cozycactus/goa-console/docs/clipping/clip_follower.png

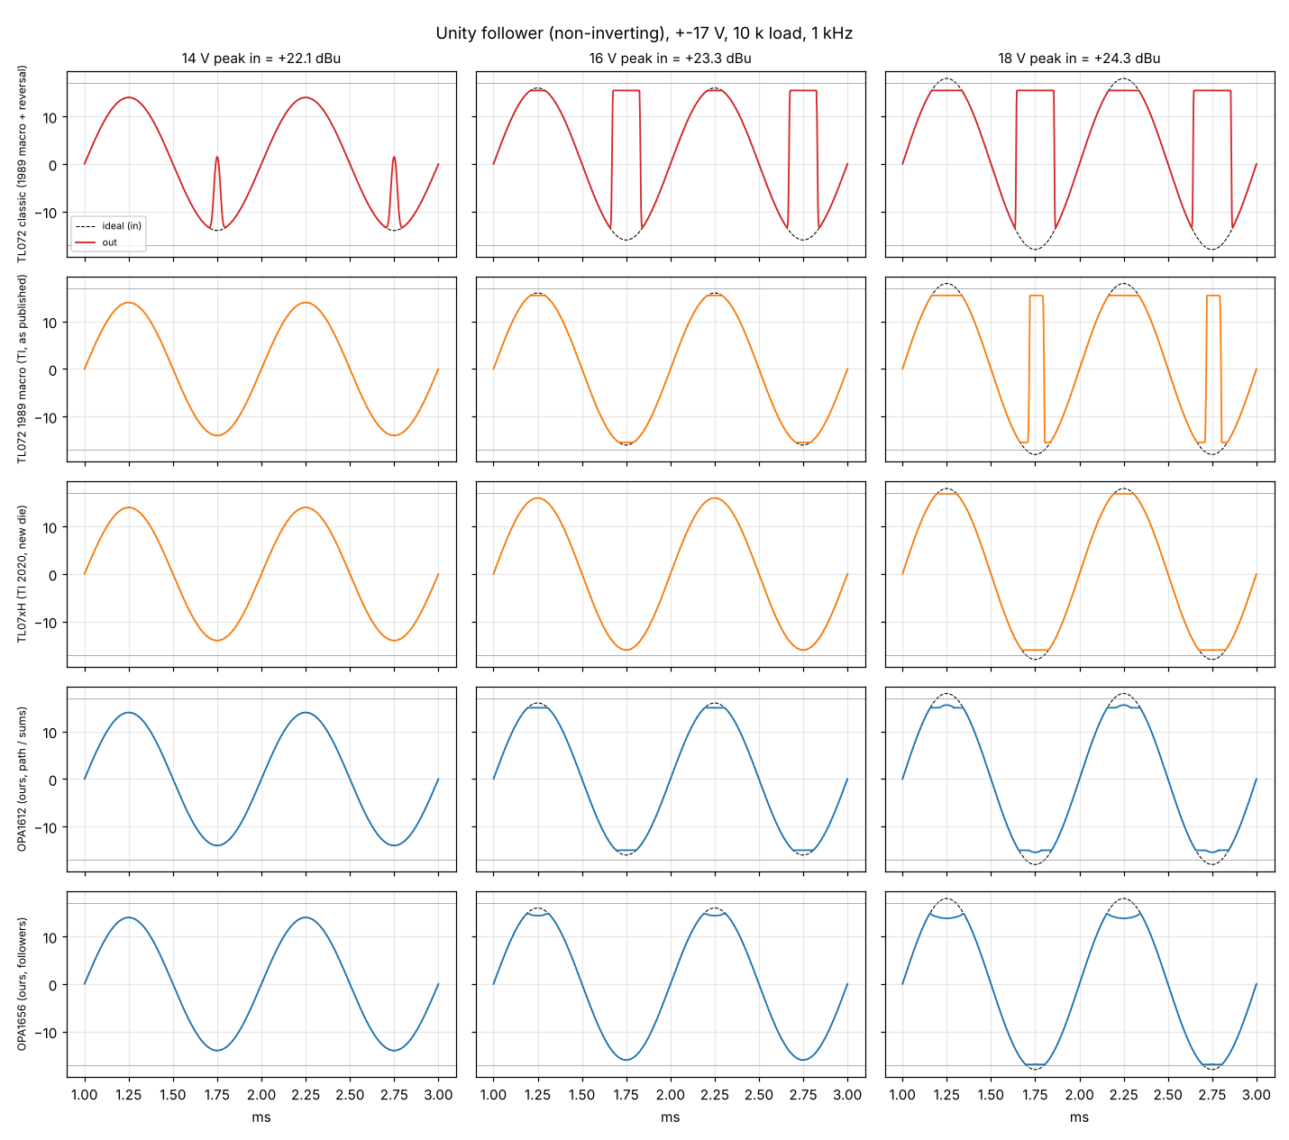
docs/clipping/clip_follower.png
