cozycactus/goa-console/docs/clipping/clip_inverting.png

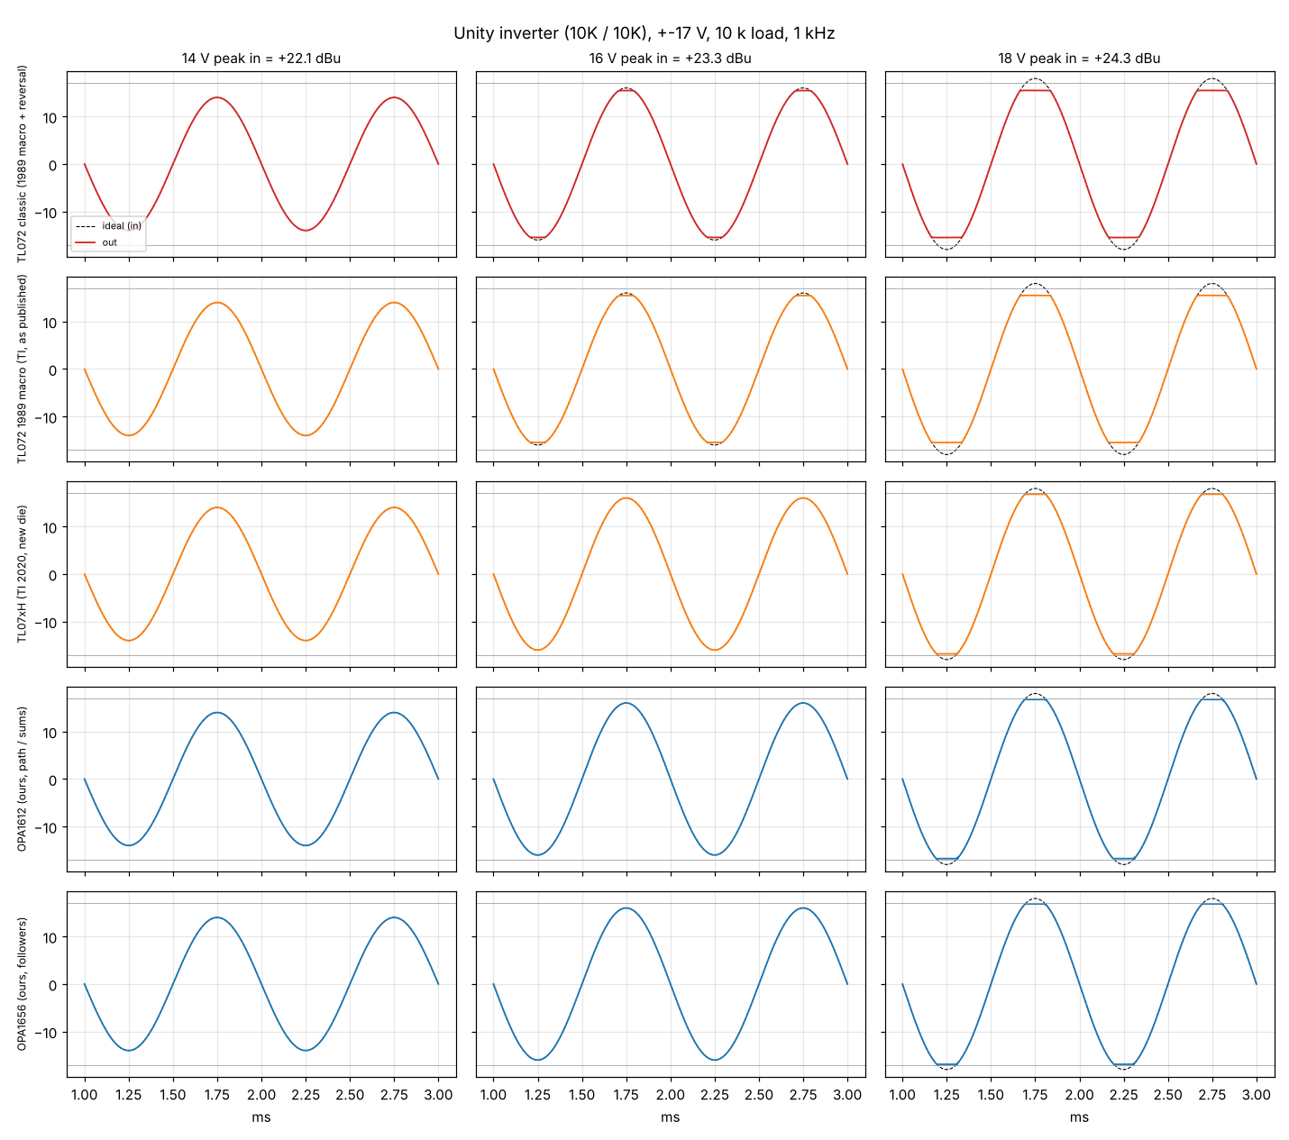
docs/clipping/clip_inverting.png
