cozycactus/goa-console/docs/clipping/clip_zoom.png

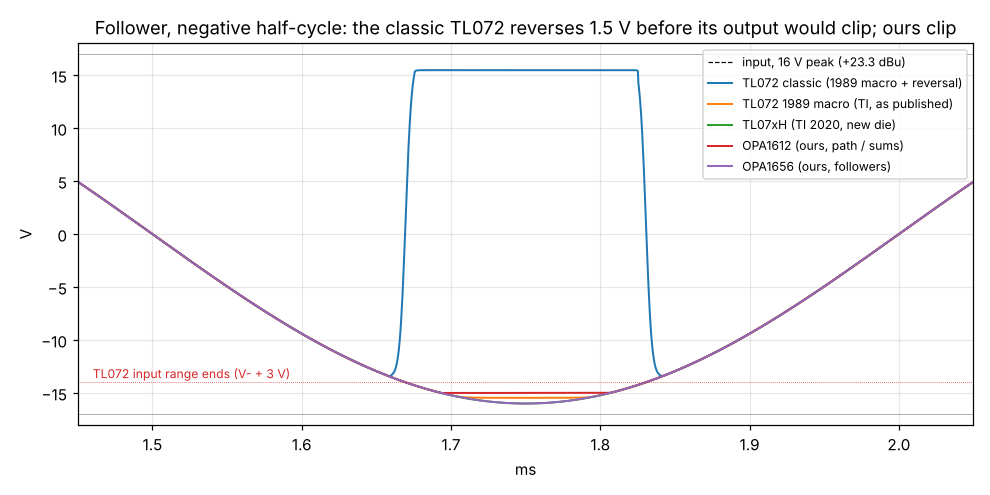
docs/clipping/clip_zoom.png
