cozycactus/goa-console/panels/group.png

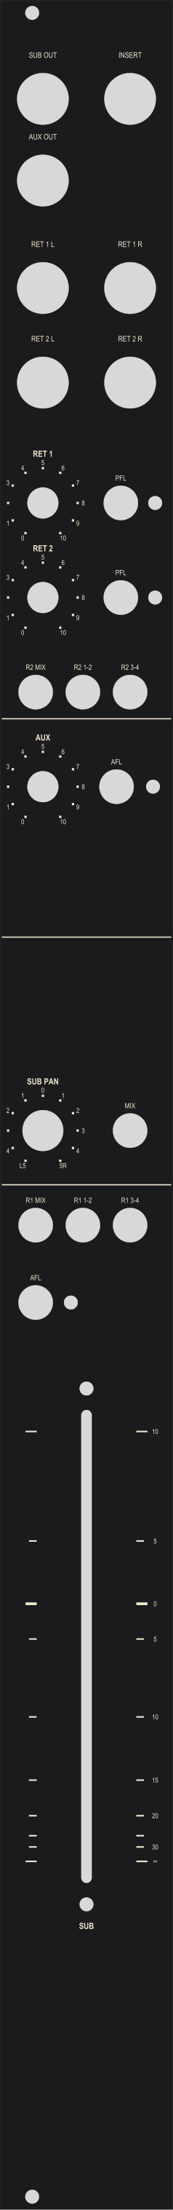
panels/group.png
