cozycactus/goa-console/panels/master.png

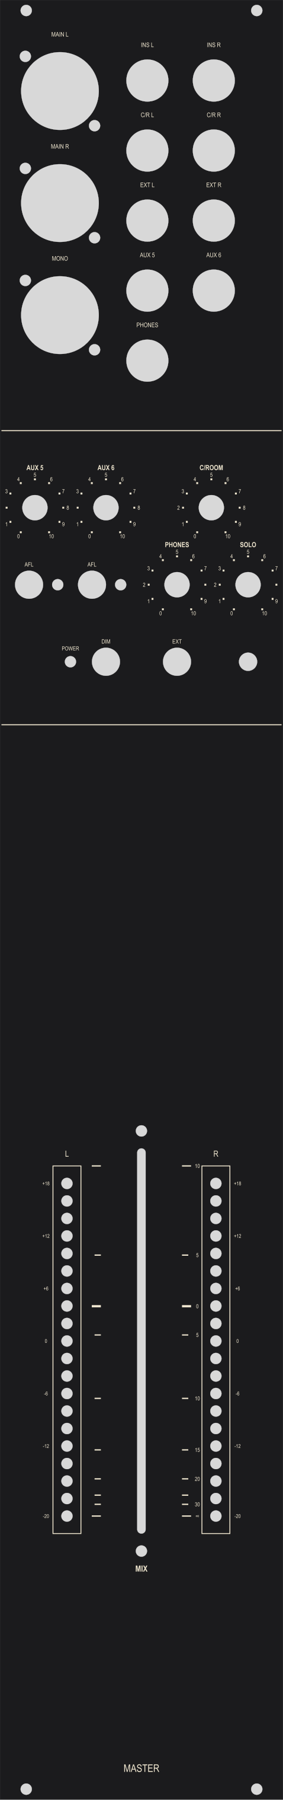
panels/master.png
