cozycactus/goa-console/panels/strip.png

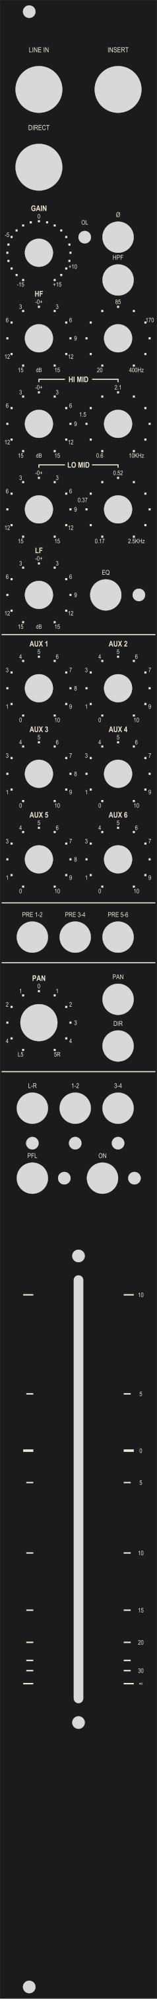
panels/strip.png
