cozycactus/goa-console/docs/build/sourcing.md

# BOM sourcing check (2026-10-25)

I checked every MPN on the nine BOMs: 86 unique part numbers, at console quantities (24 strips, 4 groups, the master,
the PSU and the jig). Each was checked for an exact orderable code, its lifecycle and its stock. One agent searched the
distributors and I re-checked its doubtful claims by hand (Tayda, findchips, RS, Farnell, DigiKey). Stock figures are
snapshots from aggregators; check the live page before ordering.

## Applied (MPN fields only, no netlist or footprint change)

| Part | Was | Now | Why |
|---|---|---|---|
| Wing / jig PTCs | Bourns MF-RX160/72, 185/72, 250/72 | the same with `-0` | `-0` is the straight-lead order code |
| Plain 0805 resistors ≤ 1M (TF1, 2026-10-29) | Yageo RC0805FR-07xxxL thick film | Yageo RT0805FRE07xxxL thin film | voltage coefficient (distortion near full swing), drift, tempco; parity with the Delta's metal film |
| Strip C0G on 0805 pads: C7 / C41 33p, C14 / C94 / C95 100p, C37 22p (2026-10-28) | KEMET C1206C330 / C101 / C220J5GACTU | KEMET C0805C330 / C101 / C220J5GACTU | the strip's value-keyed map gave every C0G the 1206 code; these six are drawn on 0805 footprints (`gen.py` now picks by footprint) |
| 1 µF 0805 X7R (strip) | Murata GRM21BR71H105KA12 | GRM21BR71H105KA12**L** | packaging suffix needed to order |
| BAT54W | Nexperia BAT54W | BAT54W,115 | order code |
| LM1084 (PSU) | TI LM1084IT-ADJ | LM1084IT-ADJ/NOPB | the orderable RoHS code |
| LME49600 (master) | TI LME49600TS | LME49600TS/NOPB | same |
| SS54 clamps | "SS54" / onsemi SS54 | Diodes B540C-13-F | SMC 40 V 5 A from a named maker; value text kept "SS54" |
| S1G (PSU) | "S1G" | Diodes S1G-13-F | named maker |
| Strip C0G caps | KEMET C0805… | KEMET C1206C…J5GACTU | the strip's C0G sit on 1206 footprints, except the six on 0805 pads (above) |
| Strip C0G 2n2 / 4n7 / 10n / 22n / 100n | none | KEMET C1206C222 / 472 / 103 / 223 J5GACTU, Murata GRM31C5C1H104JA01L | were missing |
| Strip C1 / C3 220 µF | Nichicon UPW1V221MPD (10 × 12.5) | Rubycon 35ZLH220MEFC8X11.5 | fits the strip's D8 / P3.5 footprint |
| Strip C5 / C6 47 µF | Nichicon UPW1J470MPD (8 mm) | Panasonic EEU-FR1H470 | fits the strip's D6.3 / P2.5 footprint |
| Group C1 / C2 220 µF | Nichicon UPW1V221MPD (not for new designs, no stock) | Nichicon UHE1V221MPD6 | 10 × 12.5, P5, the group's footprint; Farnell ~1900 |
| Jack board C8 / C9 100p C0G | none | KEMET C0805C101J5GACTU | was missing |
| Strip D1 | none | Vishay 1N4148-TAP | as the master |
| PSU caps | none | Rubycon 35ZLH2200MEFC16X25, 35ZLH220MEFC8X11.5, Panasonic EEU-FR1H470, Samsung CL21B104KBCNNNC, KEMET C0805C222J5GACTU (C0G) | were missing; each in its footprint |
| PSU LEDs | none | Kingbright WP710A10GD | as the strips |
| Phoenix terminals | series names | 1755897 (7-way), 1715721 (2-way), 1715734 (3-way) | order numbers (1755897 confirmed at RS as MKDS 1,5/7-5,08) |
| Master R57 22M | none | Yageo RC0805JR-0722ML | was missing |
| Master CN4 | none | Sullins PRPC005SAAN-RC | was missing |

Left without an MPN, by design: the DNP VCA socket / header on the strip (J3, J4) and the master's M4 star point (CN1,
a hole).

**Resistors.** Plain 0805 values carry no MPN. Rule: buy them as Yageo RC0805FR-07xxxL (1 %, 0.125 W) or any
equivalent 1 % thick-film 0805. Every part that needs more (anti-surge, 0.1 %, 2512) already has its own MPN.

## Resistor film (TF1, signed off by Ruslan 2026-10-29 and applied: `docs/proposals/thin_film_proposal.md`)

The Delta DLX uses "MF 0.25W RES 2%" metal film for every resistor and a 5 % 1/2 W mini metal film for the routing
10Ks (Tech Manual spare parts p.151-162). Ours are Yageo RC0805FR **thick film** 1 % for the general values, Panasonic
ERA-6AEB thin film 0.1 % where matching matters (receiver 10Ks, re-inverter 2K2s), ERJ-P06 anti-surge thick film for the
build-outs and feeds, Vishay M25SI thin-film fusibles. What thick film costs against metal / thin film:
- **Excess (1/f) noise:** thick film's noise index is some 10-20 dB worse than metal film's, but it scales with the DC
  voltage across the part. The audio resistors sit at 0 V DC (every stage is AC-coupled; bias drops are tens of mV),
  so the term is nil in the signal path. It matters only in DC dividers, none of which is audio.
- **Voltage coefficient (distortion):** thick film is measurably non-linear, metal / thin film is not. Published
  measurements (Self, Small Signal Audio Design) put a thick-film 0805 feedback resistor with ~10 Vrms across it at
  roughly −95 to −105 dB THD, scaling with the square of the voltage: at the console's 0 dBu (0.775 Vrms) that is
  some 20 dB lower, far below the op-amps' and the bus's floor; it becomes visible only in the last few dB before
  clipping, in the resistors that carry the full swing (gain stage 2K2 / 10K, EQ 22K and the KHN networks, post-amp
  4K7 / 2K2, pan 2K2 / 10K / 3K3, the 4K7 and 22K summers).
- **Decided (TF1):** every plain 0805 resistor up to 1M is Yageo **RT0805FRE07<value>L** thin film (1 %, 50 ppm,
  0.125 W, 150 V), the rule in `order_bom.py` (62 lines / 4411 parts, ~€80-150 over the console); above 1M (2M2, 4M99,
  10M, 22M: DC positions, no thin-film part) RC0805FR stays, as do the anti-surge ERJ-P06 positions (a surge is what
  thin film survives worst), the 2512 2R2 and the fusibles. Fallback for a value out of stock on the day: the RC0805FR
  code for that value only.

## Checked and kept

- **Alpha pots.** The agent called RD902F-40-15R1-A10K "not stocked anywhere". Wrong: Tayda stocks it (SKU A-6980,
  700). It also stocks RD901F-40-15R1-A10K (A-1856, 1775), -B10K-0CD (A-8401, 741) and -A10K-0CD (A-7815, 220).
- **DG413DY-E3** is the tube code, stocked (Mouser ~4700, RS). It is not a mistake for -T1-E3, the reel. (2026-11-03: the tube is
  out of stock and the order lists buy the -T1-E3, `docs/proposals/second_source_proposal.md` SS1.)

**Follow-up (2026-10-25).**
- **C48 (strip, 150 nF film):** now WIMA MKS2D031501C00KSSD, the 100 V version of the same part. It is
  3.5 × 8.5 × 7.2 mm on a 5 mm pitch, so it fits the W4.5 footprint. No 63 V KSSD stock was found anywhere.
- **OPA1656:** one order code everywhere, OPA1656IDR. The master, group and jig used to say OPA1656ID (tube).

## Order list

`python3 tools/order_bom.py` writes `bom/order_bom.csv`.
- **What it does:** takes each board's BOM times the boards built (24 strips and strip jack boards, 4 groups and group
  jack boards, one each of master, master jack board, PSU, jig stub and jig load board), one line per order code.
- **Additions:** the 16 OPA1656s for the jig's A/B strips. The jig's four strips are four of the 24.
- **Spares:** SMD R / C +10 % (at least 10), semis and LEDs +5 % (at least 2), electrolytics and film +5 % (at least 2),
  panel parts and connectors +3 % (at least 1).
- **Resistors:** plain 0805 values get `Yageo RC0805FR-07<value>L`.
- **Left out:** DNP parts and the M4 star point.
- **Phase 1** (`python3 tools/order_bom.py phase1` → `bom/order_phase1.csv`, 2026-10-28): the staged hardware test of
  `test_jig_spec.md` 1.1, in three columns:
  - **Stage A:** one strip and its jack board. `docs/build/sample_order.md` is merged in: a part on both lists is bought once,
    the larger number, since the samples are the build's parts and get checked before soldering. Also the 8 OPA1656 for
    the N1 swap, the bench-power IDC lead, the jack link, the key caps, a cut-only panel blank and the hardware for it.
  - **Stage B:** the jig stub, the load board, the jig ribbons, the ground bar and the test fixtures (tests 2, 13).
  - **Stage B, 2nd strip (optional).**
  - **Spares:** each stage gets the console rule's spares on its own count, so the second strip's spares may already
    be in stage A's leftovers.
  - **PCBs:** order all four phase-1 designs in stage A, 5 of each (the fab minimum).
  - **Priced 2026-10-28, re-priced 2026-11-04 from the readings in `bom/mouser_readings.csv`** (`python3 tools/order_bom.py stagea`, which writes
    `bom/order_phase1_prices.csv`, `bom/order_stage_a.csv` and `bom/order_stage_a_mouser.csv`, Mouser's BOM upload): stage A $435 in parts (Mouser $306 now, $12
    later; Tayda $22, RS $18, Don-Audio $11, off-board by rule $66) + $70.50 of PCBs, stage B $315, a second strip $294; without shipping, VAT or duty, and
    without the $80 optional matched pair. Thin film (TF1) read at $0.017-0.051 at 10+, not the $0.10 placeholder. Not read (Mouser blocked the browser after
    about 47 lookups): 7 thin-film values, the ceramics, 3 RC0805s; the upload shows those live. Backordered at Mouser then: OPA1612AIDR (AID tube in stock), PVA2 (3/2027), DG413DY-E3,
    BAV199,215 / BZX84-C5V1 / PMEG4010CEH (Nexperia, to 2027), all replaced by SS1-SS3 (below); WIMA MKS2C042201K00KSSD obsolete, replaced by KEMET
    MMK5225K63J06L4BULK in the same box (FE1, 2026-10-29: buy the console's 120 in one order, it is a last-time buy too);
    Alpha pots only at Tayda.
- **Not on any board, so not in the list** (they are in `docs/build/offboard_bom.md`): knobs, fader caps, LED spacers, standoffs, ribbon and IDC sockets, the
  harness, the PSU modules and its case parts. See the specs (§16 of the strip spec, master spec §26, `psu_spec.md`).

## Stock risks: act before ordering

**Re-read 2026-11-03:** Nexperia's BAV99, BAV199,215, BZX84-C5V1 and PMEG4010CEH, the OPA1612AIDR reel, DG413DY-E3, EEU-FR1H470 and
PVA2 EE H1 are out of stock at Mouser. `docs/proposals/second_source_proposal.md` SS1-SS3 (signed off 2026-11-03) replaces them:
- **Same part, other packing (order lists only, `ORDER_AS` in `order_bom.py`; the schematics keep the first code):** OPA1612AID,
  BAV199,235, DG413DY-T1-E3.
- **Other maker, same footprint (in the schematics):** Diodes BZX84C5V1-7-F, Diodes BAV99-7-F, onsemi MBR140SFT1G, Rubycon
  63ZLH47MEFC6.3X11, Panasonic EEU-FR1E221.
- **Keys:** PVA2 EE H3 on phase 1's bench strips (`BENCH_KEY`), H1 on the console and for check 3's samples.

Its §6 lists the codes Mouser's block left unread: re-read those at order time.

| Part | Needed | Situation | Action |
|---|---|---|---|
| Bourns PTB0143-2010BPA103 | 28 (24 strips + 4 groups) | Mouser 612 on 2026-11-04, 12 wk (DigiKey showed exactly 28 before) | no hurry for the samples; buy the console's with its order |
| Neutrik NJ6FD-V | 109 (72 strip, 28 group, 9 master; RET1) | Mouser 380 on 2026-11-04, 2 wk (~14 wk quoted before) | no longer the first thing to order |
| Yageo RT0805FRE071K5L | 26 + spares (strip R64 x24, master 2) | Mouser 0, 9,942 due 2027-01-26 | stage A and a second strip use TF1's fallback RC0805FR-071K5L; the console order waits or takes the fallback |
| Yageo RT0805FRE072K49L | 48 + spares (strip 2 each) | Mouser 51, 35,000 on order | fine for stage A; the console order needs the delivery |
| Kingbright WP710A10GD | 4 for stage A | Mouser 0, 19,878 due 2026-12-07 | on stage A's later list with the H1 samples |
| TI OPA1612AID (tube, SS1; the AIDR reel is 0, 26 wk) | 319 (264 strip, 36 group, 13 master, 6 jig; RET1) | Mouser 516 on 2026-11-03; LCSC the only other volume stock seen | buy for stage A now; before the console order re-check the reel, about $1.70 less each at 10 |
| C&K PVA2 EE H1 1.7N V2 | 360 + spares | Mouser 0, 1,441 due 2027-03-01 | order for the console; stage A and a second strip use H3 (SS3) |
| Vishay DG413DY-T1-E3 (SS1) | 73 | Mouser 57, 5,000 due 2026-12-25 | stage A's 5 are in stock; the console waits for the delivery |
| Nexperia BAT54W,115 | 52 with spares | Mouser 184 | buy early |
| TI LM1084IT-ADJ/NOPB | 2 | little stock | buy with the first order |
| KEMET MMK5225K63J06L4BULK (2.2 µF film; FE1, replaces the obsolete WIMA MKS2C042201K00KSSD) | 114 (72 strip, 28 group, 14 master; RET1, RV7) | obsolete too; Mouser had 1,841 on 2026-10-29, 1,697 on 2026-11-04 with 7,000 on order (31 wk): worth re-checking its status before treating it as a last-time buy | buy the console's 120 in one order; no design change |
| WIMA MKS2D031501C00KSSD (150 nF film, C48) | 24 | the 63 V code (MKS2C031501A00KSSD) has no stock anywhere; RS ~1135 of this 100 V one | swapped (below) |

If the KEMET runs out before the console is built, FE2 in `docs/proposals/film_eol_proposal.md` is the way out: a wider footprint for
the active WIMA M-box (8.5 mm), with a few local moves on each board.

## For sign-off

**S1. The 10 µF NP (Nichicon UES1E100MDM) is discontinued.** DigiKey lists the taped code as obsolete; Audiophonics says
the product line is stopped. It is used in 36 places:
- every DRV135 sense-leg cap: master 14, group 4 per board (16), jig 2;
- the master's four ±VP supply bypasses at the LME49600s.
- **Position:** each sense-leg cap sits inside the DRV135's loop, after the output and before the Sense pin. The
  driver's loop gain corrects its distortion, so an audio-grade part buys nothing there. The bypasses aren't in the
  signal path at all.
- **Proposal:** a general-purpose 25 V 10 µF bipolar in the same 5 mm / P2.0 footprint, Panasonic ECE-A1EN100U (SU).
  No footprint, netlist or placement change. This touches the signed F1–F4 note "bipolars are MUSE ES", so it needs
  your sign-off.
- **Alternative:** stay MUSE ES with UES1H100MPM (50 V). It is 8 mm, so the 36 footprints go to D8 / P3.5 and the
  group and master are re-placed.

Signed off by Ruslan on 2026-10-25.

- [x] **S1** 10 µF NP → Panasonic ECE-A1EN100U, drop-in (DRV135 sense legs and jig).
- **CS11b (2026-10-27):** the console's 30 DRV135 couplers are sorted into pairs within 2 %, so `bom/order_bom.csv` orders
  49 ECE-A1EN100U, 10 of them sorting stock. DigiKey on 2026-10-27: ECE-A1EN100U Active, 5,268 in stock (bulk), and
  the taped ECE-A1EN100UB 1,999. RS's "discontinued" mark (`docs/reviews/master_group_review.md`) is their listing, not the part.

**Applied (2026-10-25).**
- `master_lib.CAP_MPN['10u NP 25V']` = Panasonic ECE-A1EN100U: 5 × 11 mm, 2.0 mm pitch (RS, Future); stocked at RS
  and Master Electronics.
- Changed parts: master 18, group 4, jig stub 2. Netlists unchanged but for the MPN field.
- Checks: 0 mismatches, check_fp 0, ERC 0. Re-placed with 0 parts moved; parity DRC clean on the group, master and
  jig stub.
