cozycactus/goa-console/bom/order_phase1.csv

Stage A | Stage B | Stage B: 2nd strip (optional) | MPN / code | Values / what | Footprint | Where | Notes
6 | 0 | 0 | (rule) 8 x 1.2 mm slot fader cap, white / red / yellow | Fader cap, coloured trial | (sample) | samples (check 2) 6
1 | 0 | 0 | Bourns PTB0144-2010BPA103 | Fader, master | (sample) | samples (check 1) 1
4 | 0 | 0 | C&K PVA2 EE H1 1.7N V2 | Key switch, the console height (due 2027-03-01) | (sample) | samples (check 3) 4
1 | 0 | 0 | Elma 021-3425 | Knob, 6 mm | (sample) | samples (check 7) 1
3 | 0 | 0 | Elma 021-3525 | Knob, 1/4" | (sample) | samples (check 7) 3
1 | 0 | 0 | Elma 040-3015 | Knob cap grey | (sample) | samples (check 7) 1
1 | 0 | 0 | Elma 040-3025 | Knob cap black | (sample) | samples (check 7) 1
1 | 0 | 0 | Elma 040-3035 | Knob cap red | (sample) | samples (check 7) 1
1 | 0 | 0 | Elma 040-3045 | Knob cap blue | (sample) | samples (check 7) 1
1 | 0 | 0 | Elma 040-3055 | Knob cap yellow | (sample) | samples (check 7) 1
1 | 0 | 0 | Elma 040-3065 | Knob cap green | (sample) | samples (check 7) 1
2 | 0 | 0 | Sifam LK110 tang 01 (RS 281-7197) | Fader cap, plain | (sample) | samples (check 2) 2
3 | 0 | 0 | Sifam LK111 01 | Fader cap, black, white line | (sample) | samples (check 2) 3
14 | 0 | 14 | C&K PVA2 EE H3 1.7N V2 | PFL / ON / Assign L-R / Assign 1-2 / Assign 3-4 / PRE 1-2 / PRE 3-4 / PRE 5-6 / HPF / EQ / DIR / PAN / Phase | Button_Switch_THT:SW_Push_2P2T_Toggle_CK_PVA2xxH1xxxxxxV2 | strip 13, strip 2 13 | SS3: bench strips only, the console is H1
0 | 21 | 0 | C&K OS102011MS2QN1 | MIXL +1 ch / MIXL +3 ch / MIXL +4 ch / MIXL +12 ch / MIXR +1 ch / MIXR +3 ch / MIXR +4 ch / MIXR +12 ch / SUB1 +1 ch / SUB1 +3 ch / SUB1 +4 ch / SUB1 +12 ch / AUX1 +1 ch / AUX1 +3 ch / AUX1 +4 ch / AUX1 +12 ch / PFL +1 ch / PFL +3 ch / PFL +4 ch / PFL +12 ch | Button_Switch_THT:SW_Slide_SPDT_Straight_CK_OS102011MS2Q | jig load 20
15 | 16 | 15 | KEMET C0805C101J5GACTU | 100p C0G | Capacitor_SMD:C_0805_2012Metric | strip 3, strip jack 2, jig stub 6, strip 2 3, strip 2 jack 2
0 | 13 | 0 | KEMET C0805C102J5GACTU | 1n C0G | Capacitor_SMD:C_0805_2012Metric | jig load 3
11 | 22 | 11 | KEMET C0805C220J5GACTU | 22p C0G / 22p C0G 5% | Capacitor_SMD:C_0805_2012Metric | strip 1, jig stub 12, strip 2 1
12 | 0 | 12 | KEMET C0805C330J5GACTU | 33p C0G | Capacitor_SMD:C_0805_2012Metric | strip 2, strip 2 2
11 | 0 | 11 | Murata GRM21BR71H105KA12L | 1u | Capacitor_SMD:C_0805_2012Metric | strip 1, strip 2 1 | X7R 50V
12 | 0 | 12 | Samsung CL21B103KBANNNC | 10n | Capacitor_SMD:C_0805_2012Metric | strip 2, strip 2 2 | X7R 50V
52 | 26 | 52 | Samsung CL21B104KBCNNNC | 100n | Capacitor_SMD:C_0805_2012Metric | strip 42, jig stub 16, strip 2 42 | X7R 50V
12 | 0 | 12 | Samsung CL21B224KBFNNNE | 220n | Capacitor_SMD:C_0805_2012Metric | strip 2, strip 2 2 | X7R 50V
21 | 0 | 21 | KEMET C1206C100J5GACTU | 10p C0G | Capacitor_SMD:C_1206_3216Metric | strip 11, strip 2 11
11 | 0 | 11 | KEMET C1206C101J5GACTU | 100p C0G | Capacitor_SMD:C_1206_3216Metric | strip 1, strip 2 1
11 | 0 | 11 | KEMET C1206C103J5GACTU | 10n C0G | Capacitor_SMD:C_1206_3216Metric | strip 1, strip 2 1
17 | 0 | 17 | KEMET C1206C220J5GACTU | 22p C0G | Capacitor_SMD:C_1206_3216Metric | strip 7, strip 2 7
11 | 0 | 11 | KEMET C1206C222J5GACTU | 2n2 C0G | Capacitor_SMD:C_1206_3216Metric | strip 1, strip 2 1
11 | 0 | 11 | KEMET C1206C223J5GACTU | 22n C0G | Capacitor_SMD:C_1206_3216Metric | strip 1, strip 2 1
11 | 0 | 11 | KEMET C1206C330J5GACTU | 33p C0G | Capacitor_SMD:C_1206_3216Metric | strip 1, strip 2 1
13 | 0 | 13 | KEMET C1206C472J5GACTU | 4n7 C0G | Capacitor_SMD:C_1206_3216Metric | strip 3, strip 2 3
13 | 0 | 13 | Murata GRM31C5C1H104JA01L | 100n C0G | Capacitor_SMD:C_1206_3216Metric | strip 3, strip 2 3
0 | 13 | 0 | Samsung CL31B105KBHNNNE | 1u | Capacitor_SMD:C_1206_3216Metric | jig stub 3 | X7R 50V
6 | 0 | 6 | Nichicon UES1E101MPM | 100u NP 25V | Capacitor_THT:CP_Radial_D10.0mm_P5.00mm | strip 4, strip 2 4 | MUSE ES
0 | 4 | 0 | Nichicon UPW1E471MPD | 470u 25V | Capacitor_THT:CP_Radial_D10.0mm_P5.00mm | jig stub 2
0 | 4 | 0 | Panasonic ECE-A1EN100U | 10u NP 25V | Capacitor_THT:CP_Radial_D5.0mm_P2.00mm | jig stub 2
4 | 0 | 4 | Rubycon 63ZLH47MEFC6.3X11 | 47u 25V | Capacitor_THT:CP_Radial_D6.3mm_P2.50mm | strip 2, strip 2 2 | 63V
8 | 0 | 8 | Nichicon UES1E330MPM | 33u NP 25V | Capacitor_THT:CP_Radial_D8.0mm_P3.50mm | strip 6, strip 2 6 | MUSE ES
0 | 4 | 0 | Nichicon UPW1J470MPD | 47u 25V | Capacitor_THT:CP_Radial_D8.0mm_P3.50mm | jig stub 2 | 63V
4 | 0 | 4 | Panasonic EEU-FR1E221 | 220u 25V | Capacitor_THT:CP_Radial_D8.0mm_P3.50mm | strip 2, strip 2 2
3 | 0 | 3 | WIMA MKS2D031501C00KSSD | 150n film | Capacitor_THT:C_Rect_L7.2mm_W4.5mm_P5.00mm_FKS2_FKP2_MKS2_MKP2 | strip 1, strip 2 1 | PET 100V; 3.5 x 8.5 x 7.2, the 63 V KSSD code has no stock
5 | 0 | 5 | KEMET MMK5225K63J06L4BULK | 2.2u film | Capacitor_THT:C_Rect_L7.2mm_W7.2mm_P5.00mm_FKS2_FKP2_MKS2_MKP2 | strip 3, strip 2 3 | PET 63V; replaces the obsolete WIMA MKS2C042201K00KSSD
4 | 0 | 4 | Neutrik NJ6FD-V | Line in TRS / Insert TRS switched / Direct out TRS / Jack | Connector_Audio:Jack_6.35mm_Neutrik_NJ6FD-V_Vertical | strip jack 3, strip 2 jack 3, samples (check 6) 2
0 | 2 | 0 | Neutrik NC3MAH | MIX L balanced out | Connector_Audio:Jack_XLR_Neutrik_NC3MAH_Horizontal | jig stub 1
0 | 7 | 0 | Amphenol B6252HB-NPP3G-50 | MIX L out / MIX R out / SUB 1 out / AUX 1 out / AUX 2 out / PFL MIX out | Connector_Coaxial:BNC_Amphenol_B6252HB-NPP3G-50_Horizontal | jig stub 6
3 | 0 | 3 | Wurth 61201021621 | Jack board link 2x5 / Main board link 2x5 | Connector_IDC:IDC-Header_2x05_P2.54mm_Vertical | strip 1, strip jack 1, strip 2 1, strip 2 jack 1 | 2x5 box header
2 | 3 | 2 | Wurth 61203421621 | Bus 2x17 / Bus 2x17 (ribbon) | Connector_IDC:IDC-Header_2x17_P2.54mm_Vertical | strip 1, jig stub 1, jig load 1, strip 2 1 | 2x17 box header
0 | 5 | 0 | 2.54 mm header + shunt | GC TIE (fit = 22R tie) / MIXL +1 nF / MIXR +1 nF / SUB1 +1 nF | Connector_PinHeader_2.54mm:PinHeader_1x02_P2.54mm_Vertical | jig stub 1, jig load 3
0 | 2 | 0 | 2.54 mm header + shunt | GC REF (1-2 D, 2-3 A) | Connector_PinHeader_2.54mm:PinHeader_1x03_P2.54mm_Vertical | jig stub 1
0 | 4 | 0 | Diodes B540C-13-F | SS54 | Diode_SMD:D_SMC | jig stub 2 | SS54 class, SMC 40 V 5 A
4 | 0 | 4 | onsemi MBR140SFT1G | MBR140SFT1G | Diode_SMD:D_SOD-123F | strip 2, strip 2 2
0 | 4 | 0 | Vishay 1N4148-TAP | 1N4148 | Diode_THT:D_DO-35_SOD27_P7.62mm_Horizontal | jig stub 2
0 | 16 | 0 | Murata BLM21PG221SN1D | Ferrite 220R@100MHz | Inductor_SMD:L_0805_2012Metric | jig stub 6
4 | 0 | 4 | Kingbright WP710A10GD | ON green / EQ green / Panel LED green | LED_THT:LED_D3.0mm | strip 2, strip 2 2, samples (check 8) 3
3 | 3 | 3 | Kingbright WP710A10ID | PFL red / PFL ACTIVE red / Panel LED red | LED_THT:LED_D3.0mm | strip 1, jig stub 1, strip 2 1, samples (check 8) 3
5 | 0 | 5 | Kingbright WP710A10YD | L-R yellow / 1-2 yellow / 3-4 yellow / Panel LED yellow | LED_THT:LED_D3.0mm | strip 3, strip 2 3, samples (check 8) 3
5 | 0 | 5 | Vishay DG413DY-T1-E3 | DG413 | Package_SO:SOIC-16_3.9x9.9mm_P1.27mm | strip 3, strip 2 3
0 | 3 | 0 | TI DRV135UA | DRV135 | Package_SO:SOIC-8_3.9x4.9mm_P1.27mm | jig stub 1
5 | 3 | 5 | TI LM393BIDR | LM393 | Package_SO:SOIC-8_3.9x4.9mm_P1.27mm | strip 3, jig stub 1, strip 2 3
13 | 8 | 13 | TI OPA1612AID | OPA1612 | Package_SO:SOIC-8_3.9x4.9mm_P1.27mm | strip 11, jig stub 6, strip 2 11
11 | 3 | 3 | TI OPA1656IDR | OPA1656 / OPA1656 (N1 swap on strip 1) | Package_SO:SOIC-8_3.9x4.9mm_P1.27mm | strip 1, jig stub 1, strip 2 1, N1 swap 8
7 | 0 | 7 | Diodes BAV99-7-F | BAV99 | Package_TO_SOT_SMD:SOT-23 | strip 5, strip 2 5
3 | 0 | 3 | Diodes BZX84C5V1-7-F | BZX84C5V1 | Package_TO_SOT_SMD:SOT-23 | strip 1, strip 2 1
8 | 0 | 8 | Nexperia BAV199,235 | BAV199 | Package_TO_SOT_SMD:SOT-23 | strip 6, strip 2 6
4 | 0 | 4 | onsemi MMBFJ112 | MMBFJ112 | Package_TO_SOT_SMD:SOT-23 | strip 2, strip 2 2
5 | 0 | 5 | onsemi MMBT3906LT1G | MMBT3906 | Package_TO_SOT_SMD:SOT-23 | strip 3, strip 2 3
4 | 0 | 4 | Nexperia BAT54W,115 | BAT54W | Package_TO_SOT_SMD:SOT-323_SC-70 | strip 2, strip 2 2
7 | 0 | 7 | Alpha RD901F-40-15R1-A10K | Aux1 10K log / Aux2 10K log / Aux3 10K log / Aux4 10K log / Aux5 10K log / Aux6 10K log / Pot, single A10K | Potentiometer_THT:Potentiometer_Alpha_RD901F-40-00D_Single_Vertical | strip 6, strip 2 6, samples (check 4, 7) 2
6 | 0 | 6 | Alpha RD901F-40-15R1-B10K-0CD | Gain 10K lin CD / HF 10K lin CD / HI-MID gain 10K lin CD / LO-MID gain 10K lin CD / LF 10K lin CD / Pot, B10K detent | Potentiometer_THT:Potentiometer_Alpha_RD901F-40-00D_Single_Vertical | strip 5, strip 2 5, samples (check 4, 7) 1 | centre detent
4 | 0 | 4 | Alpha RD902F-40-15R1-A10K | HI-MID freq 10K A dual / LO-MID freq 10K A dual / HPF freq 10K A dual / Pot, dual A10K | Potentiometer_THT:Potentiometer_Alpha_RD902F-40-00D_Dual_Vertical | strip 3, strip 2 3, samples (check 4, 7) 1 | dual, log
2 | 0 | 2 | ALPS RK09L1240015 | Pan 10K lin dual CD / Pan pot | Potentiometer_THT:Potentiometer_Alps_RK09L_Double_Vertical | strip 1, strip 2 1, samples (check 5, 7) 2
14 | 0 | 14 | Panasonic ERA-6AEB103V | 10K 0.1% | Resistor_SMD:R_0805_2012Metric | strip 4, strip 2 4
0 | 34 | 0 | Panasonic ERA-6AEB222V | 2K2 0.1% | Resistor_SMD:R_0805_2012Metric | jig stub 24
0 | 12 | 0 | Panasonic ERJ-P06J1R0V | 1R | Resistor_SMD:R_0805_2012Metric | jig stub 2
0 | 11 | 0 | Panasonic ERJ-P06J332V | 3K3 | Resistor_SMD:R_0805_2012Metric | jig stub 1
13 | 0 | 13 | Panasonic ERJ-P06J750V | 75R | Resistor_SMD:R_0805_2012Metric | strip 3, strip 2 3
11 | 0 | 11 | Yageo RC0805FR-0710ML | 10M 1% | Resistor_SMD:R_0805_2012Metric | strip 1, strip 2 1
11 | 0 | 11 | Yageo RC0805FR-071K5L | 1K5 | Resistor_SMD:R_0805_2012Metric | strip 1, strip 2 1 | TF1 fallback: the thin film is out of stock, due 2027-01-26
11 | 0 | 11 | Yageo RC0805FR-074M99L | 4M99 1% | Resistor_SMD:R_0805_2012Metric | strip 1, strip 2 1
16 | 0 | 16 | Yageo RT0805FRE07100KL | 100K | Resistor_SMD:R_0805_2012Metric | strip 6, strip 2 6
12 | 16 | 12 | Yageo RT0805FRE07100RL | 100R | Resistor_SMD:R_0805_2012Metric | strip 2, jig stub 6, strip 2 2
23 | 12 | 23 | Yageo RT0805FRE0710KL | 10K / 10K 1% | Resistor_SMD:R_0805_2012Metric | strip 13, jig stub 2, strip 2 13
11 | 13 | 11 | Yageo RT0805FRE0710RL | 10R GND cancel / 10R | Resistor_SMD:R_0805_2012Metric | strip 1, jig stub 2, jig load 1, strip 2 1
16 | 0 | 16 | Yageo RT0805FRE0713KL | 13K 1% | Resistor_SMD:R_0805_2012Metric | strip 6, strip 2 6
0 | 13 | 0 | Yageo RT0805FRE071K18L | 1K18 1% | Resistor_SMD:R_0805_2012Metric | jig load 3
0 | 13 | 0 | Yageo RT0805FRE071K58L | 1K58 1% | Resistor_SMD:R_0805_2012Metric | jig load 3
0 | 12 | 0 | Yageo RT0805FRE071K82L | 1K82 1% | Resistor_SMD:R_0805_2012Metric | jig load 2
19 | 0 | 19 | Yageo RT0805FRE071KL | 1K | Resistor_SMD:R_0805_2012Metric | strip 9, strip 2 9
15 | 0 | 15 | Yageo RT0805FRE071ML | 1M | Resistor_SMD:R_0805_2012Metric | strip 5, strip 2 5
11 | 0 | 11 | Yageo RT0805FRE07220KL | 220K | Resistor_SMD:R_0805_2012Metric | strip 1, strip 2 1
12 | 0 | 12 | Yageo RT0805FRE07220RL | 220R | Resistor_SMD:R_0805_2012Metric | strip 2, strip 2 2
23 | 15 | 23 | Yageo RT0805FRE0722KL | 22K / 22K 1% | Resistor_SMD:R_0805_2012Metric | strip 13, jig stub 3, jig load 2, strip 2 13
0 | 11 | 0 | Yageo RT0805FRE0722RL | 22R | Resistor_SMD:R_0805_2012Metric | jig stub 1
17 | 0 | 17 | Yageo RT0805FRE072K2L | 2K2 / 2K2 1% | Resistor_SMD:R_0805_2012Metric | strip 7, strip 2 7
12 | 0 | 12 | Yageo RT0805FRE072K49L | 2K49 1% | Resistor_SMD:R_0805_2012Metric | strip 2, strip 2 2
0 | 11 | 0 | Yageo RT0805FRE07330KL | 330K | Resistor_SMD:R_0805_2012Metric | jig stub 1
12 | 0 | 12 | Yageo RT0805FRE07330RL | 330R 1% | Resistor_SMD:R_0805_2012Metric | strip 2, strip 2 2
12 | 0 | 12 | Yageo RT0805FRE0733KL | 33K | Resistor_SMD:R_0805_2012Metric | strip 2, strip 2 2
12 | 13 | 12 | Yageo RT0805FRE07392RL | 392R 1% | Resistor_SMD:R_0805_2012Metric | strip 2, jig load 3, strip 2 2
14 | 0 | 14 | Yageo RT0805FRE073K3L | 3K3 | Resistor_SMD:R_0805_2012Metric | strip 4, strip 2 4
12 | 0 | 12 | Yageo RT0805FRE07430RL | 430R 1% | Resistor_SMD:R_0805_2012Metric | strip 2, strip 2 2
12 | 0 | 12 | Yageo RT0805FRE07470KL | 470K | Resistor_SMD:R_0805_2012Metric | strip 2, strip 2 2
25 | 0 | 25 | Yageo RT0805FRE0747KL | 47K | Resistor_SMD:R_0805_2012Metric | strip 15, strip 2 15
12 | 0 | 12 | Yageo RT0805FRE074K22L | 4K22 1% | Resistor_SMD:R_0805_2012Metric | strip 2, strip 2 2
28 | 16 | 28 | Yageo RT0805FRE074K7L | 4K7 / 4K7 1% | Resistor_SMD:R_0805_2012Metric | strip 18, jig stub 3, jig load 3, strip 2 18
14 | 0 | 14 | Yageo RT0805FRE074K99L | 4K99 1% | Resistor_SMD:R_0805_2012Metric | strip 4, strip 2 4
11 | 0 | 11 | Yageo RT0805FRE075K1L | 5K1 | Resistor_SMD:R_0805_2012Metric | strip 1, strip 2 1
0 | 12 | 0 | Yageo RT0805FRE075K49L | 5K49 1% | Resistor_SMD:R_0805_2012Metric | jig load 2
13 | 0 | 13 | Yageo RT0805FRE075K6L | 5K6 / 5K6 1% | Resistor_SMD:R_0805_2012Metric | strip 3, strip 2 3
11 | 0 | 11 | Yageo RT0805FRE076K8L | 6K8 | Resistor_SMD:R_0805_2012Metric | strip 1, strip 2 1
11 | 0 | 11 | Yageo RT0805FRE07750KL | 750K | Resistor_SMD:R_0805_2012Metric | strip 1, strip 2 1
0 | 12 | 0 | Yageo RT0805FRE077K32L | 7K32 1% | Resistor_SMD:R_0805_2012Metric | jig load 2
14 | 0 | 14 | Vishay M251206BB1009JP500 | 10R | Resistor_SMD:R_1206_3216Metric | strip 4, strip 2 4
0 | 3 | 0 | Phoenix 1715734 MKDS 1,5/3-5,08 | Bench supply +V / 0 V / -V / Dummy load +V / 0 V / -V | TerminalBlock_Phoenix:TerminalBlock_Phoenix_MKDS-1,5-3-5.08_1x03_P5.08mm_Horizontal | jig stub 1, jig load 1
0 | 21 | 0 | Keystone 5010 | GCANCEL / GCREF_BUF / SUM_ML / MIX_L / SUM_MR / MIX_R / SUM_S1 / SUB_1 / SUM_A1 / AUX_1 / SUM_A2 / AUX_2 / SUM_P / PFL_MIX / +VA / -VA / +VBUS_R / -VBUS_R / GNDA | TestPoint:TestPoint_Keystone_5010-5014_Multipurpose | jig stub 20
0 | 3 | 0 | Bourns MF-RX160/72-0 | MF-RX160/72 | goa-console:Fuse_Bourns_MF-RX160-72_Radial_P5.08mm | jig stub 2
2 | 3 | 2 | Keystone 1287-ST | Ground spade 6.3mm / Ground spade 6.3mm (to the ground bar) | goa-console:Keystone_1287-ST_FastOn_Tab_6.35mm | strip 1, jig stub 1, jig load 1, strip 2 1
5 | 0 | 3 | Kingbright WP3VEGW | OL red / SIG green / Signal / OL LED | goa-console:LED_D3.0mm-3_P2.00mm | strip 1, strip 2 1, samples (check 8) 5
2 | 0 | 2 | Bourns PTB0143-2010BPA103 | Fader 10K log 100mm / Fader, strip / group | goa-console:Potentiometer_Bourns_PTB0143_Slide_100mm | strip 1, strip 2 1, samples (check 1, 9) 2
0 | 1 | 0 | (rule) 0.1R 3 W | Test 2: spade-lead shunt | (off-board) | offboard_bom.md / test_jig_spec.md | test 2
1 | 0 | 0 | (rule) 10-way 1.27 mm flat cable | 10-way flat cable, m | (off-board) | offboard_bom.md / test_jig_spec.md | one strip link is ~136 mm
1 | 0 | 0 | (rule) 100R 0.01 % matched pair | Test 14: CMR source pair | (off-board) | offboard_bom.md / test_jig_spec.md | test_jig_spec.md test 14 (a)
0 | 1 | 0 | (rule) 10K 0.01 % matched pair | Test 13: common-mode sum | (off-board) | offboard_bom.md / test_jig_spec.md | test 13
1 | 2 | 0 | (rule) 14 AWG stranded wire | 14 AWG wire, m | (off-board) | offboard_bom.md / test_jig_spec.md
0 | 1 | 0 | (rule) 1:1 audio isolation transformer | Test 2: ground injection | (off-board) | offboard_bom.md / test_jig_spec.md | test 2 (any 50 Hz-1 kHz 1:1)
0 | 2 | 0 | (rule) 1K 0.1 % | Test 13: leg loads | (off-board) | offboard_bom.md / test_jig_spec.md | test 13
1 | 0 | 0 | (rule) 1K 1 % | Test 14: 1 kohm tip resistor | (off-board) | offboard_bom.md / test_jig_spec.md | test 14 (b)
6 | 0 | 0 | (rule) 3 mm LED spacer 7.6 mm | LED spacer | (off-board) | offboard_bom.md / test_jig_spec.md
3 | 0 | 0 | (rule) 3-lead 3 mm LED spacer 7.2 mm, 2.0 pitch | LED spacer, WP3VEGW | (off-board) | offboard_bom.md / test_jig_spec.md | or a 2-hole one opened up
2 | 0 | 0 | (rule) 3.5 mm M3 spacer | Fader spacer | (off-board) | offboard_bom.md / test_jig_spec.md | plus 2 M3 fader screws
1 | 4 | 0 | (rule) 34-way 1.27 mm flat cable, 28 AWG | 34-way flat cable, m | (off-board) | offboard_bom.md / test_jig_spec.md | B: 0.6 m wing ribbon + 3 m hum-test ribbon (test 4)
2 | 6 | 2 | (rule) 6.3 mm insulated receptacle, blue | Spade receptacle | (off-board) | offboard_bom.md / test_jig_spec.md | ground spades to the bench / the ground bar
6 | 0 | 0 | (rule) M3 F-F standoff 11.5 mm | Main-board standoff | (off-board) | offboard_bom.md / test_jig_spec.md | plus 6 M3 screws
2 | 0 | 0 | (rule) M3 F-F standoff 24.0 mm, metal | Jack-board standoff | (off-board) | offboard_bom.md / test_jig_spec.md | plus 2 M3 screws, 2 M3 star washers
14 | 0 | 0 | (rule) M7 washer 1.5 x ID 7.2 x OD < 11.2 | Pot spacer washer | (off-board) | offboard_bom.md / test_jig_spec.md
2 | 0 | 0 | (rule) M9 washer 9.5 / 11 x 1.5 | Pan pot spacer washer | (off-board) | offboard_bom.md / test_jig_spec.md
0 | 1 | 0 | (rule) copper bar ~15 x 2 mm with 6.3 mm tabs, M4 lug | Ground bar (jig star point) | (off-board) | offboard_bom.md / test_jig_spec.md | test_jig_spec.md 1
1 | 0 | 0 | (rule) strip panel blank, cut only, from panels/strip.dxf | Panel, 1.5 mm aluminium | (off-board) | offboard_bom.md / test_jig_spec.md | mechanical checks on the real board; the printed prototype waits for the fader law (panels/README.md)
2 | 0 | 0 | C&K PVBK | PV key cap black | (off-board) | offboard_bom.md / test_jig_spec.md | ON; one more for check 3
8 | 0 | 0 | C&K PVGY | PV key cap grey | (off-board) | offboard_bom.md / test_jig_spec.md | strip: PRE x3, HPF, EQ, DIR, PAN, Phase (KC1); samples check 3
2 | 0 | 0 | C&K PVRD | PV key cap red | (off-board) | offboard_bom.md / test_jig_spec.md | PFL; one more for check 3
3 | 0 | 0 | C&K PVWH | PV key cap white | (off-board) | offboard_bom.md / test_jig_spec.md | routing L-R / 1-2 / 3-4
2 | 0 | 2 | Wurth 61201023021 | 10-way IDC socket | (off-board) | offboard_bom.md / test_jig_spec.md | jack-board link
1 | 6 | 2 | Wurth 61203423021 | 34-way IDC socket | (off-board) | offboard_bom.md / test_jig_spec.md | A: a bench-power lead on the strip header (pins 30-31 -V, 32-34 +V, even 2-16 GND); B: 0.6 m and 3 m jig ribbons (strip, stub, load board each); B2: the second strip on both
