cozycactus/goa-console/bom/order_phase1_prices.csv

Stage A | Stage B | Stage B: 2nd strip | MPN / code | Values / what | Unit USD | Source / note | A USD | B USD | 2nd strip USD
6 | 0 | 0 | (rule) 8 x 1.2 mm slot fader cap, white / red / yellow | Fader cap, coloured trial | 1.860 | Mouser Eagle 450-SL, slot unverified | 11.16 | 0.00 | 0.00
1 | 0 | 0 | Bourns PTB0144-2010BPA103 | Fader, master | 6.680 | read 2026-11-04 | 6.68 | 0.00 | 0.00
4 | 0 | 0 | C&K PVA2 EE H1 1.7N V2 | Key switch, the console height (due 2027-03-01) | 2.790 | read 2026-11-03 | 11.16 | 0.00 | 0.00
1 | 0 | 0 | Elma 021-3425 | Knob, 6 mm | 7.480 | RS | 7.48 | 0.00 | 0.00
3 | 0 | 0 | Elma 021-3525 | Knob, 1/4" | 3.280 | Don-Audio, EUR 2.93 incl. VAT | 9.84 | 0.00 | 0.00
1 | 0 | 0 | Elma 040-3015 | Knob cap grey | 2.330 | RS | 2.33 | 0.00 | 0.00
1 | 0 | 0 | Elma 040-3025 | Knob cap black | 0.580 | Don-Audio | 0.58 | 0.00 | 0.00
1 | 0 | 0 | Elma 040-3035 | Knob cap red | 2.330 | RS | 2.33 | 0.00 | 0.00
1 | 0 | 0 | Elma 040-3045 | Knob cap blue | 0.580 | Don-Audio | 0.58 | 0.00 | 0.00
1 | 0 | 0 | Elma 040-3055 | Knob cap yellow | 0.580 | matt yellow not found: glossy 040-3050 | 0.58 | 0.00 | 0.00
1 | 0 | 0 | Elma 040-3065 | Knob cap green | 1.860 | RS | 1.86 | 0.00 | 0.00
2 | 0 | 0 | Sifam LK110 tang 01 (RS 281-7197) | Fader cap, plain | 1.900 | RS pack of 5, GBP 2.83, covers LK111 too | 3.80 | 0.00 | 0.00
3 | 0 | 0 | Sifam LK111 01 | Fader cap, black, white line | 0.000 | not found: the RS LK110 pack covers it | 0.00 | 0.00 | 0.00
14 | 0 | 14 | C&K PVA2 EE H3 1.7N V2 | PFL / ON / Assign L-R / Assign 1-2 / Assign 3-4 / PRE 1-2 / PRE 3-4 / PRE 5-6 / HPF / EQ / DIR / PAN / Phase | 2.490 | read 2026-11-03 | 34.86 | 0.00 | 34.86
0 | 21 | 0 | C&K OS102011MS2QN1 | MIXL +1 ch / MIXL +3 ch / MIXL +4 ch / MIXL +12 ch / MIXR +1 ch / MIXR +3 ch / MIXR +4 ch / MIXR +12 ch / SUB1 +1 ch / SUB1 +3 ch / SUB1 +4 ch / SUB1 +12 ch / AUX1 +1 ch / AUX1 +3 ch / AUX1 +4 ch / AUX1 +12 ch / PFL +1 ch / PFL +3 ch / PFL +4 ch / PFL +12 ch | 0.683 | Mouser | 0.00 | 14.34 | 0.00
15 | 16 | 15 | KEMET C0805C101J5GACTU | 100p C0G | 0.106 | Mouser cut tape @10 (category price) | 1.59 | 1.70 | 1.59
0 | 13 | 0 | KEMET C0805C102J5GACTU | 1n C0G | 0.106 | Mouser cut tape @10 (category price) | 0.00 | 1.38 | 0.00
11 | 22 | 11 | KEMET C0805C220J5GACTU | 22p C0G / 22p C0G 5% | 0.106 | Mouser cut tape @10 (category price) | 1.17 | 2.33 | 1.17
12 | 0 | 12 | KEMET C0805C330J5GACTU | 33p C0G | 0.106 | Mouser cut tape @10 (category price) | 1.27 | 0.00 | 1.27
11 | 0 | 11 | Murata GRM21BR71H105KA12L | 1u | 0.045 | Mouser cut tape @10 (category price) | 0.49 | 0.00 | 0.49
12 | 0 | 12 | Samsung CL21B103KBANNNC | 10n | 0.045 | Mouser cut tape @10 (category price) | 0.54 | 0.00 | 0.54
52 | 26 | 52 | Samsung CL21B104KBCNNNC | 100n | 0.045 | Mouser cut tape @10 (category price) | 2.34 | 1.17 | 2.34
12 | 0 | 12 | Samsung CL21B224KBFNNNE | 220n | 0.045 | Mouser cut tape @10 (category price) | 0.54 | 0.00 | 0.54
21 | 0 | 21 | KEMET C1206C100J5GACTU | 10p C0G | 0.138 | Mouser cut tape @10 (category price) | 2.90 | 0.00 | 2.90
11 | 0 | 11 | KEMET C1206C101J5GACTU | 100p C0G | 0.138 | Mouser cut tape @10 (category price) | 1.52 | 0.00 | 1.52
11 | 0 | 11 | KEMET C1206C103J5GACTU | 10n C0G | 0.138 | Mouser cut tape @10 (category price) | 1.52 | 0.00 | 1.52
17 | 0 | 17 | KEMET C1206C220J5GACTU | 22p C0G | 0.138 | Mouser cut tape @10 (category price) | 2.35 | 0.00 | 2.35
11 | 0 | 11 | KEMET C1206C222J5GACTU | 2n2 C0G | 0.138 | Mouser cut tape @10 (category price) | 1.52 | 0.00 | 1.52
11 | 0 | 11 | KEMET C1206C223J5GACTU | 22n C0G | 0.138 | Mouser cut tape @10 (category price) | 1.52 | 0.00 | 1.52
11 | 0 | 11 | KEMET C1206C330J5GACTU | 33p C0G | 0.138 | Mouser cut tape @10 (category price) | 1.52 | 0.00 | 1.52
13 | 0 | 13 | KEMET C1206C472J5GACTU | 4n7 C0G | 0.138 | Mouser cut tape @10 (category price) | 1.79 | 0.00 | 1.79
13 | 0 | 13 | Murata GRM31C5C1H104JA01L | 100n C0G | 0.300 | Mouser cut tape @10 (category price) | 3.90 | 0.00 | 3.90
0 | 13 | 0 | Samsung CL31B105KBHNNNE | 1u | 0.116 | Mouser cut tape @10 (category price) | 0.00 | 1.51 | 0.00
6 | 0 | 6 | Nichicon UES1E101MPM | 100u NP 25V | 0.930 | read 2026-11-04 | 5.58 | 0.00 | 5.58
0 | 4 | 0 | Nichicon UPW1E471MPD | 470u 25V | 0.670 | taped MPD6TA in stock | 0.00 | 2.68 | 0.00
0 | 4 | 0 | Panasonic ECE-A1EN100U | 10u NP 25V | 0.430 | 13 in stock | 0.00 | 1.72 | 0.00
4 | 0 | 4 | Rubycon 63ZLH47MEFC6.3X11 | 47u 25V | 0.430 | read 2026-11-03 | 1.72 | 0.00 | 1.72
8 | 0 | 8 | Nichicon UES1E330MPM | 33u NP 25V | 0.770 | read 2026-11-04 | 6.16 | 0.00 | 6.16
0 | 4 | 0 | Nichicon UPW1J470MPD | 47u 25V | 0.480 | Mouser | 0.00 | 1.92 | 0.00
4 | 0 | 4 | Panasonic EEU-FR1E221 | 220u 25V | 0.730 | read 2026-11-03 | 2.92 | 0.00 | 2.92
3 | 0 | 3 | WIMA MKS2D031501C00KSSD | 150n film | 0.590 | read 2026-11-04 | 1.77 | 0.00 | 1.77
5 | 0 | 5 | KEMET MMK5225K63J06L4BULK | 2.2u film | 1.400 | read 2026-11-04 | 7.00 | 0.00 | 7.00
4 | 0 | 4 | Neutrik NJ6FD-V | Line in TRS / Insert TRS switched / Direct out TRS / Jack | 2.000 | read 2026-11-04 | 8.00 | 0.00 | 8.00
0 | 2 | 0 | Neutrik NC3MAH | MIX L balanced out | 2.370 | Mouser | 0.00 | 4.74 | 0.00
0 | 7 | 0 | Amphenol B6252HB-NPP3G-50 | MIX L out / MIX R out / SUB 1 out / AUX 1 out / AUX 2 out / PFL MIX out | 4.810 | not at Mouser: Newark | 0.00 | 33.67 | 0.00
3 | 0 | 3 | Wurth 61201021621 | Jack board link 2x5 / Main board link 2x5 | 0.470 | read 2026-11-04 | 1.41 | 0.00 | 1.41
2 | 3 | 2 | Wurth 61203421621 | Bus 2x17 / Bus 2x17 (ribbon) | 1.640 | read 2026-11-04 | 3.28 | 4.92 | 3.28
0 | 5 | 0 | 2.54 mm header + shunt | GC TIE (fit = 22R tie) / MIXL +1 nF / MIXR +1 nF / SUB1 +1 nF | 0.440 | Wurth header + shunt | 0.00 | 2.20 | 0.00
0 | 2 | 0 | 2.54 mm header + shunt | GC REF (1-2 D, 2-3 A) | 0.440 | Wurth header + shunt | 0.00 | 0.88 | 0.00
0 | 4 | 0 | Diodes B540C-13-F | SS54 | 0.940 | Mouser | 0.00 | 3.76 | 0.00
4 | 0 | 4 | onsemi MBR140SFT1G | MBR140SFT1G | 0.600 | read 2026-11-03 | 2.40 | 0.00 | 2.40
0 | 4 | 0 | Vishay 1N4148-TAP | 1N4148 | 0.260 | Mouser | 0.00 | 1.04 | 0.00
0 | 16 | 0 | Murata BLM21PG221SN1D | Ferrite 220R@100MHz | 0.116 | Mouser | 0.00 | 1.86 | 0.00
4 | 0 | 4 | Kingbright WP710A10GD | ON green / EQ green / Panel LED green | 0.240 | read 2026-11-04 | 0.96 | 0.00 | 0.96
3 | 3 | 3 | Kingbright WP710A10ID | PFL red / PFL ACTIVE red / Panel LED red | 0.220 | read 2026-11-04 | 0.66 | 0.66 | 0.66
5 | 0 | 5 | Kingbright WP710A10YD | L-R yellow / 1-2 yellow / 3-4 yellow / Panel LED yellow | 0.260 | read 2026-11-04 | 1.30 | 0.00 | 1.30
5 | 0 | 5 | Vishay DG413DY-T1-E3 | DG413 | 1.700 | read 2026-11-03 | 8.50 | 0.00 | 8.50
0 | 3 | 0 | TI DRV135UA | DRV135 | 7.170 | Mouser | 0.00 | 21.51 | 0.00
5 | 3 | 5 | TI LM393BIDR | LM393 | 0.240 | stock read 2026-11-03 | 1.20 | 0.72 | 1.20
13 | 8 | 13 | TI OPA1612AID | OPA1612 | 7.410 | read 2026-11-03 | 96.33 | 59.28 | 96.33
11 | 3 | 3 | TI OPA1656IDR | OPA1656 / OPA1656 (N1 swap on strip 1) | 2.240 | stock read 2026-11-03 | 24.64 | 6.72 | 6.72
7 | 0 | 7 | Diodes BAV99-7-F | BAV99 | 0.180 | read 2026-11-03 | 1.26 | 0.00 | 1.26
3 | 0 | 3 | Diodes BZX84C5V1-7-F | BZX84C5V1 | 0.220 | read 2026-11-03 | 0.66 | 0.00 | 0.66
8 | 0 | 8 | Nexperia BAV199,235 | BAV199 | 0.260 | read 2026-11-03 | 2.08 | 0.00 | 2.08
4 | 0 | 4 | onsemi MMBFJ112 | MMBFJ112 | 0.490 | read 2026-11-04 | 1.96 | 0.00 | 1.96
5 | 0 | 5 | onsemi MMBT3906LT1G | MMBT3906 | 0.150 | read 2026-11-04 | 0.75 | 0.00 | 0.75
4 | 0 | 4 | Nexperia BAT54W,115 | BAT54W | 0.210 | stock read 2026-11-03 | 0.84 | 0.00 | 0.84
7 | 0 | 7 | Alpha RD901F-40-15R1-A10K | Aux1 10K log / Aux2 10K log / Aux3 10K log / Aux4 10K log / Aux5 10K log / Aux6 10K log / Pot, single A10K | 1.290 | not at Mouser: Tayda | 9.03 | 0.00 | 9.03
6 | 0 | 6 | Alpha RD901F-40-15R1-B10K-0CD | Gain 10K lin CD / HF 10K lin CD / HI-MID gain 10K lin CD / LO-MID gain 10K lin CD / LF 10K lin CD / Pot, B10K detent | 1.290 | not at Mouser: Tayda | 7.74 | 0.00 | 7.74
4 | 0 | 4 | Alpha RD902F-40-15R1-A10K | HI-MID freq 10K A dual / LO-MID freq 10K A dual / HPF freq 10K A dual / Pot, dual A10K | 1.290 | not at Mouser: Tayda | 5.16 | 0.00 | 5.16
2 | 0 | 2 | ALPS RK09L1240015 | Pan 10K lin dual CD / Pan pot | 3.740 | read 2026-11-04 | 7.48 | 0.00 | 7.48
14 | 0 | 14 | Panasonic ERA-6AEB103V | 10K 0.1% | 0.169 | read 2026-11-04 | 2.37 | 0.00 | 2.37
0 | 34 | 0 | Panasonic ERA-6AEB222V | 2K2 0.1% | 0.500 | est: 0.1 % thin film | 0.00 | 17.00 | 0.00
0 | 12 | 0 | Panasonic ERJ-P06J1R0V | 1R | 0.042 | Mouser | 0.00 | 0.50 | 0.00
0 | 11 | 0 | Panasonic ERJ-P06J332V | 3K3 | 0.042 | Mouser | 0.00 | 0.46 | 0.00
13 | 0 | 13 | Panasonic ERJ-P06J750V | 75R | 0.042 | read 2026-11-04 | 0.55 | 0.00 | 0.55
11 | 0 | 11 | Yageo RC0805FR-0710ML | 10M 1% | 0.021 | Mouser cut tape @10 (category price) | 0.23 | 0.00 | 0.23
11 | 0 | 11 | Yageo RC0805FR-071K5L | 1K5 | 0.021 | Mouser cut tape @10 (category price) | 0.23 | 0.00 | 0.23
11 | 0 | 11 | Yageo RC0805FR-074M99L | 4M99 1% | 0.021 | Mouser cut tape @10 (category price) | 0.23 | 0.00 | 0.23
16 | 0 | 16 | Yageo RT0805FRE07100KL | 100K | 0.051 | stock read 2026-11-04; $0.051 = the top of the 10+ prices read | 0.82 | 0.00 | 0.82
12 | 16 | 12 | Yageo RT0805FRE07100RL | 100R | 0.051 | stock read 2026-11-04; $0.051 = the top of the 10+ prices read | 0.61 | 0.82 | 0.61
23 | 12 | 23 | Yageo RT0805FRE0710KL | 10K / 10K 1% | 0.018 | read 2026-11-04 | 0.41 | 0.22 | 0.41
11 | 13 | 11 | Yageo RT0805FRE0710RL | 10R GND cancel / 10R | 0.051 | stock read 2026-11-04; $0.051 = the top of the 10+ prices read | 0.56 | 0.66 | 0.56
16 | 0 | 16 | Yageo RT0805FRE0713KL | 13K 1% | 0.018 | read 2026-11-04 | 0.29 | 0.00 | 0.29
0 | 13 | 0 | Yageo RT0805FRE071K18L | 1K18 1% | 0.051 | not read; $0.051 = the top of the 10+ prices read | 0.00 | 0.66 | 0.00
0 | 13 | 0 | Yageo RT0805FRE071K58L | 1K58 1% | 0.051 | not read; $0.051 = the top of the 10+ prices read | 0.00 | 0.66 | 0.00
0 | 12 | 0 | Yageo RT0805FRE071K82L | 1K82 1% | 0.051 | not read; $0.051 = the top of the 10+ prices read | 0.00 | 0.61 | 0.00
19 | 0 | 19 | Yageo RT0805FRE071KL | 1K | 0.051 | read 2026-11-04 | 0.97 | 0.00 | 0.97
15 | 0 | 15 | Yageo RT0805FRE071ML | 1M | 0.019 | read 2026-11-04 | 0.28 | 0.00 | 0.28
11 | 0 | 11 | Yageo RT0805FRE07220KL | 220K | 0.042 | read 2026-11-04 | 0.46 | 0.00 | 0.46
12 | 0 | 12 | Yageo RT0805FRE07220RL | 220R | 0.017 | read 2026-11-04 | 0.20 | 0.00 | 0.20
23 | 15 | 23 | Yageo RT0805FRE0722KL | 22K / 22K 1% | 0.051 | read 2026-11-04 | 1.17 | 0.76 | 1.17
0 | 11 | 0 | Yageo RT0805FRE0722RL | 22R | 0.051 | not read; $0.051 = the top of the 10+ prices read | 0.00 | 0.56 | 0.00
17 | 0 | 17 | Yageo RT0805FRE072K2L | 2K2 / 2K2 1% | 0.051 | stock read 2026-11-04; $0.051 = the top of the 10+ prices read | 0.87 | 0.00 | 0.87
12 | 0 | 12 | Yageo RT0805FRE072K49L | 2K49 1% | 0.017 | read 2026-11-04 | 0.20 | 0.00 | 0.20
0 | 11 | 0 | Yageo RT0805FRE07330KL | 330K | 0.051 | not read; $0.051 = the top of the 10+ prices read | 0.00 | 0.56 | 0.00
12 | 0 | 12 | Yageo RT0805FRE07330RL | 330R 1% | 0.017 | read 2026-11-04 | 0.20 | 0.00 | 0.20
12 | 0 | 12 | Yageo RT0805FRE0733KL | 33K | 0.021 | read 2026-11-04 | 0.25 | 0.00 | 0.25
12 | 13 | 12 | Yageo RT0805FRE07392RL | 392R 1% | 0.018 | read 2026-11-04 | 0.22 | 0.23 | 0.22
14 | 0 | 14 | Yageo RT0805FRE073K3L | 3K3 | 0.019 | read 2026-11-04 | 0.27 | 0.00 | 0.27
12 | 0 | 12 | Yageo RT0805FRE07430RL | 430R 1% | 0.018 | read 2026-11-04 | 0.22 | 0.00 | 0.22
12 | 0 | 12 | Yageo RT0805FRE07470KL | 470K | 0.018 | read 2026-11-04 | 0.22 | 0.00 | 0.22
25 | 0 | 25 | Yageo RT0805FRE0747KL | 47K | 0.018 | read 2026-11-04 | 0.45 | 0.00 | 0.45
12 | 0 | 12 | Yageo RT0805FRE074K22L | 4K22 1% | 0.051 | not read; $0.051 = the top of the 10+ prices read | 0.61 | 0.00 | 0.61
28 | 16 | 28 | Yageo RT0805FRE074K7L | 4K7 / 4K7 1% | 0.051 | not read; $0.051 = the top of the 10+ prices read | 1.43 | 0.82 | 1.43
14 | 0 | 14 | Yageo RT0805FRE074K99L | 4K99 1% | 0.051 | not read; $0.051 = the top of the 10+ prices read | 0.71 | 0.00 | 0.71
11 | 0 | 11 | Yageo RT0805FRE075K1L | 5K1 | 0.051 | not read; $0.051 = the top of the 10+ prices read | 0.56 | 0.00 | 0.56
0 | 12 | 0 | Yageo RT0805FRE075K49L | 5K49 1% | 0.051 | not read; $0.051 = the top of the 10+ prices read | 0.00 | 0.61 | 0.00
13 | 0 | 13 | Yageo RT0805FRE075K6L | 5K6 / 5K6 1% | 0.051 | not read; $0.051 = the top of the 10+ prices read | 0.66 | 0.00 | 0.66
11 | 0 | 11 | Yageo RT0805FRE076K8L | 6K8 | 0.051 | not read; $0.051 = the top of the 10+ prices read | 0.56 | 0.00 | 0.56
11 | 0 | 11 | Yageo RT0805FRE07750KL | 750K | 0.051 | not read; $0.051 = the top of the 10+ prices read | 0.56 | 0.00 | 0.56
0 | 12 | 0 | Yageo RT0805FRE077K32L | 7K32 1% | 0.051 | not read; $0.051 = the top of the 10+ prices read | 0.00 | 0.61 | 0.00
14 | 0 | 14 | Vishay M251206BB1009JP500 | 10R | 0.362 | read 2026-11-04 | 5.07 | 0.00 | 5.07
0 | 3 | 0 | Phoenix 1715734 MKDS 1,5/3-5,08 | Bench supply +V / 0 V / -V / Dummy load +V / 0 V / -V | 1.710 | Mouser | 0.00 | 5.13 | 0.00
0 | 21 | 0 | Keystone 5010 | GCANCEL / GCREF_BUF / SUM_ML / MIX_L / SUM_MR / MIX_R / SUM_S1 / SUB_1 / SUM_A1 / AUX_1 / SUM_A2 / AUX_2 / SUM_P / PFL_MIX / +VA / -VA / +VBUS_R / -VBUS_R / GNDA | 0.250 | Mouser | 0.00 | 5.25 | 0.00
0 | 3 | 0 | Bourns MF-RX160/72-0 | MF-RX160/72 | 0.340 | Mouser | 0.00 | 1.02 | 0.00
2 | 3 | 2 | Keystone 1287-ST | Ground spade 6.3mm / Ground spade 6.3mm (to the ground bar) | 0.190 | read 2026-11-04 | 0.38 | 0.57 | 0.38
5 | 0 | 3 | Kingbright WP3VEGW | OL red / SIG green / Signal / OL LED | 0.500 | read 2026-11-04 | 2.50 | 0.00 | 1.50
2 | 0 | 2 | Bourns PTB0143-2010BPA103 | Fader 10K log 100mm / Fader, strip / group | 5.520 | read 2026-11-04 | 11.04 | 0.00 | 11.04
0 | 1 | 0 | (rule) 0.1R 3 W | Test 2: spade-lead shunt | 4.070 | Ohmite 13FR100E | 0.00 | 4.07 | 0.00
1 | 0 | 0 | (rule) 10-way 1.27 mm flat cable | 10-way flat cable, m | 0.980 | 3M 3365/10 | 0.98 | 0.00 | 0.00
1 | 0 | 0 | (rule) 100R 0.01 % matched pair | Test 14: CMR source pair | 80.000 | OPTIONAL (excluded): VPG Z201 x2 (index price) | 80.00 | 0.00 | 0.00
0 | 1 | 0 | (rule) 10K 0.01 % matched pair | Test 13: common-mode sum | 16.050 | LT5400BCMS8E-1 (0.025 %) | 0.00 | 16.05 | 0.00
1 | 2 | 0 | (rule) 14 AWG stranded wire | 14 AWG wire, m | 1.000 | est: hardware-store wire (Mouser: aerospace $3.81/ft) | 1.00 | 2.00 | 0.00
0 | 1 | 0 | (rule) 1:1 audio isolation transformer | Test 2: ground injection | 50.000 | Edcor PCW600/600 EUR 44.65; Triad HS-56-TH $79.94 | 0.00 | 50.00 | 0.00
0 | 2 | 0 | (rule) 1K 0.1 % | Test 13: leg loads | 0.660 | Yageo MFP-25BRD52-1K | 0.00 | 1.32 | 0.00
1 | 0 | 0 | (rule) 1K 1 % | Test 14: 1 kohm tip resistor | 0.100 | Mouser | 0.10 | 0.00 | 0.00
6 | 0 | 0 | (rule) 3 mm LED spacer 7.6 mm | LED spacer | 0.210 | Keystone 7361 | 1.26 | 0.00 | 0.00
3 | 0 | 0 | (rule) 3-lead 3 mm LED spacer 7.2 mm, 2.0 pitch | LED spacer, WP3VEGW | 0.250 | Keystone 8909, pitch unverified | 0.75 | 0.00 | 0.00
2 | 0 | 0 | (rule) 3.5 mm M3 spacer | Fader spacer | 0.850 | RAF 4 mm stainless | 1.70 | 0.00 | 0.00
1 | 4 | 0 | (rule) 34-way 1.27 mm flat cable, 28 AWG | 34-way flat cable, m | 2.940 | 3M 3365/34 $0.896/ft | 2.94 | 11.76 | 0.00
2 | 6 | 2 | (rule) 6.3 mm insulated receptacle, blue | Spade receptacle | 0.670 | Panduit DNF14-250FIB-M | 1.34 | 4.02 | 1.34
6 | 0 | 0 | (rule) M3 F-F standoff 11.5 mm | Main-board standoff | 0.800 | Wurth 970120321 12 mm $0.44 + screw $0.36 | 4.80 | 0.00 | 0.00
2 | 0 | 0 | (rule) M3 F-F standoff 24.0 mm, metal | Jack-board standoff | 0.960 | Wurth 970240321 $0.60 + screw | 1.92 | 0.00 | 0.00
14 | 0 | 0 | (rule) M7 washer 1.5 x ID 7.2 x OD < 11.2 | Pot spacer washer | 0.140 | Alps 3A930060, thickness unknown | 1.96 | 0.00 | 0.00
2 | 0 | 0 | (rule) M9 washer 9.5 / 11 x 1.5 | Pan pot spacer washer | 0.500 | est: not found | 1.00 | 0.00 | 0.00
0 | 1 | 0 | (rule) copper bar ~15 x 2 mm with 6.3 mm tabs, M4 lug | Ground bar (jig star point) | 10.000 | est: made from copper strip | 0.00 | 10.00 | 0.00
1 | 0 | 0 | (rule) strip panel blank, cut only, from panels/strip.dxf | Panel, 1.5 mm aluminium | 35.000 | est: SendCutSend blank $17 + holes from DXF, $29-39 minimum | 35.00 | 0.00 | 0.00
2 | 0 | 0 | C&K PVBK | PV key cap black | 0.770 | read 2026-11-04 | 1.54 | 0.00 | 0.00
8 | 0 | 0 | C&K PVGY | PV key cap grey | 0.770 | read 2026-11-04 | 6.16 | 0.00 | 0.00
2 | 0 | 0 | C&K PVRD | PV key cap red | 0.650 | read 2026-11-04 | 1.30 | 0.00 | 0.00
3 | 0 | 0 | C&K PVWH | PV key cap white | 0.770 | read 2026-11-04 | 2.31 | 0.00 | 0.00
2 | 0 | 2 | Wurth 61201023021 | 10-way IDC socket | 0.480 | read 2026-11-04 | 0.96 | 0.00 | 0.96
1 | 6 | 2 | Wurth 61203423021 | 34-way IDC socket | 1.290 | read 2026-11-04 | 1.29 | 7.74 | 2.58
