cozycactus/goa-console/bom/group_jack_board_BOM.csv

Qty | Value | Footprint | MPN | DNP | References
1 | Main board link 2x8 | Connector_IDC:IDC-Header_2x08_P2.54mm_Vertical | Wurth 61201621621 (2x8 box header) |  | CN1
1 | Main board link 2 2x5 | Connector_IDC:IDC-Header_2x05_P2.54mm_Vertical | Wurth 61201021621 (2x5 box header) |  | CN2
1 | SUB insert | Connector_Audio:Jack_6.35mm_Neutrik_NJ6FD-V_Vertical | Neutrik NJ6FD-V |  | J1
1 | Sub out TRS | Connector_Audio:Jack_6.35mm_Neutrik_NJ6FD-V_Vertical | Neutrik NJ6FD-V |  | J2
1 | Aux out TRS | Connector_Audio:Jack_6.35mm_Neutrik_NJ6FD-V_Vertical | Neutrik NJ6FD-V |  | J3
1 | Return L in | Connector_Audio:Jack_6.35mm_Neutrik_NJ6FD-V_Vertical | Neutrik NJ6FD-V |  | J4
1 | Return R in | Connector_Audio:Jack_6.35mm_Neutrik_NJ6FD-V_Vertical | Neutrik NJ6FD-V |  | J5
1 | Return 2 L in | Connector_Audio:Jack_6.35mm_Neutrik_NJ6FD-V_Vertical | Neutrik NJ6FD-V |  | J6
1 | Return 2 R in | Connector_Audio:Jack_6.35mm_Neutrik_NJ6FD-V_Vertical | Neutrik NJ6FD-V |  | J7
