cozycactus/goa-console/panels/strip.dxf

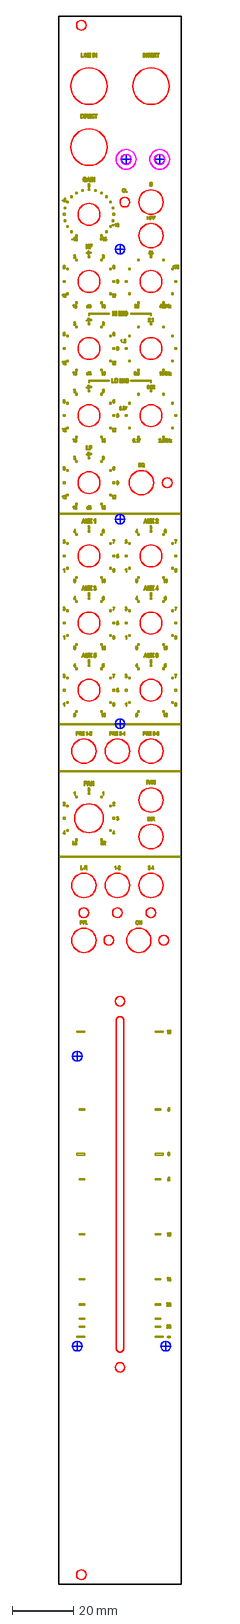
[picture p12: CAD file, 2026-11-11]
panels/strip.dxf
40.3 x 514.0 mm
