cozycactus/goa-console/psu_case/rear.dxf

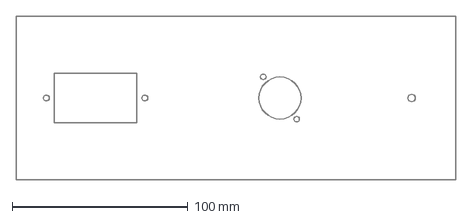
[picture p13: CAD file, 2026-10-25]
psu_case/rear.dxf
249.8 x 93.1 mm
