cozycactus/goa-console/tub/armrest.dxf

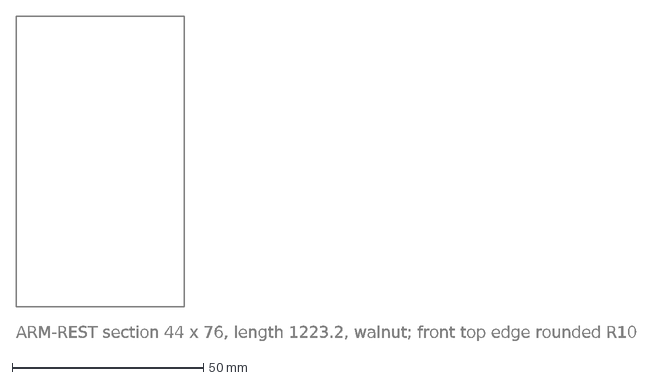
[picture p14: CAD file, 2026-10-25]
tub/armrest.dxf
ARM-REST section 44 x 76, length 1223.2, walnut; front top edge rounded R10
