cozycactus/goa-console/panels/group.dxf

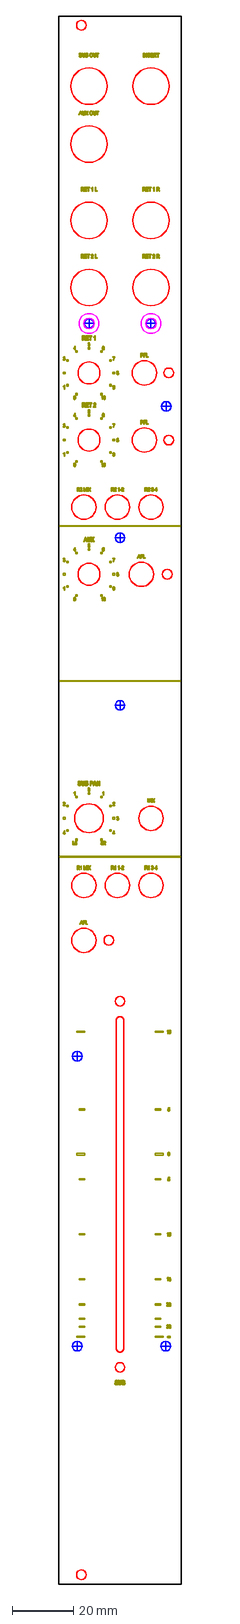
[picture p15: CAD file, 2026-11-11]
panels/group.dxf
40.3 x 514.0 mm
