cozycactus/goa-console/psu_case/base.dxf

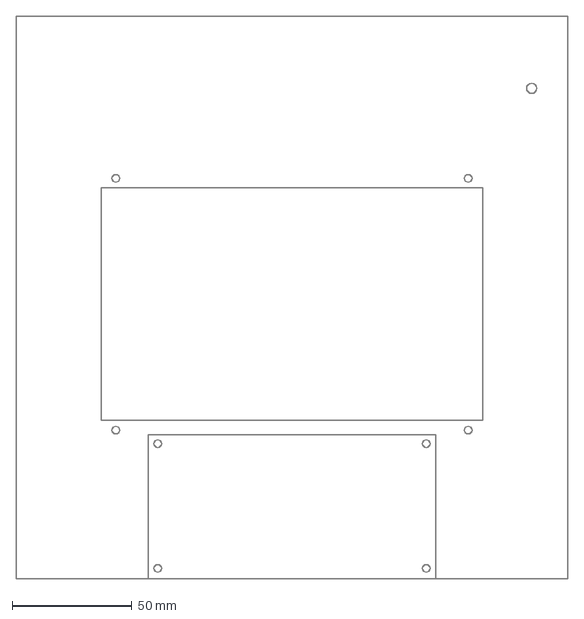
[picture p16: CAD file, 2026-10-25]
psu_case/base.dxf
230.0 x 234.6 mm
