cozycactus/goa-console/panels/master.dxf

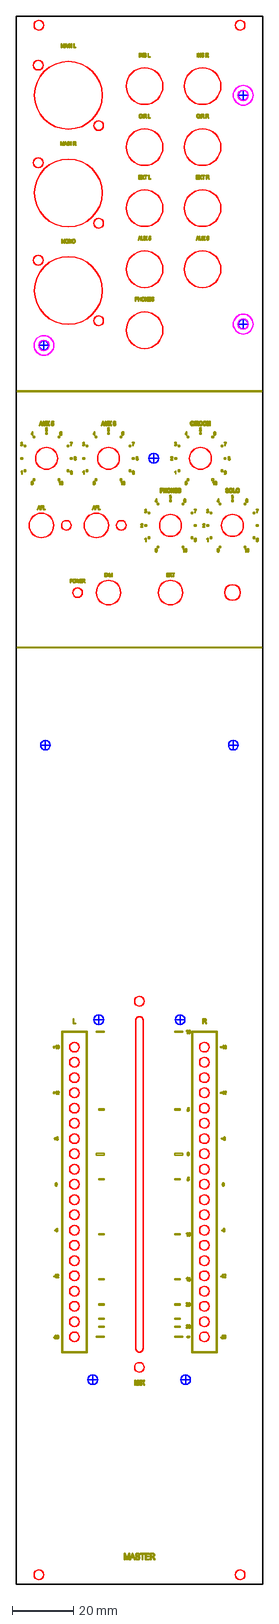
[picture p17: CAD file, 2026-10-27]
panels/master.dxf
80.9 x 514.0 mm
