cozycactus/goa-console/psu_case/front.dxf

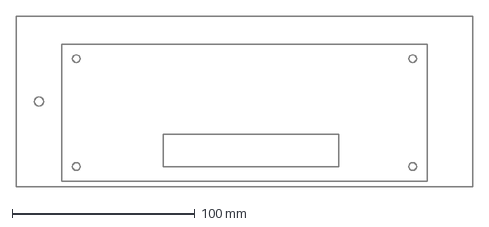
[picture p18: CAD file, 2026-10-25]
psu_case/front.dxf
249.8 x 93.1 mm
