cozycactus/goa-console/psu_case/heatsink.dxf

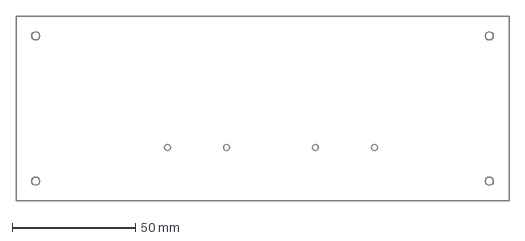
[picture p19: CAD file, 2026-10-25]
psu_case/heatsink.dxf
200.0 x 75.0 mm
