cozycactus/goa-console/tub/cheek.dxf

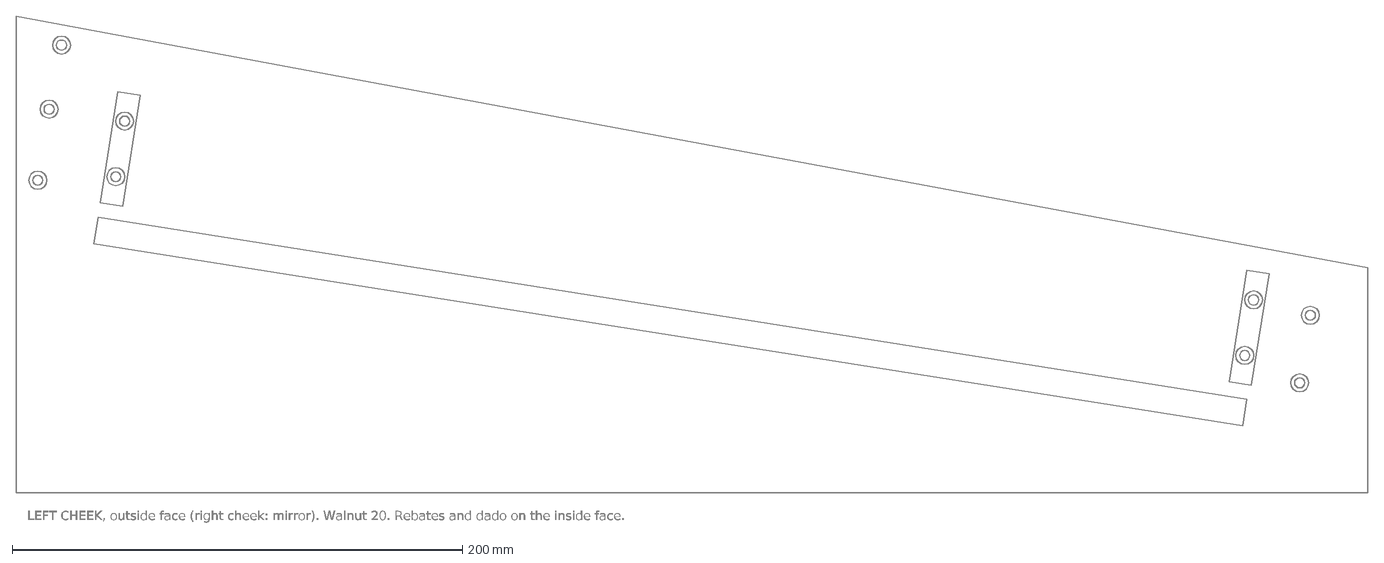
[picture p20: CAD file, 2026-10-25]
tub/cheek.dxf
LEFT CHEEK, outside face (right cheek: mirror). Walnut 20. Rebates and dado on the inside face.
