cozycactus/goa-console/(list of files, cad)

Other CAD files:
frame/rail.dxf
tub/cap.dxf
tub/rear_wall.dxf
tub/floor.dxf
