cozycactus/goa-console/test_jig_spec.md

# Test Jig — Specification, v0.11 (draft)
## Bus and grounding tests before ordering 24 strips

Implements `console_architecture.md` section 9 with the designs as they now stand
(strip spec v5.5 with its jack board, master spec v0.12; v0.11, 2026-11-11: the stub's and the load board's bus headers turned so that
pin 1 is at the front end as on the strips, the load board's header moved to its right edge (one flat ribbon, no twist; section 7);
v0.10, 2026-10-28: `docs/reviews/project_review.md` RV2 (tests 2-4 at N = K: the
load board's one ground-cancel tap), RV10 (the wing-current test's supply and PTC), the 4.1 mid-band targets at the EQM1
ranges; v0.9, 2026-10-27: tests 13-17 from `docs/studies/console_survey.md` CS11;
v0.8, 2026-10-27: the five-point, two-polarity overload LED (CS1) in 4.1; v0.6, 2026-10-25: the N1 A/B brought to strip v4.4, 4.2;
v0.7, 2026-10-26: the strip's signal / overload LED (MET1) in 4.1 and the strip current at v4.7).
The strips' bus header carries +V on pin 34 too (docs/proposals/wing_power_proposal.md W1), as the stub's and load board's do. Goal: confirm the Delta-style unbalanced bus with ground
cancel (config **D**) against the same bus without it (config **A**), and measure noise, hum,
crosstalk, PSRR, distortion and switching clicks on real hardware.

---

## 1. What gets built

| Item | Qty | What it is |
|---|-----|---|
| Channel strip | 4 | Real strip main boards (`channel_strip.kicad_sch`) with their jack boards (`jack_board.kicad_sch`) on the 10-way link, fully populated. The jig tests the boards that will be built, not stand-ins. Panels optional: the controls work without them. The OPA1656 A/B (4.2) is a swap on one strip (U1, U5, U6, U7, U12, U13, U14, U15 = TI OPA1656IDR, 8 parts, §1.1 stage A; U16 is OPA1656 on every strip); a second strip may be built as the B variant for a side-by-side in stage B. |
| Master stub | 1 | Bus side of the master only (section 2). |
| Load board | 1 | Dummy channels that raise the bus noise gain to the full 24-channel value (section 3). |
| Ribbon | 2 | 34-way, 28 AWG flat cable with 6 crimped IDC sockets (4 strips, master stub, load board): one 0.6 m (a 12-strip wing, ~0.5 m, plus slack), one 3 m (worst case and the hum-pickup tests). Order along it: load board, strips, master stub (the two jig boards end it; v0.11). |
| Ground bar | 1 | M4 copper bar with a lug per board, as the console's star point. |
| Supply | 1 | ±17 V bench or the console PSU, ≥ 1 A per rail (4 strips draw about 0.42 A from +V, 0.35 A from −V; master stub and load board about 0.15 A); ≥ 2 A per rail for the ribbon-current test (the load board's 17 Ω dummy load adds ~1 A per rail, RV10 below). |

The four strips also settle the strip-level open items (strip spec 16.1, 17): PVA2 orientation
(moulded "2" in the pad 1/4 column, by continuity), fader pad pattern, panel stack height,
NJ6FD-V body height (sets the jack-board standoffs), knob fit, and the function checks in 4.1.

### 1.1 Staged build (2026-10-28, to keep the first spend small)

Everything above is the full jig. It is bought and built in stages; `python3 tools/order_bom.py phase1` writes the parts
list per stage (`bom/order_phase1.csv`). Its strips carry PVA2 EE H3 keys (H1 is due 2027-03-01; same pads and latching, the cap 3 mm
higher; `docs/proposals/second_source_proposal.md` SS3), so the key cap clearance and panel stack checks wait for the H1 samples.

| Stage | Built | Tests |
|---|---|---|
| **A** | One strip and its jack board, on a ±17 V bench supply through an IDC lead on its bus header (about 0.1 A per rail; ±15 V will do). All four PCB designs ordered at once, 5 of each. | 4.1 (function), 9 (soft mute), 14 (CMR), 15 (fader breakthrough, pan isolation: decides CS9), every op-amp output on the scope, the sample checks on the real board with a cut-only panel blank. **N1 (4.2)**: measure, hot-air swap the 8 SOICs to OPA1656, measure again: one board, so the parts' spread stays out of the A/B. |
| **B** | Master stub and load board on the 0.6 m ribbon, the ground bar; optionally a second strip. | 1-8, 10-13, 16, 17. The load board stands in for strips 3-24 (N up to 21 with one strip, 22 with two). Tests 2 and 17 are clearer with two strips' spades. |
| **C** | Strips 3 and 4, only if stage B leaves a question. | The rest of section 4 as written. |

Tests 1 and 16 (−100 to −107 dBu) need an analyser whose own floor sits well below them; the others work with a good
audio interface and REW.

## 2. Master stub

A cut-down master built from the same circuits (master spec sections 2, 3, 12, 13, 18):

- One 34-pin header, like every board on the jig: a single ribbon with crimped sockets for
  the four strips, the master stub and the load board.
- MIX L and MIX R: summing amp (OPA1612, 4K7 ∥ 100 pF, ferrite) + re-inverter (2K2 0.1 %, 22 pF on both legs),
  each summer and its re-inverter in one dual (on the master, MIX R, aux 5/6 and PFL are built this way).
- SUB 1: same as MIX (for routing and SUB-to-MIX crosstalk).
- AUX 1: OPA1612 summing amp (22K ∥ 100 pF) + re-inverter (for the 22K bus and its crosstalk). OPA1612, as the
  master and groups since the parts review (2026-10-23): an aux bus always carries every strip's 22K.
- PFL: OPA1656 summing amp + re-inverter, PFL-detect comparator and LED. The detect line is the master's:
  10K plus two 1N4148 to ground, 1 µF, threshold 0.50 V (330K / 10K); one press reads about 0.92 V.
- GCANCEL buffer (OPA1612 follower) for the re-inverters.
- **Config jumper JP_GC (3-pole, one per bus amp group):**
  - D (ground cancel): summing-amp + inputs on GCANCEL, re-inverter + legs on GCANCEL_BUF.
  - A (plain): both on the master's AGND.
  - Third position for the 22 Ω master-end tie test (GCANCEL to AGND through 22 Ω), the case
    the simulation says to avoid; measuring it confirms or refutes the simulation.
- Outputs: each re-inverter output to a BNC through 100 Ω, plus one DRV134 on MIX L for the
  balanced-output checks. No faders, inserts or monitoring.
- Power entry as the master (bench terminal or the console PSU's lead), PTC per rail (MF-RX160/72, hold 1.6 A at 23 °C, about 1.3 A at 40 °C), reverse Schottkys.
- Test points: GCANCEL, GCANCEL_BUF, each SUM and re-inverter output, ±V.

As generated: one config jumper (GC REF: 1-2 = D, 2-3 = A) sets every summing amp's + input and
the re-inverters' buffered reference together, and a separate 22 Ω tie jumper covers test 3. AUX 2
gets its own summing amp as well, for the crosstalk test. Unused buses (SUB 2–4, AUX 3–6) are tied
to AGND at the stub, standing in for their summing amps' virtual earths. Power comes from a bench
supply on a screw terminal, with MF-RX160/72 PTCs (the master moved to MF-RX250/185, the stub keeps the 160 for four
strips) and SS54 reverse diodes. The PFL
detect is one LM393 and an LED. The BNC outputs and the test points are as listed above.

## 3. Load board

Brings the bus noise gain up to what 24 routed channels give (1 + N), without 24 strips:

- On the ribbon like a strip, with its own spade to the ground bar and a 10 Ω ground-cancel
  resistor to pin 26, so its resistors return to a strip-like ground.
  **One tap for n channels (RV2, `docs/reviews/project_review.md`):** GCANCEL is the mean of the K boards that carry a 10 Ω tap
  (the strips plus the load board), while the bus weights each board's ground by its channel count, N = routed strips
  + n load-board channels. A ground offset δ in one strip therefore reaches the stub's re-inverter output as
  δ · (1 − N/K): exactly cancelled only when N = K (the load board switched to ONE channel), at n = 0 under-cancelled
  (−14 dB with four strips), at n = 20 D reads 11.6 dB *worse* than A (stage B, one strip: +19.6 dB). The load
  board's own ground is cancelled by only 2.4 dB at n = 20. So tests 2, 3 and 4 run at N = K (every strip routed, the
  load board at n = 1; N = 0 and other n only to see the 1 − N/K law), and the noise tests (1, 7, 16), which need the
  full N, don't read ground rejection. A load board whose tap follows its switches (10R / 3R3 / 2R5 / 0R82 per group on
  a second pole) would lift the restriction; not built.
- Per MIX / SUB 1 bus: 20 × 4K7 1 % from the bus pin to local ground, in switchable groups of
  1, 3, 4, 12 (DIP switch or jumpers): any N from 0 to 20 extra channels.
- Per AUX 1 / PFL: 20 × 22K 1 % in the same groups.
- Switch at the bus end of each group, off grounds the group (as the routing switches do).
- As generated, each group is one equivalent resistor: 4K7 / 1K58 / 1K18 / 392R, and 22K / 7K32 /
  5K49 / 1K82. That gives the same thermal noise and noise gain as 1 / 3 / 4 / 12 separate
  channels. Each group has a C&K OS102011 slide switch, and there are five buses: MIX L, MIX R,
  SUB 1, AUX 1, PFL.
- Bus capacitance: the strips' DG413 routing switches put about 44 pF each on MIX / SUB buses
  (35 pF on, 9 pF off), about 1.1 nF with 24 strips and the ribbon. Per MIX / SUB 1 bus, a jumper
  adds 1 nF C0G to AGND, so tests 1, 8 and 10 can run with the full-console bus capacitance.

With the four strips routed, N runs from 4 to 24, so the measured noise can be compared
directly with the table in architecture section 2.4 (−100.4 dBu expected at N = 24, OPA1612,
4K7).

## 4. Measurements

Test gear: an audio analyser (QuantAsylum QA403 or similar, or a good interface with REW),
a scope, a 1:1 isolation transformer for ground injection, a 0.1 Ω 3 W resistor.
Levels in dBu, 20 Hz–20 kHz unweighted unless stated. Record every result in config A and D.

| # | Test | Method | Target |
|---|---|---|---|
| 1 | Noise floor vs N | Strip inputs shorted, faders at the "0" mark, routed to MIX; load board N = 0, 8, 20. RMS and FFT at MIX L. | Within 2 dB of architecture 2.4 (−100.4 dBu at N = 24) plus strip noise. No discrete hum lines above −110 dBu. |
| 2 | Ground-difference rejection | Put 0.1 Ω in one strip's spade lead; drive 50 Hz through it from the isolation transformer. **Every strip routed, load board at n = 1 (N = K, section 3).** Read the offset δ = that strip's GNDA minus the stub's AGND during the injection (the ribbon's eight ground conductors shunt the 0.1 Ω: 1 A gives a few mV, not 100 mV) and quote every result against δ. Measure at MIX L. Repeat at 1 kHz. | D at least 40 dB better than A at 50 Hz (A reads δ at unity; D reads δ (1 − N/K) + the re-inverter floor). Expect D at about −54 to −65 dB at 50 Hz, set by each re-inverter's 0.1 % match (the old −71 dB figure was the model's 1 nF bus capacitance); the spread between the BNC outputs shows the match. Also read TP GCREF_BUF minus TP GCANCEL during the injection: expect < −90 dB (the buffer is not the limit). If the worst output is above about −55 dB, fit 0.05 % / 0.01 % ratio-matched quads. |
| 3 | 22 Ω master-end tie | As test 2 (N = K) with JP_GC in the tie position. | Confirms the simulated loss (simulation, 1 V difference at 10 Hz: −7 dB with the tie; without it, the re-inverter match floor of test 2). The master's 100K keeper costs −79 dB, below that floor; if the tie result differs, revisit master spec section 3. |
| 4 | Hum pickup | 3 m ribbon laid along a loaded mains cable; then a deliberate ground loop through a synth connected to two strips. Load board at n = 1 (N = K). | No 50/100/150 Hz lines above −100 dBu at MIX L in D. |
| 5 | Crosstalk | One strip, 0 dBu, routed only to AUX 1 (pin 24); measure on MIX L, MIX R, SUB 1, AUX 2 (the ungrounded neighbours 17–25). 1 kHz, 10 kHz, 20 kHz. | ≤ −80 dB at 10 kHz between adjacent buses. |
| 6 | PSRR, power on the ribbon | 100 mV ripple at 100 Hz, 1 kHz, 10 kHz injected on +V, then −V (series transformer or a modulated supply). Measure at MIX L. | Ripple at output ≤ −100 dBu at 100 Hz. If not, try separate 18–20 AWG power wiring (architecture 3.2). |
| 7 | THD+N, all channels | All four strips driven at 0 dBu, routed L-R, faders at "0", N = 20 on the load board. | ≤ 0.005 % at 1 kHz at MIX L; no rise with N. |
| 8 | Switching clicks | 1 kHz at 0 dBu and silence: toggle every routing (DG413), ON and PFL switch; record MIX L and PFL, raw and through a 20 kHz low-pass. Also DC at each DG413's bus pin. | No audible click. DG413 charge injection: sim −55 dBu peak in the 20 kHz band (`sim/routing_switch.cir`), target ≤ −50 dBu; DC < 1 mV. |
| 9 | Soft mute | ON switch off with 1 kHz at +10 dBu. | Depth ≥ 70 dB (netlist sim 76 dB at POST), no click. |
| 10 | Stability | Square wave 1 kHz and 10 kHz at MIX L with the 3 m ribbon, N = 20. Then, with a 100 MHz scope and a short ground spring, every re-inverter output (MIX L/R, SUB 1, AUX 1/2, PFL), idle and with a 10 kHz square through a strip, and with a 10 kHz square coupled onto GCANCEL through the test-2 transformer; scope GCANCEL_BUF too. | No ringing or oscillation; overshoot < 10 % (GCANCEL_BUF ≤ 20 %). The re-inverters carry 22 pF on both legs (master spec section 3); without them TI's model rings at about 15 MHz. |
| 11 | Balanced output | DRV134 on MIX L: level, both legs, then one leg grounded. | +6 dB differential and single-ended; no change in THD. |
| 12 | Group bus select | When group boards join the ribbon: power up with the groups fitted, then measure DC at each group's summer output (S_SUM, A_SUM) and at its insert send tip. Repeat after any jumper change. | Each < 50 mV. Two groups jumpered to one SUB or AUX bus drive both summers to opposite rails (±16.5 V, ~16 V DC on the send): each board closes one SUB and one AUX jumper, unique across the four, with its group number in the silk's GRP box (master spec §12, `docs/reviews/master_group_review.md` MG19). |
| 13 | Output balance (CS11) | DRV134 on MIX L at +4 dBu differential, 100 Hz, 1 kHz, 20 kHz; each leg into 1 kΩ 0.1 % to the stub's AGND. Read the common-mode part (V+ + V−) / 2 against V+ − V− (both legs to the analyser's two inputs, or a 10 kΩ 0.01 % pair to a test point for the sum). First measure the two 10 µF NP couplers' capacitance. | From TI's model (`sim/review/cs11/jig_targets.py`): −90 dB below 1 kHz with the two 10 µF equal; with them 20 % apart (their ±20 % tolerance) −25 dB at 100 Hz, −35 dB at 1 kHz; −62 dB at 20 kHz either way. The DRV's cross-coupled loop floats the output, so a coupler mismatch shows up as common mode; a balanced receiver rejects it. Pass: within 3 dB of the value the measured capacitances predict. |
| 14 | Line-input CMR (CS11), each strip | 0 dBu common mode at J1 (tip and ring together against the sleeve), read at PRE (gain at the detent, EQ out): (a) through a matched 100 Ω pair (0.01 %); (b) through 1 kΩ on the tip and the ring direct (a synth's output on a pseudo-balanced cable). 50 Hz, 1 kHz, 10 kHz, 20 kHz. | (a) ≥ 58.7 dB at 50 Hz and 1 kHz: the 0.1 % bridge R6-R9, worst 5 % (median 68; `docs/studies/ground_study.md` §5.2). (b) ≥ 54 dB at 50 Hz, about 56 / 38 / 32 dB at 1 / 10 / 20 kHz (C8 / C9 at the jack and C94 / C95 at the followers against the 1 kΩ; netlist sim). Less at 50 Hz: suspect the bridge resistors. |
| 15 | Fader breakthrough and pan isolation (CS11), each strip | 0 dBu in, routed L-R. Fader at the bottom stop: MIX L against the fader at its "0" mark, 1 kHz and 10 kHz. Pan hard left, then hard right: the far side against the near one. Then, unpowered, each pot's end resistance r (wiper to its end terminal at the stop). | Fader ≤ −80 dB below "0" at 1 kHz, which takes r ≤ 0.3 Ω (1 Ω gives −70 dB): worse means CS9 (fader shut-off compensation, `docs/build/sample_order.md` check 9). Pan ≥ 60 dB (r ≤ 10 Ω; an ideal pot gives −116 dB in `sim_console.py`). Both within 3 dB of 20 log(r / 3.1 kΩ) and 20 log(r / 10 kΩ) from the measured r; a bigger gap is another path (layout, ground). |
| 16 | MIX noise, faders down (CS11) | Strip inputs terminated in 50 Ω, every fader at the bottom, all four strips routed L-R; load board N = 0, 4, 8, 12, 16, 20 (N = 4…24). MIX L at its BNC, 20 Hz–20 kHz unweighted; record the analyser's own floor first. | Within 2 dB of the summer plus the stub's re-inverter: N 4 −106.7, 8 −104.7, 12 −103.2, 16 −102.0, 20 −101.0, 24 −100.1 dBu. The published figures (`docs/studies/console_survey.md` §2: Delta −80 dBu at 16, Sapphyre −90, PM-5000 −92) include their master stages; this is the bus alone. |
| 17 | GCANCEL current (CS11) | The voltage across each strip's R5 (10 Ω, AGND to pin 26): idle (DC and 50 Hz), then during test 2. | A record, not a pass / fail: the line's current is harmless, since the summers' + inputs draw none. Idle about 0.1 mV or less; tens of mV idle means a ground fault. During test 2 the injected strip's R5 carries δ (1 − 1/K) and each of the other K − 1 taps δ / K (K = 5 with four strips and the load board: 0.8 δ and 0.2 δ; the "80 mV / 20 mV" of v0.9 assumed δ = 100 mV, see test 2). Mackie's 510 Ω per channel would pass about 50 times less. |

### 4.1 Strip function checks (each of the four strips)

Targets from `tools/sim_netlist.py` (the exported netlists, 45 checks), `sim/review/eqmid/measure.py` (the mid ranges since
EQM1) and `sim/review/gaps/ol.py`.
1 kHz, 0 dBu at the line input unless stated.

| Check | Target |
|---|---|
| PRE level, gain at the detent; POST with the fader at the top | 0 dBu ± 0.3; +9.9 dBu |
| Gain pot CCW / CW | −14.9 / +14.8 dB |
| Ø: phase at PRE | 180° |
| HPF in: −3 dB | 86 Hz |
| HF at 12 kHz, CW / CCW | +11.4 / −11.7 dB |
| HI-MID boost at 600 Hz (freq CCW), 2.1 kHz (mid), 9.9 kHz (CW) | ≈ +14.5 dB each; peak frequency within ±15 % of 598 / 2086 / 9930 Hz (strip v5.5, EQM1) |
| LO-MID boost at 165 Hz, 520 Hz, 2.54 kHz | ≈ +14.5 dB each; peak within ±15 % of 165 / 521 / 2537 Hz |
| LF at 54 Hz, CW / CCW | +14.3 / −14.4 dB |
| EQ IN off, all bands at full boost | flat within 0.5 dB |
| Insert: nothing plugged (normal), send/return through a cable | 0 dB change |
| Direct out (DIR + PRE 5-6, aux 6 at the top) | 0 dBu at J5 tip; aux 6 bus silent |
| Routing: L-R, 1-2, 3-4 on and off (DG413) | +7.1 dBu on the bus with pan at centre, +11.5 dBu hard over, the far side below −80 dB (v5.4 pan law, CS2); PAN off +9.9 dBu; off: below −80 dB; LED follows the switch |
| PFL: bus level, PFL DET, LED | 0 dBu; master PFL logic switches |
| Signal LED (D2 green), 1 kHz sine at PRE | lights from about −20 dBu (sim −19.5); stays lit about 170 ms after the signal stops; dark with the input terminated |
| Overload LED (D2 red), 1 kHz sine at PRE | red alone (green off) from about +18 dBu (sim +18.4; +18.1 at 50 Hz); a 2-cycle burst at +19 dBu lights it for about 150 ms |
| Overload LED, negative peaks (v5.0, CS1) | a 1 kHz, 10 % pulse wave at the input, gain at the detent: red from about 9.0 V on the narrow peak whichever its polarity (sim +9.01 / −9.30 V); invert the pulse and it lights at the same level |
| Overload LED, post-amp (v5.0) | +14 dBu at PRE (red off), then the fader to the top: red lights (FPOST clips at about +23 dBu) |
| Overload LED, gain stage (v5.0) | 1 kHz at +15 dBu in, gain +9 dB (GOUT clips), LO-MID fully cut with its frequency at 1 kHz: red lights though PRE stays near +8 dBu |
| Overload LED at power-off | no red flash as the rails fall (the v5.0 negative side depends on +VL only); the ~150 ms red at power-up is the hold cap charging |
| D2 brightness behind the panel | both colours readable at about 3.2 mA (R15 / R124 4K7); change those two resistors if not |
| Supply current per strip (typical) | about 100 mA +V (104 with the green lit), 87 mA −V; more than 125 / 105 mA means a fault |

### 4.2 OPA1656 A/B (`docs/proposals/strip_noise_proposal.md`, N1)

One strip measured as built (**A**, OPA1612 but for the U16 input followers), then with TI OPA1656IDR hot-air swapped
into U1, U5, U6, U7, U12, U13, U14 and U15 (**B**; U2, U3 and U8 stay OPA1612; U16 is OPA1656 in both), measured again:
one board, so the parts' spread stays out of the A/B (§1.1, 2026-10-28; the earlier plan built two strips of each, and
`order_bom.py` still carried 16 extra OPA1656 for it: now 8). A second strip built as B in stage B is optional.
- **Why:** the simulation (strip v4.4, `docs/proposals/strip_noise_proposal.md`) gives B 3.3 dB less PRE noise with EQ in
  (−92.8 → −96.1 dBu) and 2.7 dB less at main L with 24 strips. That comes from removing the OPA1612's current noise
  in the EQ networks.
- **Stability in simulation:** datasheet-fitted macros, which read low against TI's models, give every B unit at least
  50° over 21 states. The integrators lose about 10° against A.
- **Distortion:** CMOS input capacitance can't be simulated at these levels. This A/B decides N1 (Ruslan,
  2026-10-25).
- **Setup:** measure every strip at the direct out (J5 tip, 10 kΩ load). Set DIR on, PRE 5-6 latched, aux 6 at the
  top, so J5 carries PRE through U8.
- **Common settings:** gain at the detent, EQ in with every band at its centre detent, HPF in (SW11), fader at "0",
  ON, the strip alone on the bus.
- **Analyser floor:** record its loopback residual first. A result within 3 dB of it means "at the floor", not a
  difference.

| # | Test | Method | Target |
|---|---|---|---|
| A1 | Noise | Input terminated in 50 Ω; 20 Hz–20 kHz unweighted and A-weighted, EQ in and EQ out (SW12), gain at the detent and at +15 dB. Same strips, same jack, back to back. | B quieter than A by about 3 dB with EQ in and about 2 dB with EQ out (sim at PRE, strip v4.4: A −92.8 / −102.5 dBu, B −96.1 / −104.5 dBu; HPF in: A −92.7, B −95.7; the direct-out buffer adds a little to both). |
| A2 | THD+N | 1 kHz, and a 20 Hz–20 kHz sweep, at +4 dBu and +20 dBu in (22 kHz bandwidth; 80 kHz as well if the analyser has it). Repeat at +20 dBu with every band at full boost and full cut. | B within 3 dB of A at each level and frequency, or both at the analyser floor. B rising with level or towards 20 kHz where A doesn't is the CMOS input-capacitance signature: reject B, or keep OPA1612 in the exposed units (U1A, U5A, U6A/B, U7A, U12A, U13B; that means splitting packages). |
| A3 | IMD | SMPTE (60 Hz + 7 kHz, 4:1) and CCIF (19 + 20 kHz, 1:1) at +4 dBu and +20 dBu peak-equivalent, HPF in. | B within 3 dB of A, or both at the floor. |
| A4 | Stability | 100 MHz scope, short ground spring, at every op-amp output: U1A/B, U2A/B, U3A/B, U5A/B, U6A/B, U7A/B, U8A/B, U12A/B, U13A/B, U14A/B, U15A/B, U16A/B; on B look hardest at the KHN / HPF integrators (U12B, U13A, U14A/B, U15A/B) and U7B, the lowest in simulation. Idle; with a 10 kHz square at +10 dBu; with 470 pF on the insert send and the direct out; with EQ bands, pan and fader at both ends. | No oscillation or ringing at any output, in A or B; step overshoot < 10 %. A strip-review stability cap missing its job on B shows up here: the caps were chosen with TI's OPA1612 model. |

Result: N1 is adopted as a strip revision if B passes A1–A4. If B is quieter but fails A2/A3, the exposed units stay
OPA1612 and only the inverting and integrator stages move, which takes a package split.

## 5. Decisions the jig settles

- **Ground cancel (D) vs plain (A).** If D passes tests 2 and 4, it stays as decided and the
  balanced-bus options B/C (architecture section 9) are dropped for good. If D fails, B/C need
  different strips and come back as a separate design study.
- **Master-end tie.** Test 3 confirms the "no tie" decision against hardware.
- **Power on the ribbon.** Test 6 decides between ribbon power and separate wiring.
- **PVA2 orientation, fader footprint, panel height, jack-board depth** — from the strips themselves.
- **OPA1656 in the strip's EQ, KHN and receiver (N1).** Section 4.2: adopt if B is quieter and holds THD+N, IMD and
  stability.
- **Ribbon power at the v4.7 strip current** (about 104 mA per strip on +V): test 6 at N = 20, plus the
  measured drop along the 0.6 m ribbon with the load board drawing a 12-strip wing's current. **RV10:** that dummy
  load (~1 A per rail) plus four strips (0.42 A) is 1.42 A through the stub's MF-RX160/72 (hold 1.6 A at 23 °C, ~1.3 A
  warm), and a real v5.x wing is ~1.25 A (1.67 A with the strips): run it with the strips unplugged, or fit
  MF-RX250/72 (+V) / MF-RX185/72 (−V) on the stub as the master has, and use a supply of ≥ 2 A per rail.

## 6. Not in the jig

- Faders, inserts, monitoring, meters and the power-on mute: tested on the real master later.
- Configs B and C (balanced bus): only if D fails.

## 7. Still to do

- ~~Schematics for the master stub and the load board~~ done 2026-10-22: `tools/gen_jig.py` writes
  `jig_master_stub.kicad_sch` (144 parts since v0.3) and `jig_load_board.kicad_sch` (50 parts) from the master's
  own circuit functions, now in `tools/master_lib.py`. Both: netlist 0 mismatches, every pin on a
  pad, ERC 0.
- The stub's XLR shell pad G is on CHASSIS (2026-10-28, with the master jack board's; symbol `XLR3_Shell`).
- ~~PCB placement~~ done 2026-10-22: `tools/place_jig.py` → `jig_master_stub.kicad_pcb` (160 × 125 mm:
  six BNCs and the balanced XLR on the front edge, ribbon header on the left, bench terminal top right,
  labelled jumpers) and `jig_load_board.kicad_pcb` (120 × 85 mm: a labelled 5 × 4 grid of slide switches,
  each with its group resistor). Both: 0 schematic-parity issues, 0 DRC violations; placement only, no
  copper. Routing is Ruslan's.
- **Bus headers turned (v0.11, 2026-11-11, Ruslan):** as first placed, both jig boards had pin 1 at the header's far
  end, while every console module has it at the fader end (the strips' header is on the bottom side, the jig boards'
  on top). On one flat ribbon a jig board then had to lie turned by 180° or the ribbon had to take a half twist. Now:
  the stub's CN2 turned by 180° on its pads (still on the left edge), the load board's CN1 on the right edge with pin 1
  at the front, and beside it the ground spade CN2, the 10 Ω tap R1 and the dummy-load terminal J1 (GCANCEL 26 mm,
  ±VBUS 42-47 mm on the load board; the 1 nF jumpers went to the left edge). The ribbon runs straight: load board,
  strips, stub, every board the same way up. `tools/jig_3d.py` draws the bench (`render/jig*.png`).
- The strips need routed boards: placement is done (`channel_strip.kicad_pcb`,
  `jack_board.kicad_pcb`); copper routing is Ruslan's.
- For the ribbon-current test, the load board could also carry a switchable dummy load
  (about 1 A per rail) to emulate a 12-strip wing.

*Document version 0.11 — 11 November 2026 (the jig boards' bus headers turned for a straight ribbon; 0.10 of 28 October 2026: RV2 / RV10 from `docs/reviews/project_review.md`, EQM1 targets; 0.9 of 27 October 2026 added
tests 13-17; 0.3 of 23 October 2026: master parts review: OPA1612 on AUX, re-inverter 22 pF, PFLDET clamp; test 2,
3 and 10 targets)*
