cozycactus/goa-console/pdf/group_jack_board.pdf

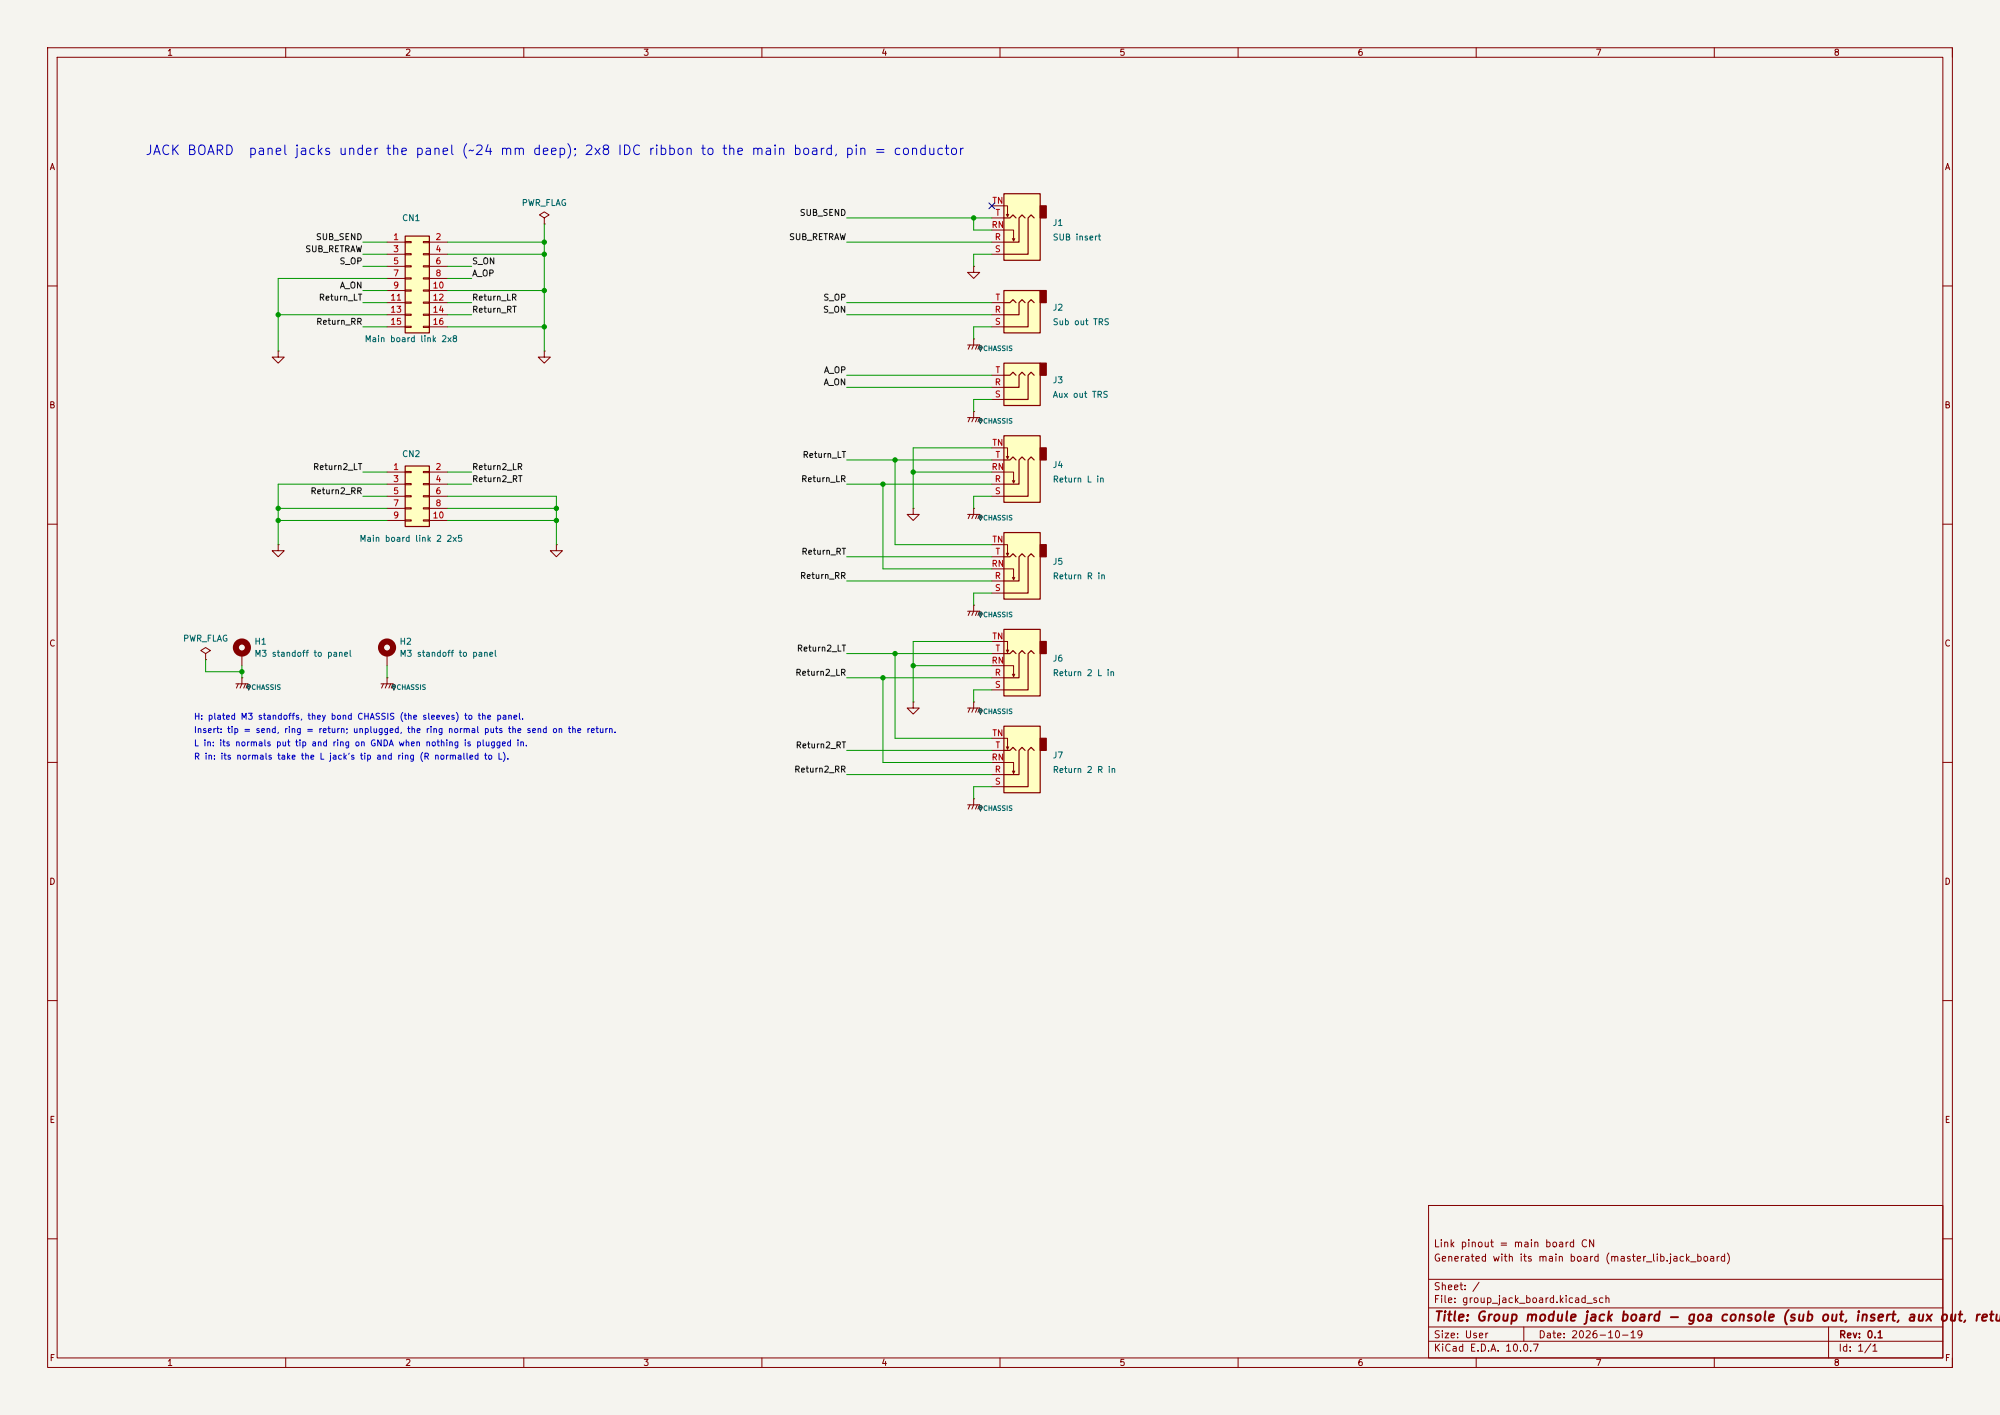
[picture p21: page 1]

JACK BOARD panel jacks under the panel (~24 mm deep); 2x8 IDC ribbon to the main board, pin = conductor

Insert: tip = send, ring = return; unplugged, the ring normal puts the send on the return. H: plated M3 standoffs, they bond CHASSIS (the sleeves) to the panel.

R in: its normals take the L jack's tip and ring (R normalled to L). L in: its normals put tip and ring on GNDA when nothing is plugged in.

Link pinout = main board CN
Generated with its main board (master_lib.jack_board)

Sheet: /
File: group_jack_board.kicad_sch
Title: Group module jack board - goa console (sub out, insert, aux out, return 1 and 2 L/R)

Size: User | Rev: 0.1 | F Date: 2026-10-19
KiCad E.D.A. 10.0.7 | Id: 1/1
