cozycactus/goa-console/pdf/jack_board.pdf

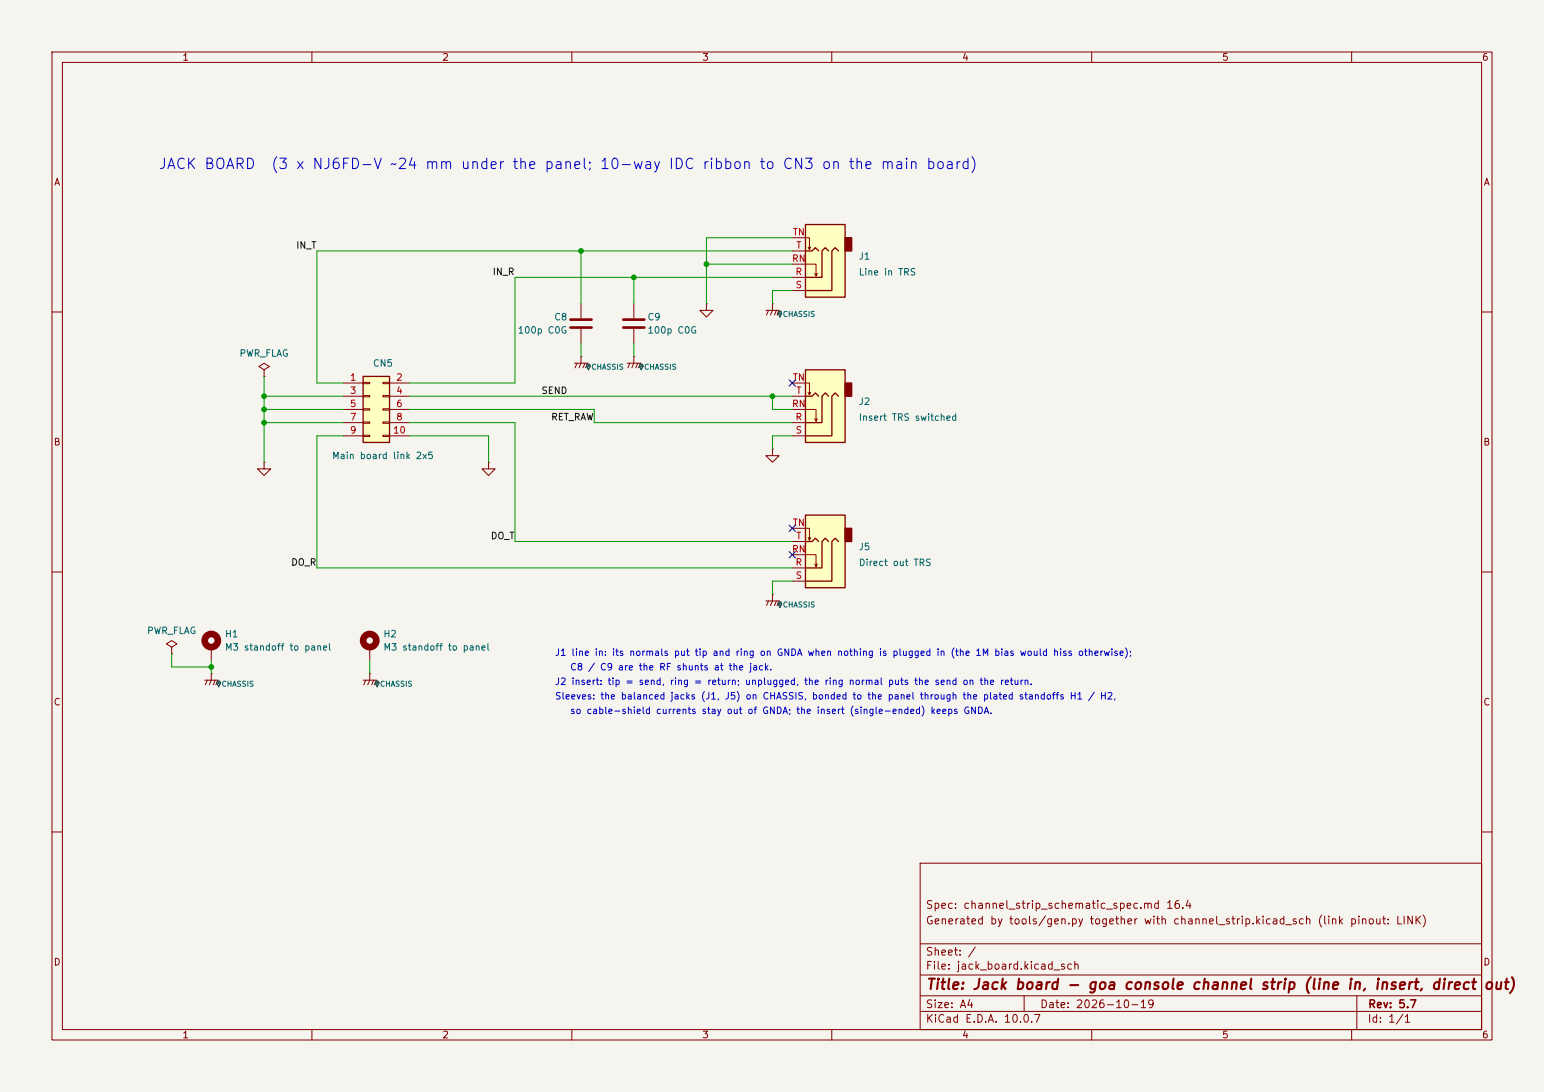
[picture p22: page 1]

JACK BOARD (3 x NJ6FD-V ~24 mm under the panel; 10-way IDC ribbon to CN3 on the main board)

5 | 6 | RN

Spec: channel_strip_schematic_spec.md 16.4
Generated by tools/gen.py together with channel_strip.kicad_sch (link pinout: LINK)

Sheet: /
File: jack_board.kicad_sch
Title: Jack board - goa console channel strip (line in, insert, direct out)

Size: A4 | Rev: 5.7
KiCad E.D.A. 10.0.7 | Id: 1/1
