cozycactus/goa-console/pdf/jig_load_board.pdf

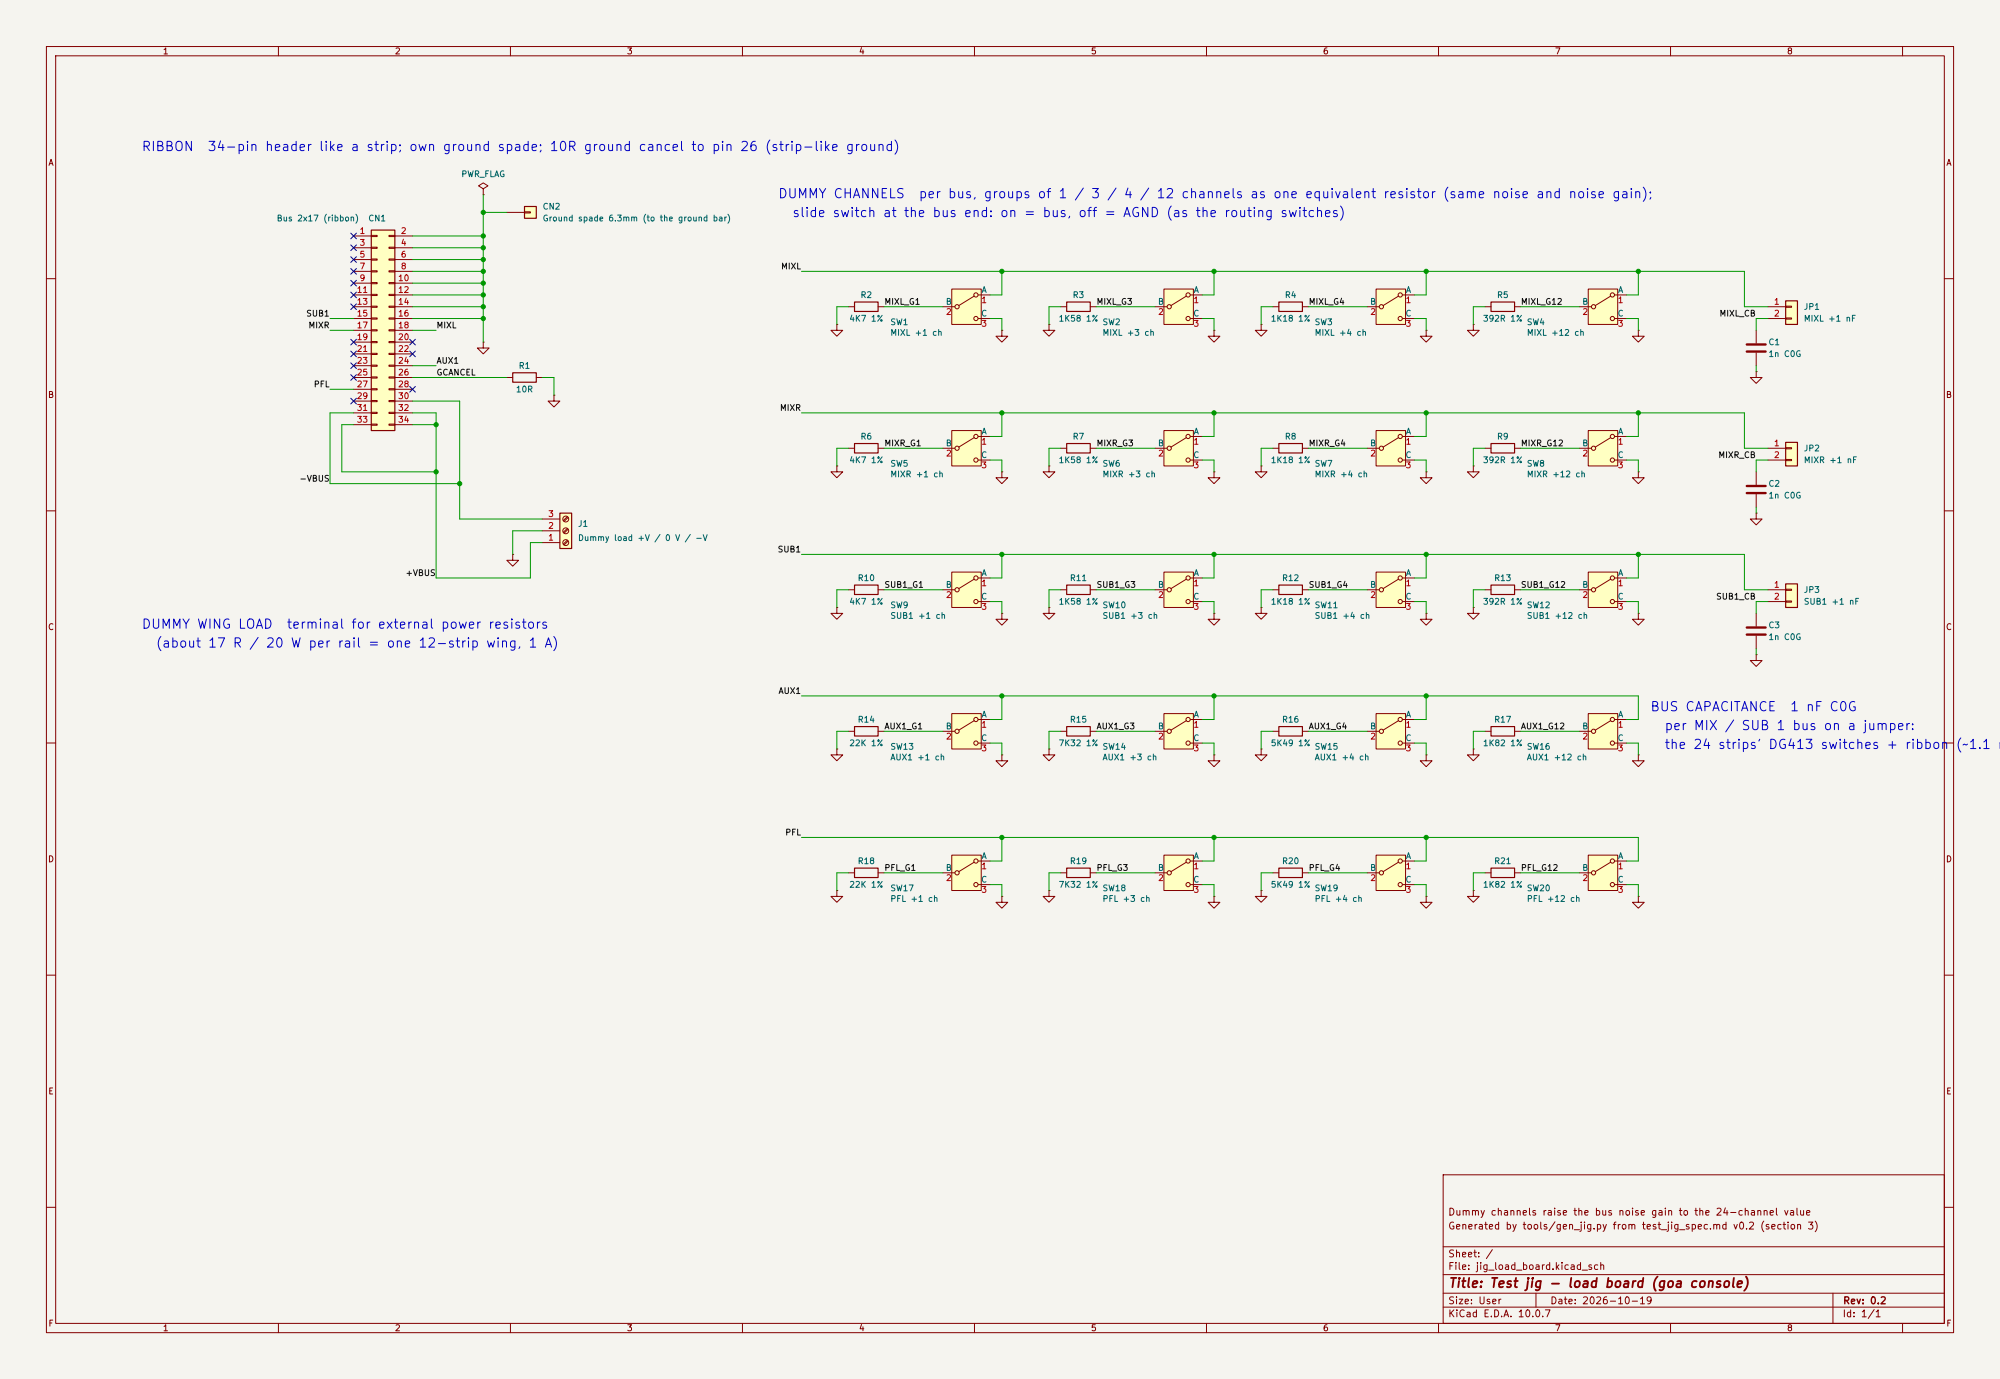
[picture p23: page 1]

RIBBON 34-pin header like a strip; own ground spade; 10R ground cancel to pin 26 (strip-like ground)

CN2 Ground spade 6.3mm (to the ground bar) PWR_FLAG

DUMMY CHANNELS per bus, groups of 1 / 3 / 4 / 12 channels as one equivalent resistor (same noise and noise gain);
AUX1slide switch at the bus end: on = bus, off = AGND (as the routing switches)

DUMMY WING LOAD terminal for external power resistors
(about 17 R / 20 W per rail = one 12-strip wing, 1 A)

BUS CAPACITANCE 1 nF C0G
per MIX / SUB 1 bus on a jumper:
the 24 strips' DG413 switches + ribbon (~1.1 nF)

Dummy channels raise the bus noise gain to the 24-channel value
Generated by tools/gen_jig.py from test_jig_spec.md v0.2 (section 3)

Sheet: /
File: jig_load_board.kicad_sch
Title: Test jig - load board (goa console)

Size: User | Rev: 0.2 | F Date: 2026-10-19
KiCad E.D.A. 10.0.7 | Id: 1/1
