cozycactus/goa-console/pdf/master_jack_board.pdf

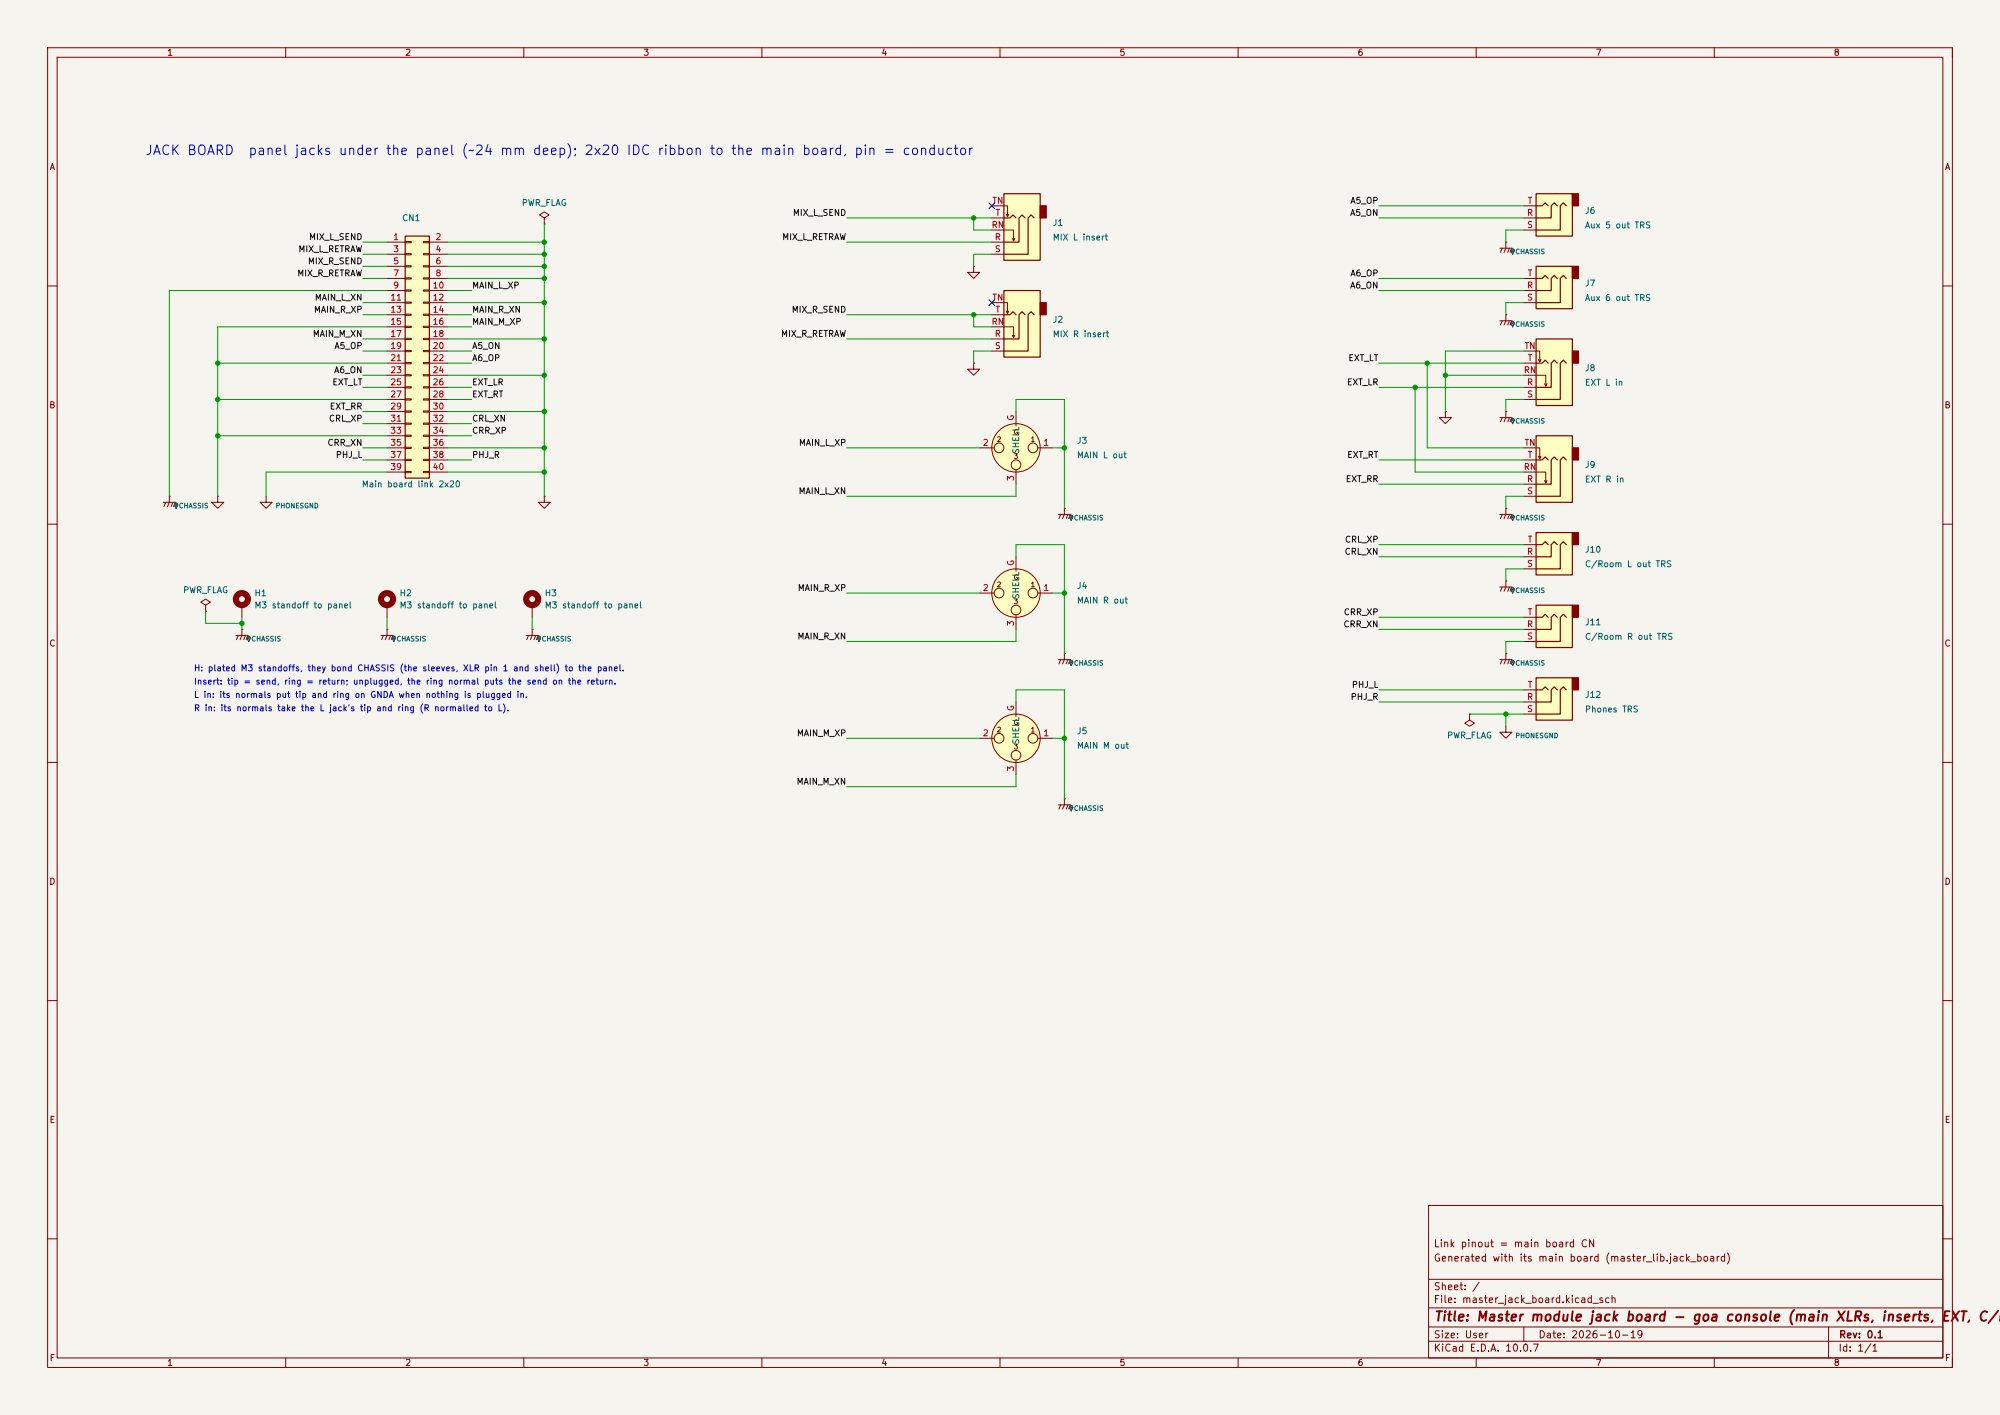
[picture p24: page 1]

EXT_LT EXT_LR MAIN_R_XN MAIN_L_XN JACK BOARD panel jacks under the panel (~24 mm deep); 2x20 IDC ribbon to the main board, pin = conductor H: plated M3 standoffs, they bond CHASSIS (the sleeves, XLR pin 1 and shell) to the panel.

Insert: tip = send, ring = return; unplugged, the ring normal puts the send on the return. L in: its normals put tip and ring on GNDA when nothing is plugged in. R in: its normals take the L jack's tip and ring (R normalled to L).

Link pinout = main board CN
Generated with its main board (master_lib.jack_board)

Sheet: /
File: master_jack_board.kicad_sch
Title: Master module jack board - goa console (main XLRs, inserts, EXT, C/Room, phones, aux 5-6)

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
