cozycactus/goa-console/pdf/psu.pdf

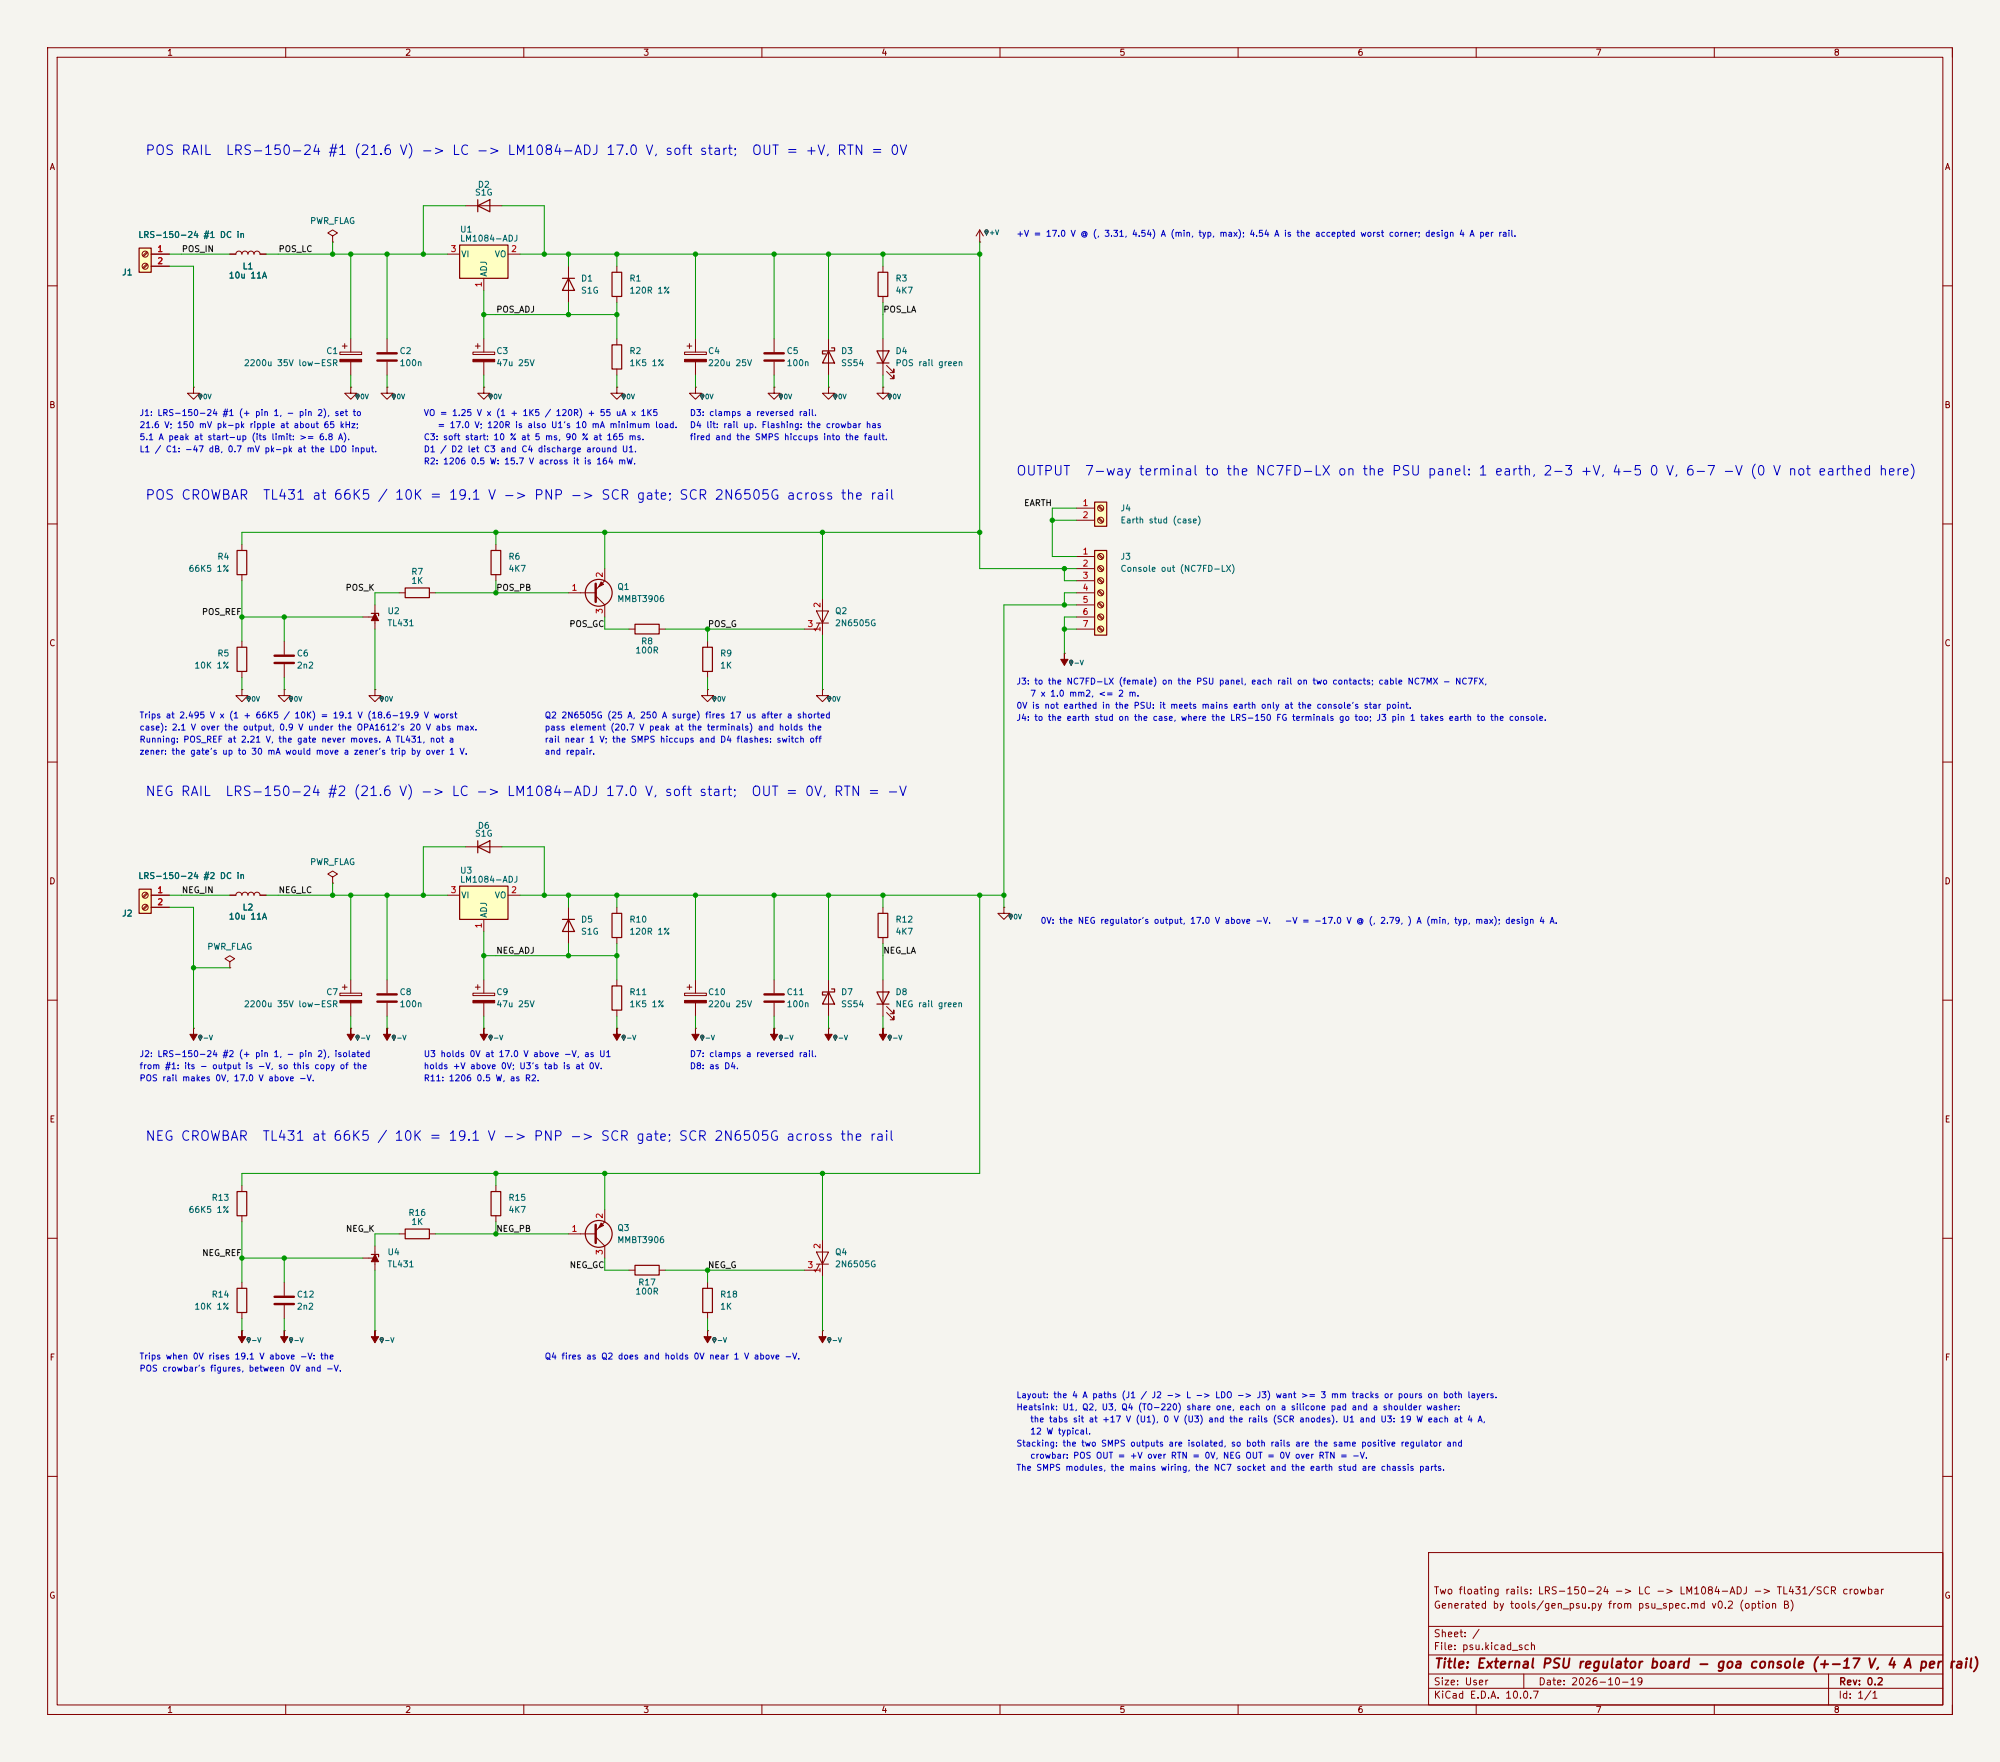
[picture p25: page 1]

POS RAIL LRS-150-24 #1 (21.6 V) -> LC -> LM1084-ADJ 17.0 V, soft start; OUT = +V, RTN = 0V

R2: 1206 0.5 W: 15.7 V across it is 164 mW. D1 / D2 let C3 and C4 discharge around U1. C3: soft start: 10 % at 5 ms, 90 % at 165 ms. VO = 1.25 V x (1 + 1K5 / 120R) + 55 uA x 1K5
fired and the SMPS hiccups into the fault. D4 lit: rail up. Flashing: the crowbar has D3: clamps a reversed rail. = 17.0 V; 120R is also U1's 10 mA minimum load. Q2 2N6505G (25 A, 250 A surge) fires 17 us after a shorted

POS CROWBAR TL431 at 66K5 / 10K = 19.1 V -> PNP -> SCR gate; SCR 2N6505G across the rail

J3: to the NC7FD-LX (female) on the PSU panel, each rail on two contacts; cable NC7MX - NC7FX, 7 x 1.0 mm2, <= 2 m. zener: the gate's up to 30 mA would move a zener's trip by over 1 V. Running: POS_REF at 2.21 V, the gate never moves. A TL431, not a

pass element (20.7 V peak at the terminals) and holds the
rail near 1 V; the SMPS hiccups and D4 flashes: switch off and repair.

NEG RAIL LRS-150-24 #2 (21.6 V) -> LC -> LM1084-ADJ 17.0 V, soft start; OUT = 0V, RTN = -V

J2: LRS-150-24 #2 (+ pin 1, - pin 2), isolated

Q4 fires as Q2 does and holds 0V near 1 V above -V. NEG CROWBAR TL431 at 66K5 / 10K = 19.1 V -> PNP -> SCR gate; SCR 2N6505G across the rail

Layout: the 4 A paths (J1 / J2 -> L -> LDO -> J3) want >= 3 mm tracks or pours on both layers.

Stacking: the two SMPS outputs are isolated, so both rails are the same positive regulator and
crowbar: POS OUT = +V over RTN = 0V, NEG OUT = 0V over RTN = -V. The SMPS modules, the mains wiring, the NC7 socket and the earth stud are chassis parts.

Two floating rails: LRS-150-24 -> LC -> LM1084-ADJ -> TL431/SCR crowbar
Generated by tools/gen_psu.py from psu_spec.md v0.2 (option B)

Sheet: /
File: psu.kicad_sch
Title: External PSU regulator board - goa console (+-17 V, 4 A per rail)

Size: User | Rev: 0.2
KiCad E.D.A. 10.0.7 | Id: 1/1
