cozycactus/goa-console/pdf/jig_master_stub.pdf

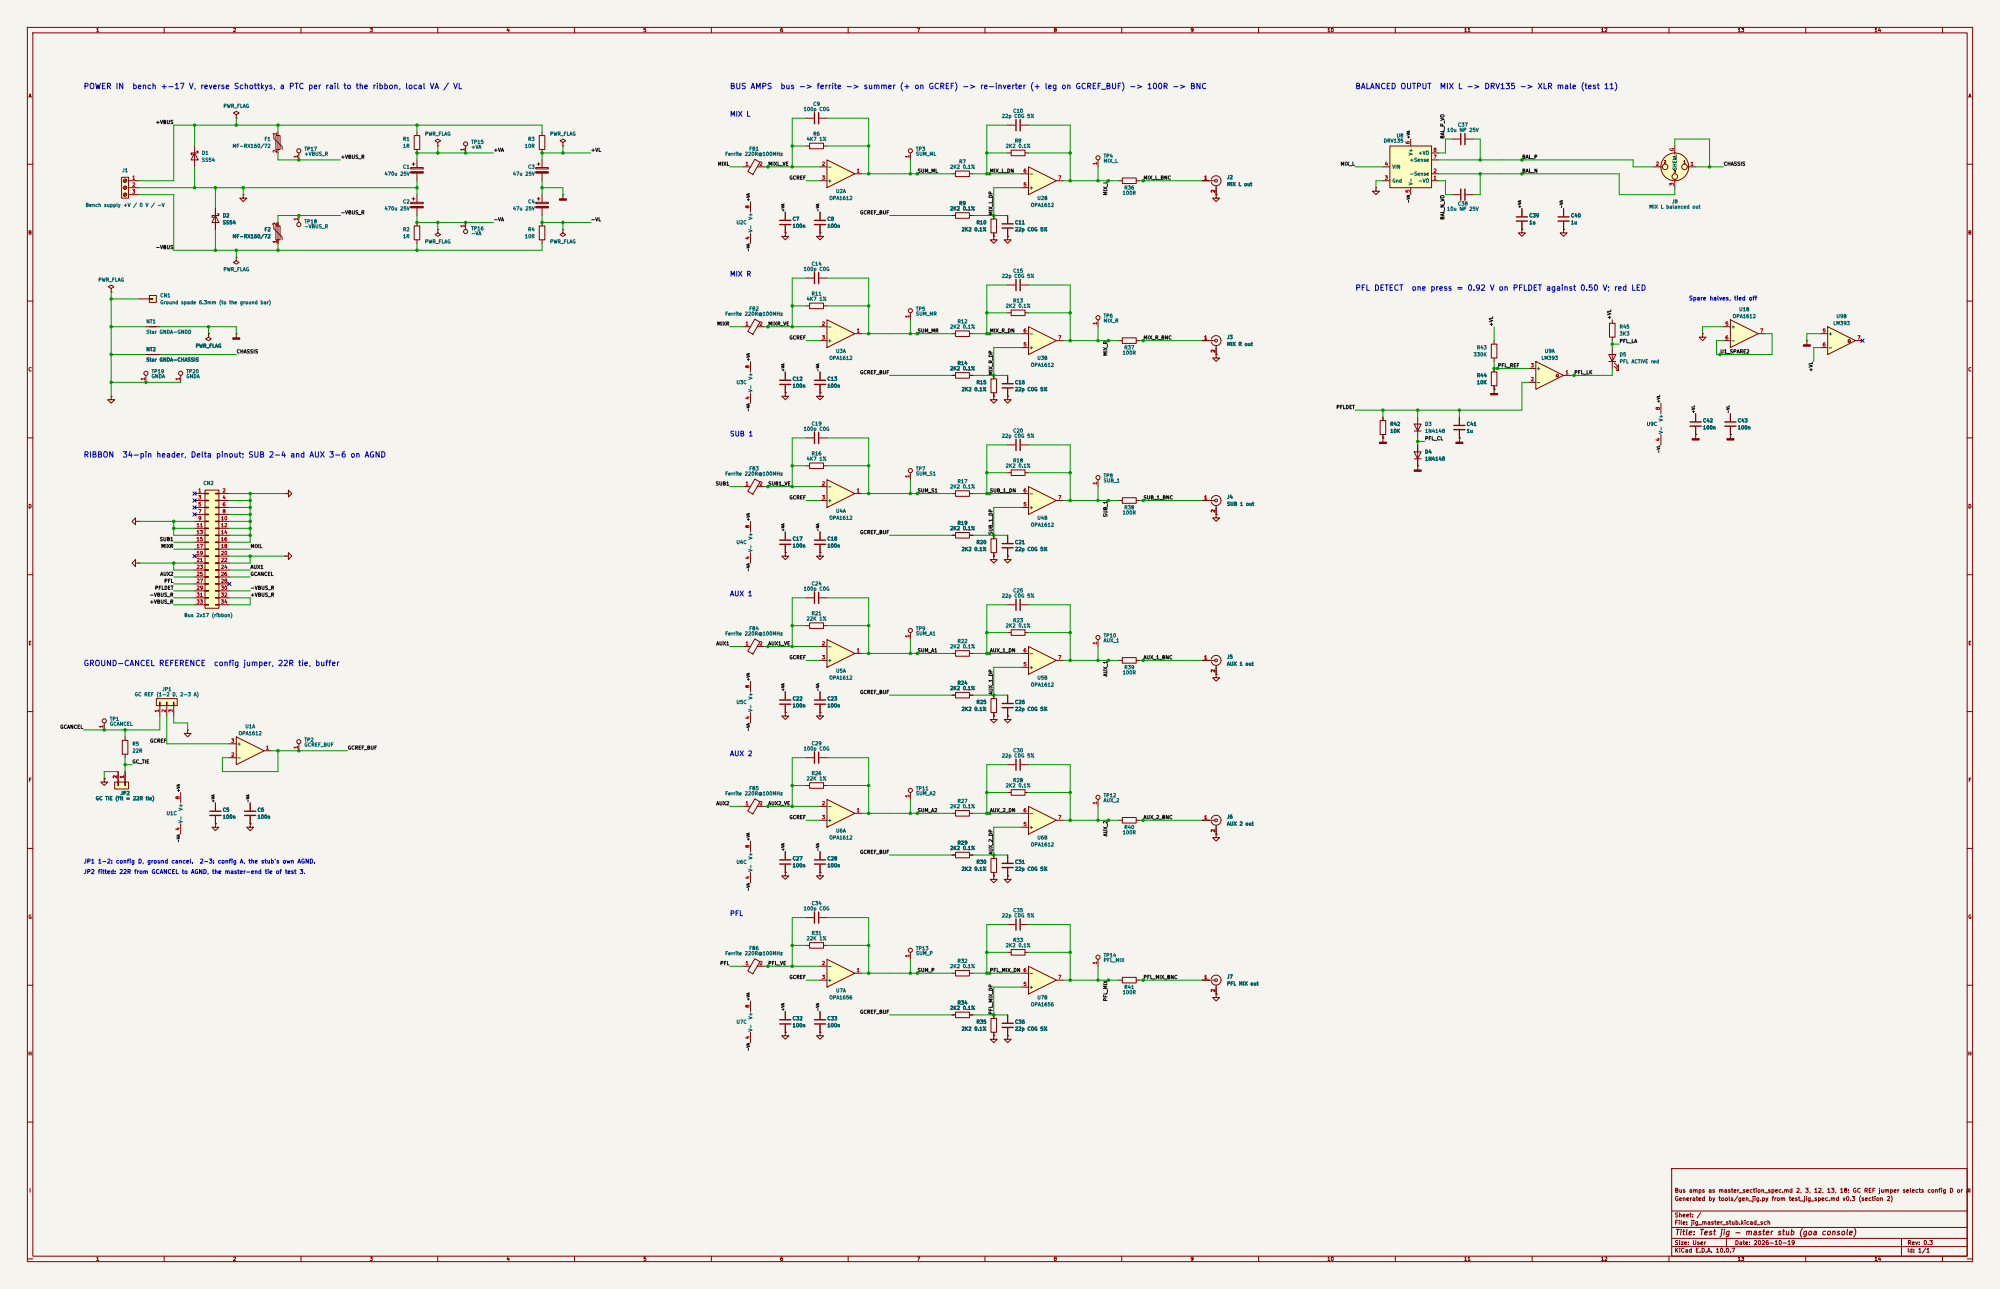
[picture p26: page 1]

POWER IN bench +-17 V, reverse Schottkys, a PTC per rail to the ribbon, local VA / VL

BUS AMPS bus -> ferrite -> summer (+ on GCREF) -> re-inverter (+ leg on GCREF_BUF) -> 100R -> BNC

BALANCED OUTPUT MIX L -> DRV135 -> XLR male (test 11)

100n CN1 Ground spade 6.3mm (to the ground bar) PWR_FLAG

PFL DETECT one press = 0.92 V on PFLDET against 0.50 V; red LED

Spare halves, tied off

RIBBON 34-pin header, Delta pinout; SUB 2-4 and AUX 3-6 on AGND

GROUND-CANCEL REFERENCE config jumper, 22R tie, buffer

JP2 GC TIE (fit = 22R tie) 2

JP2 GC TIE (fit = 22R tie)

JP1 1-2: config D, ground cancel. 2-3: config A, the stub's own AGND.

Bus amps as master_section_spec.md 2, 3, 12, 13, 18; GC REF jumper selects config D or A
Generated by tools/gen_jig.py from test_jig_spec.md v0.3 (section 2)

Sheet: /
File: jig_master_stub.kicad_sch
Title: Test jig - master stub (goa console)

Size: User | Rev: 0.3
KiCad E.D.A. 10.0.7 | Id: 1/1
