cozycactus/goa-console/pdf/channel_strip.pdf

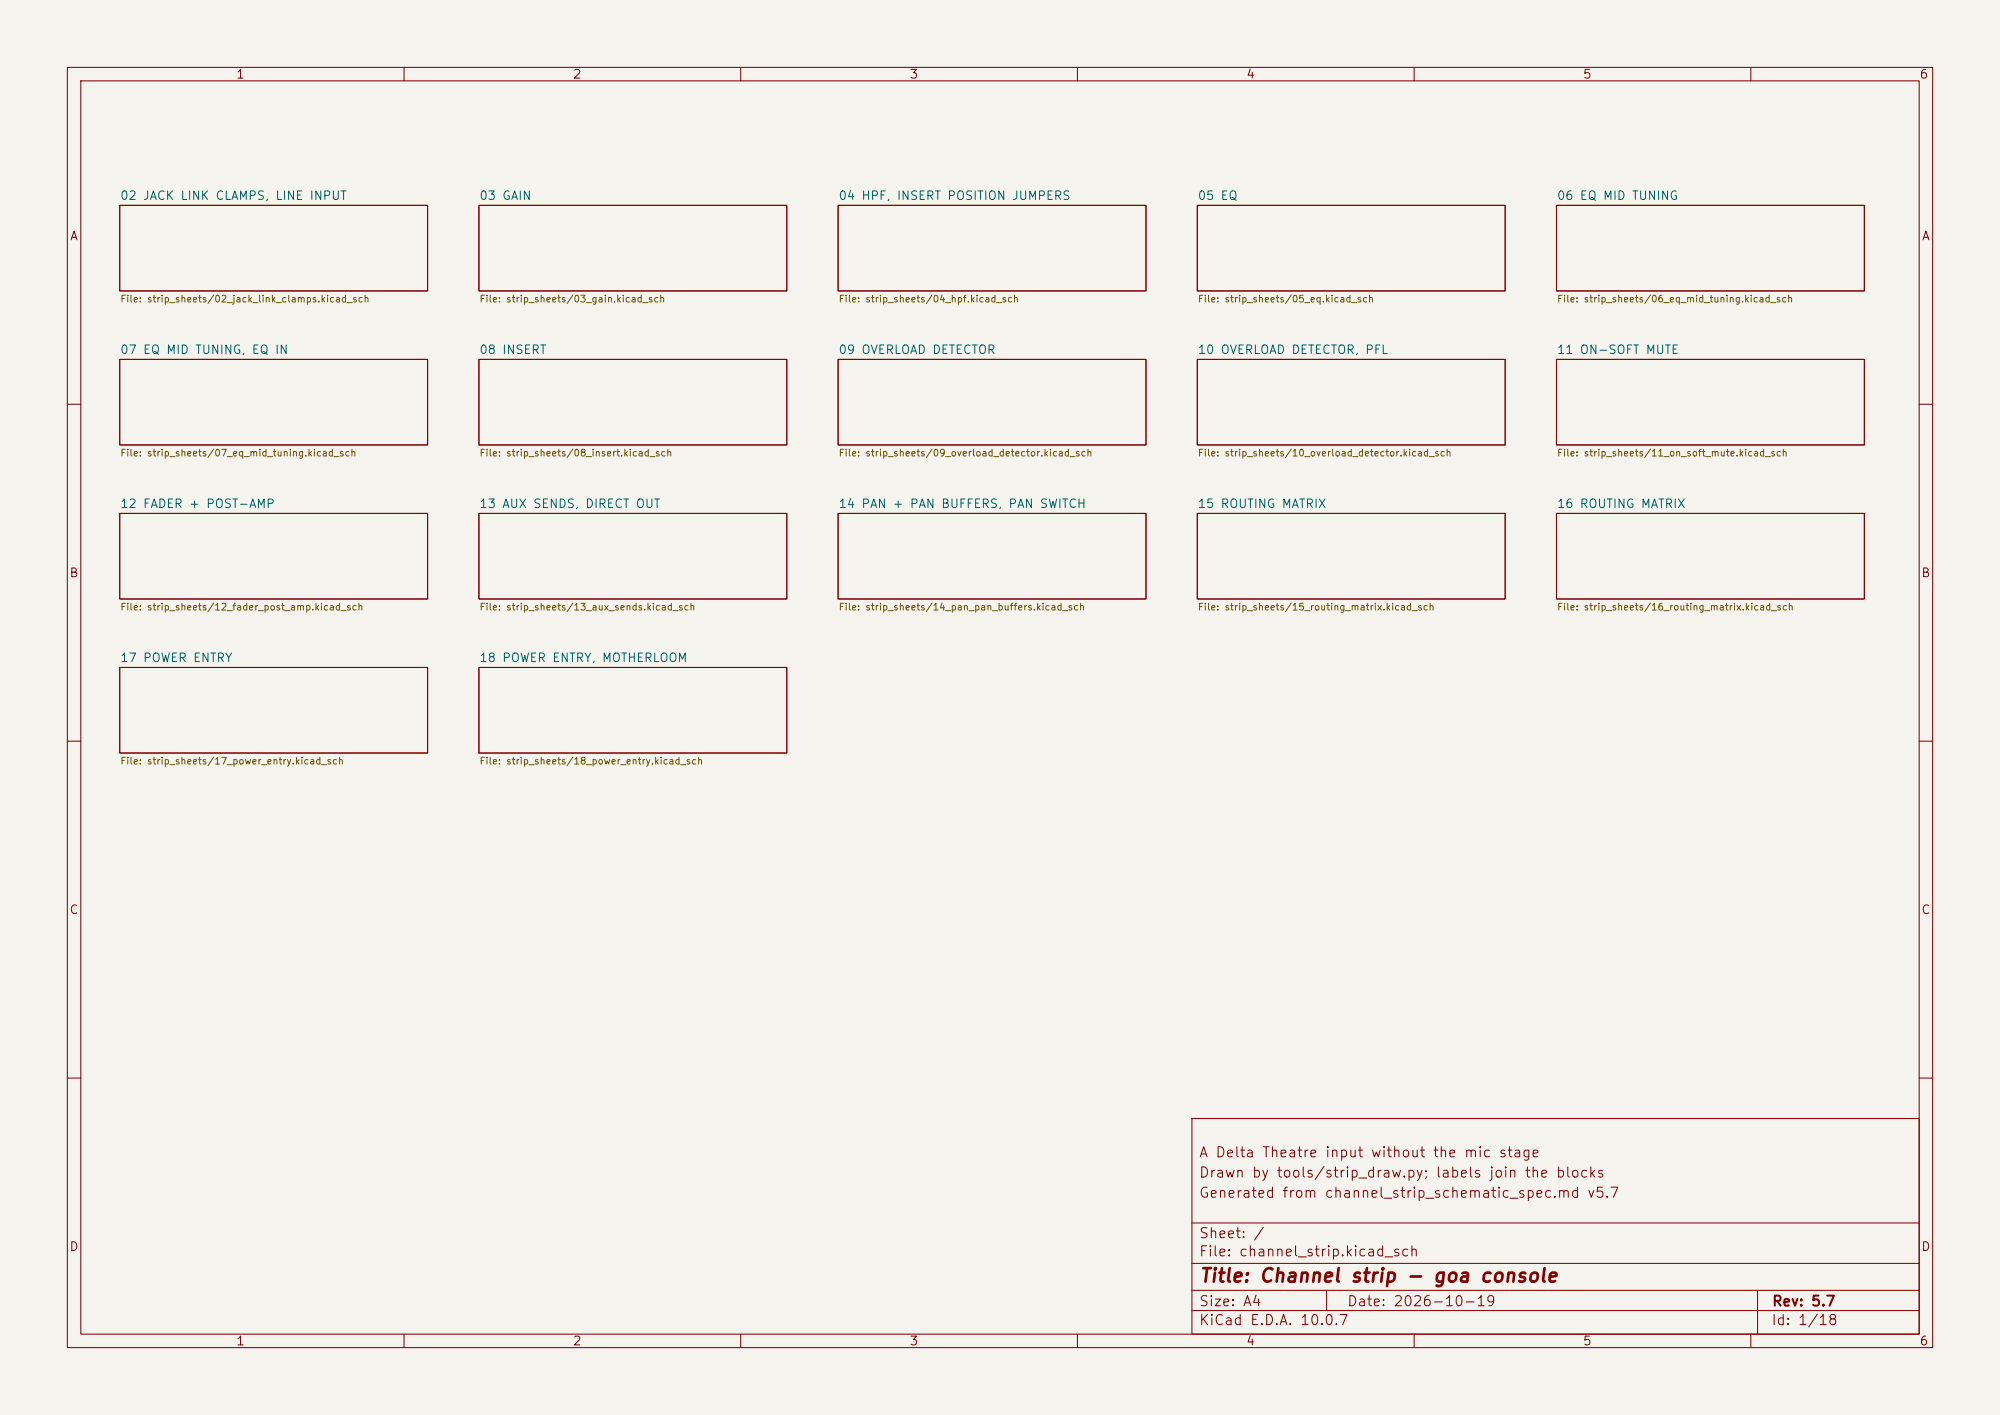
[picture p27: page 1]

File: strip_sheets/16_routing_matrix.kicad_sch 02 JACK LINK CLAMPS, LINE INPUT

File: strip_sheets/03_gain.kicad_sch 07 EQ MID TUNING, EQ IN

File: strip_sheets/06_eq_mid_tuning.kicad_sch 10 OVERLOAD DETECTOR, PFL

File: strip_sheets/08_insert.kicad_sch 12 FADER + POST-AMP

File: strip_sheets/09_overload_detector.kicad_sch 14 PAN + PAN BUFFERS, PAN SWITCH

A Delta Theatre input without the mic stage
Drawn by tools/strip_draw.py; labels join the blocks
Generated from channel_strip_schematic_spec.md v5.7

Sheet: /
File: channel_strip.kicad_sch
Title: Channel strip - goa console

Size: A4 | Rev: 5.7
KiCad E.D.A. 10.0.7 | Id: 1/18

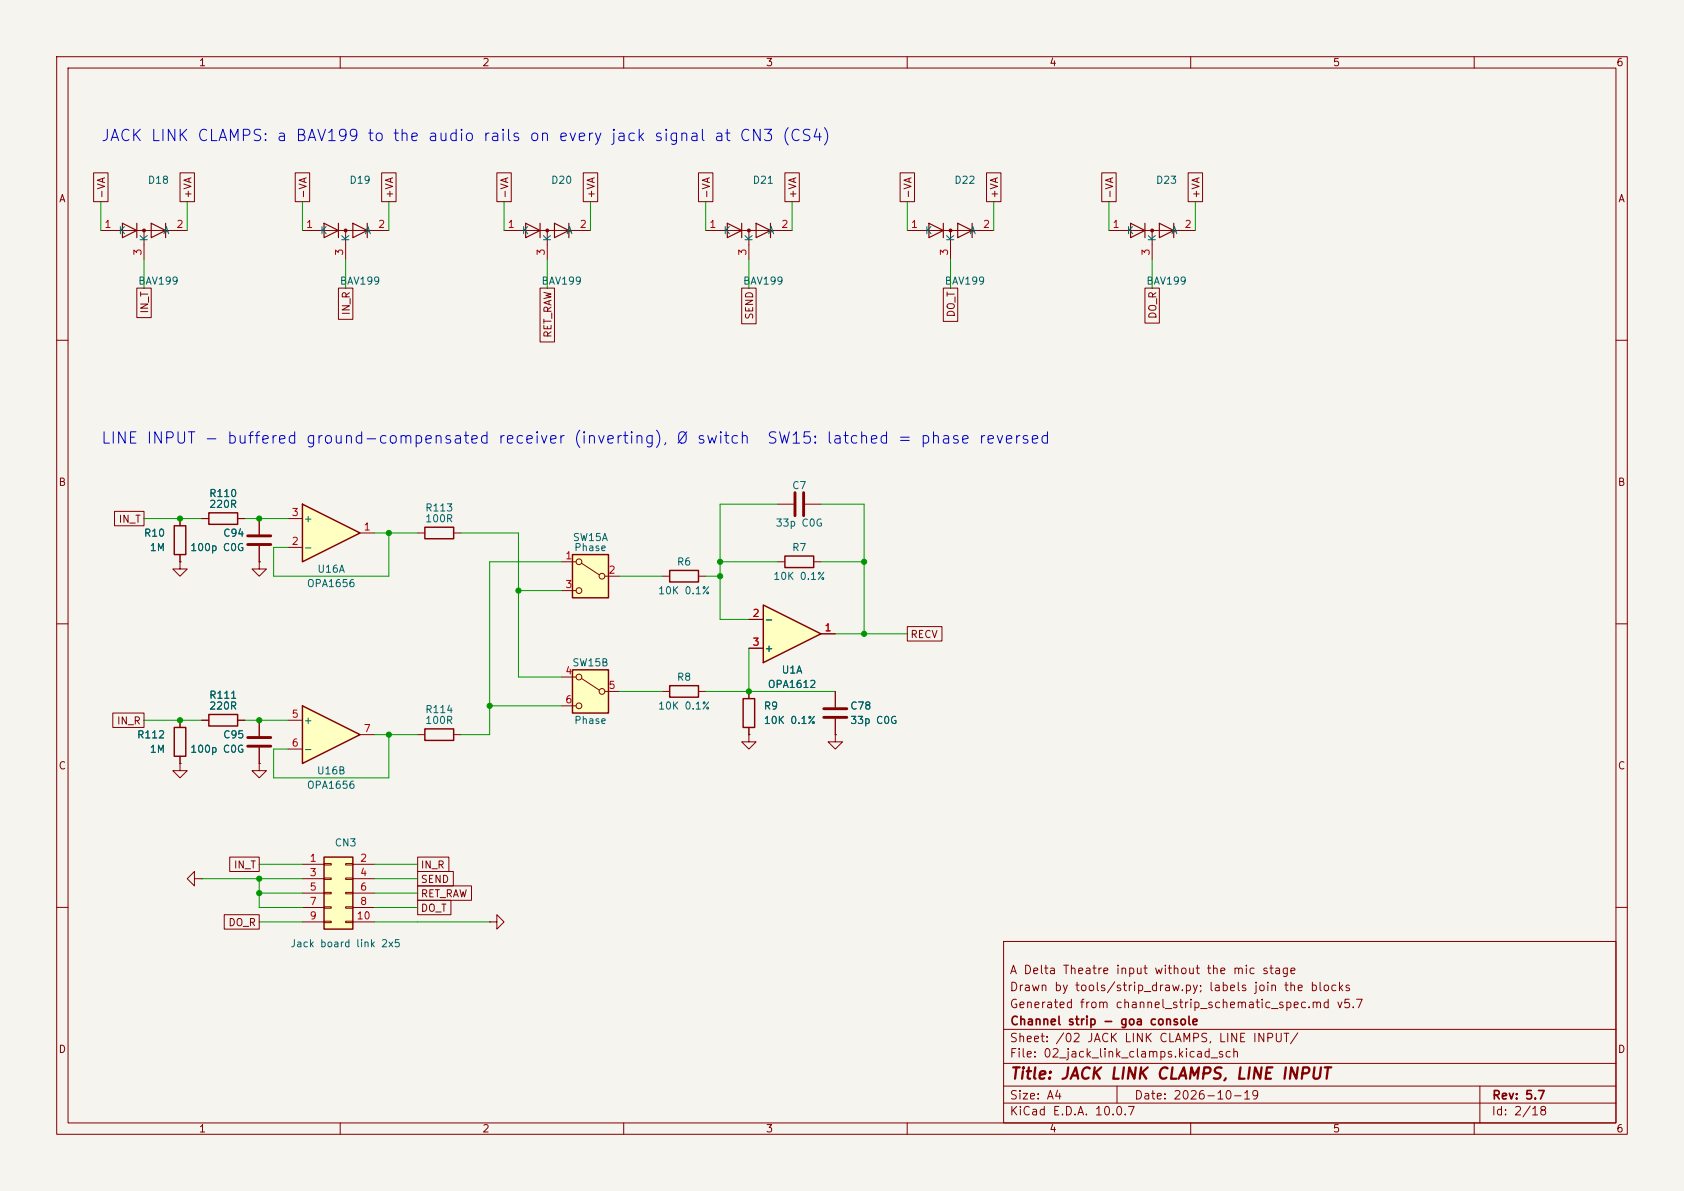
[picture p28: page 2]

IN_T JACK LINK CLAMPS: a BAV199 to the audio rails on every jack signal at CN3 (CS4)

LINE INPUT - buffered ground-compensated receiver (inverting), Ø switch SW15: latched = phase reversed

A Delta Theatre input without the mic stage
Drawn by tools/strip_draw.py; labels join the blocks
Generated from channel_strip_schematic_spec.md v5.7
Channel strip - goa console
Sheet: /02 JACK LINK CLAMPS, LINE INPUT/
File: 02_jack_link_clamps.kicad_sch
Title: JACK LINK CLAMPS, LINE INPUT

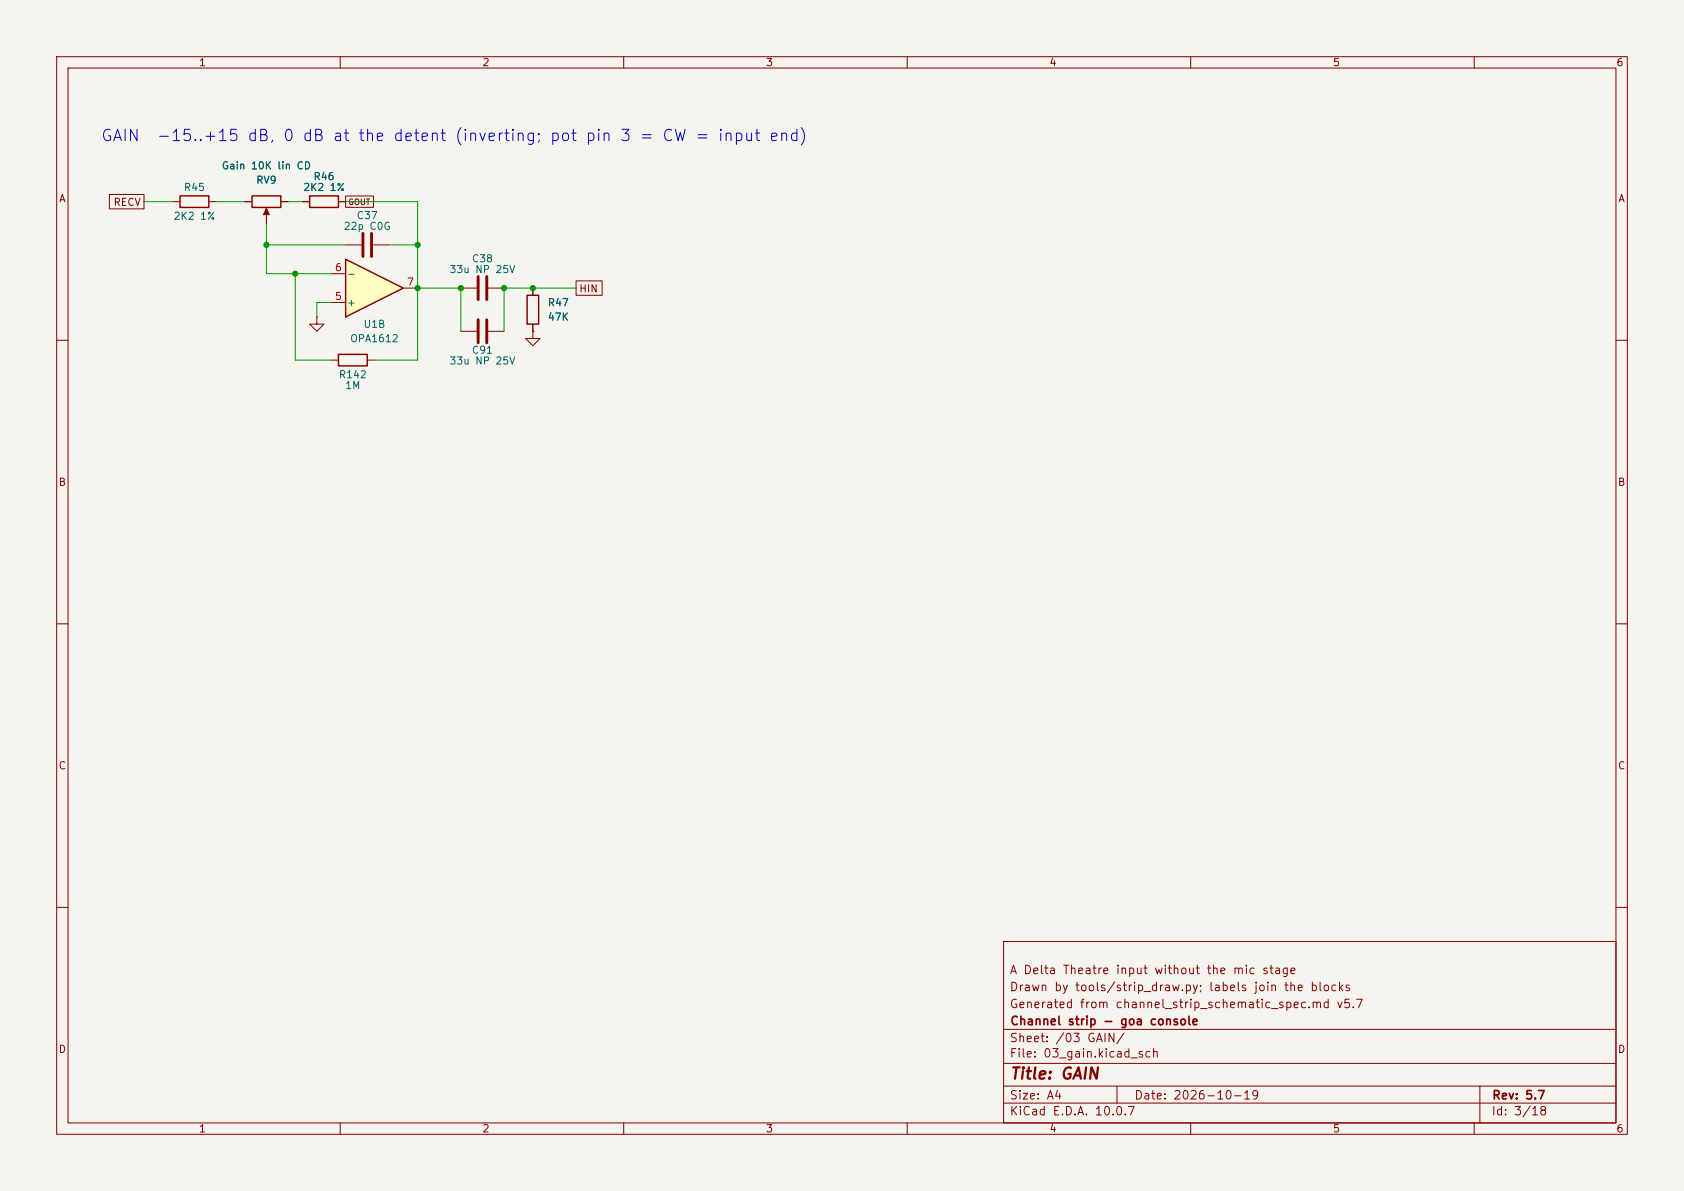
[picture p29: page 3]

33u NP 25V RV9 Gain 10K lin CD

A Delta Theatre input without the mic stage
Drawn by tools/strip_draw.py; labels join the blocks
Generated from channel_strip_schematic_spec.md v5.7
Channel strip - goa console
Sheet: /03 GAIN/
File: 03_gain.kicad_sch
Title: GAIN

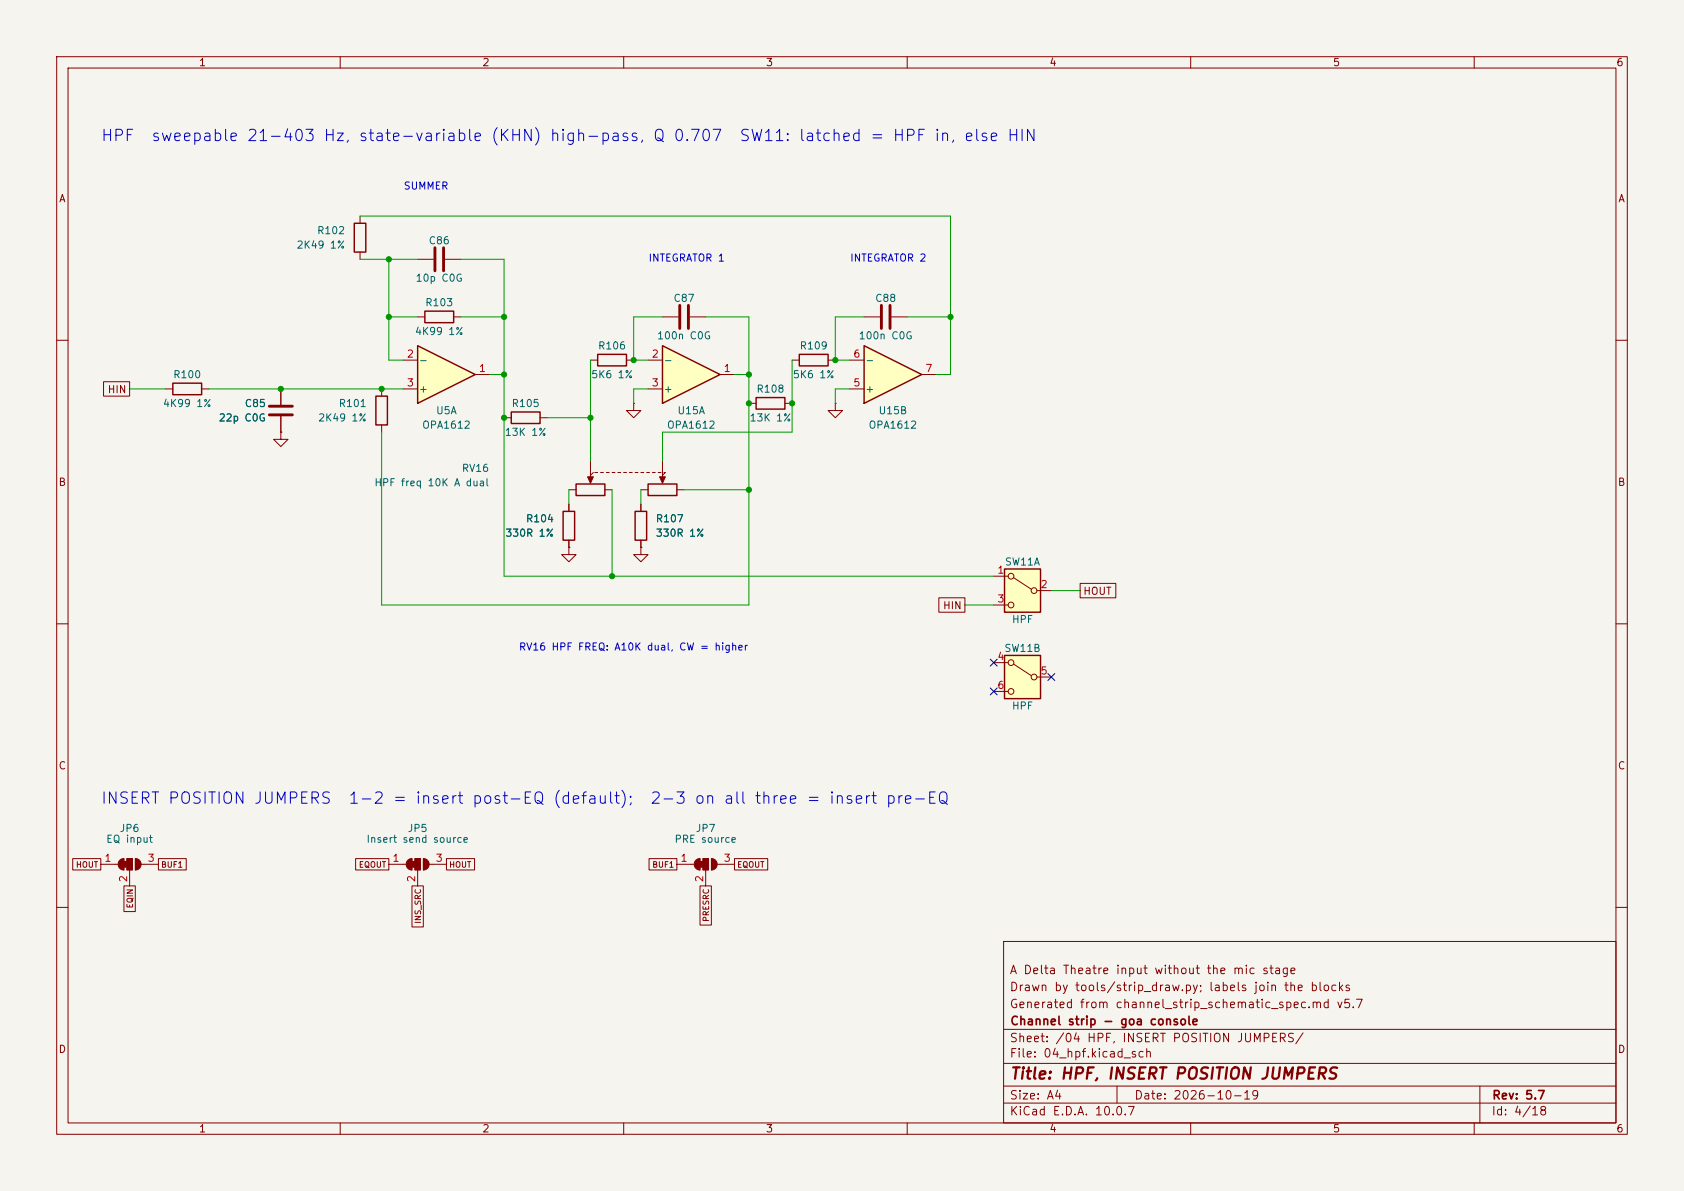
[picture p30: page 4]

RV16 HPF FREQ: A10K dual, CW = higher

INSERT POSITION JUMPERS 1-2 = insert post-EQ (default); 2-3 on all three = insert pre-EQ

A Delta Theatre input without the mic stage
Drawn by tools/strip_draw.py; labels join the blocks
Generated from channel_strip_schematic_spec.md v5.7
Channel strip - goa console
Sheet: /04 HPF, INSERT POSITION JUMPERS/
File: 04_hpf.kicad_sch
Title: HPF, INSERT POSITION JUMPERS

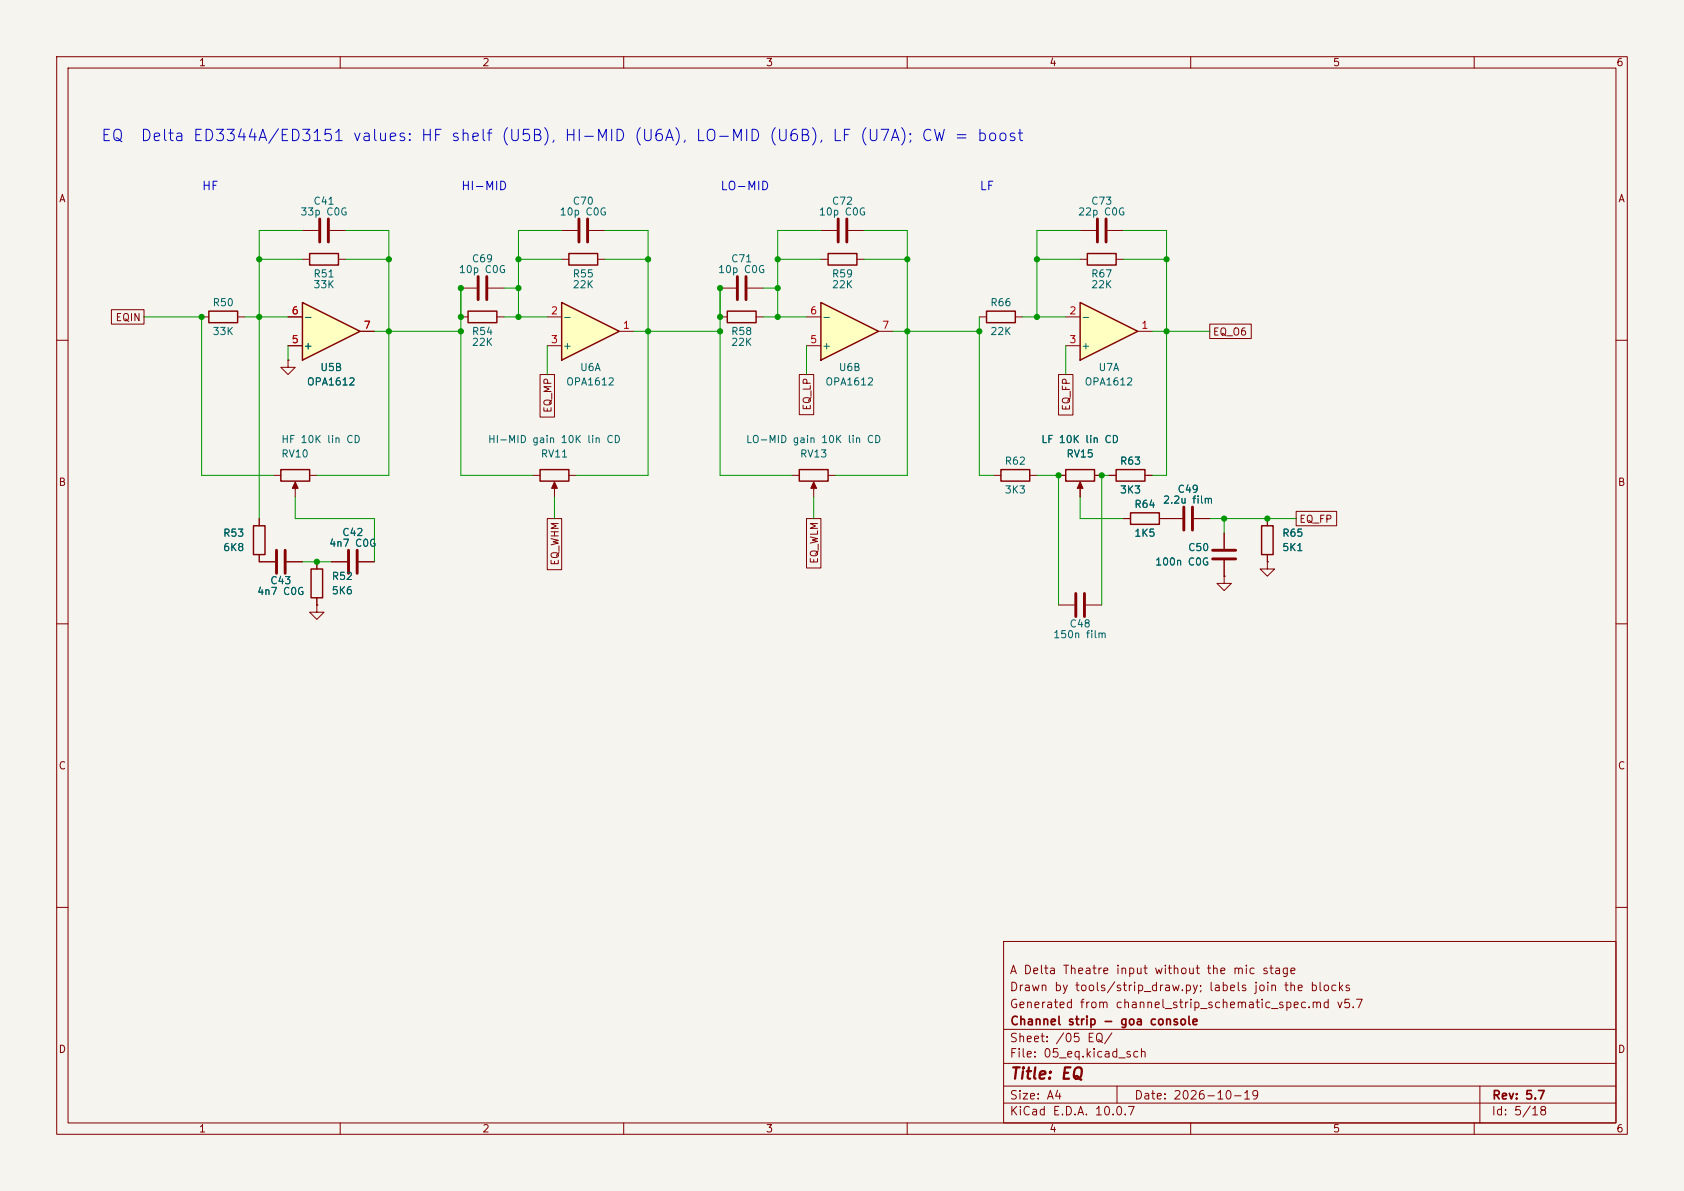
[picture p31: page 5]

EQ Delta ED3344A/ED3151 values: HF shelf (U5B), HI-MID (U6A), LO-MID (U6B), LF (U7A); CW = boost

RV11 HI-MID gain 10K lin CD

LO-MID gain 10K lin CD

A Delta Theatre input without the mic stage
Drawn by tools/strip_draw.py; labels join the blocks
Generated from channel_strip_schematic_spec.md v5.7
Channel strip - goa console
Sheet: /05 EQ/
File: 05_eq.kicad_sch
Title: EQ

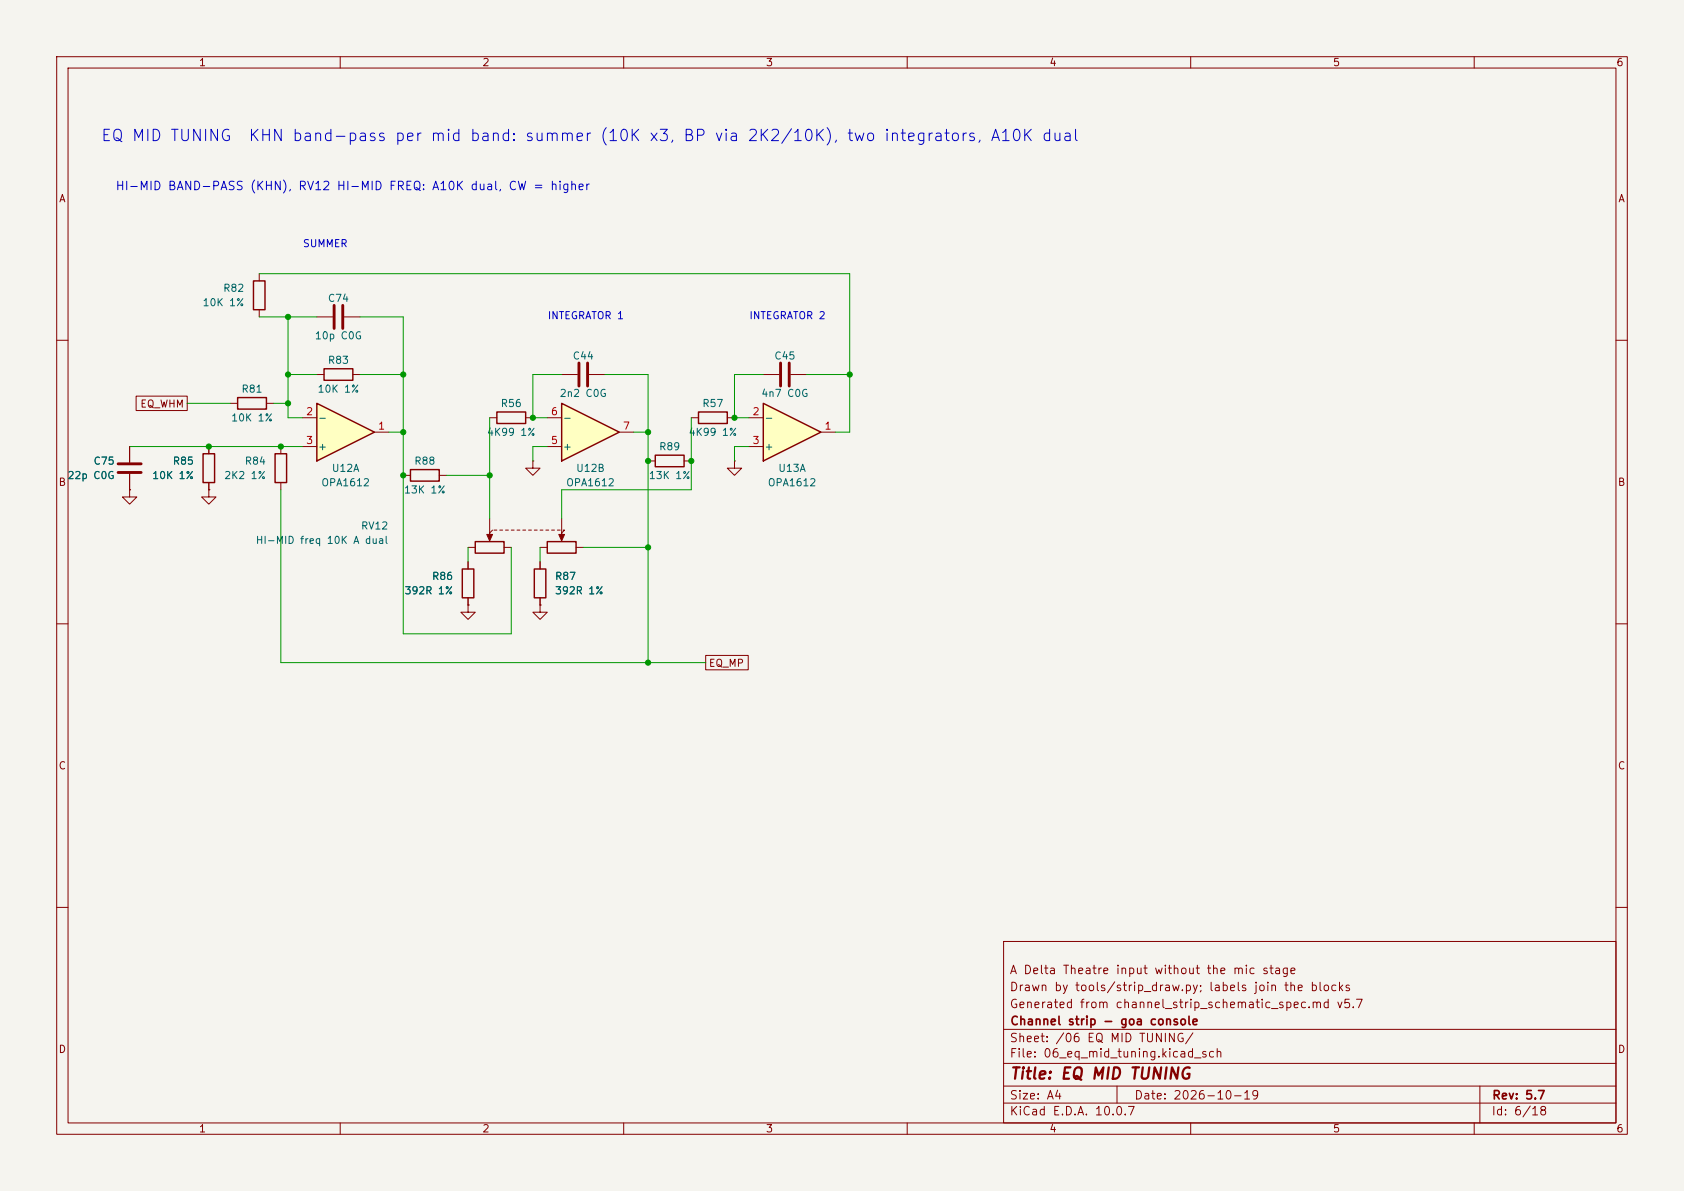
[picture p32: page 6]

SUMMER EQ MID TUNING KHN band-pass per mid band: summer (10K x3, BP via 2K2/10K), two integrators, A10K dual R86

EQ_WHM HI-MID BAND-PASS (KHN), RV12 HI-MID FREQ: A10K dual, CW = higher

A Delta Theatre input without the mic stage
Drawn by tools/strip_draw.py; labels join the blocks
Generated from channel_strip_schematic_spec.md v5.7
Channel strip - goa console
Sheet: /06 EQ MID TUNING/
File: 06_eq_mid_tuning.kicad_sch
Title: EQ MID TUNING

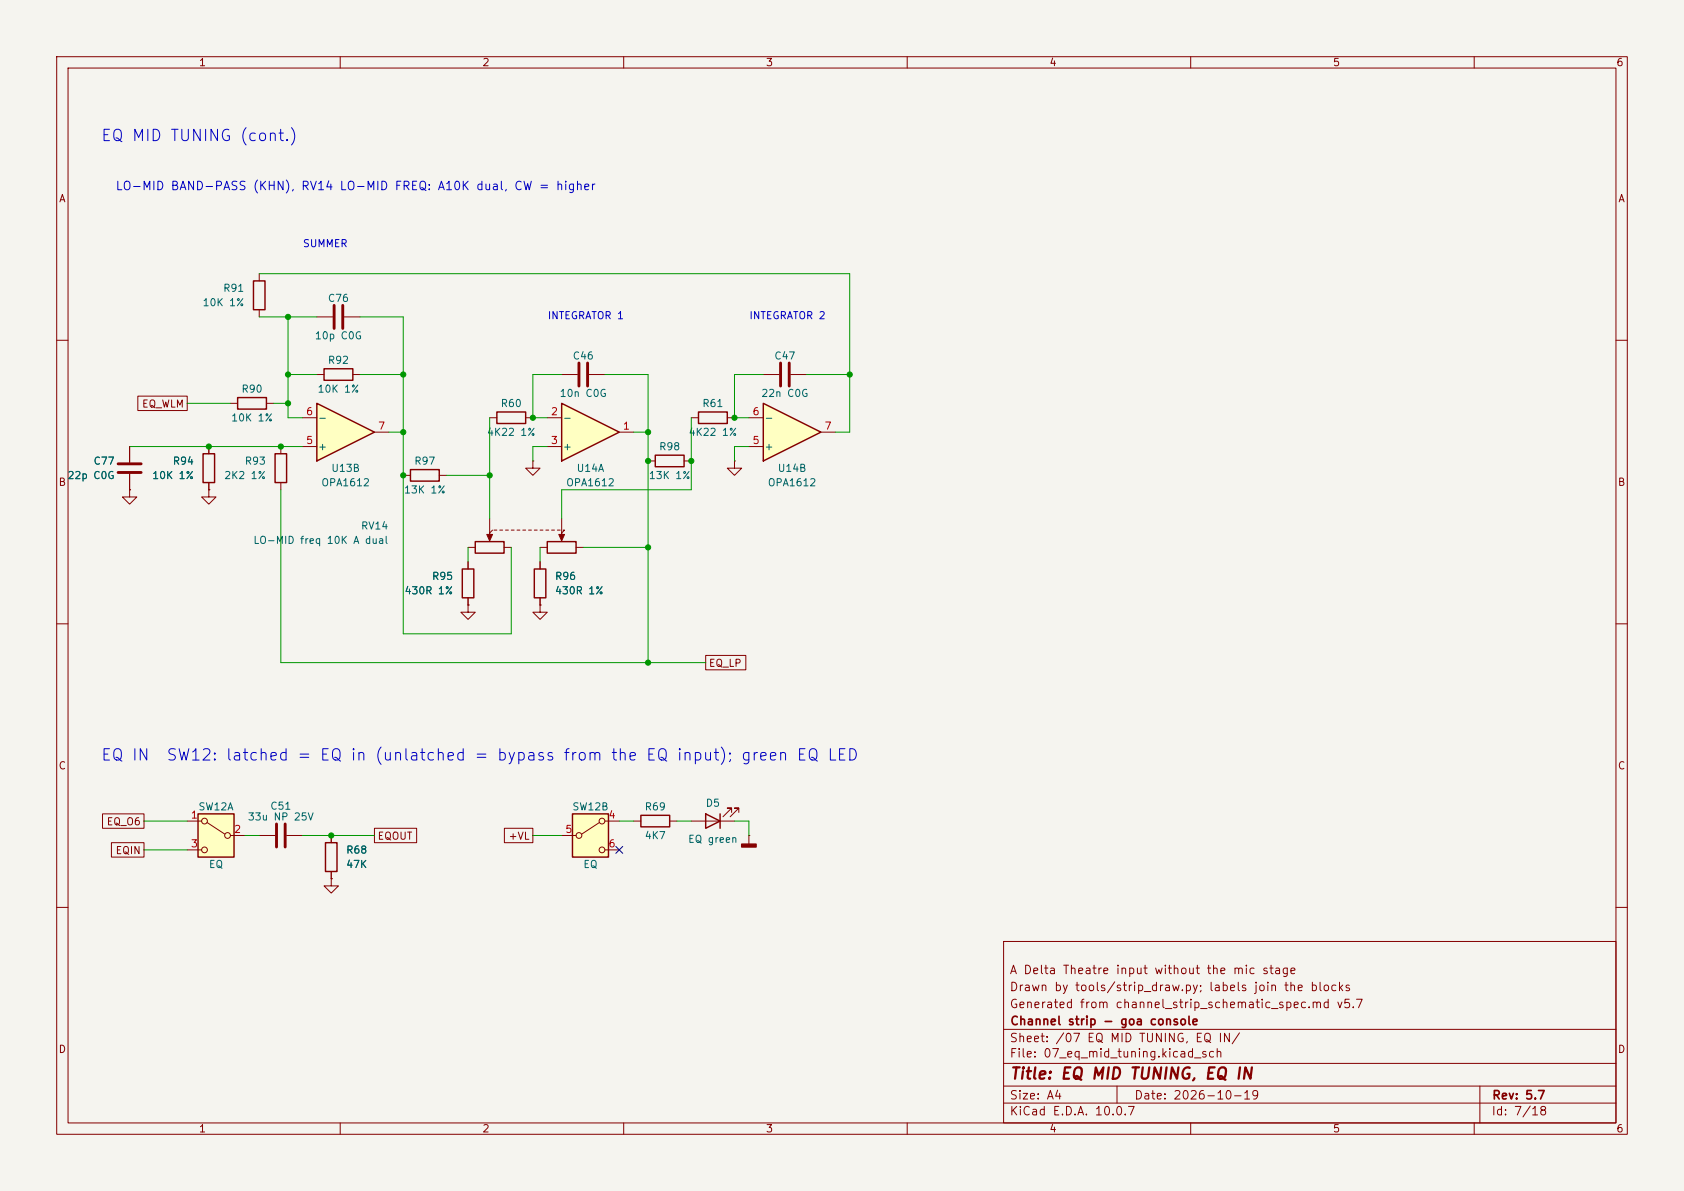
[picture p33: page 7]

INTEGRATOR 1 EQ MID TUNING (cont.)

LO-MID BAND-PASS (KHN), RV14 LO-MID FREQ: A10K dual, CW = higher

LO-MID freq 10K A dual C77

EQ_LP EQ IN SW12: latched = EQ in (unlatched = bypass from the EQ input); green EQ LED

A Delta Theatre input without the mic stage
Drawn by tools/strip_draw.py; labels join the blocks
Generated from channel_strip_schematic_spec.md v5.7
Channel strip - goa console
Sheet: /07 EQ MID TUNING, EQ IN/
File: 07_eq_mid_tuning.kicad_sch
Title: EQ MID TUNING, EQ IN

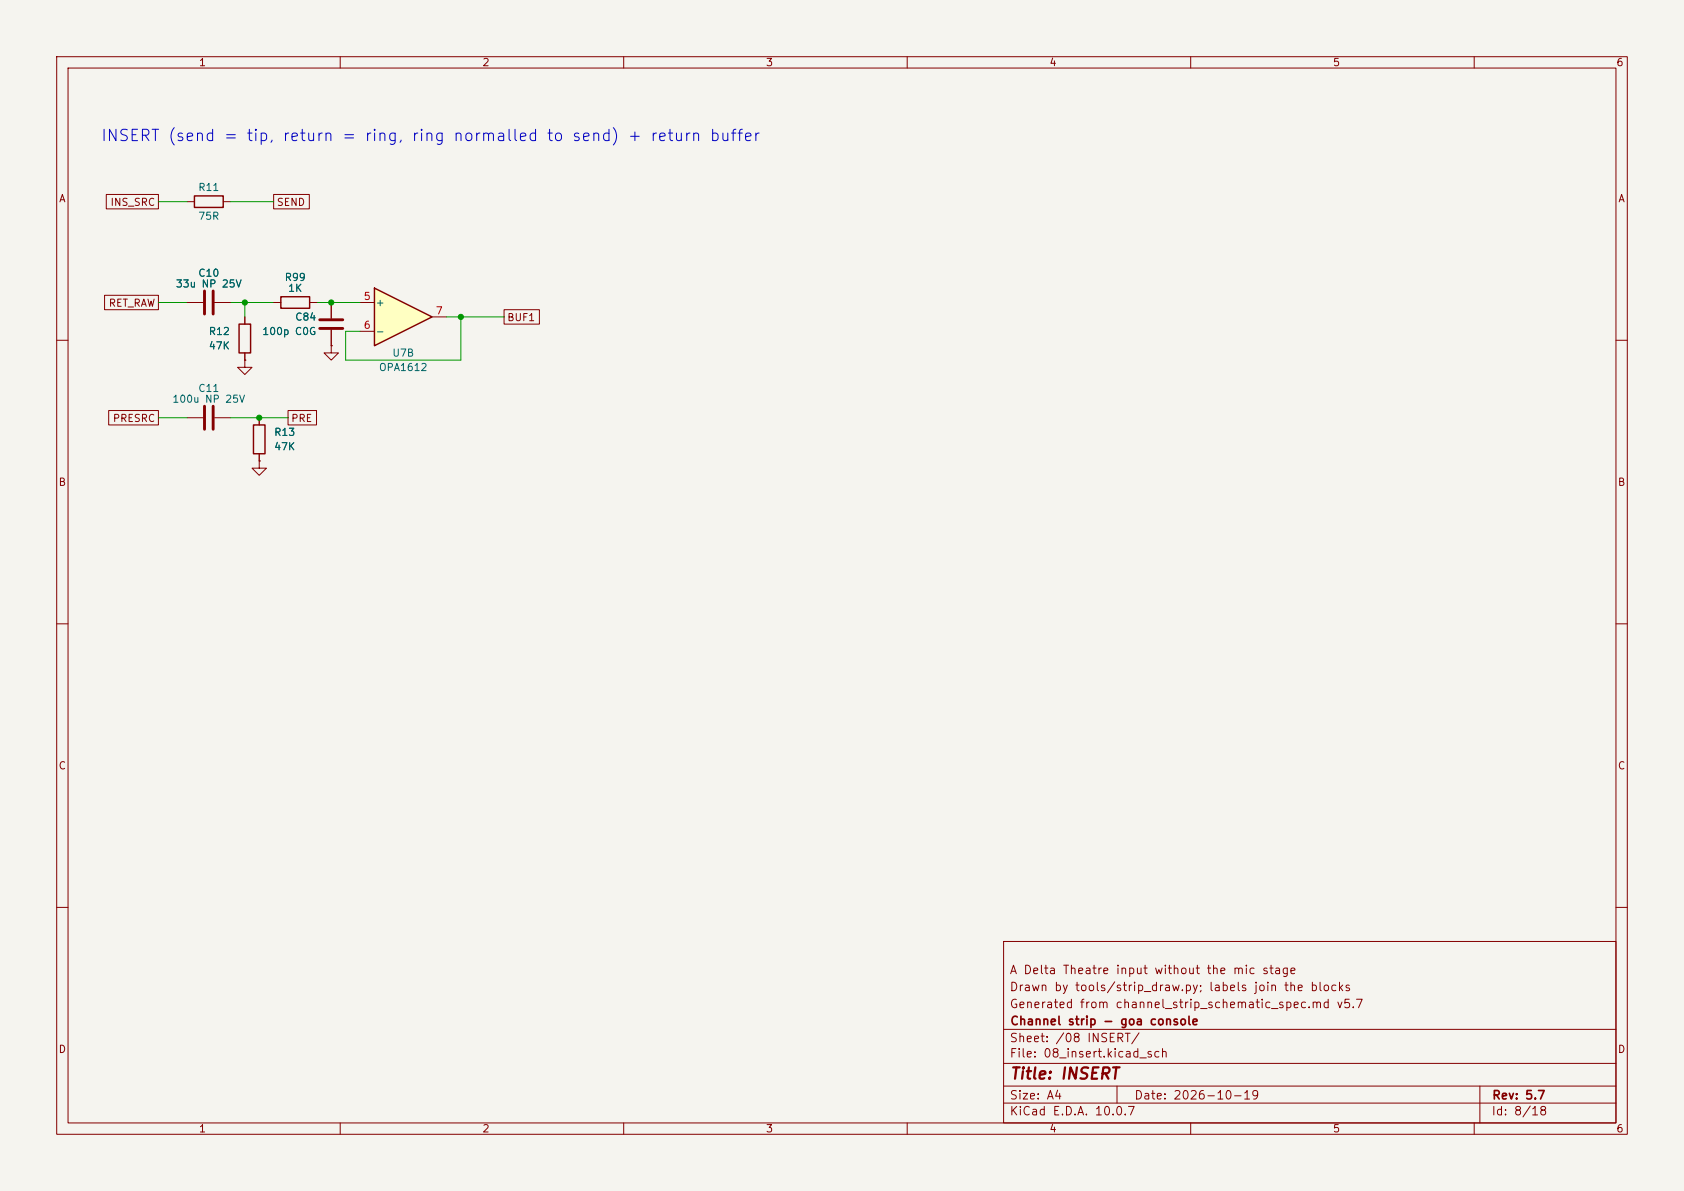
[picture p34: page 8]

INSERT (send = tip, return = ring, ring normalled to send) + return buffer R99

A Delta Theatre input without the mic stage
Drawn by tools/strip_draw.py; labels join the blocks
Generated from channel_strip_schematic_spec.md v5.7
Channel strip - goa console
Sheet: /08 INSERT/
File: 08_insert.kicad_sch
Title: INSERT

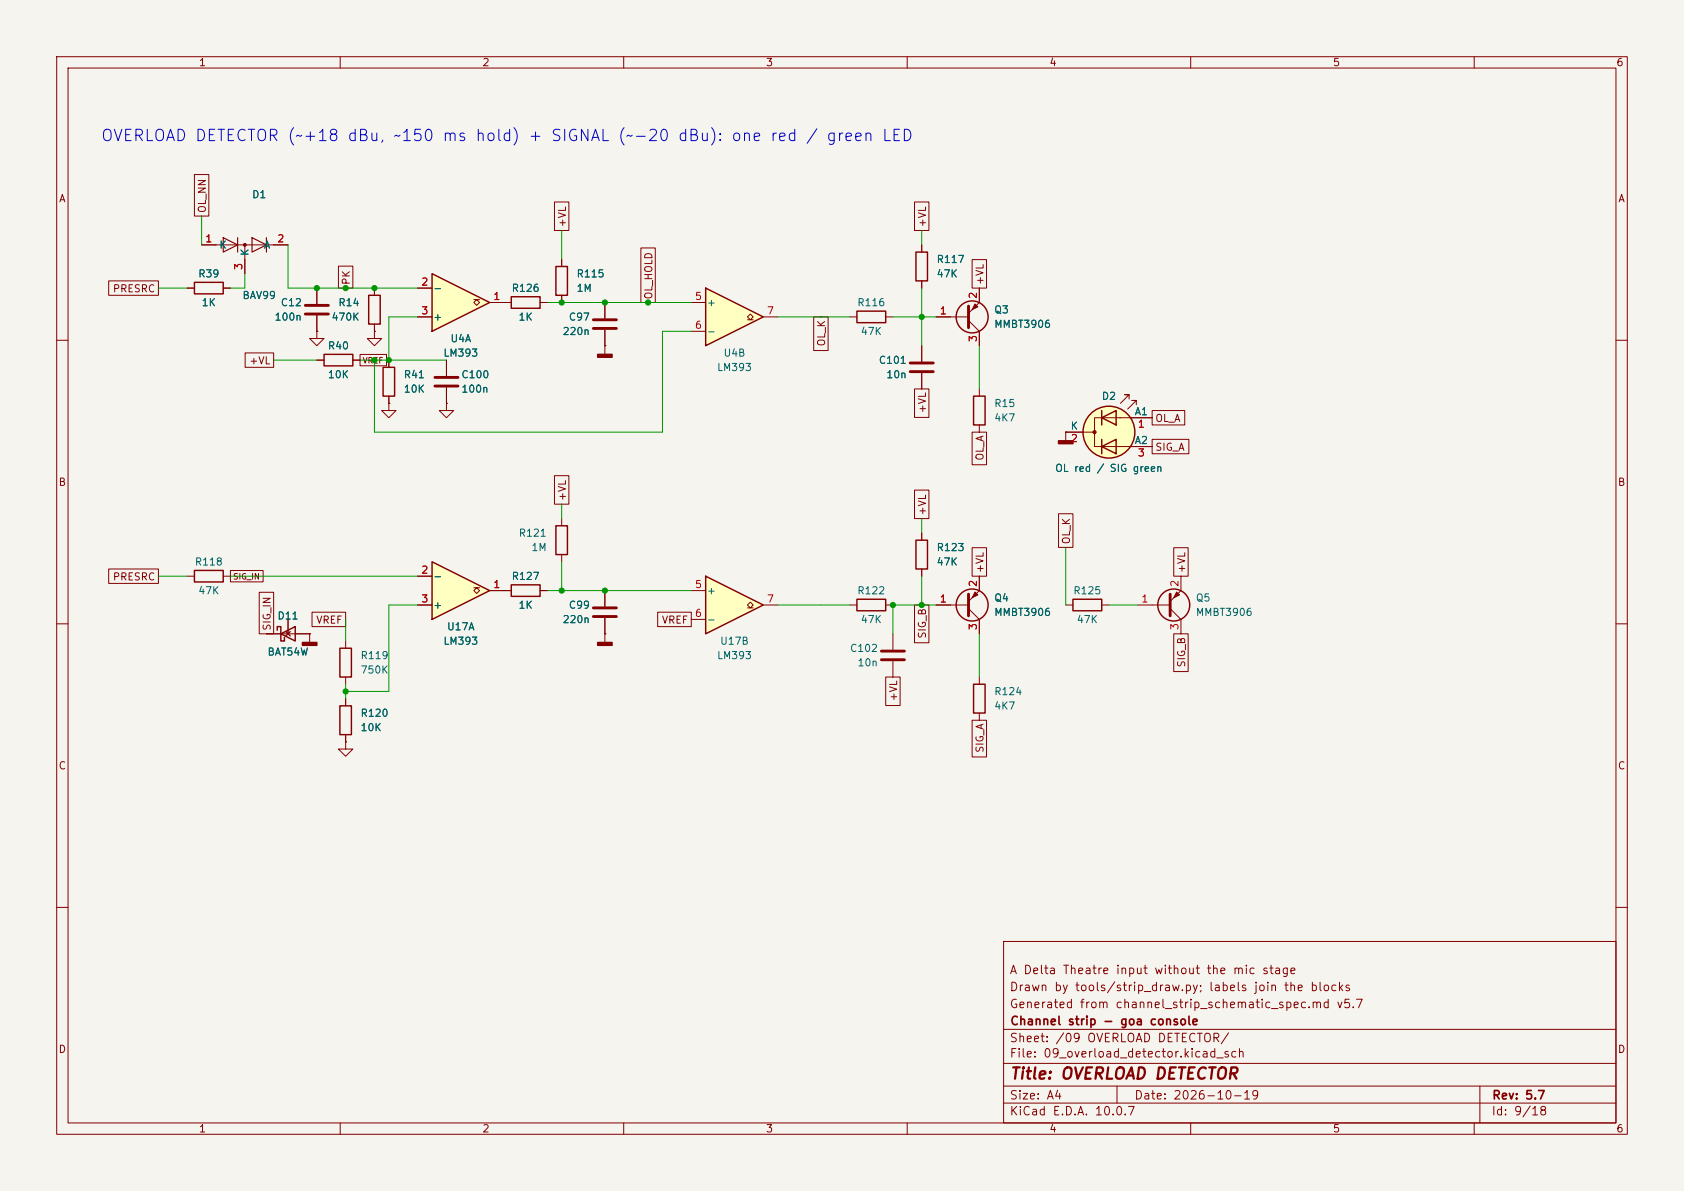
[picture p35: page 9]

OVERLOAD DETECTOR (~+18 dBu, ~150 ms hold) + SIGNAL (~-20 dBu): one red / green LED

3 D2 OL red / SIG green 1 -

2 3 D2 OL red / SIG green

A Delta Theatre input without the mic stage
Drawn by tools/strip_draw.py; labels join the blocks
Generated from channel_strip_schematic_spec.md v5.7
Channel strip - goa console
Sheet: /09 OVERLOAD DETECTOR/
File: 09_overload_detector.kicad_sch
Title: OVERLOAD DETECTOR

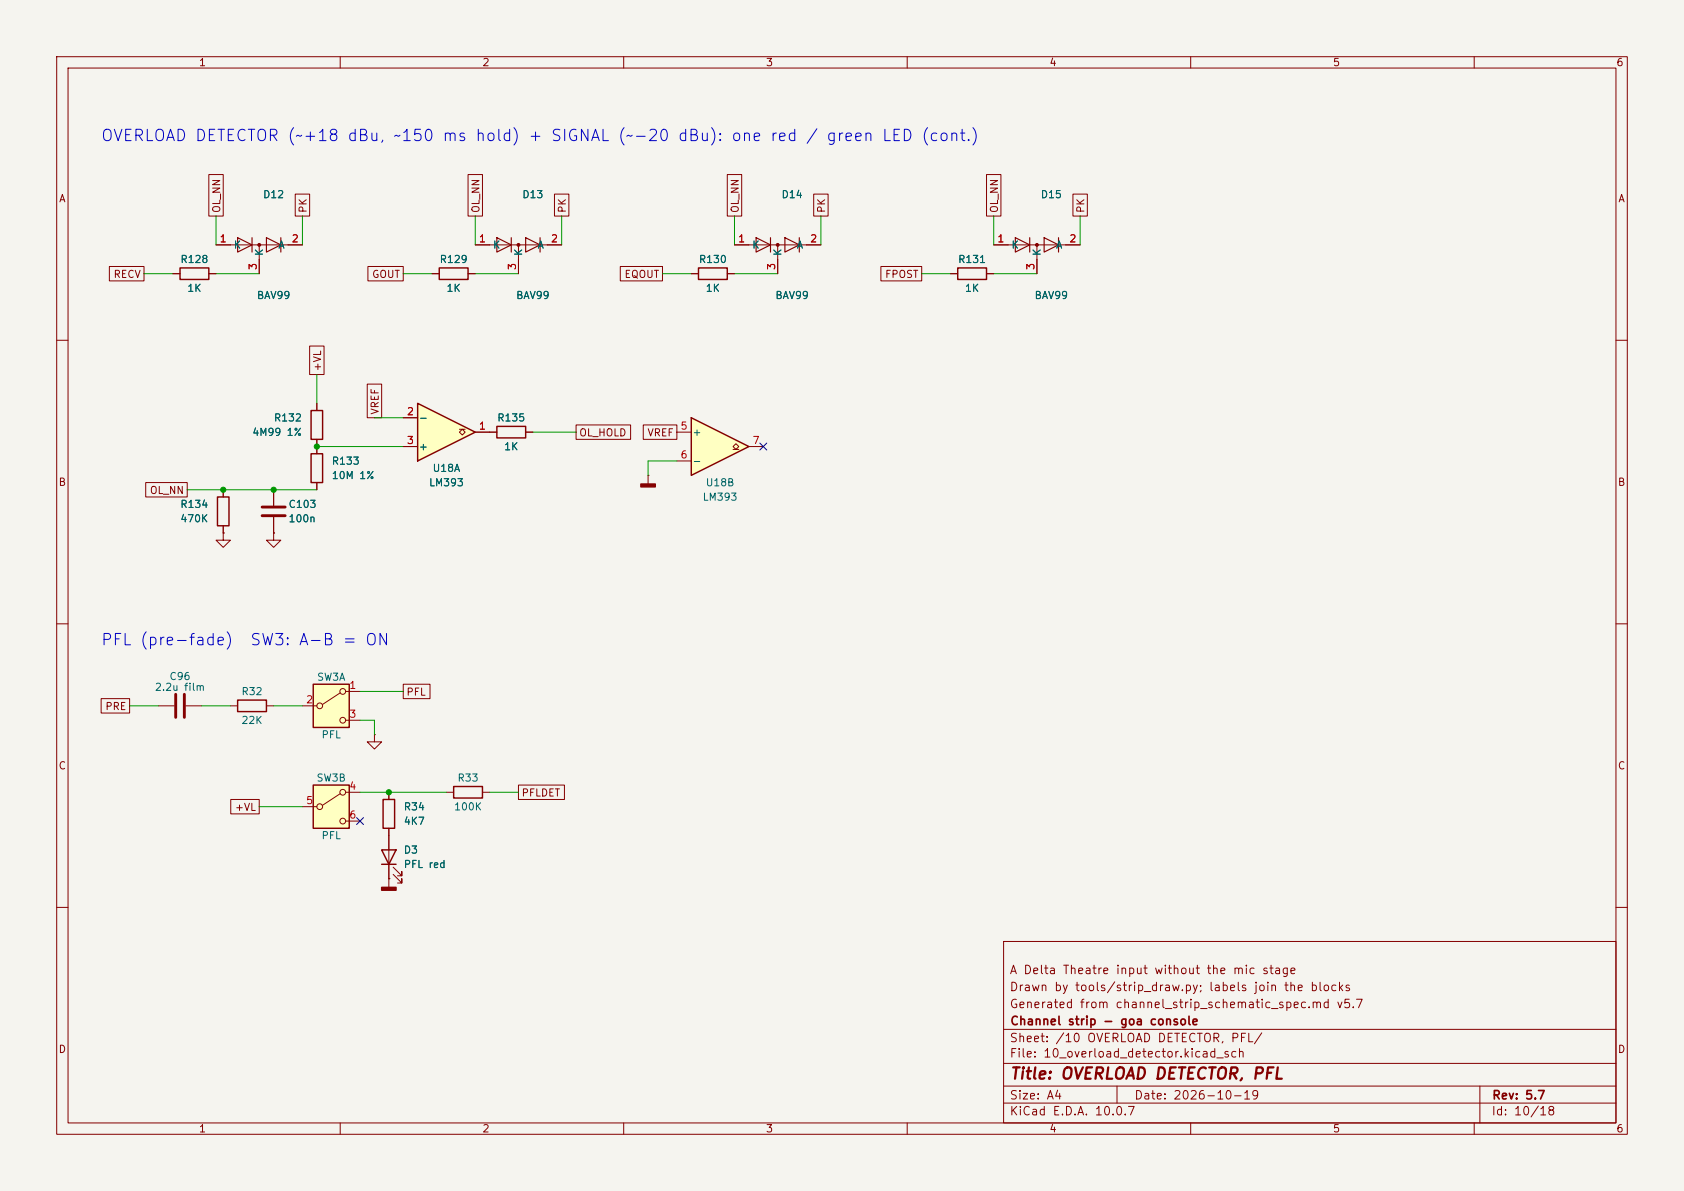
[picture p36: page 10]

OVERLOAD DETECTOR (~+18 dBu, ~150 ms hold) + SIGNAL (~-20 dBu): one red / green LED (cont.)

PFL (pre-fade) SW3: A-B = ON

A Delta Theatre input without the mic stage
Drawn by tools/strip_draw.py; labels join the blocks
Generated from channel_strip_schematic_spec.md v5.7
Channel strip - goa console
Sheet: /10 OVERLOAD DETECTOR, PFL/
File: 10_overload_detector.kicad_sch
Title: OVERLOAD DETECTOR, PFL

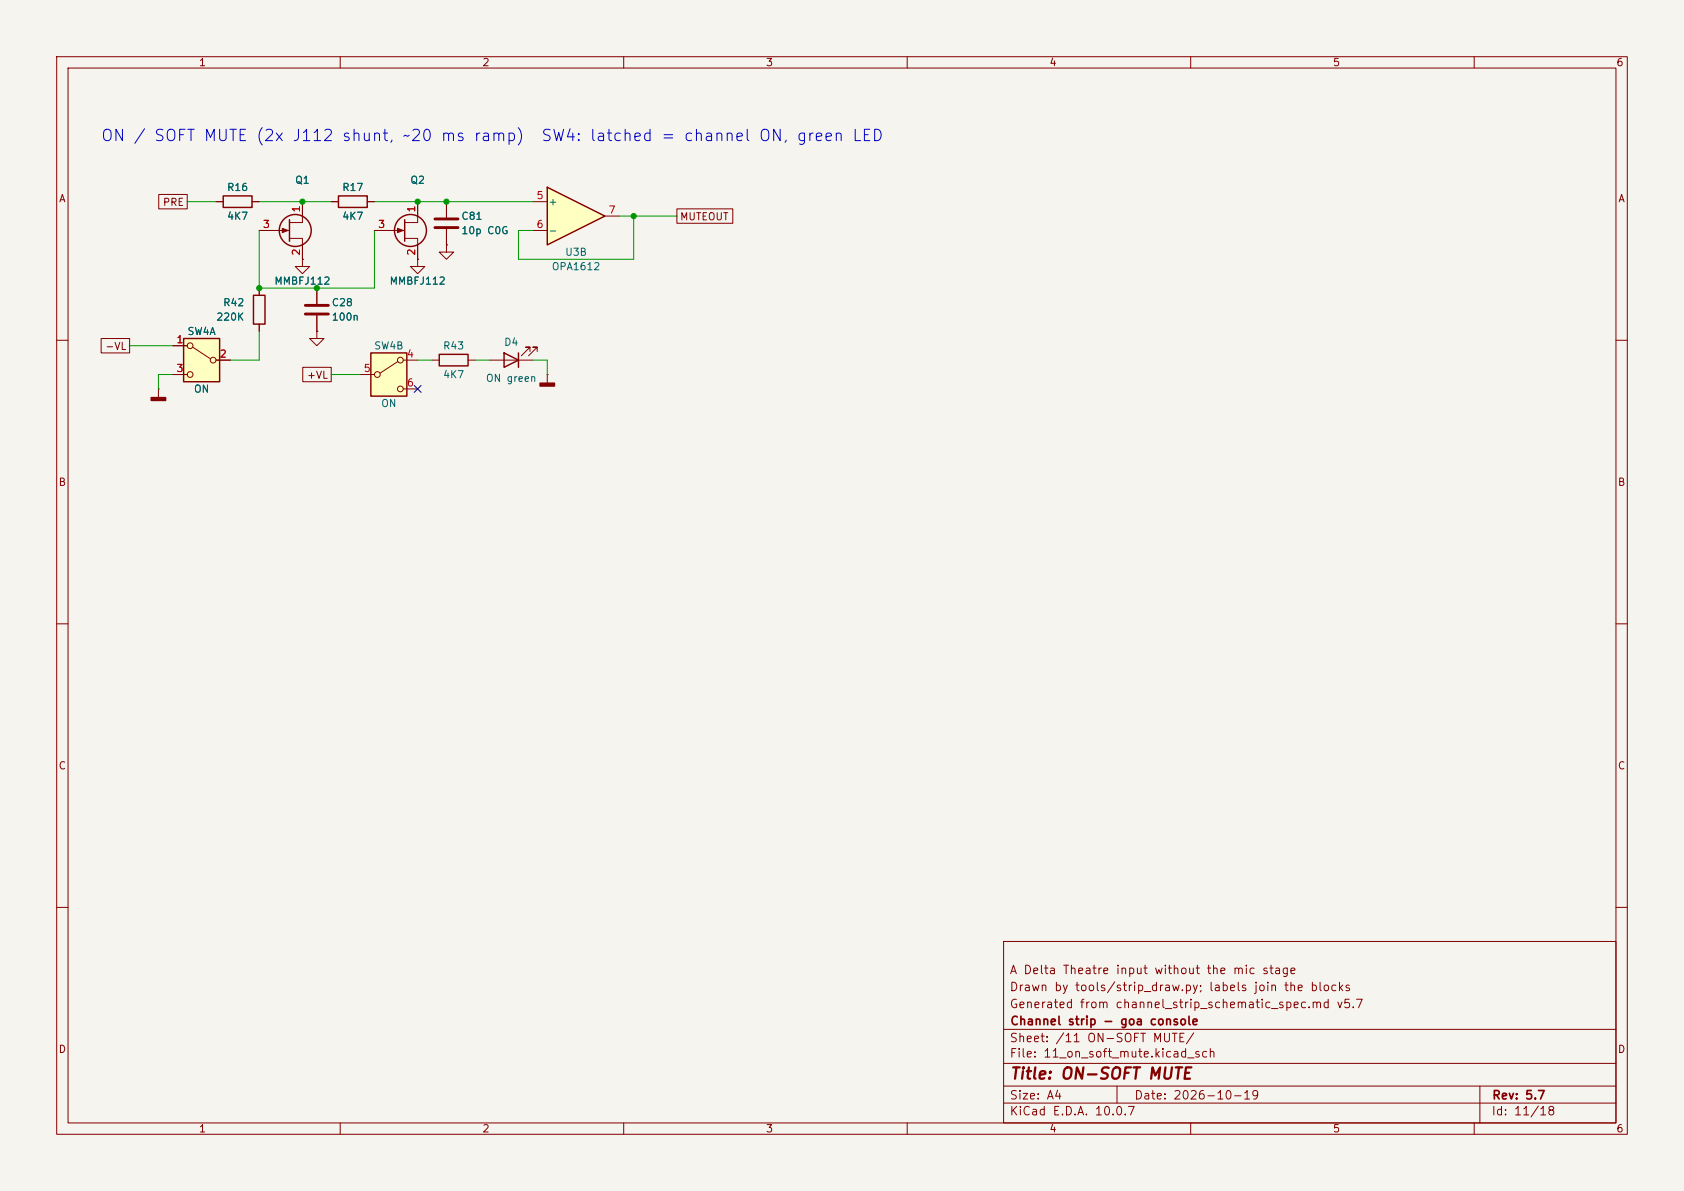
[picture p37: page 11]

A Delta Theatre input without the mic stage
Drawn by tools/strip_draw.py; labels join the blocks
Generated from channel_strip_schematic_spec.md v5.7
Channel strip - goa console
Sheet: /11 ON-SOFT MUTE/
File: 11_on_soft_mute.kicad_sch
Title: ON-SOFT MUTE

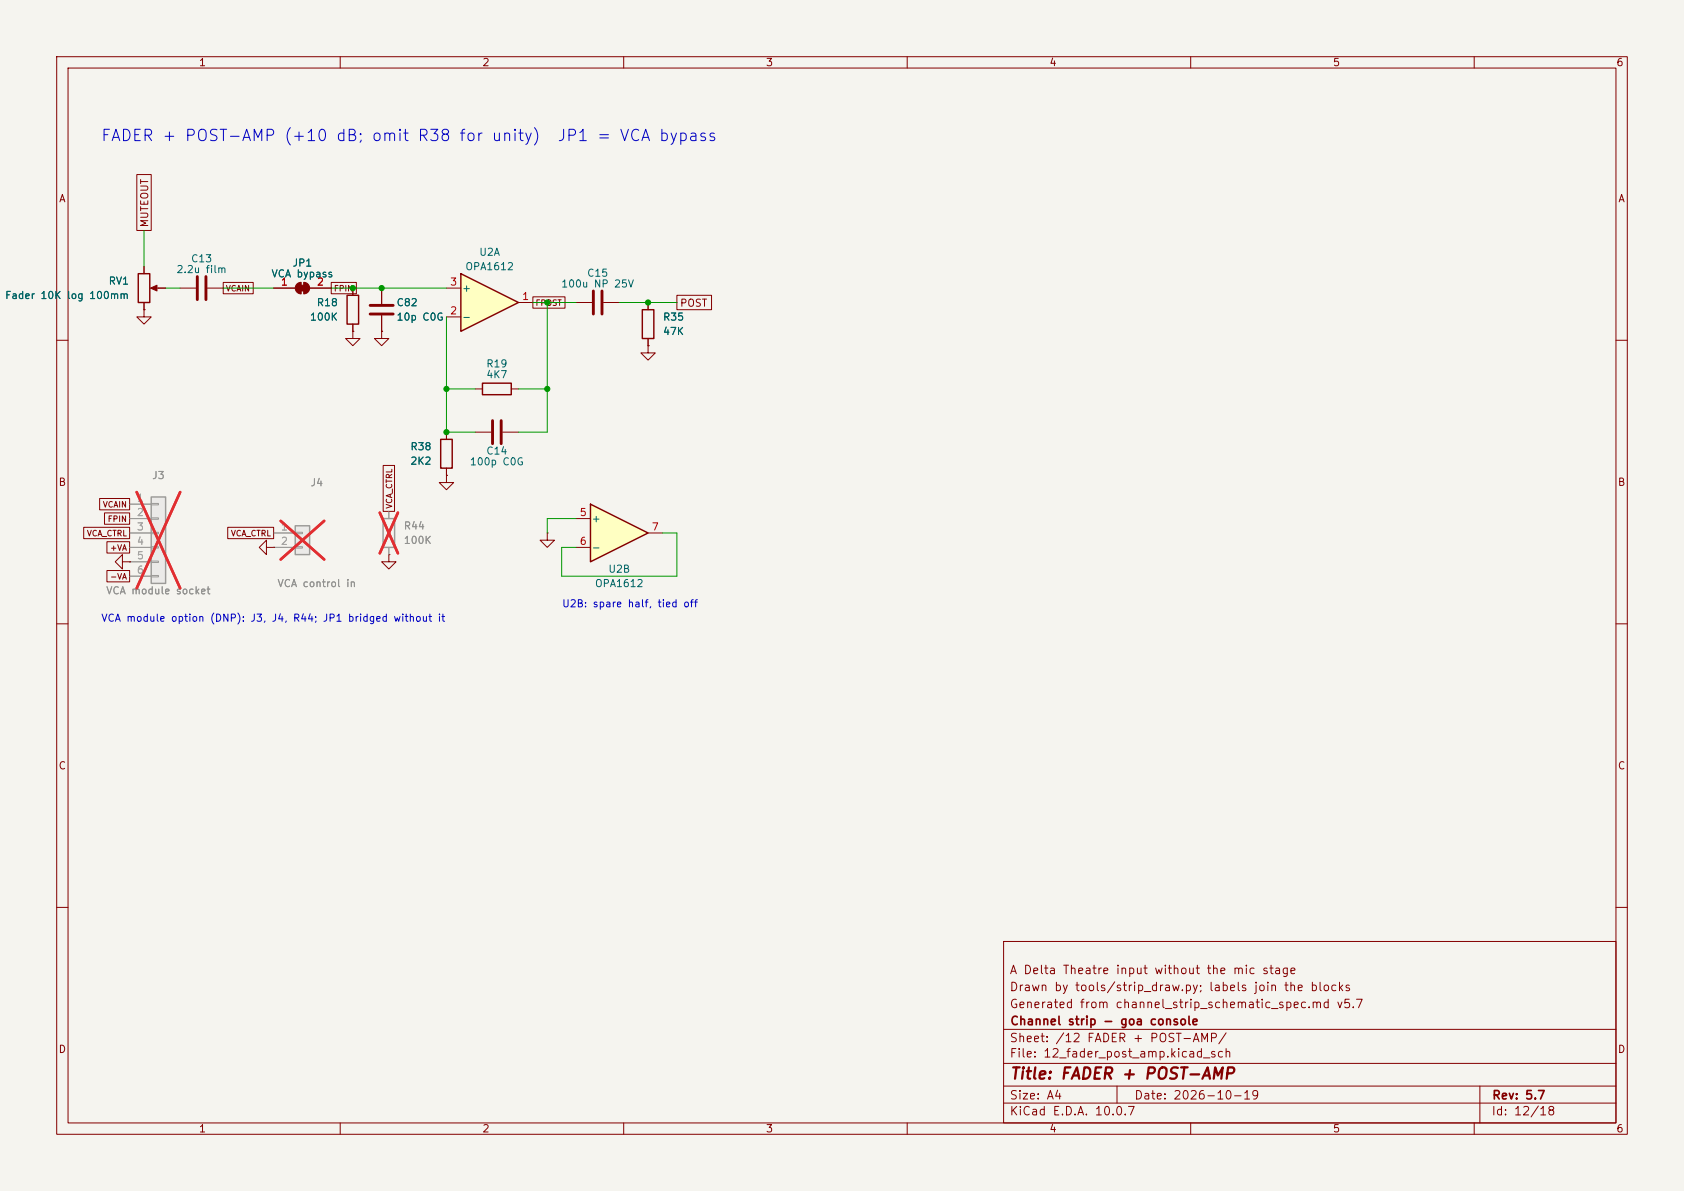
[picture p38: page 12]

A Delta Theatre input without the mic stage
Drawn by tools/strip_draw.py; labels join the blocks
Generated from channel_strip_schematic_spec.md v5.7
Channel strip - goa console
Sheet: /12 FADER + POST-AMP/
File: 12_fader_post_amp.kicad_sch
Title: FADER + POST-AMP

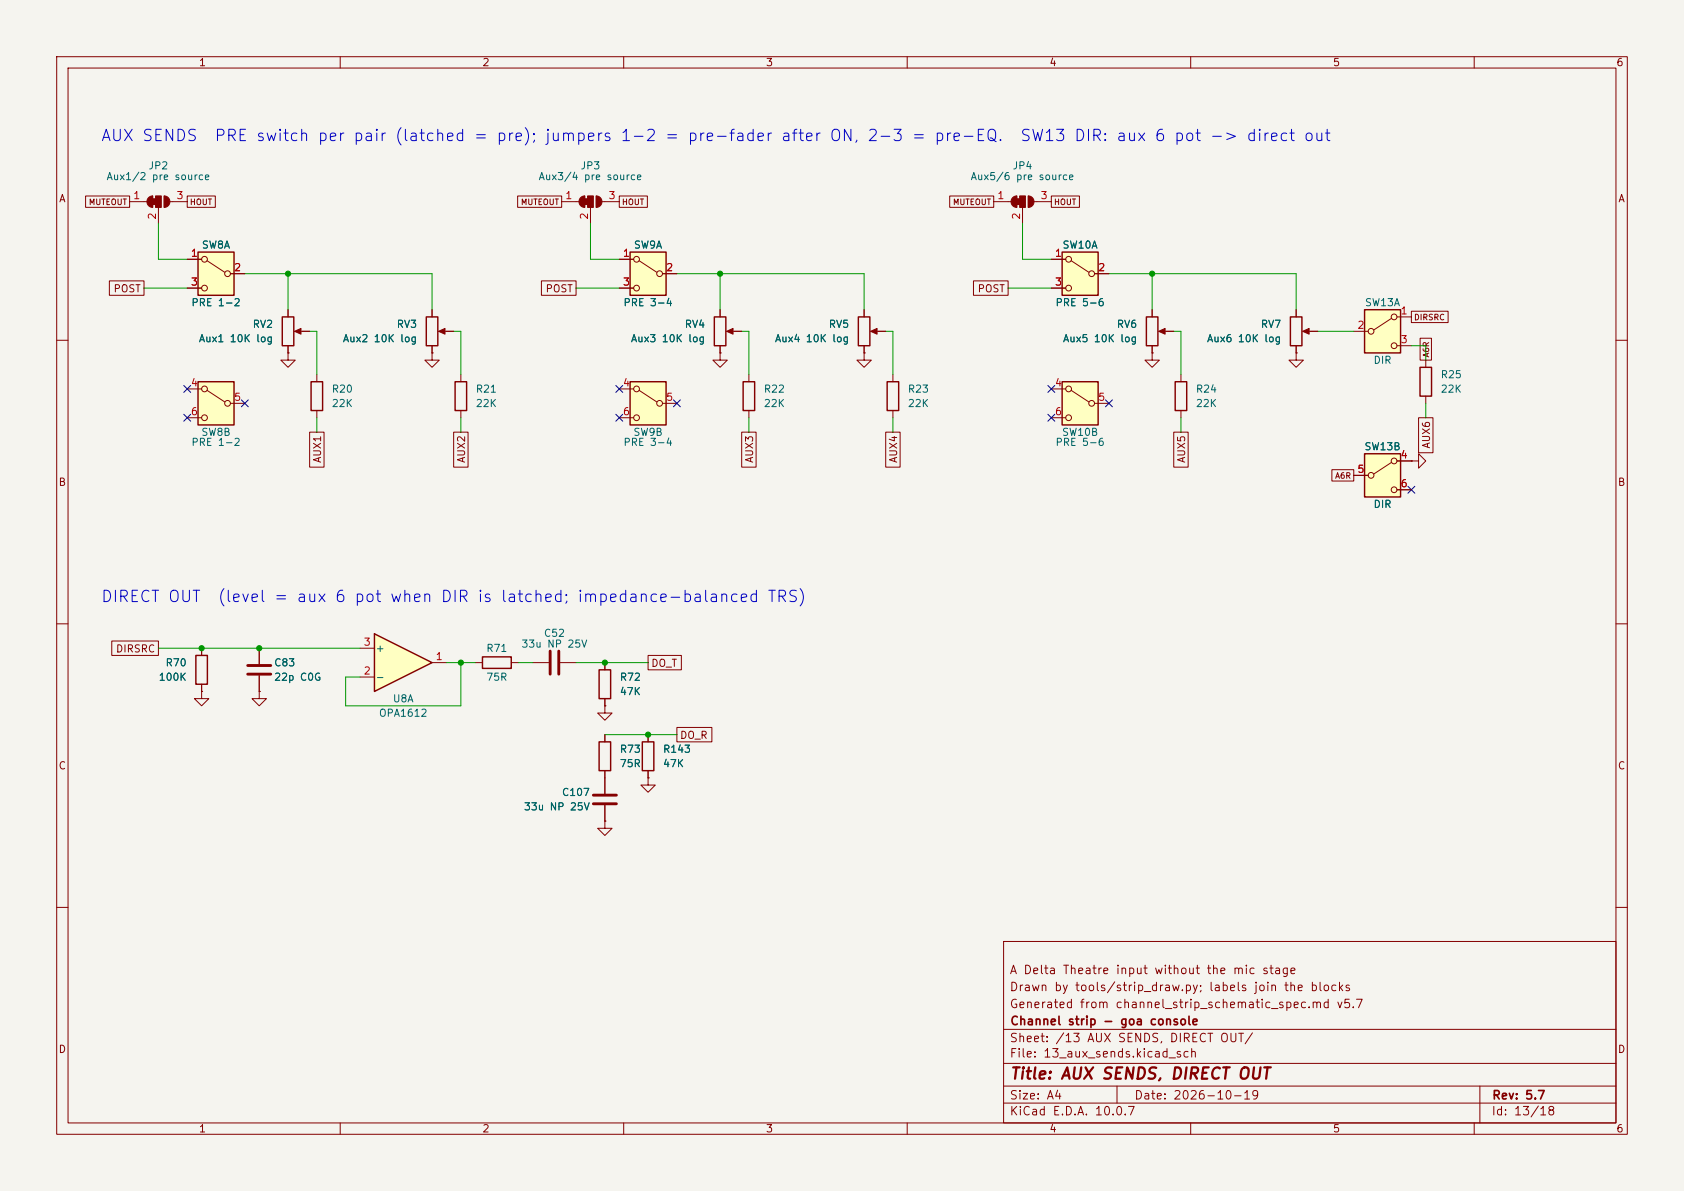
[picture p39: page 13]

AUX SENDS PRE switch per pair (latched = pre); jumpers 1-2 = pre-fader after ON, 2-3 = pre-EQ. SW13 DIR: aux 6 pot -> direct out SW10A PRE 5-6

A Delta Theatre input without the mic stage
Drawn by tools/strip_draw.py; labels join the blocks
Generated from channel_strip_schematic_spec.md v5.7
Channel strip - goa console
Sheet: /13 AUX SENDS, DIRECT OUT/
File: 13_aux_sends.kicad_sch
Title: AUX SENDS, DIRECT OUT

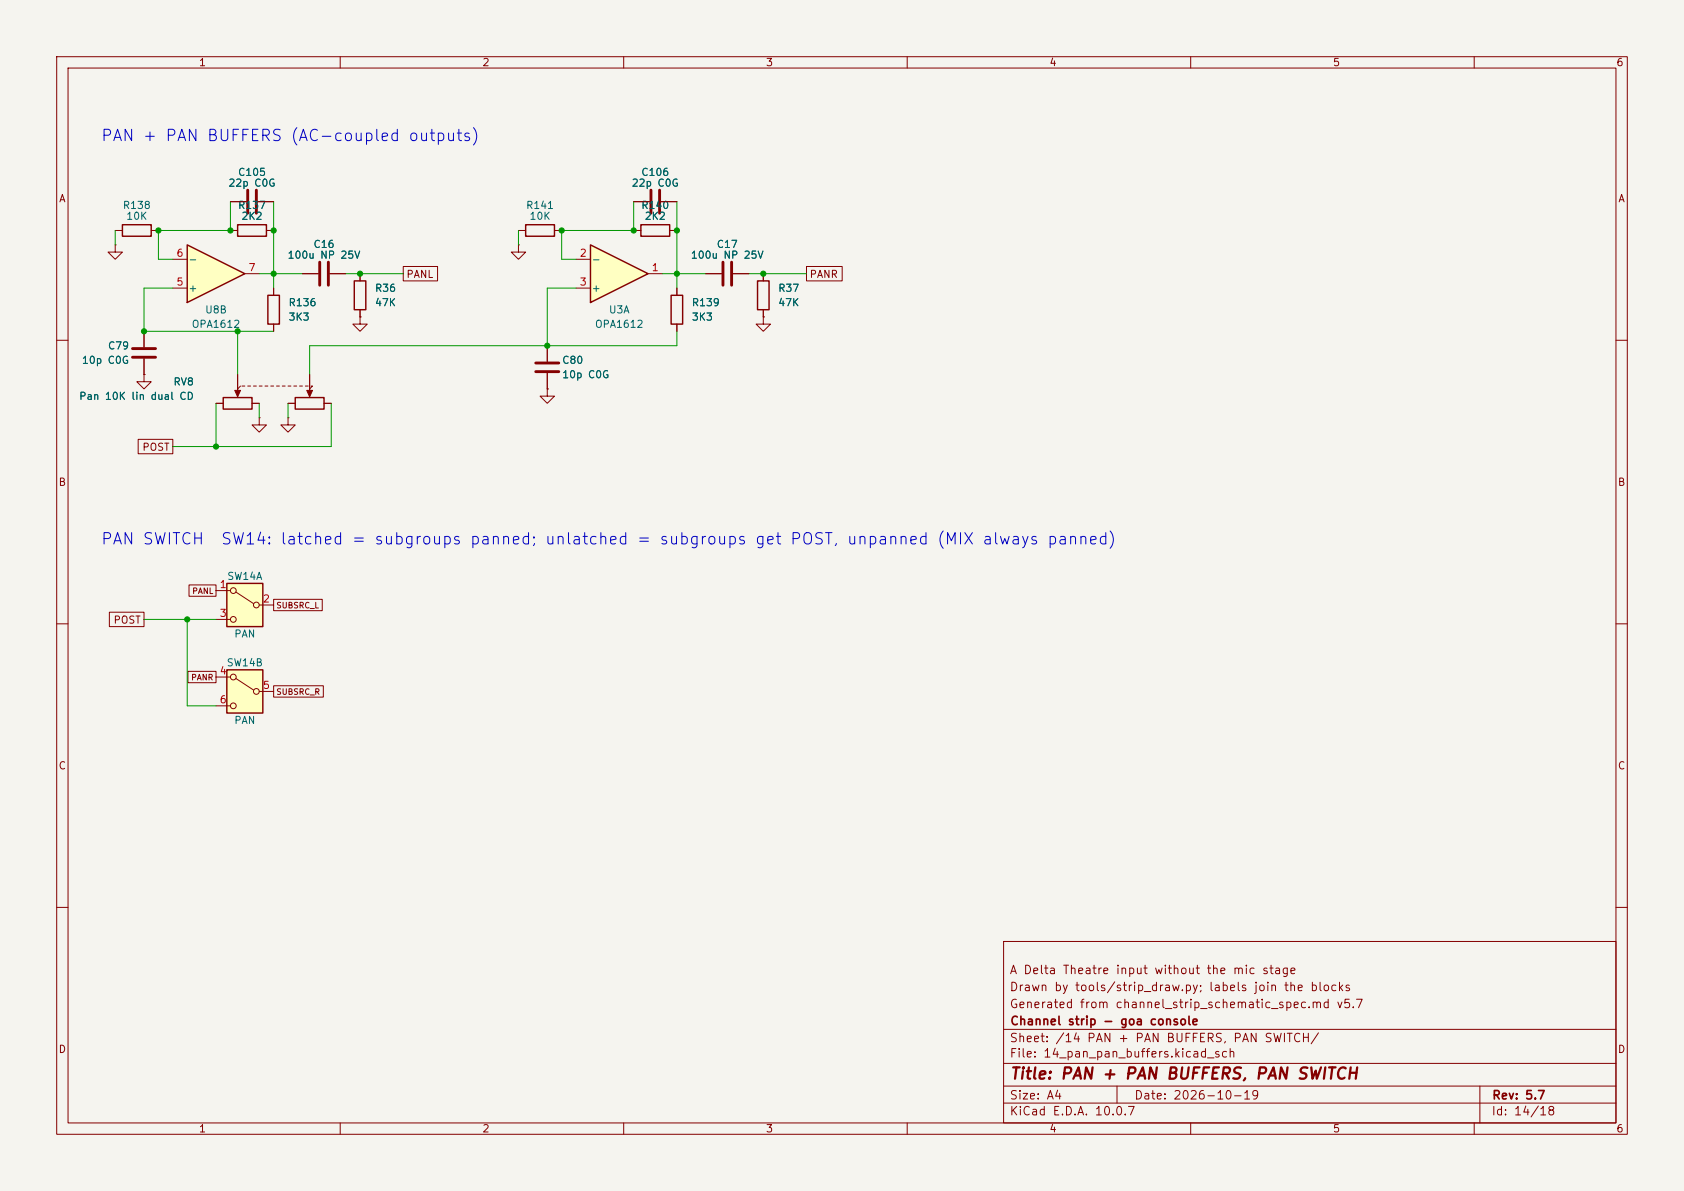
[picture p40: page 14]

SUBSRC_L PAN + PAN BUFFERS (AC-coupled outputs)

RV8 Pan 10K lin dual CD

PAN SWITCH SW14: latched = subgroups panned; unlatched = subgroups get POST, unpanned (MIX always panned)

A Delta Theatre input without the mic stage
Drawn by tools/strip_draw.py; labels join the blocks
Generated from channel_strip_schematic_spec.md v5.7
Channel strip - goa console
Sheet: /14 PAN + PAN BUFFERS, PAN SWITCH/
File: 14_pan_pan_buffers.kicad_sch
Title: PAN + PAN BUFFERS, PAN SWITCH

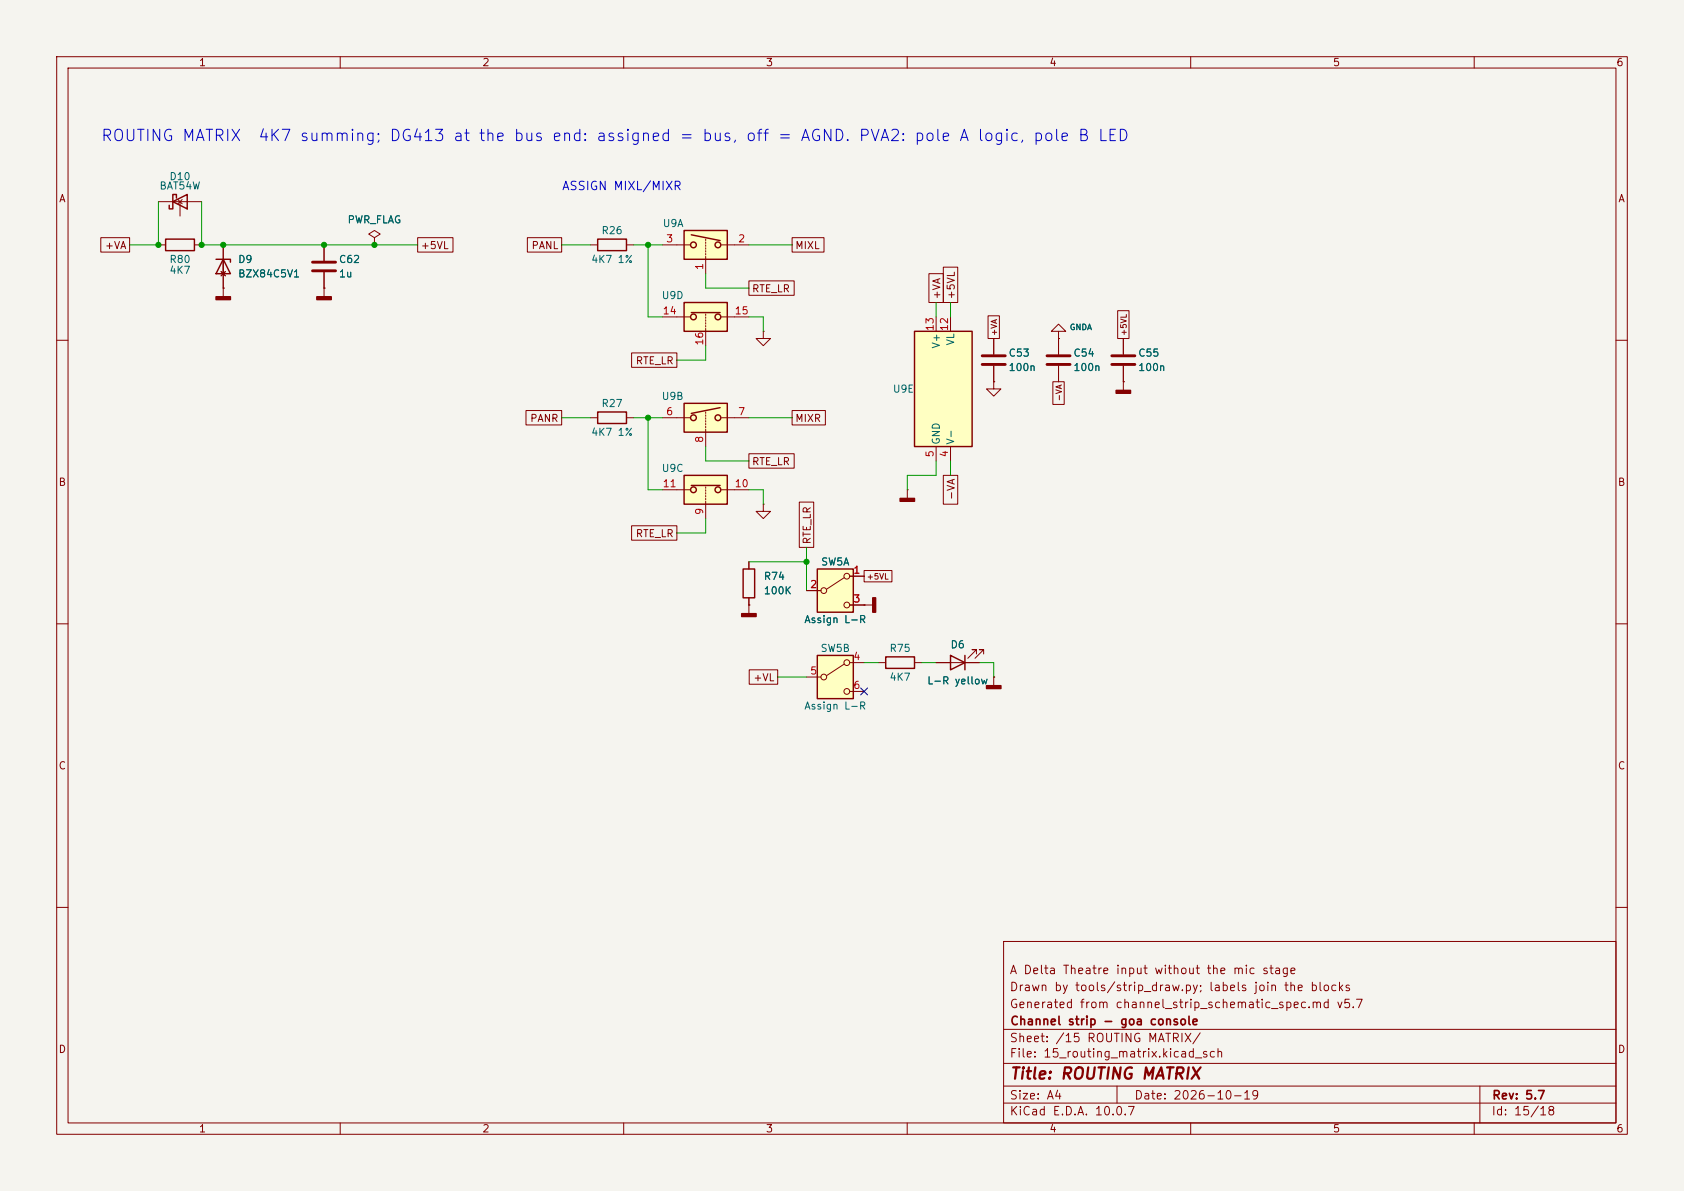
[picture p41: page 15]

ROUTING MATRIX 4K7 summing; DG413 at the bus end: assigned = bus, off = AGND. PVA2: pole A logic, pole B LED

A Delta Theatre input without the mic stage
Drawn by tools/strip_draw.py; labels join the blocks
Generated from channel_strip_schematic_spec.md v5.7
Channel strip - goa console
Sheet: /15 ROUTING MATRIX/
File: 15_routing_matrix.kicad_sch
Title: ROUTING MATRIX

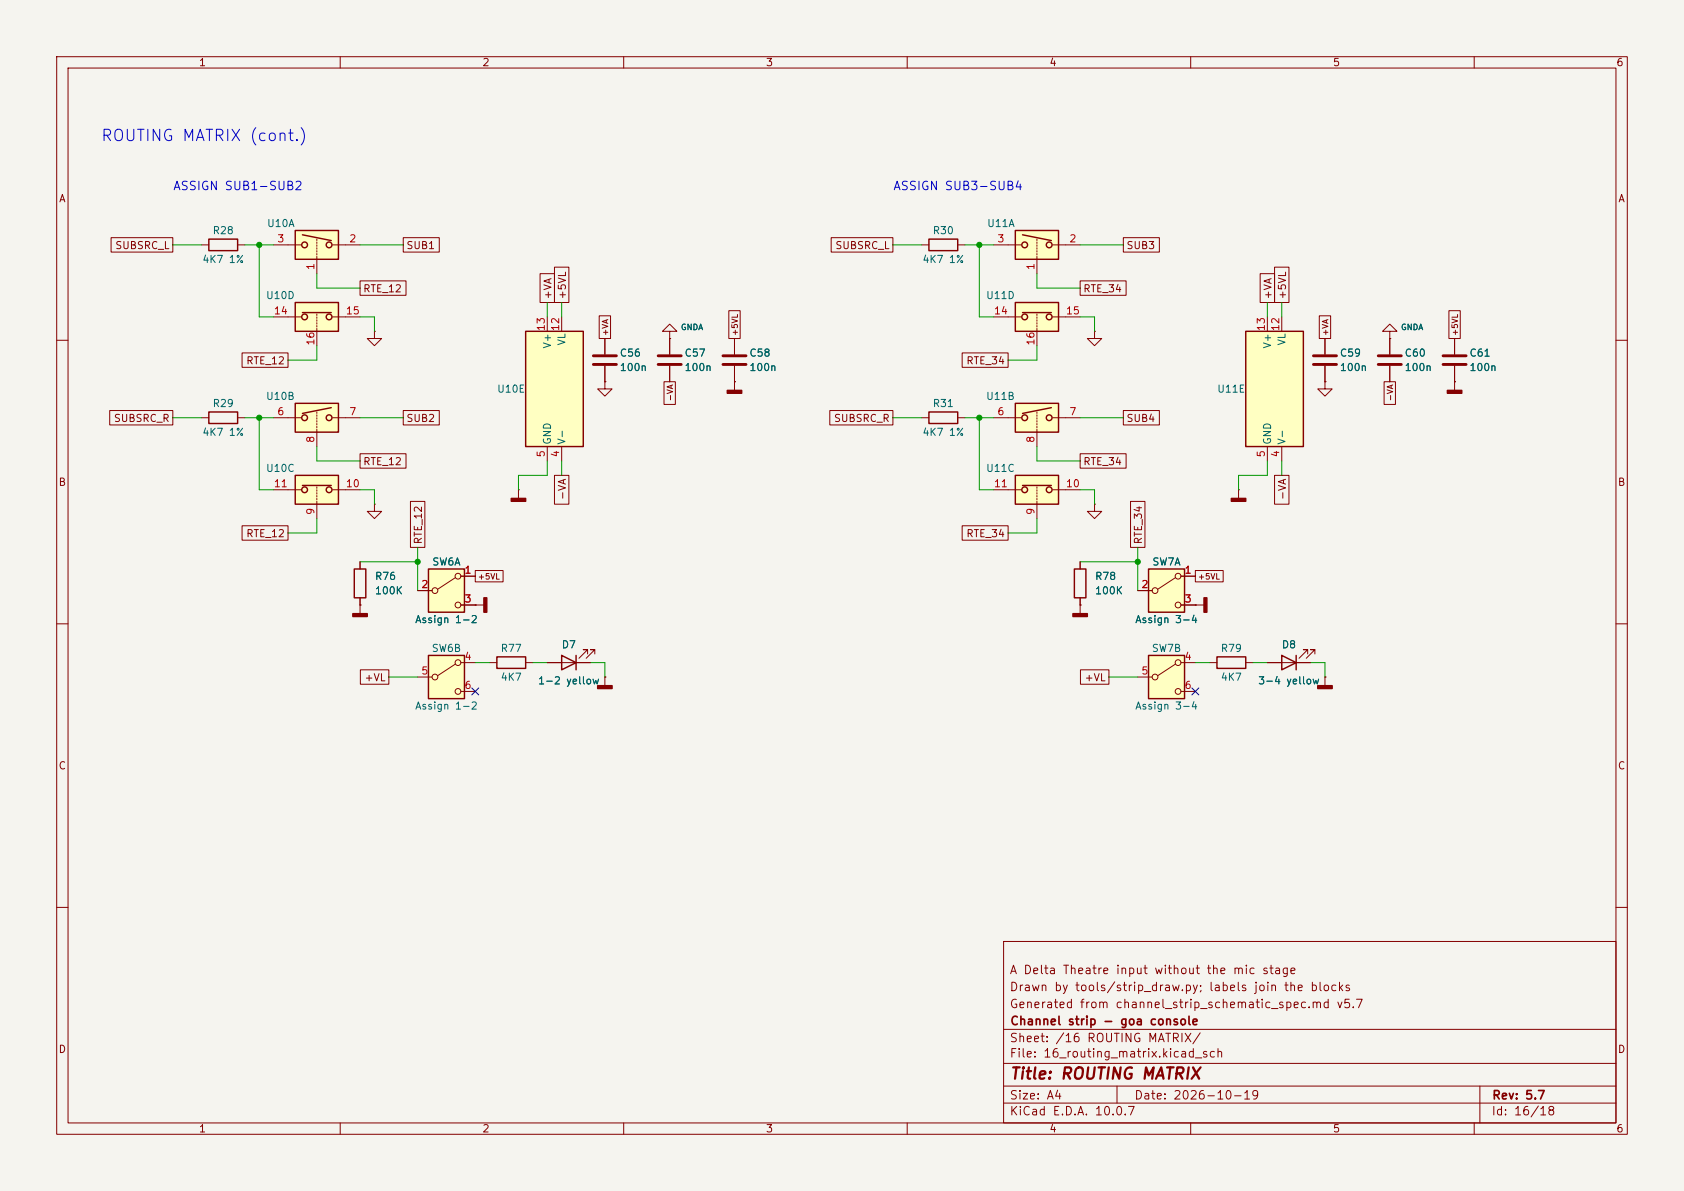
[picture p42: page 16]

A Delta Theatre input without the mic stage
Drawn by tools/strip_draw.py; labels join the blocks
Generated from channel_strip_schematic_spec.md v5.7
Channel strip - goa console
Sheet: /16 ROUTING MATRIX/
File: 16_routing_matrix.kicad_sch
Title: ROUTING MATRIX

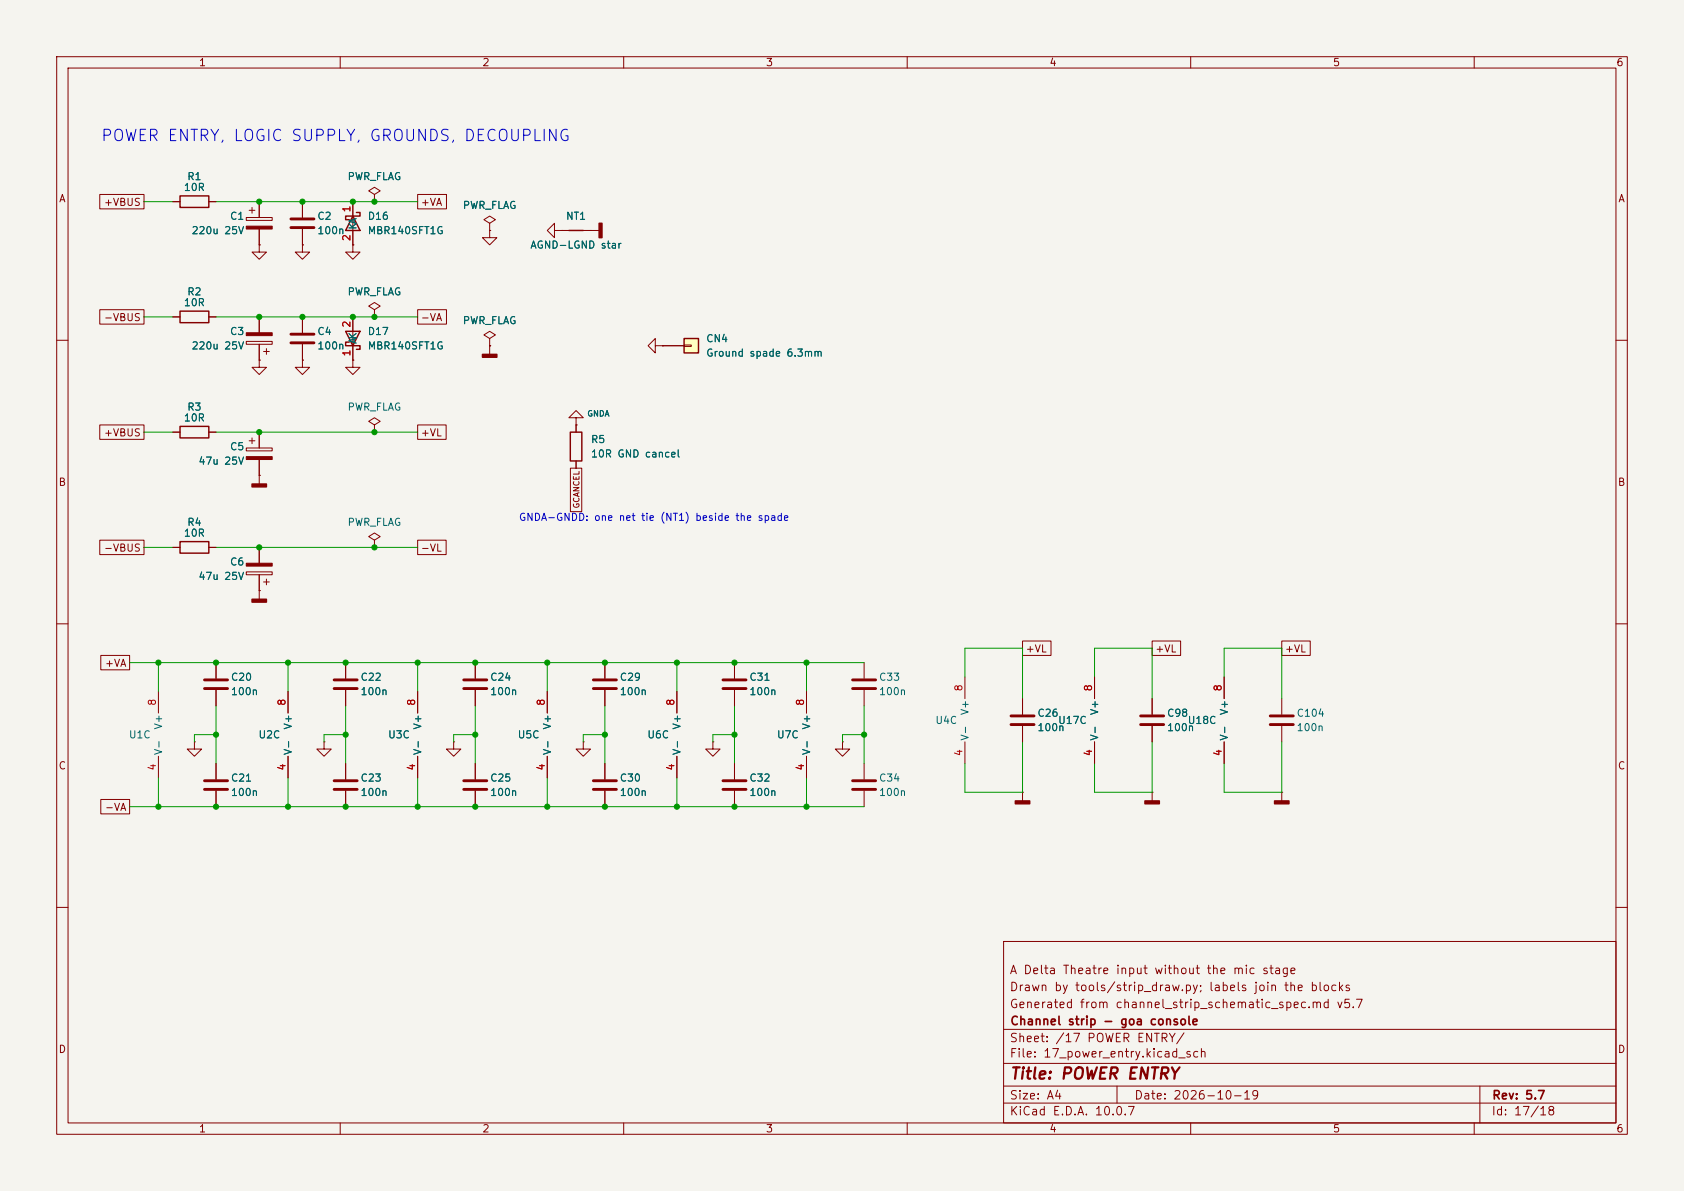
[picture p43: page 17]

POWER ENTRY, LOGIC SUPPLY, GROUNDS, DECOUPLING
100n PWR_FLAG

A Delta Theatre input without the mic stage
Drawn by tools/strip_draw.py; labels join the blocks
Generated from channel_strip_schematic_spec.md v5.7
Channel strip - goa console
Sheet: /17 POWER ENTRY/
File: 17_power_entry.kicad_sch
Title: POWER ENTRY

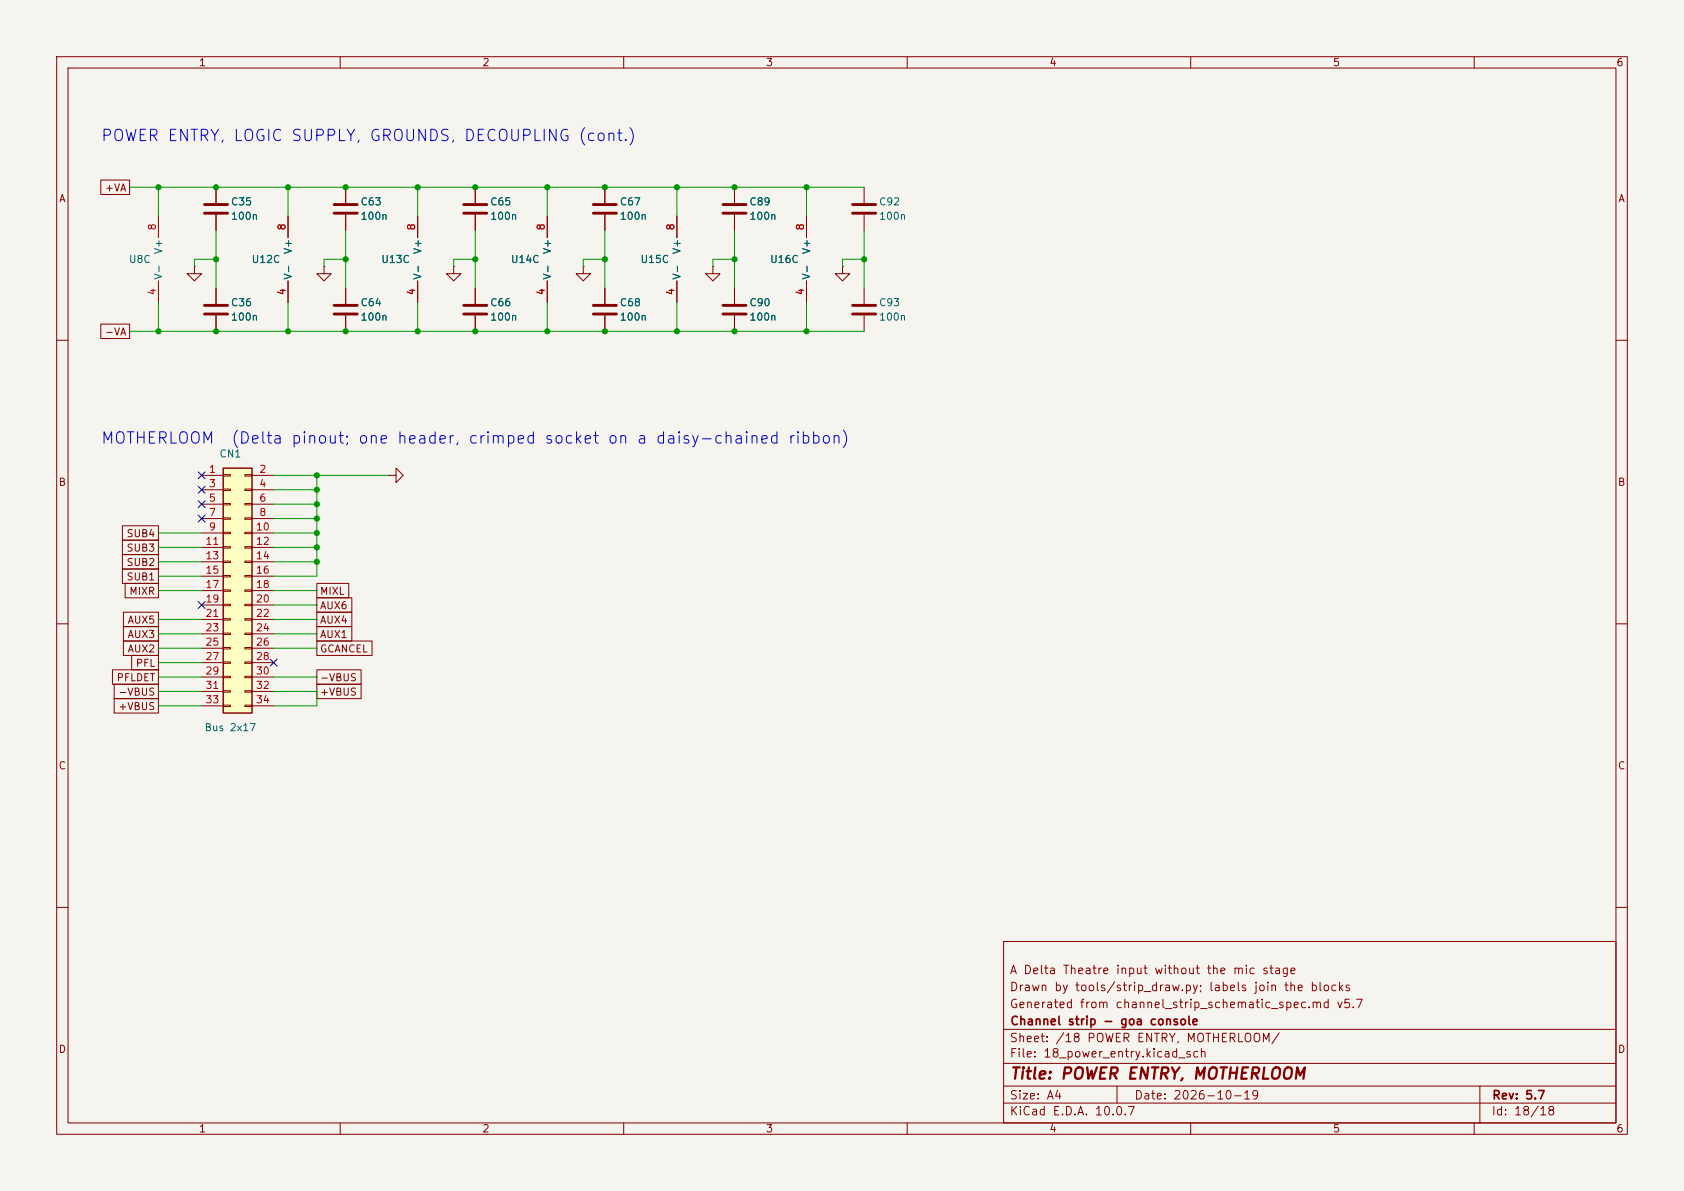
[picture p44: page 18]

POWER ENTRY, LOGIC SUPPLY, GROUNDS, DECOUPLING (cont.)

100n +VBUS -VBUS GCANCEL +VA

SUB4 -VA MOTHERLOOM (Delta pinout; one header, crimped socket on a daisy-chained ribbon)

A Delta Theatre input without the mic stage
Drawn by tools/strip_draw.py; labels join the blocks
Generated from channel_strip_schematic_spec.md v5.7
Channel strip - goa console
Sheet: /18 POWER ENTRY, MOTHERLOOM/
File: 18_power_entry.kicad_sch
Title: POWER ENTRY, MOTHERLOOM
