cozycactus/goa-console/pdf/master.pdf

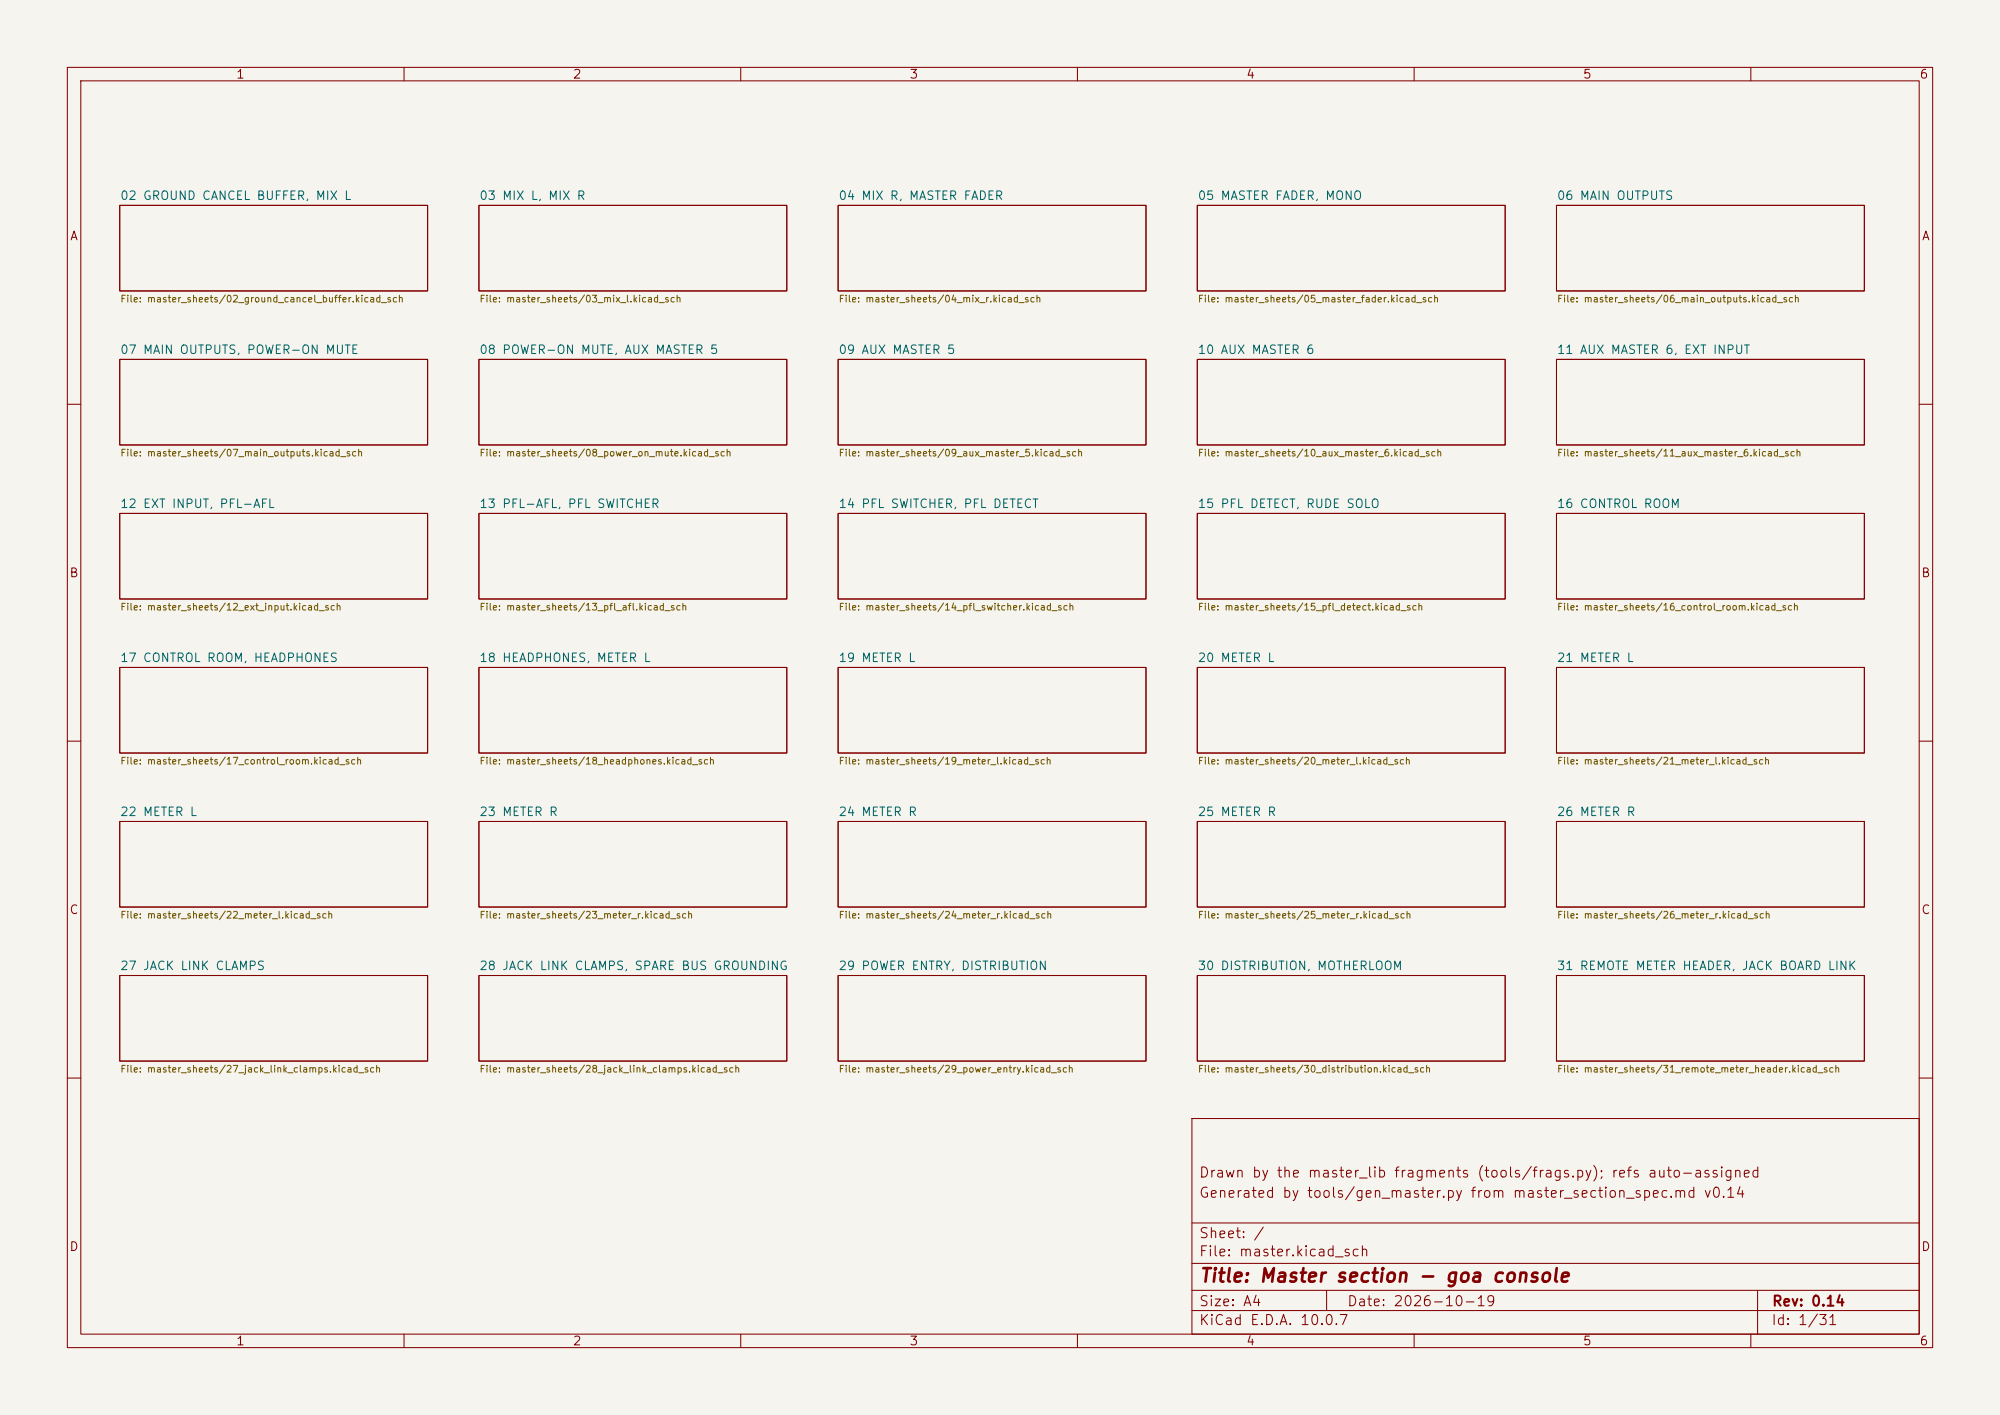
[picture p58: page 1]

02 GROUND CANCEL BUFFER, MIX L

File: master_sheets/02_ground_cancel_buffer.kicad_sch 07 MAIN OUTPUTS, POWER-ON MUTE

File: master_sheets/03_mix_l.kicad_sch 08 POWER-ON MUTE, AUX MASTER 5

File: master_sheets/07_main_outputs.kicad_sch 12 EXT INPUT, PFL-AFL

File: master_sheets/08_power_on_mute.kicad_sch 13 PFL-AFL, PFL SWITCHER

File: master_sheets/09_aux_master_5.kicad_sch 14 PFL SWITCHER, PFL DETECT

File: master_sheets/12_ext_input.kicad_sch 17 CONTROL ROOM, HEADPHONES

File: master_sheets/22_meter_l.kicad_sch 27 JACK LINK CLAMPS

File: master_sheets/23_meter_r.kicad_sch 28 JACK LINK CLAMPS, SPARE BUS GROUNDING

File: master_sheets/25_meter_r.kicad_sch 29 POWER ENTRY, DISTRIBUTION

File: master_sheets/26_meter_r.kicad_sch 31 REMOTE METER HEADER, JACK BOARD LINK

Drawn by the master_lib fragments (tools/frags.py); refs auto-assigned
Generated by tools/gen_master.py from master_section_spec.md v0.14

Sheet: /
File: master.kicad_sch
Title: Master section - goa console

Size: A4 | Rev: 0.14
KiCad E.D.A. 10.0.7 | Id: 1/31

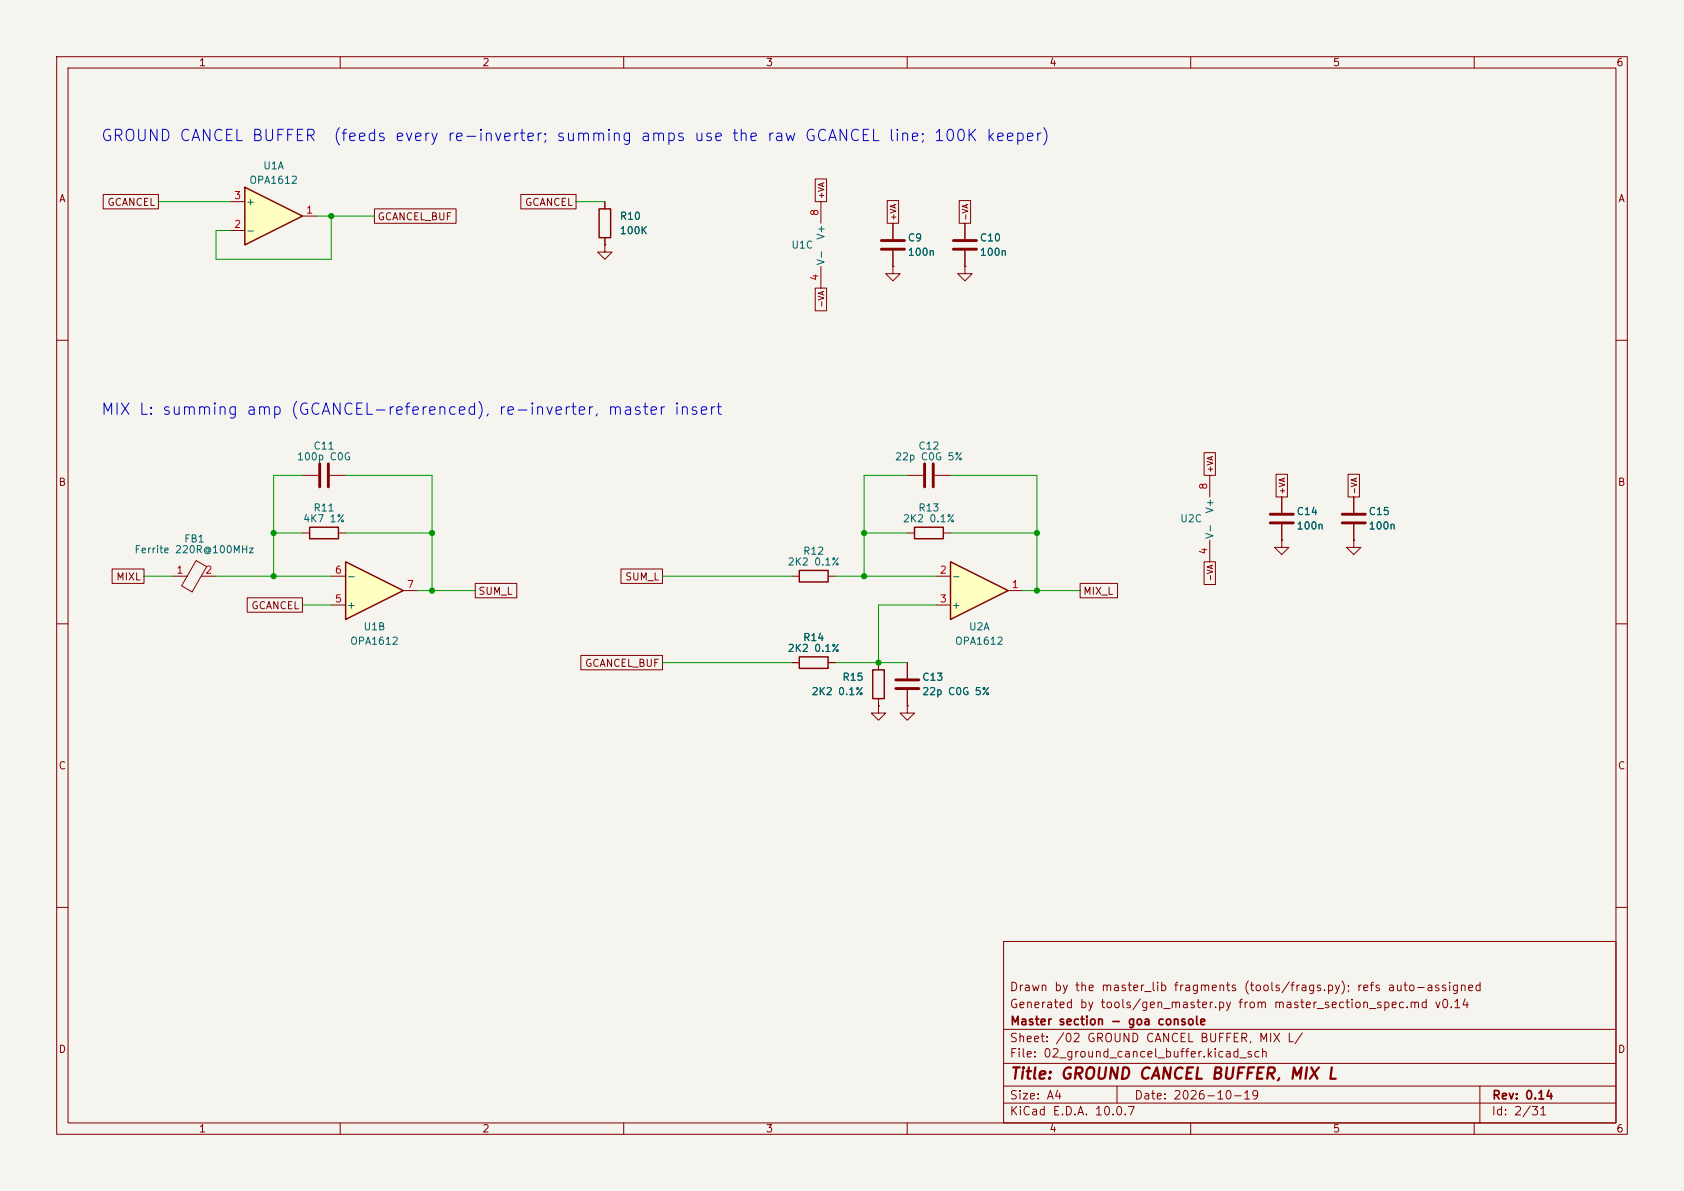
[picture p59: page 2]

GROUND CANCEL BUFFER (feeds every re-inverter; summing amps use the raw GCANCEL line; 100K keeper)

MIX L: summing amp (GCANCEL-referenced), re-inverter, master insert

Drawn by the master_lib fragments (tools/frags.py); refs auto-assigned
Generated by tools/gen_master.py from master_section_spec.md v0.14
Master section - goa console
Sheet: /02 GROUND CANCEL BUFFER, MIX L/
File: 02_ground_cancel_buffer.kicad_sch
Title: GROUND CANCEL BUFFER, MIX L

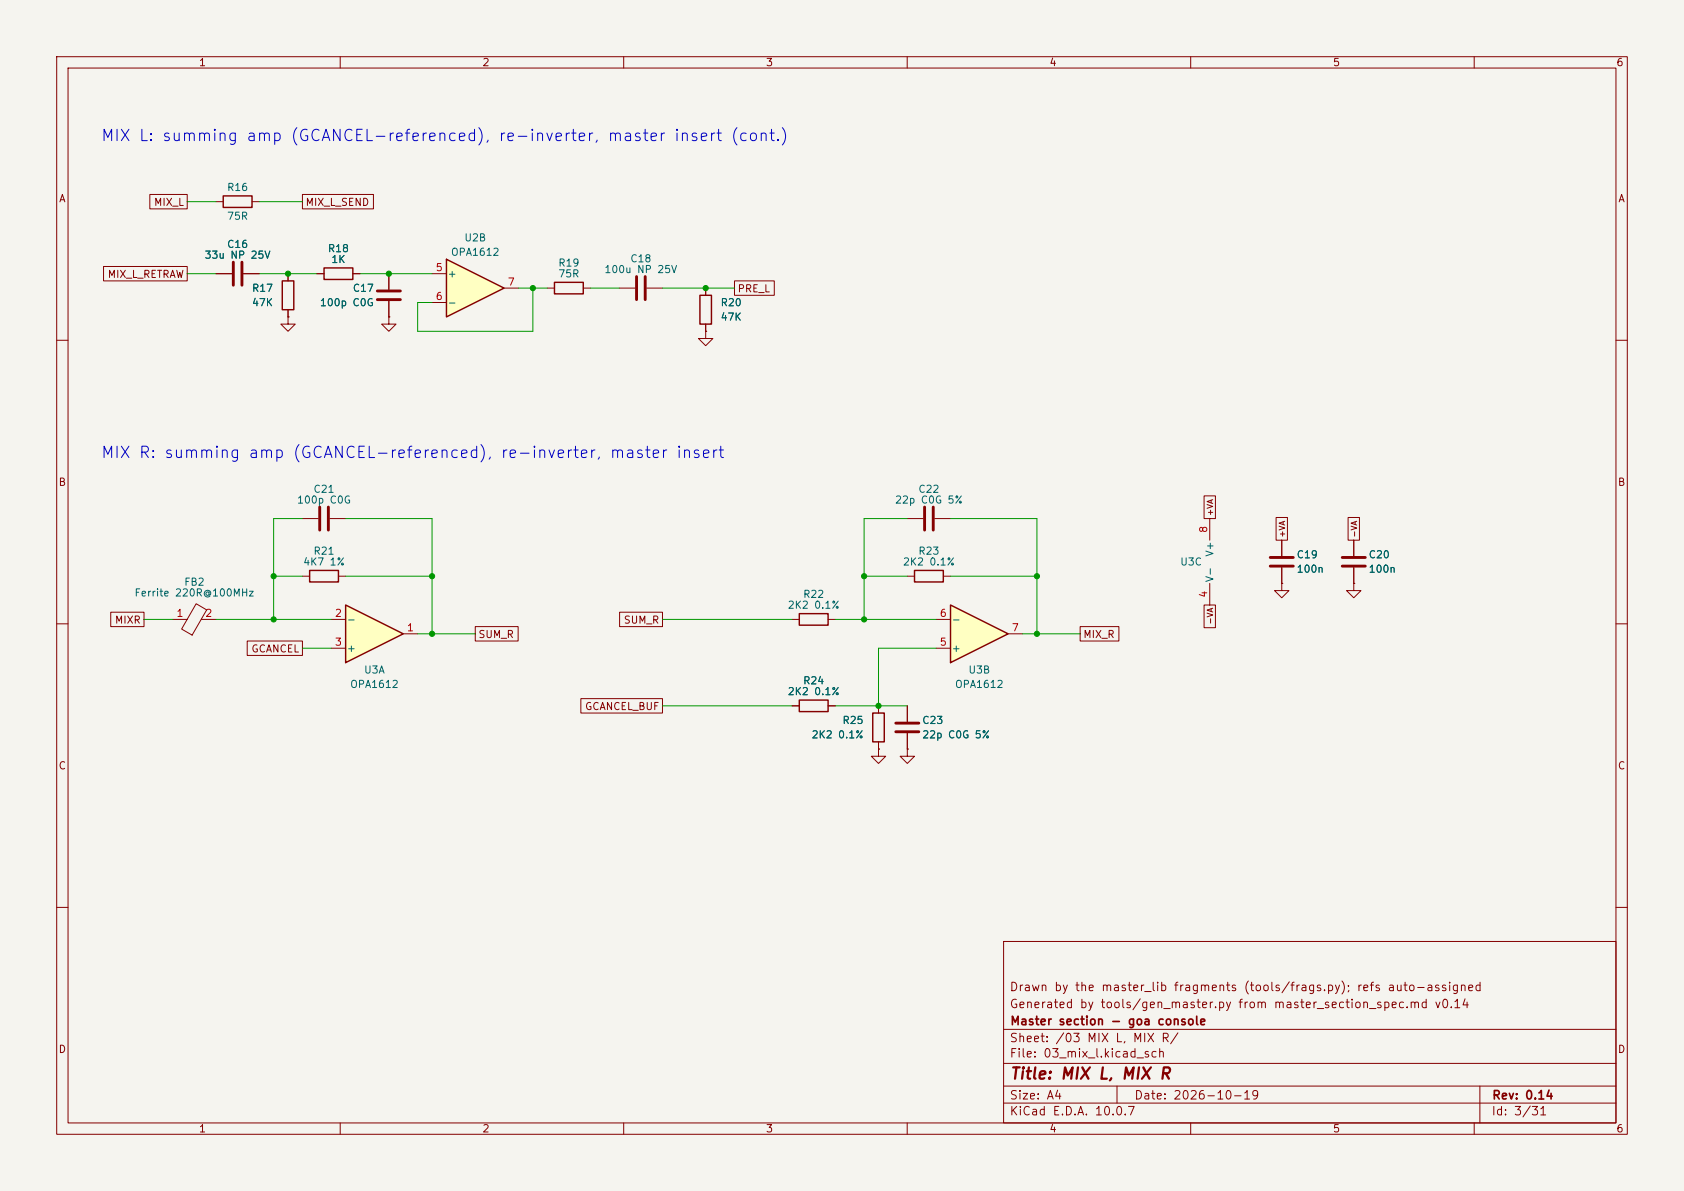
[picture p60: page 3]

GCANCEL_BUF MIX_L_RETRAW MIX L: summing amp (GCANCEL-referenced), re-inverter, master insert (cont.)
GCANCEL MIX_L_SEND

MIX R: summing amp (GCANCEL-referenced), re-inverter, master insertR20

Drawn by the master_lib fragments (tools/frags.py); refs auto-assigned
Generated by tools/gen_master.py from master_section_spec.md v0.14
Master section - goa console
Sheet: /03 MIX L, MIX R/
File: 03_mix_l.kicad_sch
Title: MIX L, MIX R

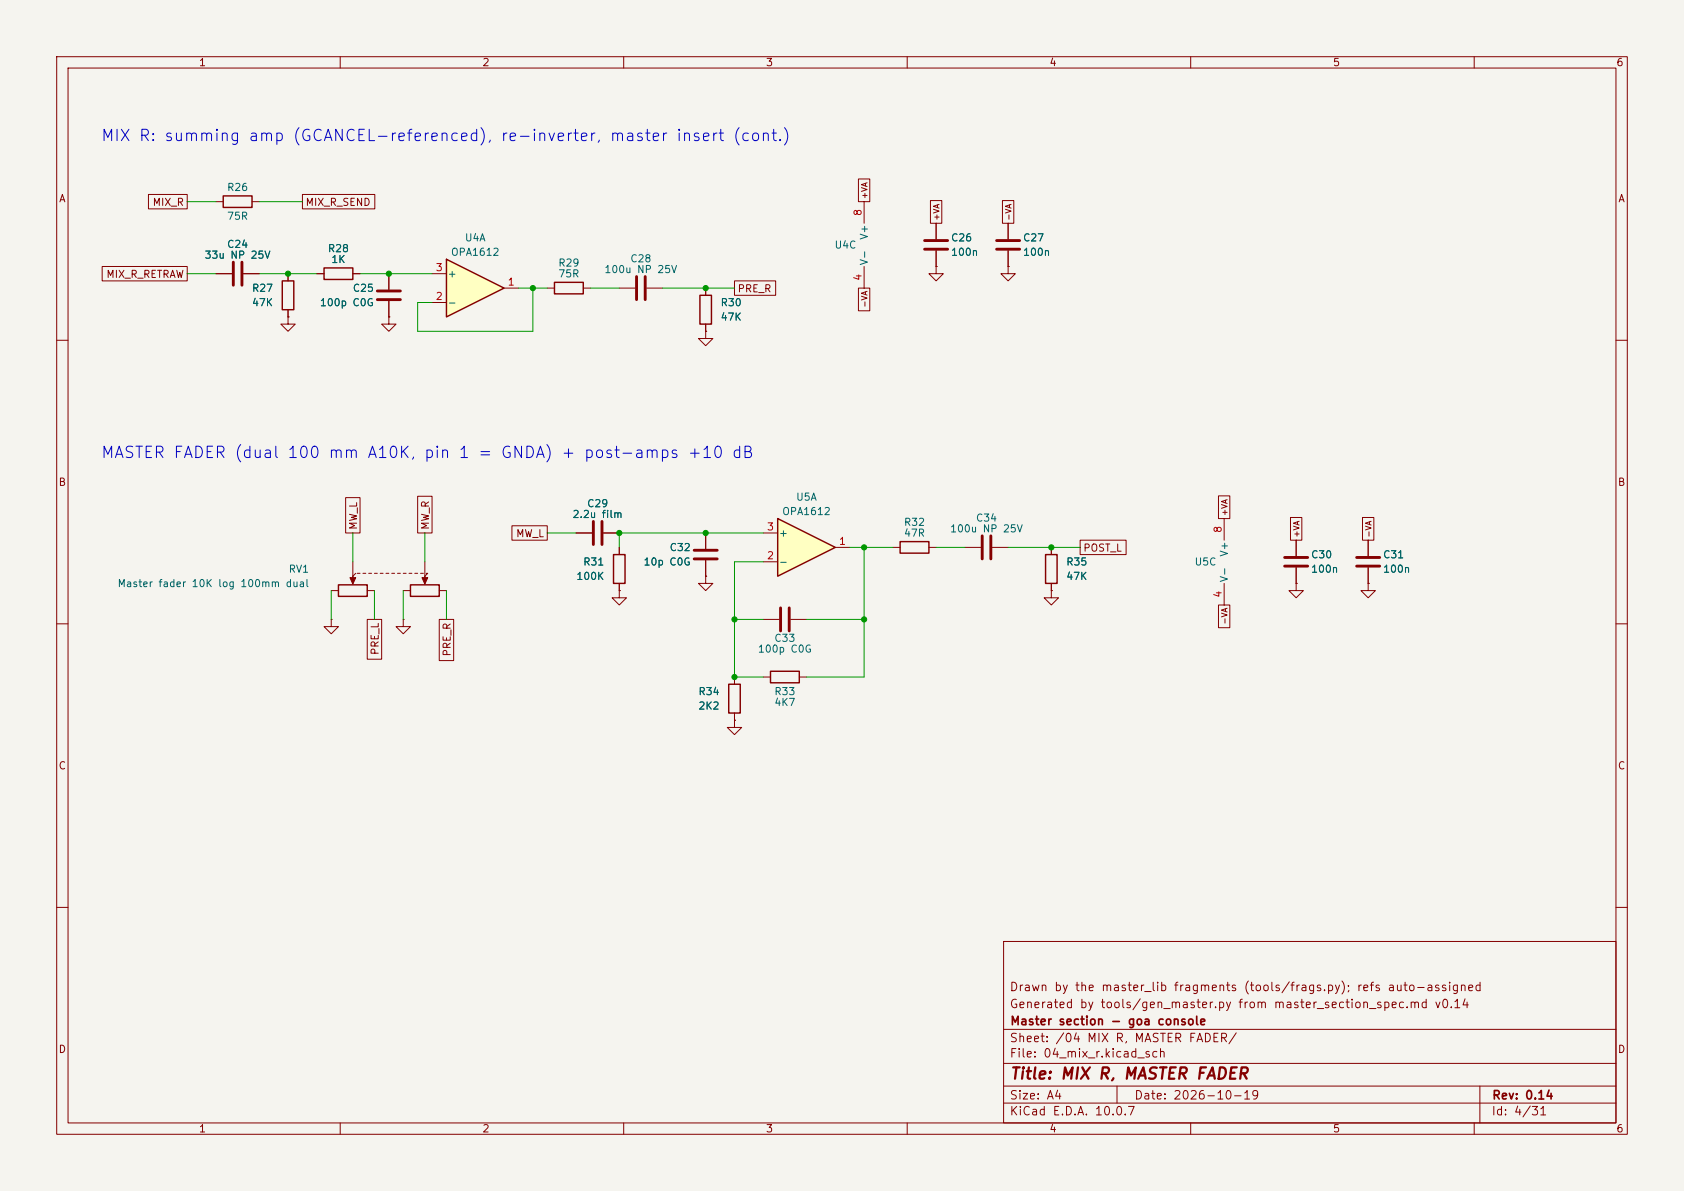
[picture p61: page 4]

MIX R: summing amp (GCANCEL-referenced), re-inverter, master insert (cont.)

Drawn by the master_lib fragments (tools/frags.py); refs auto-assigned
Generated by tools/gen_master.py from master_section_spec.md v0.14
Master section - goa console
Sheet: /04 MIX R, MASTER FADER/
File: 04_mix_r.kicad_sch
Title: MIX R, MASTER FADER

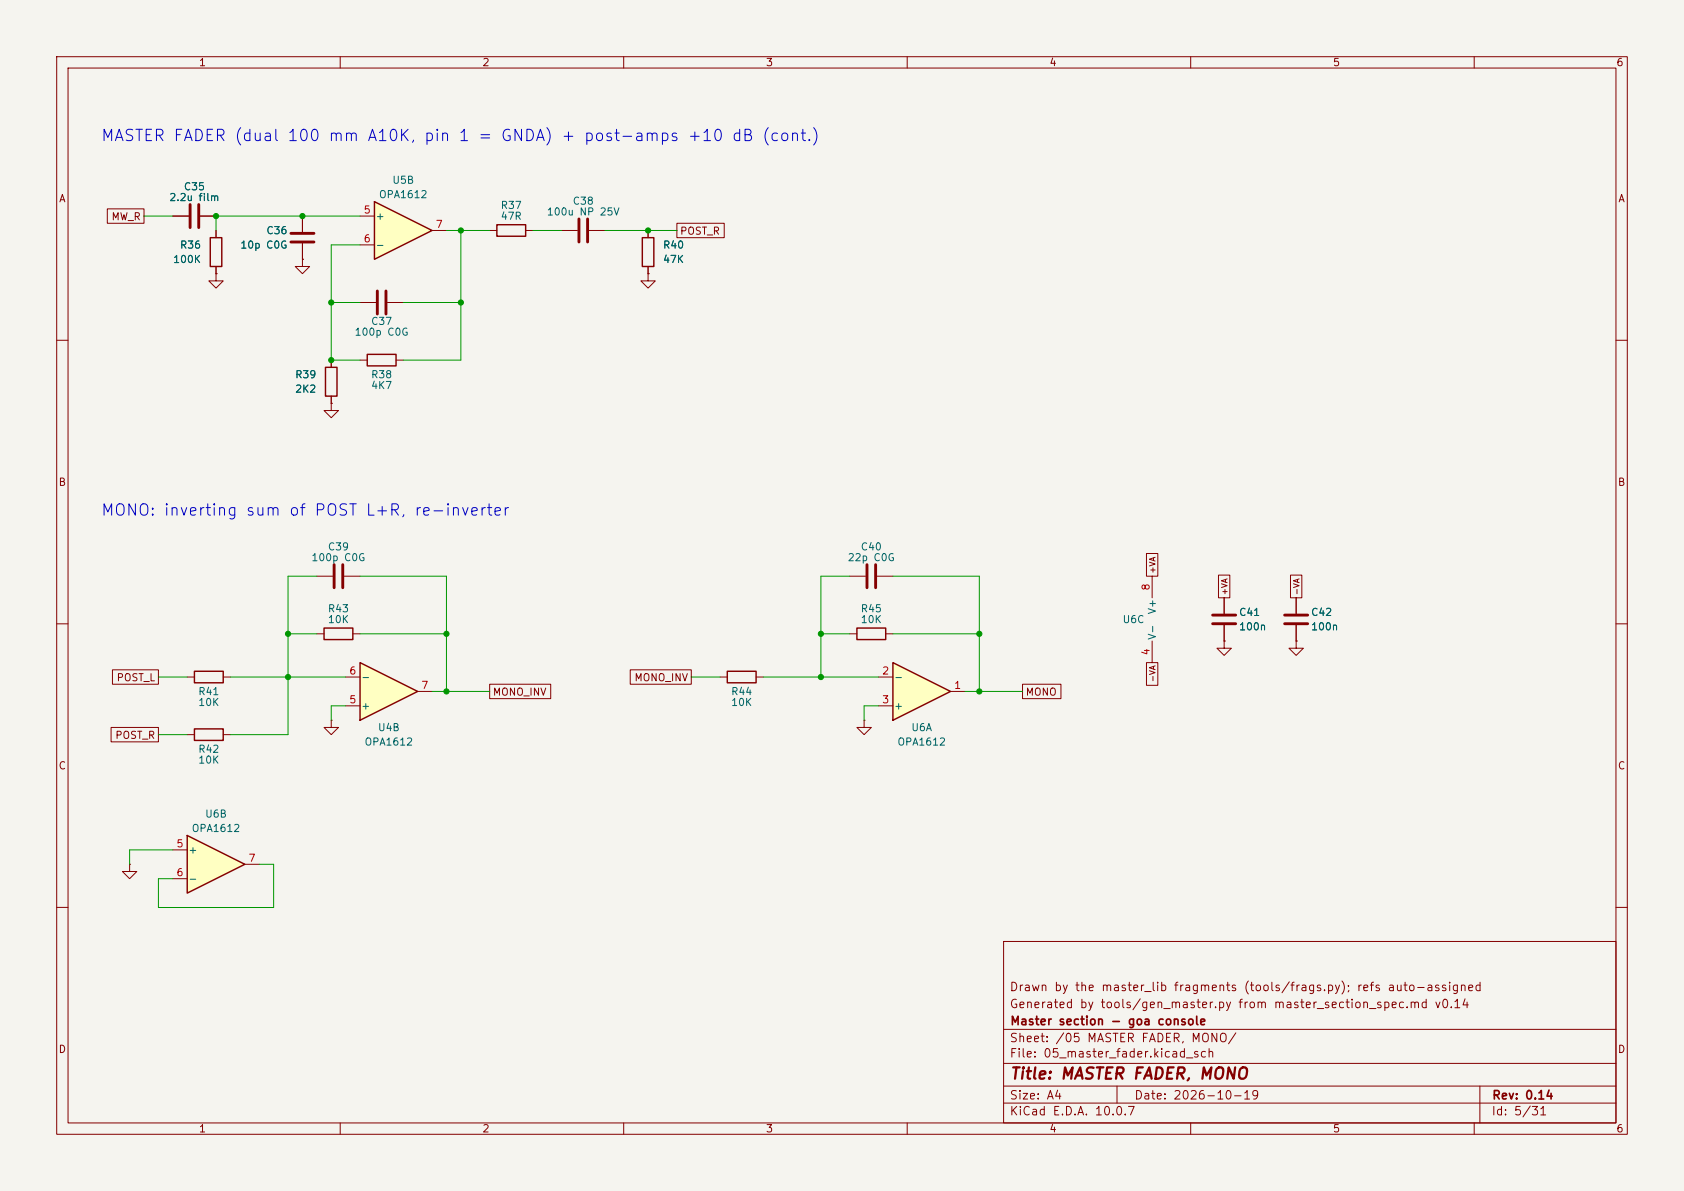
[picture p62: page 5]

Drawn by the master_lib fragments (tools/frags.py); refs auto-assigned
Generated by tools/gen_master.py from master_section_spec.md v0.14
Master section - goa console
Sheet: /05 MASTER FADER, MONO/
File: 05_master_fader.kicad_sch
Title: MASTER FADER, MONO

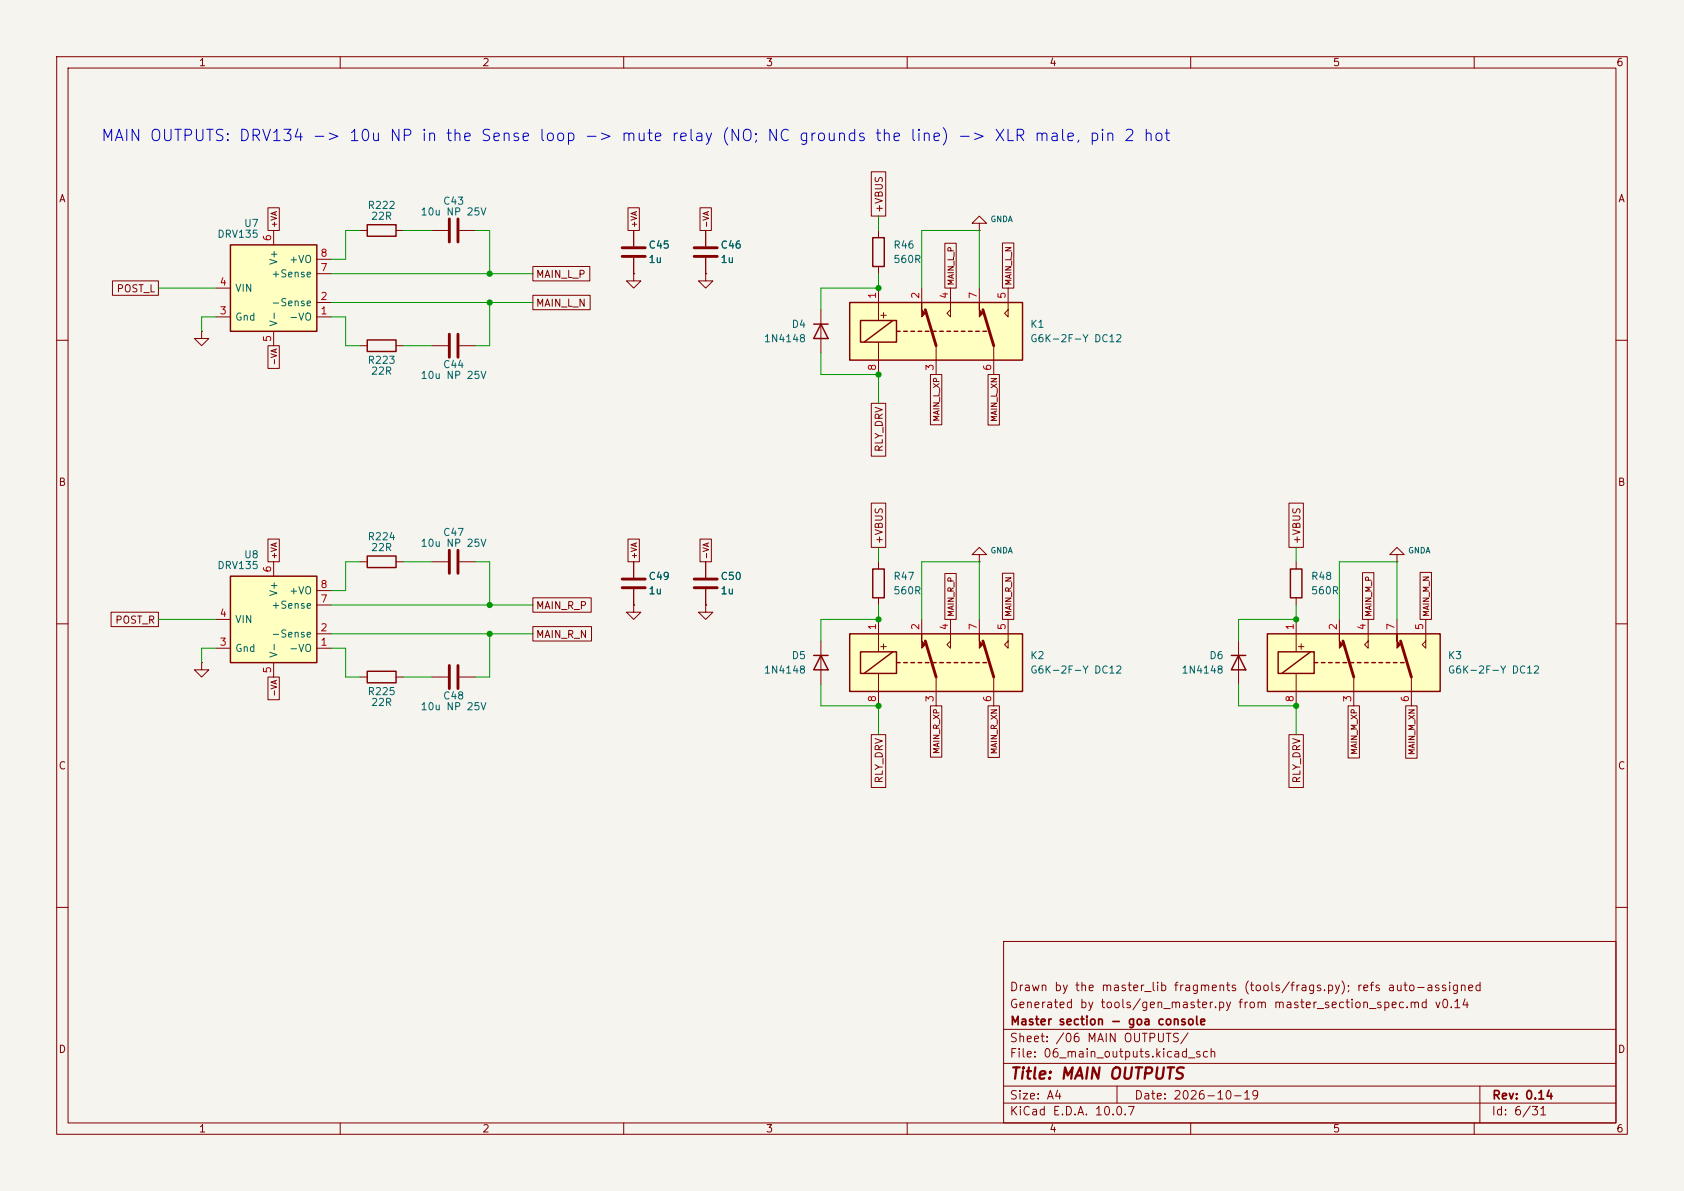
[picture p63: page 6]

MAIN OUTPUTS: DRV134 -> 10u NP in the Sense loop -> mute relay (NO; NC grounds the line) -> XLR male, pin 2 hot C49

Drawn by the master_lib fragments (tools/frags.py); refs auto-assigned
Generated by tools/gen_master.py from master_section_spec.md v0.14
Master section - goa console
Sheet: /06 MAIN OUTPUTS/
File: 06_main_outputs.kicad_sch
Title: MAIN OUTPUTS

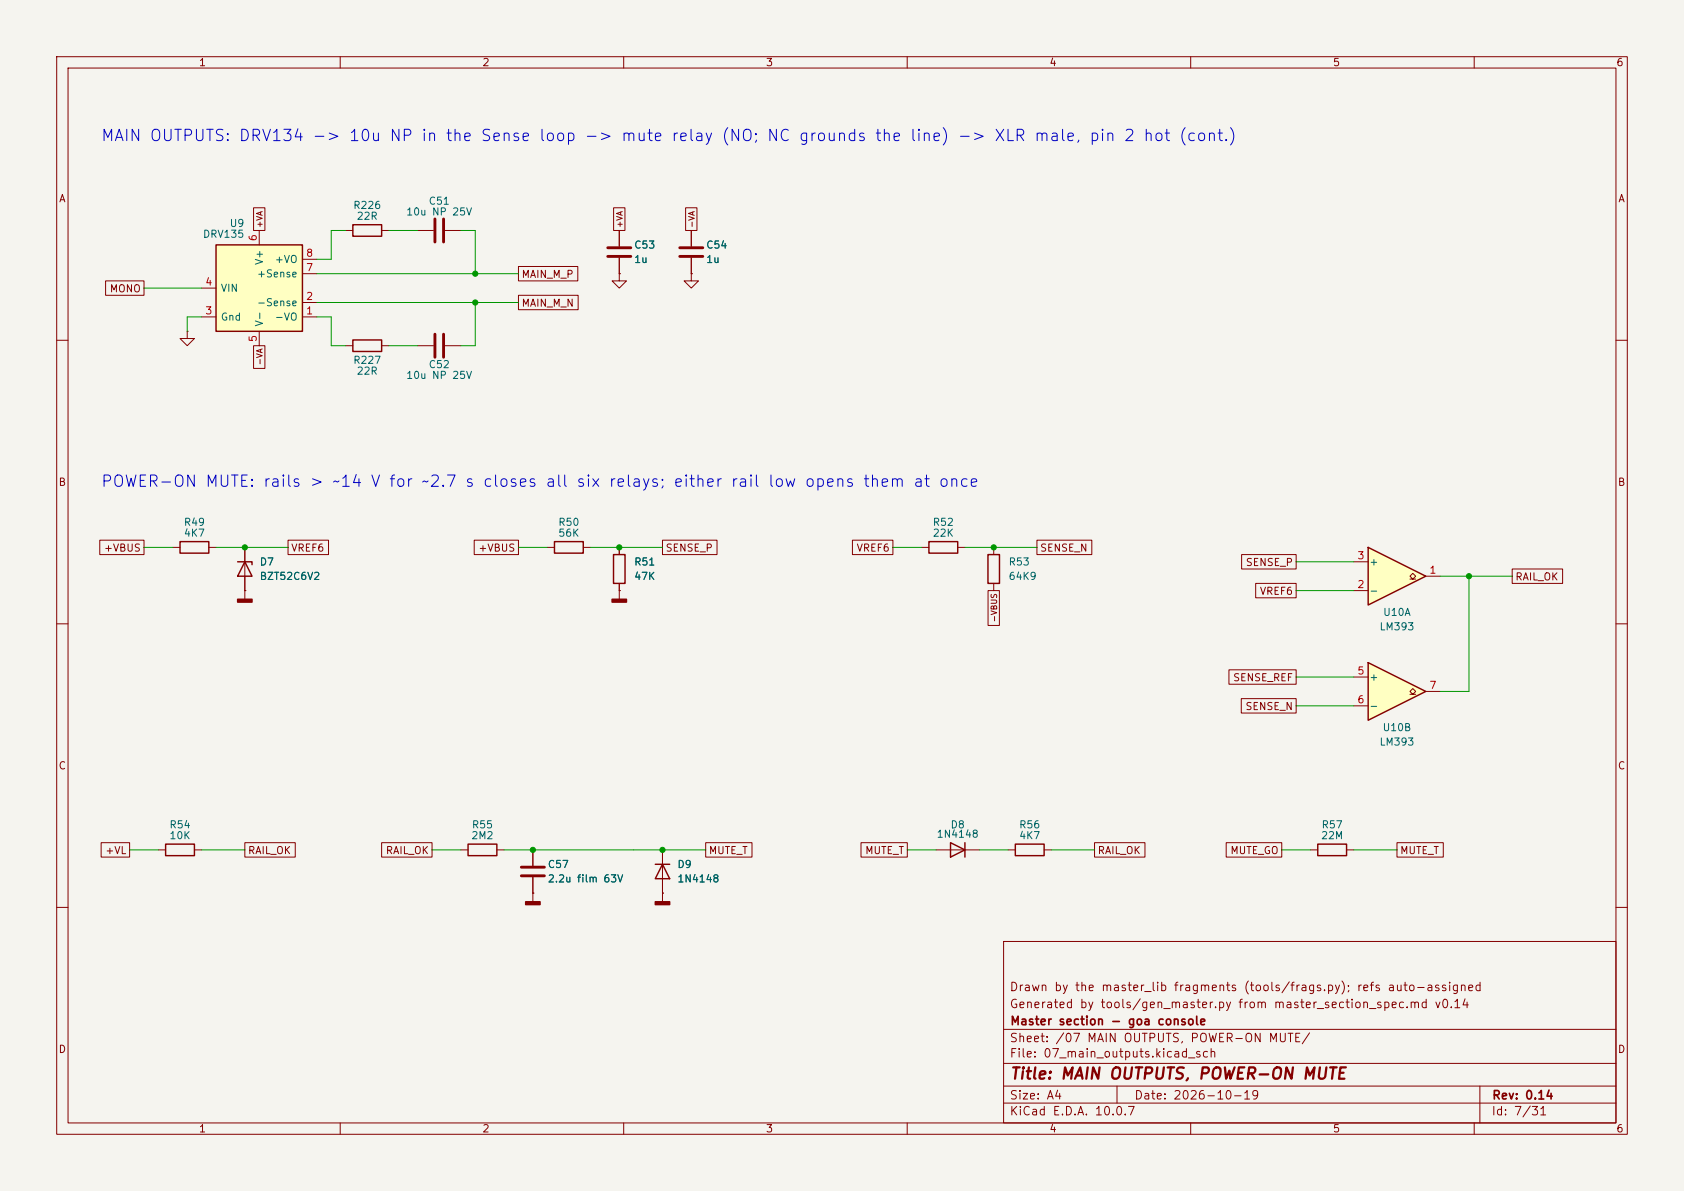
[picture p64: page 7]

POWER-ON MUTE: rails > ~14 V for ~2.7 s closes all six relays; either rail low opens them at once

Drawn by the master_lib fragments (tools/frags.py); refs auto-assigned
Generated by tools/gen_master.py from master_section_spec.md v0.14
Master section - goa console
Sheet: /07 MAIN OUTPUTS, POWER-ON MUTE/
File: 07_main_outputs.kicad_sch
Title: MAIN OUTPUTS, POWER-ON MUTE

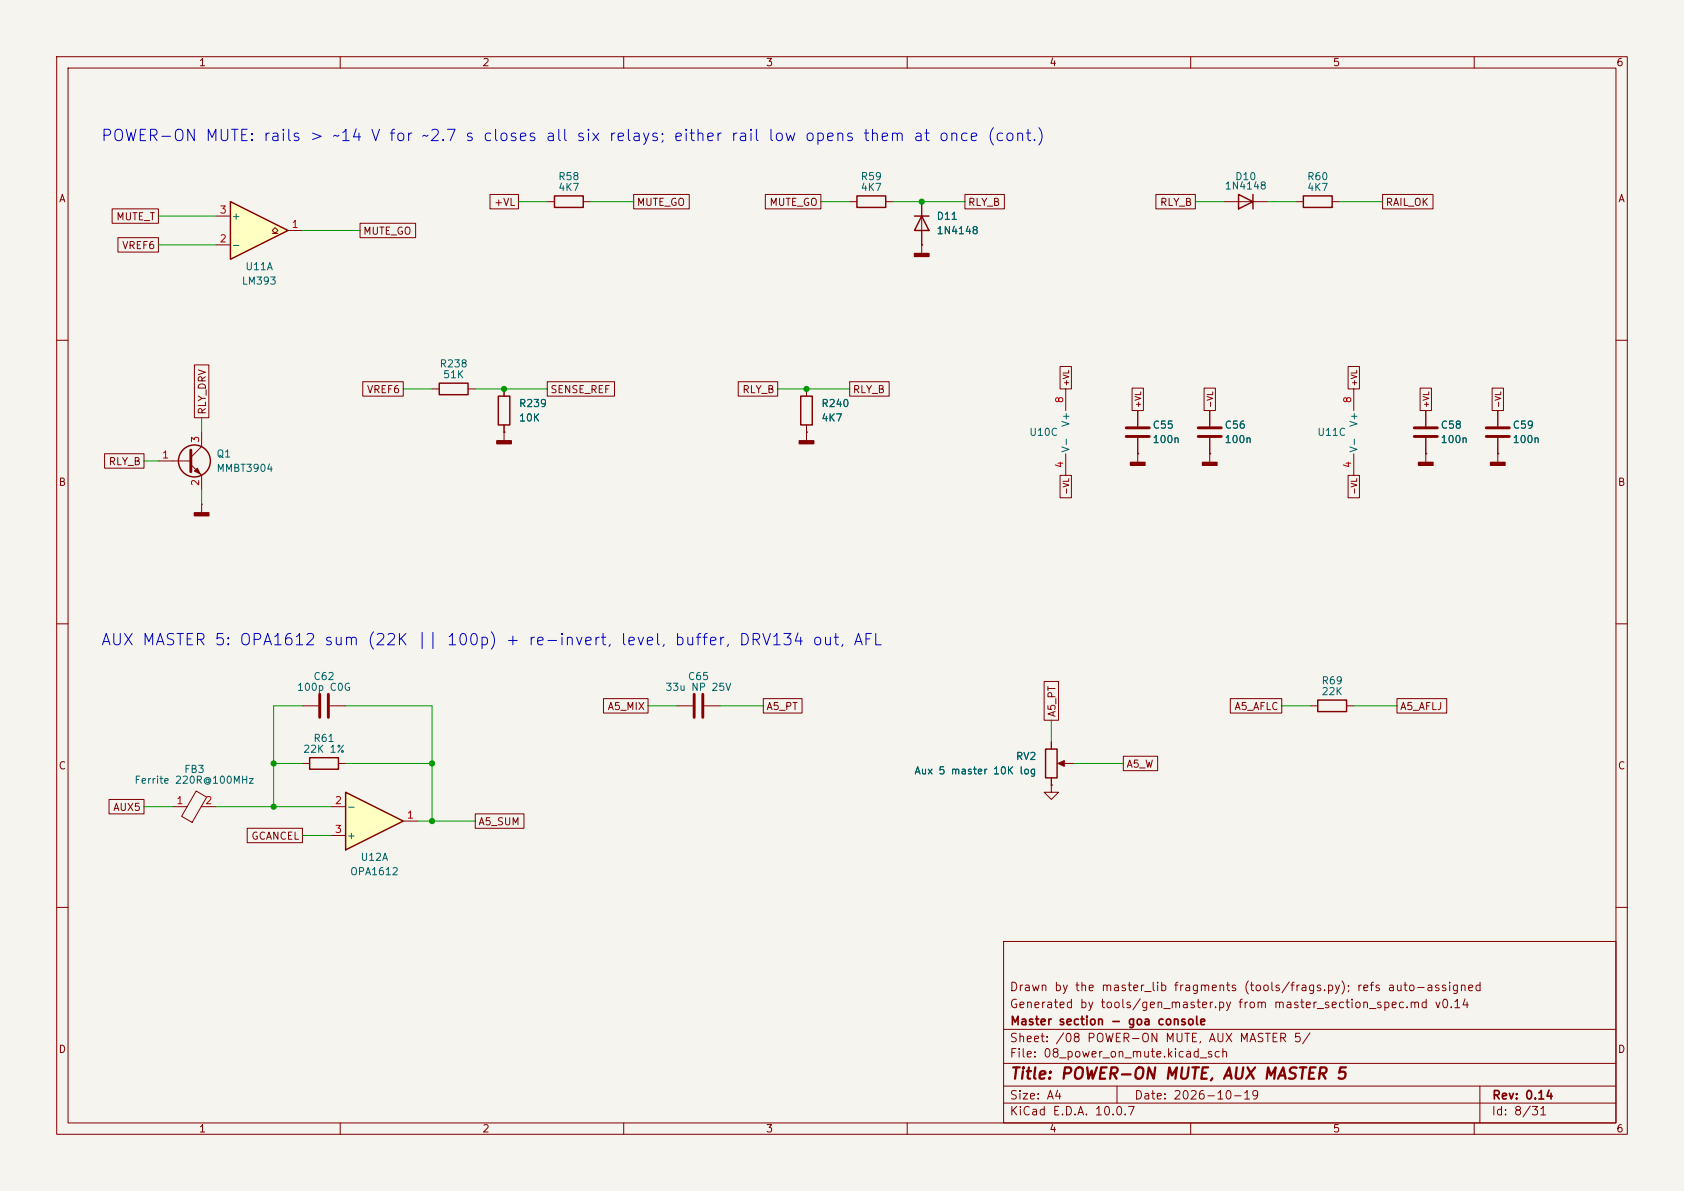
[picture p65: page 8]

POWER-ON MUTE: rails > ~14 V for ~2.7 s closes all six relays; either rail low opens them at once (cont.)

Drawn by the master_lib fragments (tools/frags.py); refs auto-assigned V-

AUX MASTER 5: OPA1612 sum (22K || 100p) + re-invert, level, buffer, DRV134 out, AFL

Generated by tools/gen_master.py from master_section_spec.md v0.14
Master section - goa console
Sheet: /08 POWER-ON MUTE, AUX MASTER 5/
File: 08_power_on_mute.kicad_sch
Title: POWER-ON MUTE, AUX MASTER 5

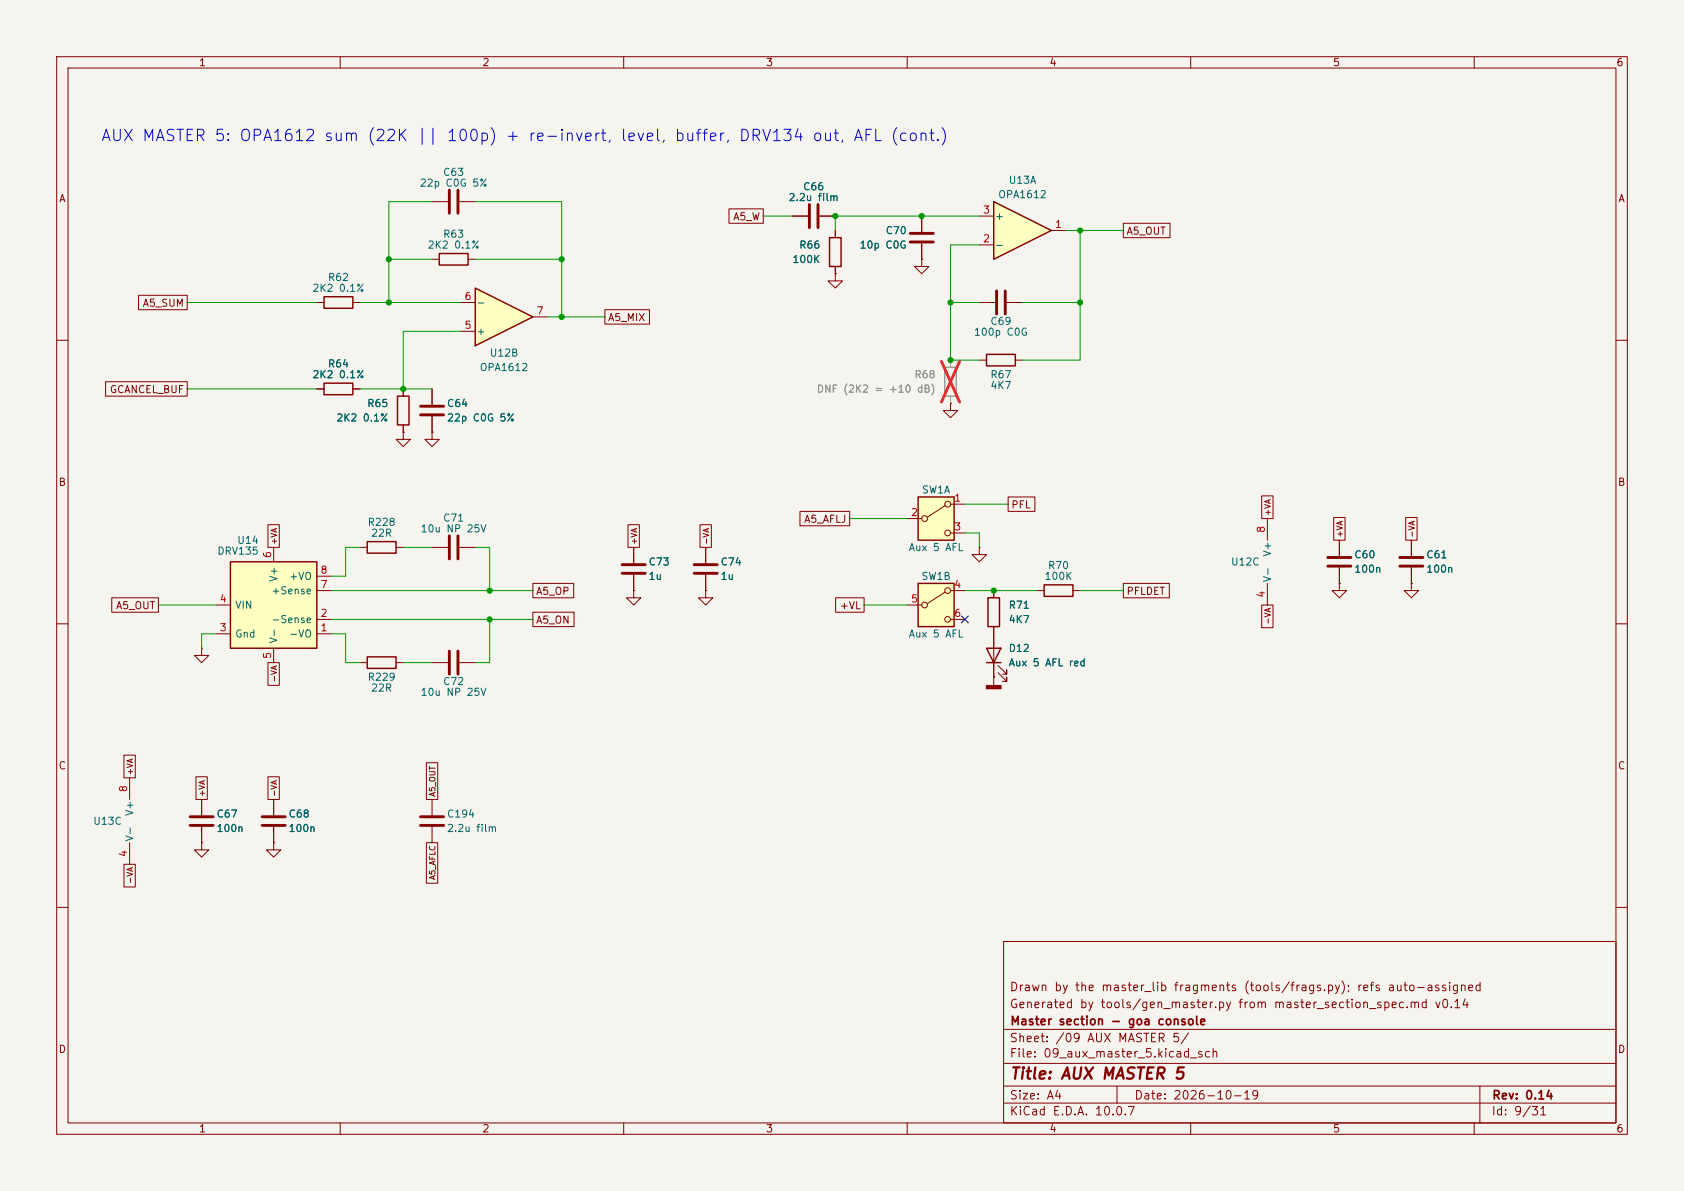
[picture p66: page 9]

AUX MASTER 5: OPA1612 sum (22K || 100p) + re-invert, level, buffer, DRV134 out, AFL (cont.)

Drawn by the master_lib fragments (tools/frags.py); refs auto-assigned
Generated by tools/gen_master.py from master_section_spec.md v0.14
Master section - goa console
Sheet: /09 AUX MASTER 5/
File: 09_aux_master_5.kicad_sch
Title: AUX MASTER 5

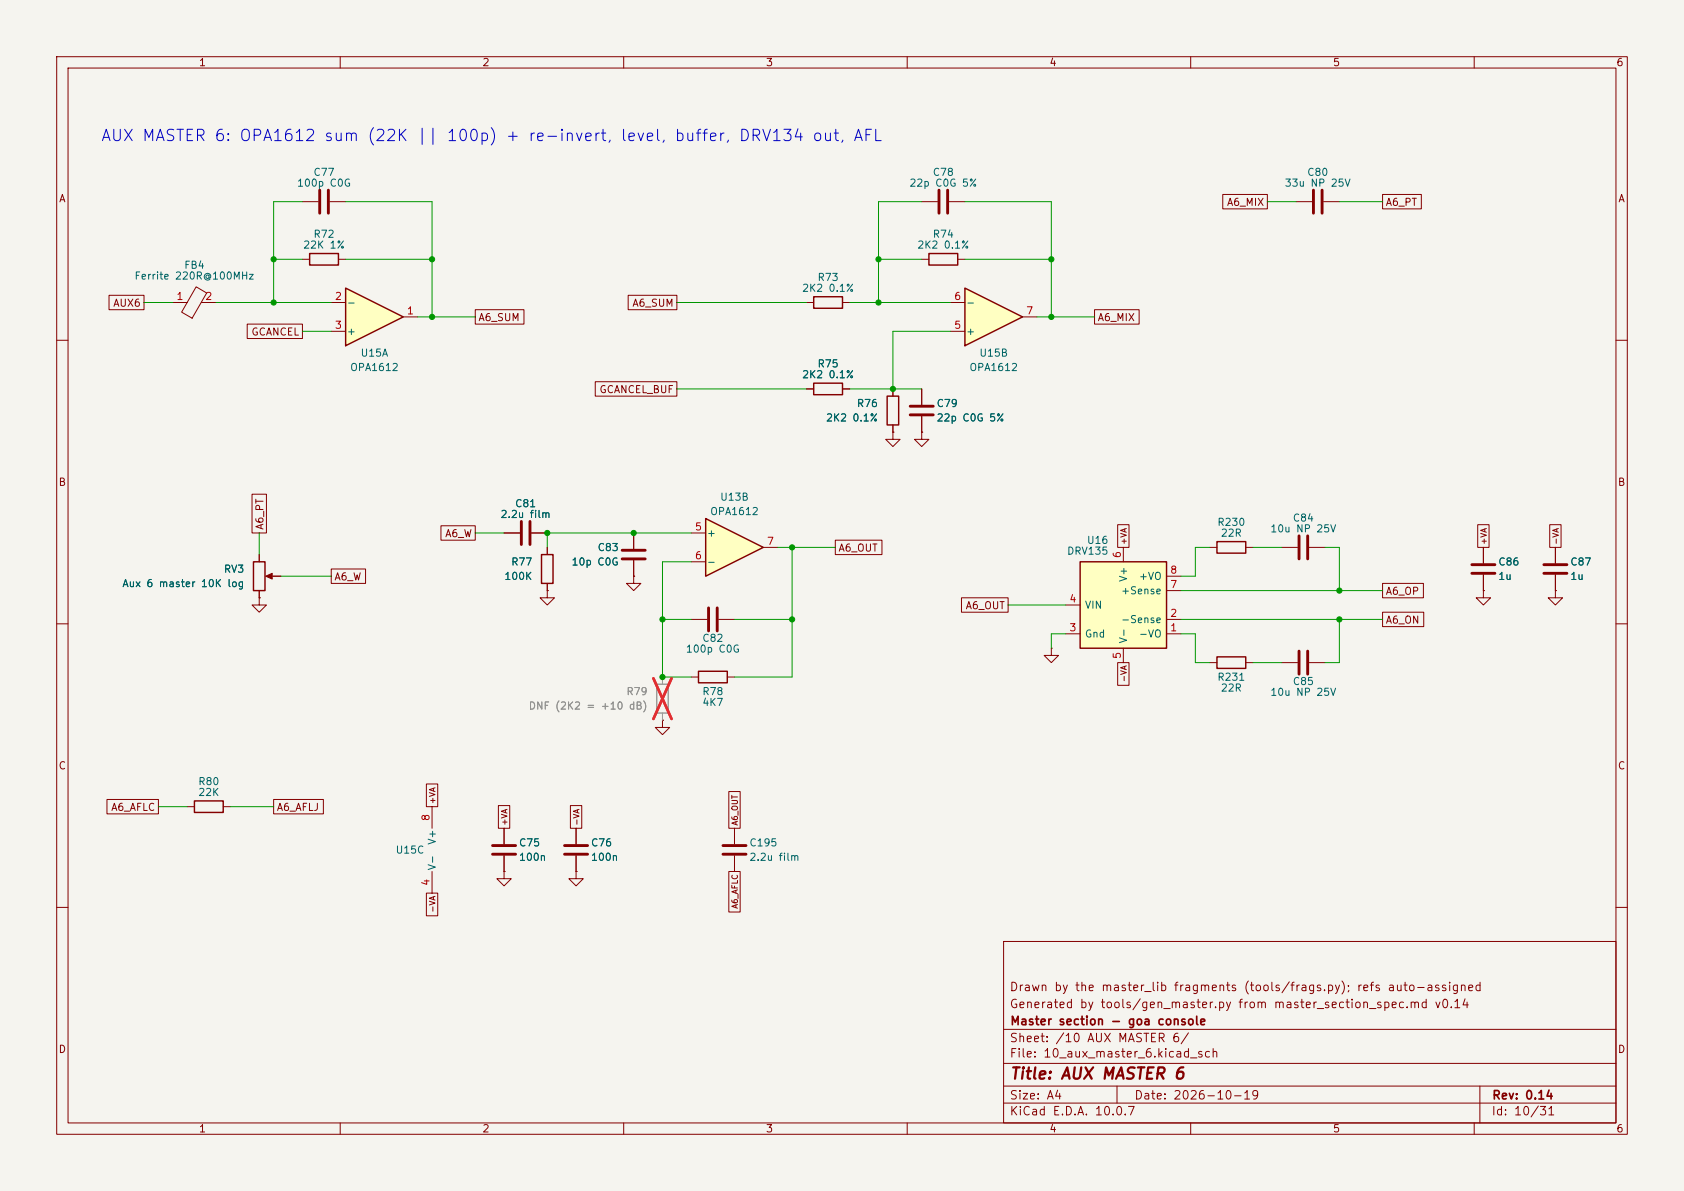
[picture p67: page 10]

A6_OUT AUX MASTER 6: OPA1612 sum (22K || 100p) + re-invert, level, buffer, DRV134 out, AFL
A6_W A6_PT AUX6

Drawn by the master_lib fragments (tools/frags.py); refs auto-assigned
Generated by tools/gen_master.py from master_section_spec.md v0.14
Master section - goa console
Sheet: /10 AUX MASTER 6/
File: 10_aux_master_6.kicad_sch
Title: AUX MASTER 6

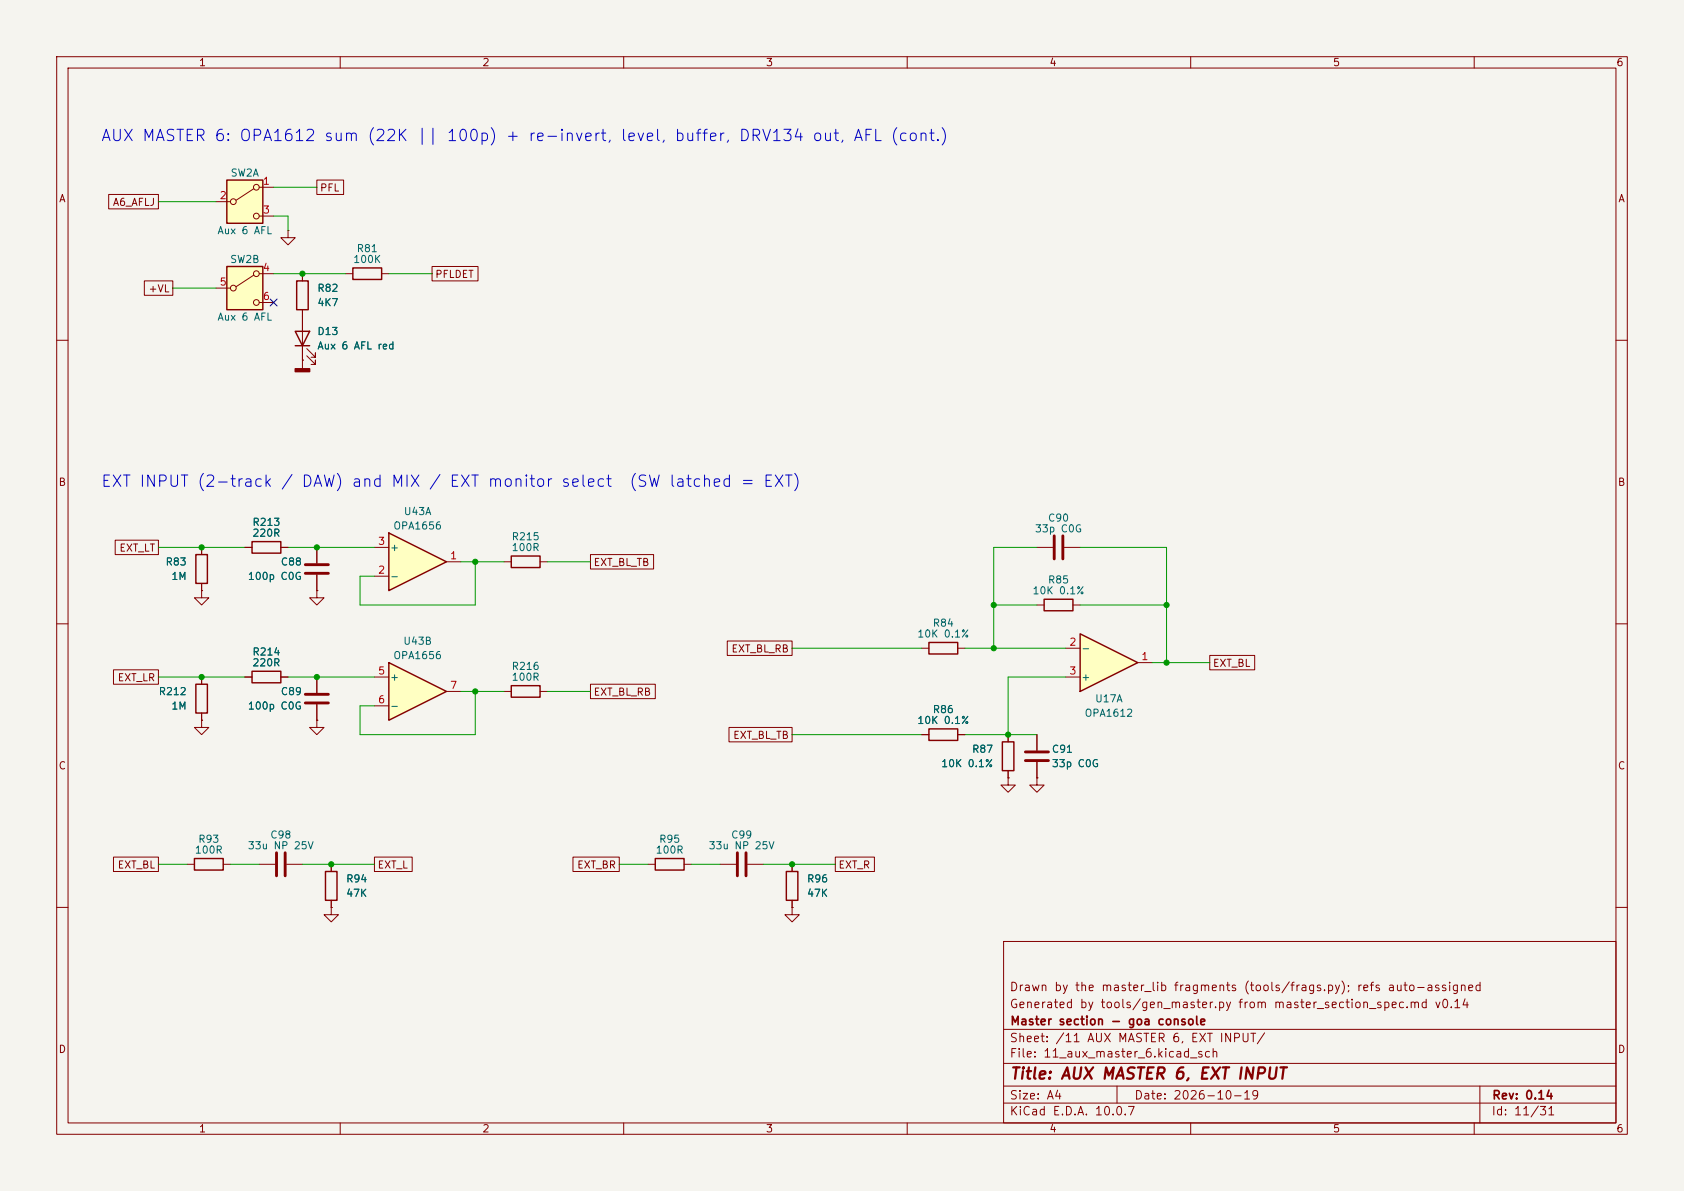
[picture p68: page 11]

AUX MASTER 6: OPA1612 sum (22K || 100p) + re-invert, level, buffer, DRV134 out, AFL (cont.)

EXT_BL_TB EXT INPUT (2-track / DAW) and MIX / EXT monitor select (SW latched = EXT)

Drawn by the master_lib fragments (tools/frags.py); refs auto-assigned
Generated by tools/gen_master.py from master_section_spec.md v0.14
Master section - goa console
Sheet: /11 AUX MASTER 6, EXT INPUT/
File: 11_aux_master_6.kicad_sch
Title: AUX MASTER 6, EXT INPUT

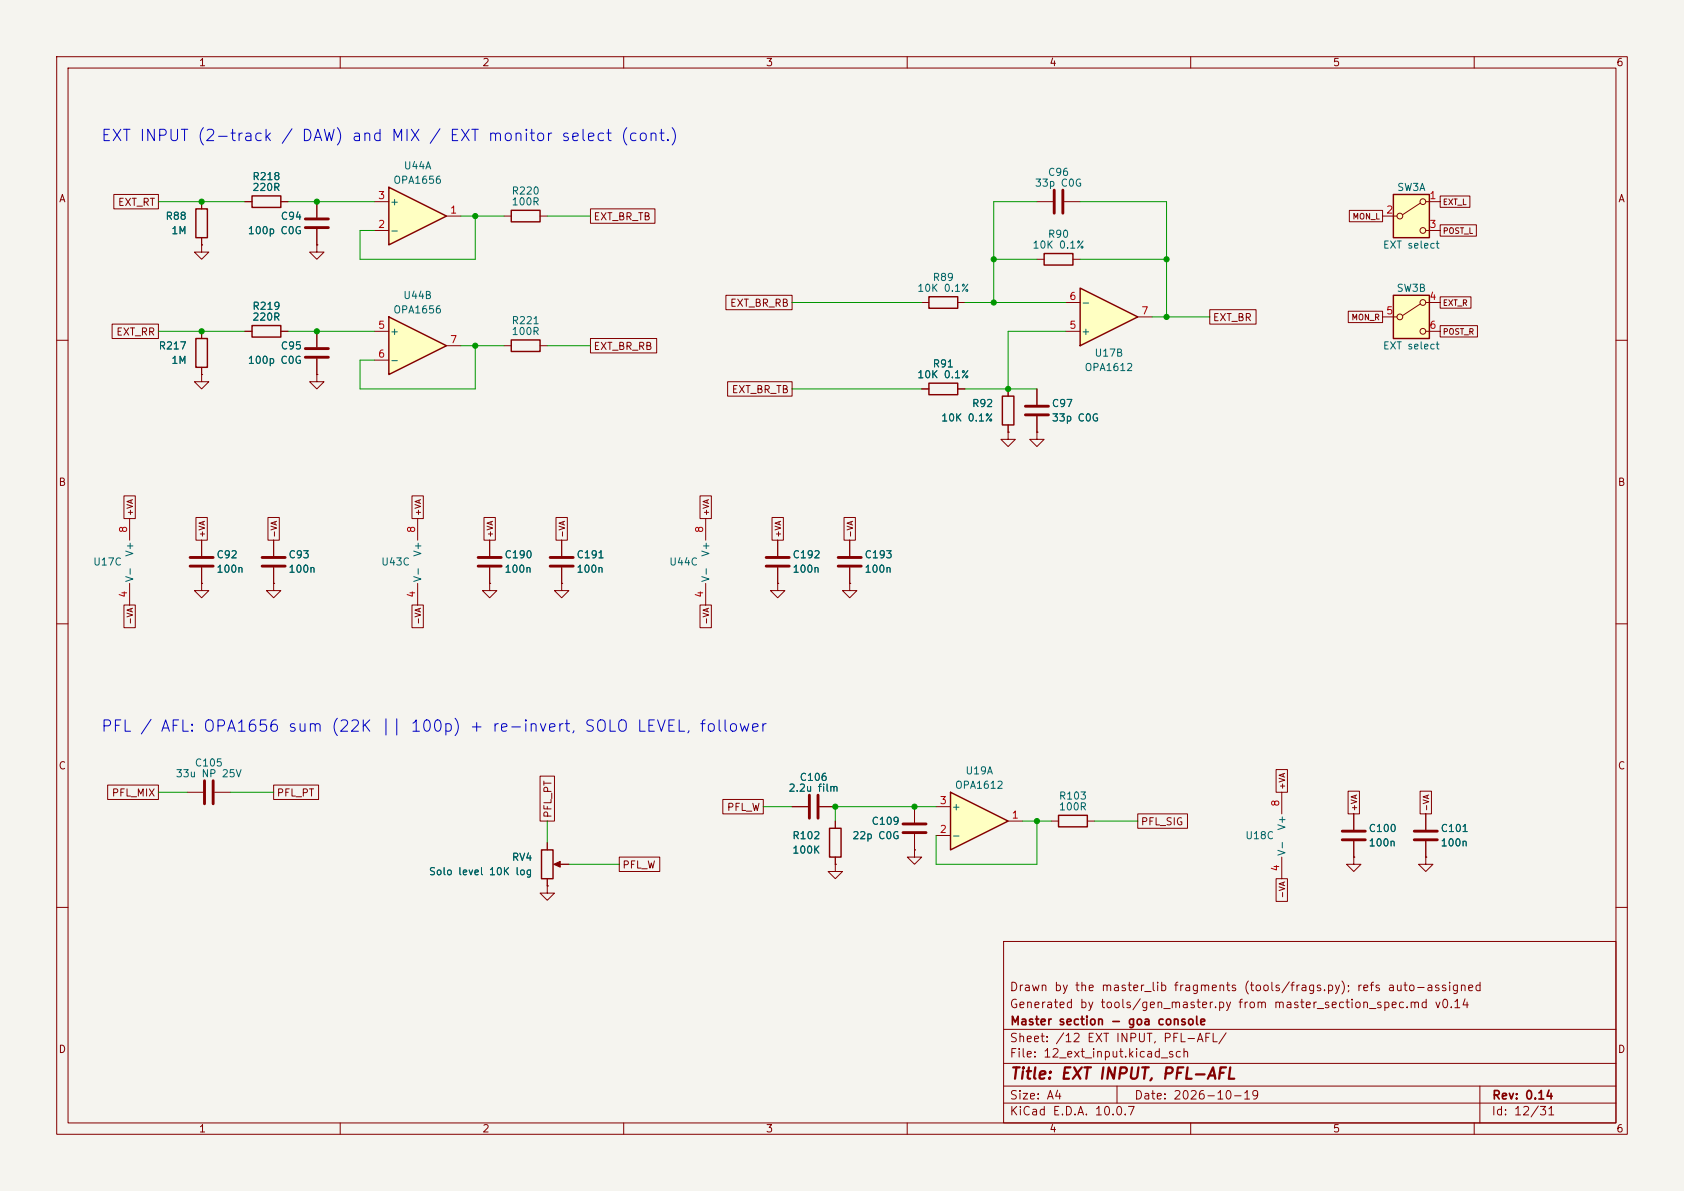
[picture p69: page 12]

EXT INPUT (2-track / DAW) and MIX / EXT monitor select (cont.)

PFL / AFL: OPA1656 sum (22K || 100p) + re-invert, SOLO LEVEL, follower

Drawn by the master_lib fragments (tools/frags.py); refs auto-assigned
Generated by tools/gen_master.py from master_section_spec.md v0.14
Master section - goa console
Sheet: /12 EXT INPUT, PFL-AFL/
File: 12_ext_input.kicad_sch
Title: EXT INPUT, PFL-AFL

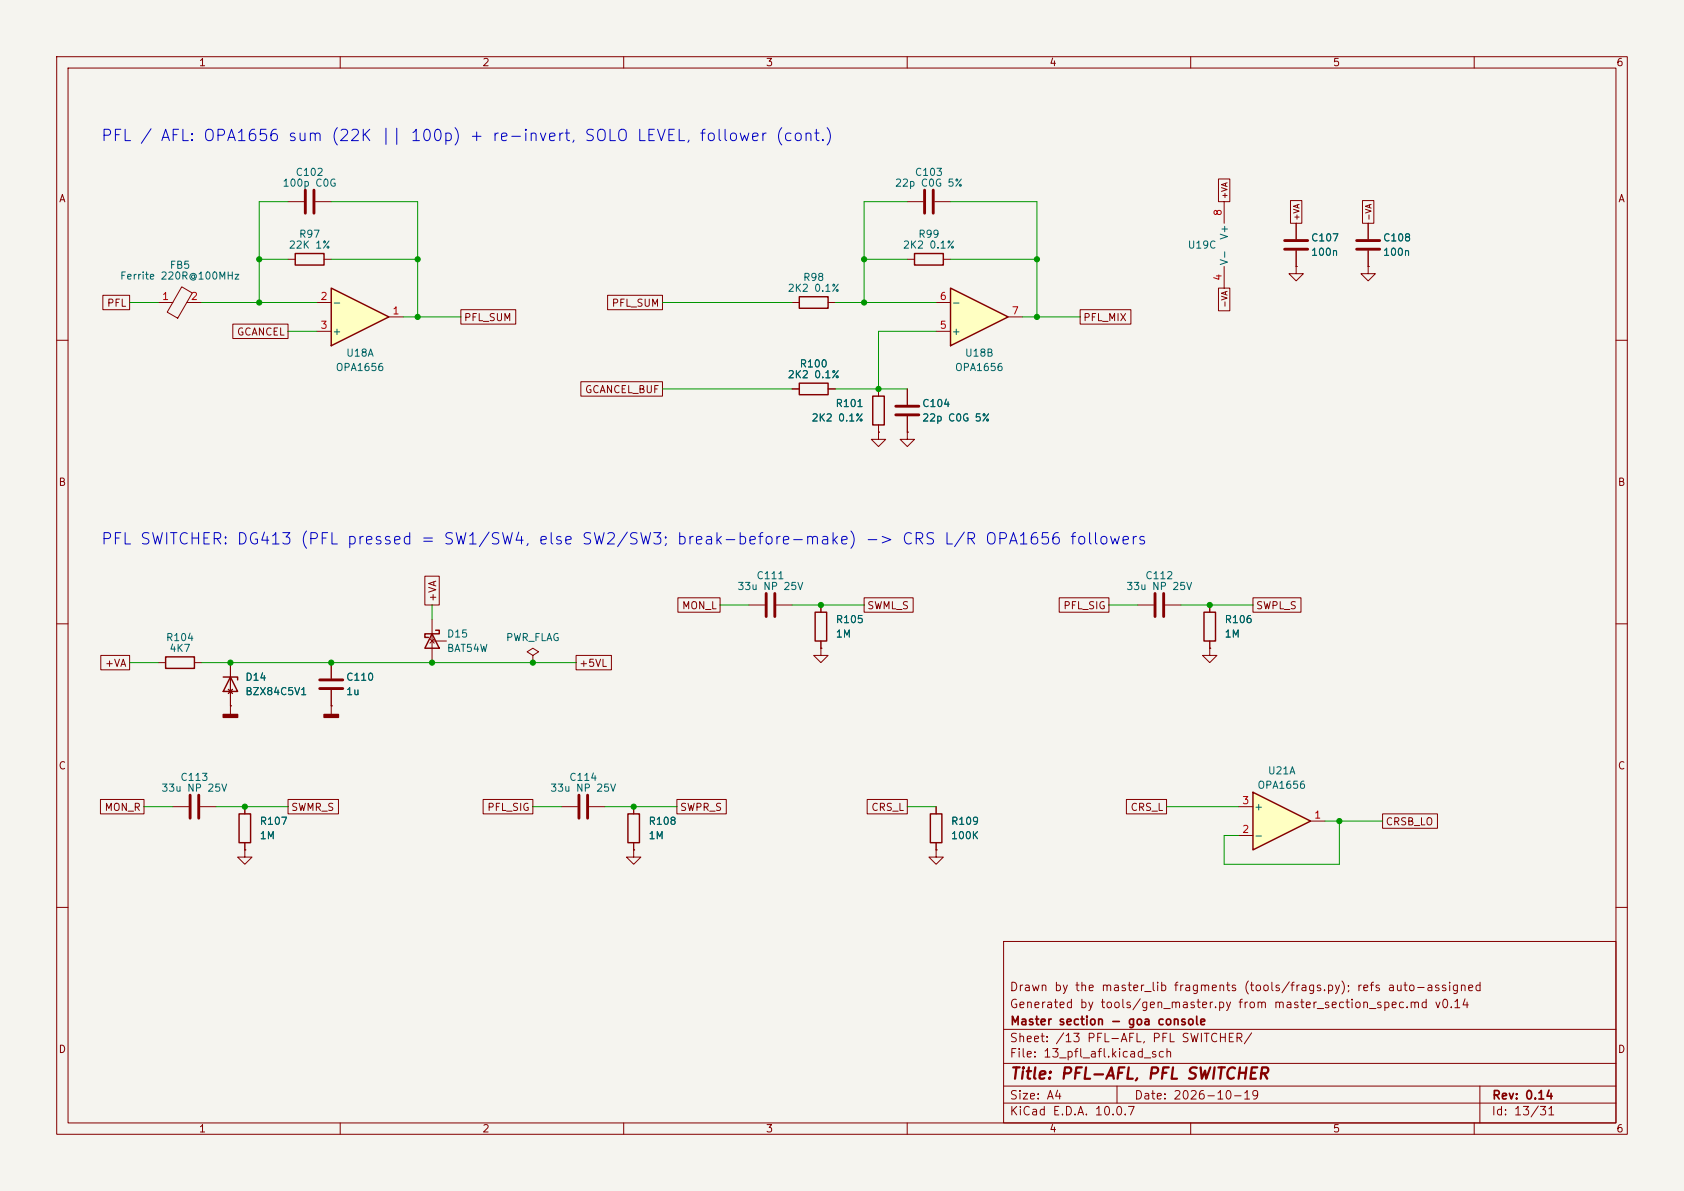
[picture p70: page 13]

PFL / AFL: OPA1656 sum (22K || 100p) + re-invert, SOLO LEVEL, follower (cont.)

Drawn by the master_lib fragments (tools/frags.py); refs auto-assigned
Generated by tools/gen_master.py from master_section_spec.md v0.14
Master section - goa console
Sheet: /13 PFL-AFL, PFL SWITCHER/
File: 13_pfl_afl.kicad_sch
Title: PFL-AFL, PFL SWITCHER

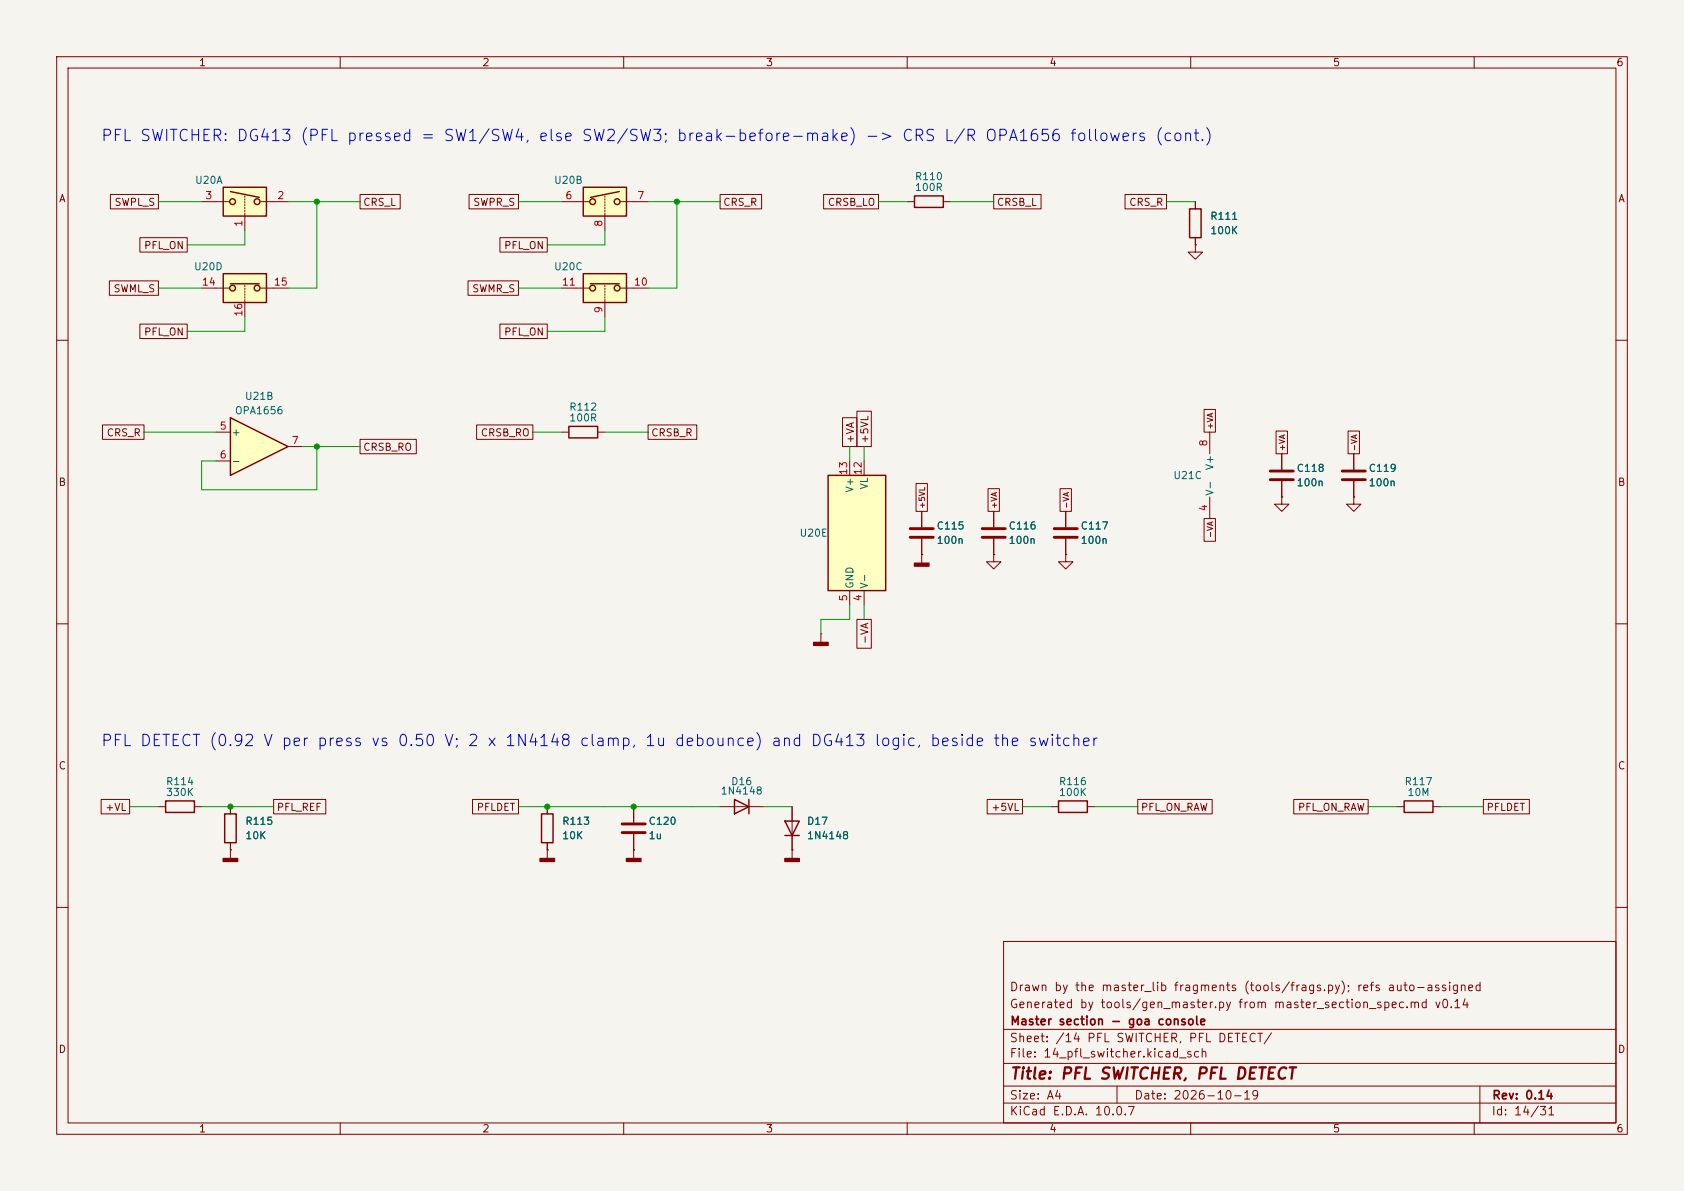
[picture p71: page 14]

CRSB_R PFL SWITCHER: DG413 (PFL pressed = SW1/SW4, else SW2/SW3; break-before-make) -> CRS L/R OPA1656 followers (cont.)

PFL DETECT (0.92 V per press vs 0.50 V; 2 x 1N4148 clamp, 1u debounce) and DG413 logic, beside the switcher D17

Drawn by the master_lib fragments (tools/frags.py); refs auto-assigned
Generated by tools/gen_master.py from master_section_spec.md v0.14
Master section - goa console
Sheet: /14 PFL SWITCHER, PFL DETECT/
File: 14_pfl_switcher.kicad_sch
Title: PFL SWITCHER, PFL DETECT

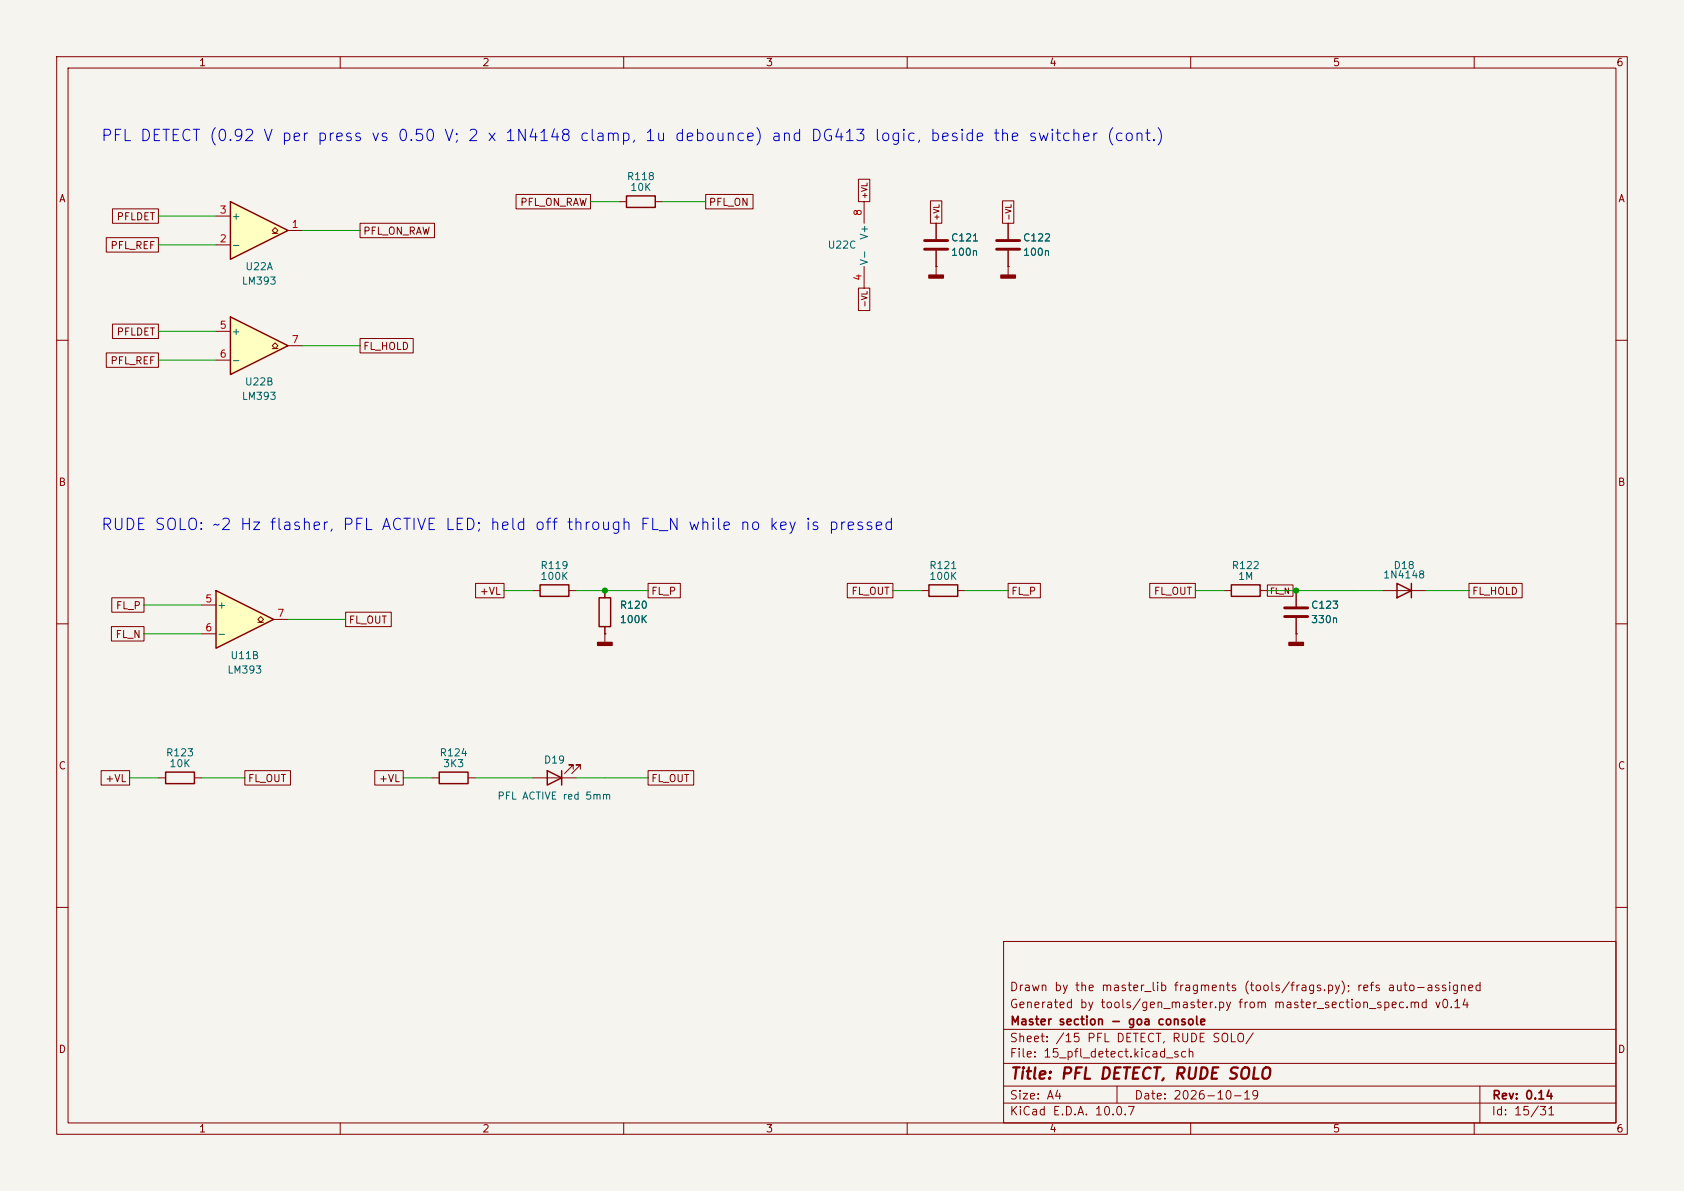
[picture p72: page 15]

PFL DETECT (0.92 V per press vs 0.50 V; 2 x 1N4148 clamp, 1u debounce) and DG413 logic, beside the switcher (cont.)

Drawn by the master_lib fragments (tools/frags.py); refs auto-assigned
Generated by tools/gen_master.py from master_section_spec.md v0.14
Master section - goa console
Sheet: /15 PFL DETECT, RUDE SOLO/
File: 15_pfl_detect.kicad_sch
Title: PFL DETECT, RUDE SOLO

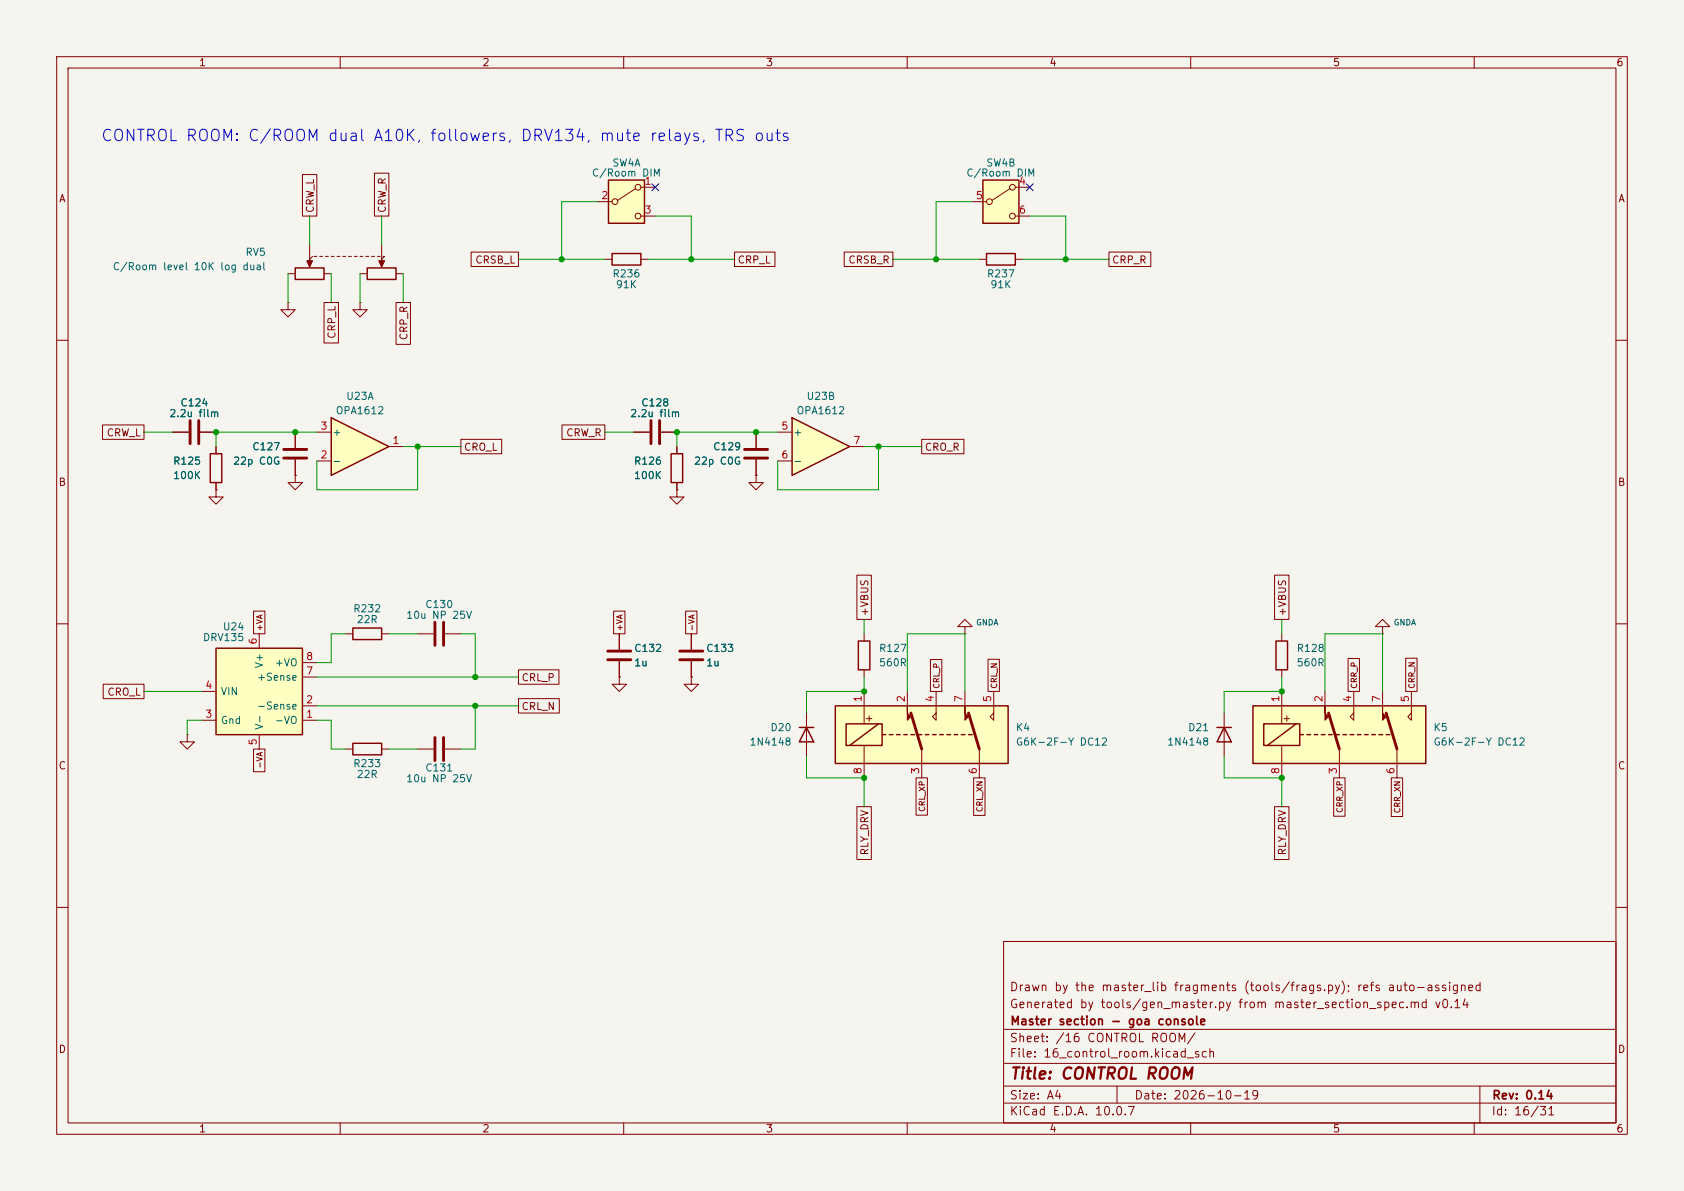
[picture p73: page 16]

CONTROL ROOM: C/ROOM dual A10K, followers, DRV134, mute relays, TRS outs

Drawn by the master_lib fragments (tools/frags.py); refs auto-assigned
Generated by tools/gen_master.py from master_section_spec.md v0.14
Master section - goa console
Sheet: /16 CONTROL ROOM/
File: 16_control_room.kicad_sch
Title: CONTROL ROOM

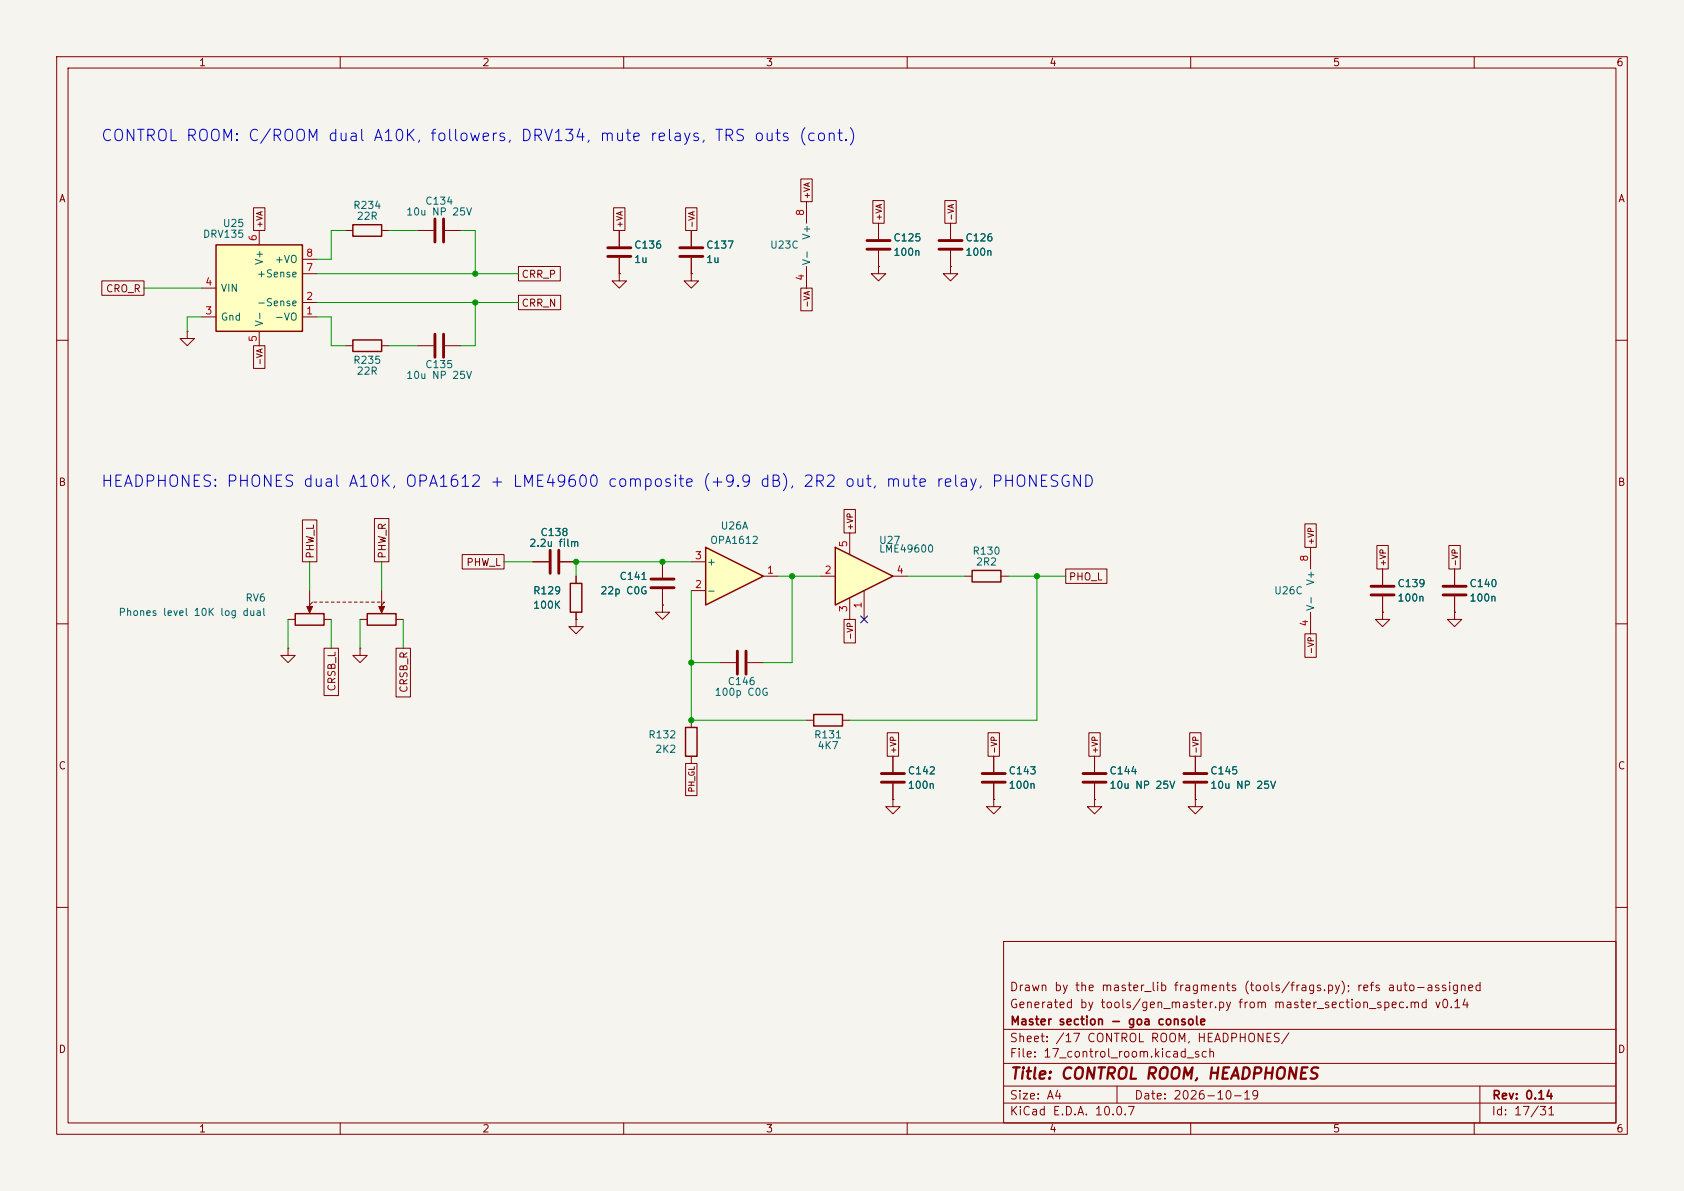
[picture p74: page 17]

CONTROL ROOM: C/ROOM dual A10K, followers, DRV134, mute relays, TRS outs (cont.)

HEADPHONES: PHONES dual A10K, OPA1612 + LME49600 composite (+9.9 dB), 2R2 out, mute relay, PHONESGND

Drawn by the master_lib fragments (tools/frags.py); refs auto-assigned
Generated by tools/gen_master.py from master_section_spec.md v0.14
Master section - goa console
Sheet: /17 CONTROL ROOM, HEADPHONES/
File: 17_control_room.kicad_sch
Title: CONTROL ROOM, HEADPHONES

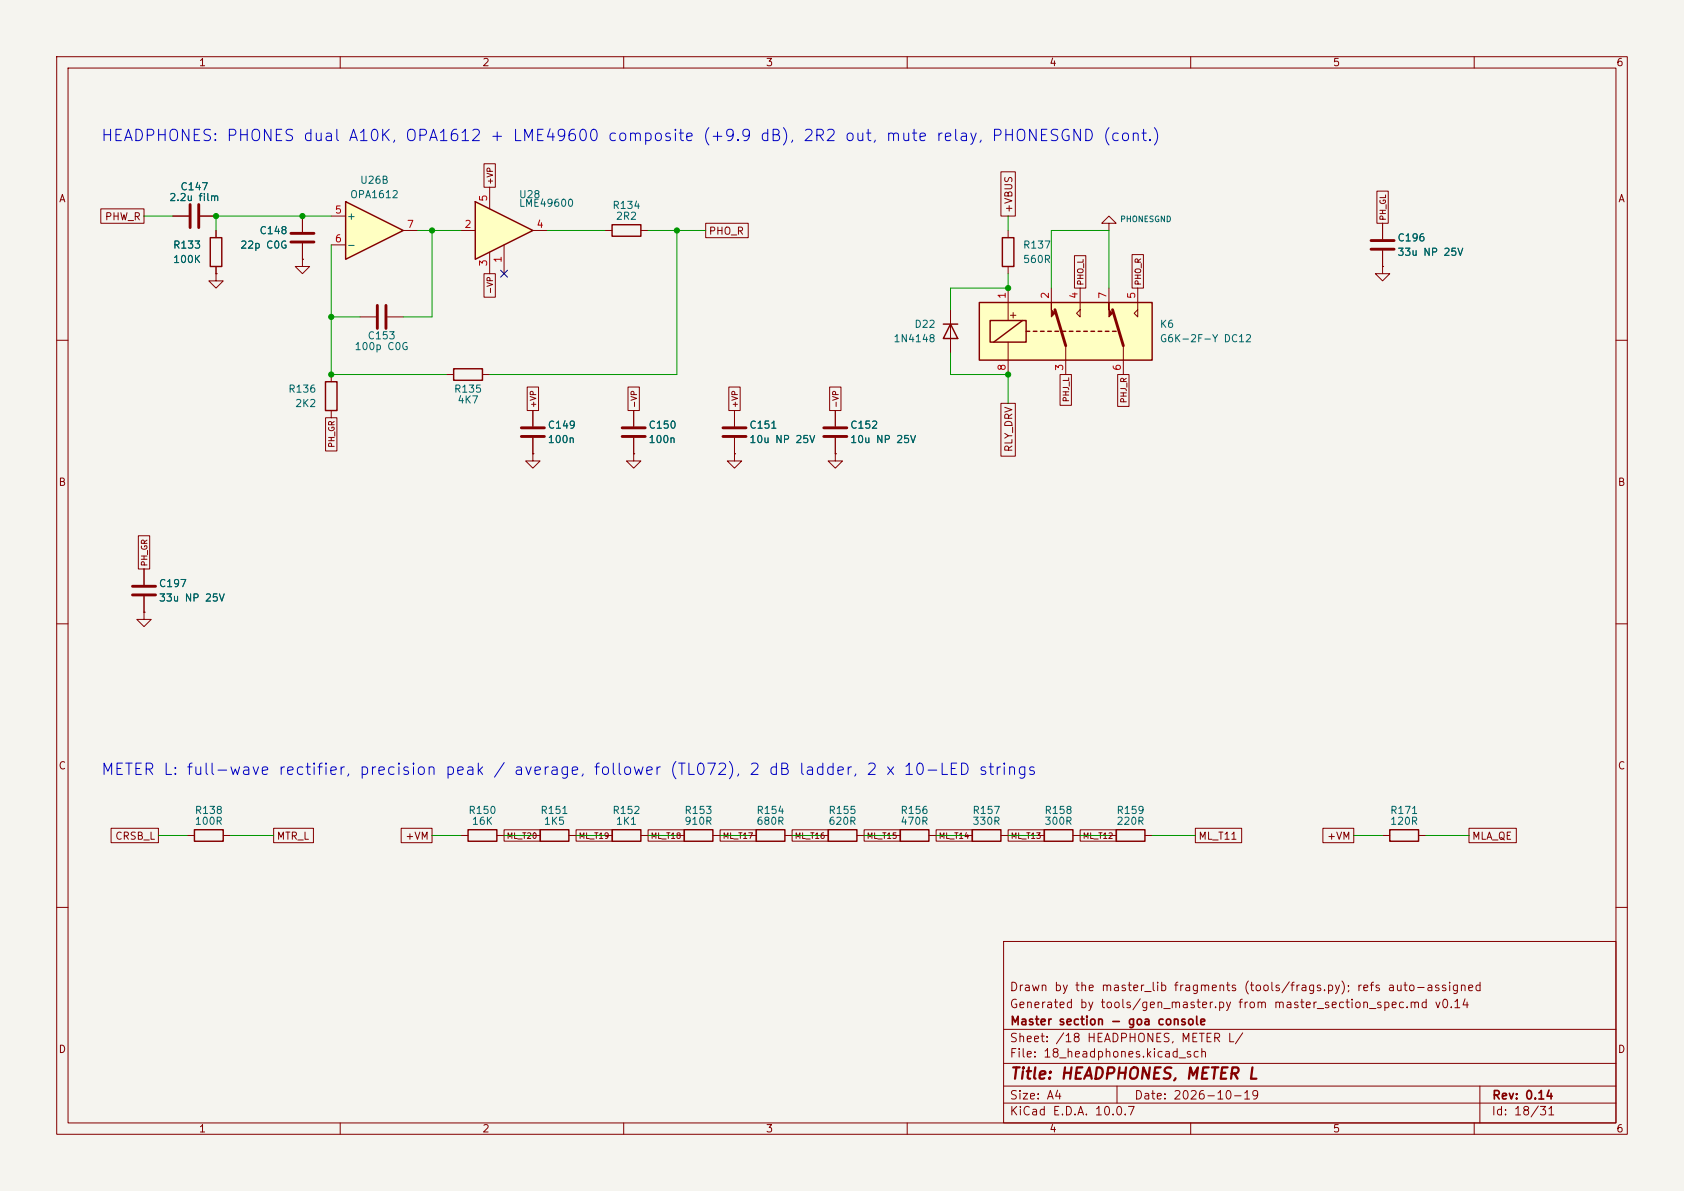
[picture p75: page 18]

HEADPHONES: PHONES dual A10K, OPA1612 + LME49600 composite (+9.9 dB), 2R2 out, mute relay, PHONESGND (cont.)
2.2u film

METER L: full-wave rectifier, precision peak / average, follower (TL072), 2 dB ladder, 2 x 10-LED strings

Drawn by the master_lib fragments (tools/frags.py); refs auto-assigned
Generated by tools/gen_master.py from master_section_spec.md v0.14
Master section - goa console
Sheet: /18 HEADPHONES, METER L/
File: 18_headphones.kicad_sch
Title: HEADPHONES, METER L

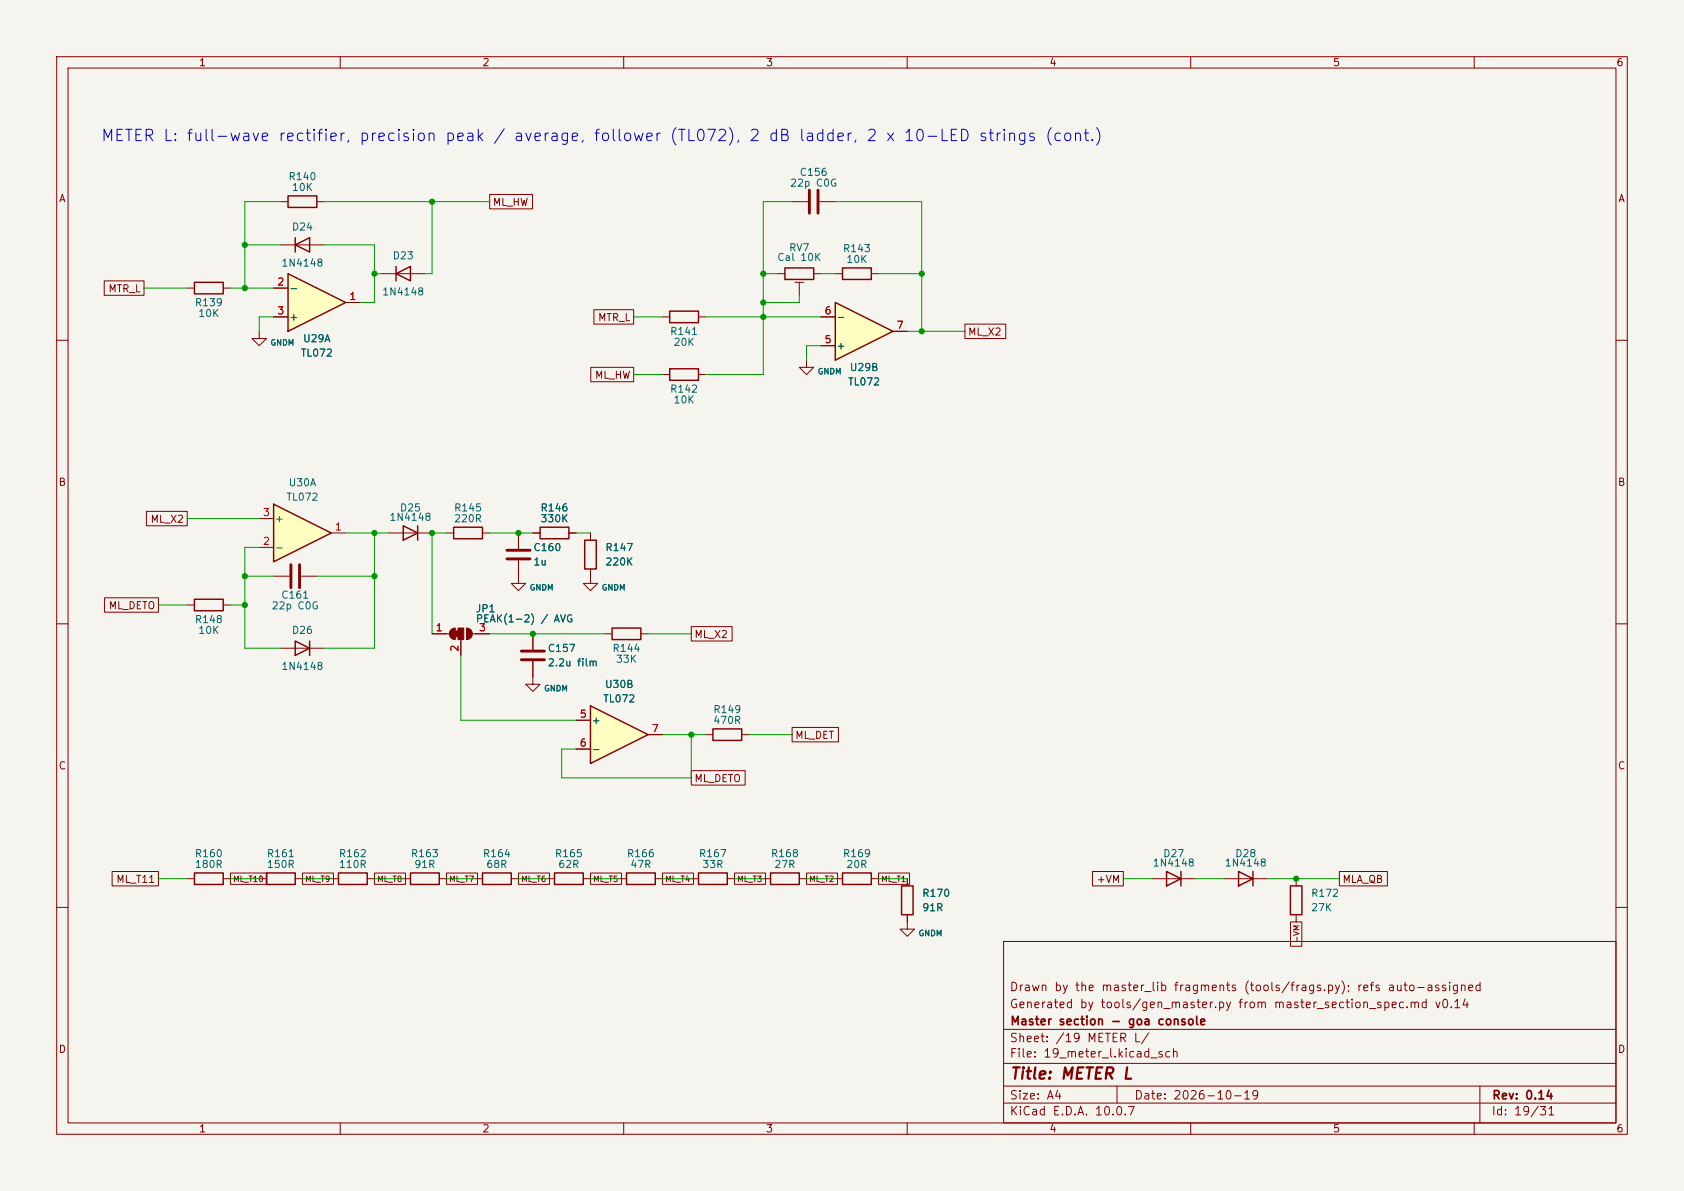
[picture p76: page 19]

MTR_L METER L: full-wave rectifier, precision peak / average, follower (TL072), 2 dB ladder, 2 x 10-LED strings (cont.)

Drawn by the master_lib fragments (tools/frags.py); refs auto-assigned
Generated by tools/gen_master.py from master_section_spec.md v0.14
Master section - goa console
Sheet: /19 METER L/
File: 19_meter_l.kicad_sch
Title: METER L

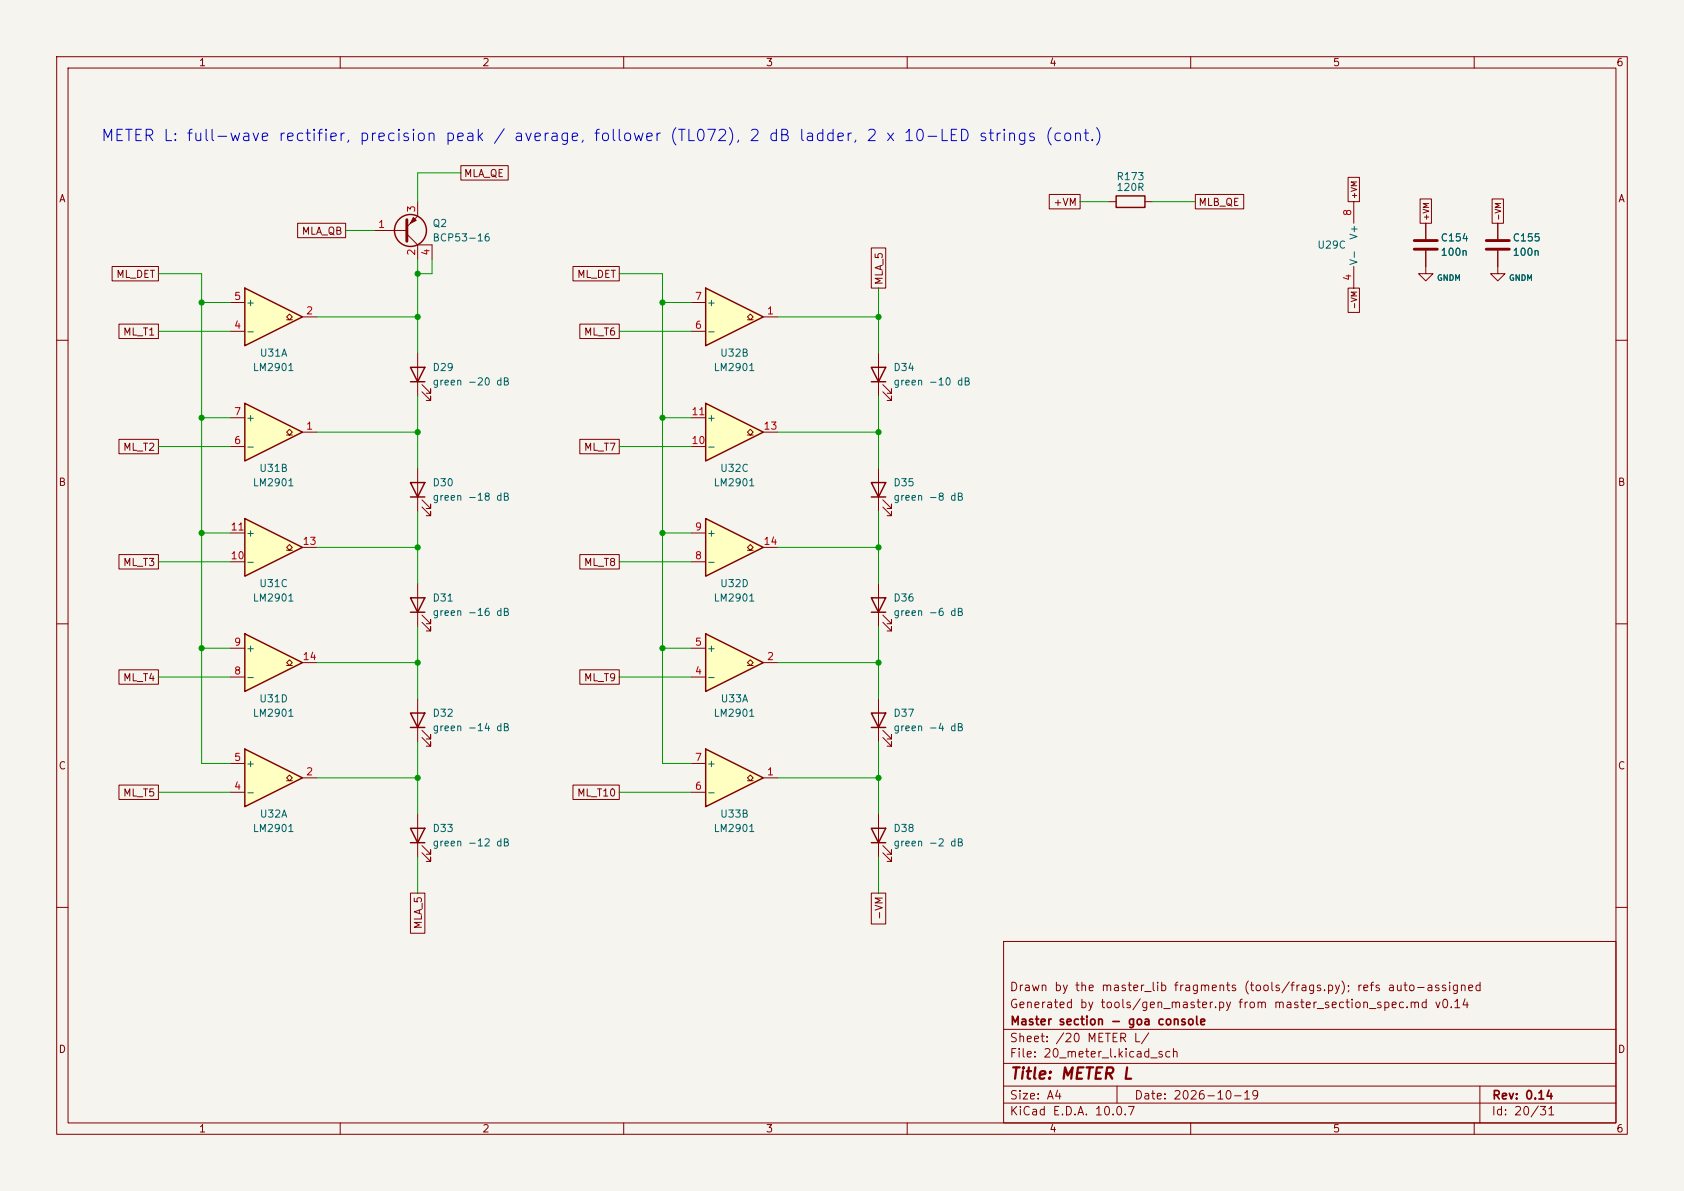
[picture p77: page 20]

Drawn by the master_lib fragments (tools/frags.py); refs auto-assigned
Generated by tools/gen_master.py from master_section_spec.md v0.14
Master section - goa console
Sheet: /20 METER L/
File: 20_meter_l.kicad_sch
Title: METER L

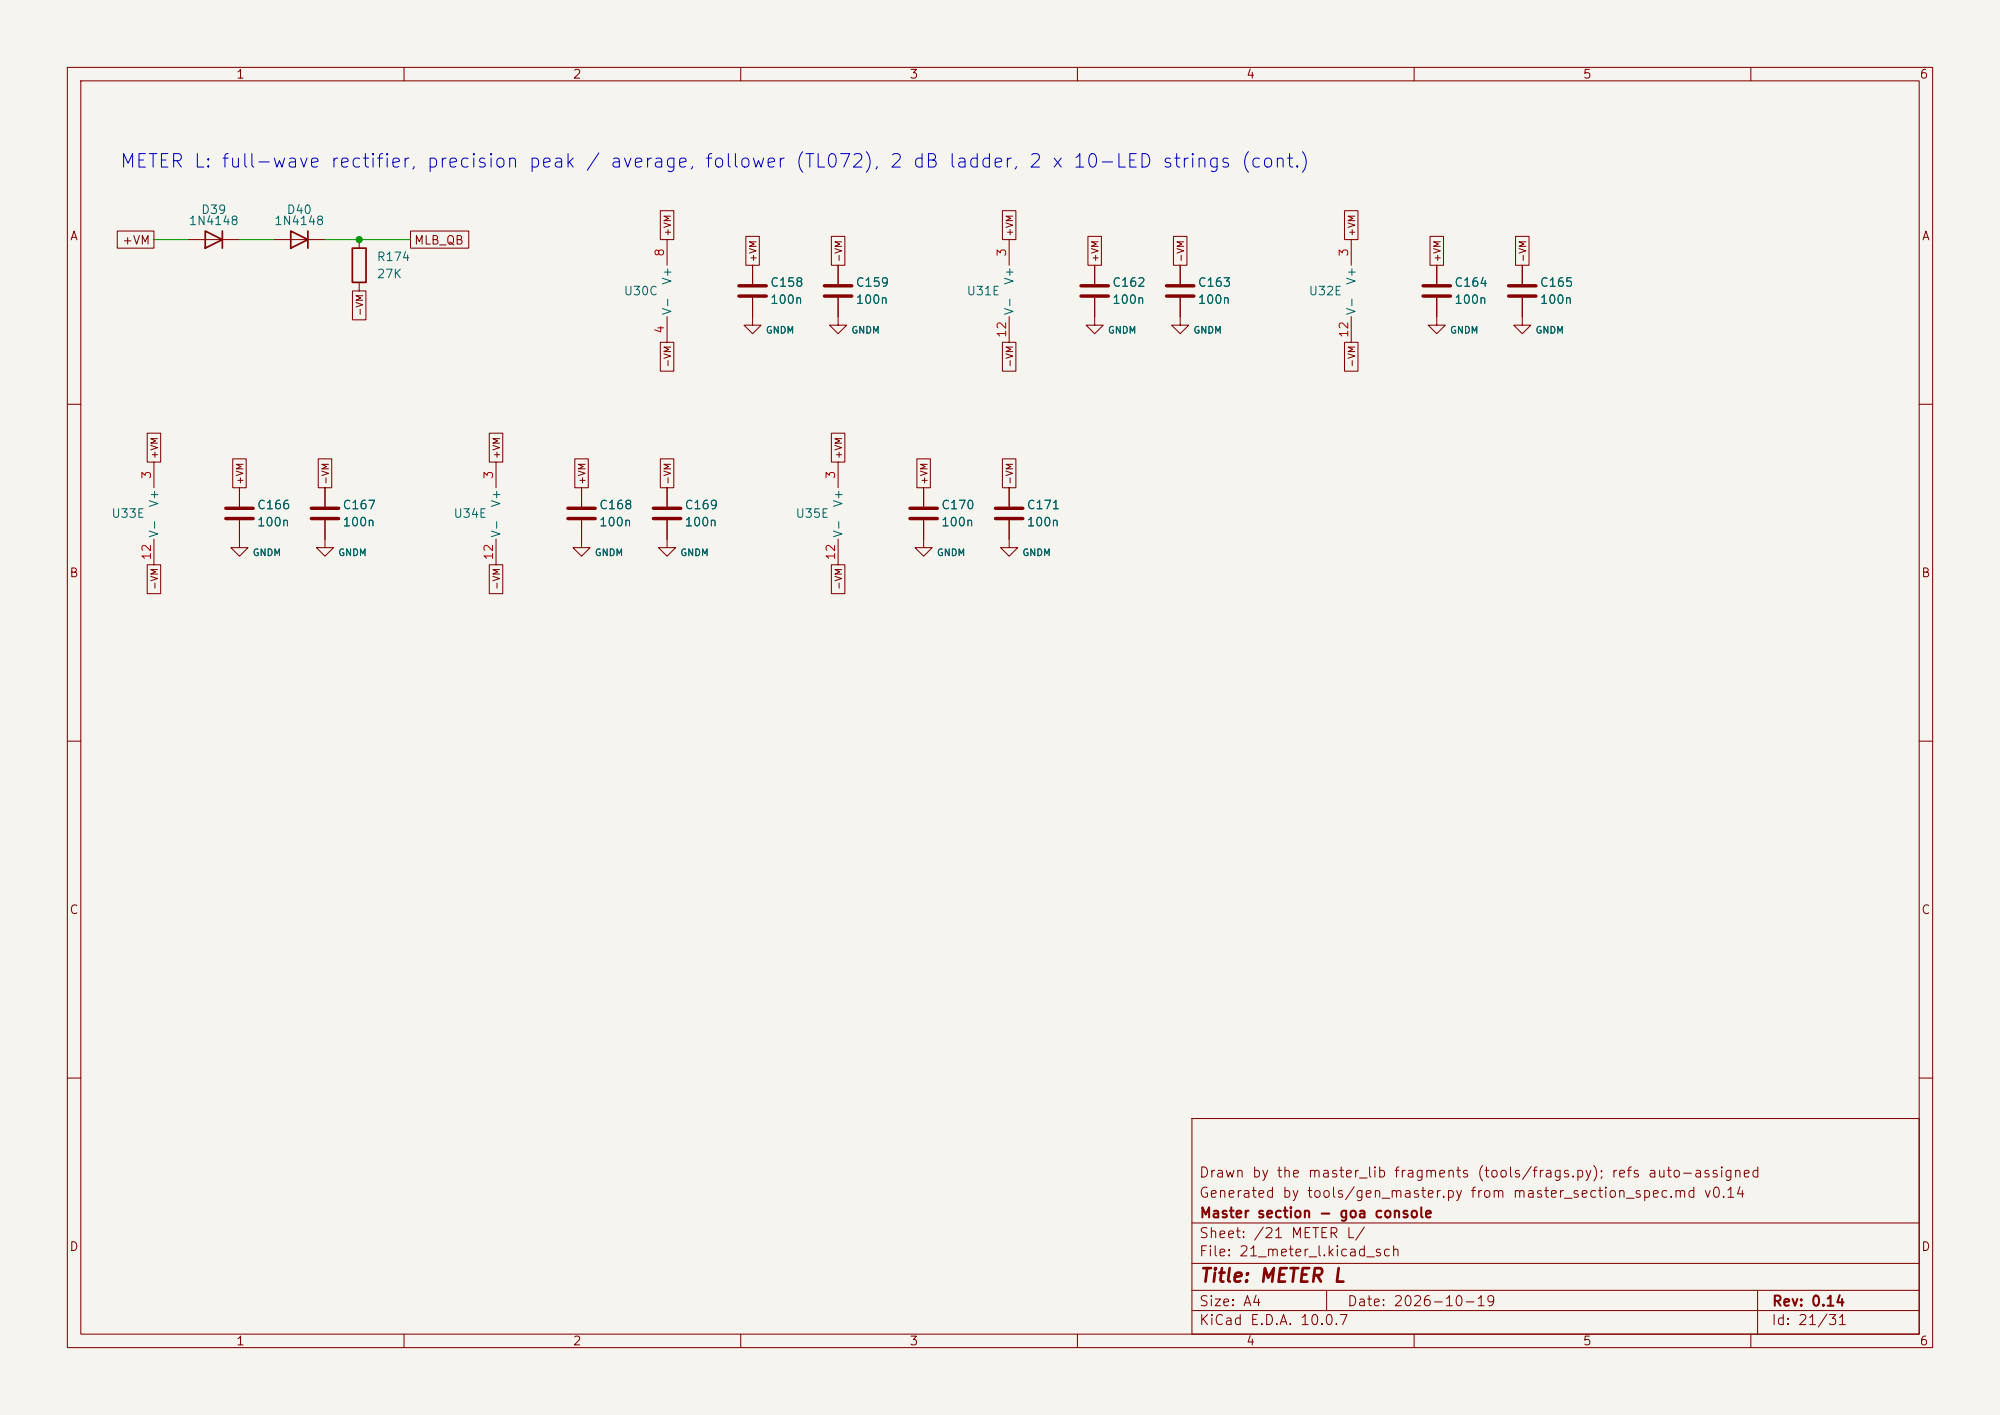
[picture p78: page 21]
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

3 V- 12 U34E -VM +VM -VM -VM +VM -VM +VM+VM -VM +VM +VM +VM -VM -VM -VM -VM +VM -VM -VM +VM -VM +VM MLB_QB +VM -VM +VM +VM

Drawn by the master_lib fragments (tools/frags.py); refs auto-assigned
Generated by tools/gen_master.py from master_section_spec.md v0.14
Master section - goa console
Sheet: /21 METER L/
File: 21_meter_l.kicad_sch
Title: METER L

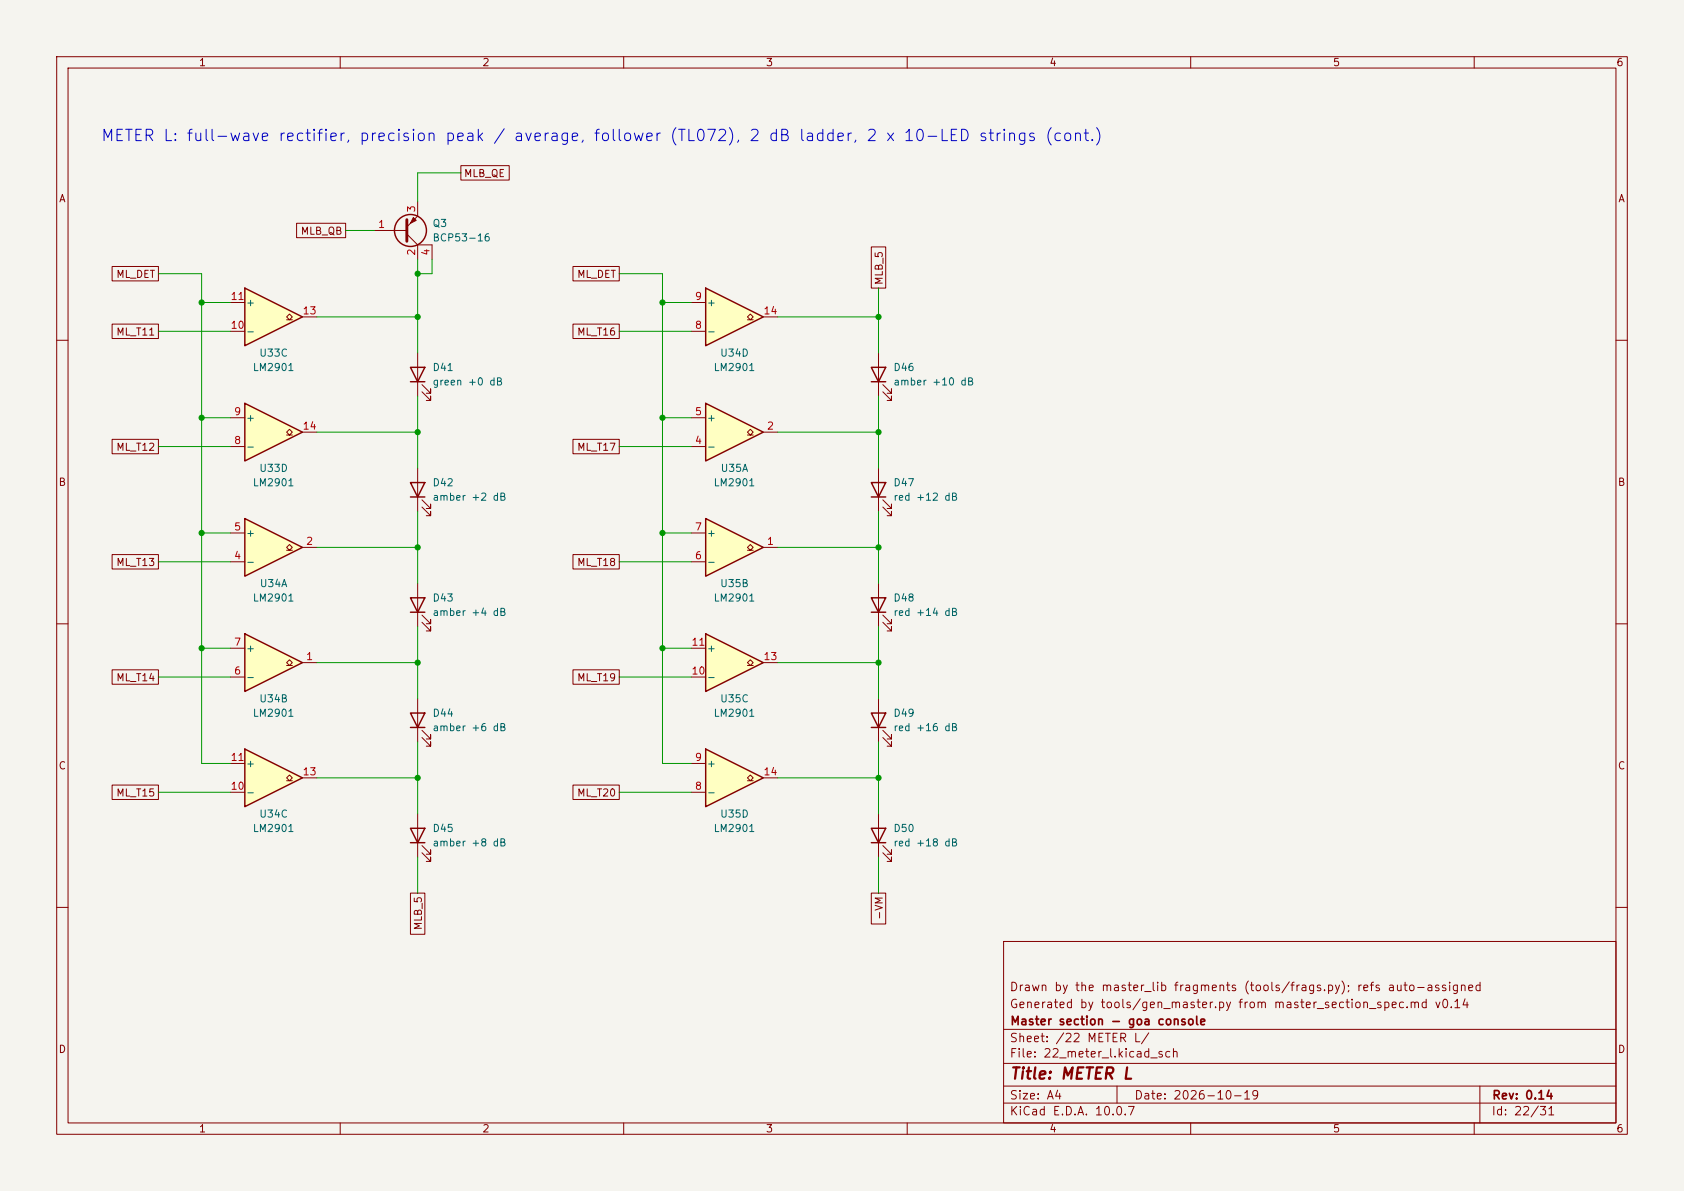
[picture p79: page 22]

Drawn by the master_lib fragments (tools/frags.py); refs auto-assigned
Generated by tools/gen_master.py from master_section_spec.md v0.14
Master section - goa console
Sheet: /22 METER L/
File: 22_meter_l.kicad_sch
Title: METER L

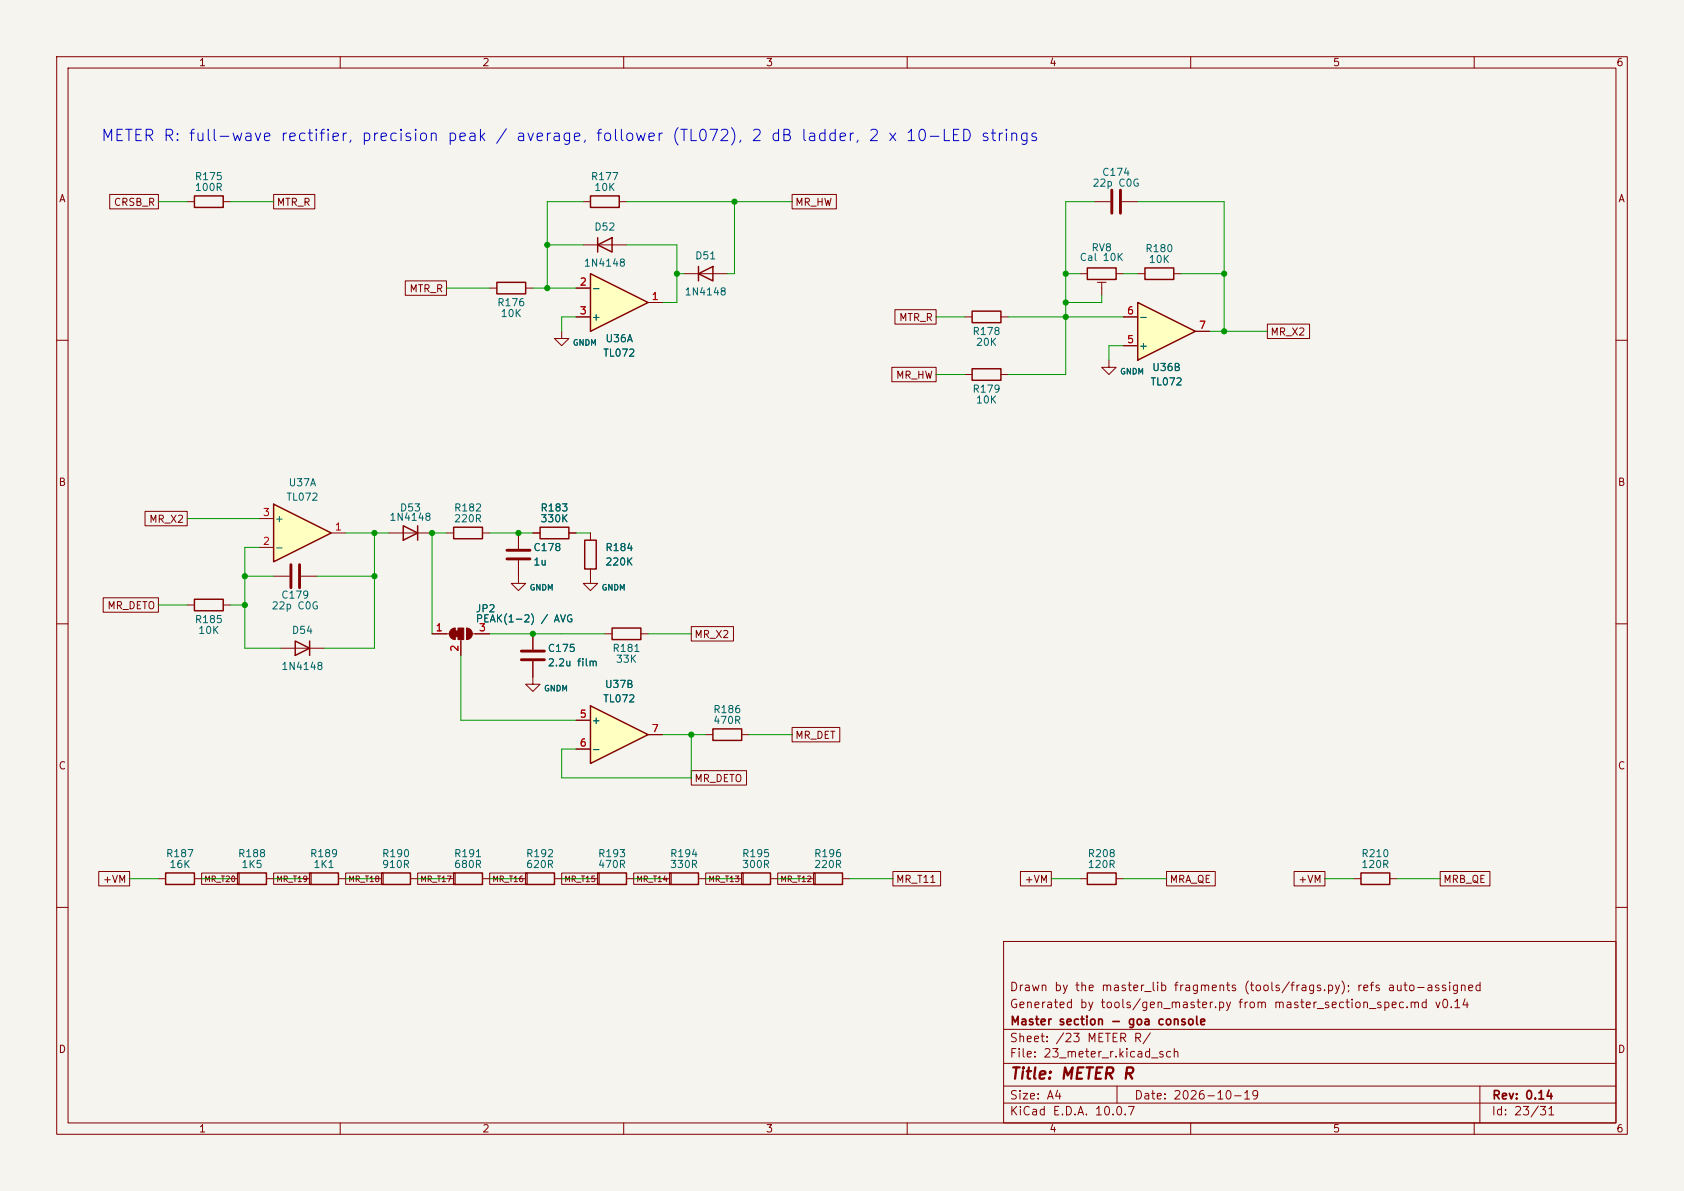
[picture p80: page 23]

Drawn by the master_lib fragments (tools/frags.py); refs auto-assigned
Generated by tools/gen_master.py from master_section_spec.md v0.14
Master section - goa console
Sheet: /23 METER R/
File: 23_meter_r.kicad_sch
Title: METER R

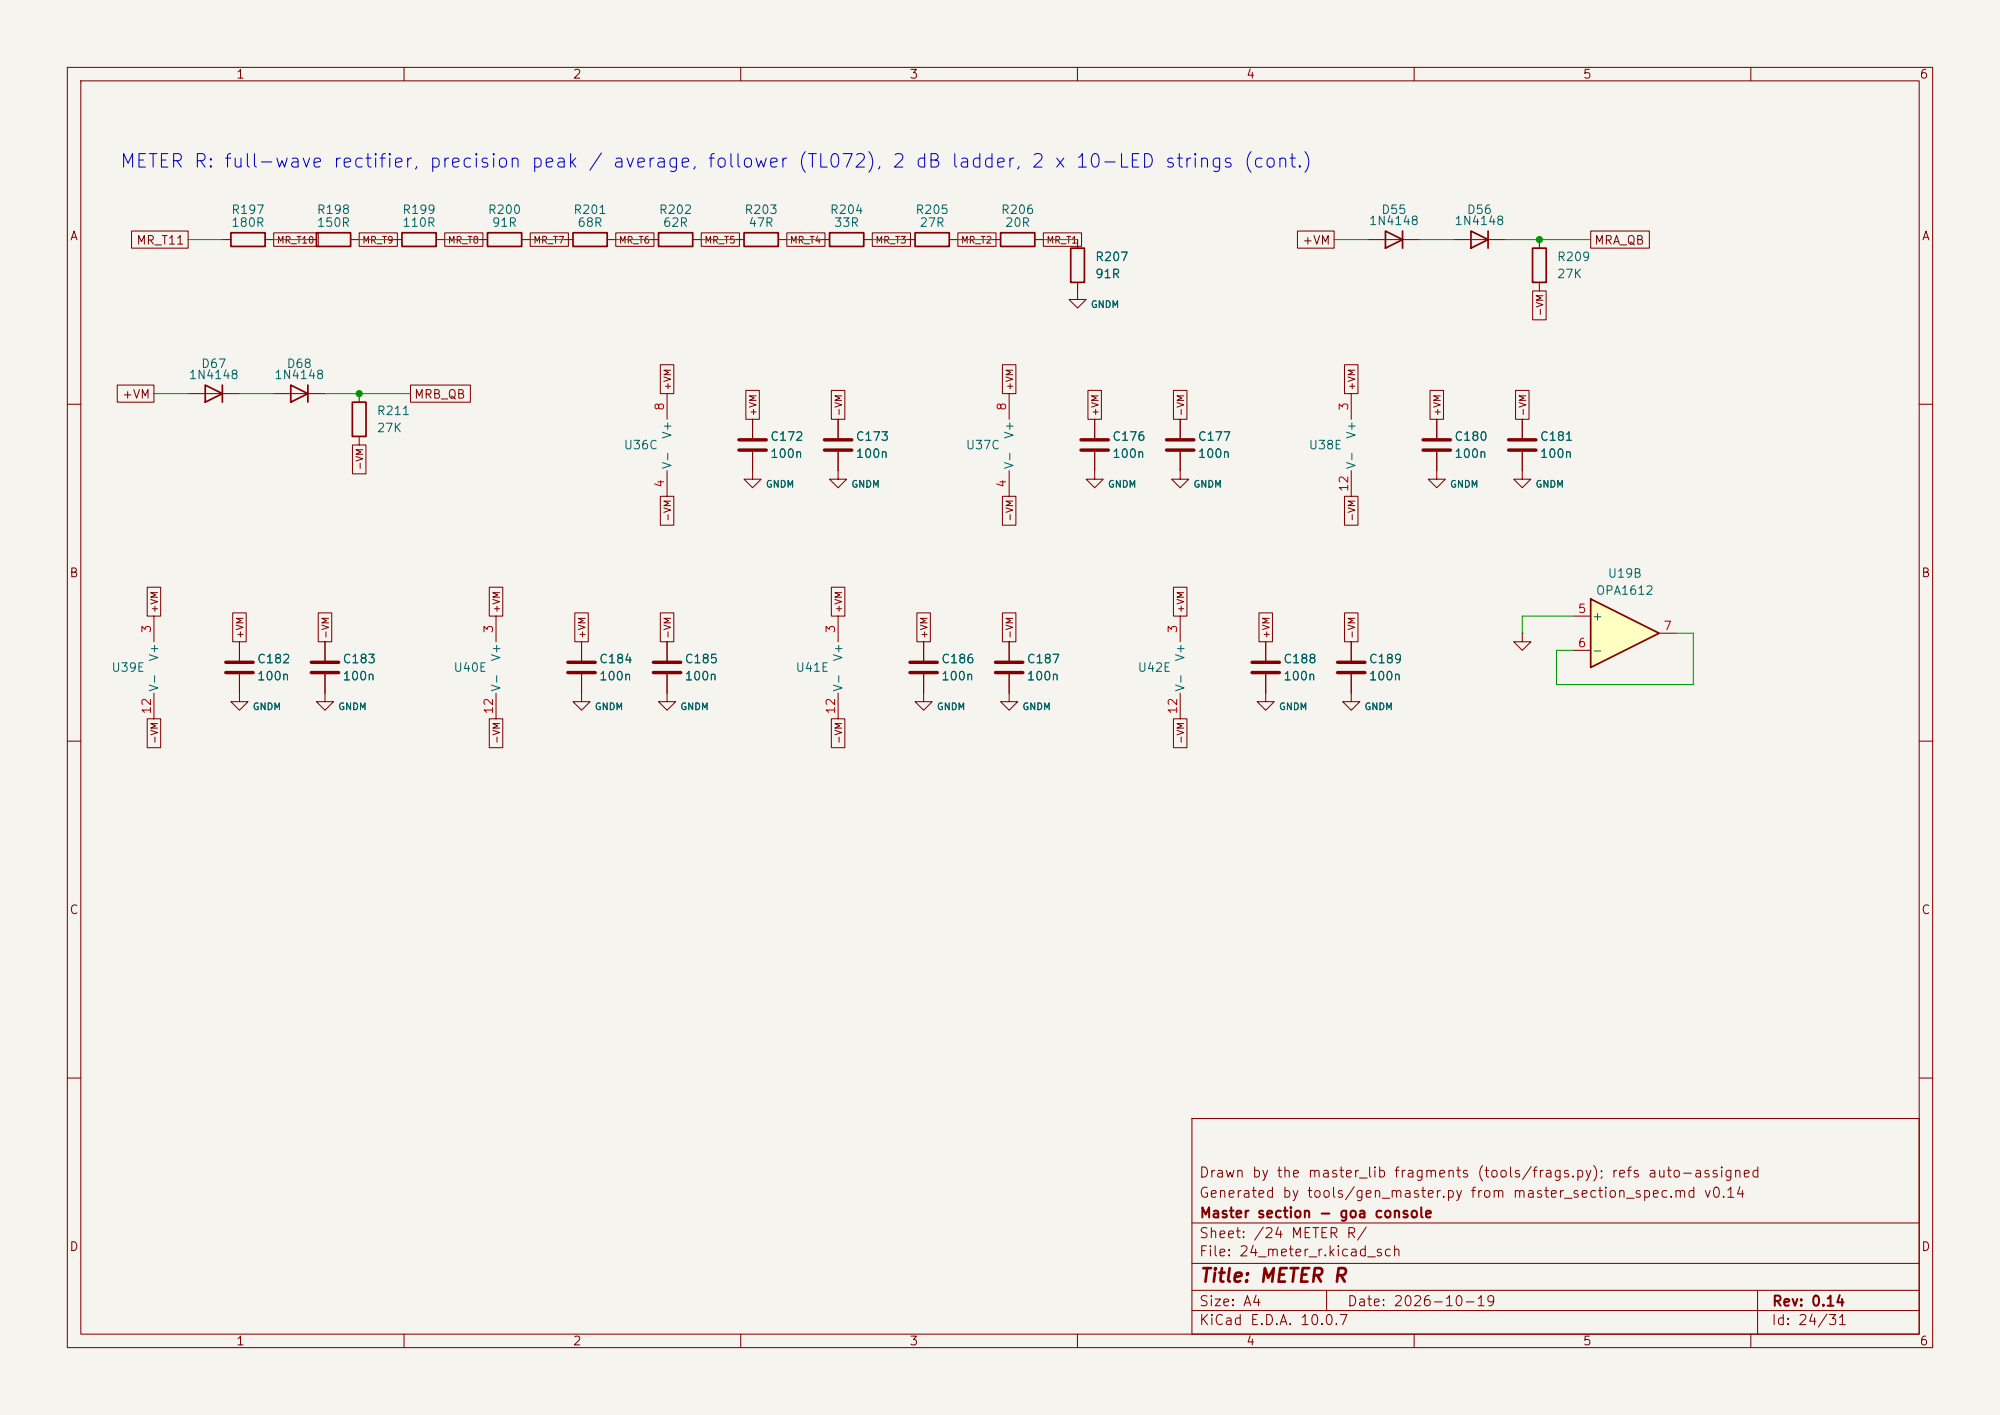
[picture p81: page 24]

METER R: full-wave rectifier, precision peak / average, follower (TL072), 2 dB ladder, 2 x 10-LED strings (cont.)

Drawn by the master_lib fragments (tools/frags.py); refs auto-assigned
Generated by tools/gen_master.py from master_section_spec.md v0.14
Master section - goa console
Sheet: /24 METER R/
File: 24_meter_r.kicad_sch
Title: METER R

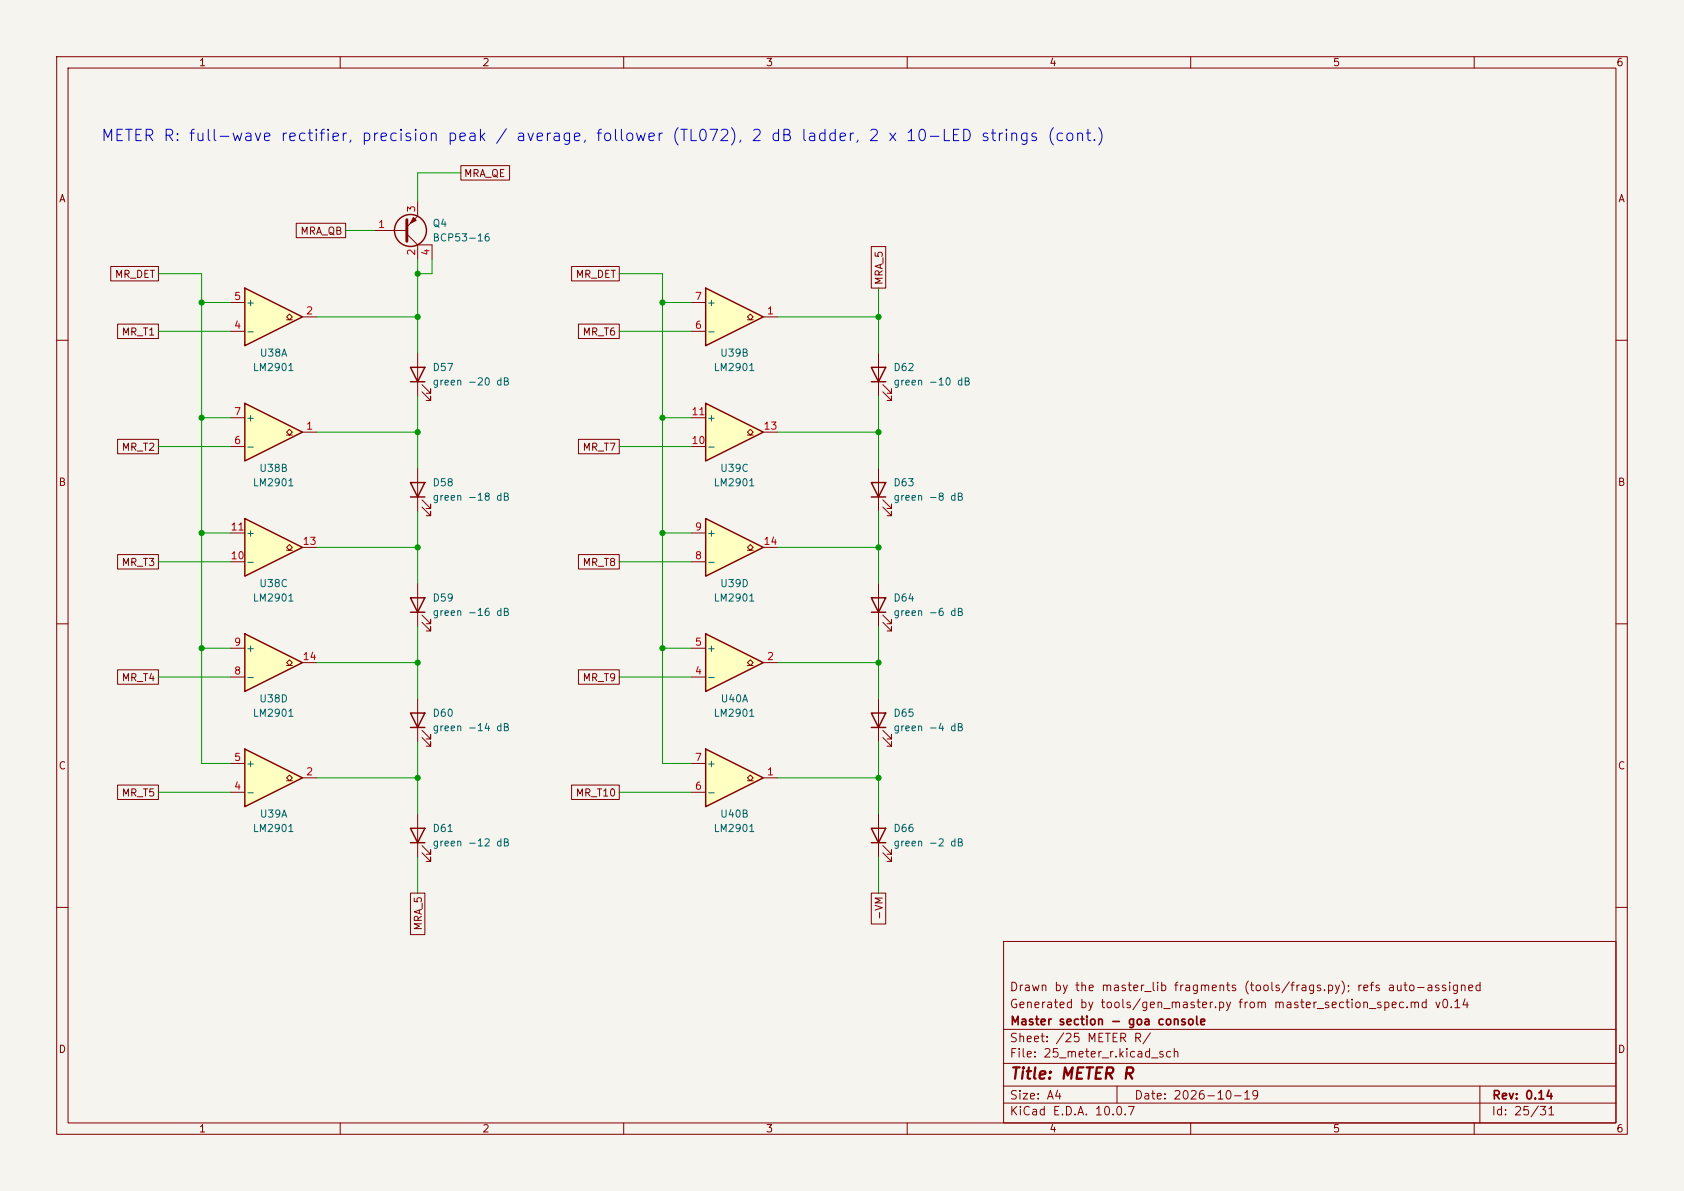
[picture p82: page 25]

Drawn by the master_lib fragments (tools/frags.py); refs auto-assigned
Generated by tools/gen_master.py from master_section_spec.md v0.14
Master section - goa console
Sheet: /25 METER R/
File: 25_meter_r.kicad_sch
Title: METER R

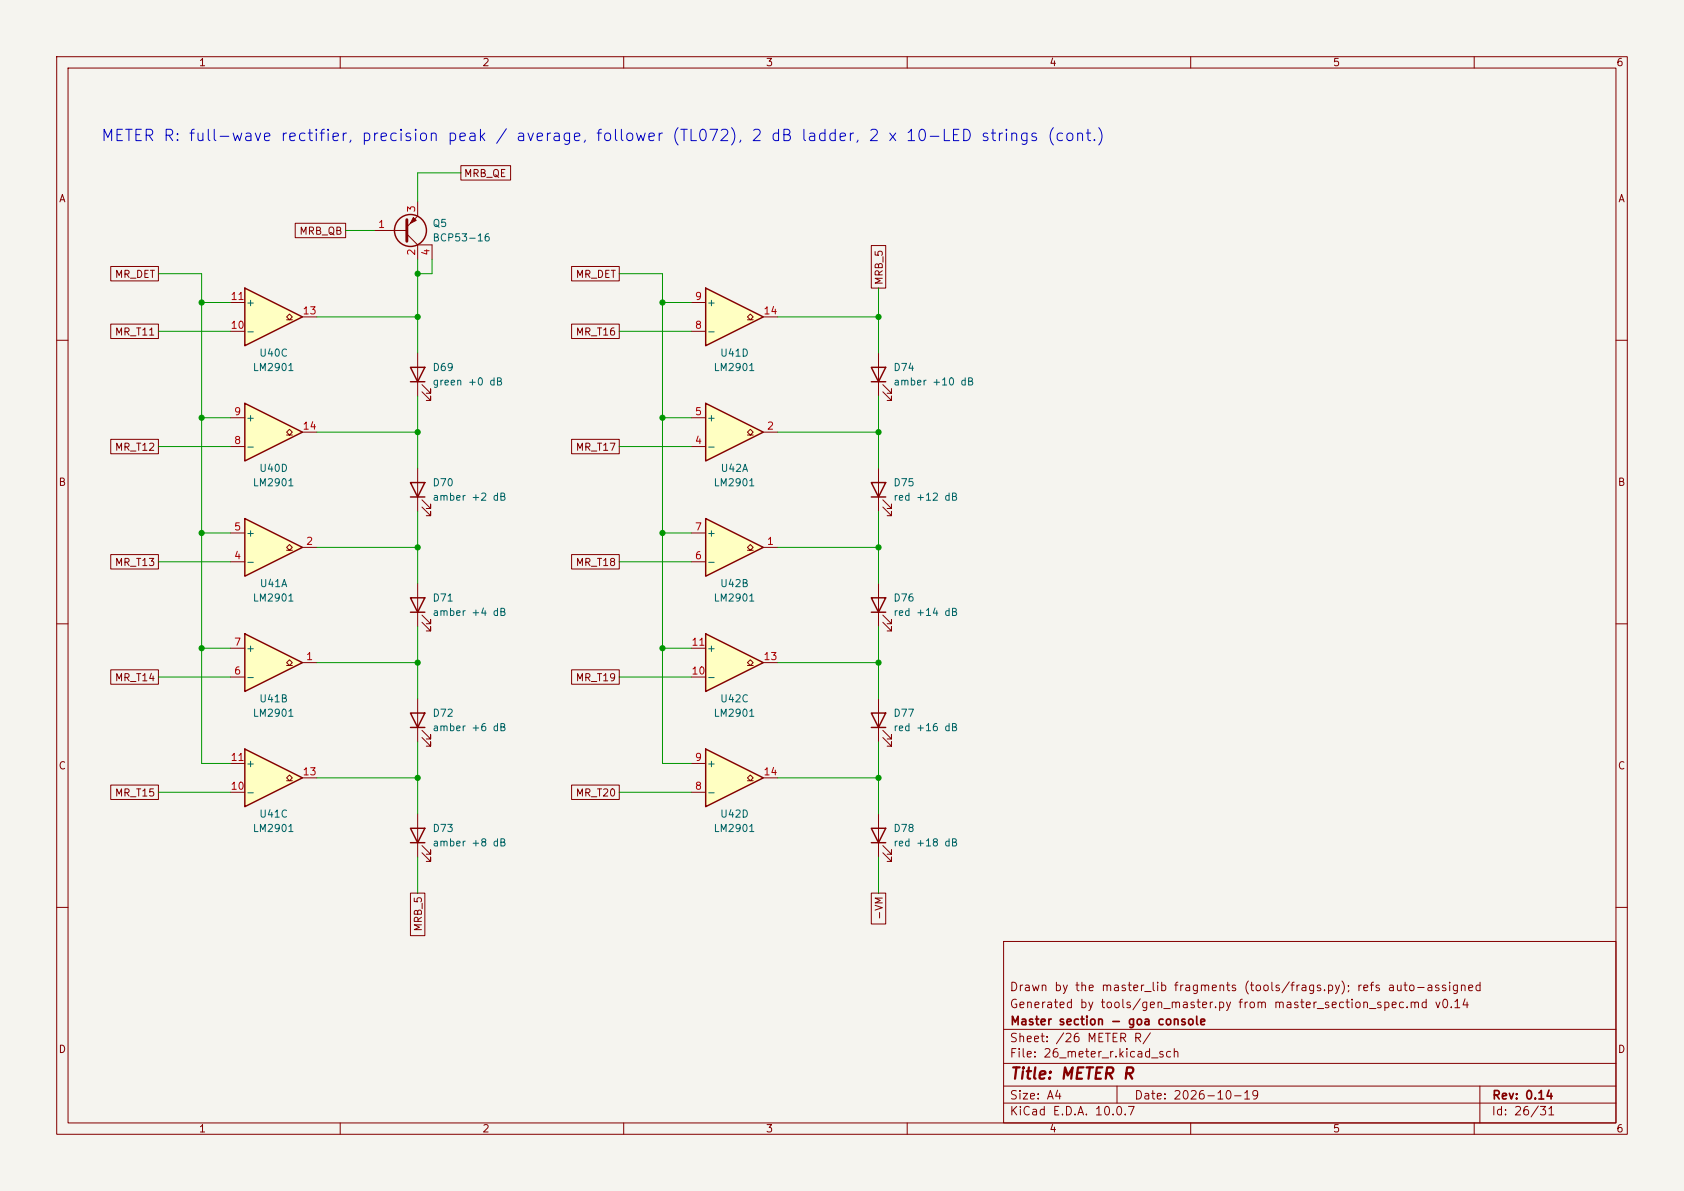
[picture p83: page 26]

Drawn by the master_lib fragments (tools/frags.py); refs auto-assigned
Generated by tools/gen_master.py from master_section_spec.md v0.14
Master section - goa console
Sheet: /26 METER R/
File: 26_meter_r.kicad_sch
Title: METER R

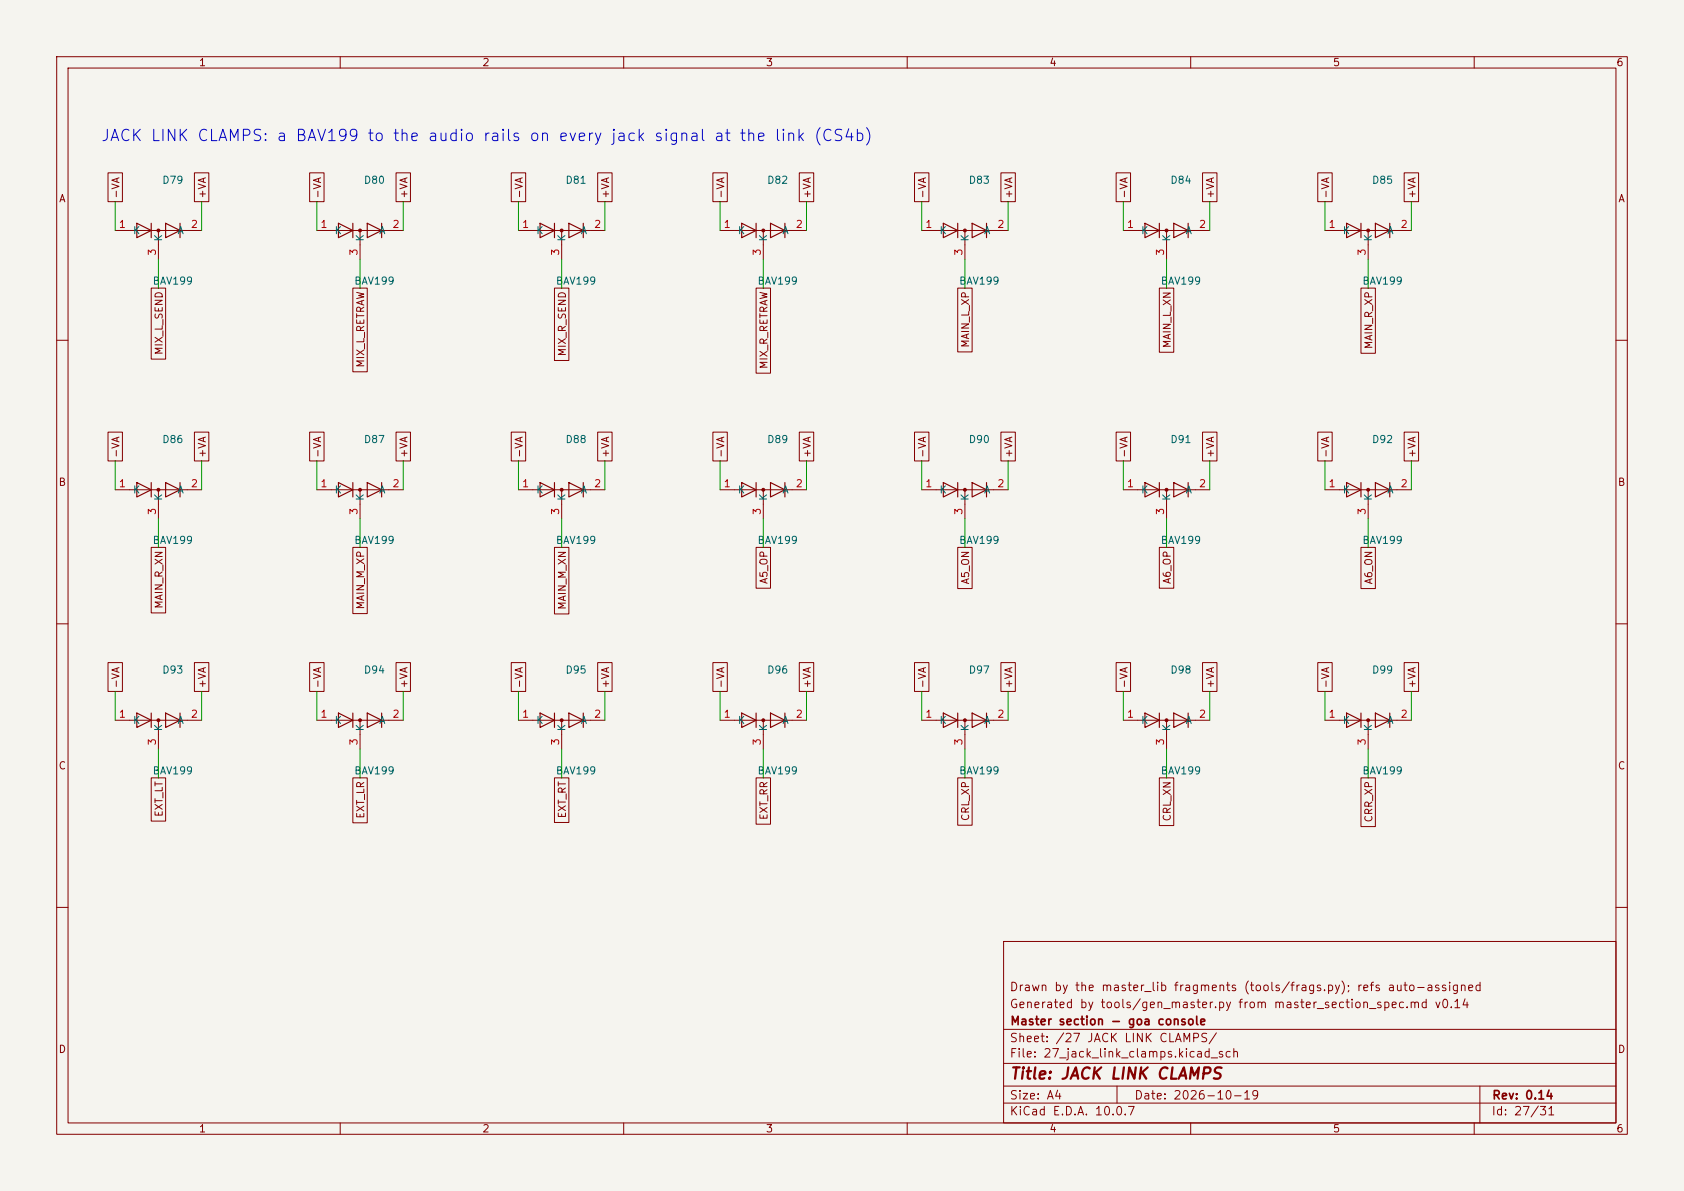
[picture p84: page 27]

JACK LINK CLAMPS: a BAV199 to the audio rails on every jack signal at the link (CS4b)

3 D93 BAV199 +VA MIX_R_SEND +VA CRL_XN +VA -VA +VA -VA A5_ON A6_OP -VA +VA CRL_XP -VA MAIN_R_XP MIX_R_RETRAW +VA MIX_L_RETRAW +VA -VA +VA -VA +VA MAIN_R_XN -VA +VA -VA MAIN_M_XN +VA -VA EXT_RT CRR_XP -VA +VA -VA A5_OP +VA -VA EXT_RR +VA +VA -VA -VA MAIN_M_XP -VA +VA -VA EXT_LR MIX_L_SEND EXT_LT MAIN_L_XN -VA +VA MAIN_L_XP -VA +VA -VA A6_ON -VA +VA -VA +VA +VA

Drawn by the master_lib fragments (tools/frags.py); refs auto-assigned
Generated by tools/gen_master.py from master_section_spec.md v0.14
Master section - goa console
Sheet: /27 JACK LINK CLAMPS/
File: 27_jack_link_clamps.kicad_sch
Title: JACK LINK CLAMPS

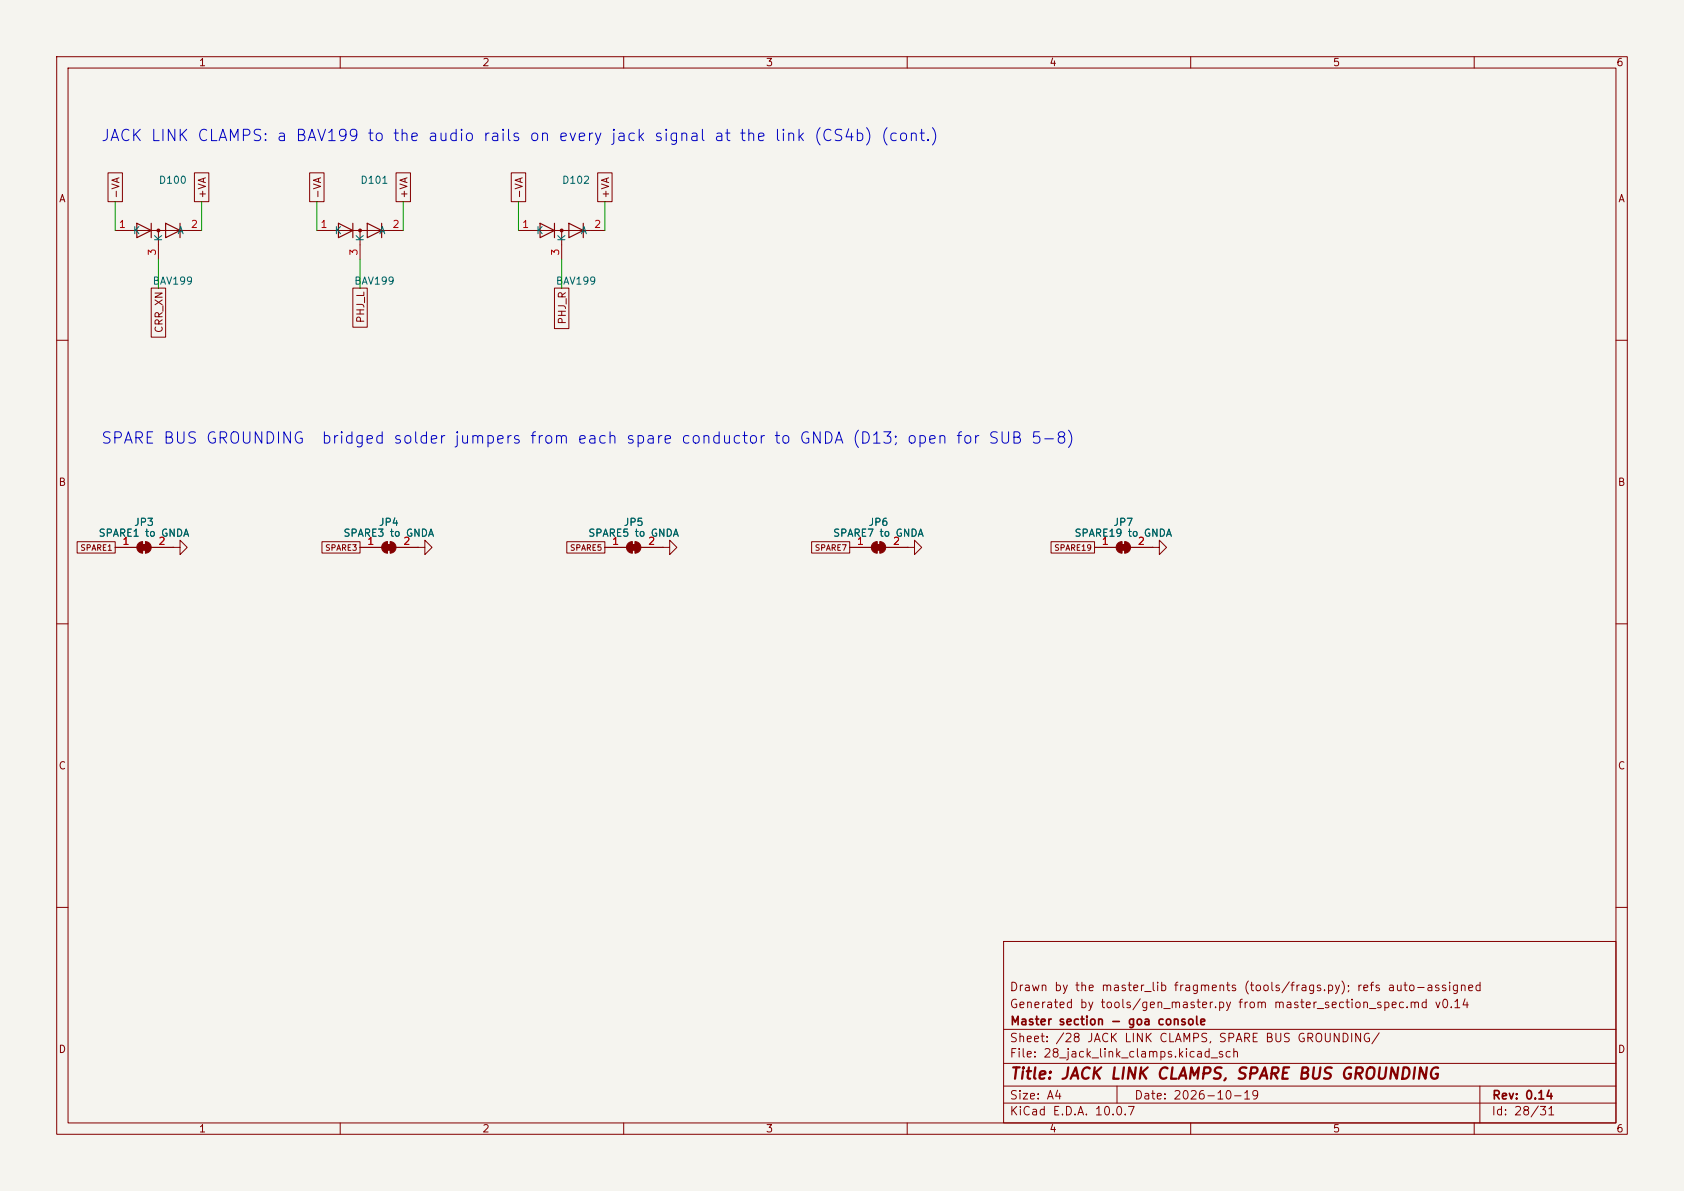
[picture p85: page 28]

SPARE1 JACK LINK CLAMPS: a BAV199 to the audio rails on every jack signal at the link (CS4b) (cont.)

SPARE BUS GROUNDING bridged solder jumpers from each spare conductor to GNDA (D13; open for SUB 5-8)

Drawn by the master_lib fragments (tools/frags.py); refs auto-assigned
Generated by tools/gen_master.py from master_section_spec.md v0.14
Master section - goa console
Sheet: /28 JACK LINK CLAMPS, SPARE BUS GROUNDING/
File: 28_jack_link_clamps.kicad_sch
Title: JACK LINK CLAMPS, SPARE BUS GROUNDING

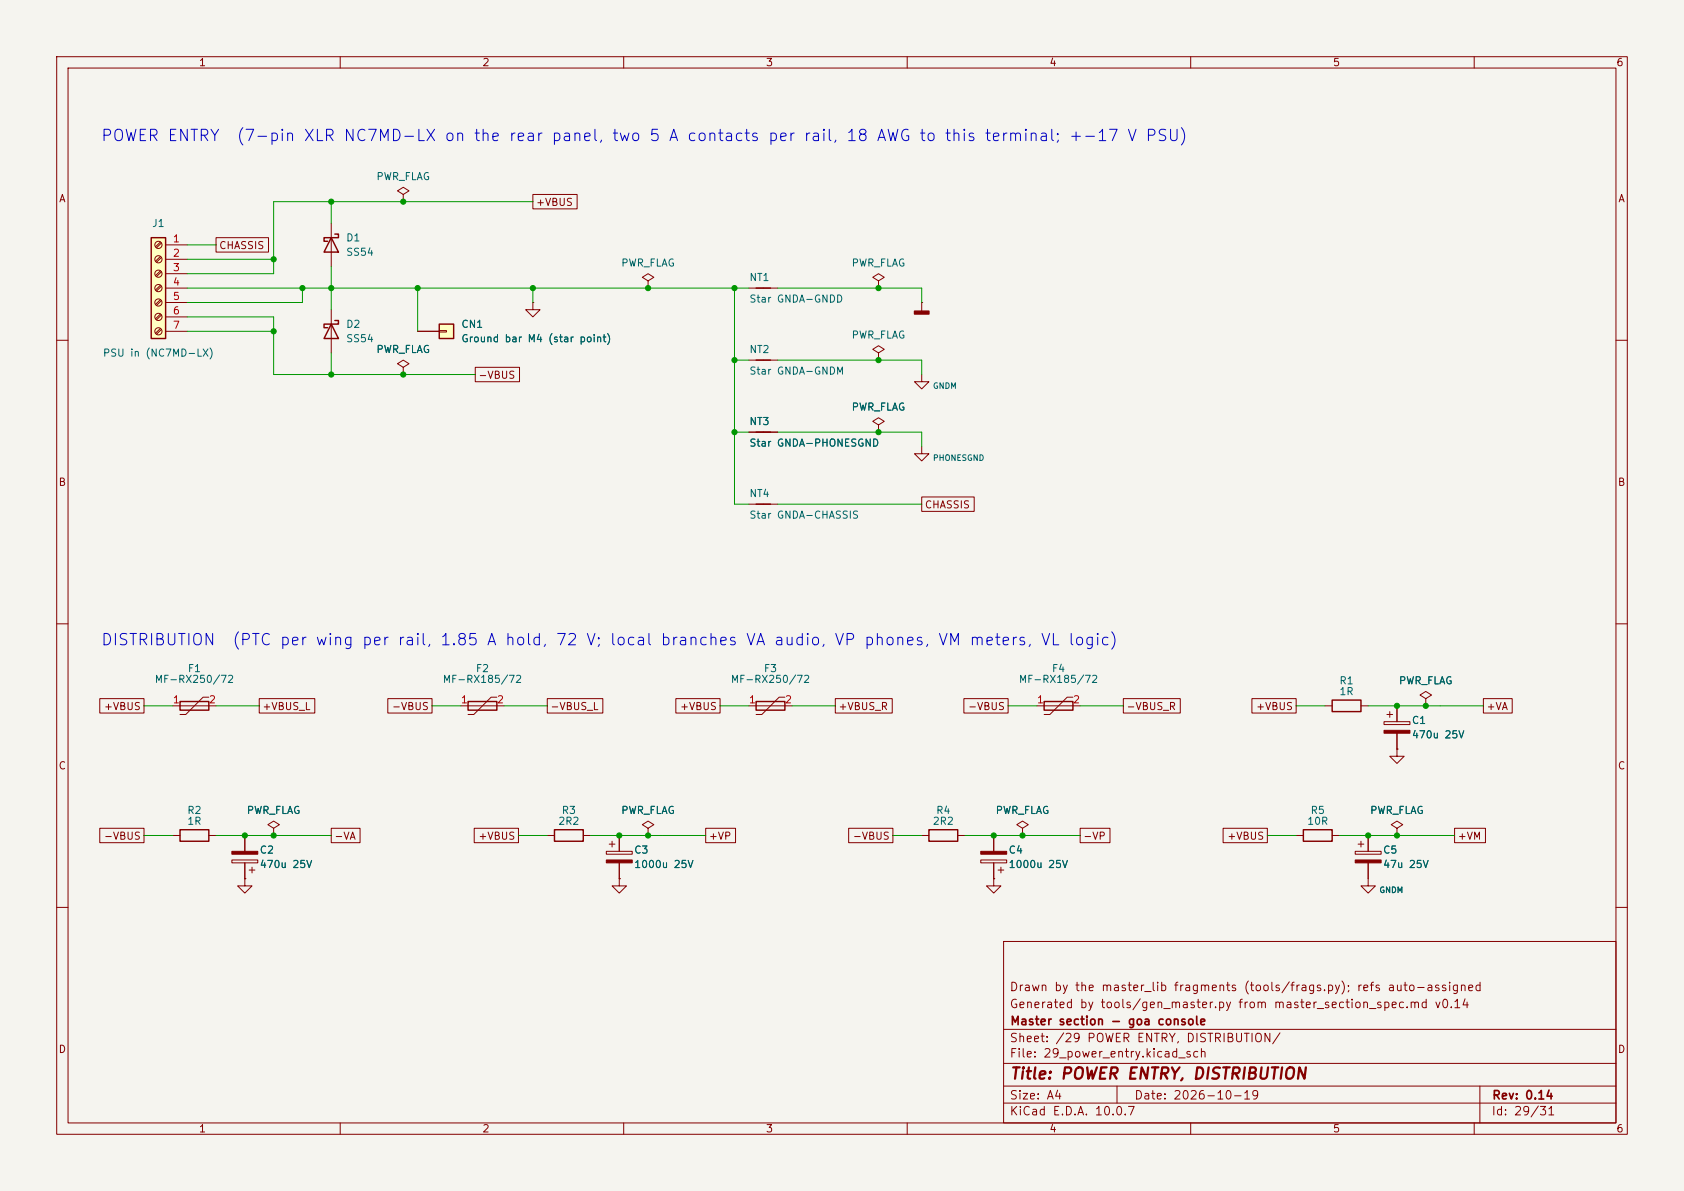
[picture p86: page 29]

POWER ENTRY (7-pin XLR NC7MD-LX on the rear panel, two 5 A contacts per rail, 18 AWG to this terminal; +-17 V PSU)

CN1 Ground bar M4 (star point) PWR_FLAG
PWR_FLAG

Drawn by the master_lib fragments (tools/frags.py); refs auto-assigned
Generated by tools/gen_master.py from master_section_spec.md v0.14
Master section - goa console
Sheet: /29 POWER ENTRY, DISTRIBUTION/
File: 29_power_entry.kicad_sch
Title: POWER ENTRY, DISTRIBUTION

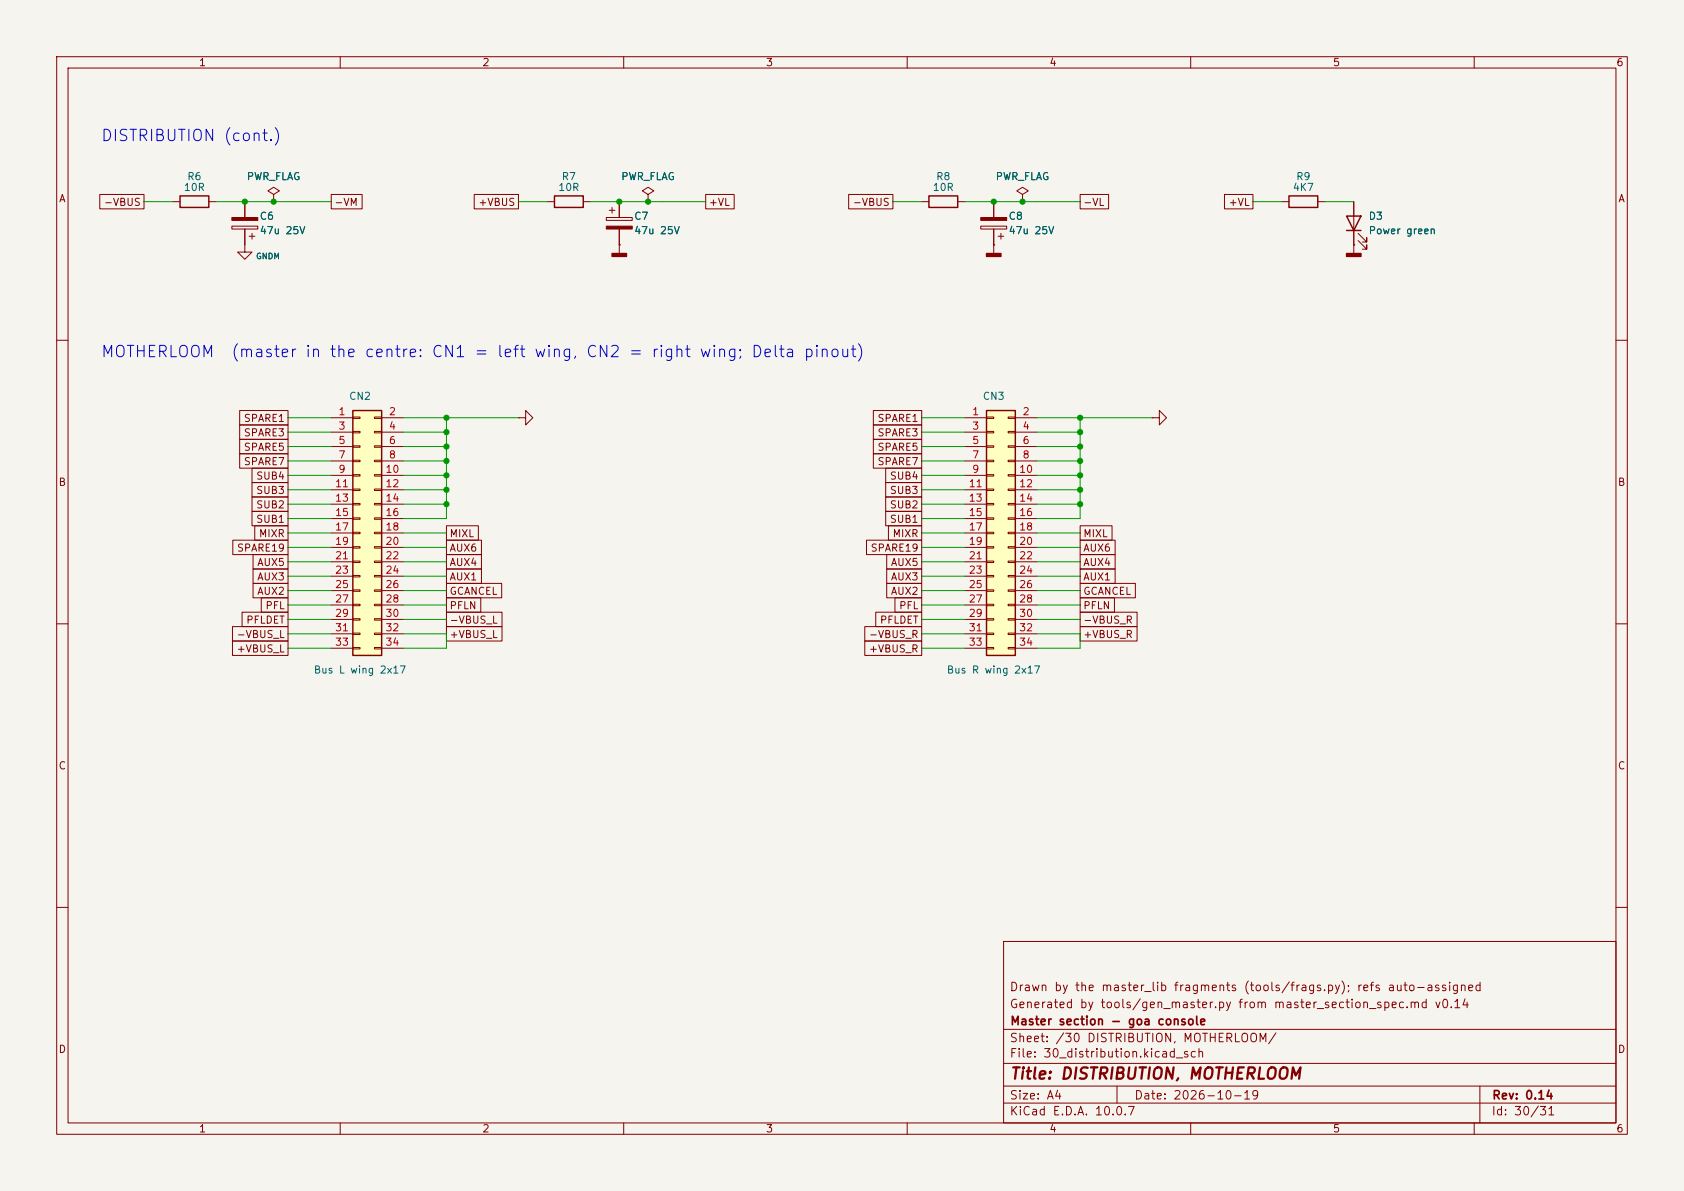
[picture p87: page 30]

AUX3 MOTHERLOOM (master in the centre: CN1 = left wing, CN2 = right wing; Delta pinout)

Drawn by the master_lib fragments (tools/frags.py); refs auto-assigned
Generated by tools/gen_master.py from master_section_spec.md v0.14
Master section - goa console
Sheet: /30 DISTRIBUTION, MOTHERLOOM/
File: 30_distribution.kicad_sch
Title: DISTRIBUTION, MOTHERLOOM

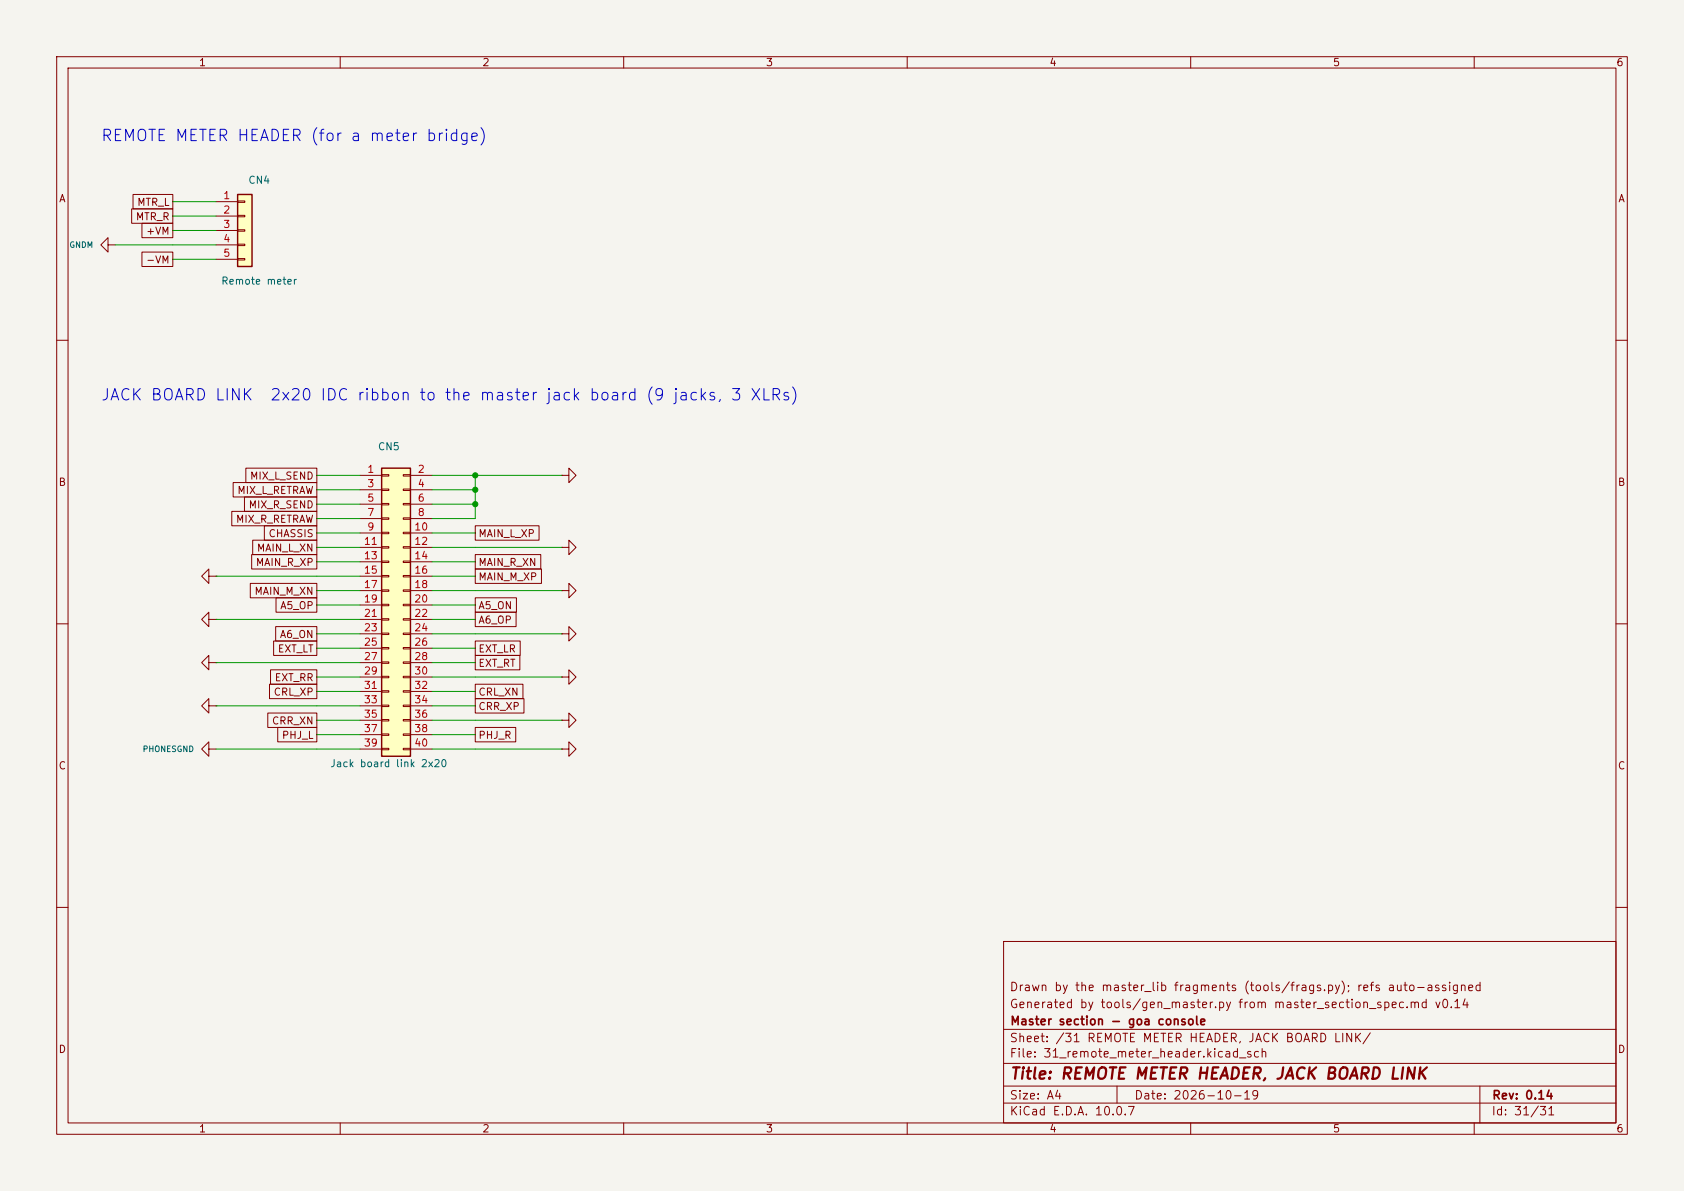
[picture p88: page 31]

REMOTE METER HEADER (for a meter bridge)
CHASSIS MAIN_L_XN MAIN_R_XP +VM -VM

A5_ON JACK BOARD LINK 2x20 IDC ribbon to the master jack board (9 jacks, 3 XLRs)
CRL_XP MIX_R_SEND MIX_R_RETRAW

Drawn by the master_lib fragments (tools/frags.py); refs auto-assigned
Generated by tools/gen_master.py from master_section_spec.md v0.14
Master section - goa console
Sheet: /31 REMOTE METER HEADER, JACK BOARD LINK/
File: 31_remote_meter_header.kicad_sch
Title: REMOTE METER HEADER, JACK BOARD LINK
