cozycactus/goa-console/panels/master.pdf

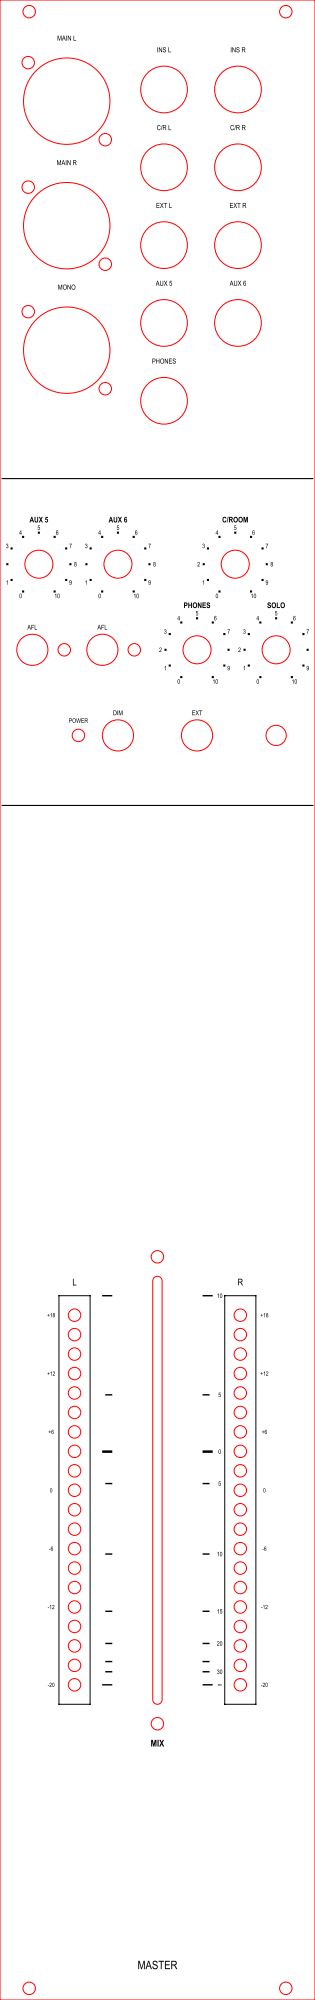
[picture p89: page 1]
