cozycactus/goa-console/boards/jig_master_stub/jig_master_stub.kicad_pcb

## KiCad design boards/jig_master_stub/jig_master_stub.kicad_pcb (2026-11-11)

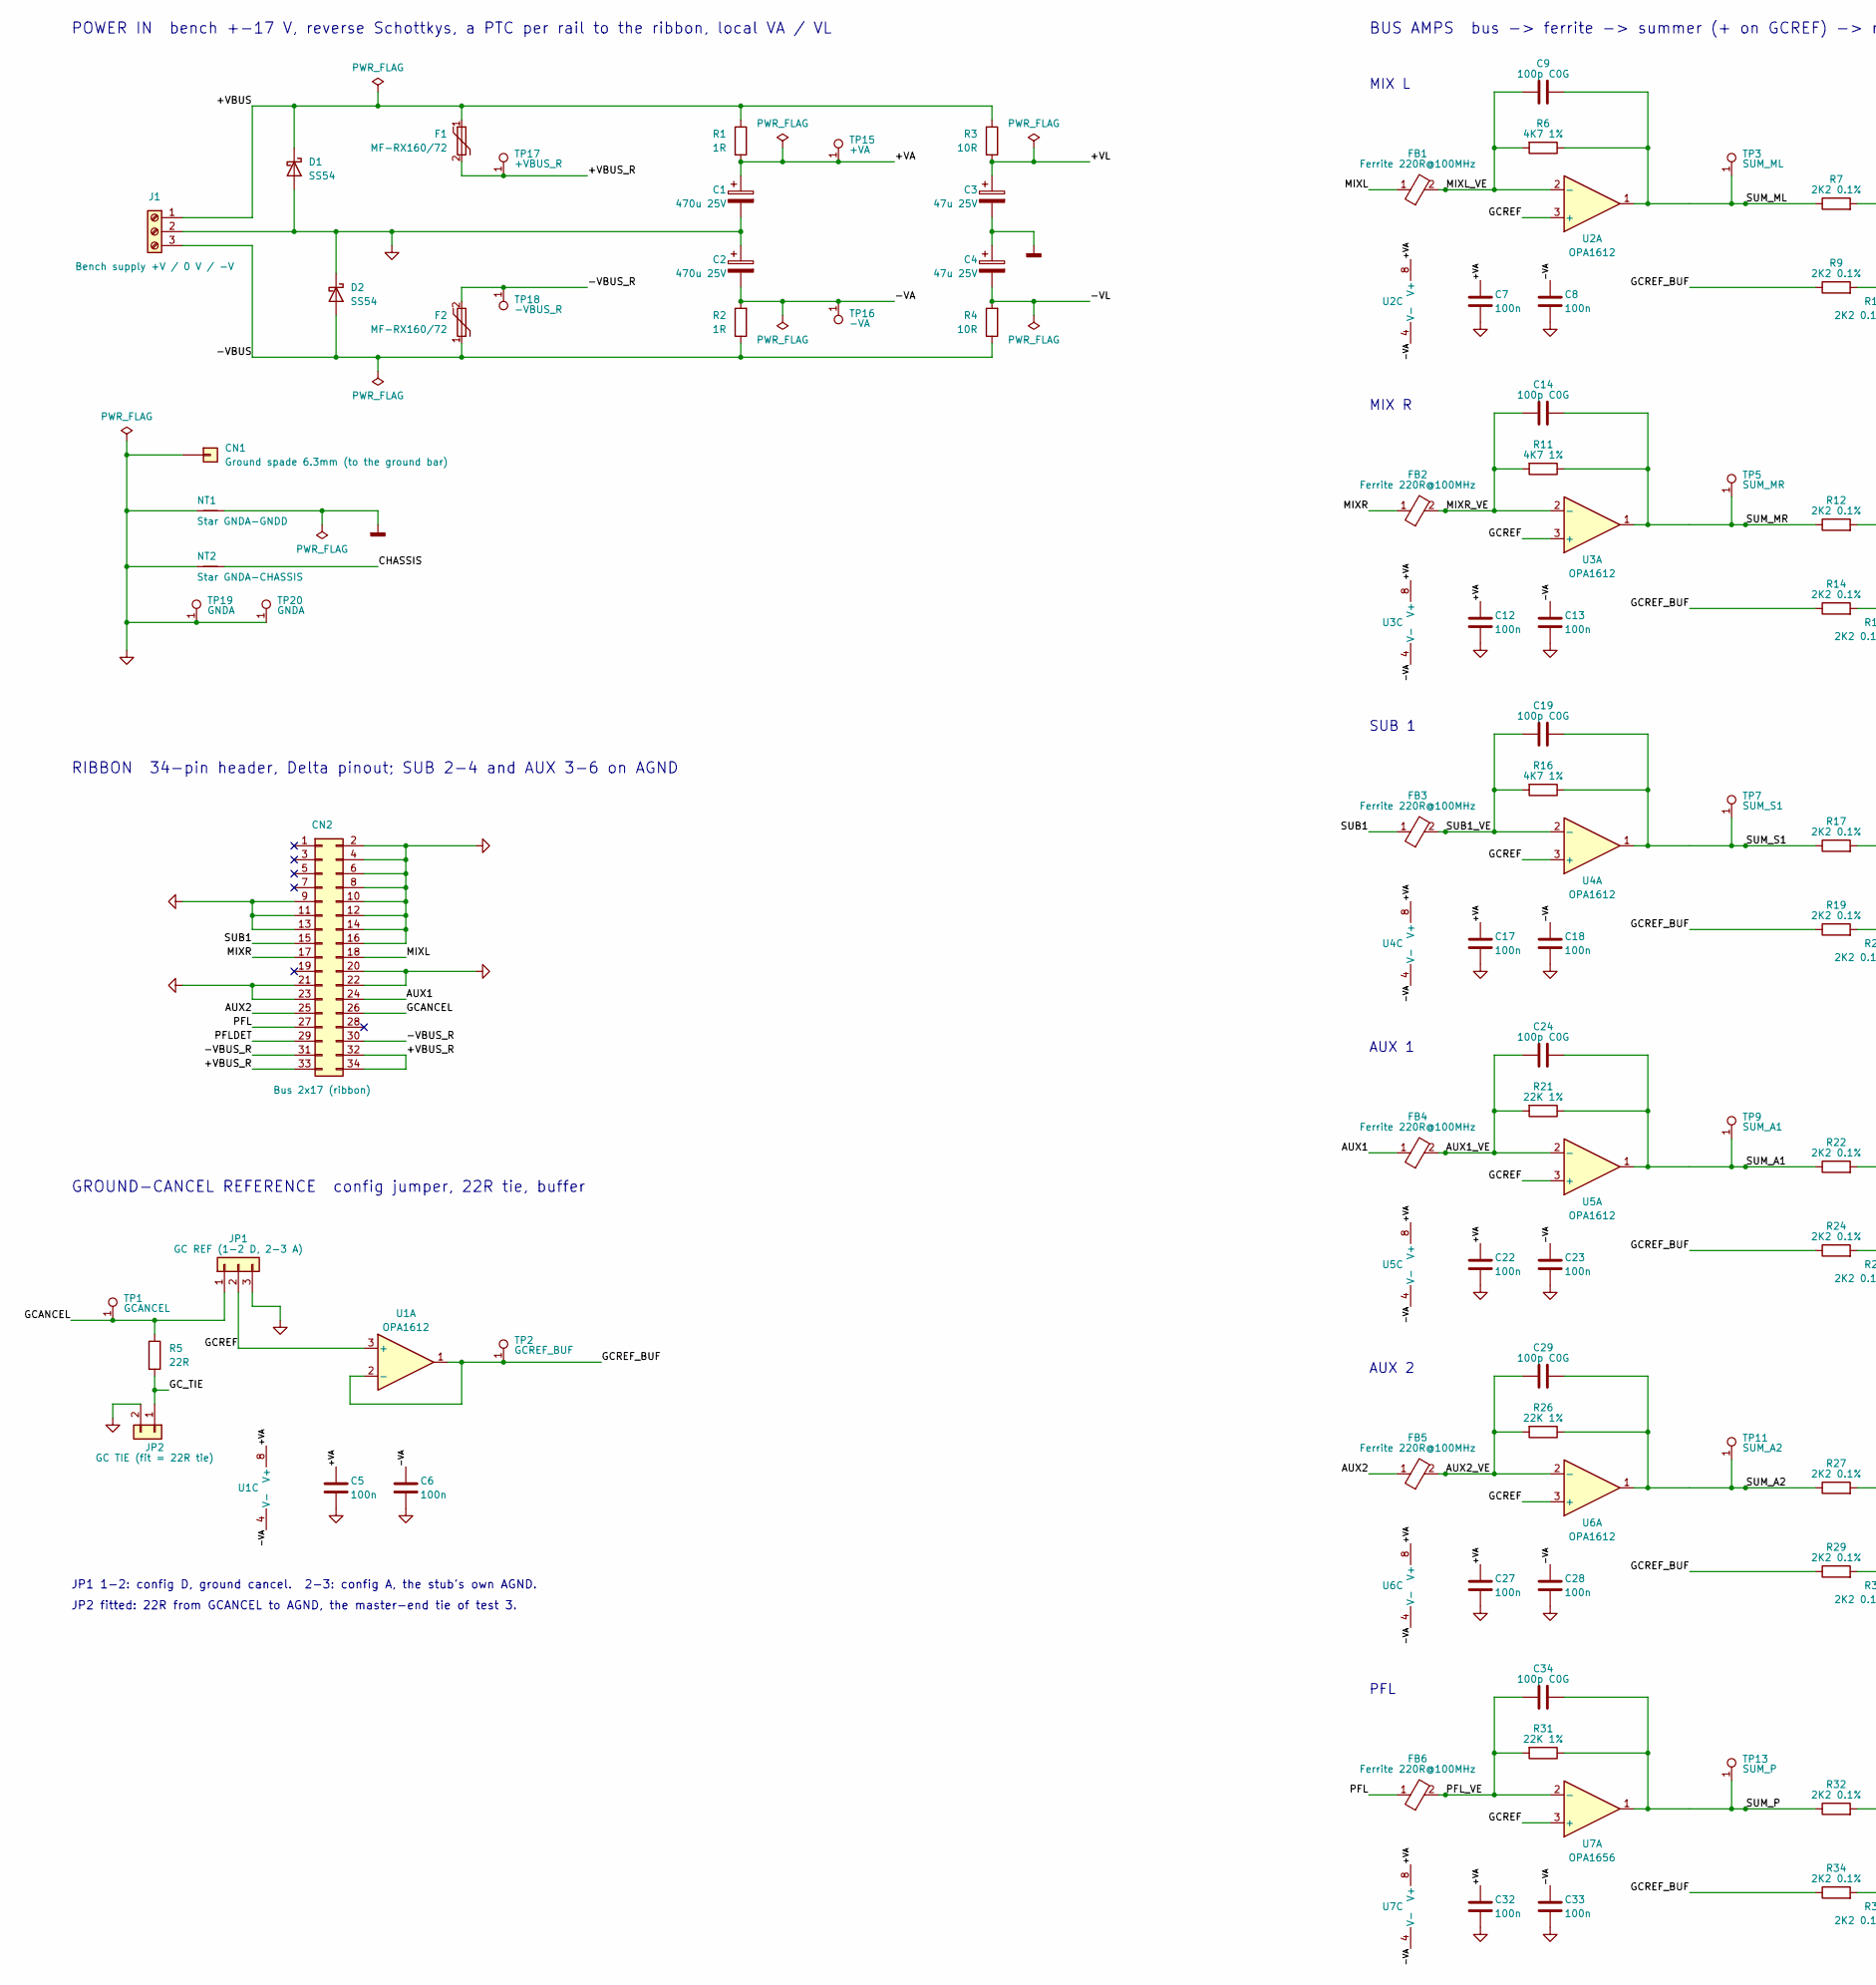
[picture p90: schematic jig_master_stub.kicad_sch, Test jig - master stub (goa console), part in row 1, column 1]

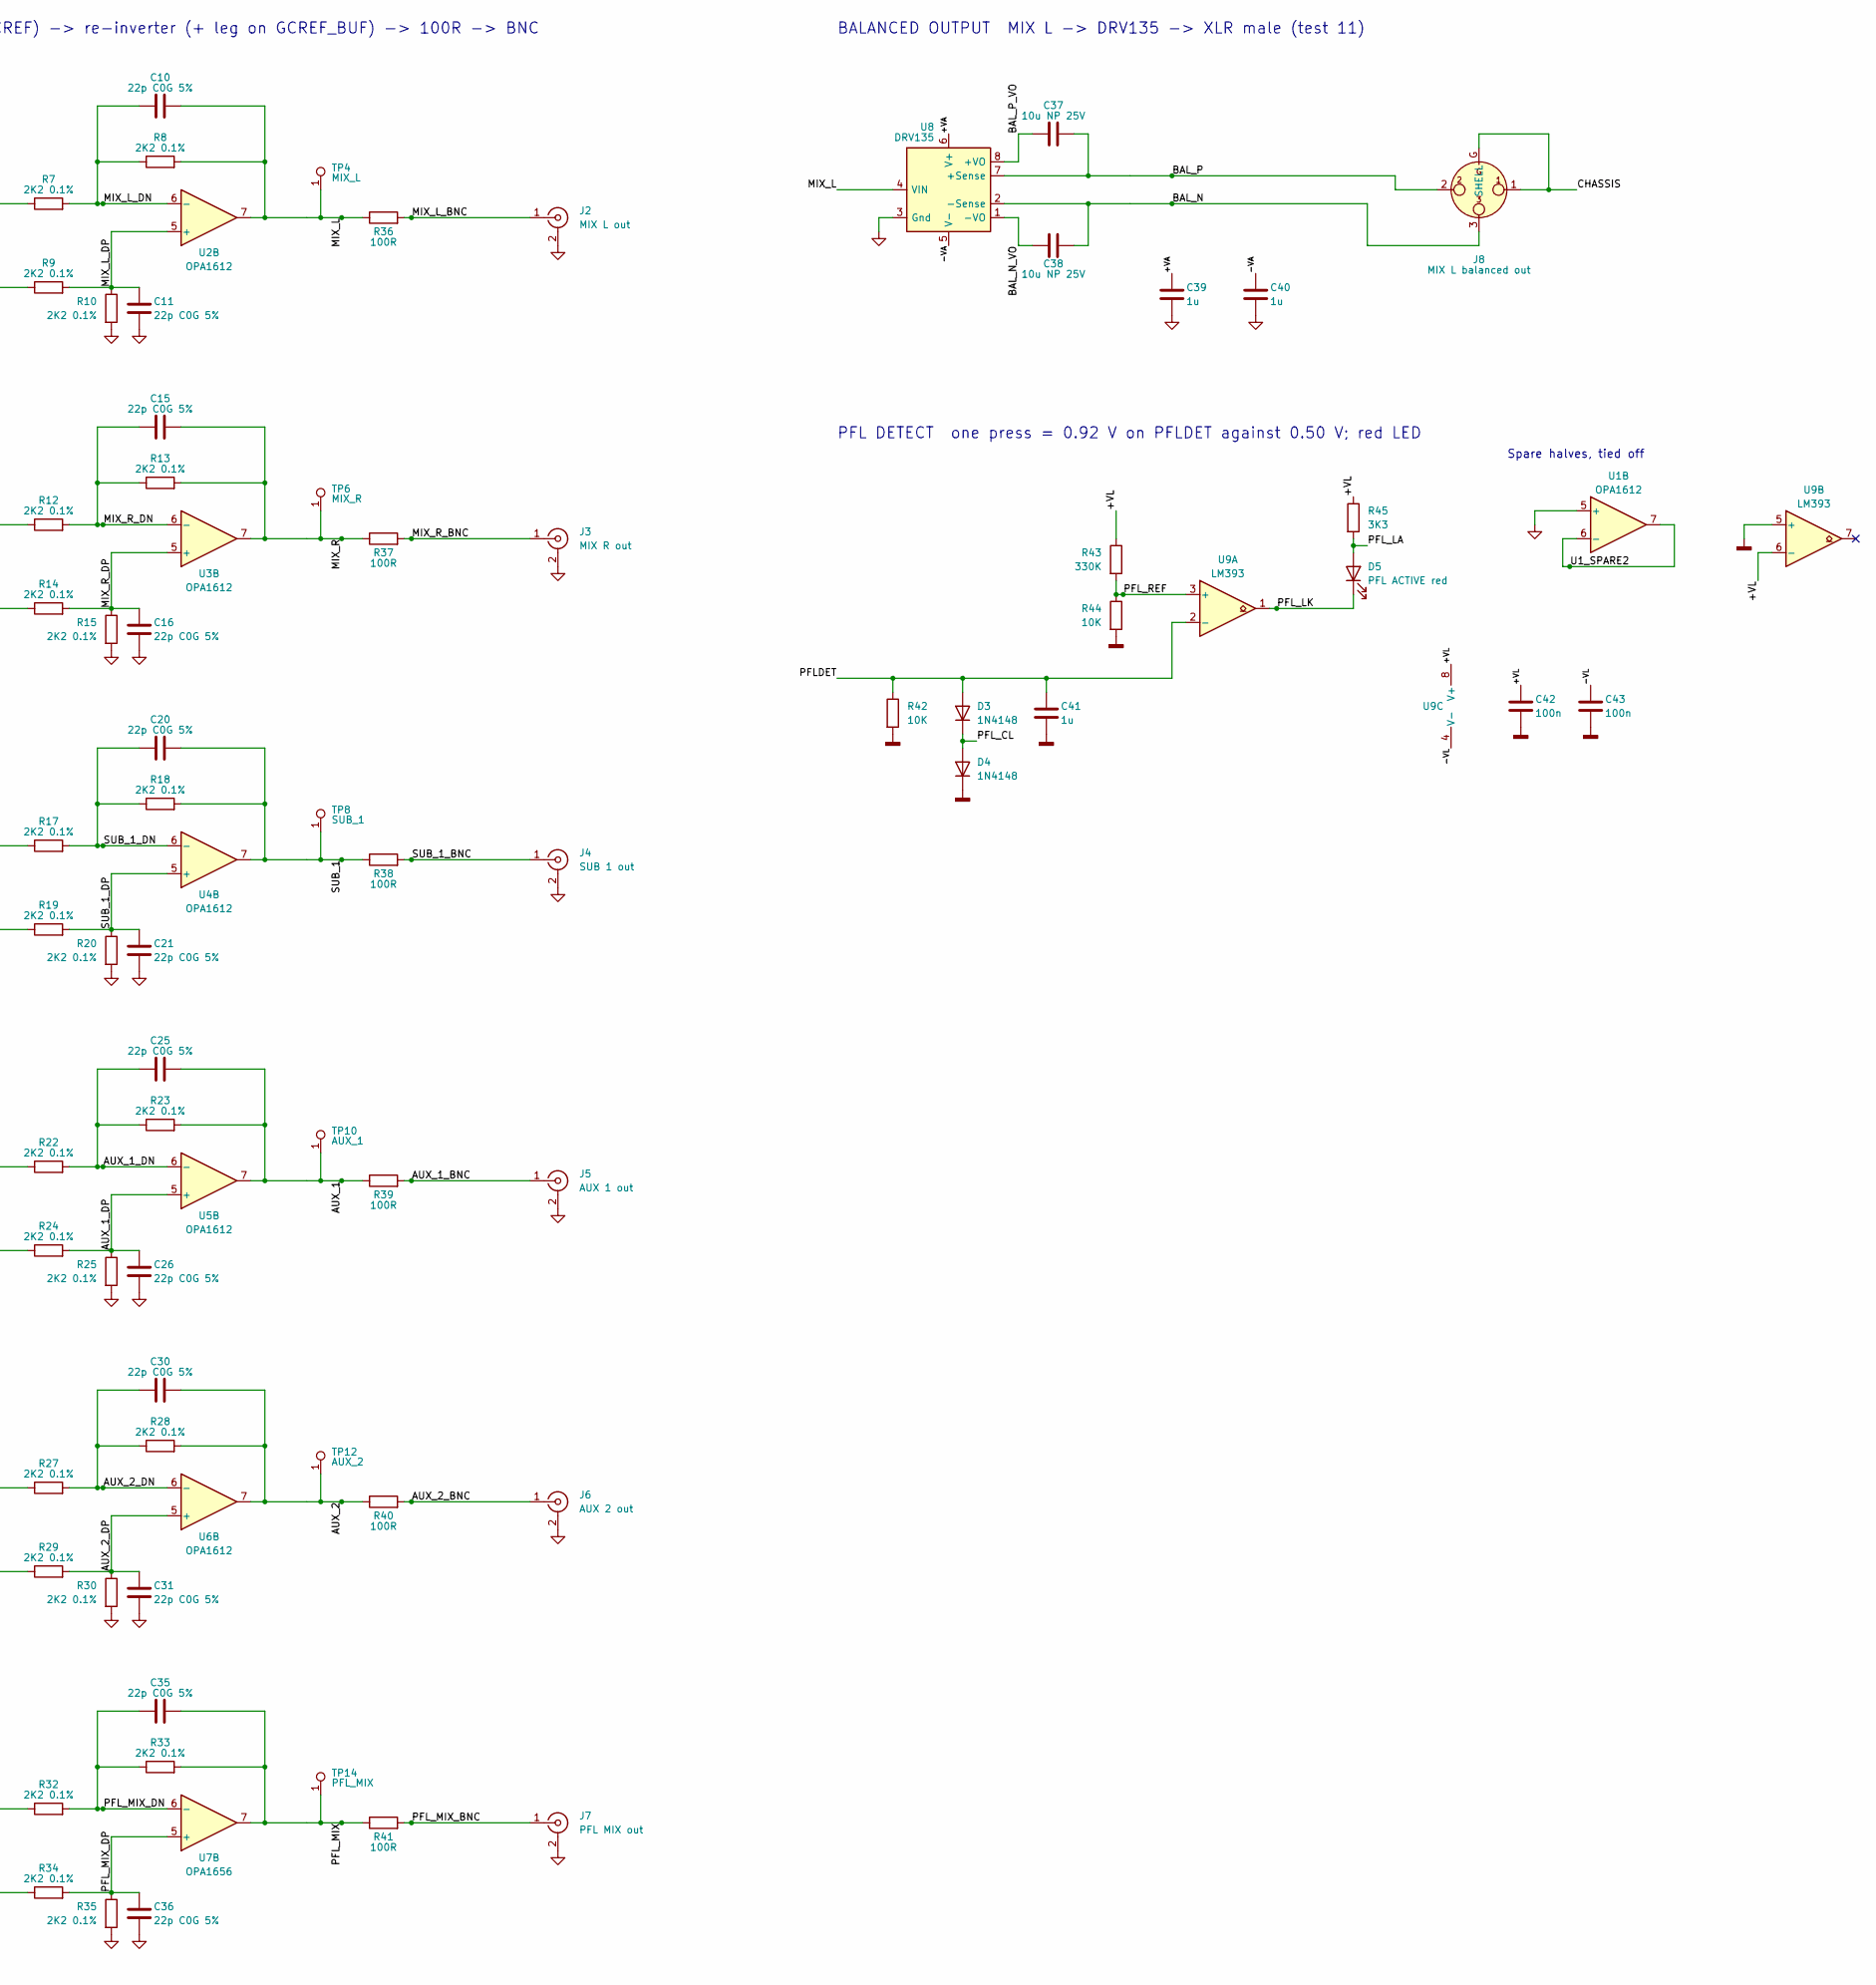
[picture p91: schematic jig_master_stub.kicad_sch, Test jig - master stub (goa console), part in row 1, column 2]

Parts:
C1, C2: 470u 25V; CP_Radial_D10.0mm_P5.00mm; MPN Nichicon UPW1E471MPD
C3, C4: 47u 25V; CP_Radial_D8.0mm_P3.50mm; MPN Nichicon UPW1J470MPD (63V)
C5, C6, C7, C8, C12, C13, C17, C18, C22, C23, C27, C28, C32, C33, C42, C43: 100n; C_0805_2012Metric; MPN Samsung CL21B104KBCNNNC (X7R 50V)
C9, C14, C19, C24, C29, C34: 100p C0G; C_0805_2012Metric; MPN KEMET C0805C101J5GACTU
C10, C11, C15, C16, C20, C21, C25, C26, C30, C31, C35, C36: 22p C0G 5%; C_0805_2012Metric; MPN KEMET C0805C220J5GACTU
C37, C38: 10u NP 25V; CP_Radial_D5.0mm_P2.00mm; MPN Panasonic ECE-A1EN100U
C39, C40, C41: 1u; C_1206_3216Metric; MPN Samsung CL31B105KBHNNNE (X7R 50V)
CN1: Ground spade 6.3mm (to the ground bar); Keystone_1287-ST_FastOn_Tab_6.35mm; MPN Keystone 1287-ST
CN2: Bus 2x17 (ribbon); IDC-Header_2x17_P2.54mm_Vertical; MPN Wurth 61203421621 (2x17 box header)
D1, D2: SS54; D_SMC; MPN Diodes B540C-13-F (SS54 class, SMC 40 V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
D3, D4: 1N4148; D_DO-35_SOD27_P7.62mm_Horizontal; MPN Vishay 1N4148-TAP
D5: PFL ACTIVE red; LED_D3.0mm; MPN Kingbright WP710A10ID
F1, F2: MF-RX160/72; Fuse_Bourns_MF-RX160-72_Radial_P5.08mm; MPN Bourns MF-RX160/72-0
FB1, FB2, FB3, FB4, FB5, FB6: Ferrite 220R@100MHz; L_0805_2012Metric; MPN Murata BLM21PG221SN1D
J1: Bench supply +V / 0 V / -V; TerminalBlock_Phoenix_MKDS-1,5-3-5.08_1x03_P5.08mm_Horizont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; MPN Phoenix 1715734 MKDS 1,5/3-5,08
J2: MIX L out; BNC_Amphenol_B6252HB-NPP3G-50_Horizontal; MPN Amphenol B6252HB-NPP3G-50
J3: MIX R out; BNC_Amphenol_B6252HB-NPP3G-50_Horizontal; MPN Amphenol B6252HB-NPP3G-50
J4: SUB 1 out; BNC_Amphenol_B6252HB-NPP3G-50_Horizontal; MPN Amphenol B6252HB-NPP3G-50
J5: AUX 1 out; BNC_Amphenol_B6252HB-NPP3G-50_Horizontal; MPN Amphenol B6252HB-NPP3G-50
J6: AUX 2 out; BNC_Amphenol_B6252HB-NPP3G-50_Horizontal; MPN Amphenol B6252HB-NPP3G-50
J7: PFL MIX out; BNC_Amphenol_B6252HB-NPP3G-50_Horizontal; MPN Amphenol B6252HB-NPP3G-50
J8: MIX L balanced out; Jack_XLR_Neutrik_NC3MAH_Horizontal; MPN Neutrik NC3MAH
JP1: GC REF (1-2 D, 2-3 A); PinHeader_1x03_P2.54mm_Vertical; MPN 2.54 mm header + shunt
JP2: GC TIE (fit = 22R tie); PinHeader_1x02_P2.54mm_Vertical; MPN 2.54 mm header + shunt
NT1: Star GNDA-GNDD; NetTie-2_SMD_Pad0.5mm
NT2: Star GNDA-CHASSIS; NetTie-2_SMD_Pad0.5mm
R1, R2: 1R; R_0805_2012Metric; MPN Panasonic ERJ-P06J1R0V
R3, R4: 10R; R_0805_2012Metric
R5: 22R; R_0805_2012Metric
R6, R11, R16: 4K7 1%; R_0805_2012Metric
R7, R8, R9, R10, R12, R13, R14, R15, R17, R18, R19, R20, R22, R23, R24, R25, R27, R28, R29, R30, R32, R33, R34, R35: 2K2 0.1%; R_0805_2012Metric; MPN Panasonic ERA-6AEB222V
R21, R26, R31: 22K 1%; R_0805_2012Metric
R36, R37, R38, R39, R40, R41: 100R; R_0805_2012Metric
R42, R44: 10K; R_0805_2012Metric
R43: 330K; R_0805_2012Metric
R45: 3K3; R_0805_2012Metric; MPN Panasonic ERJ-P06J332V
TP1: GCANCEL; TestPoint_Keystone_5010-5014_Multipurpose; MPN Keystone 5010
TP2: GCREF_BUF; TestPoint_Keystone_5010-5014_Multipurpose; MPN Keystone 5010
TP3: SUM_ML; TestPoint_Keystone_5010-5014_Multipurpose; MPN Keystone 5010
TP4: MIX_L; TestPoint_Keystone_5010-5014_Multipurpose; MPN Keystone 5010
TP5: SUM_MR; TestPoint_Keystone_5010-5014_Multipurpose; MPN Keystone 5010
TP6: MIX_R; TestPoint_Keystone_5010-5014_Multipurpose; MPN Keystone 5010
TP7: SUM_S1; TestPoint_Keystone_5010-5014_Multipurpose; MPN Keystone 5010
TP8: SUB_1; TestPoint_Keystone_5010-5014_Multipurpose; MPN Keystone 5010
TP9: SUM_A1; TestPoint_Keystone_5010-5014_Multipurpose; MPN Keystone 5010
TP10: AUX_1; TestPoint_Keystone_5010-5014_Multipurpose; MPN Keystone 5010
TP11: SUM_A2; TestPoint_Keystone_5010-5014_Multipurpose; MPN Keystone 5010
TP12: AUX_2; TestPoint_Keystone_5010-5014_Multipurpose; MPN Keystone 5010
TP13: SUM_P; TestPoint_Keystone_5010-5014_Multipurpose; MPN Keystone 5010
TP14: PFL_MIX; TestPoint_Keystone_5010-5014_Multipurpose; MPN Keystone 5010
TP15: +VA; TestPoint_Keystone_5010-5014_Multipurpose; MPN Keystone 5010
TP16: -VA; TestPoint_Keystone_5010-5014_Multipurpose; MPN Keystone 5010
TP17: +VBUS_R; TestPoint_Keystone_5010-5014_Multipurpose; MPN Keystone 5010
TP18: -VBUS_R; TestPoint_Keystone_5010-5014_Multipurpose; MPN Keystone 5010
TP19, TP20: GNDA; TestPoint_Keystone_5010-5014_Multipurpose; MPN Keystone 5010
U1, U2, U3, U4, U5, U6: OPA1612; SOIC-8_3.9x4.9mm_P1.27mm; MPN TI OPA1612AIDR
U7: OPA1656; SOIC-8_3.9x4.9mm_P1.27mm; MPN TI OPA1656IDR
U8: DRV135; SOIC-8_3.9x4.9mm_P1.27mm; MPN TI DRV135UA
U9: LM393; SOIC-8_3.9x4.9mm_P1.27mm; MPN TI LM393BIDR

Connections:
/+VA: C1.1, C5.1, C7.1, C12.1, C17.1, C22.1, C27.1, C32.1, C39.1, R1.2, TP15.1, U1.8 (V+), U2.8 (V+), U3.8 (V+), U4.8 (V+), U5.8 (V+), U6.8 (V+), U7.8 (V+), U8.6 (V+)
/+VBUS: D1.1 (K), F1.1, J1.1, R1.1, R3.1
/+VBUS_R: CN2.32, CN2.33, CN2.34, F1.2, TP17.1
/+VL: C3.1, C42.1, R3.2, R43.1, R45.1, U9.6 (-), U9.8 (V+)
/-VA: C2.2, C6.2, C8.2, C13.2, C18.2, C23.2, C28.2, C33.2, C40.2, R2.2, TP16.1, U1.4 (V-), U2.4 (V-), U3.4 (V-), U4.4 (V-), U5.4 (V-), U6.4 (V-), U7.4 (V-), U8.5 (V-)
/-VBUS: D2.2 (A), F2.1, J1.3, R2.1, R4.1
/-VBUS_R: CN2.30, CN2.31, F2.2, TP18.1
/-VL: C4.2, C43.2, R4.2, U9.4 (V-)
/AUX1: CN2.24, FB4.1
/AUX1_VE: C24.2, FB4.2, R21.2, U5.2 (-)
/AUX2: CN2.25, FB5.1
/AUX2_VE: C29.2, FB5.2, R26.2, U6.2 (-)
/AUX_1: C25.1, R23.2, R39.1, TP10.1, U5.7
/AUX_1_BNC: J5.1 (In), R39.2
/AUX_1_DN: C25.2, R22.2, R23.1, U5.6 (-)
/AUX_1_DP: C26.1, R24.2, R25.1, U5.5 (+)
/AUX_2: C30.1, R28.2, R40.1, TP12.1, U6.7
/AUX_2_BNC: J6.1 (In), R40.2
/AUX_2_DN: C30.2, R27.2, R28.1, U6.6 (-)
/AUX_2_DP: C31.1, R29.2, R30.1, U6.5 (+)
/BAL_N: C38.2, J8.3, U8.2 (-Sense)
/BAL_N_VO: C38.1, U8.1 (-VO)
/BAL_P: C37.2, J8.2, U8.7 (+Sense)
/BAL_P_VO: C37.1, U8.8 (+VO)
/CHASSIS: J8.1, J8.G (SHELL), NT2.2
/GCANCEL: CN2.26, JP1.1, R5.1, TP1.1
/GCREF: JP1.2, U1.3 (+), U2.3 (+), U3.3 (+), U4.3 (+), U5.3 (+), U6.3 (+), U7.3 (+)
/GCREF_BUF: R9.1, R14.1, R19.1, R24.1, R29.1, R34.1, TP2.1, U1.1, U1.2 (-)
/GC_TIE: JP2.1, R5.2
/MIXL: CN2.18, FB1.1
/MIXL_VE: C9.2, FB1.2, R6.2, U2.2 (-)
/MIXR: CN2.17, FB2.1
/MIXR_VE: C14.2, FB2.2, R11.2, U3.2 (-)
/MIX_L: C10.1, R8.2, R36.1, TP4.1, U2.7, U8.4 (VIN)
/MIX_L_BNC: J2.1 (In), R36.2
/MIX_L_DN: C10.2, R7.2, R8.1, U2.6 (-)
/MIX_L_DP: C11.1, R9.2, R10.1, U2.5 (+)
/MIX_R: C15.1, R13.2, R37.1, TP6.1, U3.7
/MIX_R_BNC: J3.1 (In), R37.2
/MIX_R_DN: C15.2, R12.2, R13.1, U3.6 (-)
/MIX_R_DP: C16.1, R14.2, R15.1, U3.5 (+)
/PFL: CN2.27, FB6.1
/PFLDET: C41.1, CN2.29, D3.2 (A), R42.1, U9.2 (-)
/PFL_CL: D3.1 (K), D4.2 (A)
/PFL_LA: D5.2 (A), R45.2
/PFL_LK: D5.1 (K), U9.1
/PFL_MIX: C35.1, R33.2, R41.1, TP14.1, U7.7
/PFL_MIX_BNC: J7.1 (In), R41.2
/PFL_MIX_DN: C35.2, R32.2, R33.1, U7.6 (-)
/PFL_MIX_DP: C36.1, R34.2, R35.1, U7.5 (+)
/PFL_REF: R43.2, R44.1, U9.3 (+)
/PFL_VE: C34.2, FB6.2, R31.2, U7.2 (-)
/SUB1: CN2.15, FB3.1
/SUB1_VE: C19.2, FB3.2, R16.2, U4.2 (-)
/SUB_1: C20.1, R18.2, R38.1, TP8.1, U4.7
/SUB_1_BNC: J4.1 (In), R38.2
/SUB_1_DN: C20.2, R17.2, R18.1, U4.6 (-)
/SUB_1_DP: C21.1, R19.2, R20.1, U4.5 (+)
/SUM_A1: C24.1, R21.1, R22.1, TP9.1, U5.1
/SUM_A2: C29.1, R26.1, R27.1, TP11.1, U6.1
/SUM_ML: C9.1, R6.1, R7.1, TP3.1, U2.1
/SUM_MR: C14.1, R11.1, R12.1, TP5.1, U3.1
/SUM_P: C34.1, R31.1, R32.1, TP13.1, U7.1
/SUM_S1: C19.1, R16.1, R17.1, TP7.1, U4.1
/U1_SPARE2: U1.6 (-), U1.7
GNDA: C1.2, C2.1, C5.2, C6.1, C7.2, C8.1, C11.2, C12.2, C13.1, C16.2, C17.2, C18.1, C21.2, C22.2, C23.1, C26.2, C27.2, C28.1, C31.2, C32.2, C33.1, C36.2, C39.2, C40.1, CN1.1, CN2.2, CN2.4, CN2.6, CN2.8, CN2.9, CN2.10, CN2.11, CN2.12, CN2.13, CN2.14, CN2.16, CN2.20, CN2.21, CN2.22, CN2.23, D1.2 (A), D2.1 (K), J1.2, J2.2 (Ext), J3.2 (Ext), J4.2 (Ext), J5.2 (Ext), J6.2 (Ext), J7.2 (Ext), JP1.3, JP2.2, NT1.1, NT2.1, R10.2, R15.2, R20.2, R25.2, R30.2, R35.2, TP19.1, TP20.1, U1.5 (+), U8.3 (Gnd)
GNDD: C3.2, C4.1, C41.2, C42.2, C43.1, D4.1 (K), NT1.2, R42.2, R44.2, U9.5 (+)

Notes on the sheet:
POWER IN bench +-17 V, reverse Schottkys, a PTC per rail to the ribbon, local VA / VL
RIBBON 34-pin header, Delta pinout; SUB 2-4 and AUX 3-6 on AGND
GROUND-CANCEL REFERENCE config jumper, 22R tie, buffer
JP1 1-2: config D, ground cancel. 2-3: config A, the stub's own AGND.
JP2 fitted: 22R from GCANCEL to AGND, the master-end tie of test 3.
BUS AMPS bus -> ferrite -> summer (+ on GCREF) -> re-inverter (+ leg on GCREF_BUF) -> 100R -> BNC
MIX L
MIX R
SUB 1
AUX 1
AUX 2
PFL
BALANCED OUTPUT MIX L -> DRV135 -> XLR male (test 11)
PFL DETECT one press = 0.92 V on PFLDET against 0.50 V; red LED
Spare halves, tied off

Board: 2 copper layers, 148 parts (0 on the bottom side), 67 nets, no tracks yet.

Other parts of the board:
H1, H2, H3, H4: M3 standoff; MountingHole_3.2mm_M3
