cozycactus/goa-console/boards/group/group.kicad_pcb

## KiCad design boards/group/group.kicad_pcb (2026-11-11)

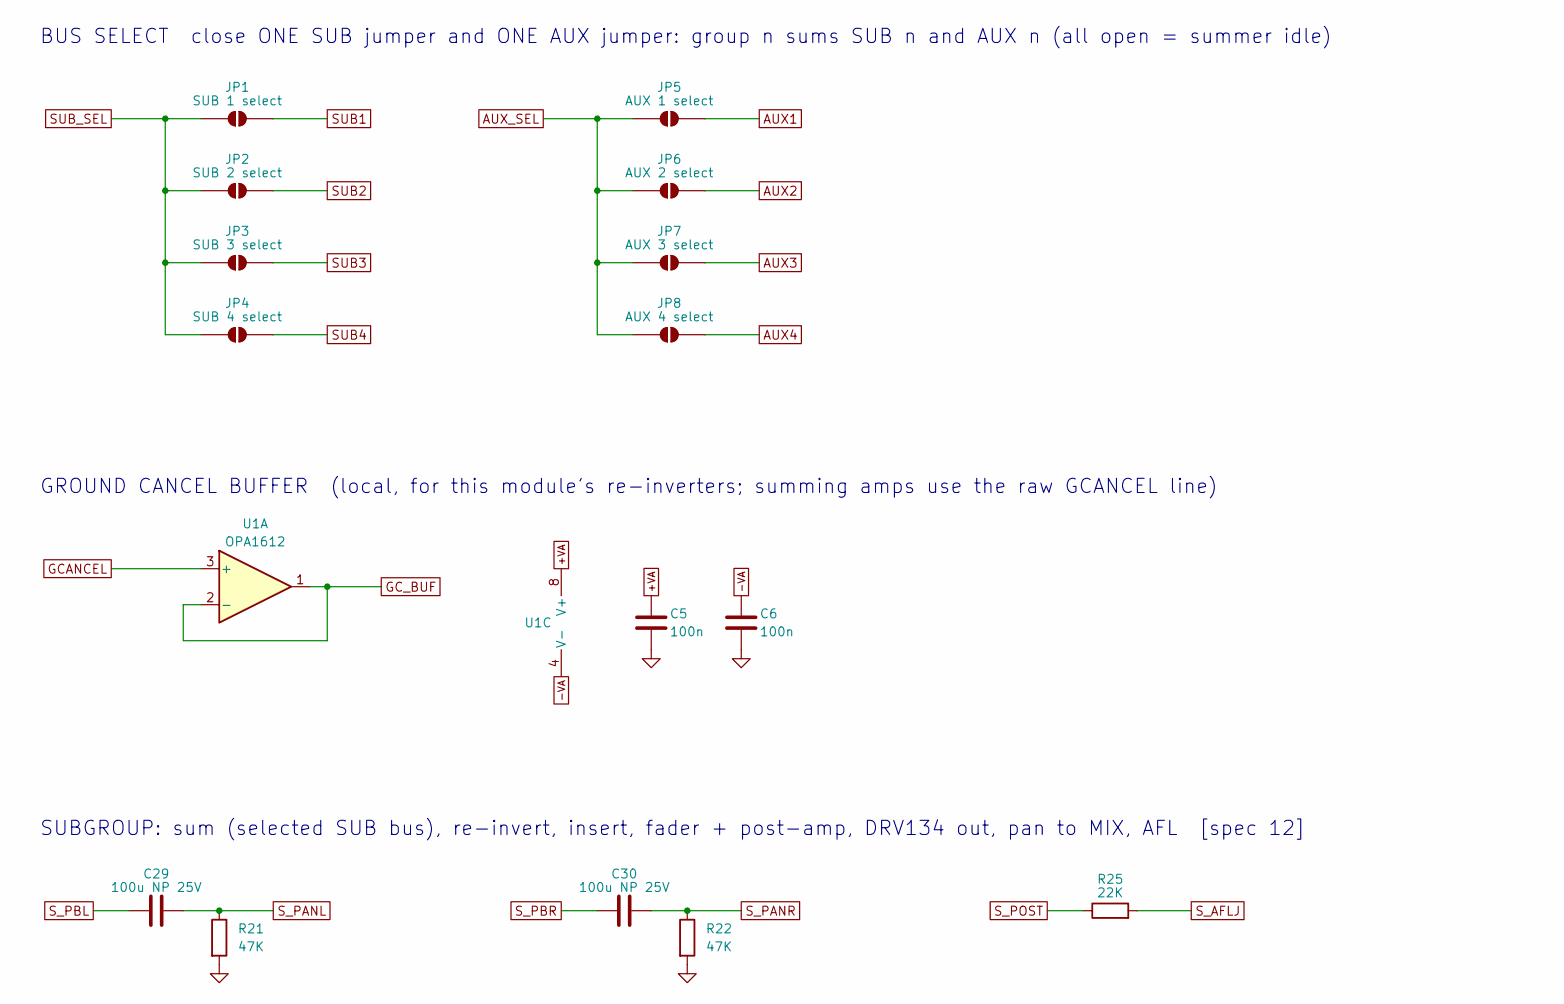
[picture p92: schematic 02_bus_select.kicad_sch, BUS SELECT, GROUND CANCEL BUFFER, SUBGROUP]

Parts:
C5, C6: 100n; C_0805_2012Metric; MPN Samsung CL21B104KBCNNNC (X7R 50V)
C29, C30: 100u NP 25V; CP_Radial_D10.0mm_P5.00mm; MPN Nichicon UES1E101MPM (MUSE ES)
JP1: SUB 1 select; SolderJumper-2_P1.3mm_Open_RoundedPad1.0x1.5mm
JP2: SUB 2 select; SolderJumper-2_P1.3mm_Open_RoundedPad1.0x1.5mm
JP3: SUB 3 select; SolderJumper-2_P1.3mm_Open_RoundedPad1.0x1.5mm
JP4: SUB 4 select; SolderJumper-2_P1.3mm_Open_RoundedPad1.0x1.5mm
JP5: AUX 1 select; SolderJumper-2_P1.3mm_Open_RoundedPad1.0x1.5mm
JP6: AUX 2 select; SolderJumper-2_P1.3mm_Open_RoundedPad1.0x1.5mm
JP7: AUX 3 select; SolderJumper-2_P1.3mm_Open_RoundedPad1.0x1.5mm
JP8: AUX 4 select; SolderJumper-2_P1.3mm_Open_RoundedPad1.0x1.5mm
R21, R22: 47K; R_0805_2012Metric
R25: 22K; R_0805_2012Metric
U1: OPA1612; SOIC-8_3.9x4.9mm_P1.27mm; MPN TI OPA1612AIDR

Connections:
+VA: C5.1, U1.8 (V+); also elsewhere on the board
-VA: C6.2, U1.4 (V-); also elsewhere on the board
AUX1: JP5.2 (B); also elsewhere on the board
AUX2: JP6.2 (B); also elsewhere on the board
AUX3: JP7.2 (B); also elsewhere on the board
AUX4: JP8.2 (B); also elsewhere on the board
AUX_SEL: JP5.1 (A), JP6.1 (A), JP7.1 (A), JP8.1 (A); also elsewhere on the board
GCANCEL: U1.3 (+); also elsewhere on the board
GC_BUF: U1.1, U1.2 (-); also elsewhere on the board
GNDA: C5.2, C6.1, R21.2, R22.2; also elsewhere on the board
SUB1: JP1.2 (B); also elsewhere on the board
SUB2: JP2.2 (B); also elsewhere on the board
SUB3: JP3.2 (B); also elsewhere on the board
SUB4: JP4.2 (B); also elsewhere on the board
SUB_SEL: JP1.1 (A), JP2.1 (A), JP3.1 (A), JP4.1 (A); also elsewhere on the board
S_AFLJ: R25.2; also elsewhere on the board
S_PANL: C29.2, R21.1; also elsewhere on the board
S_PANR: C30.2, R22.1; also elsewhere on the board
S_PBL: C29.1; also elsewhere on the board
S_PBR: C30.1; also elsewhere on the board
S_POST: R25.1; also elsewhere on the board

Notes on the sheet:
BUS SELECT close ONE SUB jumper and ONE AUX jumper: group n sums SUB n and AUX n (all open = summer idle)
GROUND CANCEL BUFFER (local, for this module's re-inverters; summing amps use the raw GCANCEL line)
SUBGROUP: sum (selected SUB bus), re-invert, insert, fader + post-amp, DRV134 out, pan to MIX, AFL [spec 12]

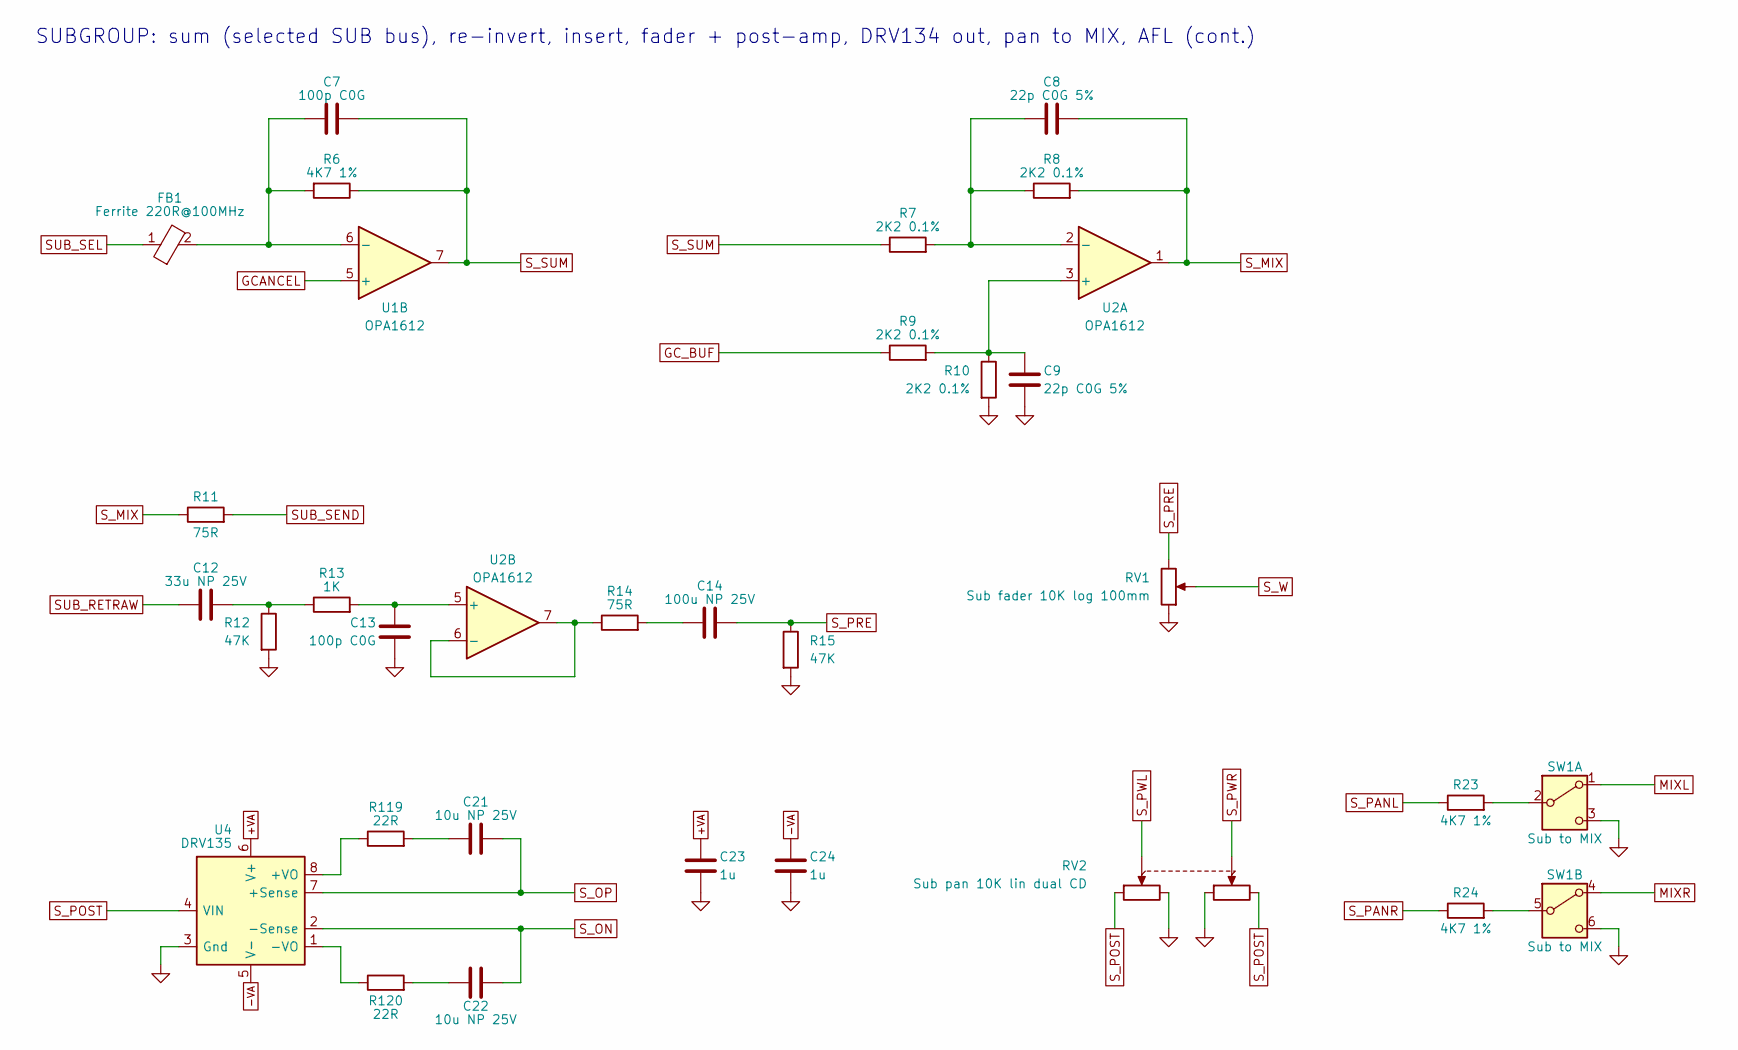
[picture p93: schematic 03_subgroup.kicad_sch, SUBGROUP]

Parts:
C7, C13: 100p C0G; C_0805_2012Metric; MPN KEMET C0805C101J5GACTU
C8, C9: 22p C0G 5%; C_0805_2012Metric; MPN KEMET C0805C220J5GACTU
C12: 33u NP 25V; CP_Radial_D8.0mm_P3.50mm; MPN Nichicon UES1E330MPM (MUSE ES)
C14: 100u NP 25V; CP_Radial_D10.0mm_P5.00mm; MPN Nichicon UES1E101MPM (MUSE ES)
C21, C22: 10u NP 25V; CP_Radial_D5.0mm_P2.00mm; MPN Panasonic ECE-A1EN100U (matched pair: t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
C23, C24: 1u; C_1206_3216Metric; MPN Samsung CL31B105KBHNNNE (X7R 50V)
FB1: Ferrite 220R@100MHz; L_0805_2012Metric; MPN Murata BLM21PG221SN1D
R6, R23, R24: 4K7 1%; R_0805_2012Metric
R7, R8, R9, R10: 2K2 0.1%; R_0805_2012Metric; MPN Panasonic ERA-6AEB222V
R11: 75R; R_0805_2012Metric; MPN Panasonic ERJ-P06J750V
R12, R15: 47K; R_0805_2012Metric
R13: 1K; R_0805_2012Metric
R14: 75R; R_0805_2012Metric
R119, R120: 22R; R_0805_2012Metric; MPN Panasonic ERJ-P06J220V
RV1: Sub fader 10K log 100mm; Potentiometer_Bourns_PTB0143_Slide_100mm; MPN Bourns PTB0143-2010BPA103
RV2: Sub pan 10K lin dual CD; Potentiometer_Alps_RK09L_Double_Vertical; MPN ALPS RK09L1240015
SW1: Sub to MIX; SW_Push_2P2T_Toggle_CK_PVA2xxH1xxxxxxV2; MPN C&K PVA2 EE H1 1.7N V2
U1, U2: OPA1612; SOIC-8_3.9x4.9mm_P1.27mm; MPN TI OPA1612AIDR
U4: DRV135; SOIC-8_3.9x4.9mm_P1.27mm; MPN TI DRV135UA

Connections:
+VA: C23.1, U4.6 (V+); also elsewhere on the board
-VA: C24.2, U4.5 (V-); also elsewhere on the board
GCANCEL: U1.5 (+); also elsewhere on the board
GC_BUF: R9.1; also elsewhere on the board
GNDA: C9.2, C13.2, C23.2, C24.1, R10.2, R12.2, R15.2, RV1.1, RV2.3, RV2.4, SW1.3 (C), SW1.6 (C), U4.3 (Gnd); also elsewhere on the board
MIXL: SW1.1 (A); also elsewhere on the board
MIXR: SW1.4 (A); also elsewhere on the board
unnamed: C12.2, R12.1, R13.1
unnamed: C14.1, R14.2
unnamed: C21.1, R119.2
unnamed: C22.1, R120.2
unnamed: R23.2, SW1.2 (B)
unnamed: R24.2, SW1.5 (B)
unnamed: C7.2, FB1.2, R6.2, U1.6 (-)
unnamed: C9.1, R9.2, R10.1, U2.3 (+)
unnamed: C8.2, R7.2, R8.1, U2.2 (-)
unnamed: C13.1, R13.2, U2.5 (+)
unnamed: R14.1, U2.6 (-), U2.7
unnamed: R119.1, U4.8 (+VO)
unnamed: R120.1, U4.1 (-VO)
SUB_RETRAW: C12.1; also elsewhere on the board
SUB_SEL: FB1.1; also elsewhere on the board
SUB_SEND: R11.2; also elsewhere on the board
S_MIX: C8.1, R8.2, R11.1, U2.1
S_ON: C22.2, U4.2 (-Sense); also elsewhere on the board
S_OP: C21.2, U4.7 (+Sense); also elsewhere on the board
S_PANL: R23.1; also elsewhere on the board
S_PANR: R24.1; also elsewhere on the board
S_POST: RV2.1, RV2.6, U4.4 (VIN); also elsewhere on the board
S_PRE: C14.2, R15.1, RV1.3
S_PWL: RV2.2; also elsewhere on the board
S_PWR: RV2.5; also elsewhere on the board
S_SUM: C7.1, R6.1, R7.1, U1.7
S_W: RV1.2; also elsewhere on the board

Notes on the sheet:
SUBGROUP: sum (selected SUB bus), re-invert, insert, fader + post-amp, DRV134 out, pan to MIX, AFL (cont.)

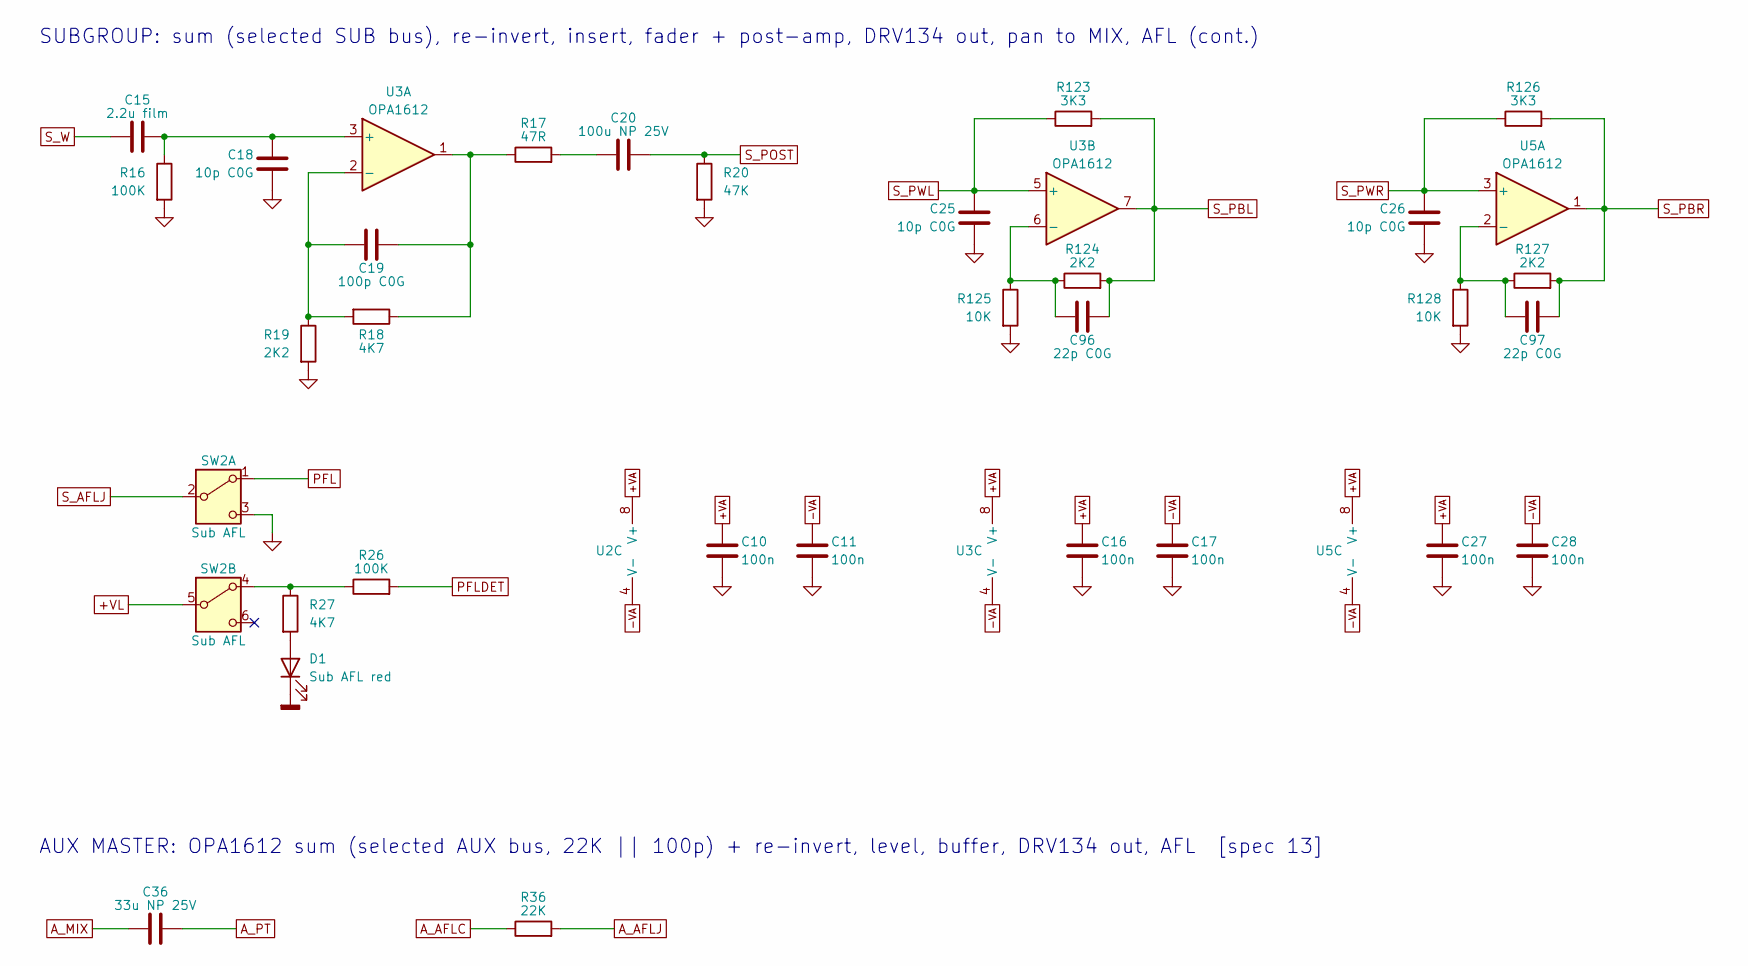
[picture p94: schematic 04_subgroup.kicad_sch, SUBGROUP, AUX MASTER]

Parts:
C10, C11, C16, C17, C27, C28: 100n; C_0805_2012Metric; MPN Samsung CL21B104KBCNNNC (X7R 50V)
C15: 2.2u film; C_Rect_L7.2mm_W7.2mm_P5.00mm_FKS2_FKP2_MKS2_MKP2; MPN KEMET MMK5225K63J06L4BULK (PET 63V; rep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
C18, C25, C26: 10p C0G; C_0805_2012Metric; MPN KEMET C0805C100J5GACTU
C19: 100p C0G; C_0805_2012Metric; MPN KEMET C0805C101J5GACTU
C20: 100u NP 25V; CP_Radial_D10.0mm_P5.00mm; MPN Nichicon UES1E101MPM (MUSE ES)
C36: 33u NP 25V; CP_Radial_D8.0mm_P3.50mm; MPN Nichicon UES1E330MPM (MUSE ES)
C96, C97: 22p C0G; C_0805_2012Metric; MPN KEMET C0805C220J5GACTU
D1: Sub AFL red; LED_D3.0mm; MPN Kingbright WP710A10ID
R16, R26: 100K; R_0805_2012Metric
R17: 47R; R_0805_2012Metric
R18, R27: 4K7; R_0805_2012Metric
R19, R124, R127: 2K2; R_0805_2012Metric
R20: 47K; R_0805_2012Metric
R36: 22K; R_0805_2012Metric
R123, R126: 3K3; R_0805_2012Metric
R125, R128: 10K; R_0805_2012Metric
SW2: Sub AFL; SW_Push_2P2T_Toggle_CK_PVA2xxH1xxxxxxV2; MPN C&K PVA2 EE H1 1.7N V2
U2, U3, U5: OPA1612; SOIC-8_3.9x4.9mm_P1.27mm; MPN TI OPA1612AIDR

Connections:
+VA: C10.1, C16.1, C27.1, U2.8 (V+), U3.8 (V+), U5.8 (V+); also elsewhere on the board
+VL: SW2.5 (B); also elsewhere on the board
-VA: C11.2, C17.2, C28.2, U2.4 (V-), U3.4 (V-), U5.4 (V-); also elsewhere on the board
A_AFLC: R36.1; also elsewhere on the board
A_AFLJ: R36.2; also elsewhere on the board
A_MIX: C36.1; also elsewhere on the board
A_PT: C36.2; also elsewhere on the board
GNDA: C10.2, C11.1, C16.2, C17.1, C18.2, C25.2, C26.2, C27.2, C28.1, R16.2, R19.2, R20.2, R125.2, R128.2, SW2.3 (C); also elsewhere on the board
GNDD: D1.1 (K); also elsewhere on the board
unnamed: C19.1, R17.1, R18.1, U3.1
unnamed: C20.1, R17.2
unnamed: D1.2 (A), R27.2
unnamed: R26.1, R27.1, SW2.4 (A)
unnamed: C15.2, C18.1, R16.1, U3.3 (+)
unnamed: C19.2, R18.2, R19.1, U3.2 (-)
unnamed: C96.1, R124.1, R125.1, U3.6 (-)
unnamed: C97.1, R127.1, R128.1, U5.2 (-)
PFL: SW2.1 (A); also elsewhere on the board
PFLDET: R26.2; also elsewhere on the board
S_AFLJ: SW2.2 (B); also elsewhere on the board
S_PBL: C96.2, R123.2, R124.2, U3.7; also elsewhere on the board
S_PBR: C97.2, R126.2, R127.2, U5.1; also elsewhere on the board
S_POST: C20.2, R20.1; also elsewhere on the board
S_PWL: C25.1, R123.1, U3.5 (+); also elsewhere on the board
S_PWR: C26.1, R126.1, U5.3 (+); also elsewhere on the board
S_W: C15.1; also elsewhere on the board

Notes on the sheet:
SUBGROUP: sum (selected SUB bus), re-invert, insert, fader + post-amp, DRV134 out, pan to MIX, AFL (cont.)
AUX MASTER: OPA1612 sum (selected AUX bus, 22K || 100p) + re-invert, level, buffer, DRV134 out, AFL [spec 13]
