cozycactus/goa-console/boards/group/group.kicad_pcb

## KiCad design boards/group/group.kicad_pcb (continued)

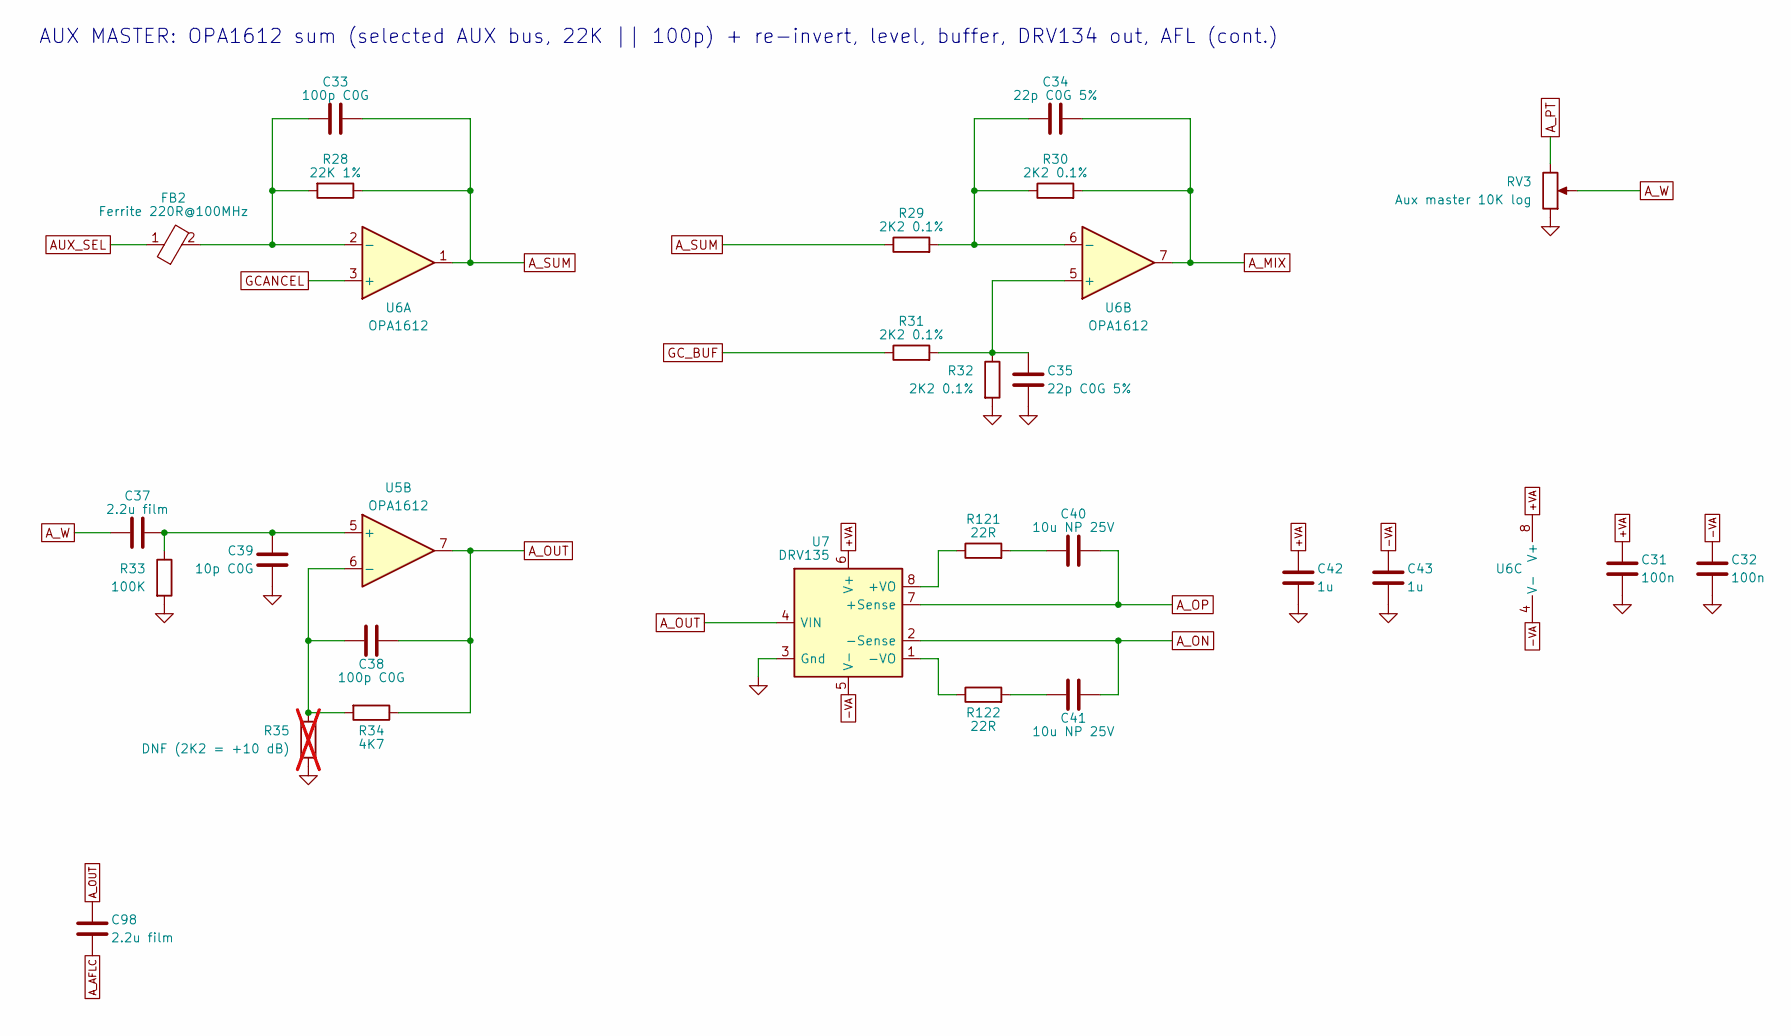
[picture p95: schematic 05_aux_master.kicad_sch, AUX MASTER]

Parts:
C31, C32: 100n; C_0805_2012Metric; MPN Samsung CL21B104KBCNNNC (X7R 50V)
C33, C38: 100p C0G; C_0805_2012Metric; MPN KEMET C0805C101J5GACTU
C34, C35: 22p C0G 5%; C_0805_2012Metric; MPN KEMET C0805C220J5GACTU
C37, C98: 2.2u film; C_Rect_L7.2mm_W7.2mm_P5.00mm_FKS2_FKP2_MKS2_MKP2; MPN KEMET MMK5225K63J06L4BULK (PET 63V; rep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
C39: 10p C0G; C_0805_2012Metric; MPN KEMET C0805C100J5GACTU
C40, C41: 10u NP 25V; CP_Radial_D5.0mm_P2.00mm; MPN Panasonic ECE-A1EN100U (matched pair: t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
C42, C43: 1u; C_1206_3216Metric; MPN Samsung CL31B105KBHNNNE (X7R 50V)
FB2: Ferrite 220R@100MHz; L_0805_2012Metric; MPN Murata BLM21PG221SN1D
R28: 22K 1%; R_0805_2012Metric
R29, R30, R31, R32: 2K2 0.1%; R_0805_2012Metric; MPN Panasonic ERA-6AEB222V
R33: 100K; R_0805_2012Metric
R34: 4K7; R_0805_2012Metric
R35: DNF (2K2 = +10 dB); R_0805_2012Metric; not fitted
R121, R122: 22R; R_0805_2012Metric; MPN Panasonic ERJ-P06J220V
RV3: Aux master 10K log; Potentiometer_Alpha_RD901F-40-00D_Single_Vertical; MPN Alpha RD901F-40-15R1-A10K
U5, U6: OPA1612; SOIC-8_3.9x4.9mm_P1.27mm; MPN TI OPA1612AIDR
U7: DRV135; SOIC-8_3.9x4.9mm_P1.27mm; MPN TI DRV135UA

Connections:
+VA: C31.1, C42.1, U6.8 (V+), U7.6 (V+); also elsewhere on the board
-VA: C32.2, C43.2, U6.4 (V-), U7.5 (V-); also elsewhere on the board
AUX_SEL: FB2.1; also elsewhere on the board
A_AFLC: C98.2; also elsewhere on the board
A_MIX: C34.1, R30.2, U6.7; also elsewhere on the board
A_ON: C41.2, U7.2 (-Sense); also elsewhere on the board
A_OP: C40.2, U7.7 (+Sense); also elsewhere on the board
A_OUT: C38.1, C98.1, R34.1, U5.7, U7.4 (VIN)
A_PT: RV3.3; also elsewhere on the board
A_SUM: C33.1, R28.1, R29.1, U6.1
A_W: C37.1, RV3.2
GCANCEL: U6.3 (+); also elsewhere on the board
GC_BUF: R31.1; also elsewhere on the board
GNDA: C31.2, C32.1, C35.2, C39.2, C42.2, C43.1, R32.2, R33.2, R35.2, RV3.1, U7.3 (Gnd); also elsewhere on the board
unnamed: C40.1, R121.2
unnamed: C41.1, R122.2
unnamed: C37.2, C39.1, R33.1, U5.5 (+)
unnamed: C38.2, R34.2, R35.1, U5.6 (-)
unnamed: C33.2, FB2.2, R28.2, U6.2 (-)
unnamed: C35.1, R31.2, R32.1, U6.5 (+)
unnamed: C34.2, R29.2, R30.1, U6.6 (-)
unnamed: R121.1, U7.8 (+VO)
unnamed: R122.1, U7.1 (-VO)

Notes on the sheet:
AUX MASTER: OPA1612 sum (selected AUX bus, 22K || 100p) + re-invert, level, buffer, DRV134 out, AFL (cont.)

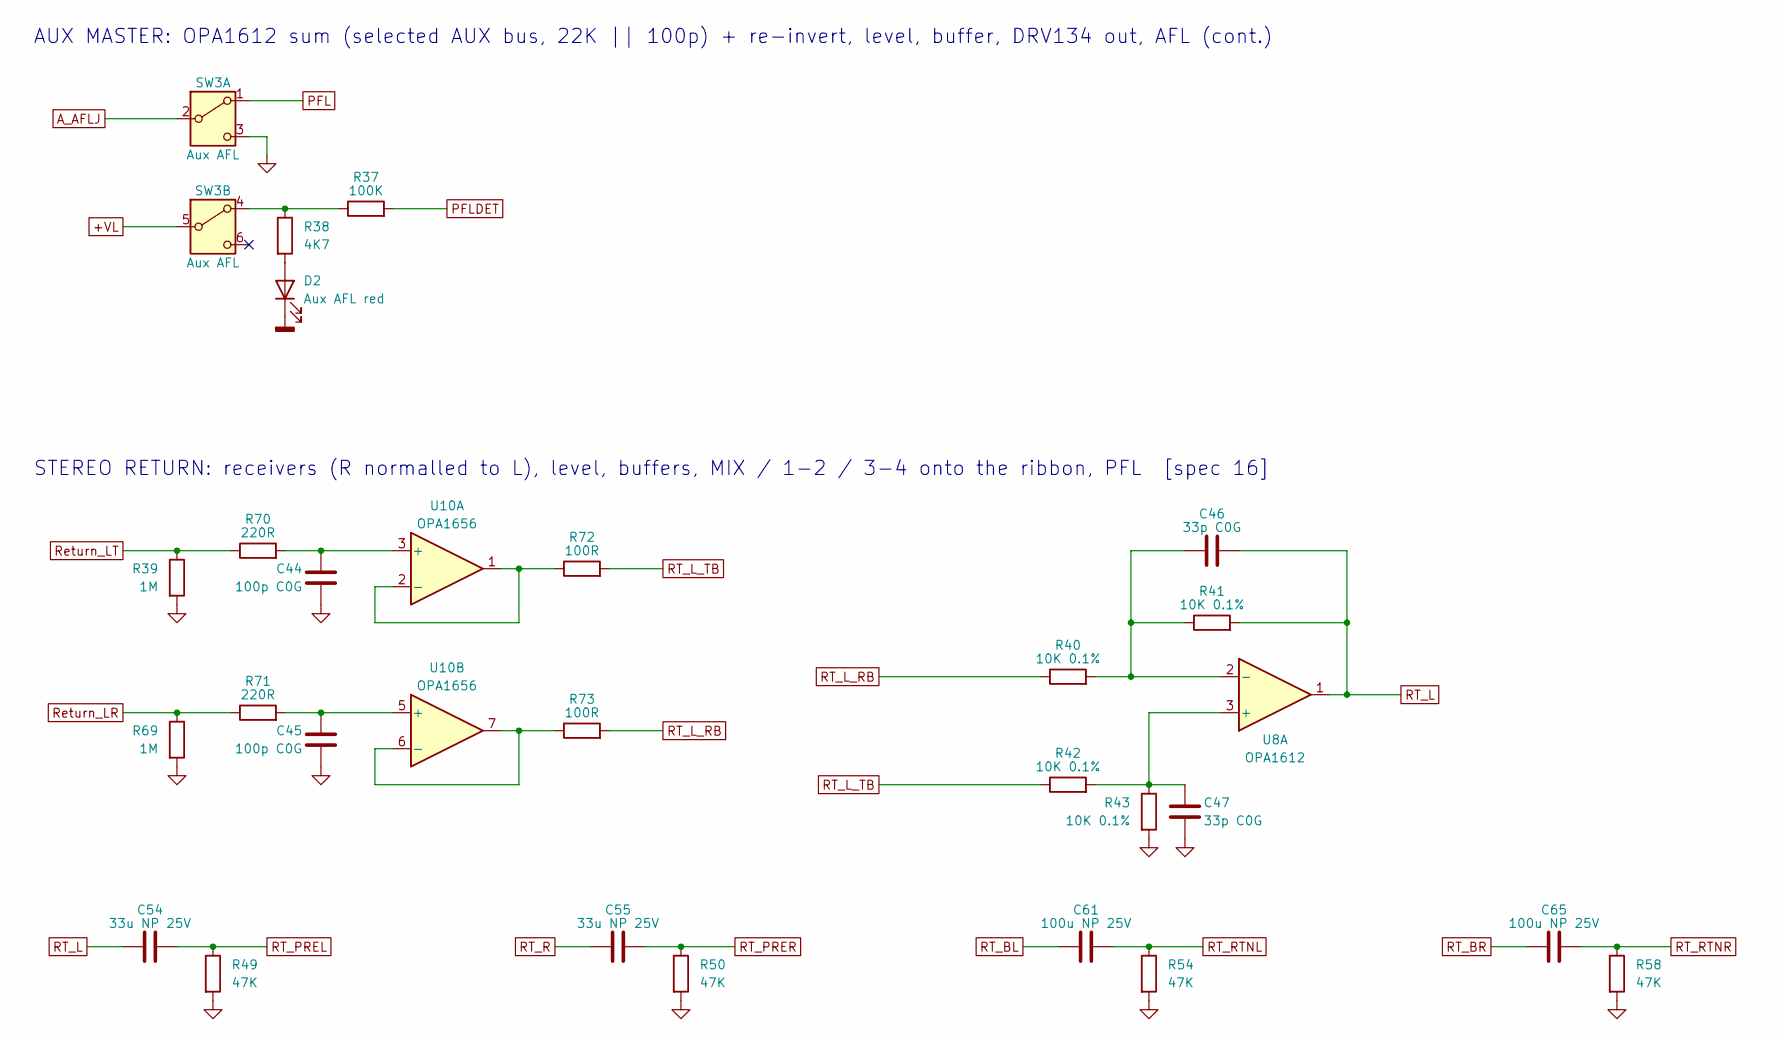
[picture p96: schematic 06_aux_master.kicad_sch, AUX MASTER, STEREO RETURN]

Parts:
C44, C45: 100p C0G; C_0805_2012Metric; MPN KEMET C0805C101J5GACTU
C46, C47: 33p C0G; C_0805_2012Metric; MPN KEMET C0805C330J5GACTU
C54, C55: 33u NP 25V; CP_Radial_D8.0mm_P3.50mm; MPN Nichicon UES1E330MPM (MUSE ES)
C61, C65: 100u NP 25V; CP_Radial_D10.0mm_P5.00mm; MPN Nichicon UES1E101MPM (MUSE ES)
D2: Aux AFL red; LED_D3.0mm; MPN Kingbright WP710A10ID
R37: 100K; R_0805_2012Metric
R38: 4K7; R_0805_2012Metric
R39, R69: 1M; R_0805_2012Metric
R40, R41, R42, R43: 10K 0.1%; R_0805_2012Metric; MPN Panasonic ERA-6AEB103V
R49, R50, R54, R58: 47K; R_0805_2012Metric
R70, R71: 220R; R_0805_2012Metric
R72, R73: 100R; R_0805_2012Metric
SW3: Aux AFL; SW_Push_2P2T_Toggle_CK_PVA2xxH1xxxxxxV2; MPN C&K PVA2 EE H1 1.7N V2
U8: OPA1612; SOIC-8_3.9x4.9mm_P1.27mm; MPN TI OPA1612AIDR
U10: OPA1656; SOIC-8_3.9x4.9mm_P1.27mm; MPN TI OPA1656IDR

Connections:
+VL: SW3.5 (B); also elsewhere on the board
A_AFLJ: SW3.2 (B); also elsewhere on the board
GNDA: C44.2, C45.2, C47.2, R39.2, R43.2, R49.2, R50.2, R54.2, R58.2, R69.2, SW3.3 (C); also elsewhere on the board
GNDD: D2.1 (K); also elsewhere on the board
unnamed: D2.2 (A), R38.2
unnamed: R37.1, R38.1, SW3.4 (A)
unnamed: C47.1, R42.2, R43.1, U8.3 (+)
unnamed: C46.1, R40.2, R41.1, U8.2 (-)
unnamed: C44.1, R70.2, U10.3 (+)
unnamed: R72.1, U10.1, U10.2 (-)
unnamed: C45.1, R71.2, U10.5 (+)
unnamed: R73.1, U10.6 (-), U10.7
PFL: SW3.1 (A); also elsewhere on the board
PFLDET: R37.2; also elsewhere on the board
RT_BL: C61.1; also elsewhere on the board
RT_BR: C65.1; also elsewhere on the board
RT_L: C46.2, C54.1, R41.2, U8.1
RT_L_RB: R40.1, R73.2
RT_L_TB: R42.1, R72.2
RT_PREL: C54.2, R49.1; also elsewhere on the board
RT_PRER: C55.2, R50.1; also elsewhere on the board
RT_R: C55.1; also elsewhere on the board
RT_RTNL: C61.2, R54.1; also elsewhere on the board
RT_RTNR: C65.2, R58.1; also elsewhere on the board
Return_LR: R69.1, R71.1; also elsewhere on the board
Return_LT: R39.1, R70.1; also elsewhere on the board

Notes on the sheet:
AUX MASTER: OPA1612 sum (selected AUX bus, 22K || 100p) + re-invert, level, buffer, DRV134 out, AFL (cont.)
STEREO RETURN: receivers (R normalled to L), level, buffers, MIX / 1-2 / 3-4 onto the ribbon, PFL [spec 16]

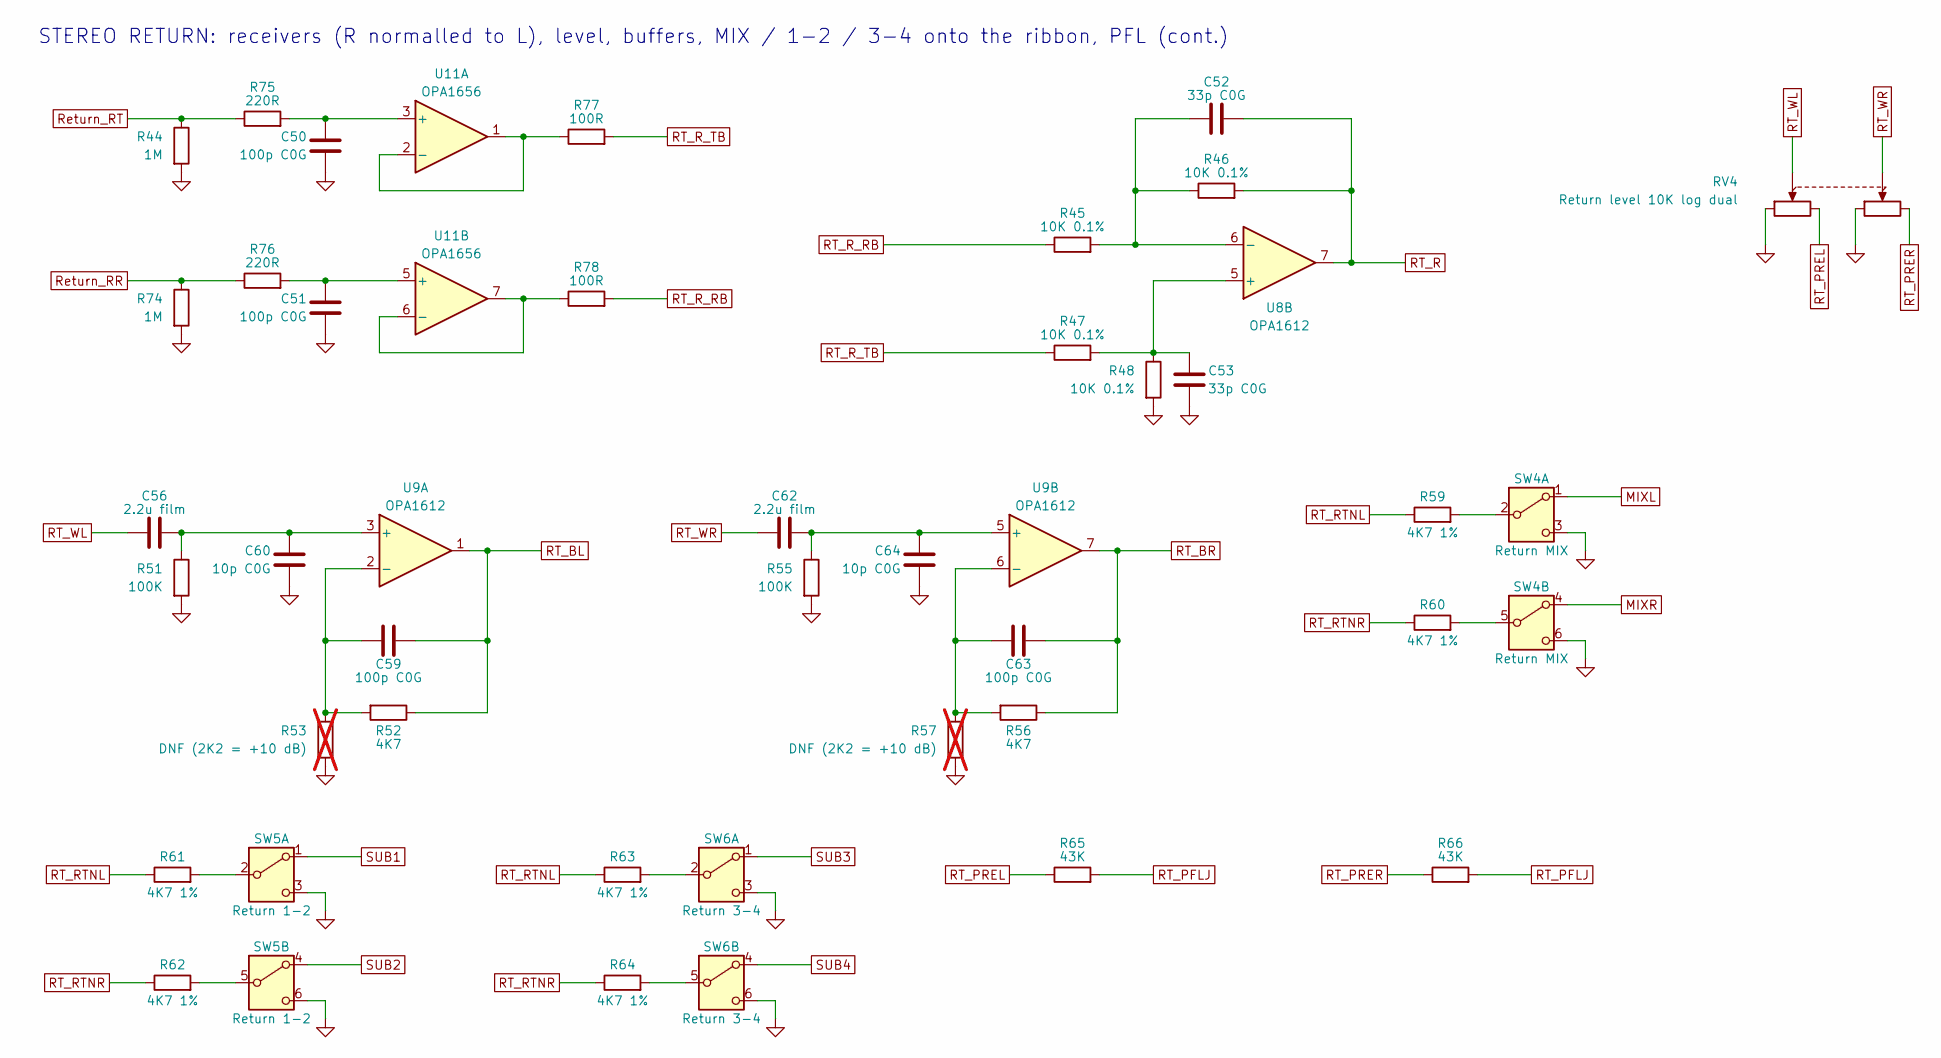
[picture p97: schematic 07_stereo_return.kicad_sch, STEREO RETURN]

Parts:
C50, C51, C59, C63: 100p C0G; C_0805_2012Metric; MPN KEMET C0805C101J5GACTU
C52, C53: 33p C0G; C_0805_2012Metric; MPN KEMET C0805C330J5GACTU
C56, C62: 2.2u film; C_Rect_L7.2mm_W7.2mm_P5.00mm_FKS2_FKP2_MKS2_MKP2; MPN KEMET MMK5225K63J06L4BULK (PET 63V; rep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
C60, C64: 10p C0G; C_0805_2012Metric; MPN KEMET C0805C100J5GACTU
R44, R74: 1M; R_0805_2012Metric
R45, R46, R47, R48: 10K 0.1%; R_0805_2012Metric; MPN Panasonic ERA-6AEB103V
R51, R55: 100K; R_0805_2012Metric
R52, R56: 4K7; R_0805_2012Metric
R53, R57: DNF (2K2 = +10 dB); R_0805_2012Metric; not fitted
R59, R60, R61, R62, R63, R64: 4K7 1%; R_0805_2012Metric
R65, R66: 43K; R_0805_2012Metric
R75, R76: 220R; R_0805_2012Metric
R77, R78: 100R; R_0805_2012Metric
RV4: Return level 10K log dual; Potentiometer_Alpha_RD902F-40-00D_Dual_Vertical; MPN Alpha RD902F-40-15R1-A10K (dual, log)
SW4: Return MIX; SW_Push_2P2T_Toggle_CK_PVA2xxH1xxxxxxV2; MPN C&K PVA2 EE H1 1.7N V2
SW5: Return 1-2; SW_Push_2P2T_Toggle_CK_PVA2xxH1xxxxxxV2; MPN C&K PVA2 EE H1 1.7N V2
SW6: Return 3-4; SW_Push_2P2T_Toggle_CK_PVA2xxH1xxxxxxV2; MPN C&K PVA2 EE H1 1.7N V2
U8, U9: OPA1612; SOIC-8_3.9x4.9mm_P1.27mm; MPN TI OPA1612AIDR
U11: OPA1656; SOIC-8_3.9x4.9mm_P1.27mm; MPN TI OPA1656IDR

Connections:
GNDA: C50.2, C51.2, C53.2, C60.2, C64.2, R44.2, R48.2, R51.2, R53.2, R55.2, R57.2, R74.2, RV4.1, RV4.4, SW4.3 (C), SW4.6 (C), SW5.3 (C), SW5.6 (C), SW6.3 (C), SW6.6 (C); also elsewhere on the board
MIXL: SW4.1 (A); also elsewhere on the board
MIXR: SW4.4 (A); also elsewhere on the board
unnamed: R59.2, SW4.2 (B)
unnamed: R60.2, SW4.5 (B)
unnamed: R61.2, SW5.2 (B)
unnamed: R62.2, SW5.5 (B)
unnamed: R63.2, SW6.2 (B)
unnamed: R64.2, SW6.5 (B)
unnamed: C53.1, R47.2, R48.1, U8.5 (+)
unnamed: C52.1, R45.2, R46.1, U8.6 (-)
unnamed: C56.2, C60.1, R51.1, U9.3 (+)
unnamed: C59.2, R52.2, R53.1, U9.2 (-)
unnamed: C62.2, C64.1, R55.1, U9.5 (+)
unnamed: C63.2, R56.2, R57.1, U9.6 (-)
unnamed: C50.1, R75.2, U11.3 (+)
unnamed: R77.1, U11.1, U11.2 (-)
unnamed: C51.1, R76.2, U11.5 (+)
unnamed: R78.1, U11.6 (-), U11.7
RT_BL: C59.1, R52.1, U9.1; also elsewhere on the board
RT_BR: C63.1, R56.1, U9.7; also elsewhere on the board
RT_PFLJ: R65.2, R66.2; also elsewhere on the board
RT_PREL: R65.1, RV4.3; also elsewhere on the board
RT_PRER: R66.1, RV4.6; also elsewhere on the board
RT_R: C52.2, R46.2, U8.7; also elsewhere on the board
RT_RTNL: R59.1, R61.1, R63.1; also elsewhere on the board
RT_RTNR: R60.1, R62.1, R64.1; also elsewhere on the board
RT_R_RB: R45.1, R78.2
RT_R_TB: R47.1, R77.2
RT_WL: C56.1, RV4.2
RT_WR: C62.1, RV4.5
Return_RR: R74.1, R76.1; also elsewhere on the board
Return_RT: R44.1, R75.1; also elsewhere on the board
SUB1: SW5.1 (A); also elsewhere on the board
SUB2: SW5.4 (A); also elsewhere on the board
SUB3: SW6.1 (A); also elsewhere on the board
SUB4: SW6.4 (A); also elsewhere on the board

Notes on the sheet:
STEREO RETURN: receivers (R normalled to L), level, buffers, MIX / 1-2 / 3-4 onto the ribbon, PFL (cont.)

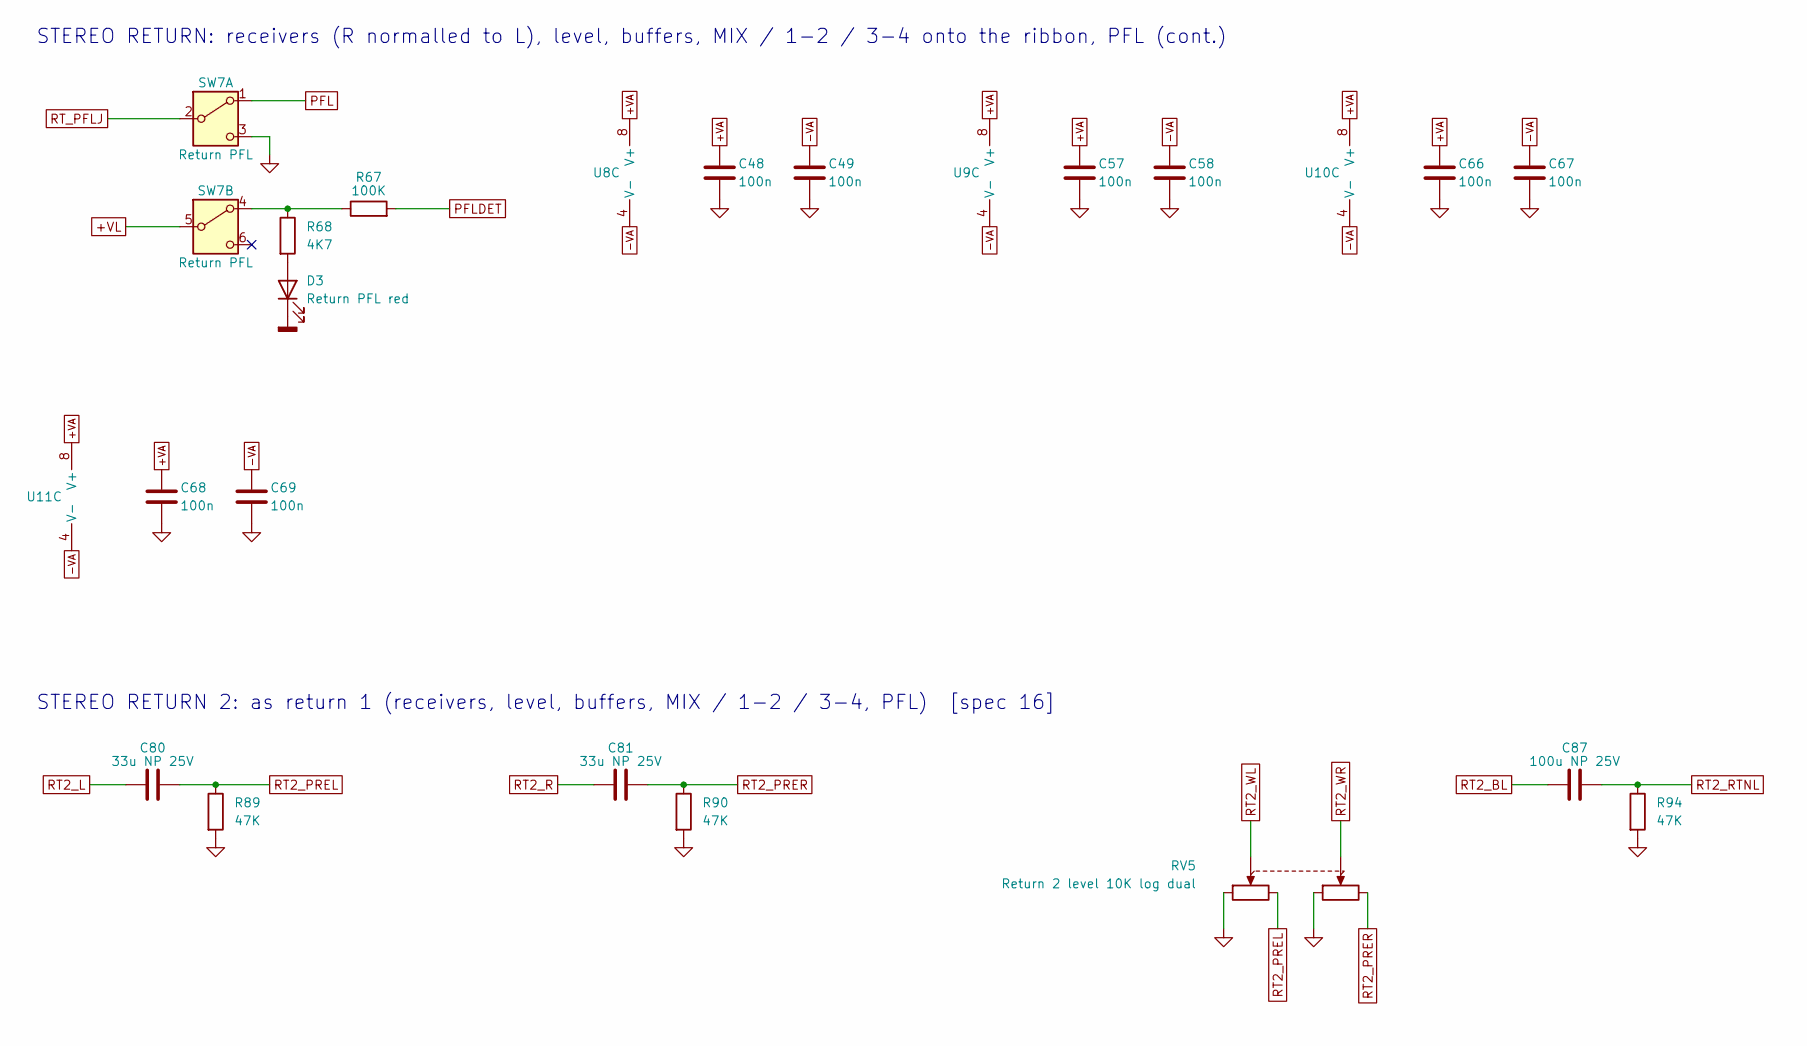
[picture p98: schematic 08_stereo_return.kicad_sch, STEREO RETURN, STEREO RETURN 2]

Parts:
C48, C49, C57, C58, C66, C67, C68, C69: 100n; C_0805_2012Metric; MPN Samsung CL21B104KBCNNNC (X7R 50V)
C80, C81: 33u NP 25V; CP_Radial_D8.0mm_P3.50mm; MPN Nichicon UES1E330MPM (MUSE ES)
C87: 100u NP 25V; CP_Radial_D10.0mm_P5.00mm; MPN Nichicon UES1E101MPM (MUSE ES)
D3: Return PFL red; LED_D3.0mm; MPN Kingbright WP710A10ID
R67: 100K; R_0805_2012Metric
R68: 4K7; R_0805_2012Metric
R89, R90, R94: 47K; R_0805_2012Metric
RV5: Return 2 level 10K log dual; Potentiometer_Alpha_RD902F-40-00D_Dual_Vertical; MPN Alpha RD902F-40-15R1-A10K (dual, log)
SW7: Return PFL; SW_Push_2P2T_Toggle_CK_PVA2xxH1xxxxxxV2; MPN C&K PVA2 EE H1 1.7N V2
U8, U9: OPA1612; SOIC-8_3.9x4.9mm_P1.27mm; MPN TI OPA1612AIDR
U10, U11: OPA1656; SOIC-8_3.9x4.9mm_P1.27mm; MPN TI OPA1656IDR

Connections:
+VA: C48.1, C57.1, C66.1, C68.1, U8.8 (V+), U9.8 (V+), U10.8 (V+), U11.8 (V+); also elsewhere on the board
+VL: SW7.5 (B); also elsewhere on the board
-VA: C49.2, C58.2, C67.2, C69.2, U8.4 (V-), U9.4 (V-), U10.4 (V-), U11.4 (V-); also elsewhere on the board
GNDA: C48.2, C49.1, C57.2, C58.1, C66.2, C67.1, C68.2, C69.1, R89.2, R90.2, R94.2, RV5.1, RV5.4, SW7.3 (C); also elsewhere on the board
GNDD: D3.1 (K); also elsewhere on the board
unnamed: D3.2 (A), R68.2
unnamed: R67.1, R68.1, SW7.4 (A)
PFL: SW7.1 (A); also elsewhere on the board
PFLDET: R67.2; also elsewhere on the board
RT2_BL: C87.1; also elsewhere on the board
RT2_L: C80.1; also elsewhere on the board
RT2_PREL: C80.2, R89.1, RV5.3; also elsewhere on the board
RT2_PRER: C81.2, R90.1, RV5.6; also elsewhere on the board
RT2_R: C81.1; also elsewhere on the board
RT2_RTNL: C87.2, R94.1; also elsewhere on the board
RT2_WL: RV5.2; also elsewhere on the board
RT2_WR: RV5.5; also elsewhere on the board
RT_PFLJ: SW7.2 (B); also elsewhere on the board

Notes on the sheet:
STEREO RETURN: receivers (R normalled to L), level, buffers, MIX / 1-2 / 3-4 onto the ribbon, PFL (cont.)
STEREO RETURN 2: as return 1 (receivers, level, buffers, MIX / 1-2 / 3-4, PFL) [spec 16]

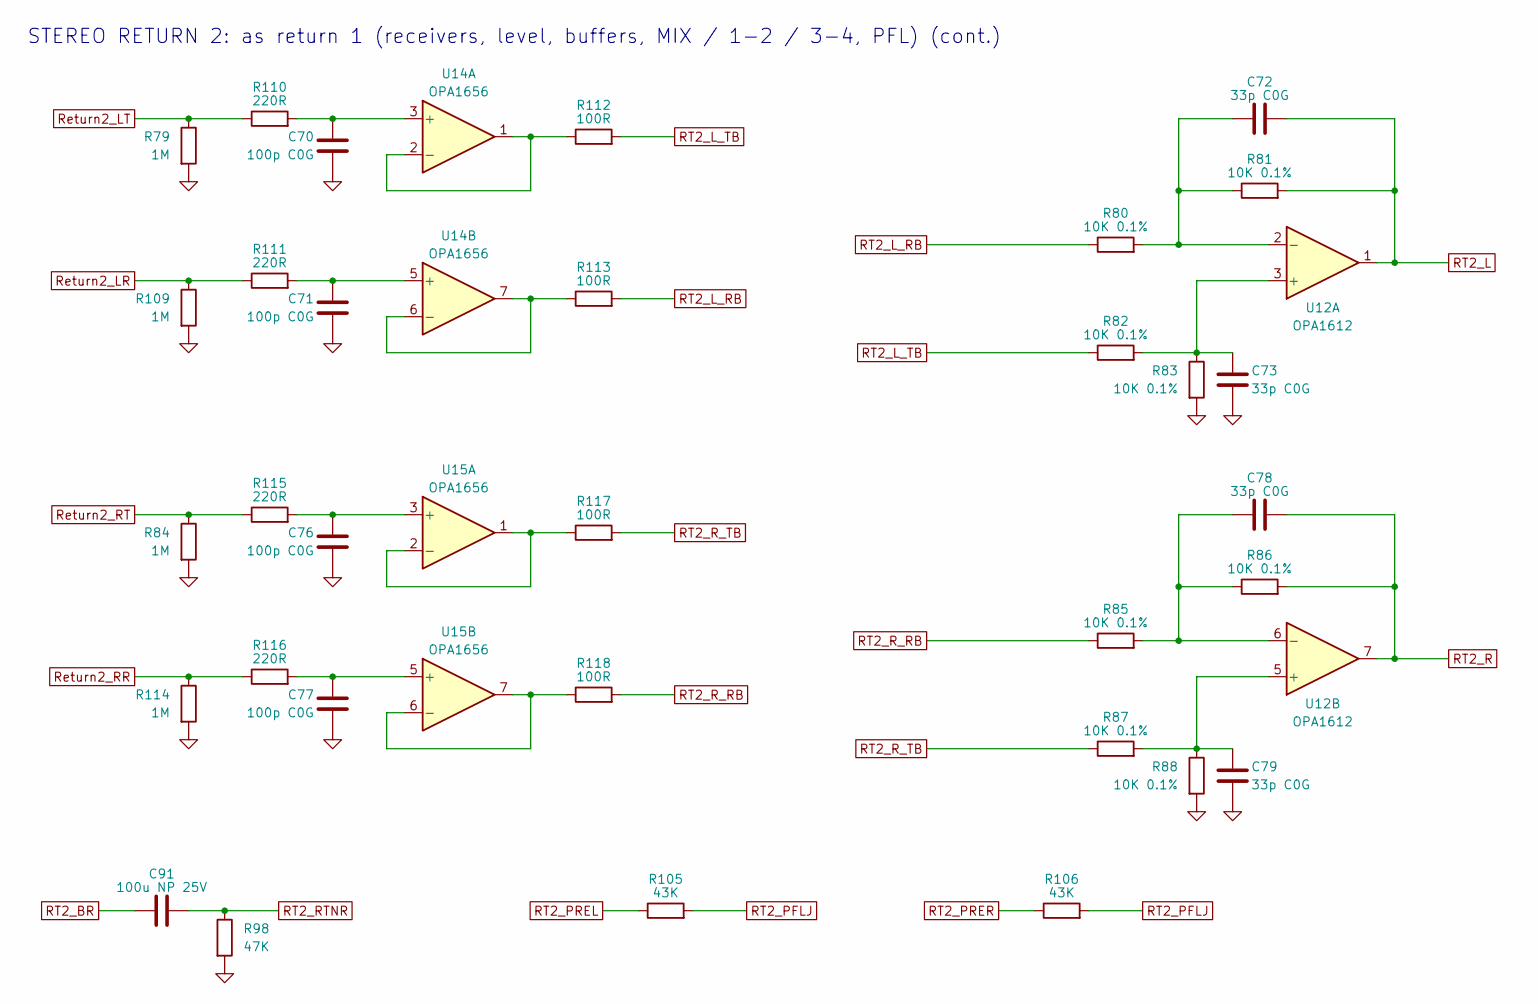
[picture p99: schematic 09_stereo_return_2.kicad_sch, STEREO RETURN 2]

Parts:
C70, C71, C76, C77: 100p C0G; C_0805_2012Metric; MPN KEMET C0805C101J5GACTU
C72, C73, C78, C79: 33p C0G; C_0805_2012Metric; MPN KEMET C0805C330J5GACTU
C91: 100u NP 25V; CP_Radial_D10.0mm_P5.00mm; MPN Nichicon UES1E101MPM (MUSE ES)
R79, R84, R109, R114: 1M; R_0805_2012Metric
R80, R81, R82, R83, R85, R86, R87, R88: 10K 0.1%; R_0805_2012Metric; MPN Panasonic ERA-6AEB103V
R98: 47K; R_0805_2012Metric
R105, R106: 43K; R_0805_2012Metric
R110, R111, R115, R116: 220R; R_0805_2012Metric
R112, R113, R117, R118: 100R; R_0805_2012Metric
U12: OPA1612; SOIC-8_3.9x4.9mm_P1.27mm; MPN TI OPA1612AIDR
U14, U15: OPA1656; SOIC-8_3.9x4.9mm_P1.27mm; MPN TI OPA1656IDR

Connections:
GNDA: C70.2, C71.2, C73.2, C76.2, C77.2, C79.2, R79.2, R83.2, R84.2, R88.2, R98.2, R109.2, R114.2; also elsewhere on the board
unnamed: C73.1, R82.2, R83.1, U12.3 (+)
unnamed: C72.1, R80.2, R81.1, U12.2 (-)
unnamed: C79.1, R87.2, R88.1, U12.5 (+)
unnamed: C78.1, R85.2, R86.1, U12.6 (-)
unnamed: C70.1, R110.2, U14.3 (+)
unnamed: R112.1, U14.1, U14.2 (-)
unnamed: C71.1, R111.2, U14.5 (+)
unnamed: R113.1, U14.6 (-), U14.7
unnamed: C76.1, R115.2, U15.3 (+)
unnamed: R117.1, U15.1, U15.2 (-)
unnamed: C77.1, R116.2, U15.5 (+)
unnamed: R118.1, U15.6 (-), U15.7
RT2_BR: C91.1; also elsewhere on the board
RT2_L: C72.2, R81.2, U12.1; also elsewhere on the board
RT2_L_RB: R80.1, R113.2
RT2_L_TB: R82.1, R112.2
RT2_PFLJ: R105.2, R106.2; also elsewhere on the board
RT2_PREL: R105.1; also elsewhere on the board
RT2_PRER: R106.1; also elsewhere on the board
RT2_R: C78.2, R86.2, U12.7; also elsewhere on the board
RT2_RTNR: C91.2, R98.1; also elsewhere on the board
RT2_R_RB: R85.1, R118.2
RT2_R_TB: R87.1, R117.2
Return2_LR: R109.1, R111.1; also elsewhere on the board
Return2_LT: R79.1, R110.1; also elsewhere on the board
Return2_RR: R114.1, R116.1; also elsewhere on the board
Return2_RT: R84.1, R115.1; also elsewhere on the board

Notes on the sheet:
STEREO RETURN 2: as return 1 (receivers, level, buffers, MIX / 1-2 / 3-4, PFL) (cont.)

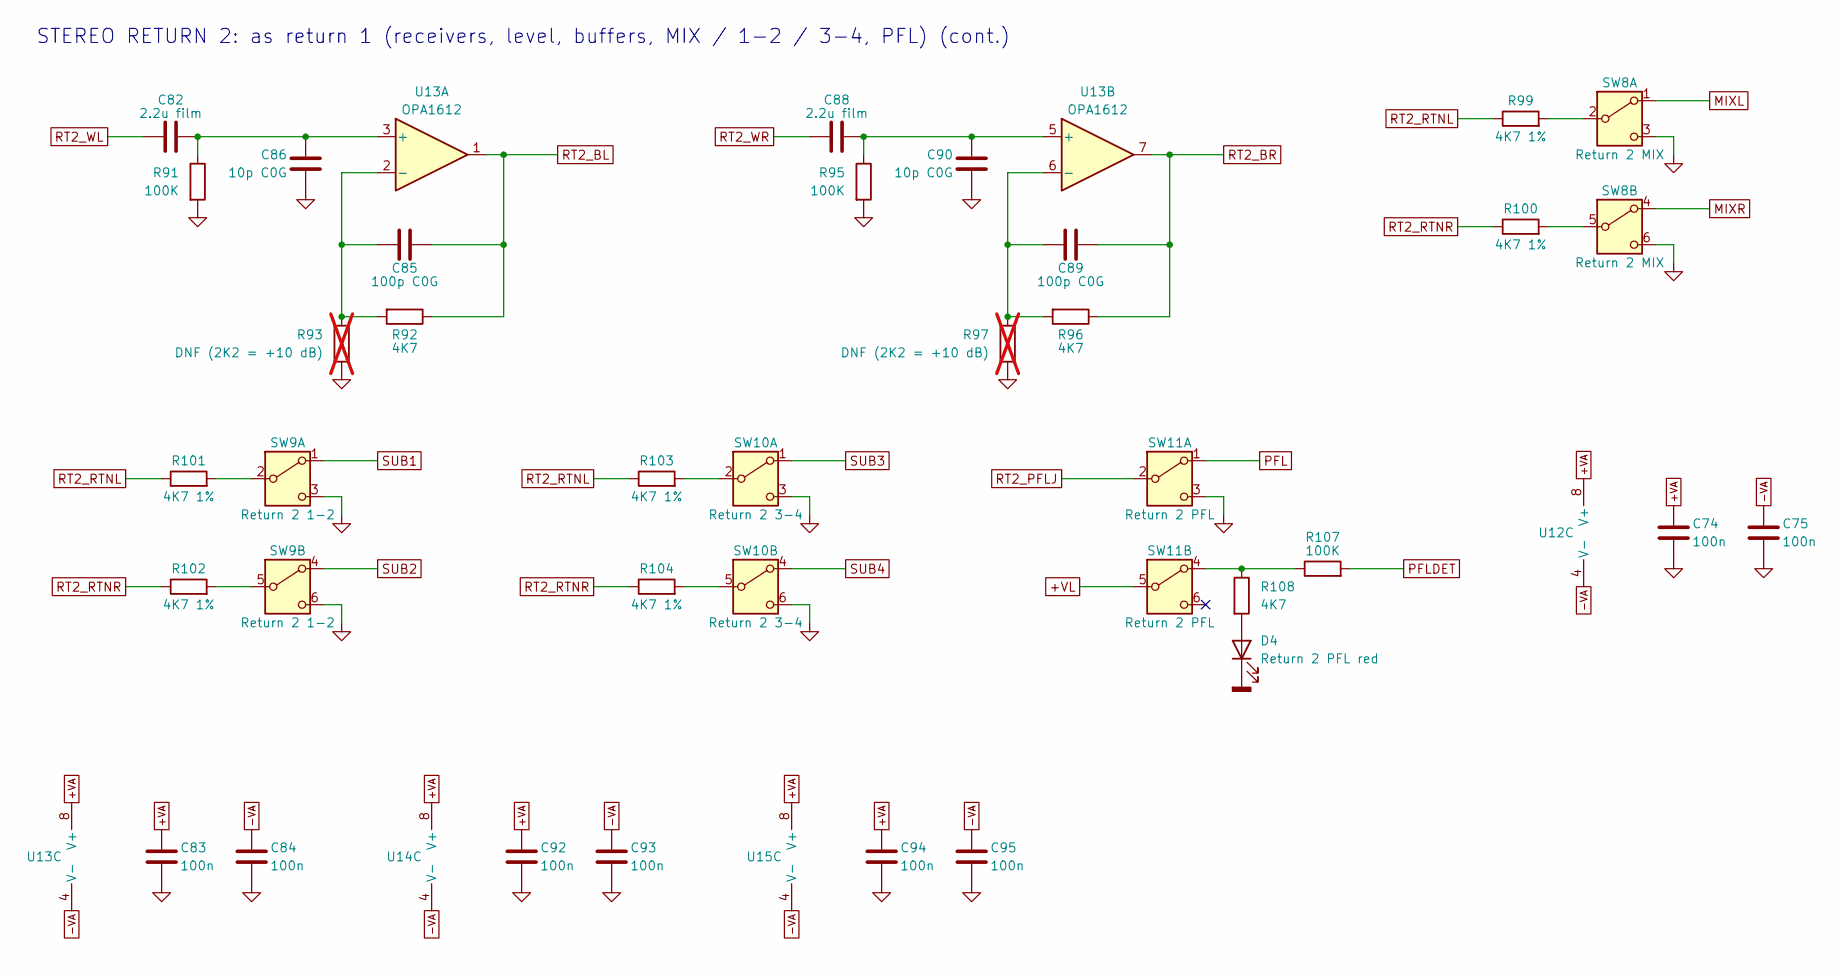
[picture p100: schematic 10_stereo_return_2.kicad_sch, STEREO RETURN 2]

Parts:
C74, C75, C83, C84, C92, C93, C94, C95: 100n; C_0805_2012Metric; MPN Samsung CL21B104KBCNNNC (X7R 50V)
C82, C88: 2.2u film; C_Rect_L7.2mm_W7.2mm_P5.00mm_FKS2_FKP2_MKS2_MKP2; MPN KEMET MMK5225K63J06L4BULK (PET 63V; rep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
C85, C89: 100p C0G; C_0805_2012Metric; MPN KEMET C0805C101J5GACTU
C86, C90: 10p C0G; C_0805_2012Metric; MPN KEMET C0805C100J5GACTU
D4: Return 2 PFL red; LED_D3.0mm; MPN Kingbright WP710A10ID
R91, R95, R107: 100K; R_0805_2012Metric
R92, R96, R108: 4K7; R_0805_2012Metric
R93, R97: DNF (2K2 = +10 dB); R_0805_2012Metric; not fitted
R99, R100, R101, R102, R103, R104: 4K7 1%; R_0805_2012Metric
SW8: Return 2 MIX; SW_Push_2P2T_Toggle_CK_PVA2xxH1xxxxxxV2; MPN C&K PVA2 EE H1 1.7N V2
SW9: Return 2 1-2; SW_Push_2P2T_Toggle_CK_PVA2xxH1xxxxxxV2; MPN C&K PVA2 EE H1 1.7N V2
SW10: Return 2 3-4; SW_Push_2P2T_Toggle_CK_PVA2xxH1xxxxxxV2; MPN C&K PVA2 EE H1 1.7N V2
SW11: Return 2 PFL; SW_Push_2P2T_Toggle_CK_PVA2xxH1xxxxxxV2; MPN C&K PVA2 EE H1 1.7N V2
U12, U13: OPA1612; SOIC-8_3.9x4.9mm_P1.27mm; MPN TI OPA1612AIDR
U14, U15: OPA1656; SOIC-8_3.9x4.9mm_P1.27mm; MPN TI OPA1656IDR

Connections:
+VA: C74.1, C83.1, C92.1, C94.1, U12.8 (V+), U13.8 (V+), U14.8 (V+), U15.8 (V+); also elsewhere on the board
+VL: SW11.5 (B); also elsewhere on the board
-VA: C75.2, C84.2, C93.2, C95.2, U12.4 (V-), U13.4 (V-), U14.4 (V-), U15.4 (V-); also elsewhere on the board
GNDA: C74.2, C75.1, C83.2, C84.1, C86.2, C90.2, C92.2, C93.1, C94.2, C95.1, R91.2, R93.2, R95.2, R97.2, SW8.3 (C), SW8.6 (C), SW9.3 (C), SW9.6 (C), SW10.3 (C), SW10.6 (C), SW11.3 (C); also elsewhere on the board
GNDD: D4.1 (K); also elsewhere on the board
MIXL: SW8.1 (A); also elsewhere on the board
MIXR: SW8.4 (A); also elsewhere on the board
unnamed: D4.2 (A), R108.2
unnamed: R99.2, SW8.2 (B)
unnamed: R100.2, SW8.5 (B)
unnamed: R101.2, SW9.2 (B)
unnamed: R102.2, SW9.5 (B)
unnamed: R103.2, SW10.2 (B)
unnamed: R104.2, SW10.5 (B)
unnamed: R107.1, R108.1, SW11.4 (A)
unnamed: C82.2, C86.1, R91.1, U13.3 (+)
unnamed: C85.2, R92.2, R93.1, U13.2 (-)
unnamed: C88.2, C90.1, R95.1, U13.5 (+)
unnamed: C89.2, R96.2, R97.1, U13.6 (-)
PFL: SW11.1 (A); also elsewhere on the board
PFLDET: R107.2; also elsewhere on the board
RT2_BL: C85.1, R92.1, U13.1; also elsewhere on the board
RT2_BR: C89.1, R96.1, U13.7; also elsewhere on the board
RT2_PFLJ: SW11.2 (B); also elsewhere on the board
RT2_RTNL: R99.1, R101.1, R103.1; also elsewhere on the board
RT2_RTNR: R100.1, R102.1, R104.1; also elsewhere on the board
RT2_WL: C82.1; also elsewhere on the board
RT2_WR: C88.1; also elsewhere on the board
SUB1: SW9.1 (A); also elsewhere on the board
SUB2: SW9.4 (A); also elsewhere on the board
SUB3: SW10.1 (A); also elsewhere on the board
SUB4: SW10.4 (A); also elsewhere on the board

Notes on the sheet:
STEREO RETURN 2: as return 1 (receivers, level, buffers, MIX / 1-2 / 3-4, PFL) (cont.)

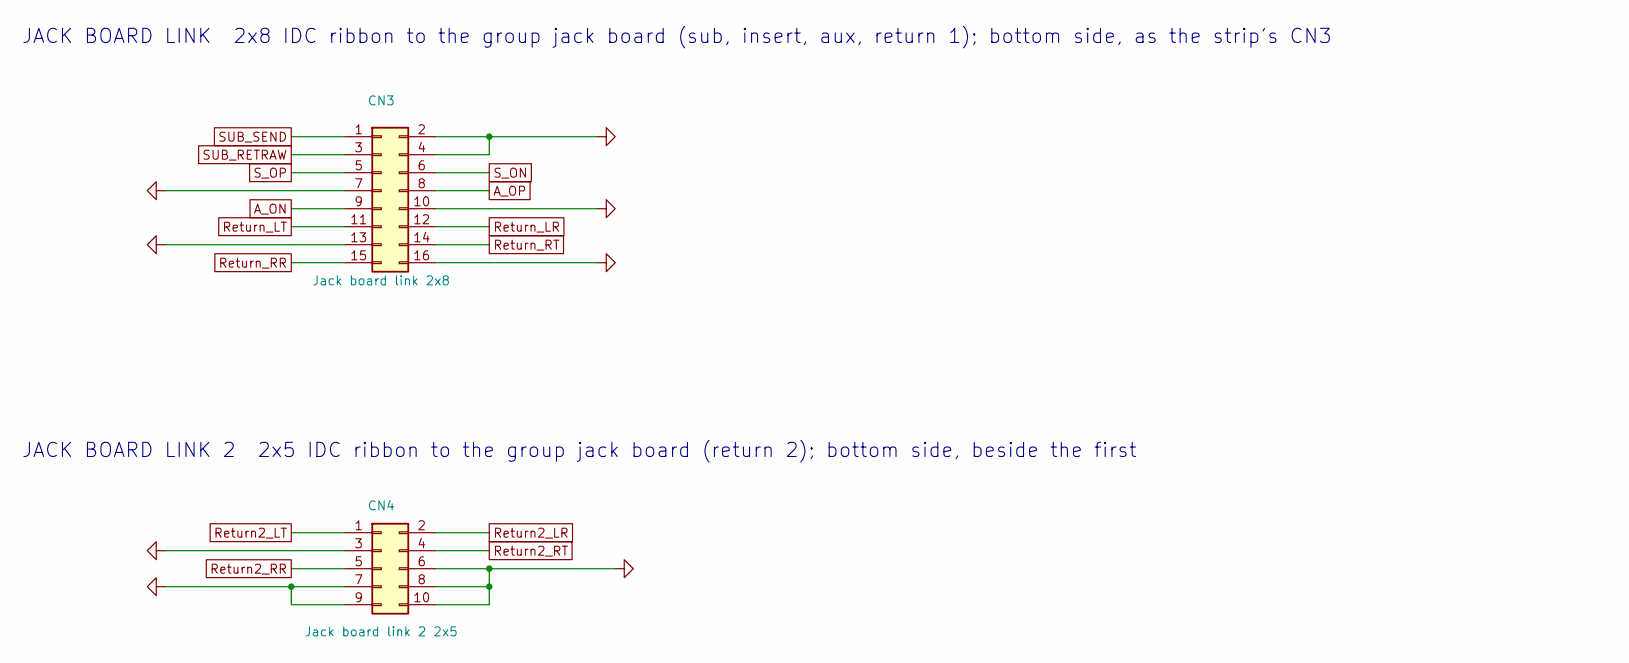
[picture p101: schematic 11_jack_board_link.kicad_sch, JACK BOARD LINK, JACK BOARD LINK 2]

Parts:
CN3: Jack board link 2x8; IDC-Header_2x08_P2.54mm_Vertical; MPN Wurth 61201621621 (2x8 box header)
CN4: Jack board link 2 2x5; IDC-Header_2x05_P2.54mm_Vertical; MPN Wurth 61201021621 (2x5 box header)

Connections:
A_ON: CN3.9; also elsewhere on the board
A_OP: CN3.8; also elsewhere on the board
GNDA: CN3.2, CN3.4, CN3.7, CN3.10, CN3.13, CN3.16, CN4.3, CN4.6, CN4.7, CN4.8, CN4.9, CN4.10; also elsewhere on the board
Return2_LR: CN4.2; also elsewhere on the board
Return2_LT: CN4.1; also elsewhere on the board
Return2_RR: CN4.5; also elsewhere on the board
Return2_RT: CN4.4; also elsewhere on the board
Return_LR: CN3.12; also elsewhere on the board
Return_LT: CN3.11; also elsewhere on the board
Return_RR: CN3.15; also elsewhere on the board
Return_RT: CN3.14; also elsewhere on the board
SUB_RETRAW: CN3.3; also elsewhere on the board
SUB_SEND: CN3.1; also elsewhere on the board
S_ON: CN3.6; also elsewhere on the board
S_OP: CN3.5; also elsewhere on the board

Notes on the sheet:
JACK BOARD LINK 2x8 IDC ribbon to the group jack board (sub, insert, aux, return 1); bottom side, as the strip's CN3
JACK BOARD LINK 2 2x5 IDC ribbon to the group jack board (return 2); bottom side, beside the first
