cozycactus/goa-console/boards/group/group.kicad_pcb

## KiCad design boards/group/group.kicad_pcb (continued)

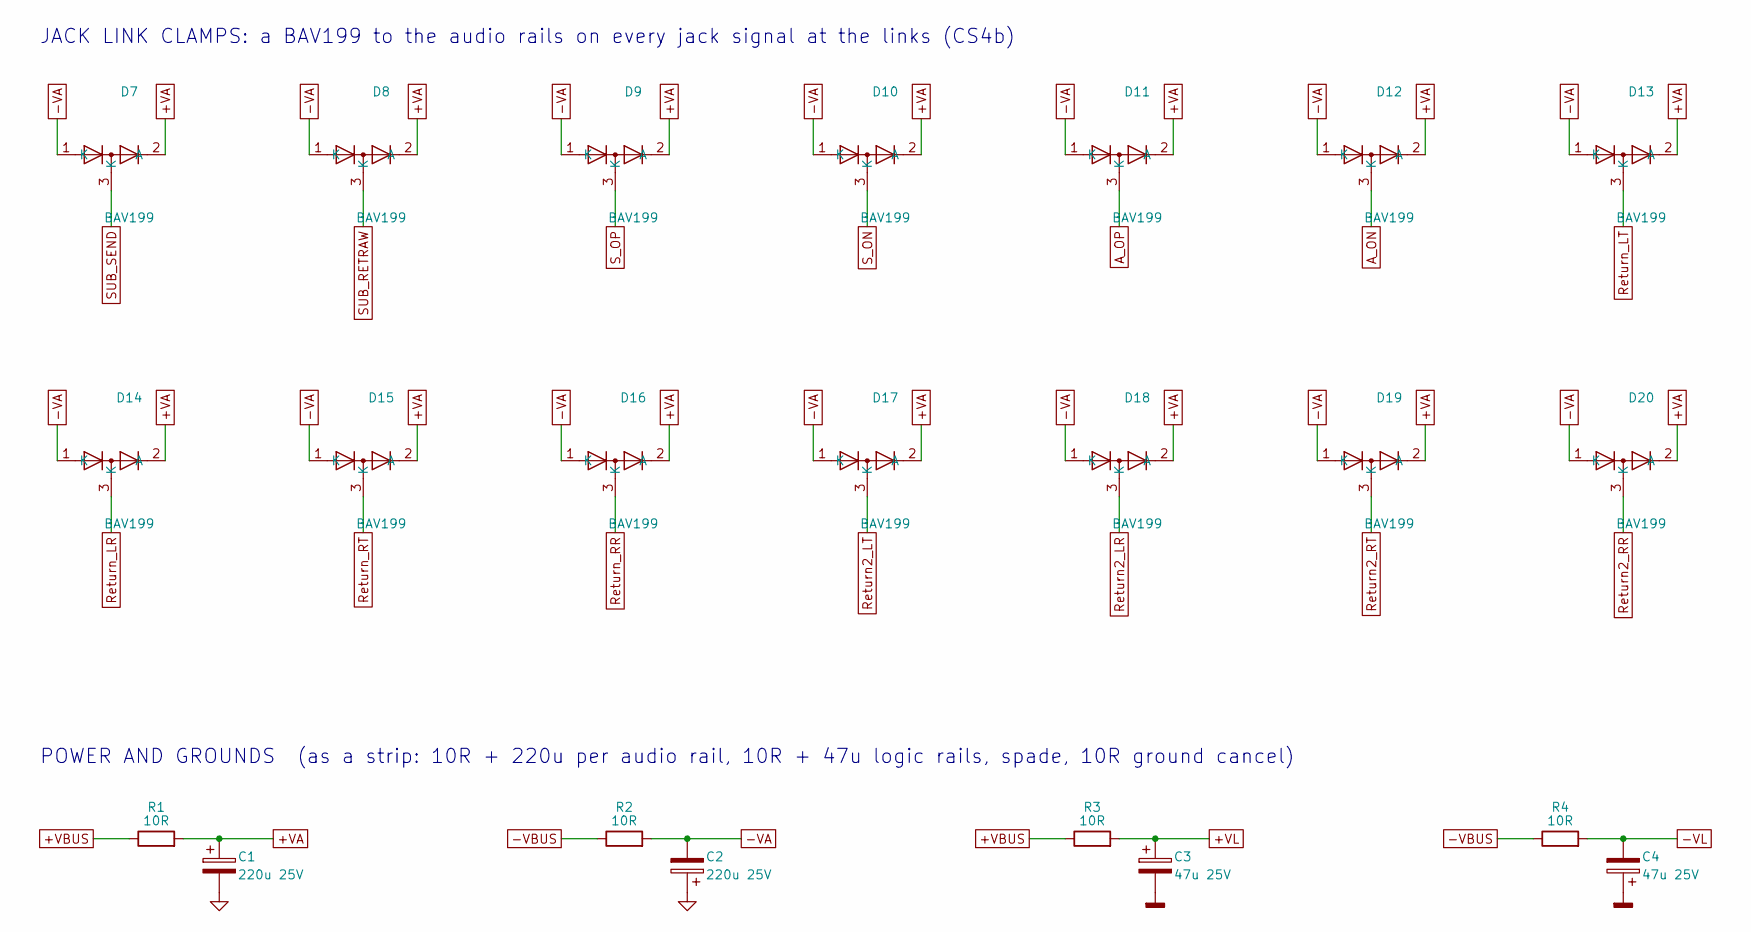
[picture p102: schematic 12_jack_link_clamps.kicad_sch, JACK LINK CLAMPS, POWER AND GROUNDS]

Parts:
C1, C2: 220u 25V; CP_Radial_D10.0mm_P5.00mm; MPN Nichicon UHE1V221MPD6 (35V)
C3, C4: 47u 25V; CP_Radial_D8.0mm_P3.50mm; MPN Nichicon UPW1J470MPD (63V)
D7, D8, D9, D10, D11, D12, D13, D14, D15, D16, D17, D18, D19, D20: BAV199; SOT-23; MPN Nexperia BAV199,215
R1, R2, R3, R4: 10R; R_1206_3216Metric; MPN Vishay M251206BB1009JP500

Connections:
+VA: C1.1, D7.2 (A), D8.2 (A), D9.2 (A), D10.2 (A), D11.2 (A), D12.2 (A), D13.2 (A), D14.2 (A), D15.2 (A), D16.2 (A), D17.2 (A), D18.2 (A), D19.2 (A), D20.2 (A), R1.2; also elsewhere on the board
+VBUS: R1.1, R3.1; also elsewhere on the board
+VL: C3.1, R3.2; also elsewhere on the board
-VA: C2.2, D7.1 (K), D8.1 (K), D9.1 (K), D10.1 (K), D11.1 (K), D12.1 (K), D13.1 (K), D14.1 (K), D15.1 (K), D16.1 (K), D17.1 (K), D18.1 (K), D19.1 (K), D20.1 (K), R2.2; also elsewhere on the board
-VBUS: R2.1, R4.1; also elsewhere on the board
-VL: C4.2, R4.2
A_ON: D12.3 (K); also elsewhere on the board
A_OP: D11.3 (K); also elsewhere on the board
GNDA: C1.2, C2.1; also elsewhere on the board
GNDD: C3.2, C4.1; also elsewhere on the board
Return2_LR: D18.3 (K); also elsewhere on the board
Return2_LT: D17.3 (K); also elsewhere on the board
Return2_RR: D20.3 (K); also elsewhere on the board
Return2_RT: D19.3 (K); also elsewhere on the board
Return_LR: D14.3 (K); also elsewhere on the board
Return_LT: D13.3 (K); also elsewhere on the board
Return_RR: D16.3 (K); also elsewhere on the board
Return_RT: D15.3 (K); also elsewhere on the board
SUB_RETRAW: D8.3 (K); also elsewhere on the board
SUB_SEND: D7.3 (K); also elsewhere on the board
S_ON: D10.3 (K); also elsewhere on the board
S_OP: D9.3 (K); also elsewhere on the board

Notes on the sheet:
JACK LINK CLAMPS: a BAV199 to the audio rails on every jack signal at the links (CS4b)
POWER AND GROUNDS (as a strip: 10R + 220u per audio rail, 10R + 47u logic rails, spade, 10R ground cancel)

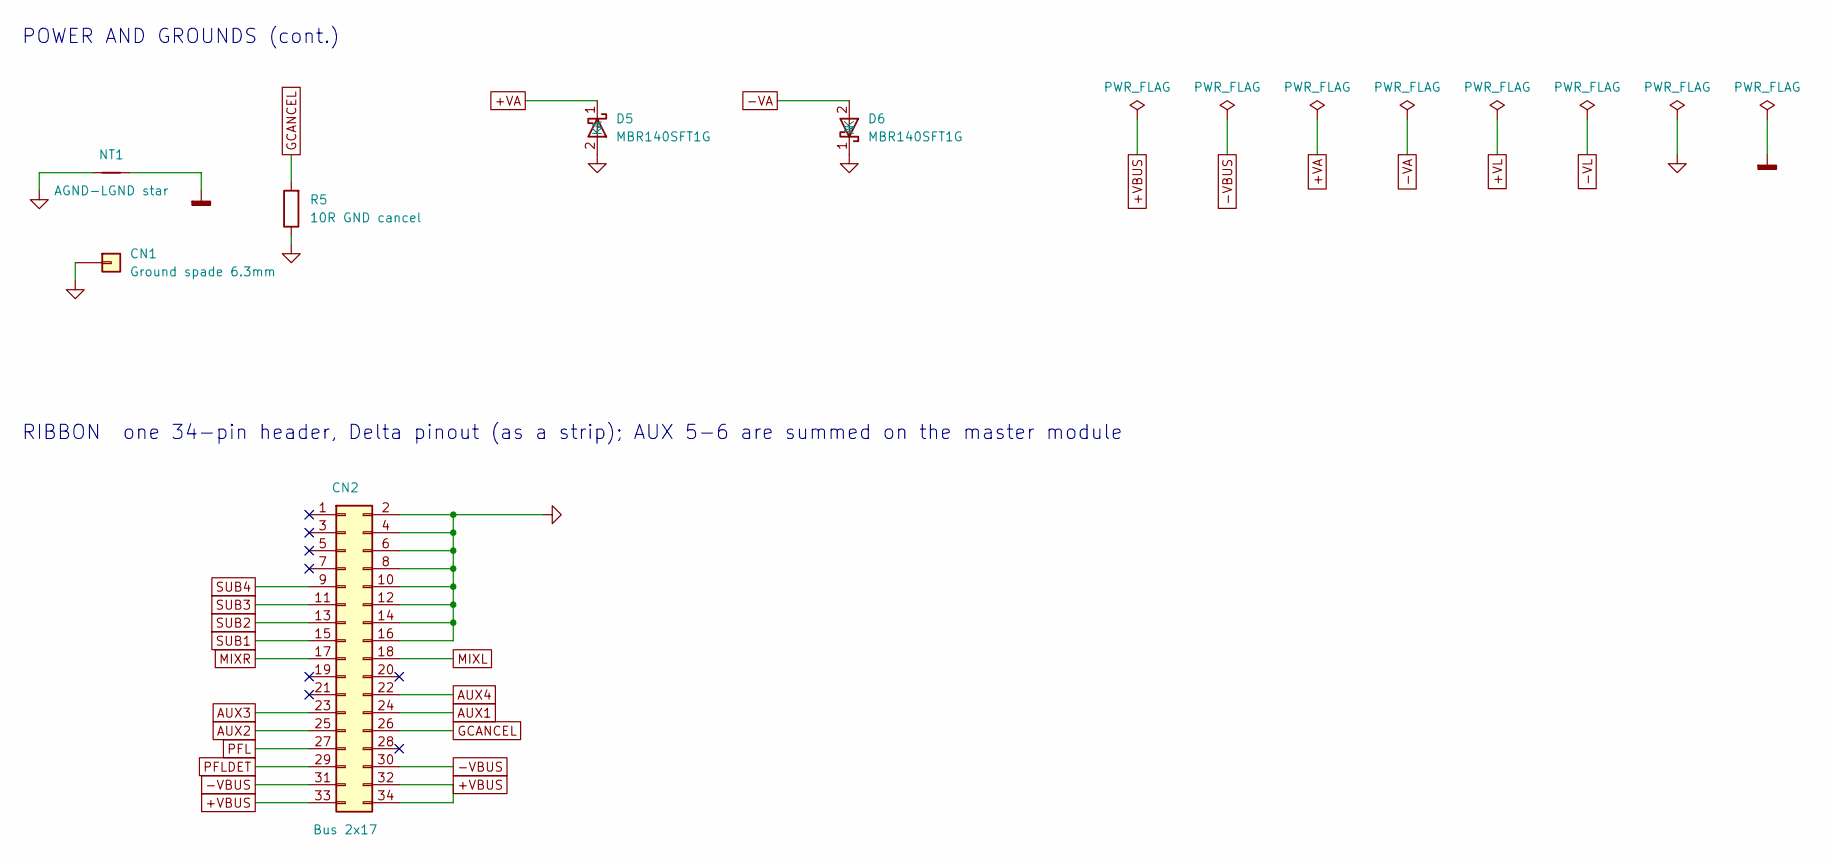
[picture p103: schematic 13_power_and_grounds.kicad_sch, POWER AND GROUNDS, RIBBON]

Parts:
CN1: Ground spade 6.3mm; Keystone_1287-ST_FastOn_Tab_6.35mm; MPN Keystone 1287-ST
CN2: Bus 2x17; IDC-Header_2x17_P2.54mm_Vertical; MPN Wurth 61203421621 (2x17 box header)
D5, D6: MBR140SFT1G; D_SOD-123F; MPN onsemi MBR140SFT1G
NT1: AGND-LGND star; NetTie-2_SMD_Pad0.5mm
R5: 10R GND cancel; R_0805_2012Metric

Connections:
+VA: D5.1 (K); also elsewhere on the board
+VBUS: CN2.32, CN2.33, CN2.34; also elsewhere on the board
-VA: D6.2 (A); also elsewhere on the board
-VBUS: CN2.30, CN2.31; also elsewhere on the board
AUX1: CN2.24; also elsewhere on the board
AUX2: CN2.25; also elsewhere on the board
AUX3: CN2.23; also elsewhere on the board
AUX4: CN2.22; also elsewhere on the board
GCANCEL: CN2.26, R5.2; also elsewhere on the board
GNDA: CN1.1, CN2.2, CN2.4, CN2.6, CN2.8, CN2.10, CN2.12, CN2.14, CN2.16, D5.2 (A), D6.1 (K), NT1.1, R5.1; also elsewhere on the board
GNDD: NT1.2; also elsewhere on the board
MIXL: CN2.18; also elsewhere on the board
MIXR: CN2.17; also elsewhere on the board
PFL: CN2.27; also elsewhere on the board
PFLDET: CN2.29; also elsewhere on the board
SUB1: CN2.15; also elsewhere on the board
SUB2: CN2.13; also elsewhere on the board
SUB3: CN2.11; also elsewhere on the board
SUB4: CN2.9; also elsewhere on the board

Notes on the sheet:
POWER AND GROUNDS (cont.)
RIBBON one 34-pin header, Delta pinout (as a strip); AUX 5-6 are summed on the master module

Board: 4 copper layers, 298 parts (76 on the bottom side), 167 nets, no tracks yet.

Other parts of the board:
H1, H2, H3, H4, H5, H6: M3 standoff 11.5 mm; MountingHole_3.2mm_M3
