cozycactus/goa-console/boards/jack_board/jack_board.kicad_pcb

## KiCad design boards/jack_board/jack_board.kicad_pcb (2026-11-11)

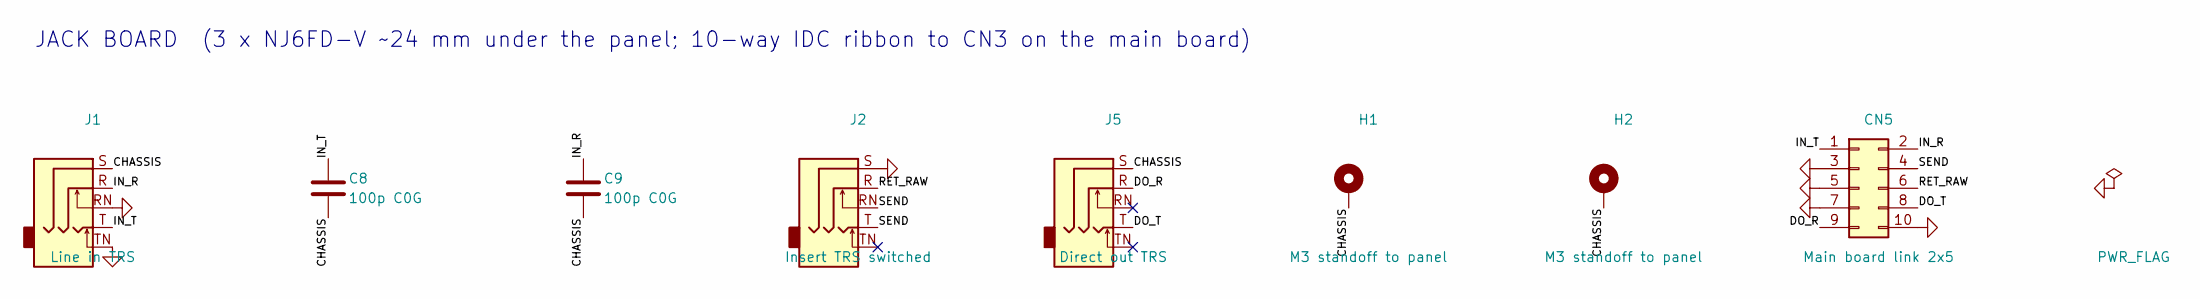
[picture p104: schematic jack_board.kicad_sch, Jack board - goa console channel strip (line in, insert, di…]

Parts:
C8, C9: 100p C0G; C_0805_2012Metric; MPN KEMET C0805C101J5GACTU
CN5: Main board link 2x5; IDC-Header_2x05_P2.54mm_Vertical; MPN Wurth 61201021621 (2x5 box header)
H1, H2: M3 standoff to panel; MountingHole_3.2mm_M3_Pad
J1: Line in TRS; Jack_6.35mm_Neutrik_NJ6FD-V_Vertical; MPN Neutrik NJ6FD-V
J2: Insert TRS switched; Jack_6.35mm_Neutrik_NJ6FD-V_Vertical; MPN Neutrik NJ6FD-V
J5: Direct out TRS; Jack_6.35mm_Neutrik_NJ6FD-V_Vertical; MPN Neutrik NJ6FD-V

Connections:
/CHASSIS: C8.2, C9.2, H1.1, H2.1, J1.S, J5.S
/DO_R: CN5.9, J5.R
/DO_T: CN5.8, J5.T
/IN_R: C9.1, CN5.2, J1.R
/IN_T: C8.1, CN5.1, J1.T
/RET_RAW: CN5.6, J2.R
/SEND: CN5.4, J2.RN, J2.T
GNDA: CN5.3, CN5.5, CN5.7, CN5.10, J1.RN, J1.TN, J2.S

Notes on the sheet:
JACK BOARD (3 x NJ6FD-V ~24 mm under the panel; 10-way IDC ribbon to CN3 on the main board)

Board: 2 copper layers, 8 parts (3 on the bottom side), 8 nets, no tracks yet.
