cozycactus/goa-console/boards/jig_load_board/jig_load_board.kicad_pcb

## KiCad design boards/jig_load_board/jig_load_board.kicad_pcb (2026-11-11)

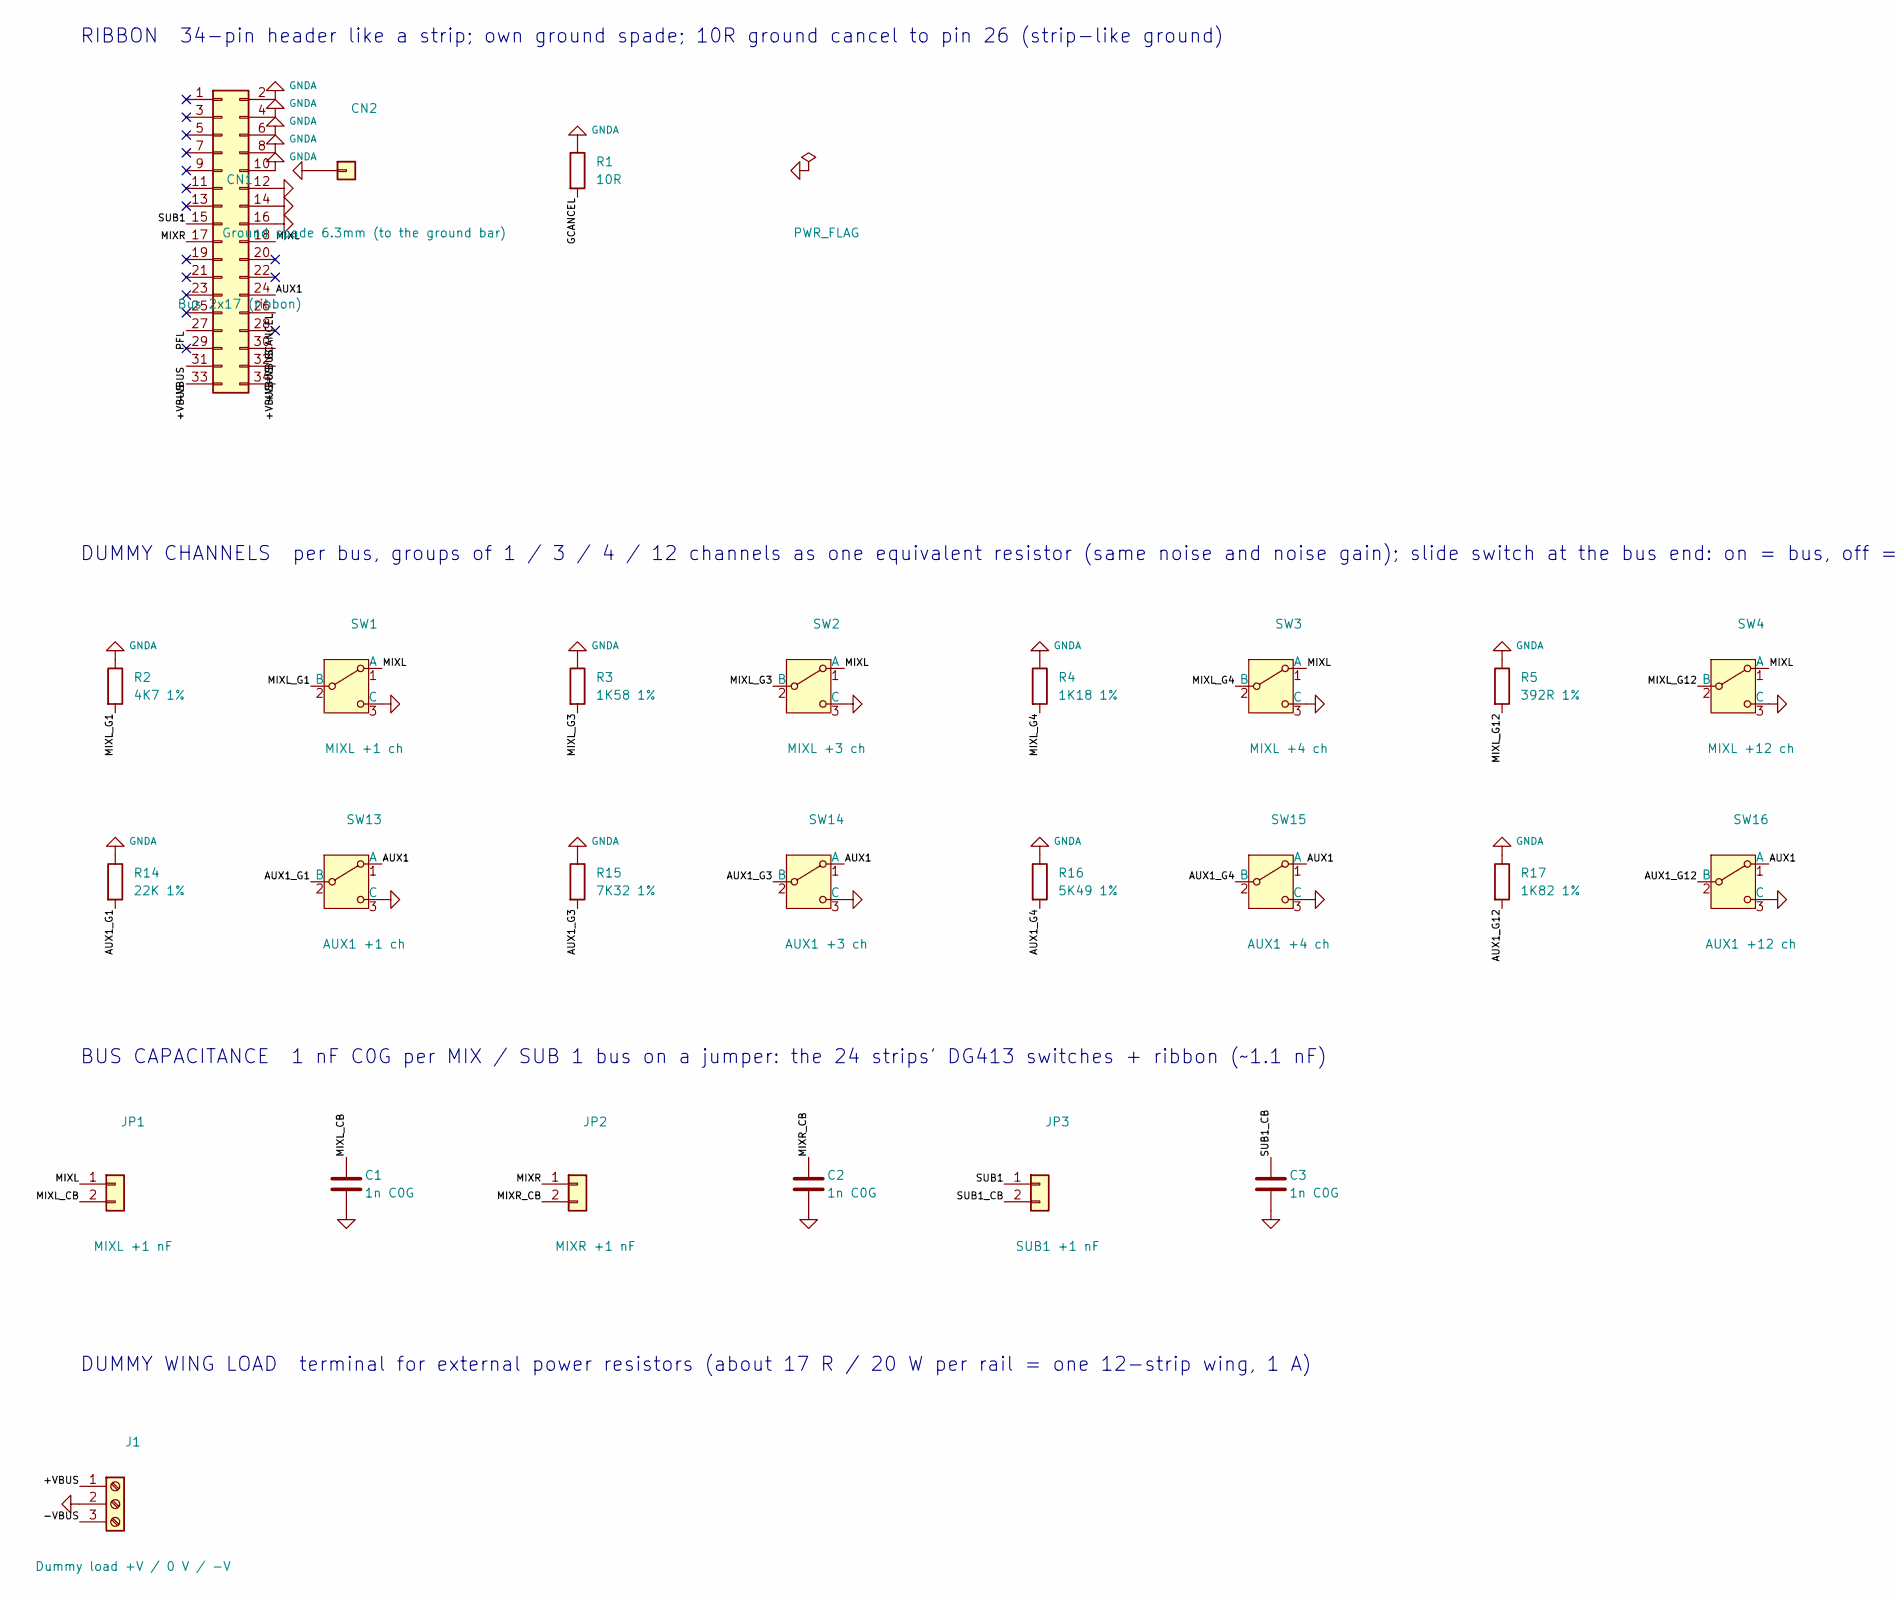
[picture p105: schematic jig_load_board.kicad_sch, Test jig - load board (goa console), part in row 1, column 1]

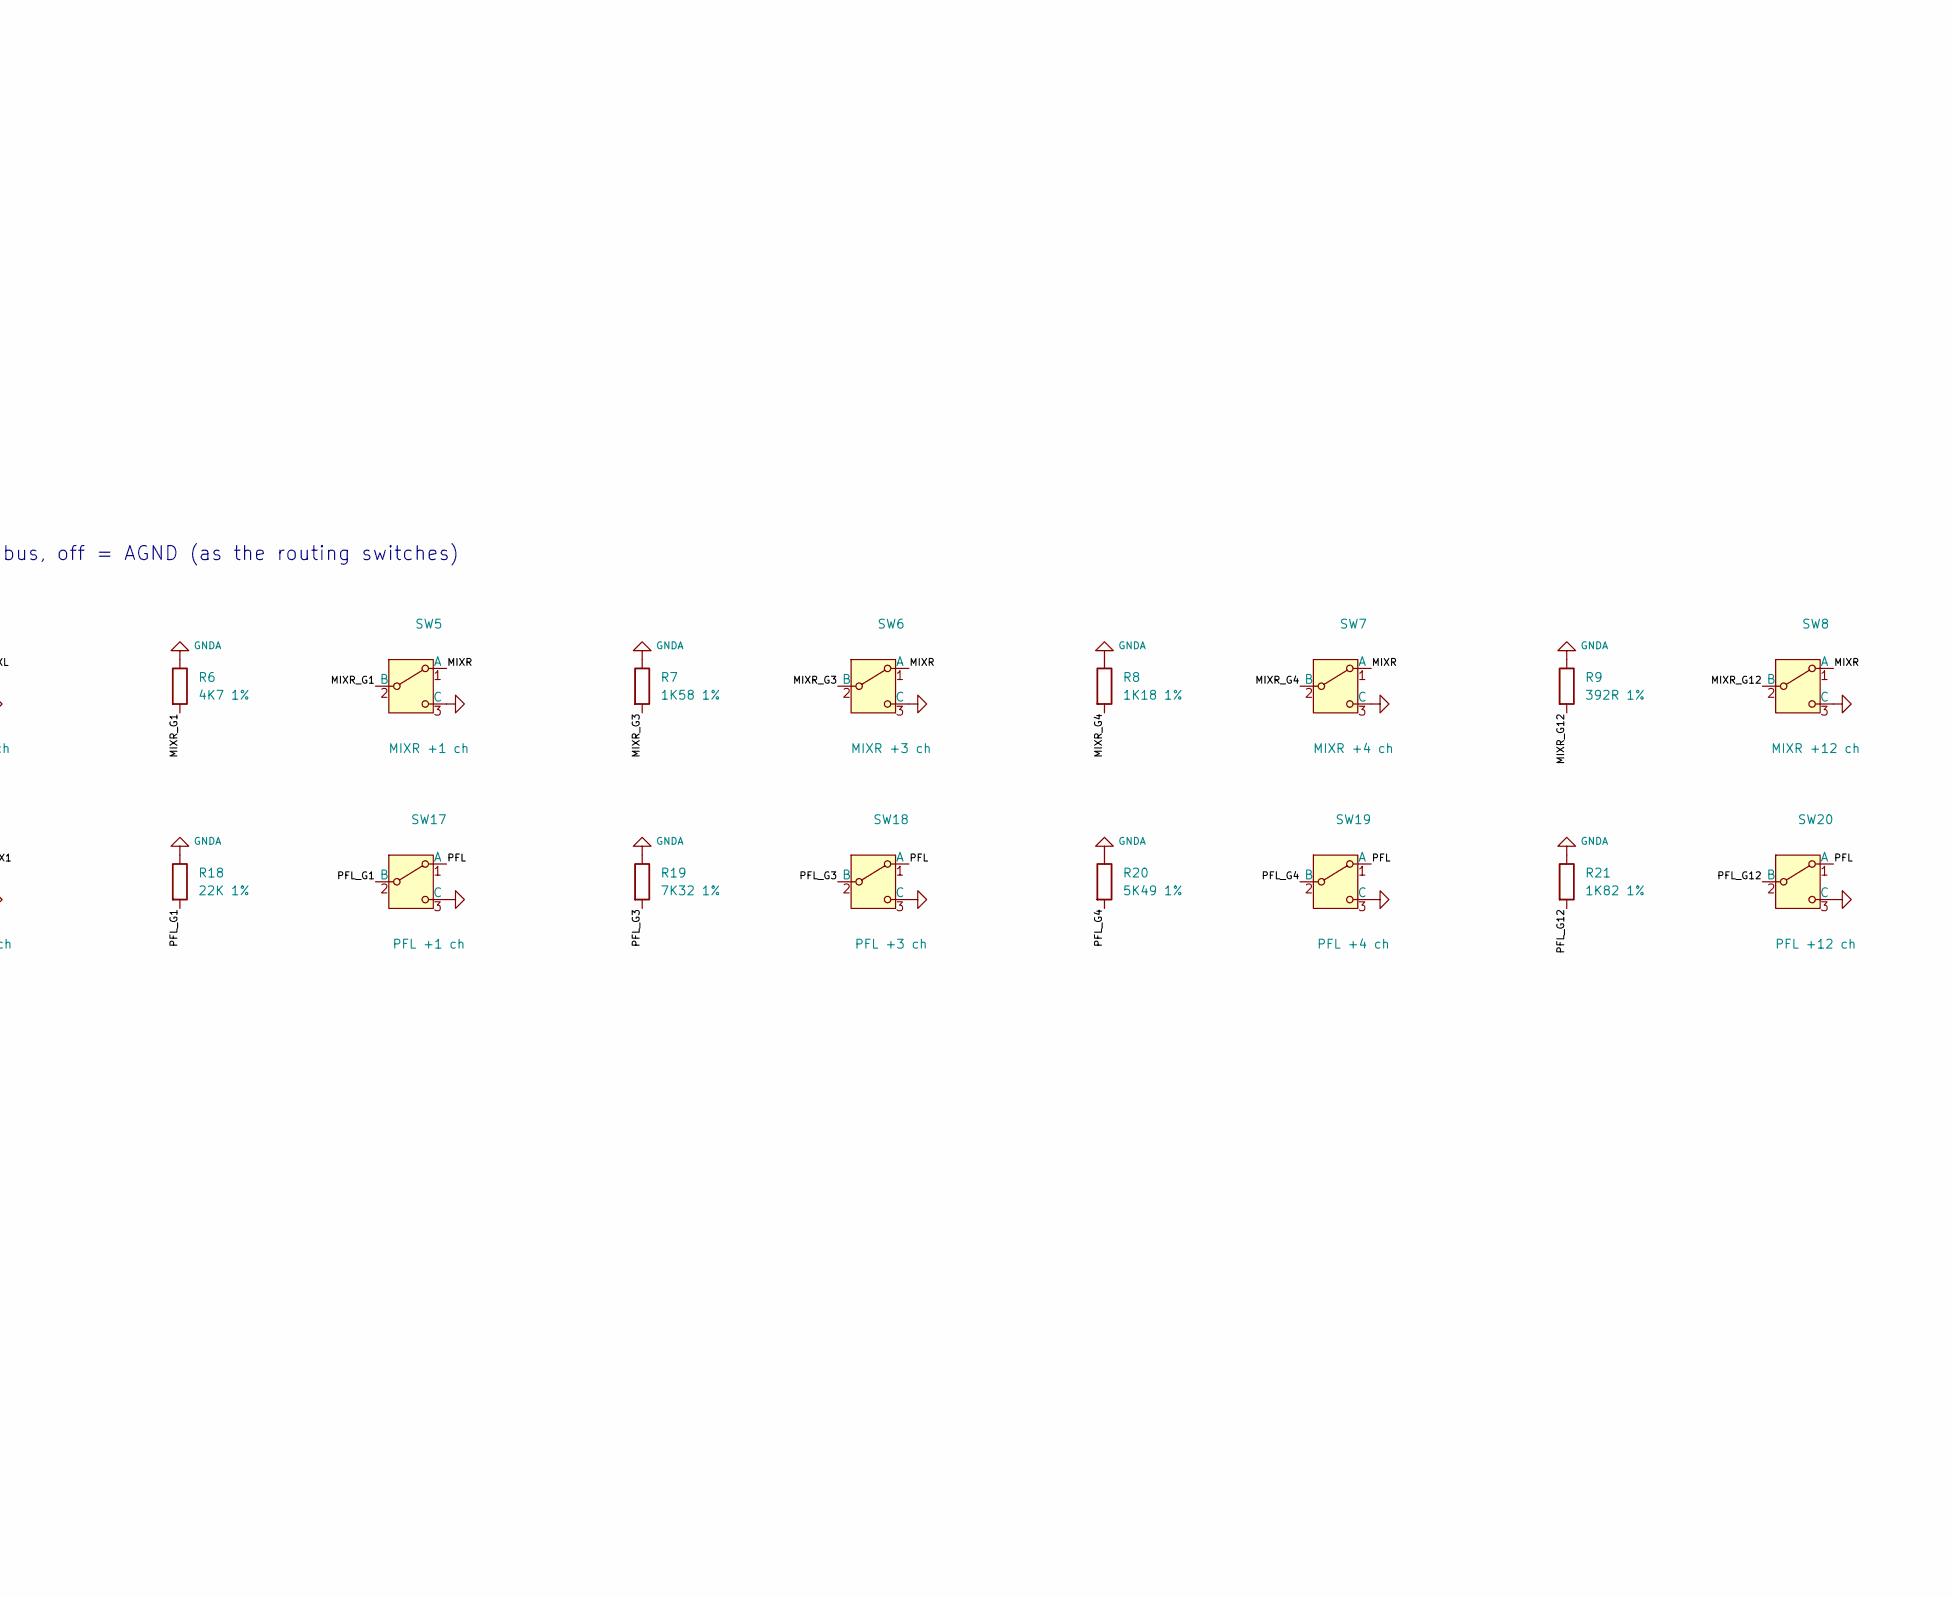
[picture p106: schematic jig_load_board.kicad_sch, Test jig - load board (goa console), part in row 1, column 2]

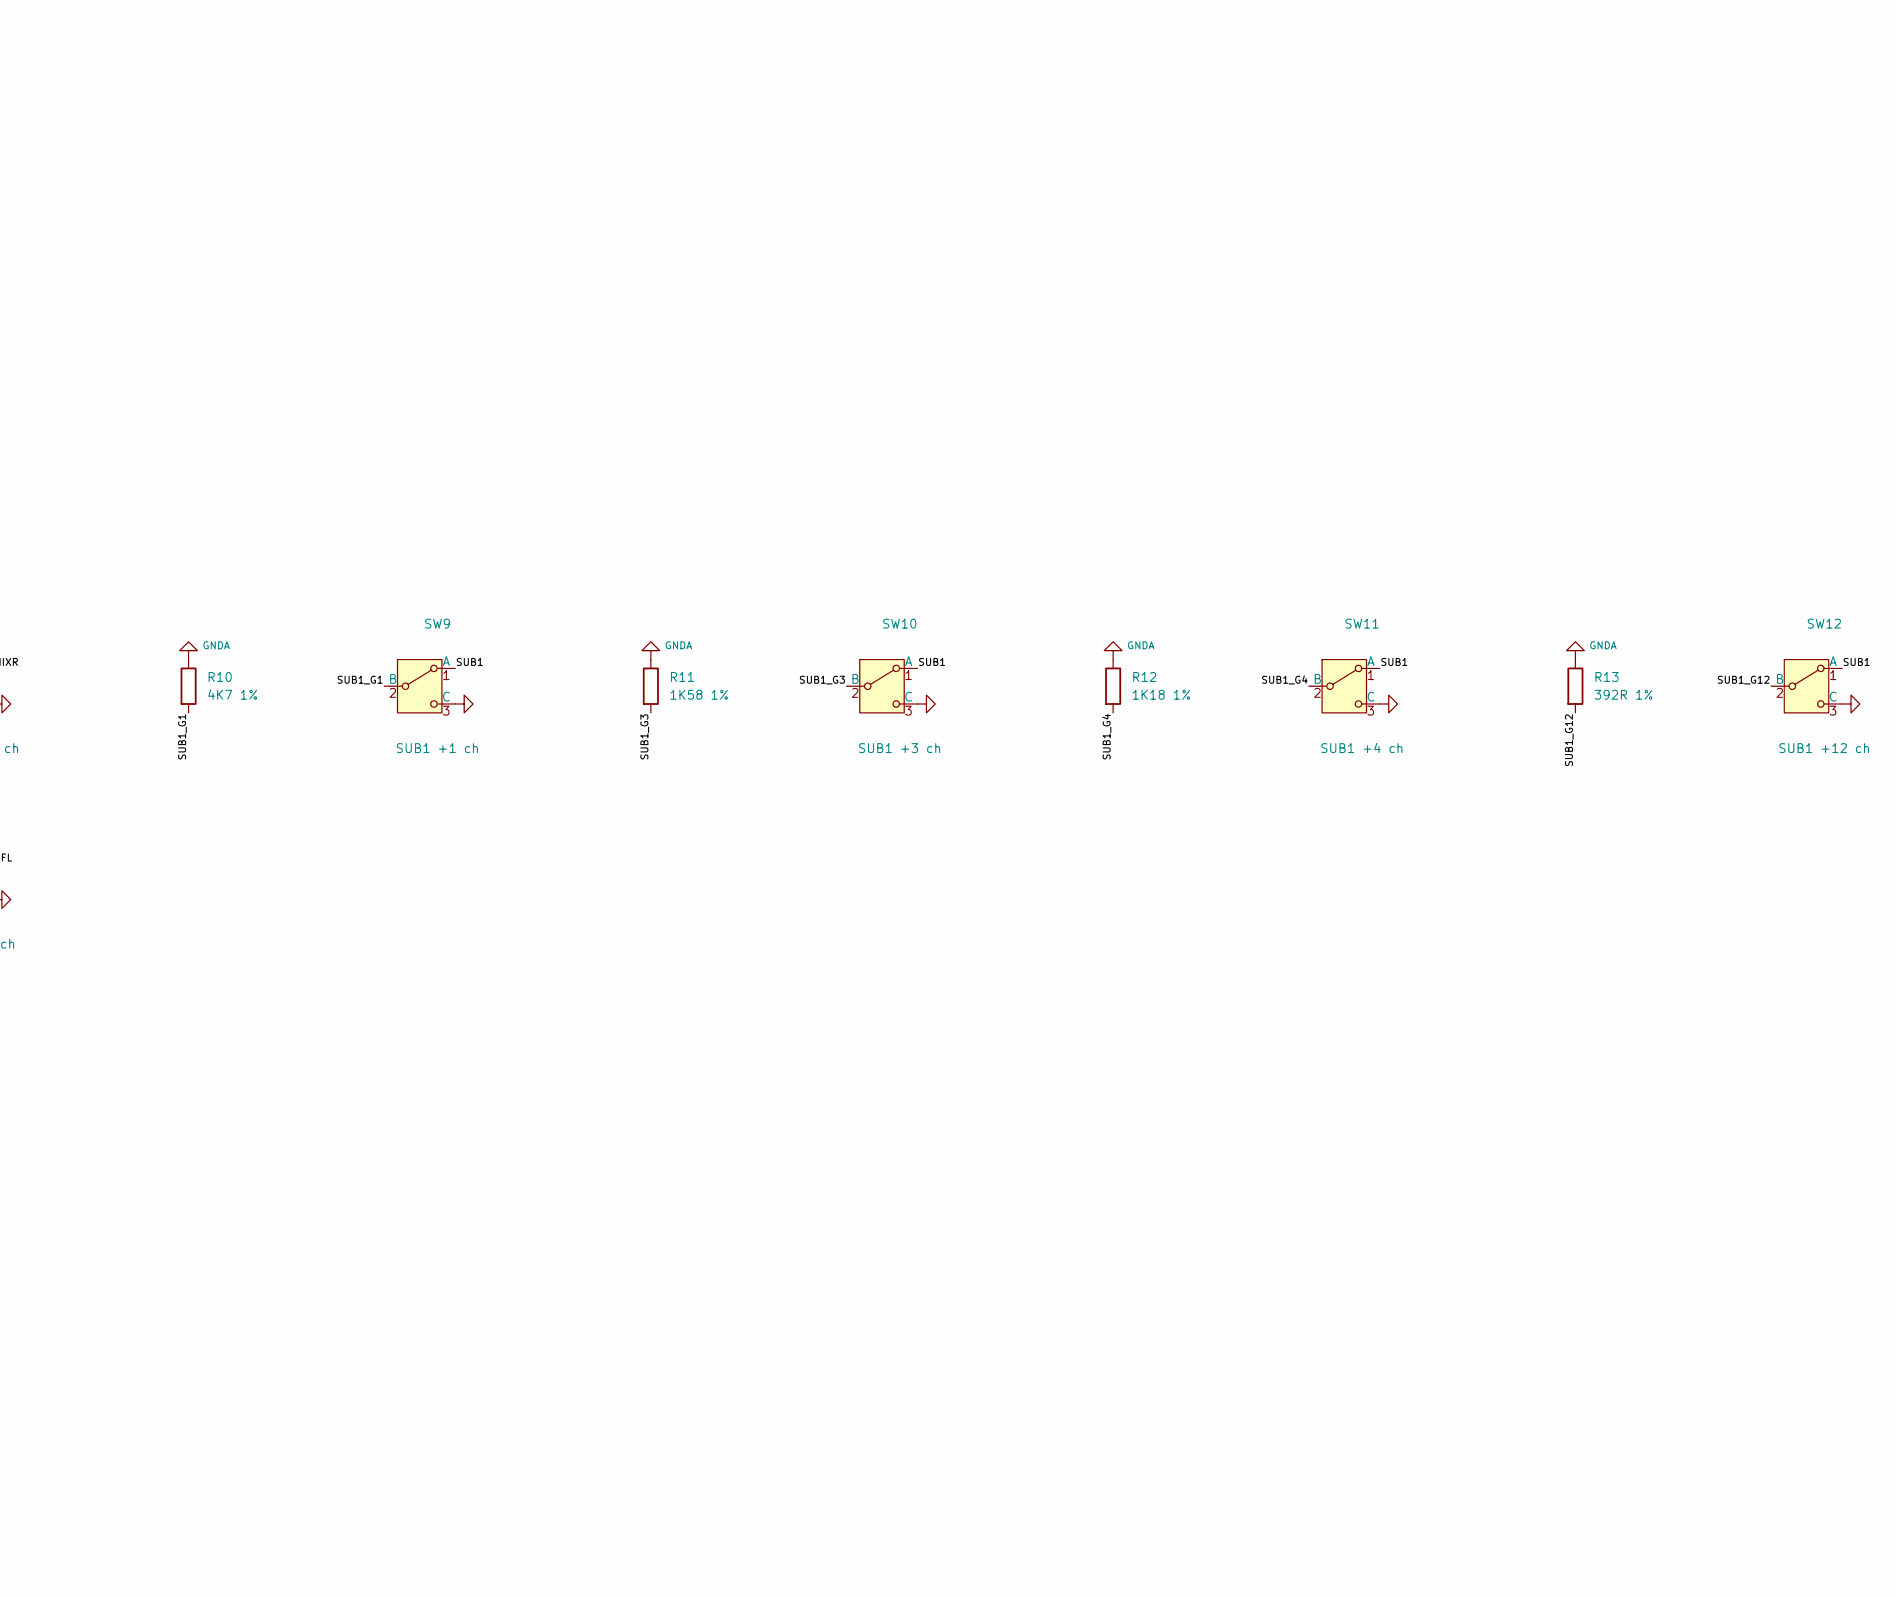
[picture p107: schematic jig_load_board.kicad_sch, Test jig - load board (goa console), part in row 1, column 3]

Parts:
C1, C2, C3: 1n C0G; C_0805_2012Metric; MPN KEMET C0805C102J5GACTU
CN1: Bus 2x17 (ribbon); IDC-Header_2x17_P2.54mm_Vertical; MPN Wurth 61203421621 (2x17 box header)
CN2: Ground spade 6.3mm (to the ground bar); Keystone_1287-ST_FastOn_Tab_6.35mm; MPN Keystone 1287-ST
J1: Dummy load +V / 0 V / -V; TerminalBlock_Phoenix_MKDS-1,5-3-5.08_1x03_P5.08mm_Horizont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; MPN Phoenix 1715734 MKDS 1,5/3-5,08
JP1: MIXL +1 nF; PinHeader_1x02_P2.54mm_Vertical; MPN 2.54 mm header + shunt
JP2: MIXR +1 nF; PinHeader_1x02_P2.54mm_Vertical; MPN 2.54 mm header + shunt
JP3: SUB1 +1 nF; PinHeader_1x02_P2.54mm_Vertical; MPN 2.54 mm header + shunt
R1: 10R; R_0805_2012Metric
R2, R6, R10: 4K7 1%; R_0805_2012Metric
R3, R7, R11: 1K58 1%; R_0805_2012Metric
R4, R8, R12: 1K18 1%; R_0805_2012Metric
R5, R9, R13: 392R 1%; R_0805_2012Metric
R14, R18: 22K 1%; R_0805_2012Metric
R15, R19: 7K32 1%; R_0805_2012Metric
R16, R20: 5K49 1%; R_0805_2012Metric
R17, R21: 1K82 1%; R_0805_2012Metric
SW1: MIXL +1 ch; SW_Slide_SPDT_Straight_CK_OS102011MS2Q; MPN C&K OS102011MS2QN1
SW2: MIXL +3 ch; SW_Slide_SPDT_Straight_CK_OS102011MS2Q; MPN C&K OS102011MS2QN1
SW3: MIXL +4 ch; SW_Slide_SPDT_Straight_CK_OS102011MS2Q; MPN C&K OS102011MS2QN1
SW4: MIXL +12 ch; SW_Slide_SPDT_Straight_CK_OS102011MS2Q; MPN C&K OS102011MS2QN1
SW5: MIXR +1 ch; SW_Slide_SPDT_Straight_CK_OS102011MS2Q; MPN C&K OS102011MS2QN1
SW6: MIXR +3 ch; SW_Slide_SPDT_Straight_CK_OS102011MS2Q; MPN C&K OS102011MS2QN1
SW7: MIXR +4 ch; SW_Slide_SPDT_Straight_CK_OS102011MS2Q; MPN C&K OS102011MS2QN1
SW8: MIXR +12 ch; SW_Slide_SPDT_Straight_CK_OS102011MS2Q; MPN C&K OS102011MS2QN1
SW9: SUB1 +1 ch; SW_Slide_SPDT_Straight_CK_OS102011MS2Q; MPN C&K OS102011MS2QN1
SW10: SUB1 +3 ch; SW_Slide_SPDT_Straight_CK_OS102011MS2Q; MPN C&K OS102011MS2QN1
SW11: SUB1 +4 ch; SW_Slide_SPDT_Straight_CK_OS102011MS2Q; MPN C&K OS102011MS2QN1
SW12: SUB1 +12 ch; SW_Slide_SPDT_Straight_CK_OS102011MS2Q; MPN C&K OS102011MS2QN1
SW13: AUX1 +1 ch; SW_Slide_SPDT_Straight_CK_OS102011MS2Q; MPN C&K OS102011MS2QN1
SW14: AUX1 +3 ch; SW_Slide_SPDT_Straight_CK_OS102011MS2Q; MPN C&K OS102011MS2QN1
SW15: AUX1 +4 ch; SW_Slide_SPDT_Straight_CK_OS102011MS2Q; MPN C&K OS102011MS2QN1
SW16: AUX1 +12 ch; SW_Slide_SPDT_Straight_CK_OS102011MS2Q; MPN C&K OS102011MS2QN1
SW17: PFL +1 ch; SW_Slide_SPDT_Straight_CK_OS102011MS2Q; MPN C&K OS102011MS2QN1
SW18: PFL +3 ch; SW_Slide_SPDT_Straight_CK_OS102011MS2Q; MPN C&K OS102011MS2QN1
SW19: PFL +4 ch; SW_Slide_SPDT_Straight_CK_OS102011MS2Q; MPN C&K OS102011MS2QN1
SW20: PFL +12 ch; SW_Slide_SPDT_Straight_CK_OS102011MS2Q; MPN C&K OS102011MS2QN1

Connections:
/+VBUS: CN1.32, CN1.33, CN1.34, J1.1
/-VBUS: CN1.30, CN1.31, J1.3
/AUX1: CN1.24, SW13.1 (A), SW14.1 (A), SW15.1 (A), SW16.1 (A)
/AUX1_G1: R14.2, SW13.2 (B)
/AUX1_G3: R15.2, SW14.2 (B)
/AUX1_G4: R16.2, SW15.2 (B)
/AUX1_G12: R17.2, SW16.2 (B)
/GCANCEL: CN1.26, R1.2
/MIXL: CN1.18, JP1.1, SW1.1 (A), SW2.1 (A), SW3.1 (A), SW4.1 (A)
/MIXL_CB: C1.1, JP1.2
/MIXL_G1: R2.2, SW1.2 (B)
/MIXL_G3: R3.2, SW2.2 (B)
/MIXL_G4: R4.2, SW3.2 (B)
/MIXL_G12: R5.2, SW4.2 (B)
/MIXR: CN1.17, JP2.1, SW5.1 (A), SW6.1 (A), SW7.1 (A), SW8.1 (A)
/MIXR_CB: C2.1, JP2.2
/MIXR_G1: R6.2, SW5.2 (B)
/MIXR_G3: R7.2, SW6.2 (B)
/MIXR_G4: R8.2, SW7.2 (B)
/MIXR_G12: R9.2, SW8.2 (B)
/PFL: CN1.27, SW17.1 (A), SW18.1 (A), SW19.1 (A), SW20.1 (A)
/PFL_G1: R18.2, SW17.2 (B)
/PFL_G3: R19.2, SW18.2 (B)
/PFL_G4: R20.2, SW19.2 (B)
/PFL_G12: R21.2, SW20.2 (B)
/SUB1: CN1.15, JP3.1, SW9.1 (A), SW10.1 (A), SW11.1 (A), SW12.1 (A)
/SUB1_CB: C3.1, JP3.2
/SUB1_G1: R10.2, SW9.2 (B)
/SUB1_G3: R11.2, SW10.2 (B)
/SUB1_G4: R12.2, SW11.2 (B)
/SUB1_G12: R13.2, SW12.2 (B)
GNDA: C1.2, C2.2, C3.2, CN1.2, CN1.4, CN1.6, CN1.8, CN1.10, CN1.12, CN1.14, CN1.16, CN2.1, J1.2, R1.1, R2.1, R3.1, R4.1, R5.1, R6.1, R7.1, R8.1, R9.1, R10.1, R11.1, R12.1, R13.1, R14.1, R15.1, R16.1, R17.1, R18.1, R19.1, R20.1, R21.1, SW1.3 (C), SW2.3 (C), SW3.3 (C), SW4.3 (C), SW5.3 (C), SW6.3 (C), SW7.3 (C), SW8.3 (C), SW9.3 (C), SW10.3 (C), SW11.3 (C), SW12.3 (C), SW13.3 (C), SW14.3 (C), SW15.3 (C), SW16.3 (C), SW17.3 (C), SW18.3 (C), SW19.3 (C), SW20.3 (C)

Notes on the sheet:
RIBBON 34-pin header like a strip; own ground spade; 10R ground cancel to pin 26 (strip-like ground)
DUMMY CHANNELS per bus, groups of 1 / 3 / 4 / 12 channels as one equivalent resistor (same noise and noise gain); slide switch at the bus end: on = bus, off = AGND (as the routing switches)
BUS CAPACITANCE 1 nF C0G per MIX / SUB 1 bus on a jumper: the 24 strips' DG413 switches + ribbon (~1.1 nF)
DUMMY WING LOAD terminal for external power resistors (about 17 R / 20 W per rail = one 12-strip wing, 1 A)

Board: 2 copper layers, 54 parts (0 on the bottom side), 32 nets, no tracks yet.

Other parts of the board:
H1, H2, H3, H4: M3 standoff; MountingHole_3.2mm_M3
