cozycactus/goa-console/boards/group_jack_board/group_jack_board.kicad_pcb

## KiCad design boards/group_jack_board/group_jack_board.kicad_pcb (2026-11-11)

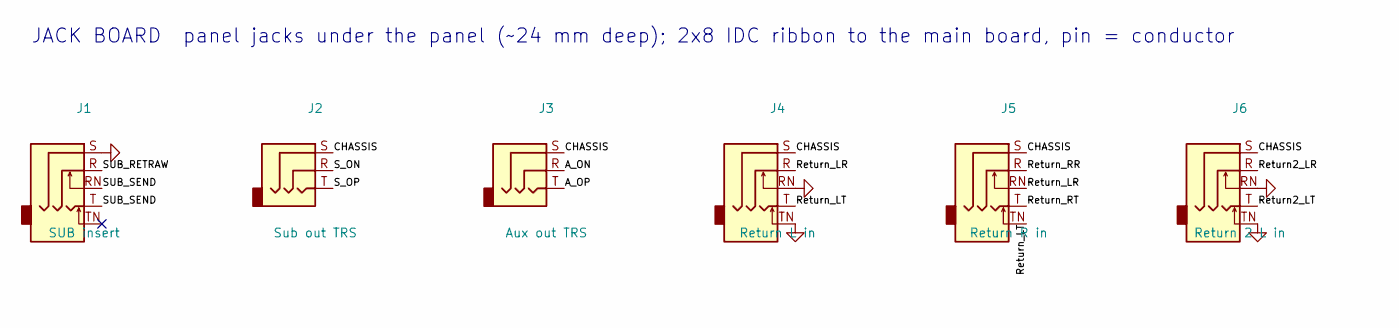
[picture p108: schematic group_jack_board.kicad_sch, Group module jack board - goa console (sub out, insert, aux…, part in row 1, column 1]

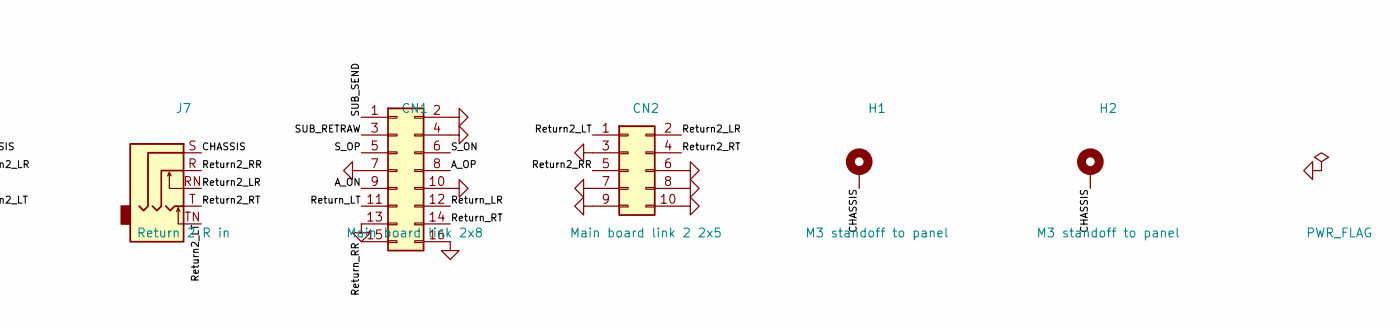
[picture p109: schematic group_jack_board.kicad_sch, Group module jack board - goa console (sub out, insert, aux…, part in row 1, column 2]

Parts:
CN1: Main board link 2x8; IDC-Header_2x08_P2.54mm_Vertical; MPN Wurth 61201621621 (2x8 box header)
CN2: Main board link 2 2x5; IDC-Header_2x05_P2.54mm_Vertical; MPN Wurth 61201021621 (2x5 box header)
H1, H2: M3 standoff to panel; MountingHole_3.2mm_M3_Pad
J1: SUB insert; Jack_6.35mm_Neutrik_NJ6FD-V_Vertical; MPN Neutrik NJ6FD-V
J2: Sub out TRS; Jack_6.35mm_Neutrik_NJ6FD-V_Vertical; MPN Neutrik NJ6FD-V
J3: Aux out TRS; Jack_6.35mm_Neutrik_NJ6FD-V_Vertical; MPN Neutrik NJ6FD-V
J4: Return L in; Jack_6.35mm_Neutrik_NJ6FD-V_Vertical; MPN Neutrik NJ6FD-V
J5: Return R in; Jack_6.35mm_Neutrik_NJ6FD-V_Vertical; MPN Neutrik NJ6FD-V
J6: Return 2 L in; Jack_6.35mm_Neutrik_NJ6FD-V_Vertical; MPN Neutrik NJ6FD-V
J7: Return 2 R in; Jack_6.35mm_Neutrik_NJ6FD-V_Vertical; MPN Neutrik NJ6FD-V

Connections:
/A_ON: CN1.9, J3.R
/A_OP: CN1.8, J3.T
/CHASSIS: H1.1, H2.1, J2.S, J3.S, J4.S, J5.S, J6.S, J7.S
/Return2_LR: CN2.2, J6.R, J7.RN
/Return2_LT: CN2.1, J6.T, J7.TN
/Return2_RR: CN2.5, J7.R
/Return2_RT: CN2.4, J7.T
/Return_LR: CN1.12, J4.R, J5.RN
/Return_LT: CN1.11, J4.T, J5.TN
/Return_RR: CN1.15, J5.R
/Return_RT: CN1.14, J5.T
/SUB_RETRAW: CN1.3, J1.R
/SUB_SEND: CN1.1, J1.RN, J1.T
/S_ON: CN1.6, J2.R
/S_OP: CN1.5, J2.T
GNDA: CN1.2, CN1.4, CN1.7, CN1.10, CN1.13, CN1.16, CN2.3, CN2.6, CN2.7, CN2.8, CN2.9, CN2.10, J1.S, J4.RN, J4.TN, J6.RN, J6.TN

Notes on the sheet:
JACK BOARD panel jacks under the panel (~24 mm deep); 2x8 IDC ribbon to the main board, pin = conductor

Board: 2 copper layers, 11 parts (2 on the bottom side), 16 nets, no tracks yet.
