cozycactus/goa-console/boards/master/master.kicad_pcb

## KiCad design boards/master/master.kicad_pcb (2026-11-09)

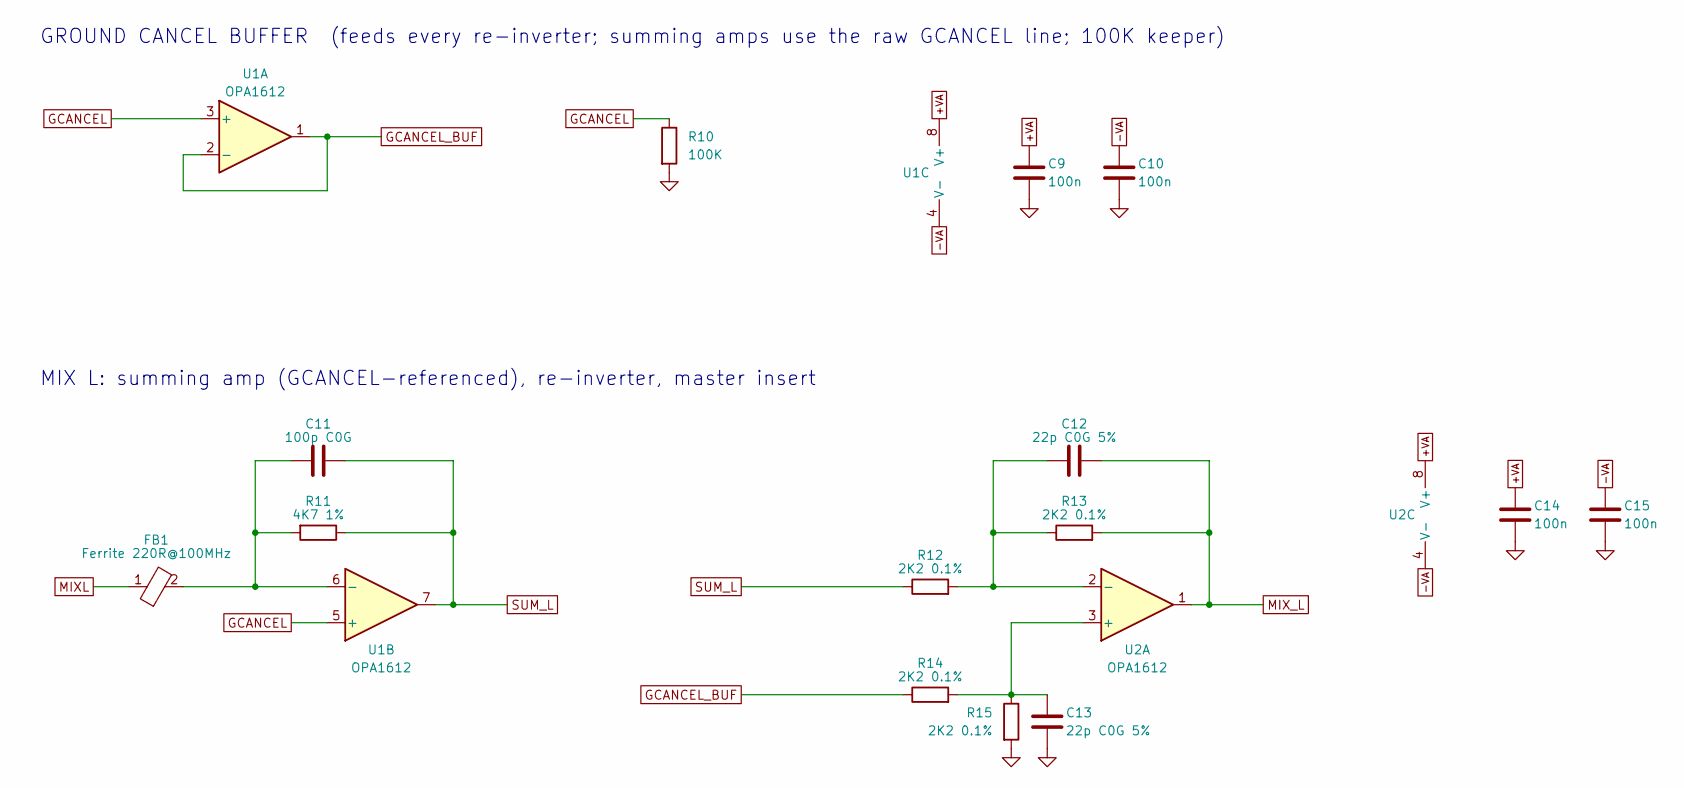
[picture p110: schematic 02_ground_cancel_buffer.kicad_sch, GROUND CANCEL BUFFER, MIX L]

Parts:
C9, C10, C14, C15: 100n; C_0805_2012Metric; MPN Samsung CL21B104KBCNNNC (X7R 50V)
C11: 100p C0G; C_0805_2012Metric; MPN KEMET C0805C101J5GACTU
C12, C13: 22p C0G 5%; C_0805_2012Metric; MPN KEMET C0805C220J5GACTU
FB1: Ferrite 220R@100MHz; L_0805_2012Metric; MPN Murata BLM21PG221SN1D
R10: 100K; R_0805_2012Metric
R11: 4K7 1%; R_0805_2012Metric
R12, R13, R14, R15: 2K2 0.1%; R_0805_2012Metric; MPN Panasonic ERA-6AEB222V
U1, U2: OPA1612; SOIC-8_3.9x4.9mm_P1.27mm; MPN TI OPA1612AIDR

Connections:
+VA: C9.1, C14.1, U1.8 (V+), U2.8 (V+); also elsewhere on the board
-VA: C10.2, C15.2, U1.4 (V-), U2.4 (V-); also elsewhere on the board
GCANCEL: R10.1, U1.3 (+), U1.5 (+); also elsewhere on the board
GCANCEL_BUF: R14.1, U1.1, U1.2 (-); also elsewhere on the board
GNDA: C9.2, C10.1, C13.2, C14.2, C15.1, R10.2, R15.2; also elsewhere on the board
MIXL: FB1.1; also elsewhere on the board
MIX_L: C12.1, R13.2, U2.1; also elsewhere on the board
unnamed: C11.2, FB1.2, R11.2, U1.6 (-)
unnamed: C13.1, R14.2, R15.1, U2.3 (+)
unnamed: C12.2, R12.2, R13.1, U2.2 (-)
SUM_L: C11.1, R11.1, R12.1, U1.7

Notes on the sheet:
GROUND CANCEL BUFFER (feeds every re-inverter; summing amps use the raw GCANCEL line; 100K keeper)
MIX L: summing amp (GCANCEL-referenced), re-inverter, master insert
