cozycactus/goa-console/boards/master/master.kicad_pcb

## KiCad design boards/master/master.kicad_pcb (continued)

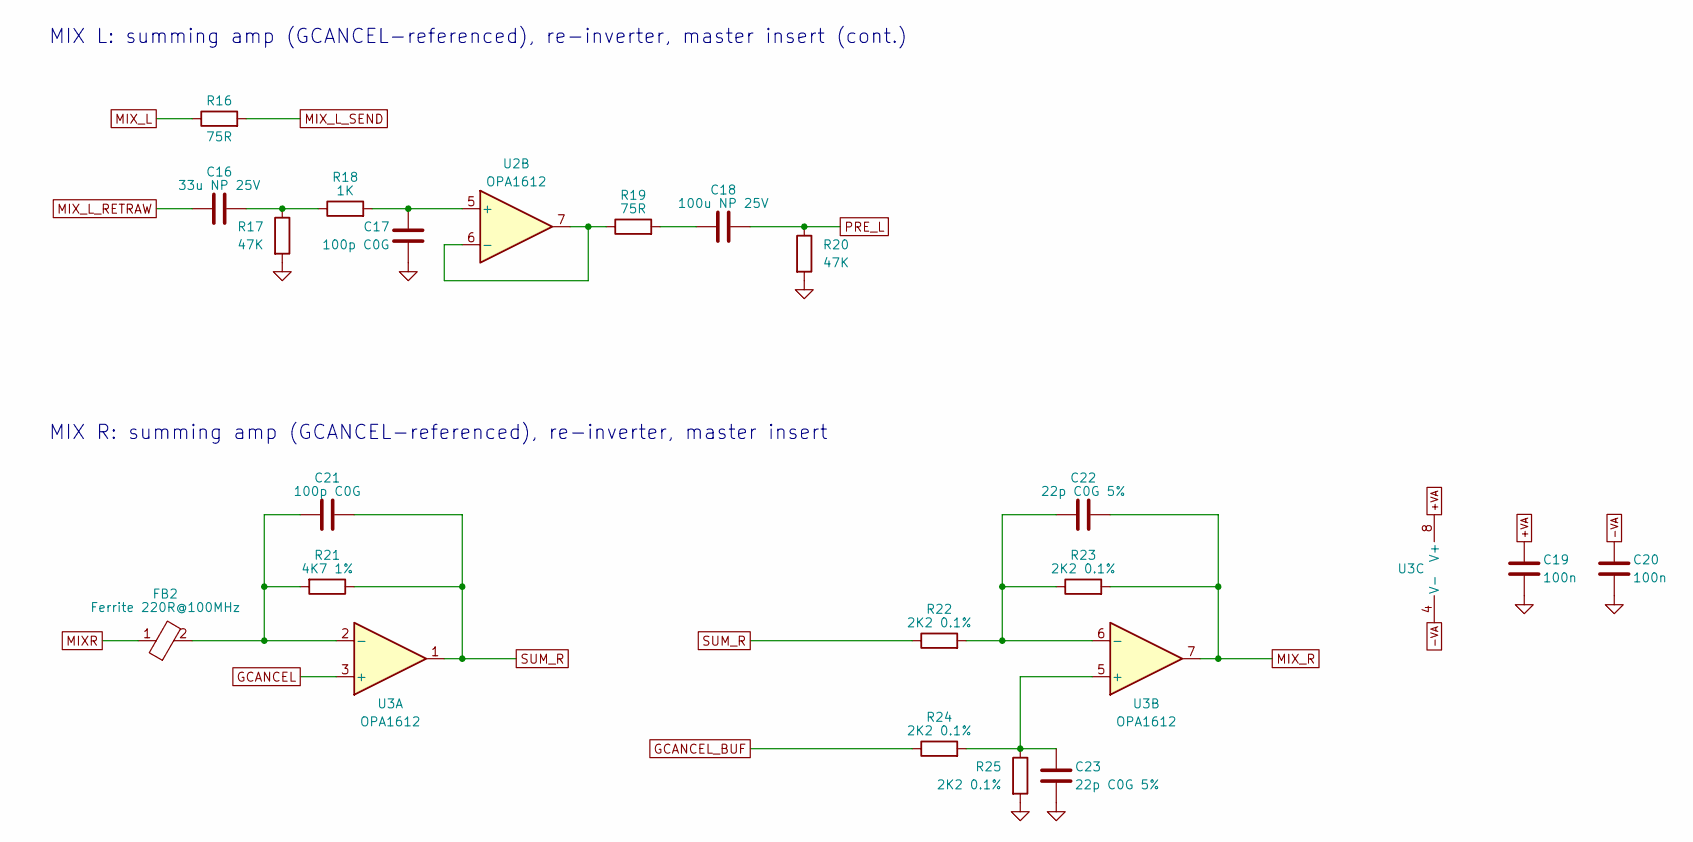
[picture p111: schematic 03_mix_l.kicad_sch, MIX L, MIX R]

Parts:
C16: 33u NP 25V; CP_Radial_D8.0mm_P3.50mm; MPN Nichicon UES1E330MPM (MUSE ES)
C17, C21: 100p C0G; C_0805_2012Metric; MPN KEMET C0805C101J5GACTU
C18: 100u NP 25V; CP_Radial_D10.0mm_P5.00mm; MPN Nichicon UES1E101MPM (MUSE ES)
C19, C20: 100n; C_0805_2012Metric; MPN Samsung CL21B104KBCNNNC (X7R 50V)
C22, C23: 22p C0G 5%; C_0805_2012Metric; MPN KEMET C0805C220J5GACTU
FB2: Ferrite 220R@100MHz; L_0805_2012Metric; MPN Murata BLM21PG221SN1D
R16: 75R; R_0805_2012Metric; MPN Panasonic ERJ-P06J750V
R17, R20: 47K; R_0805_2012Metric
R18: 1K; R_0805_2012Metric
R19: 75R; R_0805_2012Metric
R21: 4K7 1%; R_0805_2012Metric
R22, R23, R24, R25: 2K2 0.1%; R_0805_2012Metric; MPN Panasonic ERA-6AEB222V
U2, U3: OPA1612; SOIC-8_3.9x4.9mm_P1.27mm; MPN TI OPA1612AIDR

Connections:
+VA: C19.1, U3.8 (V+); also elsewhere on the board
-VA: C20.2, U3.4 (V-); also elsewhere on the board
GCANCEL: U3.3 (+); also elsewhere on the board
GCANCEL_BUF: R24.1; also elsewhere on the board
GNDA: C17.2, C19.2, C20.1, C23.2, R17.2, R20.2, R25.2; also elsewhere on the board
MIXR: FB2.1; also elsewhere on the board
MIX_L: R16.1; also elsewhere on the board
MIX_L_RETRAW: C16.1; also elsewhere on the board
MIX_L_SEND: R16.2; also elsewhere on the board
MIX_R: C22.1, R23.2, U3.7; also elsewhere on the board
unnamed: C16.2, R17.1, R18.1
unnamed: C18.1, R19.2
unnamed: C17.1, R18.2, U2.5 (+)
unnamed: R19.1, U2.6 (-), U2.7
unnamed: C21.2, FB2.2, R21.2, U3.2 (-)
unnamed: C23.1, R24.2, R25.1, U3.5 (+)
unnamed: C22.2, R22.2, R23.1, U3.6 (-)
PRE_L: C18.2, R20.1; also elsewhere on the board
SUM_R: C21.1, R21.1, R22.1, U3.1

Notes on the sheet:
MIX L: summing amp (GCANCEL-referenced), re-inverter, master insert (cont.)
MIX R: summing amp (GCANCEL-referenced), re-inverter, master insert

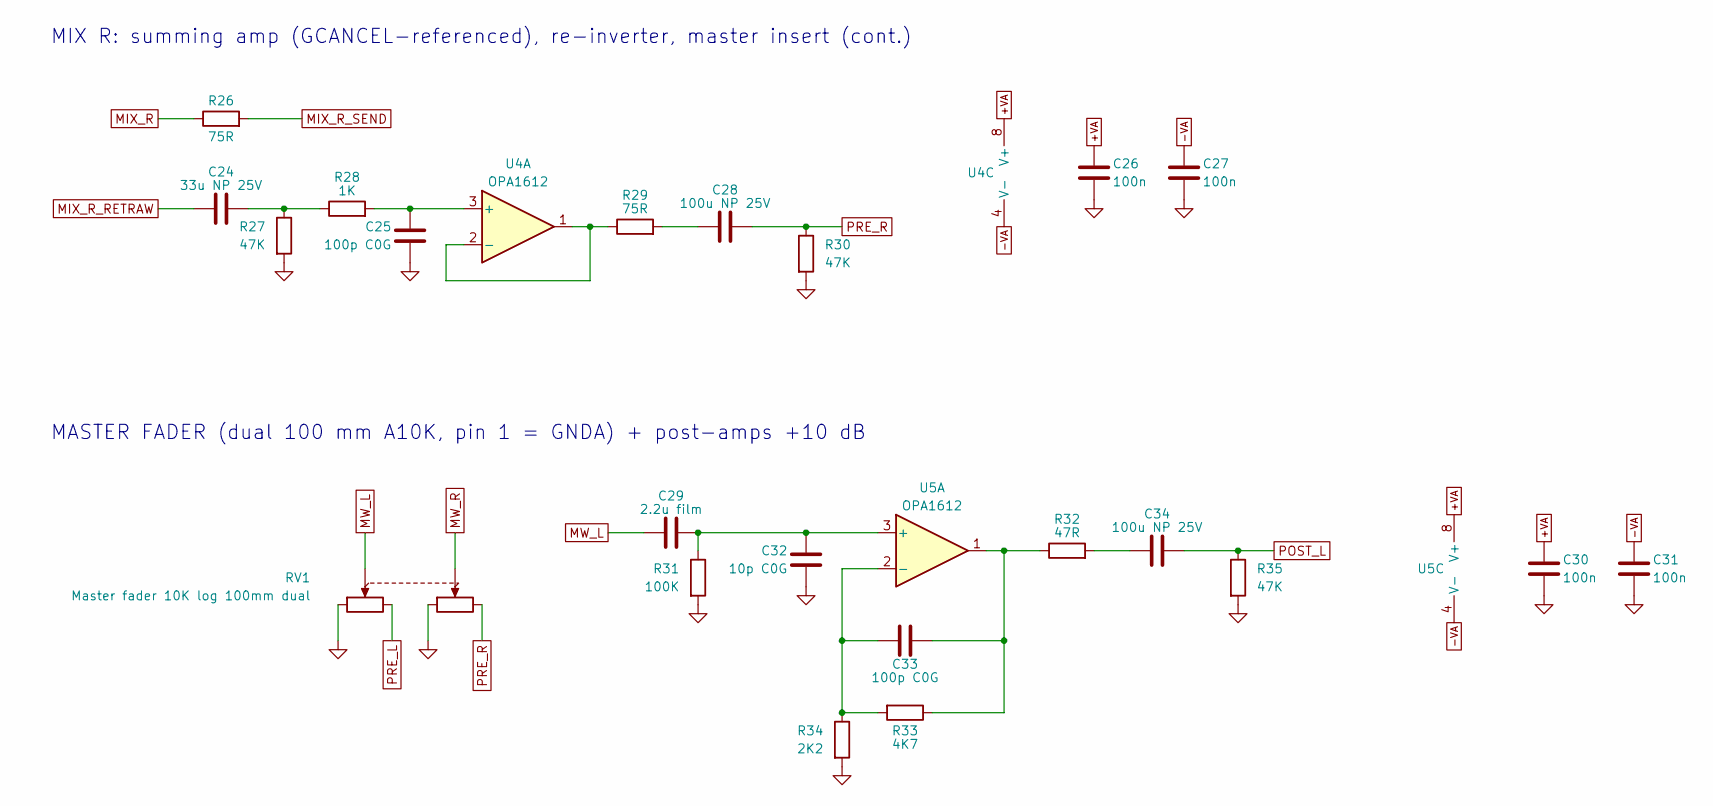
[picture p112: schematic 04_mix_r.kicad_sch, MIX R, MASTER FADER]

Parts:
C24: 33u NP 25V; CP_Radial_D8.0mm_P3.50mm; MPN Nichicon UES1E330MPM (MUSE ES)
C25, C33: 100p C0G; C_0805_2012Metric; MPN KEMET C0805C101J5GACTU
C26, C27, C30, C31: 100n; C_0805_2012Metric; MPN Samsung CL21B104KBCNNNC (X7R 50V)
C28, C34: 100u NP 25V; CP_Radial_D10.0mm_P5.00mm; MPN Nichicon UES1E101MPM (MUSE ES)
C29: 2.2u film; C_Rect_L7.2mm_W7.2mm_P5.00mm_FKS2_FKP2_MKS2_MKP2; MPN KEMET MMK5225K63J06L4BULK (PET 63V; rep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
C32: 10p C0G; C_0805_2012Metric; MPN KEMET C0805C100J5GACTU
R26: 75R; R_0805_2012Metric; MPN Panasonic ERJ-P06J750V
R27, R30, R35: 47K; R_0805_2012Metric
R28: 1K; R_0805_2012Metric
R29: 75R; R_0805_2012Metric
R31: 100K; R_0805_2012Metric
R32: 47R; R_0805_2012Metric
R33: 4K7; R_0805_2012Metric
R34: 2K2; R_0805_2012Metric
RV1: Master fader 10K log 100mm dual; Potentiometer_Bourns_PTB0144_Slide_100mm_Dual; MPN Bourns PTB0144-2010BPA103
U4, U5: OPA1612; SOIC-8_3.9x4.9mm_P1.27mm; MPN TI OPA1612AIDR

Connections:
+VA: C26.1, C30.1, U4.8 (V+), U5.8 (V+); also elsewhere on the board
-VA: C27.2, C31.2, U4.4 (V-), U5.4 (V-); also elsewhere on the board
GNDA: C25.2, C26.2, C27.1, C30.2, C31.1, C32.2, R27.2, R30.2, R31.2, R34.2, R35.2, RV1.1, RV1.4; also elsewhere on the board
MIX_R: R26.1; also elsewhere on the board
MIX_R_RETRAW: C24.1; also elsewhere on the board
MIX_R_SEND: R26.2; also elsewhere on the board
MW_L: C29.1, RV1.2
MW_R: RV1.5; also elsewhere on the board
unnamed: C24.2, R27.1, R28.1
unnamed: C28.1, R29.2
unnamed: C33.1, R32.1, R33.1, U5.1
unnamed: C34.1, R32.2
unnamed: C25.1, R28.2, U4.3 (+)
unnamed: R29.1, U4.1, U4.2 (-)
unnamed: C29.2, C32.1, R31.1, U5.3 (+)
unnamed: C33.2, R33.2, R34.1, U5.2 (-)
POST_L: C34.2, R35.1; also elsewhere on the board
PRE_L: RV1.3; also elsewhere on the board
PRE_R: C28.2, R30.1, RV1.6

Notes on the sheet:
MIX R: summing amp (GCANCEL-referenced), re-inverter, master insert (cont.)
MASTER FADER (dual 100 mm A10K, pin 1 = GNDA) + post-amps +10 dB

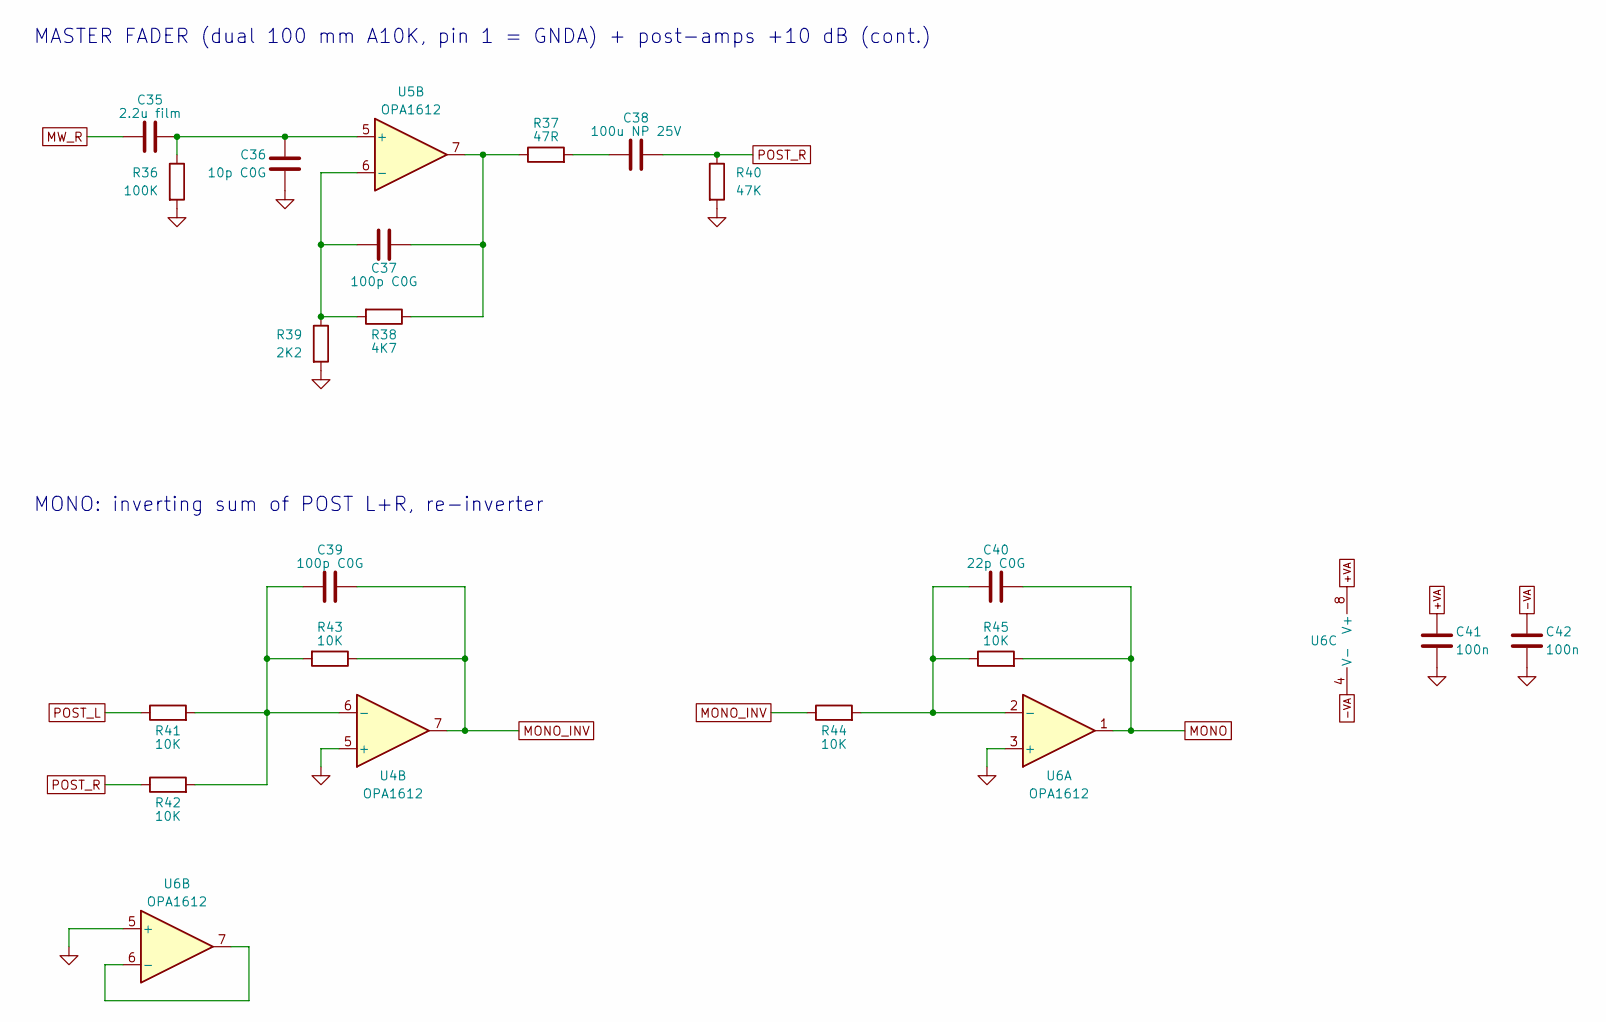
[picture p113: schematic 05_master_fader.kicad_sch, MASTER FADER, MONO]

Parts:
C35: 2.2u film; C_Rect_L7.2mm_W7.2mm_P5.00mm_FKS2_FKP2_MKS2_MKP2; MPN KEMET MMK5225K63J06L4BULK (PET 63V; rep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
C36: 10p C0G; C_0805_2012Metric; MPN KEMET C0805C100J5GACTU
C37, C39: 100p C0G; C_0805_2012Metric; MPN KEMET C0805C101J5GACTU
C38: 100u NP 25V; CP_Radial_D10.0mm_P5.00mm; MPN Nichicon UES1E101MPM (MUSE ES)
C40: 22p C0G; C_0805_2012Metric; MPN KEMET C0805C220J5GACTU
C41, C42: 100n; C_0805_2012Metric; MPN Samsung CL21B104KBCNNNC (X7R 50V)
R36: 100K; R_0805_2012Metric
R37: 47R; R_0805_2012Metric
R38: 4K7; R_0805_2012Metric
R39: 2K2; R_0805_2012Metric
R40: 47K; R_0805_2012Metric
R41, R42, R43, R44, R45: 10K; R_0805_2012Metric
U4, U5, U6: OPA1612; SOIC-8_3.9x4.9mm_P1.27mm; MPN TI OPA1612AIDR

Connections:
+VA: C41.1, U6.8 (V+); also elsewhere on the board
-VA: C42.2, U6.4 (V-); also elsewhere on the board
GNDA: C36.2, C41.2, C42.1, R36.2, R39.2, R40.2, U4.5 (+), U6.3 (+), U6.5 (+); also elsewhere on the board
MONO: C40.1, R45.2, U6.1; also elsewhere on the board
MONO_INV: C39.1, R43.1, R44.1, U4.7
MW_R: C35.1; also elsewhere on the board
unnamed: C37.1, R37.1, R38.1, U5.7
unnamed: C38.1, R37.2
unnamed: C39.2, R41.2, R42.2, R43.2, U4.6 (-)
unnamed: C35.2, C36.1, R36.1, U5.5 (+)
unnamed: C37.2, R38.2, R39.1, U5.6 (-)
unnamed: C40.2, R44.2, R45.1, U6.2 (-)
unnamed: U6.6 (-), U6.7
POST_L: R41.1; also elsewhere on the board
POST_R: C38.2, R40.1, R42.1; also elsewhere on the board

Notes on the sheet:
MASTER FADER (dual 100 mm A10K, pin 1 = GNDA) + post-amps +10 dB (cont.)
MONO: inverting sum of POST L+R, re-inverter

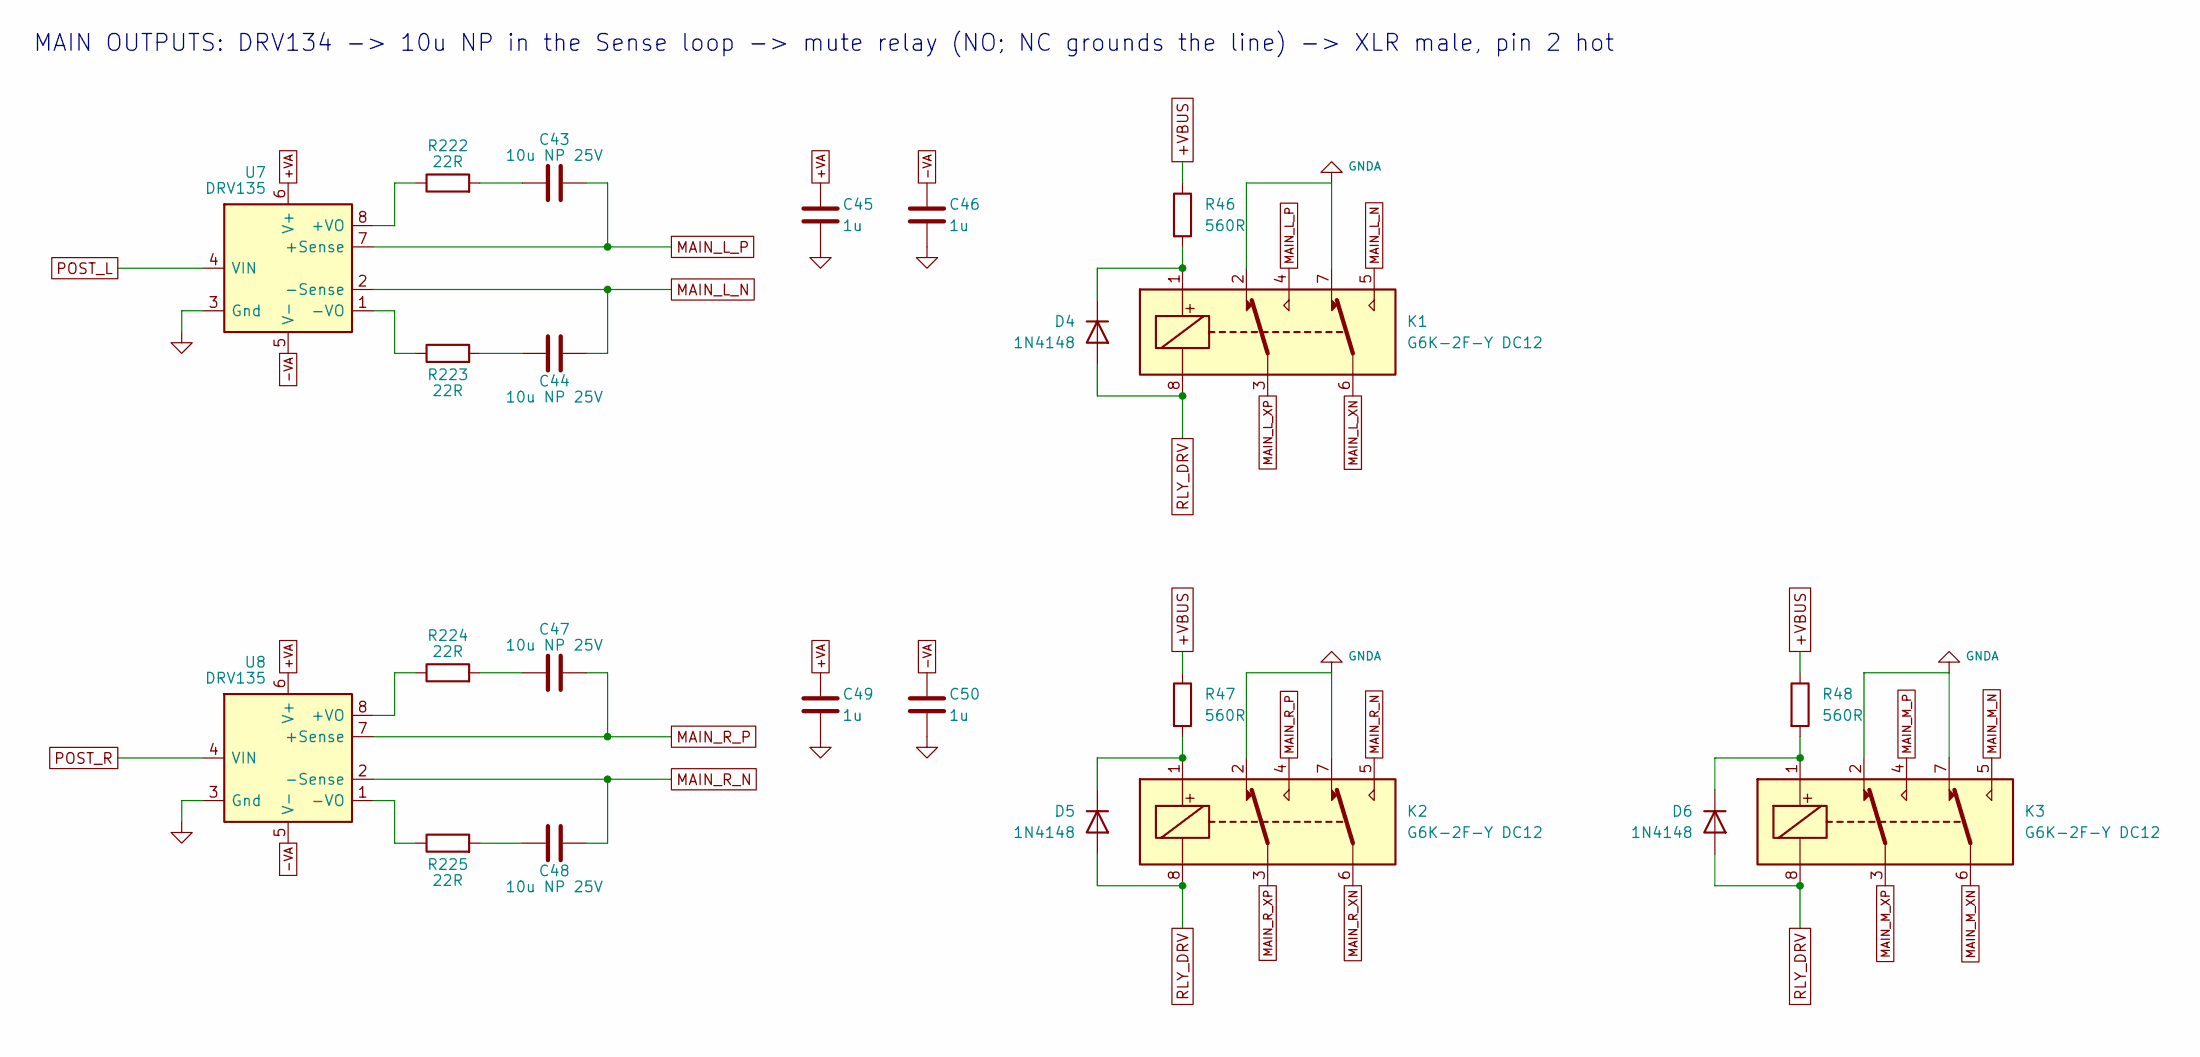
[picture p114: schematic 06_main_outputs.kicad_sch, MAIN OUTPUTS]

Parts:
C43, C44, C47, C48: 10u NP 25V; CP_Radial_D5.0mm_P2.00mm; MPN Panasonic ECE-A1EN100U (matched pair: t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
C45, C46, C49, C50: 1u; C_1206_3216Metric; MPN Samsung CL31B105KBHNNNE (X7R 50V)
D4, D5, D6: 1N4148; D_DO-35_SOD27_P7.62mm_Horizontal; MPN Vishay 1N4148-TAP
K1, K2, K3: G6K-2F-Y DC12; Relay_DPDT_Omron_G6K-2F-Y; MPN Omron G6K-2F-Y DC12
R46, R47, R48: 560R; R_0805_2012Metric
R222, R223, R224, R225: 22R; R_0805_2012Metric; MPN Panasonic ERJ-P06J220V
U7, U8: DRV135; SOIC-8_3.9x4.9mm_P1.27mm; MPN TI DRV135UA

Connections:
+VA: C45.1, C49.1, U7.6 (V+), U8.6 (V+); also elsewhere on the board
+VBUS: R46.1, R47.1, R48.1; also elsewhere on the board
-VA: C46.2, C50.2, U7.5 (V-), U8.5 (V-); also elsewhere on the board
GNDA: C45.2, C46.1, C49.2, C50.1, K1.2, K1.7, K2.2, K2.7, K3.2, K3.7, U7.3 (Gnd), U8.3 (Gnd); also elsewhere on the board
MAIN_L_N: C44.2, K1.5, U7.2 (-Sense)
MAIN_L_P: C43.2, K1.4, U7.7 (+Sense)
MAIN_L_XN: K1.6; also elsewhere on the board
MAIN_L_XP: K1.3; also elsewhere on the board
MAIN_M_N: K3.5; also elsewhere on the board
MAIN_M_P: K3.4; also elsewhere on the board
MAIN_M_XN: K3.6; also elsewhere on the board
MAIN_M_XP: K3.3; also elsewhere on the board
MAIN_R_N: C48.2, K2.5, U8.2 (-Sense)
MAIN_R_P: C47.2, K2.4, U8.7 (+Sense)
MAIN_R_XN: K2.6; also elsewhere on the board
MAIN_R_XP: K2.3; also elsewhere on the board
unnamed: C43.1, R222.2
unnamed: C44.1, R223.2
unnamed: C47.1, R224.2
unnamed: C48.1, R225.2
unnamed: D4.1 (K), K1.1, R46.2
unnamed: D5.1 (K), K2.1, R47.2
unnamed: D6.1 (K), K3.1, R48.2
unnamed: R222.1, U7.8 (+VO)
unnamed: R223.1, U7.1 (-VO)
unnamed: R224.1, U8.8 (+VO)
unnamed: R225.1, U8.1 (-VO)
POST_L: U7.4 (VIN); also elsewhere on the board
POST_R: U8.4 (VIN); also elsewhere on the board
RLY_DRV: D4.2 (A), D5.2 (A), D6.2 (A), K1.8, K2.8, K3.8; also elsewhere on the board

Notes on the sheet:
MAIN OUTPUTS: DRV134 -> 10u NP in the Sense loop -> mute relay (NO; NC grounds the line) -> XLR male, pin 2 hot

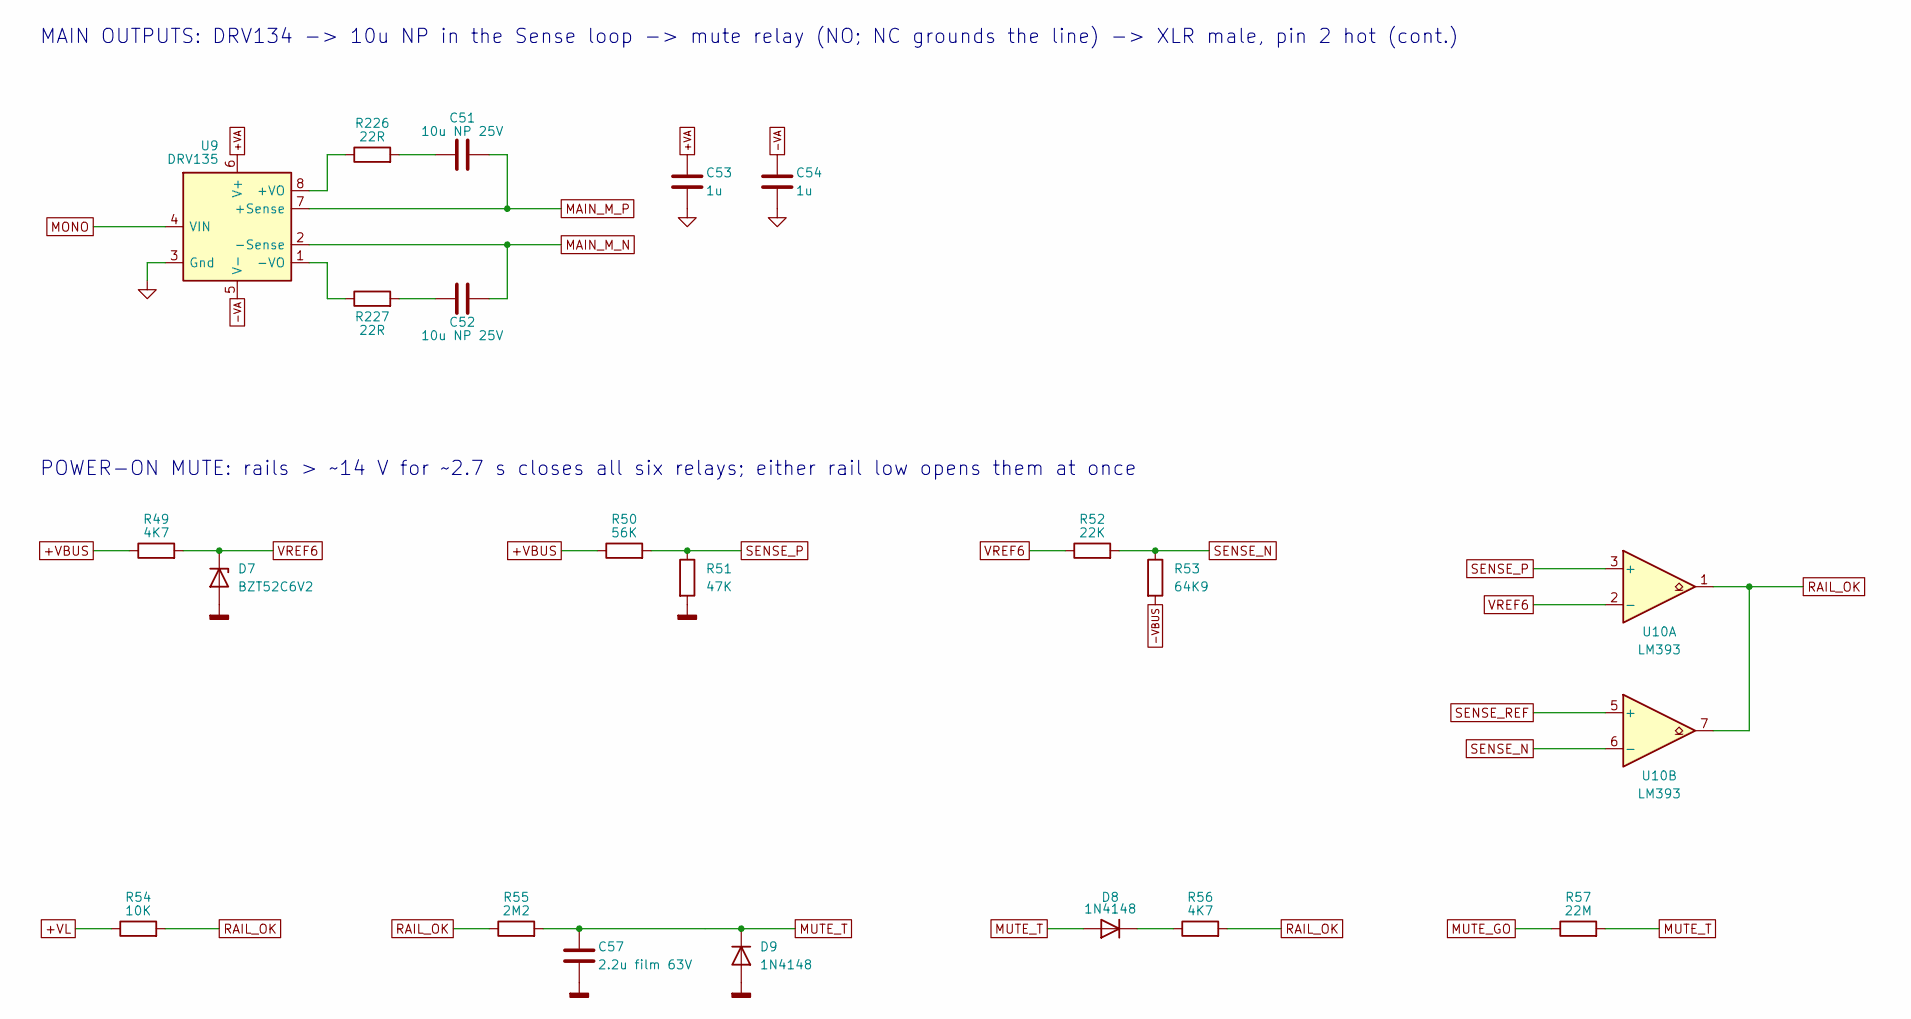
[picture p115: schematic 07_main_outputs.kicad_sch, MAIN OUTPUTS, POWER-ON MUTE]

Parts:
C51, C52: 10u NP 25V; CP_Radial_D5.0mm_P2.00mm; MPN Panasonic ECE-A1EN100U (matched pair: t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
C53, C54: 1u; C_1206_3216Metric; MPN Samsung CL31B105KBHNNNE (X7R 50V)
C57: 2.2u film 63V; C_Rect_L7.2mm_W7.2mm_P5.00mm_FKS2_FKP2_MKS2_MKP2; MPN KEMET MMK5225K63J06L4BULK (PET 63V; rep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
D7: BZT52C6V2; D_SOD-123; MPN Diodes BZT52C6V2-7-F
D8, D9: 1N4148; D_DO-35_SOD27_P7.62mm_Horizontal; MPN Vishay 1N4148-TAP
R49, R56: 4K7; R_0805_2012Metric
R50: 56K; R_0805_2012Metric
R51: 47K; R_0805_2012Metric
R52: 22K; R_0805_2012Metric
R53: 64K9; R_0805_2012Metric
R54: 10K; R_0805_2012Metric; MPN Panasonic ERJ-P06J103V
R55: 2M2; R_0805_2012Metric
R57: 22M; R_0805_2012Metric; MPN Yageo RC0805JR-0722ML
R226, R227: 22R; R_0805_2012Metric; MPN Panasonic ERJ-P06J220V
U9: DRV135; SOIC-8_3.9x4.9mm_P1.27mm; MPN TI DRV135UA
U10: LM393; SOIC-8_3.9x4.9mm_P1.27mm; MPN TI LM393BIDR

Connections:
+VA: C53.1, U9.6 (V+); also elsewhere on the board
+VBUS: R49.1, R50.1; also elsewhere on the board
+VL: R54.1; also elsewhere on the board
-VA: C54.2, U9.5 (V-); also elsewhere on the board
-VBUS: R53.2; also elsewhere on the board
GNDA: C53.2, C54.1, U9.3 (Gnd); also elsewhere on the board
GNDD: C57.2, D7.2 (A), D9.2 (A), R51.2; also elsewhere on the board
MAIN_M_N: C52.2, U9.2 (-Sense); also elsewhere on the board
MAIN_M_P: C51.2, U9.7 (+Sense); also elsewhere on the board
MONO: U9.4 (VIN); also elsewhere on the board
MUTE_GO: R57.1; also elsewhere on the board
MUTE_T: C57.1, D8.2 (A), D9.1 (K), R55.2, R57.2; also elsewhere on the board
unnamed: C51.1, R226.2
unnamed: C52.1, R227.2
unnamed: D8.1 (K), R56.1
unnamed: R226.1, U9.8 (+VO)
unnamed: R227.1, U9.1 (-VO)
RAIL_OK: R54.2, R55.1, R56.2, U10.1, U10.7; also elsewhere on the board
SENSE_N: R52.2, R53.1, U10.6 (-)
SENSE_P: R50.2, R51.1, U10.3 (+)
SENSE_REF: U10.5 (+); also elsewhere on the board
VREF6: D7.1 (K), R49.2, R52.1, U10.2 (-); also elsewhere on the board

Notes on the sheet:
MAIN OUTPUTS: DRV134 -> 10u NP in the Sense loop -> mute relay (NO; NC grounds the line) -> XLR male, pin 2 hot (cont.)
POWER-ON MUTE: rails > ~14 V for ~2.7 s closes all six relays; either rail low opens them at once

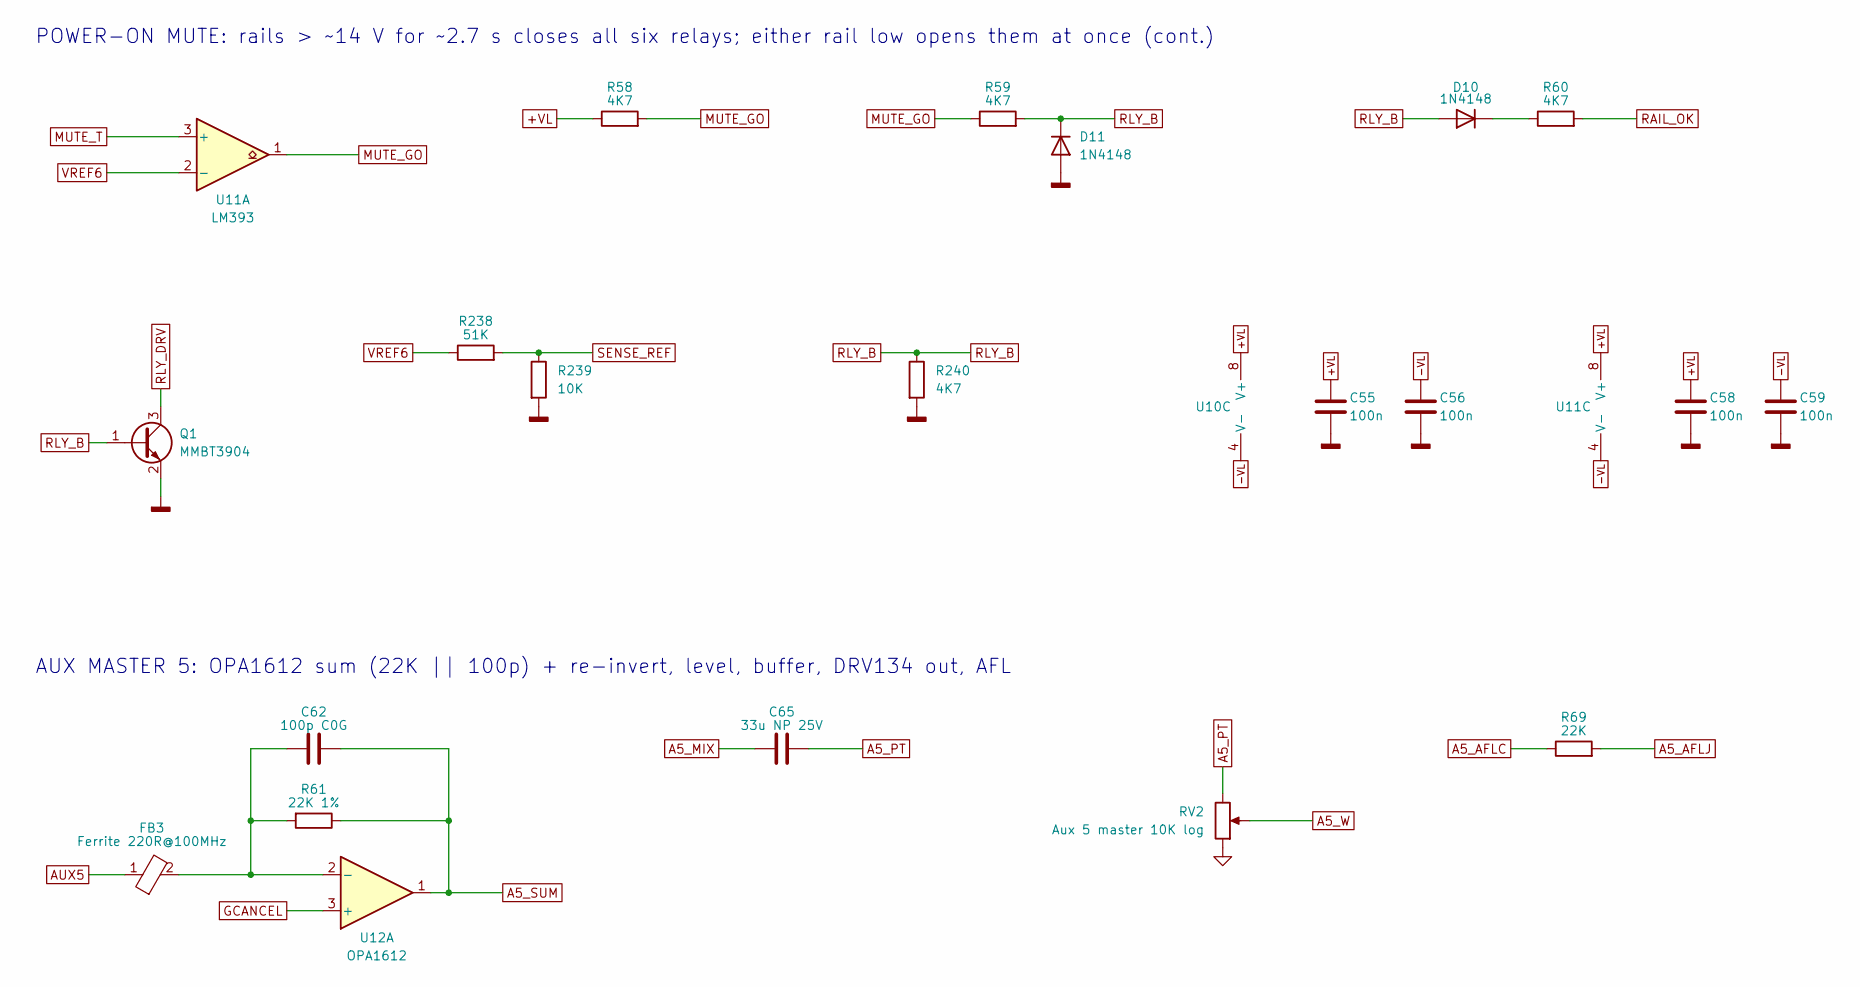
[picture p116: schematic 08_power_on_mute.kicad_sch, POWER-ON MUTE, AUX MASTER 5]

Parts:
C55, C56, C58, C59: 100n; C_0805_2012Metric; MPN Samsung CL21B104KBCNNNC (X7R 50V)
C62: 100p C0G; C_0805_2012Metric; MPN KEMET C0805C101J5GACTU
C65: 33u NP 25V; CP_Radial_D8.0mm_P3.50mm; MPN Nichicon UES1E330MPM (MUSE ES)
D10, D11: 1N4148; D_DO-35_SOD27_P7.62mm_Horizontal; MPN Vishay 1N4148-TAP
FB3: Ferrite 220R@100MHz; L_0805_2012Metric; MPN Murata BLM21PG221SN1D
Q1: MMBT3904; SOT-23; MPN onsemi MMBT3904LT1G
R58: 4K7; R_0805_2012Metric; MPN Panasonic ERJ-P06J472V
R59, R60, R240: 4K7; R_0805_2012Metric
R61: 22K 1%; R_0805_2012Metric
R69: 22K; R_0805_2012Metric
R238: 51K; R_0805_2012Metric
R239: 10K; R_0805_2012Metric
RV2: Aux 5 master 10K log; Potentiometer_Alpha_RD901F-40-00D_Single_Vertical; MPN Alpha RD901F-40-15R1-A10K
U10, U11: LM393; SOIC-8_3.9x4.9mm_P1.27mm; MPN TI LM393BIDR
U12: OPA1612; SOIC-8_3.9x4.9mm_P1.27mm; MPN TI OPA1612AIDR

Connections:
+VL: C55.1, C58.1, R58.1, U10.8 (V+), U11.8 (V+); also elsewhere on the board
-VL: C56.2, C59.2, U10.4 (V-), U11.4 (V-); also elsewhere on the board
A5_AFLC: R69.1; also elsewhere on the board
A5_AFLJ: R69.2; also elsewhere on the board
A5_MIX: C65.1; also elsewhere on the board
A5_PT: C65.2, RV2.3
A5_SUM: C62.1, R61.1, U12.1; also elsewhere on the board
A5_W: RV2.2; also elsewhere on the board
AUX5: FB3.1; also elsewhere on the board
GCANCEL: U12.3 (+); also elsewhere on the board
GNDA: RV2.1; also elsewhere on the board
GNDD: C55.2, C56.1, C58.2, C59.1, D11.2 (A), Q1.2 (E), R239.2, R240.2; also elsewhere on the board
MUTE_GO: R58.2, R59.1, U11.1; also elsewhere on the board
MUTE_T: U11.3 (+); also elsewhere on the board
unnamed: D10.1 (K), R60.1
unnamed: C62.2, FB3.2, R61.2, U12.2 (-)
RAIL_OK: R60.2; also elsewhere on the board
RLY_B: D10.2 (A), D11.1 (K), Q1.1 (B), R59.2, R240.1
RLY_DRV: Q1.3 (C); also elsewhere on the board
SENSE_REF: R238.2, R239.1; also elsewhere on the board
VREF6: R238.1, U11.2 (-); also elsewhere on the board

Notes on the sheet:
POWER-ON MUTE: rails > ~14 V for ~2.7 s closes all six relays; either rail low opens them at once (cont.)
AUX MASTER 5: OPA1612 sum (22K || 100p) + re-invert, level, buffer, DRV134 out, AFL

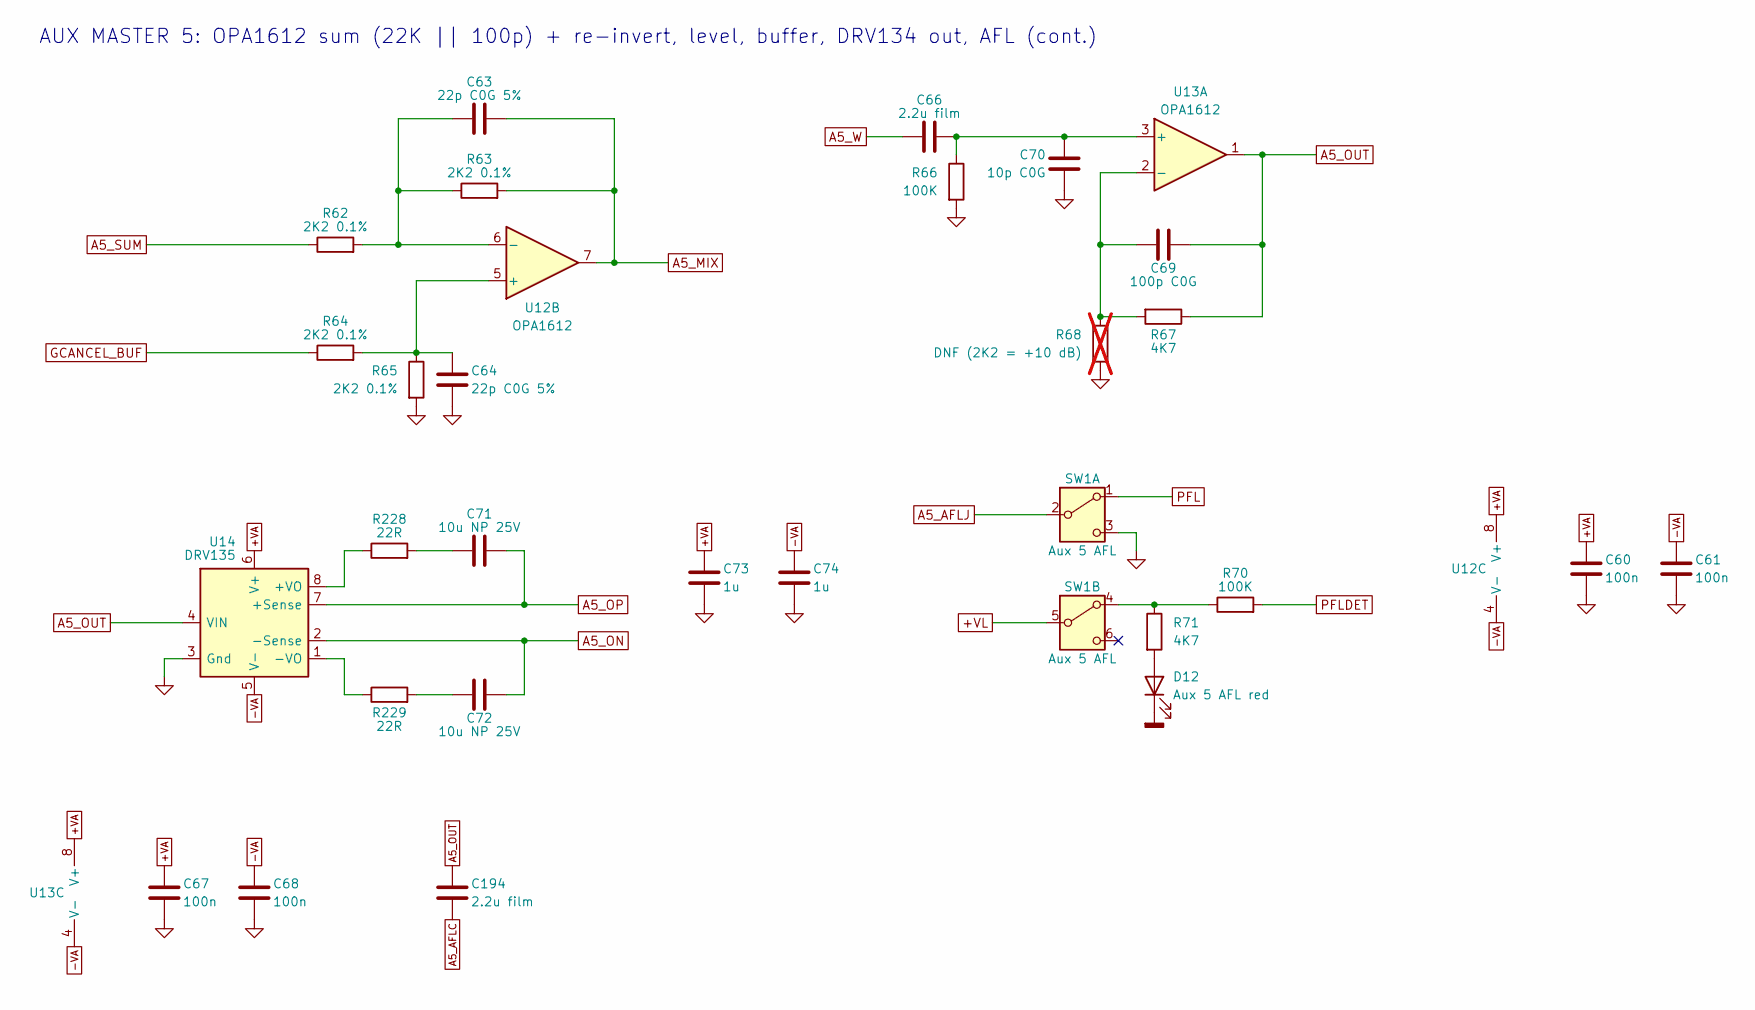
[picture p117: schematic 09_aux_master_5.kicad_sch, AUX MASTER 5]

Parts:
C60, C61, C67, C68: 100n; C_0805_2012Metric; MPN Samsung CL21B104KBCNNNC (X7R 50V)
C63, C64: 22p C0G 5%; C_0805_2012Metric; MPN KEMET C0805C220J5GACTU
C66, C194: 2.2u film; C_Rect_L7.2mm_W7.2mm_P5.00mm_FKS2_FKP2_MKS2_MKP2; MPN KEMET MMK5225K63J06L4BULK (PET 63V; rep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
C69: 100p C0G; C_0805_2012Metric; MPN KEMET C0805C101J5GACTU
C70: 10p C0G; C_0805_2012Metric; MPN KEMET C0805C100J5GACTU
C71, C72: 10u NP 25V; CP_Radial_D5.0mm_P2.00mm; MPN Panasonic ECE-A1EN100U (matched pair: t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
C73, C74: 1u; C_1206_3216Metric; MPN Samsung CL31B105KBHNNNE (X7R 50V)
D12: Aux 5 AFL red; LED_D3.0mm; MPN Kingbright WP710A10ID
R62, R63, R64, R65: 2K2 0.1%; R_0805_2012Metric; MPN Panasonic ERA-6AEB222V
R66, R70: 100K; R_0805_2012Metric
R67, R71: 4K7; R_0805_2012Metric
R68: DNF (2K2 = +10 dB); R_0805_2012Metric; not fitted
R228, R229: 22R; R_0805_2012Metric; MPN Panasonic ERJ-P06J220V
SW1: Aux 5 AFL; SW_Push_2P2T_Toggle_CK_PVA2xxH1xxxxxxV2; MPN C&K PVA2 EE H1 1.7N V2
U12, U13: OPA1612; SOIC-8_3.9x4.9mm_P1.27mm; MPN TI OPA1612AIDR
U14: DRV135; SOIC-8_3.9x4.9mm_P1.27mm; MPN TI DRV135UA

Connections:
+VA: C60.1, C67.1, C73.1, U12.8 (V+), U13.8 (V+), U14.6 (V+); also elsewhere on the board
+VL: SW1.5 (B); also elsewhere on the board
-VA: C61.2, C68.2, C74.2, U12.4 (V-), U13.4 (V-), U14.5 (V-); also elsewhere on the board
A5_AFLC: C194.2; also elsewhere on the board
A5_AFLJ: SW1.2 (B); also elsewhere on the board
A5_MIX: C63.1, R63.2, U12.7; also elsewhere on the board
A5_ON: C72.2, U14.2 (-Sense); also elsewhere on the board
A5_OP: C71.2, U14.7 (+Sense); also elsewhere on the board
A5_OUT: C69.1, C194.1, R67.1, U13.1, U14.4 (VIN)
A5_SUM: R62.1; also elsewhere on the board
A5_W: C66.1; also elsewhere on the board
GCANCEL_BUF: R64.1; also elsewhere on the board
GNDA: C60.2, C61.1, C64.2, C67.2, C68.1, C70.2, C73.2, C74.1, R65.2, R66.2, R68.2, SW1.3 (C), U14.3 (Gnd); also elsewhere on the board
GNDD: D12.1 (K); also elsewhere on the board
unnamed: C71.1, R228.2
unnamed: C72.1, R229.2
unnamed: D12.2 (A), R71.2
unnamed: R70.1, R71.1, SW1.4 (A)
unnamed: C64.1, R64.2, R65.1, U12.5 (+)
unnamed: C63.2, R62.2, R63.1, U12.6 (-)
unnamed: C66.2, C70.1, R66.1, U13.3 (+)
unnamed: C69.2, R67.2, R68.1, U13.2 (-)
unnamed: R228.1, U14.8 (+VO)
unnamed: R229.1, U14.1 (-VO)
PFL: SW1.1 (A); also elsewhere on the board
PFLDET: R70.2; also elsewhere on the board

Notes on the sheet:
AUX MASTER 5: OPA1612 sum (22K || 100p) + re-invert, level, buffer, DRV134 out, AFL (cont.)
