cozycactus/goa-console/boards/master/master.kicad_pcb

## KiCad design boards/master/master.kicad_pcb (continued)

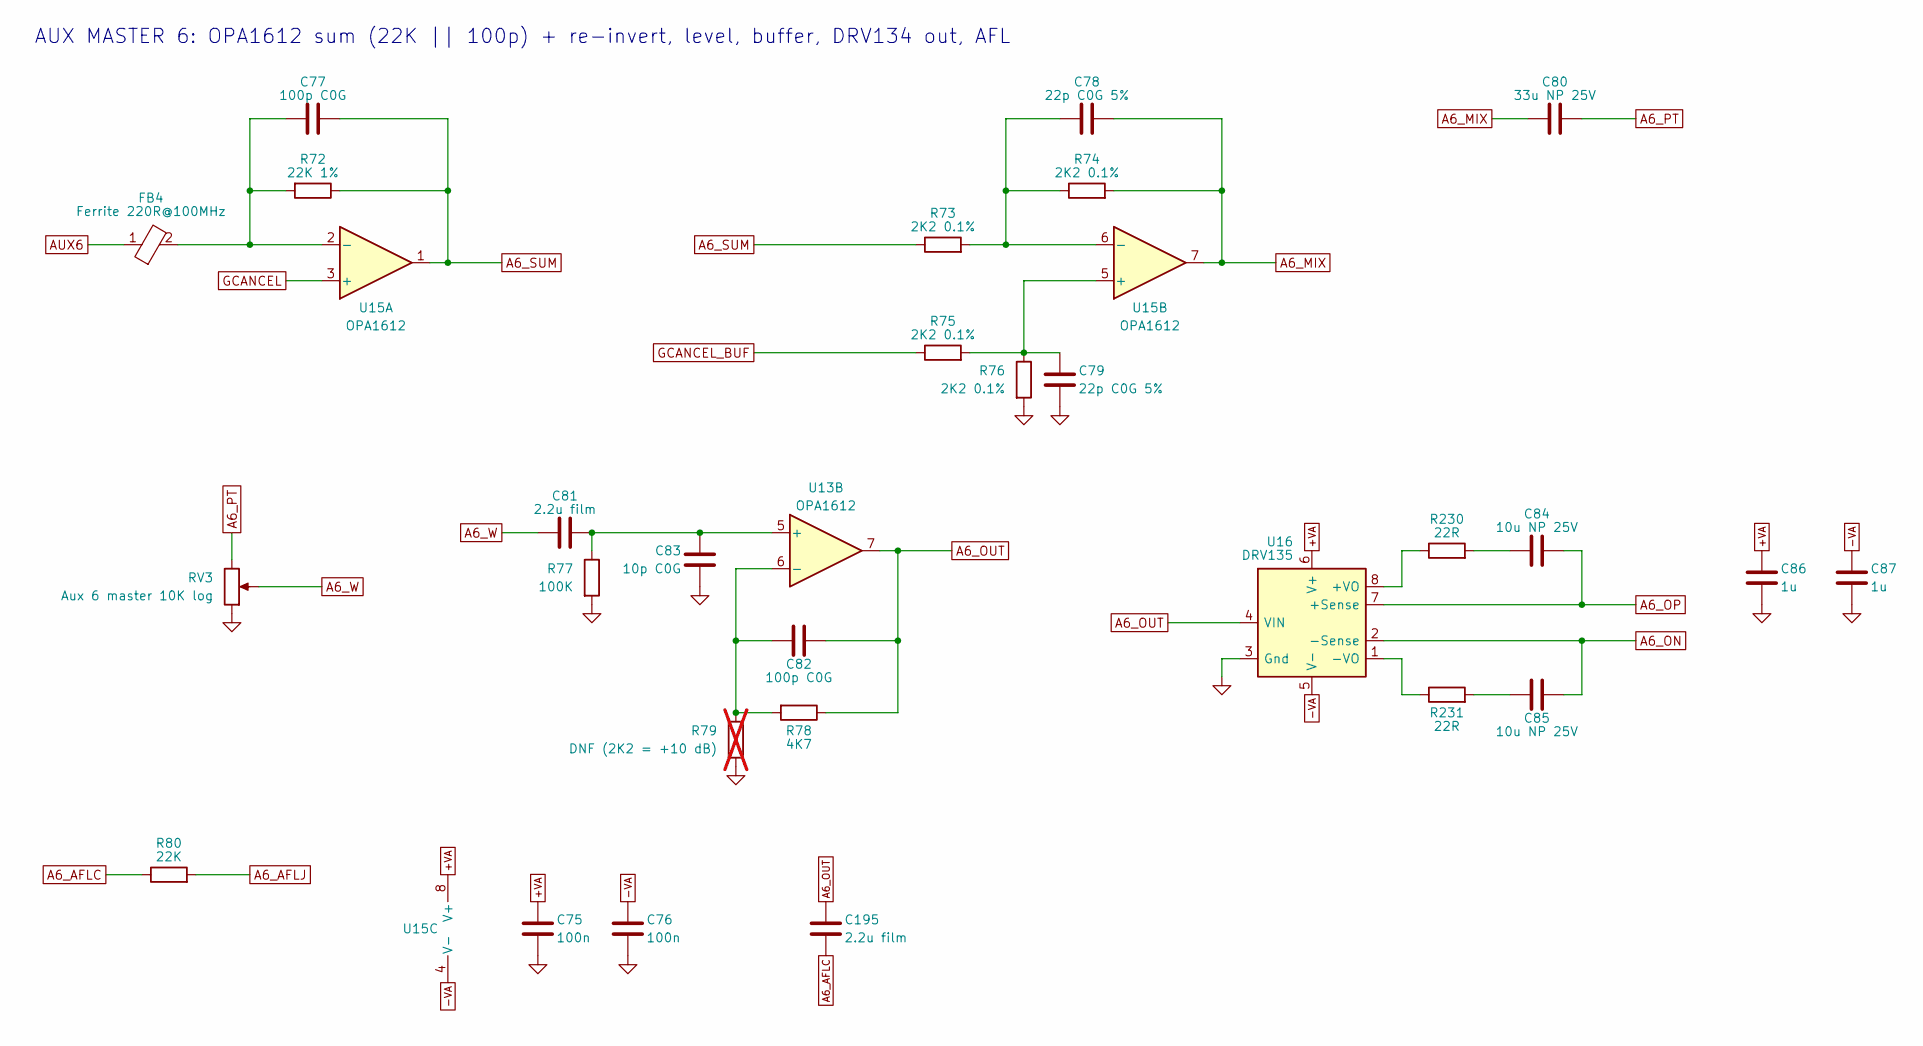
[picture p118: schematic 10_aux_master_6.kicad_sch, AUX MASTER 6]

Parts:
C75, C76: 100n; C_0805_2012Metric; MPN Samsung CL21B104KBCNNNC (X7R 50V)
C77, C82: 100p C0G; C_0805_2012Metric; MPN KEMET C0805C101J5GACTU
C78, C79: 22p C0G 5%; C_0805_2012Metric; MPN KEMET C0805C220J5GACTU
C80: 33u NP 25V; CP_Radial_D8.0mm_P3.50mm; MPN Nichicon UES1E330MPM (MUSE ES)
C81, C195: 2.2u film; C_Rect_L7.2mm_W7.2mm_P5.00mm_FKS2_FKP2_MKS2_MKP2; MPN KEMET MMK5225K63J06L4BULK (PET 63V; rep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
C83: 10p C0G; C_0805_2012Metric; MPN KEMET C0805C100J5GACTU
C84, C85: 10u NP 25V; CP_Radial_D5.0mm_P2.00mm; MPN Panasonic ECE-A1EN100U (matched pair: t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
C86, C87: 1u; C_1206_3216Metric; MPN Samsung CL31B105KBHNNNE (X7R 50V)
FB4: Ferrite 220R@100MHz; L_0805_2012Metric; MPN Murata BLM21PG221SN1D
R72: 22K 1%; R_0805_2012Metric
R73, R74, R75, R76: 2K2 0.1%; R_0805_2012Metric; MPN Panasonic ERA-6AEB222V
R77: 100K; R_0805_2012Metric
R78: 4K7; R_0805_2012Metric
R79: DNF (2K2 = +10 dB); R_0805_2012Metric; not fitted
R80: 22K; R_0805_2012Metric
R230, R231: 22R; R_0805_2012Metric; MPN Panasonic ERJ-P06J220V
RV3: Aux 6 master 10K log; Potentiometer_Alpha_RD901F-40-00D_Single_Vertical; MPN Alpha RD901F-40-15R1-A10K
U13, U15: OPA1612; SOIC-8_3.9x4.9mm_P1.27mm; MPN TI OPA1612AIDR
U16: DRV135; SOIC-8_3.9x4.9mm_P1.27mm; MPN TI DRV135UA

Connections:
+VA: C75.1, C86.1, U15.8 (V+), U16.6 (V+); also elsewhere on the board
-VA: C76.2, C87.2, U15.4 (V-), U16.5 (V-); also elsewhere on the board
A6_AFLC: C195.2, R80.1
A6_AFLJ: R80.2; also elsewhere on the board
A6_MIX: C78.1, C80.1, R74.2, U15.7
A6_ON: C85.2, U16.2 (-Sense); also elsewhere on the board
A6_OP: C84.2, U16.7 (+Sense); also elsewhere on the board
A6_OUT: C82.1, C195.1, R78.1, U13.7, U16.4 (VIN)
A6_PT: C80.2, RV3.3
A6_SUM: C77.1, R72.1, R73.1, U15.1
A6_W: C81.1, RV3.2
AUX6: FB4.1; also elsewhere on the board
GCANCEL: U15.3 (+); also elsewhere on the board
GCANCEL_BUF: R75.1; also elsewhere on the board
GNDA: C75.2, C76.1, C79.2, C83.2, C86.2, C87.1, R76.2, R77.2, R79.2, RV3.1, U16.3 (Gnd); also elsewhere on the board
unnamed: C84.1, R230.2
unnamed: C85.1, R231.2
unnamed: C81.2, C83.1, R77.1, U13.5 (+)
unnamed: C82.2, R78.2, R79.1, U13.6 (-)
unnamed: C77.2, FB4.2, R72.2, U15.2 (-)
unnamed: C79.1, R75.2, R76.1, U15.5 (+)
unnamed: C78.2, R73.2, R74.1, U15.6 (-)
unnamed: R230.1, U16.8 (+VO)
unnamed: R231.1, U16.1 (-VO)

Notes on the sheet:
AUX MASTER 6: OPA1612 sum (22K || 100p) + re-invert, level, buffer, DRV134 out, AFL

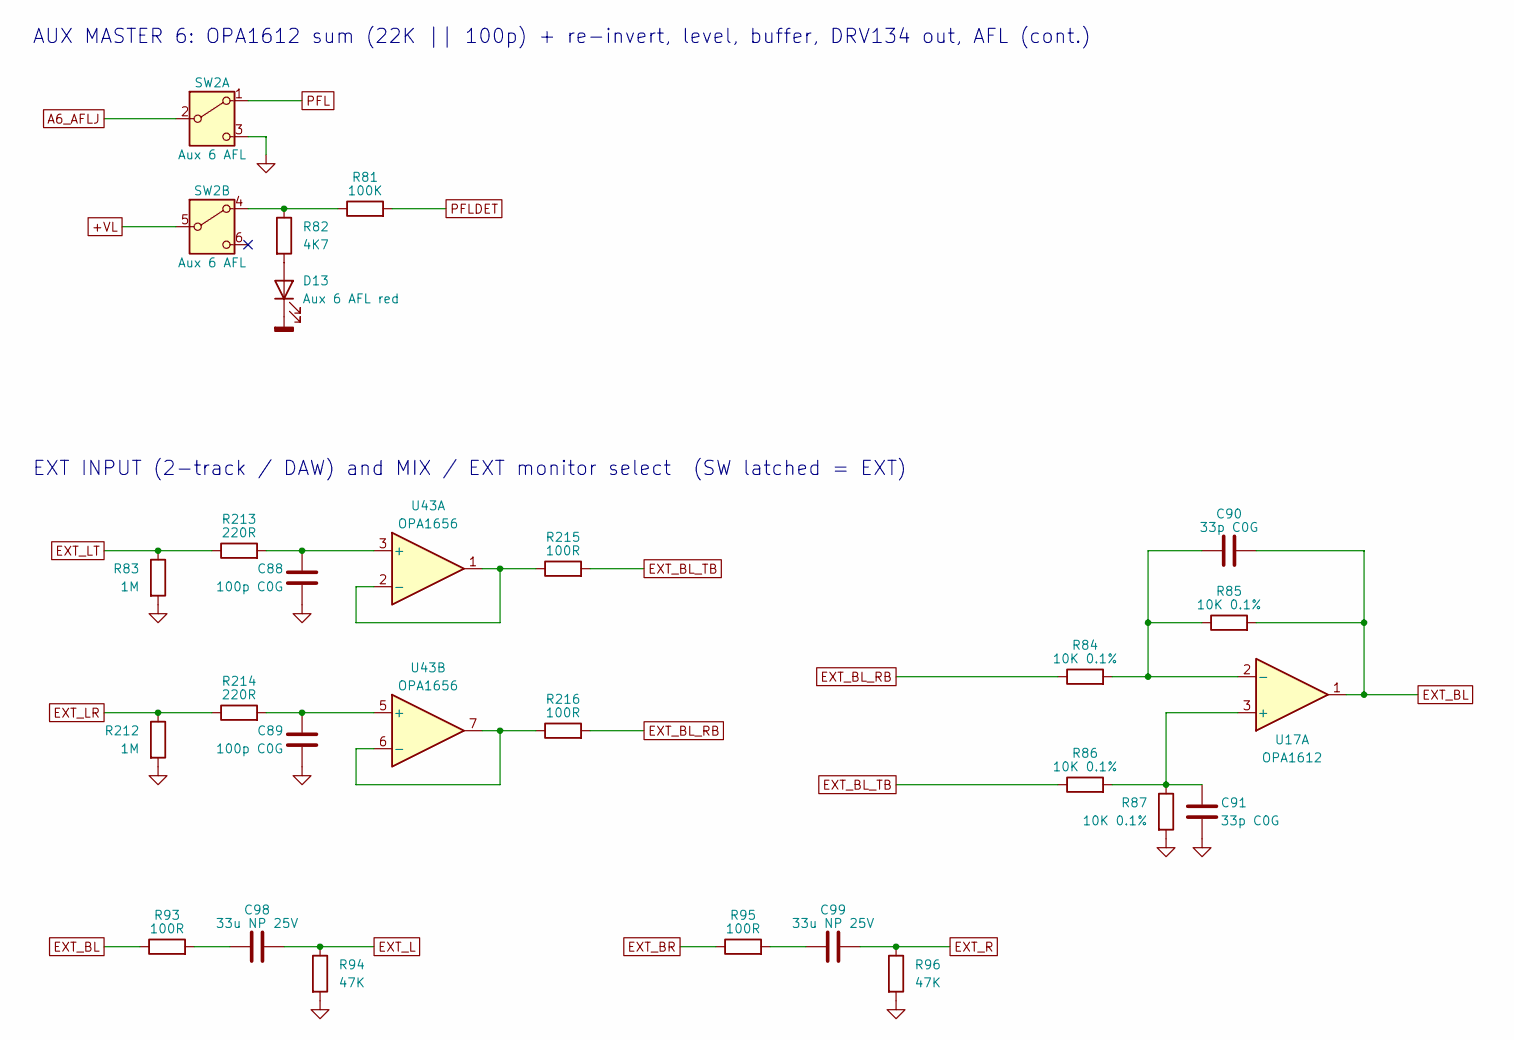
[picture p119: schematic 11_aux_master_6.kicad_sch, AUX MASTER 6, EXT INPUT]

Parts:
C88, C89: 100p C0G; C_0805_2012Metric; MPN KEMET C0805C101J5GACTU
C90, C91: 33p C0G; C_0805_2012Metric; MPN KEMET C0805C330J5GACTU
C98, C99: 33u NP 25V; CP_Radial_D8.0mm_P3.50mm; MPN Nichicon UES1E330MPM (MUSE ES)
D13: Aux 6 AFL red; LED_D3.0mm; MPN Kingbright WP710A10ID
R81: 100K; R_0805_2012Metric
R82: 4K7; R_0805_2012Metric
R83, R212: 1M; R_0805_2012Metric
R84, R85, R86, R87: 10K 0.1%; R_0805_2012Metric; MPN Panasonic ERA-6AEB103V
R93, R95, R215, R216: 100R; R_0805_2012Metric
R94, R96: 47K; R_0805_2012Metric
R213, R214: 220R; R_0805_2012Metric
SW2: Aux 6 AFL; SW_Push_2P2T_Toggle_CK_PVA2xxH1xxxxxxV2; MPN C&K PVA2 EE H1 1.7N V2
U17: OPA1612; SOIC-8_3.9x4.9mm_P1.27mm; MPN TI OPA1612AIDR
U43: OPA1656; SOIC-8_3.9x4.9mm_P1.27mm; MPN TI OPA1656IDR

Connections:
+VL: SW2.5 (B); also elsewhere on the board
A6_AFLJ: SW2.2 (B); also elsewhere on the board
EXT_BL: C90.2, R85.2, R93.1, U17.1
EXT_BL_RB: R84.1, R216.2
EXT_BL_TB: R86.1, R215.2
EXT_BR: R95.1; also elsewhere on the board
EXT_L: C98.2, R94.1; also elsewhere on the board
EXT_LR: R212.1, R214.1; also elsewhere on the board
EXT_LT: R83.1, R213.1; also elsewhere on the board
EXT_R: C99.2, R96.1; also elsewhere on the board
GNDA: C88.2, C89.2, C91.2, R83.2, R87.2, R94.2, R96.2, R212.2, SW2.3 (C); also elsewhere on the board
GNDD: D13.1 (K); also elsewhere on the board
unnamed: C98.1, R93.2
unnamed: C99.1, R95.2
unnamed: D13.2 (A), R82.2
unnamed: R81.1, R82.1, SW2.4 (A)
unnamed: C91.1, R86.2, R87.1, U17.3 (+)
unnamed: C90.1, R84.2, R85.1, U17.2 (-)
unnamed: C88.1, R213.2, U43.3 (+)
unnamed: R215.1, U43.1, U43.2 (-)
unnamed: C89.1, R214.2, U43.5 (+)
unnamed: R216.1, U43.6 (-), U43.7
PFL: SW2.1 (A); also elsewhere on the board
PFLDET: R81.2; also elsewhere on the board

Notes on the sheet:
AUX MASTER 6: OPA1612 sum (22K || 100p) + re-invert, level, buffer, DRV134 out, AFL (cont.)
EXT INPUT (2-track / DAW) and MIX / EXT monitor select (SW latched = EXT)

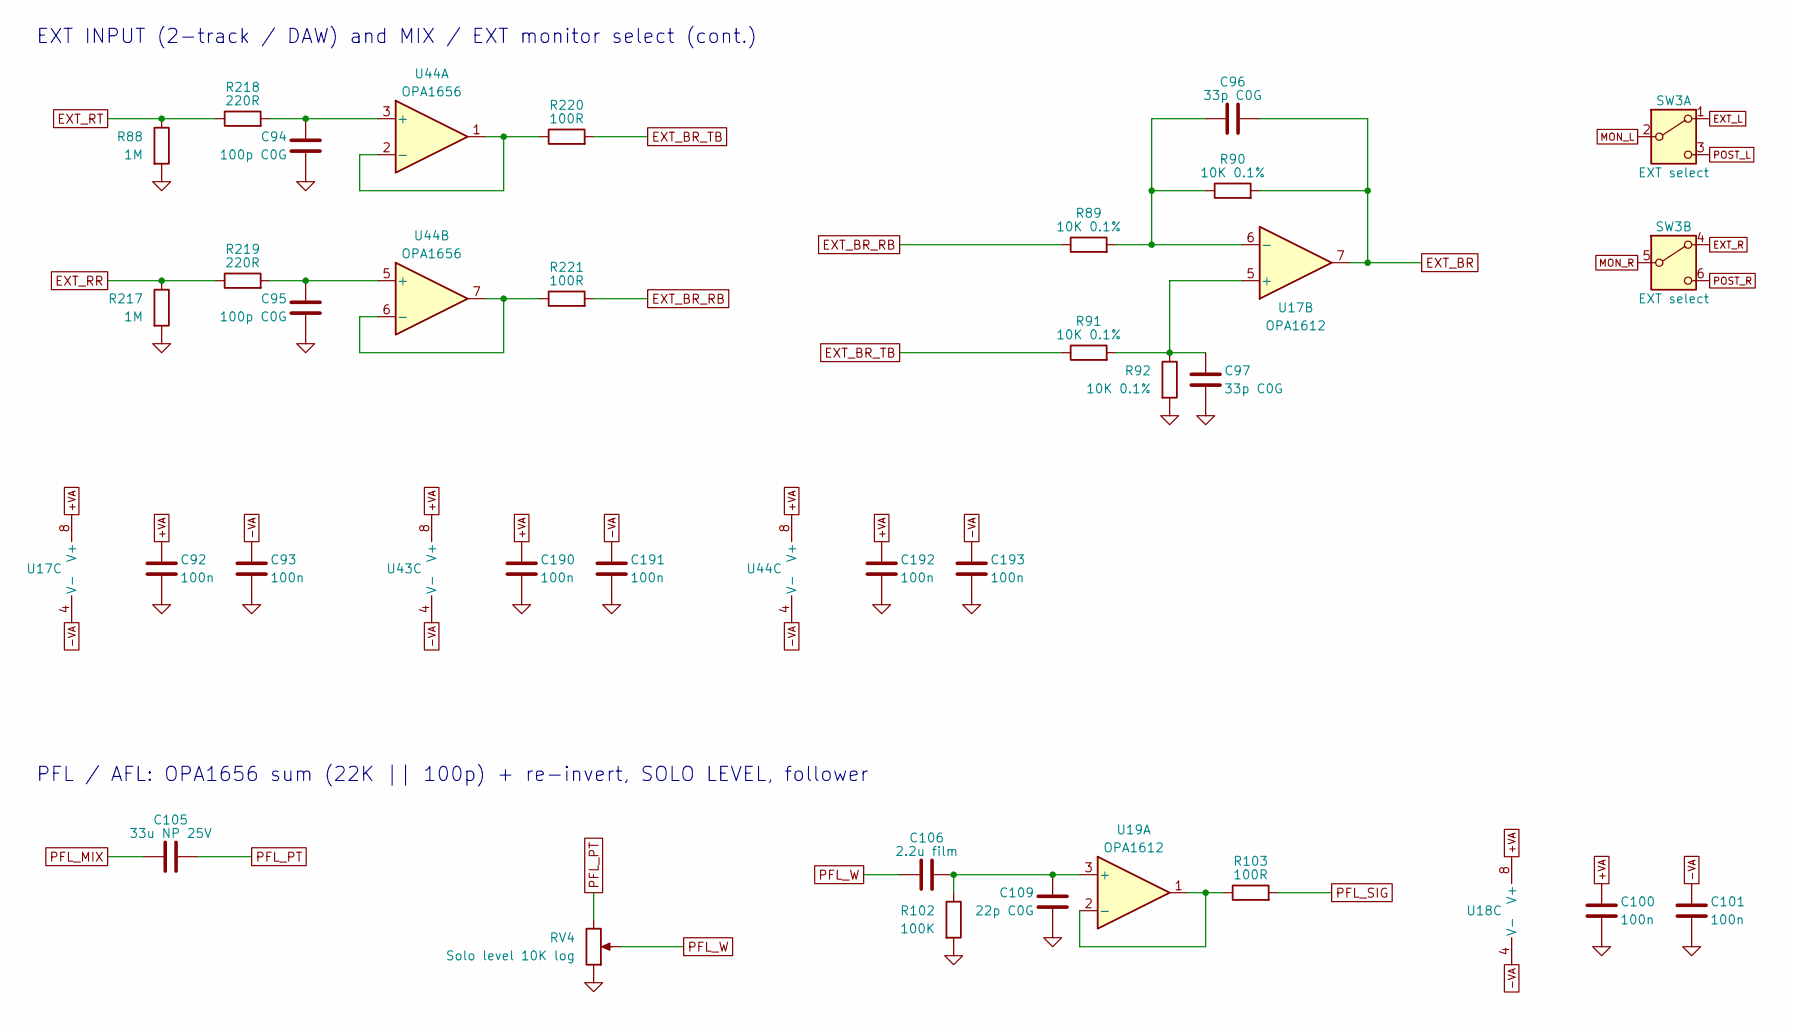
[picture p120: schematic 12_ext_input.kicad_sch, EXT INPUT, PFL-AFL]

Parts:
C92, C93, C100, C101, C190, C191, C192, C193: 100n; C_0805_2012Metric; MPN Samsung CL21B104KBCNNNC (X7R 50V)
C94, C95: 100p C0G; C_0805_2012Metric; MPN KEMET C0805C101J5GACTU
C96, C97: 33p C0G; C_0805_2012Metric; MPN KEMET C0805C330J5GACTU
C105: 33u NP 25V; CP_Radial_D8.0mm_P3.50mm; MPN Nichicon UES1E330MPM (MUSE ES)
C106: 2.2u film; C_Rect_L7.2mm_W7.2mm_P5.00mm_FKS2_FKP2_MKS2_MKP2; MPN KEMET MMK5225K63J06L4BULK (PET 63V; rep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
C109: 22p C0G; C_0805_2012Metric; MPN KEMET C0805C220J5GACTU
R88, R217: 1M; R_0805_2012Metric
R89, R90, R91, R92: 10K 0.1%; R_0805_2012Metric; MPN Panasonic ERA-6AEB103V
R102: 100K; R_0805_2012Metric
R103, R220, R221: 100R; R_0805_2012Metric
R218, R219: 220R; R_0805_2012Metric
RV4: Solo level 10K log; Potentiometer_Alpha_RD901F-40-00D_Single_Vertical; MPN Alpha RD901F-40-15R1-A10K
SW3: EXT select; SW_Push_2P2T_Toggle_CK_PVA2xxH1xxxxxxV2; MPN C&K PVA2 EE H1 1.7N V2
U17, U19: OPA1612; SOIC-8_3.9x4.9mm_P1.27mm; MPN TI OPA1612AIDR
U18, U43, U44: OPA1656; SOIC-8_3.9x4.9mm_P1.27mm; MPN TI OPA1656IDR

Connections:
+VA: C92.1, C100.1, C190.1, C192.1, U17.8 (V+), U18.8 (V+), U43.8 (V+), U44.8 (V+); also elsewhere on the board
-VA: C93.2, C101.2, C191.2, C193.2, U17.4 (V-), U18.4 (V-), U43.4 (V-), U44.4 (V-); also elsewhere on the board
EXT_BR: C96.2, R90.2, U17.7; also elsewhere on the board
EXT_BR_RB: R89.1, R221.2
EXT_BR_TB: R91.1, R220.2
EXT_L: SW3.1 (A); also elsewhere on the board
EXT_R: SW3.4 (A); also elsewhere on the board
EXT_RR: R217.1, R219.1; also elsewhere on the board
EXT_RT: R88.1, R218.1; also elsewhere on the board
GNDA: C92.2, C93.1, C94.2, C95.2, C97.2, C100.2, C101.1, C109.2, C190.2, C191.1, C192.2, C193.1, R88.2, R92.2, R102.2, R217.2, RV4.1; also elsewhere on the board
MON_L: SW3.2 (B); also elsewhere on the board
MON_R: SW3.5 (B); also elsewhere on the board
unnamed: C97.1, R91.2, R92.1, U17.5 (+)
unnamed: C96.1, R89.2, R90.1, U17.6 (-)
unnamed: C106.2, C109.1, R102.1, U19.3 (+)
unnamed: R103.1, U19.1, U19.2 (-)
unnamed: C94.1, R218.2, U44.3 (+)
unnamed: R220.1, U44.1, U44.2 (-)
unnamed: C95.1, R219.2, U44.5 (+)
unnamed: R221.1, U44.6 (-), U44.7
PFL_MIX: C105.1; also elsewhere on the board
PFL_PT: C105.2, RV4.3
PFL_SIG: R103.2; also elsewhere on the board
PFL_W: C106.1, RV4.2
POST_L: SW3.3 (C); also elsewhere on the board
POST_R: SW3.6 (C); also elsewhere on the board

Notes on the sheet:
EXT INPUT (2-track / DAW) and MIX / EXT monitor select (cont.)
PFL / AFL: OPA1656 sum (22K || 100p) + re-invert, SOLO LEVEL, follower

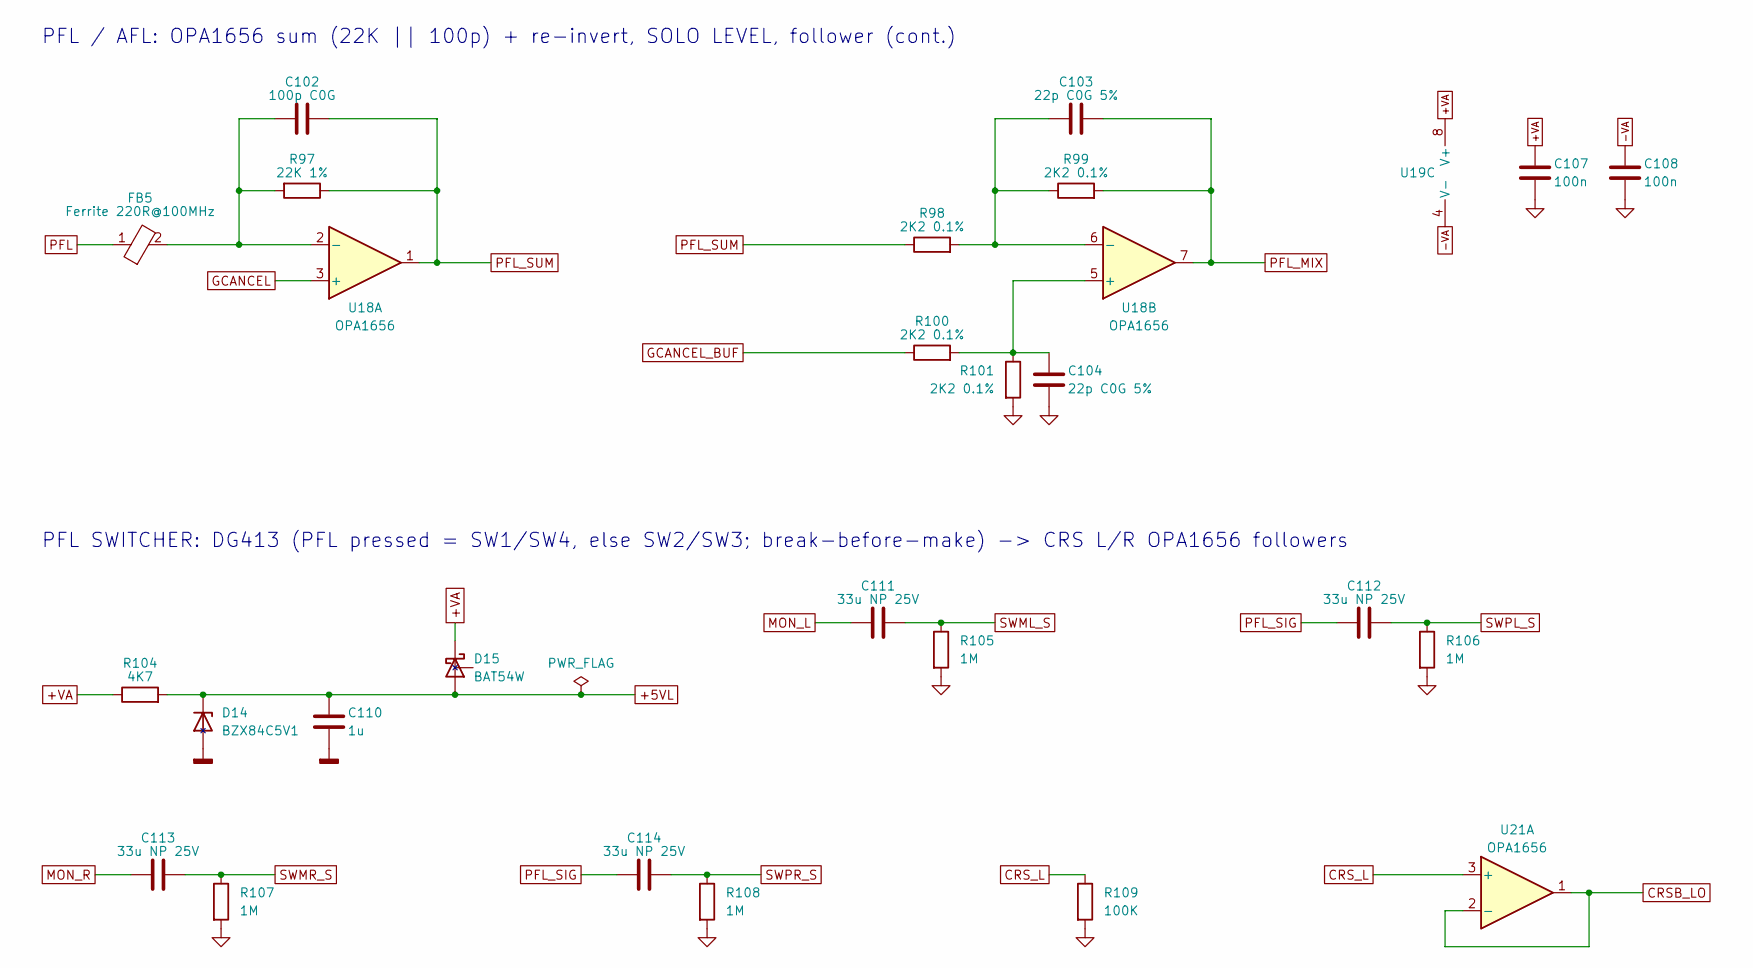
[picture p121: schematic 13_pfl_afl.kicad_sch, PFL-AFL, PFL SWITCHER]

Parts:
C102: 100p C0G; C_0805_2012Metric; MPN KEMET C0805C101J5GACTU
C103, C104: 22p C0G 5%; C_0805_2012Metric; MPN KEMET C0805C220J5GACTU
C107, C108: 100n; C_0805_2012Metric; MPN Samsung CL21B104KBCNNNC (X7R 50V)
C110: 1u; C_1206_3216Metric; MPN Samsung CL31B105KBHNNNE (X7R 50V)
C111, C112, C113, C114: 33u NP 25V; CP_Radial_D8.0mm_P3.50mm; MPN Nichicon UES1E330MPM (MUSE ES)
D14: BZX84C5V1; SOT-23; MPN Diodes BZX84C5V1-7-F
D15: BAT54W; SOT-323_SC-70; MPN Nexperia BAT54W,115
FB5: Ferrite 220R@100MHz; L_0805_2012Metric; MPN Murata BLM21PG221SN1D
R97: 22K 1%; R_0805_2012Metric
R98, R99, R100, R101: 2K2 0.1%; R_0805_2012Metric; MPN Panasonic ERA-6AEB222V
R104: 4K7; R_0805_2012Metric
R105, R106, R107, R108: 1M; R_0805_2012Metric
R109: 100K; R_0805_2012Metric
U18, U21: OPA1656; SOIC-8_3.9x4.9mm_P1.27mm; MPN TI OPA1656IDR
U19: OPA1612; SOIC-8_3.9x4.9mm_P1.27mm; MPN TI OPA1612AIDR

Connections:
+5VL: C110.1, D14.3 (K), D15.1 (A), R104.2; also elsewhere on the board
+VA: C107.1, D15.3 (K), R104.1, U19.8 (V+); also elsewhere on the board
-VA: C108.2, U19.4 (V-); also elsewhere on the board
CRSB_LO: U21.1, U21.2 (-); also elsewhere on the board
CRS_L: R109.1, U21.3 (+); also elsewhere on the board
GCANCEL: U18.3 (+); also elsewhere on the board
GCANCEL_BUF: R100.1; also elsewhere on the board
GNDA: C104.2, C107.2, C108.1, R101.2, R105.2, R106.2, R107.2, R108.2, R109.2; also elsewhere on the board
GNDD: C110.2, D14.1 (A); also elsewhere on the board
MON_L: C111.1; also elsewhere on the board
MON_R: C113.1; also elsewhere on the board
unnamed: C102.2, FB5.2, R97.2, U18.2 (-)
unnamed: C104.1, R100.2, R101.1, U18.5 (+)
unnamed: C103.2, R98.2, R99.1, U18.6 (-)
PFL: FB5.1; also elsewhere on the board
PFL_MIX: C103.1, R99.2, U18.7; also elsewhere on the board
PFL_SIG: C112.1, C114.1; also elsewhere on the board
PFL_SUM: C102.1, R97.1, R98.1, U18.1
SWML_S: C111.2, R105.1; also elsewhere on the board
SWMR_S: C113.2, R107.1; also elsewhere on the board
SWPL_S: C112.2, R106.1; also elsewhere on the board
SWPR_S: C114.2, R108.1; also elsewhere on the board

Notes on the sheet:
PFL / AFL: OPA1656 sum (22K || 100p) + re-invert, SOLO LEVEL, follower (cont.)
PFL SWITCHER: DG413 (PFL pressed = SW1/SW4, else SW2/SW3; break-before-make) -> CRS L/R OPA1656 followers

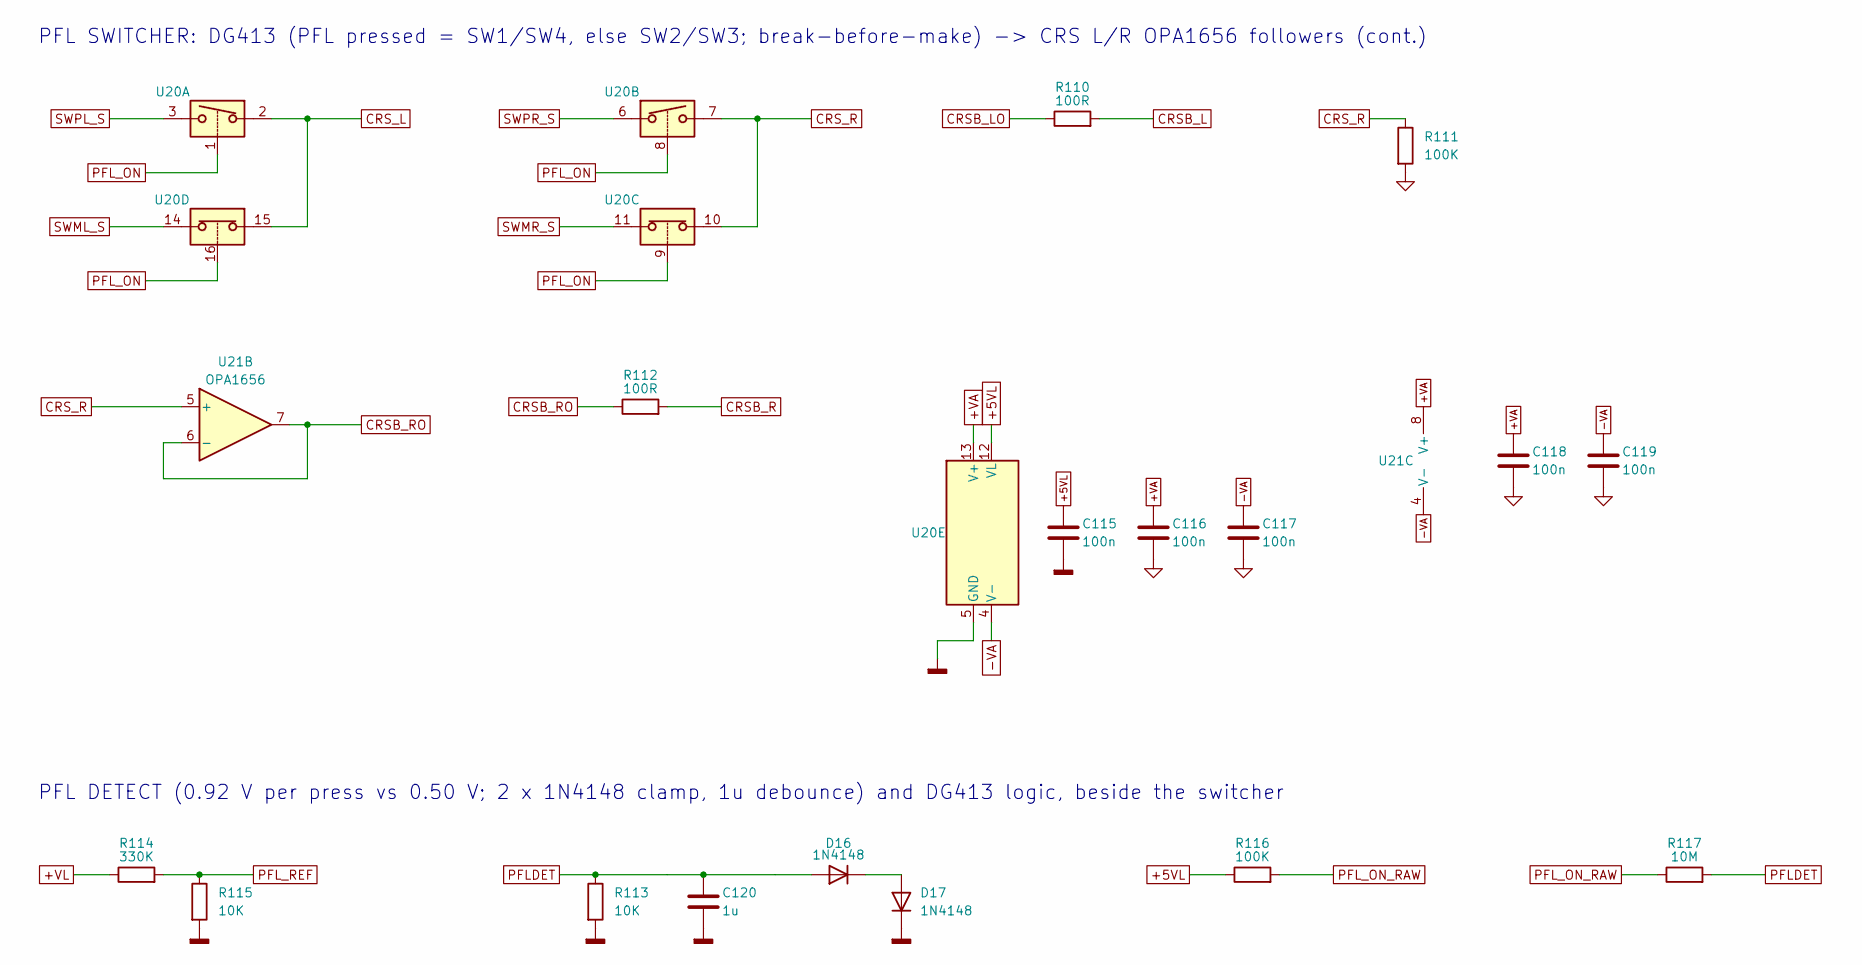
[picture p122: schematic 14_pfl_switcher.kicad_sch, PFL SWITCHER, PFL DETECT]

Parts:
C115, C116, C117, C118, C119: 100n; C_0805_2012Metric; MPN Samsung CL21B104KBCNNNC (X7R 50V)
C120: 1u; C_1206_3216Metric; MPN Samsung CL31B105KBHNNNE (X7R 50V)
D16, D17: 1N4148; D_DO-35_SOD27_P7.62mm_Horizontal; MPN Vishay 1N4148-TAP
R110, R112: 100R; R_0805_2012Metric
R111, R116: 100K; R_0805_2012Metric
R113, R115: 10K; R_0805_2012Metric
R114: 330K; R_0805_2012Metric
R117: 10M; R_0805_2012Metric
U20: DG413; SOIC-16_3.9x9.9mm_P1.27mm; MPN Vishay DG413DY-E3
U21: OPA1656; SOIC-8_3.9x4.9mm_P1.27mm; MPN TI OPA1656IDR

Connections:
+5VL: C115.1, R116.1, U20.12 (VL); also elsewhere on the board
+VA: C116.1, C118.1, U20.13 (V+), U21.8 (V+); also elsewhere on the board
+VL: R114.1; also elsewhere on the board
-VA: C117.2, C119.2, U20.4 (V-), U21.4 (V-); also elsewhere on the board
CRSB_L: R110.2; also elsewhere on the board
CRSB_LO: R110.1; also elsewhere on the board
CRSB_R: R112.2; also elsewhere on the board
CRSB_RO: R112.1, U21.6 (-), U21.7
CRS_L: U20.2, U20.15; also elsewhere on the board
CRS_R: R111.1, U20.7, U20.10, U21.5 (+)
GNDA: C116.2, C117.1, C118.2, C119.1, R111.2; also elsewhere on the board
GNDD: C115.2, C120.2, D17.1 (K), R113.2, R115.2, U20.5 (GND); also elsewhere on the board
unnamed: D16.1 (K), D17.2 (A)
PFLDET: C120.1, D16.2 (A), R113.1, R117.2; also elsewhere on the board
PFL_ON: U20.1, U20.8, U20.9, U20.16; also elsewhere on the board
PFL_ON_RAW: R116.2, R117.1; also elsewhere on the board
PFL_REF: R114.2, R115.1; also elsewhere on the board
SWML_S: U20.14; also elsewhere on the board
SWMR_S: U20.11; also elsewhere on the board
SWPL_S: U20.3; also elsewhere on the board
SWPR_S: U20.6; also elsewhere on the board

Notes on the sheet:
PFL SWITCHER: DG413 (PFL pressed = SW1/SW4, else SW2/SW3; break-before-make) -> CRS L/R OPA1656 followers (cont.)
PFL DETECT (0.92 V per press vs 0.50 V; 2 x 1N4148 clamp, 1u debounce) and DG413 logic, beside the switcher

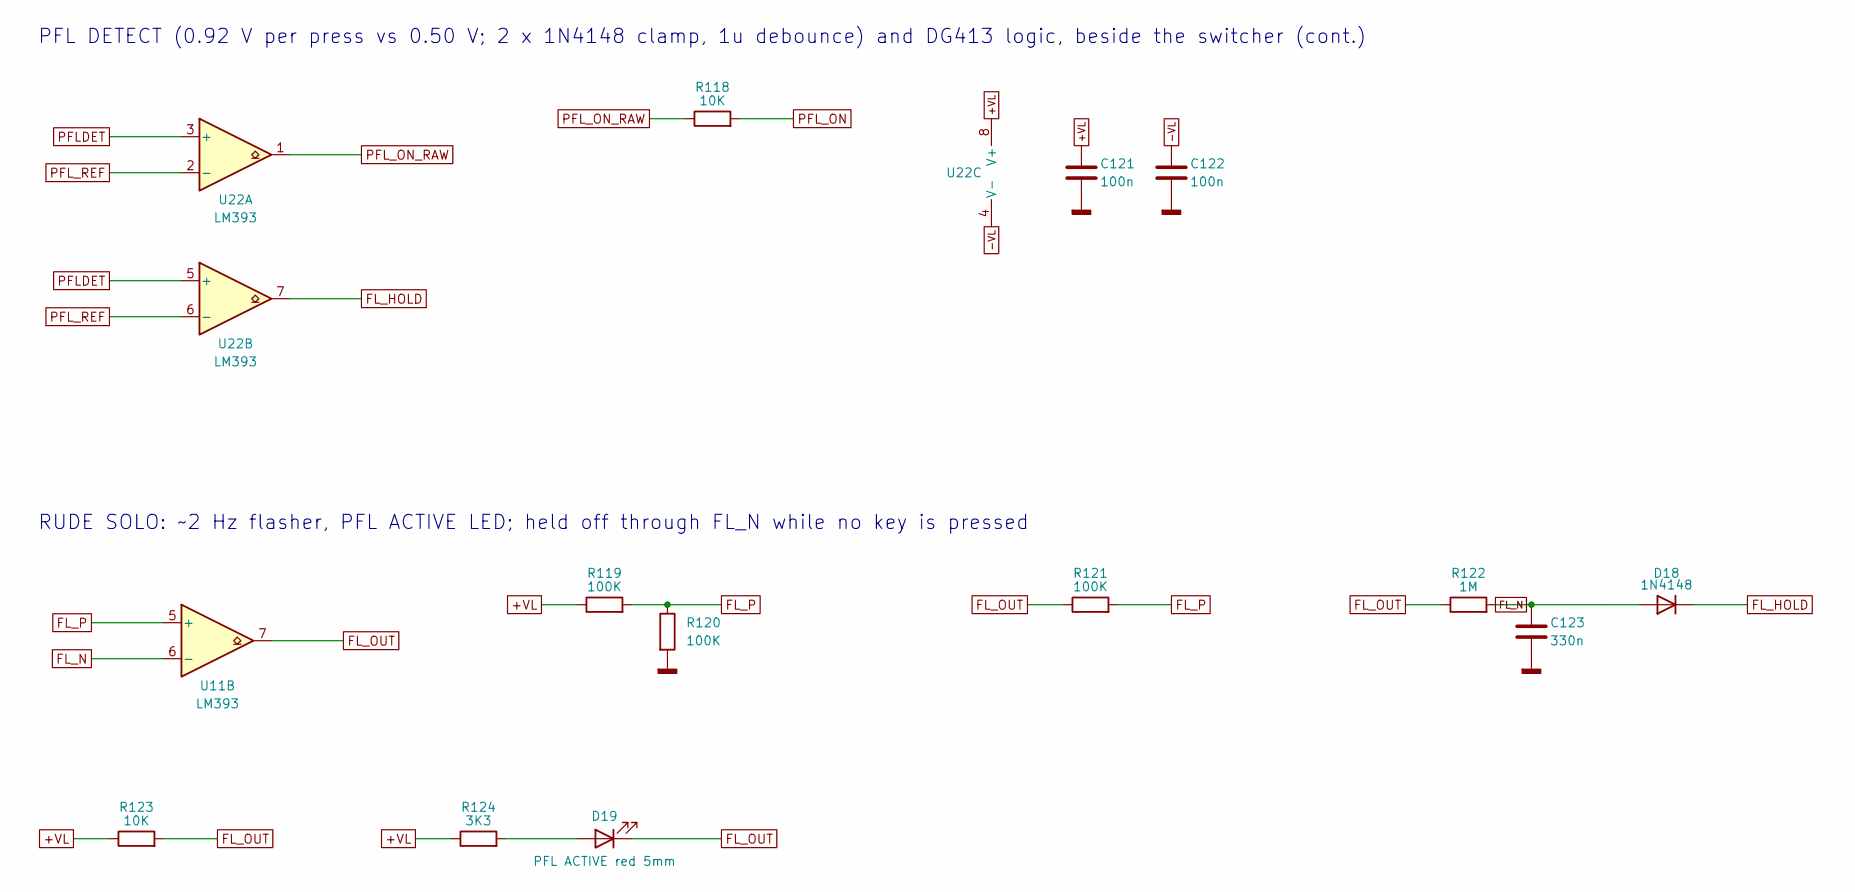
[picture p123: schematic 15_pfl_detect.kicad_sch, PFL DETECT, RUDE SOLO]

Parts:
C121, C122: 100n; C_0805_2012Metric; MPN Samsung CL21B104KBCNNNC (X7R 50V)
C123: 330n; C_0805_2012Metric; MPN Samsung CL21B334KBFNNNE (X7R 50V)
D18: 1N4148; D_DO-35_SOD27_P7.62mm_Horizontal; MPN Vishay 1N4148-TAP
D19: PFL ACTIVE red 5mm; LED_D5.0mm; MPN Kingbright WP7113ID
R118, R123: 10K; R_0805_2012Metric
R119, R120, R121: 100K; R_0805_2012Metric
R122: 1M; R_0805_2012Metric
R124: 3K3; R_0805_2012Metric; MPN Panasonic ERJ-P06J332V
U11, U22: LM393; SOIC-8_3.9x4.9mm_P1.27mm; MPN TI LM393BIDR

Connections:
+VL: C121.1, R119.1, R123.1, R124.1, U22.8 (V+); also elsewhere on the board
-VL: C122.2, U22.4 (V-); also elsewhere on the board
FL_HOLD: D18.1 (K), U22.7
FL_N: C123.1, D18.2 (A), R122.2, U11.6 (-)
FL_OUT: D19.1 (K), R121.1, R122.1, R123.2, U11.7
FL_P: R119.2, R120.1, R121.2, U11.5 (+)
GNDD: C121.2, C122.1, C123.2, R120.2; also elsewhere on the board
unnamed: D19.2 (A), R124.2
PFLDET: U22.3 (+), U22.5 (+); also elsewhere on the board
PFL_ON: R118.2; also elsewhere on the board
PFL_ON_RAW: R118.1, U22.1; also elsewhere on the board
PFL_REF: U22.2 (-), U22.6 (-); also elsewhere on the board

Notes on the sheet:
PFL DETECT (0.92 V per press vs 0.50 V; 2 x 1N4148 clamp, 1u debounce) and DG413 logic, beside the switcher (cont.)
RUDE SOLO: ~2 Hz flasher, PFL ACTIVE LED; held off through FL_N while no key is pressed

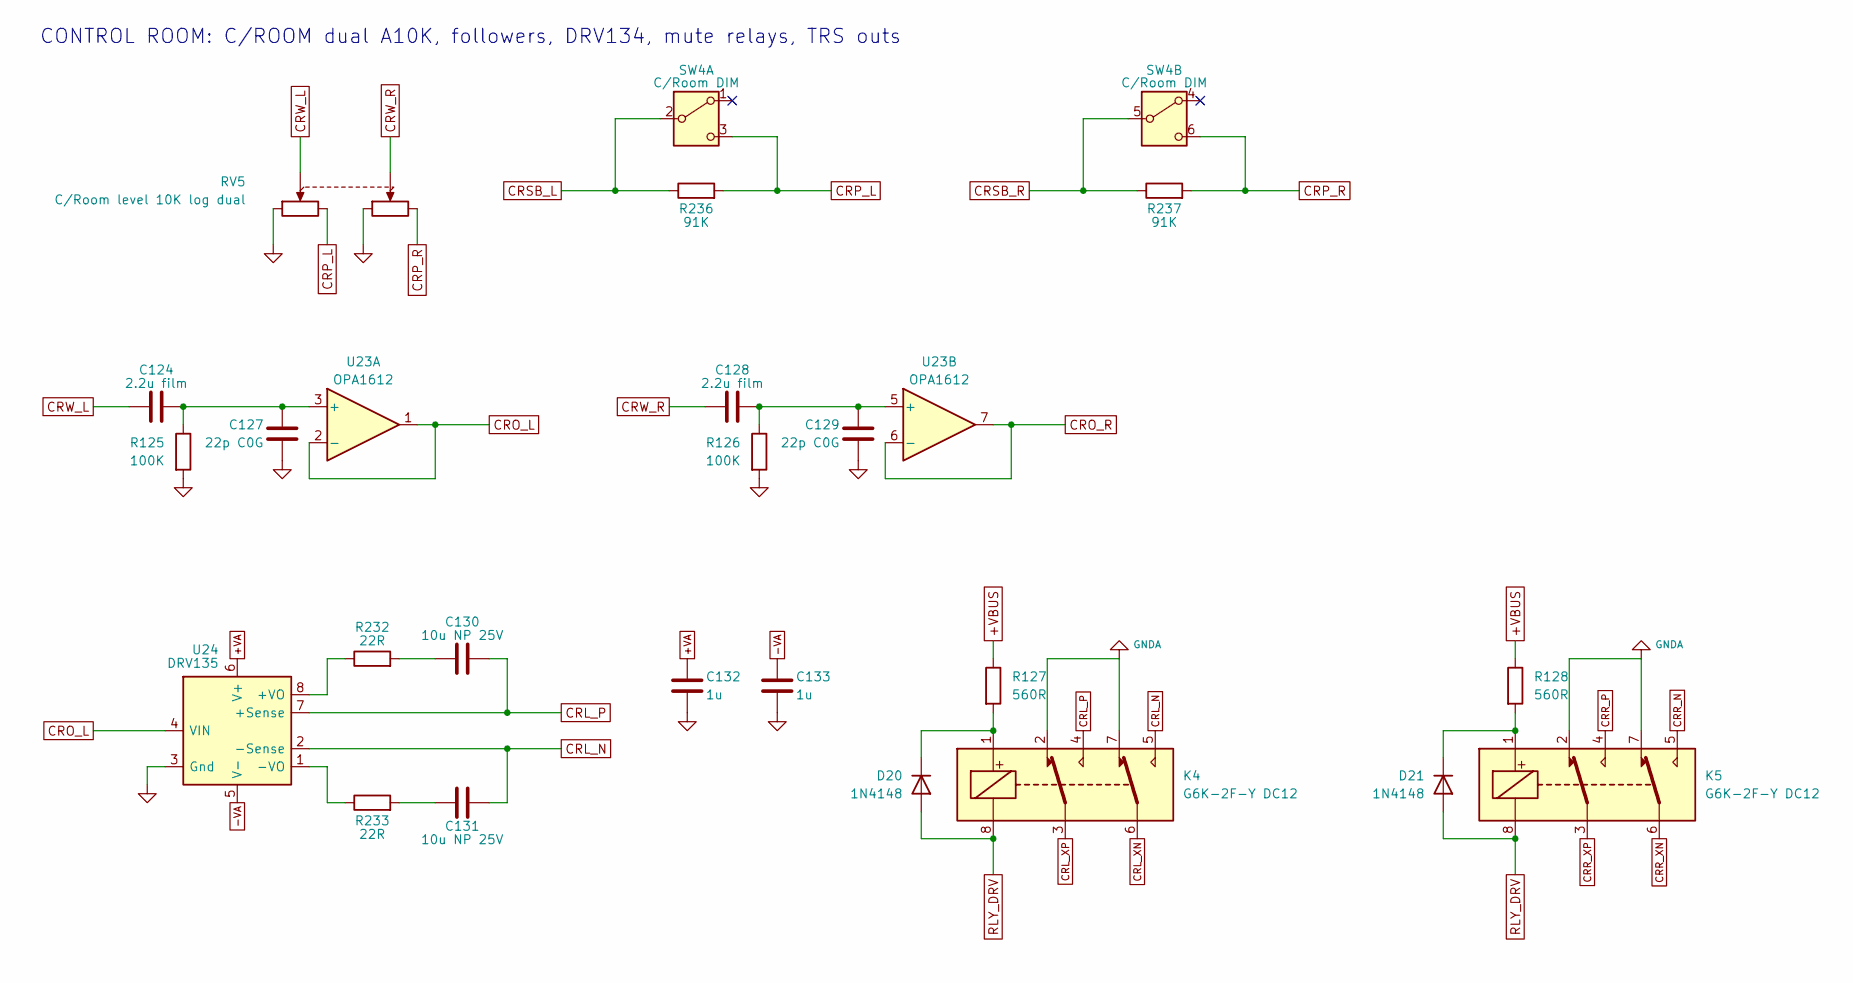
[picture p124: schematic 16_control_room.kicad_sch, CONTROL ROOM]

Parts:
C124, C128: 2.2u film; C_Rect_L7.2mm_W7.2mm_P5.00mm_FKS2_FKP2_MKS2_MKP2; MPN KEMET MMK5225K63J06L4BULK (PET 63V; rep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
C127, C129: 22p C0G; C_0805_2012Metric; MPN KEMET C0805C220J5GACTU
C130, C131: 10u NP 25V; CP_Radial_D5.0mm_P2.00mm; MPN Panasonic ECE-A1EN100U (matched pair: t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
C132, C133: 1u; C_1206_3216Metric; MPN Samsung CL31B105KBHNNNE (X7R 50V)
D20, D21: 1N4148; D_DO-35_SOD27_P7.62mm_Horizontal; MPN Vishay 1N4148-TAP
K4, K5: G6K-2F-Y DC12; Relay_DPDT_Omron_G6K-2F-Y; MPN Omron G6K-2F-Y DC12
R125, R126: 100K; R_0805_2012Metric
R127, R128: 560R; R_0805_2012Metric
R232, R233: 22R; R_0805_2012Metric; MPN Panasonic ERJ-P06J220V
R236, R237: 91K; R_0805_2012Metric
RV5: C/Room level 10K log dual; Potentiometer_Alpha_RD902F-40-00D_Dual_Vertical; MPN Alpha RD902F-40-15R1-A10K (dual, log)
SW4: C/Room DIM; SW_Push_2P2T_Toggle_CK_PVA2xxH1xxxxxxV2; MPN C&K PVA2 EE H1 1.7N V2
U23: OPA1612; SOIC-8_3.9x4.9mm_P1.27mm; MPN TI OPA1612AIDR
U24: DRV135; SOIC-8_3.9x4.9mm_P1.27mm; MPN TI DRV135UA

Connections:
+VA: C132.1, U24.6 (V+); also elsewhere on the board
+VBUS: R127.1, R128.1; also elsewhere on the board
-VA: C133.2, U24.5 (V-); also elsewhere on the board
CRL_N: C131.2, K4.5, U24.2 (-Sense)
CRL_P: C130.2, K4.4, U24.7 (+Sense)
CRL_XN: K4.6; also elsewhere on the board
CRL_XP: K4.3; also elsewhere on the board
CRO_L: U23.1, U23.2 (-), U24.4 (VIN)
CRO_R: U23.6 (-), U23.7; also elsewhere on the board
CRP_L: R236.2, RV5.3, SW4.3 (C)
CRP_R: R237.2, RV5.6, SW4.6 (C)
CRR_N: K5.5; also elsewhere on the board
CRR_P: K5.4; also elsewhere on the board
CRR_XN: K5.6; also elsewhere on the board
CRR_XP: K5.3; also elsewhere on the board
CRSB_L: R236.1, SW4.2 (B); also elsewhere on the board
CRSB_R: R237.1, SW4.5 (B); also elsewhere on the board
CRW_L: C124.1, RV5.2
CRW_R: C128.1, RV5.5
GNDA: C127.2, C129.2, C132.2, C133.1, K4.2, K4.7, K5.2, K5.7, R125.2, R126.2, RV5.1, RV5.4, U24.3 (Gnd); also elsewhere on the board
unnamed: C130.1, R232.2
unnamed: C131.1, R233.2
unnamed: D20.1 (K), K4.1, R127.2
unnamed: D21.1 (K), K5.1, R128.2
unnamed: C124.2, C127.1, R125.1, U23.3 (+)
unnamed: C128.2, C129.1, R126.1, U23.5 (+)
unnamed: R232.1, U24.8 (+VO)
unnamed: R233.1, U24.1 (-VO)
RLY_DRV: D20.2 (A), D21.2 (A), K4.8, K5.8; also elsewhere on the board

Notes on the sheet:
CONTROL ROOM: C/ROOM dual A10K, followers, DRV134, mute relays, TRS outs
