cozycactus/goa-console/boards/master/master.kicad_pcb

## KiCad design boards/master/master.kicad_pcb (continued)

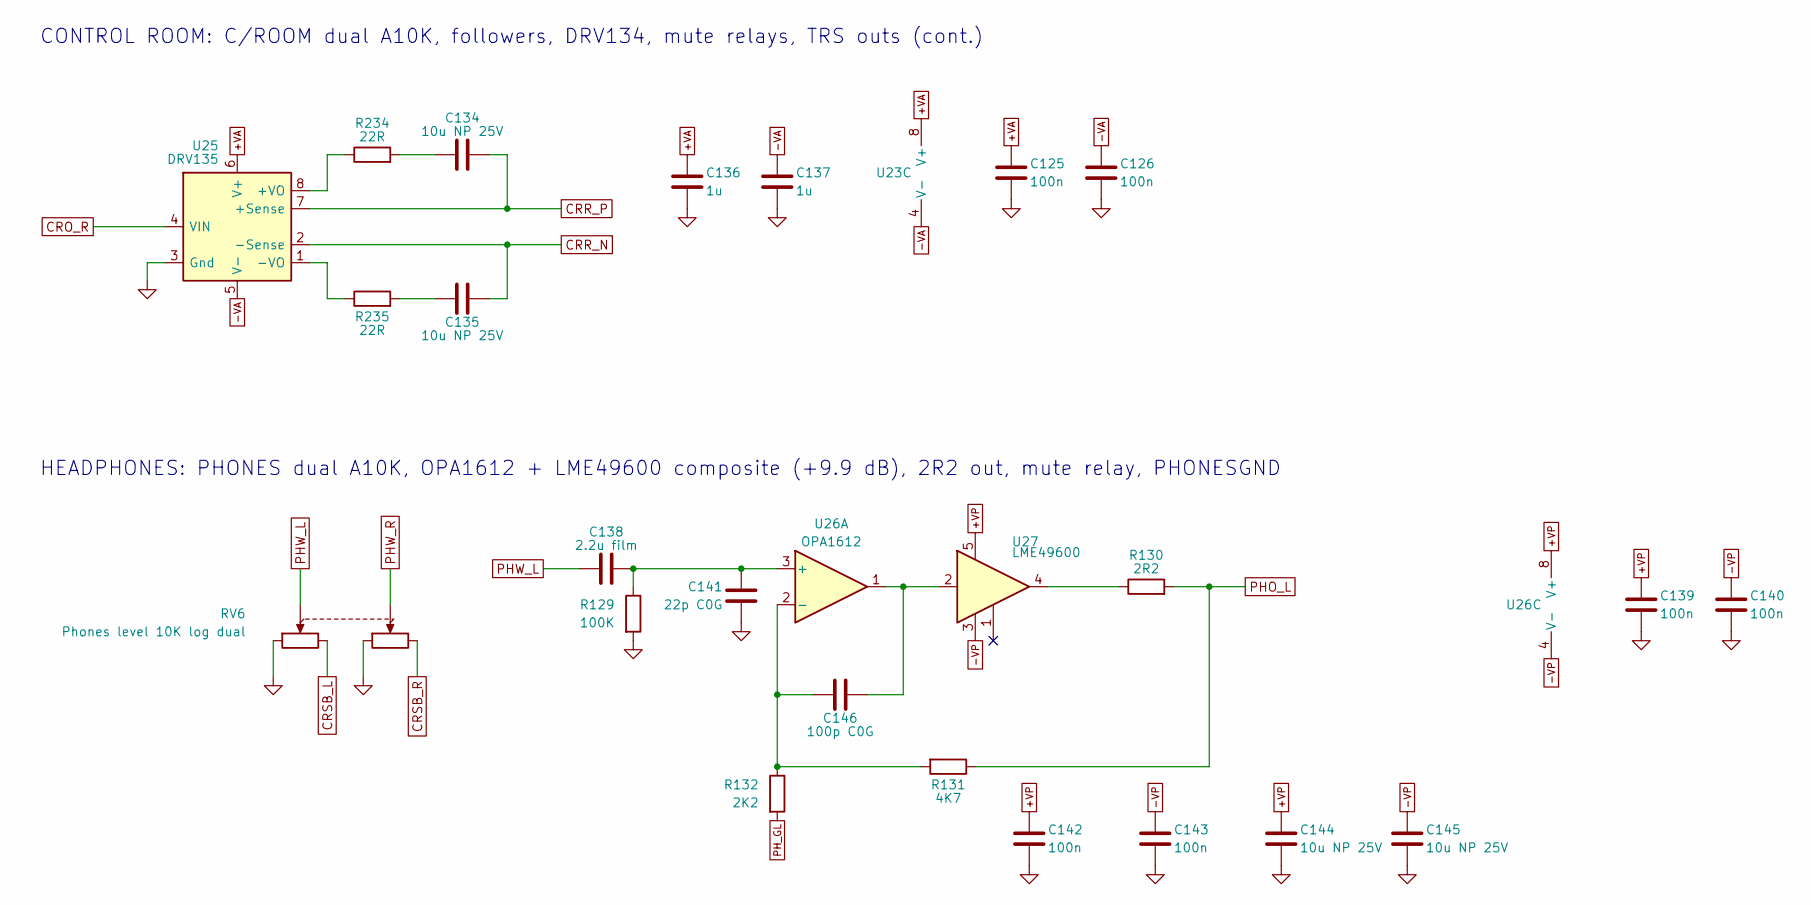
[picture p125: schematic 17_control_room.kicad_sch, CONTROL ROOM, HEADPHONES]

Parts:
C125, C126, C139, C140, C142, C143: 100n; C_0805_2012Metric; MPN Samsung CL21B104KBCNNNC (X7R 50V)
C134, C135: 10u NP 25V; CP_Radial_D5.0mm_P2.00mm; MPN Panasonic ECE-A1EN100U (matched pair: t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
C136, C137: 1u; C_1206_3216Metric; MPN Samsung CL31B105KBHNNNE (X7R 50V)
C138: 2.2u film; C_Rect_L7.2mm_W7.2mm_P5.00mm_FKS2_FKP2_MKS2_MKP2; MPN KEMET MMK5225K63J06L4BULK (PET 63V; rep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
C141: 22p C0G; C_0805_2012Metric; MPN KEMET C0805C220J5GACTU
C144, C145: 10u NP 25V; CP_Radial_D5.0mm_P2.00mm; MPN Panasonic ECE-A1EN100U
C146: 100p C0G; C_0805_2012Metric; MPN KEMET C0805C101J5GACTU
R129: 100K; R_0805_2012Metric
R130: 2R2; R_2512_6332Metric; MPN Vishay CRCW25122R20FKEGHP
R131: 4K7; R_0805_2012Metric
R132: 2K2; R_0805_2012Metric
R234, R235: 22R; R_0805_2012Metric; MPN Panasonic ERJ-P06J220V
RV6: Phones level 10K log dual; Potentiometer_Alpha_RD902F-40-00D_Dual_Vertical; MPN Alpha RD902F-40-15R1-A10K (dual, log)
U23, U26: OPA1612; SOIC-8_3.9x4.9mm_P1.27mm; MPN TI OPA1612AIDR
U25: DRV135; SOIC-8_3.9x4.9mm_P1.27mm; MPN TI DRV135UA
U27: LME49600; TO-263-5_TabPin3; MPN TI LME49600TS/NOPB

Connections:
+VA: C125.1, C136.1, U23.8 (V+), U25.6 (V+); also elsewhere on the board
+VP: C139.1, C142.1, C144.1, U26.8 (V+), U27.5 (V+); also elsewhere on the board
-VA: C126.2, C137.2, U23.4 (V-), U25.5 (V-); also elsewhere on the board
-VP: C140.2, C143.2, C145.2, U26.4 (V-), U27.3 (V-); also elsewhere on the board
CRO_R: U25.4 (VIN); also elsewhere on the board
CRR_N: C135.2, U25.2 (-Sense); also elsewhere on the board
CRR_P: C134.2, U25.7 (+Sense); also elsewhere on the board
CRSB_L: RV6.3; also elsewhere on the board
CRSB_R: RV6.6; also elsewhere on the board
GNDA: C125.2, C126.1, C136.2, C137.1, C139.2, C140.1, C141.2, C142.2, C143.1, C144.2, C145.1, R129.2, RV6.1, RV6.4, U25.3 (Gnd); also elsewhere on the board
unnamed: C134.1, R234.2
unnamed: C135.1, R235.2
unnamed: R130.1, U27.4
unnamed: R234.1, U25.8 (+VO)
unnamed: R235.1, U25.1 (-VO)
unnamed: C138.2, C141.1, R129.1, U26.3 (+)
unnamed: C146.2, R131.2, R132.1, U26.2 (-)
unnamed: C146.1, U26.1, U27.2 (IN)
PHO_L: R130.2, R131.1; also elsewhere on the board
PHW_L: C138.1, RV6.2
PHW_R: RV6.5; also elsewhere on the board
PH_GL: R132.2; also elsewhere on the board

Notes on the sheet:
CONTROL ROOM: C/ROOM dual A10K, followers, DRV134, mute relays, TRS outs (cont.)
HEADPHONES: PHONES dual A10K, OPA1612 + LME49600 composite (+9.9 dB), 2R2 out, mute relay, PHONESGND

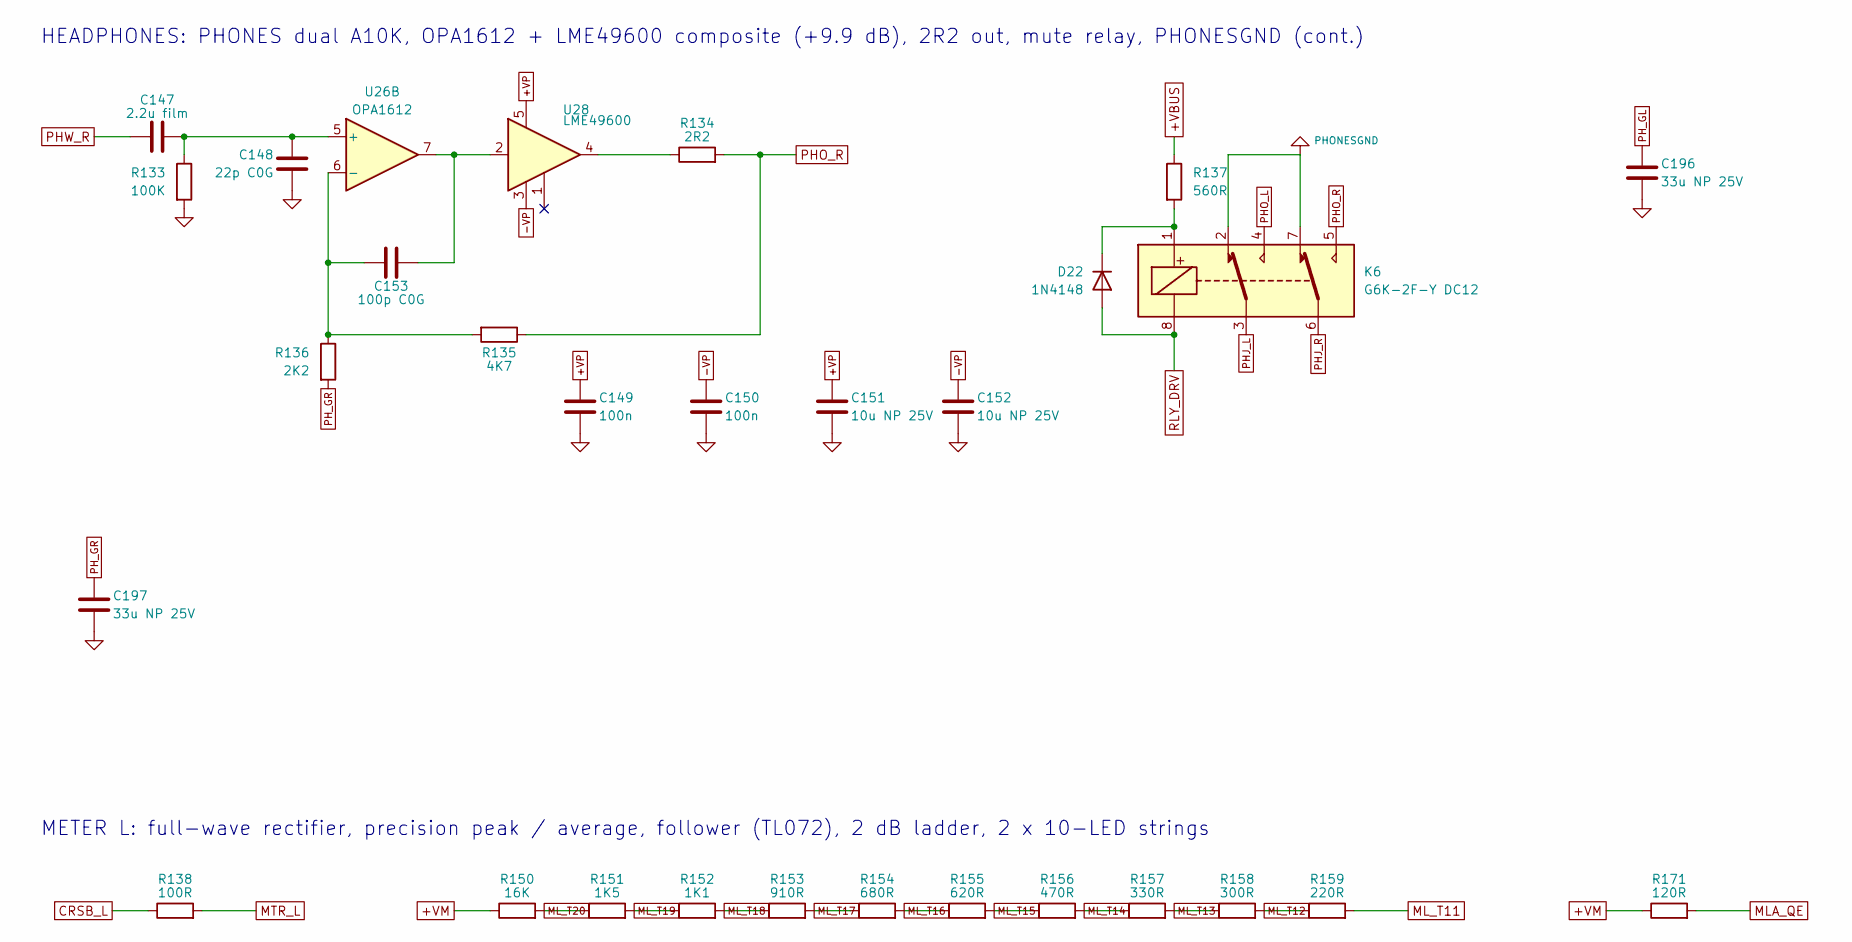
[picture p126: schematic 18_headphones.kicad_sch, HEADPHONES, METER L]

Parts:
C147: 2.2u film; C_Rect_L7.2mm_W7.2mm_P5.00mm_FKS2_FKP2_MKS2_MKP2; MPN KEMET MMK5225K63J06L4BULK (PET 63V; rep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
C148: 22p C0G; C_0805_2012Metric; MPN KEMET C0805C220J5GACTU
C149, C150: 100n; C_0805_2012Metric; MPN Samsung CL21B104KBCNNNC (X7R 50V)
C151, C152: 10u NP 25V; CP_Radial_D5.0mm_P2.00mm; MPN Panasonic ECE-A1EN100U
C153: 100p C0G; C_0805_2012Metric; MPN KEMET C0805C101J5GACTU
C196, C197: 33u NP 25V; CP_Radial_D8.0mm_P3.50mm; MPN Nichicon UES1E330MPM (MUSE ES)
D22: 1N4148; D_DO-35_SOD27_P7.62mm_Horizontal; MPN Vishay 1N4148-TAP
K6: G6K-2F-Y DC12; Relay_DPDT_Omron_G6K-2F-Y; MPN Omron G6K-2F-Y DC12
R133: 100K; R_0805_2012Metric
R134: 2R2; R_2512_6332Metric; MPN Vishay CRCW25122R20FKEGHP
R135: 4K7; R_0805_2012Metric
R136: 2K2; R_0805_2012Metric
R137: 560R; R_0805_2012Metric
R138: 100R; R_0805_2012Metric
R150: 16K; R_0805_2012Metric
R151: 1K5; R_0805_2012Metric
R152: 1K1; R_0805_2012Metric
R153: 910R; R_0805_2012Metric
R154: 680R; R_0805_2012Metric
R155: 620R; R_0805_2012Metric
R156: 470R; R_0805_2012Metric
R157: 330R; R_0805_2012Metric
R158: 300R; R_0805_2012Metric
R159: 220R; R_0805_2012Metric
R171: 120R; R_0805_2012Metric
U26: OPA1612; SOIC-8_3.9x4.9mm_P1.27mm; MPN TI OPA1612AIDR
U28: LME49600; TO-263-5_TabPin3; MPN TI LME49600TS/NOPB

Connections:
+VBUS: R137.1; also elsewhere on the board
+VM: R150.1, R171.1; also elsewhere on the board
+VP: C149.1, C151.1, U28.5 (V+); also elsewhere on the board
-VP: C150.2, C152.2, U28.3 (V-); also elsewhere on the board
CRSB_L: R138.1; also elsewhere on the board
GNDA: C148.2, C149.2, C150.1, C151.2, C152.1, C196.2, C197.2, R133.2; also elsewhere on the board
MLA_QE: R171.2; also elsewhere on the board
ML_T11: R159.2; also elsewhere on the board
ML_T12: R158.2, R159.1; also elsewhere on the board
ML_T13: R157.2, R158.1; also elsewhere on the board
ML_T14: R156.2, R157.1; also elsewhere on the board
ML_T15: R155.2, R156.1; also elsewhere on the board
ML_T16: R154.2, R155.1; also elsewhere on the board
ML_T17: R153.2, R154.1; also elsewhere on the board
ML_T18: R152.2, R153.1; also elsewhere on the board
ML_T19: R151.2, R152.1; also elsewhere on the board
ML_T20: R150.2, R151.1; also elsewhere on the board
MTR_L: R138.2; also elsewhere on the board
unnamed: D22.1 (K), K6.1, R137.2
unnamed: R134.1, U28.4
unnamed: C147.2, C148.1, R133.1, U26.5 (+)
unnamed: C153.2, R135.2, R136.1, U26.6 (-)
unnamed: C153.1, U26.7, U28.2 (IN)
PHJ_L: K6.3; also elsewhere on the board
PHJ_R: K6.6; also elsewhere on the board
PHONESGND: K6.2, K6.7; also elsewhere on the board
PHO_L: K6.4; also elsewhere on the board
PHO_R: K6.5, R134.2, R135.1
PHW_R: C147.1; also elsewhere on the board
PH_GL: C196.1; also elsewhere on the board
PH_GR: C197.1, R136.2
RLY_DRV: D22.2 (A), K6.8; also elsewhere on the board

Notes on the sheet:
HEADPHONES: PHONES dual A10K, OPA1612 + LME49600 composite (+9.9 dB), 2R2 out, mute relay, PHONESGND (cont.)
METER L: full-wave rectifier, precision peak / average, follower (TL072), 2 dB ladder, 2 x 10-LED strings

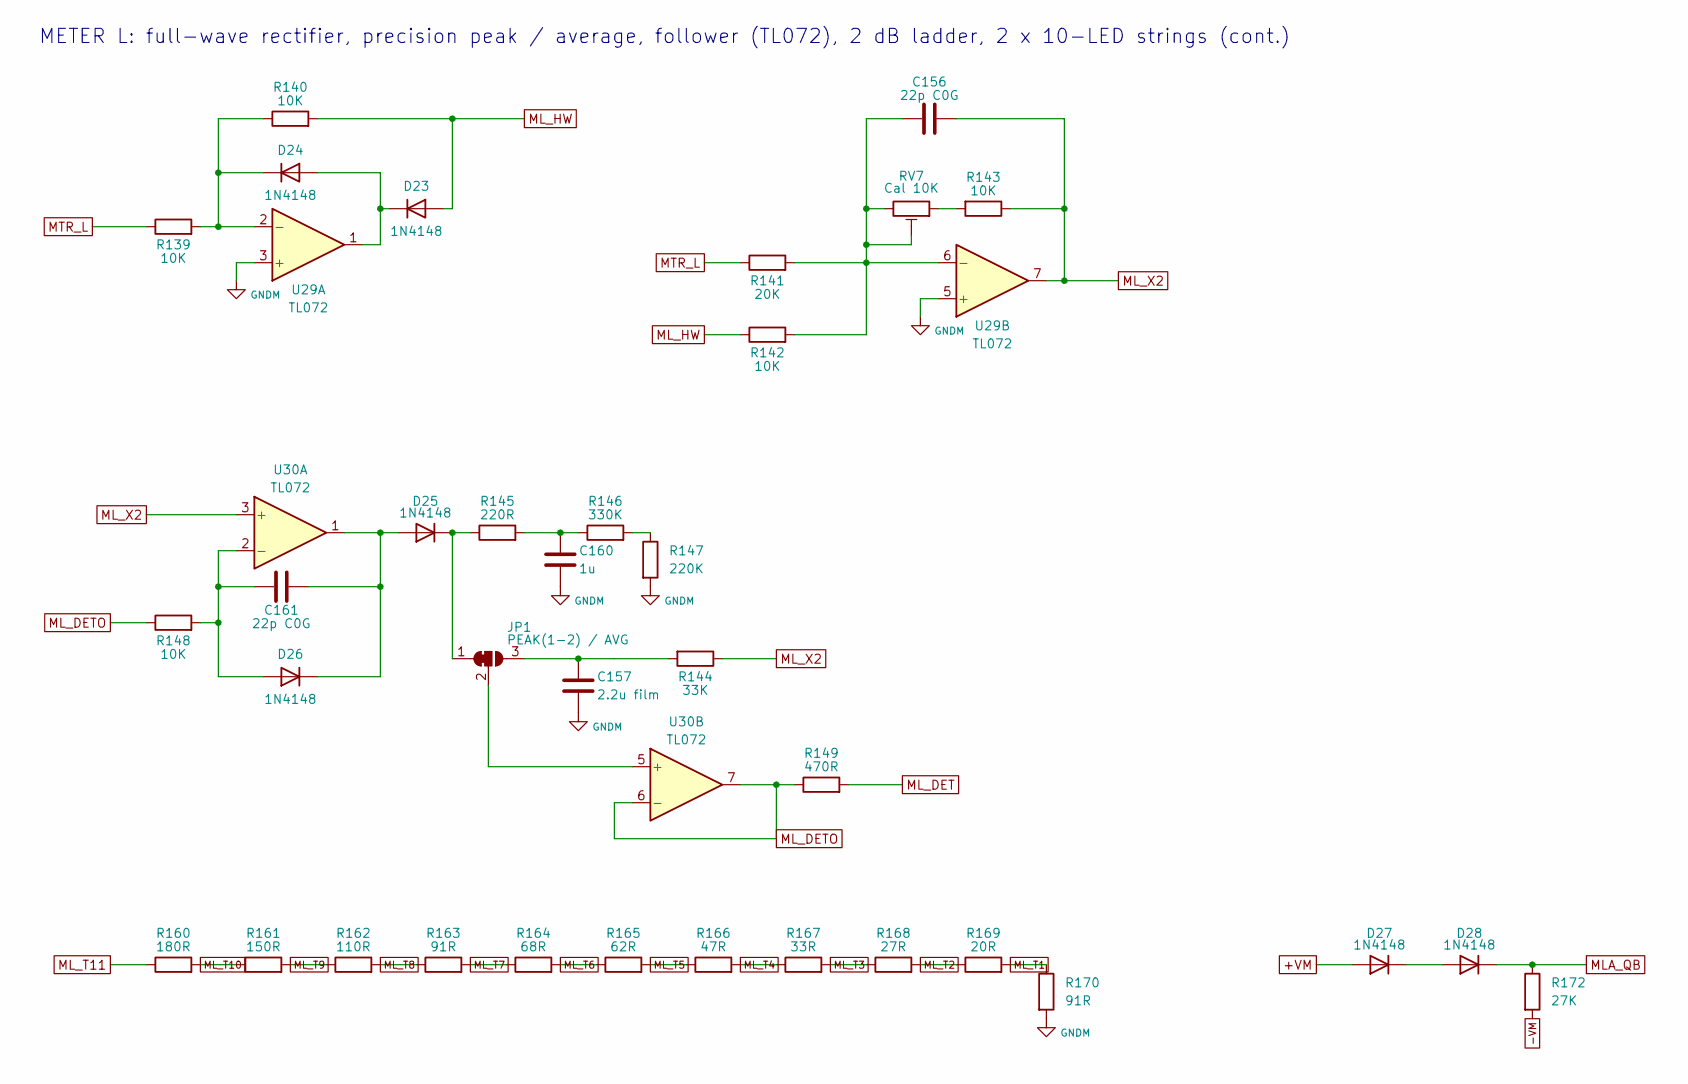
[picture p127: schematic 19_meter_l.kicad_sch, METER L]

Parts:
C156, C161: 22p C0G; C_0805_2012Metric; MPN KEMET C0805C220J5GACTU
C157: 2.2u film; C_Rect_L7.2mm_W7.2mm_P5.00mm_FKS2_FKP2_MKS2_MKP2; MPN KEMET MMK5225K63J06L4BULK (PET 63V; rep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
C160: 1u; C_1206_3216Metric; MPN Samsung CL31B105KBHNNNE (X7R 50V)
D23, D24, D25, D26, D27, D28: 1N4148; D_DO-35_SOD27_P7.62mm_Horizontal; MPN Vishay 1N4148-TAP
JP1: PEAK(1-2) / AVG; SolderJumper-3_P1.3mm_Bridged12_RoundedPad1.0x1.5mm
R139, R140, R142, R143, R148: 10K; R_0805_2012Metric
R141: 20K; R_0805_2012Metric
R144: 33K; R_0805_2012Metric
R145: 220R; R_0805_2012Metric
R146: 330K; R_0805_2012Metric
R147: 220K; R_0805_2012Metric
R149: 470R; R_0805_2012Metric
R160: 180R; R_0805_2012Metric
R161: 150R; R_0805_2012Metric
R162: 110R; R_0805_2012Metric
R163, R170: 91R; R_0805_2012Metric
R164: 68R; R_0805_2012Metric
R165: 62R; R_0805_2012Metric
R166: 47R; R_0805_2012Metric
R167: 33R; R_0805_2012Metric
R168: 27R; R_0805_2012Metric
R169: 20R; R_0805_2012Metric
R172: 27K; R_0805_2012Metric
RV7: Cal 10K; Potentiometer_Bourns_3296W_Vertical; MPN Bourns 3296W-1-103LF
U29, U30: TL072; SOIC-8_3.9x4.9mm_P1.27mm; MPN TI TL072HIDR

Connections:
+VM: D27.2 (A); also elsewhere on the board
-VM: R172.2; also elsewhere on the board
GNDM: C157.2, C160.2, R147.2, R170.2, U29.3 (+), U29.5 (+); also elsewhere on the board
MLA_QB: D28.1 (K), R172.1; also elsewhere on the board
ML_DET: R149.2; also elsewhere on the board
ML_DETO: R148.1, R149.1, U30.6 (-), U30.7
ML_HW: D23.2 (A), R140.2, R142.1
ML_T1: R169.2, R170.1; also elsewhere on the board
ML_T2: R168.2, R169.1; also elsewhere on the board
ML_T3: R167.2, R168.1; also elsewhere on the board
ML_T4: R166.2, R167.1; also elsewhere on the board
ML_T5: R165.2, R166.1; also elsewhere on the board
ML_T6: R164.2, R165.1; also elsewhere on the board
ML_T7: R163.2, R164.1; also elsewhere on the board
ML_T8: R162.2, R163.1; also elsewhere on the board
ML_T9: R161.2, R162.1; also elsewhere on the board
ML_T10: R160.2, R161.1; also elsewhere on the board
ML_T11: R160.1; also elsewhere on the board
ML_X2: C156.1, R143.1, R144.1, U29.7, U30.3 (+)
MTR_L: R139.1, R141.1; also elsewhere on the board
unnamed: C160.1, R145.2, R146.1
unnamed: D23.1 (K), D24.2 (A), U29.1
unnamed: D24.1 (K), R139.2, R140.1, U29.2 (-)
unnamed: C161.1, D25.2 (A), D26.1 (K), U30.1
unnamed: D25.1 (K), JP1.1 (A), R145.1
unnamed: C161.2, D26.2 (A), R148.2, U30.2 (-)
unnamed: D27.1 (K), D28.2 (A)
unnamed: C157.1, JP1.3 (B), R144.2
unnamed: JP1.2 (C), U30.5 (+)
unnamed: R143.2, RV7.1
unnamed: R146.2, R147.1
unnamed: C156.2, R141.2, R142.2, RV7.2, RV7.3, U29.6 (-)

Notes on the sheet:
METER L: full-wave rectifier, precision peak / average, follower (TL072), 2 dB ladder, 2 x 10-LED strings (cont.)

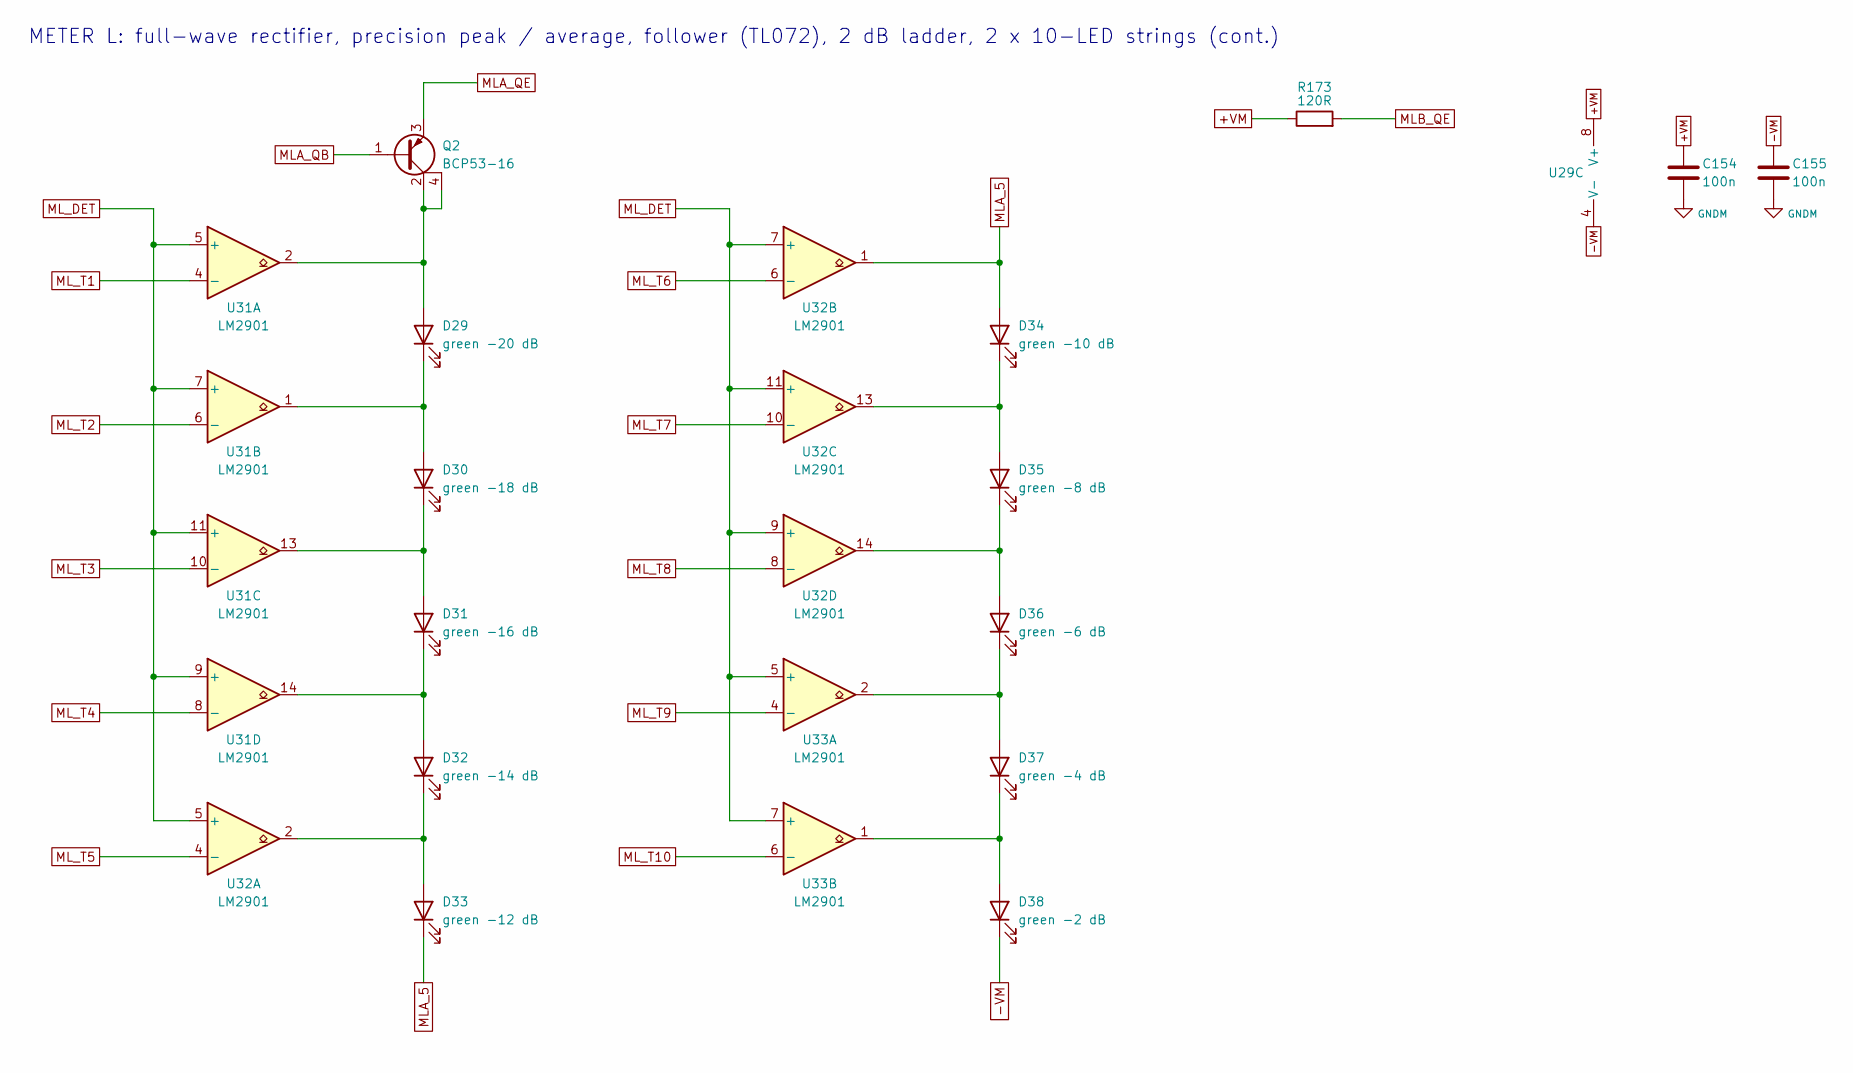
[picture p128: schematic 20_meter_l.kicad_sch, METER L]

Parts:
C154, C155: 100n; C_0805_2012Metric; MPN Samsung CL21B104KBCNNNC (X7R 50V)
D29: green -20 dB; LED_D3.0mm; MPN Kingbright WP710A10GD
D30: green -18 dB; LED_D3.0mm; MPN Kingbright WP710A10GD
D31: green -16 dB; LED_D3.0mm; MPN Kingbright WP710A10GD
D32: green -14 dB; LED_D3.0mm; MPN Kingbright WP710A10GD
D33: green -12 dB; LED_D3.0mm; MPN Kingbright WP710A10GD
D34: green -10 dB; LED_D3.0mm; MPN Kingbright WP710A10GD
D35: green -8 dB; LED_D3.0mm; MPN Kingbright WP710A10GD
D36: green -6 dB; LED_D3.0mm; MPN Kingbright WP710A10GD
D37: green -4 dB; LED_D3.0mm; MPN Kingbright WP710A10GD
D38: green -2 dB; LED_D3.0mm; MPN Kingbright WP710A10GD
Q2: BCP53-16; SOT-223; MPN onsemi BCP53-16T1G
R173: 120R; R_0805_2012Metric
U29: TL072; SOIC-8_3.9x4.9mm_P1.27mm; MPN TI TL072HIDR
U31, U32, U33: LM2901; SOIC-14_3.9x8.7mm_P1.27mm; MPN TI LM2901BIDR

Connections:
+VM: C154.1, R173.1, U29.8 (V+); also elsewhere on the board
-VM: C155.2, D38.1 (K), U29.4 (V-); also elsewhere on the board
GNDM: C154.2, C155.1; also elsewhere on the board
MLA_5: D33.1 (K), D34.2 (A), U32.1
MLA_QB: Q2.1 (B); also elsewhere on the board
MLA_QE: Q2.3 (E); also elsewhere on the board
MLB_QE: R173.2; also elsewhere on the board
ML_DET: U31.5 (+), U31.7 (+), U31.9 (+), U31.11 (+), U32.5 (+), U32.7 (+), U32.9 (+), U32.11 (+), U33.5 (+), U33.7 (+); also elsewhere on the board
ML_T1: U31.4 (-); also elsewhere on the board
ML_T2: U31.6 (-); also elsewhere on the board
ML_T3: U31.10 (-); also elsewhere on the board
ML_T4: U31.8 (-); also elsewhere on the board
ML_T5: U32.4 (-); also elsewhere on the board
ML_T6: U32.6 (-); also elsewhere on the board
ML_T7: U32.10 (-); also elsewhere on the board
ML_T8: U32.8 (-); also elsewhere on the board
ML_T9: U33.4 (-); also elsewhere on the board
ML_T10: U33.6 (-); also elsewhere on the board
unnamed: D29.2 (A), Q2.2 (C), Q2.4 (C), U31.2
unnamed: D29.1 (K), D30.2 (A), U31.1
unnamed: D30.1 (K), D31.2 (A), U31.13
unnamed: D31.1 (K), D32.2 (A), U31.14
unnamed: D32.1 (K), D33.2 (A), U32.2
unnamed: D34.1 (K), D35.2 (A), U32.13
unnamed: D35.1 (K), D36.2 (A), U32.14
unnamed: D36.1 (K), D37.2 (A), U33.2
unnamed: D37.1 (K), D38.2 (A), U33.1

Notes on the sheet:
METER L: full-wave rectifier, precision peak / average, follower (TL072), 2 dB ladder, 2 x 10-LED strings (cont.)

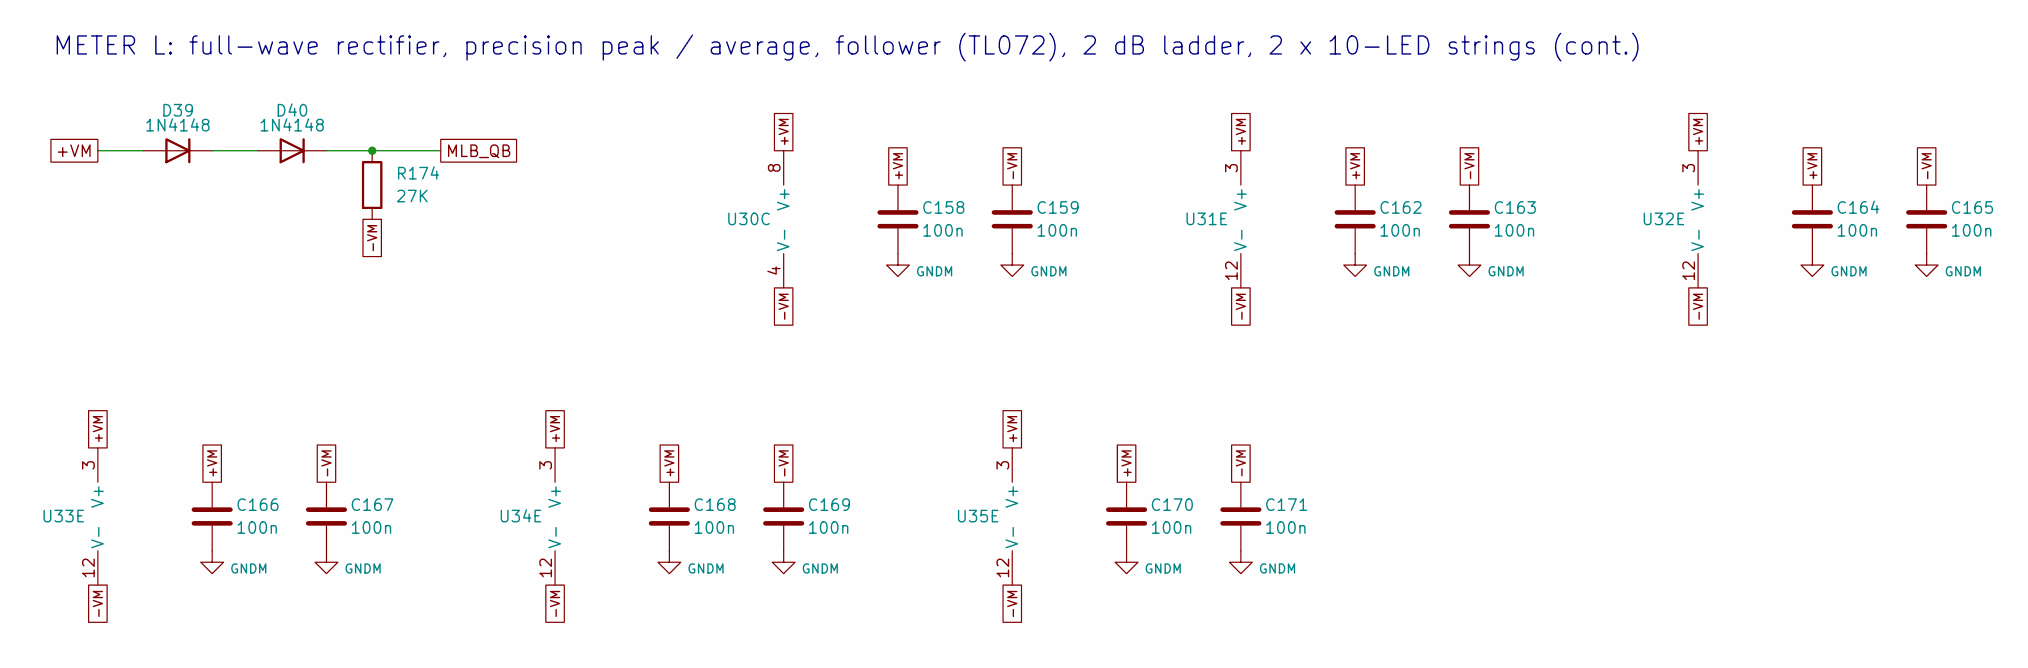
[picture p129: schematic 21_meter_l.kicad_sch, METER L]

Parts:
C158, C159, C162, C163, C164, C165, C166, C167, C168, C169, C170, C171: 100n; C_0805_2012Metric; MPN Samsung CL21B104KBCNNNC (X7R 50V)
D39, D40: 1N4148; D_DO-35_SOD27_P7.62mm_Horizontal; MPN Vishay 1N4148-TAP
R174: 27K; R_0805_2012Metric
U30: TL072; SOIC-8_3.9x4.9mm_P1.27mm; MPN TI TL072HIDR
U31, U32, U33, U34, U35: LM2901; SOIC-14_3.9x8.7mm_P1.27mm; MPN TI LM2901BIDR

Connections:
+VM: C158.1, C162.1, C164.1, C166.1, C168.1, C170.1, D39.2 (A), U30.8 (V+), U31.3 (V+), U32.3 (V+), U33.3 (V+), U34.3 (V+), U35.3 (V+); also elsewhere on the board
-VM: C159.2, C163.2, C165.2, C167.2, C169.2, C171.2, R174.2, U30.4 (V-), U31.12 (V-), U32.12 (V-), U33.12 (V-), U34.12 (V-), U35.12 (V-); also elsewhere on the board
GNDM: C158.2, C159.1, C162.2, C163.1, C164.2, C165.1, C166.2, C167.1, C168.2, C169.1, C170.2, C171.1; also elsewhere on the board
MLB_QB: D40.1 (K), R174.1; also elsewhere on the board
unnamed: D39.1 (K), D40.2 (A)

Notes on the sheet:
METER L: full-wave rectifier, precision peak / average, follower (TL072), 2 dB ladder, 2 x 10-LED strings (cont.)

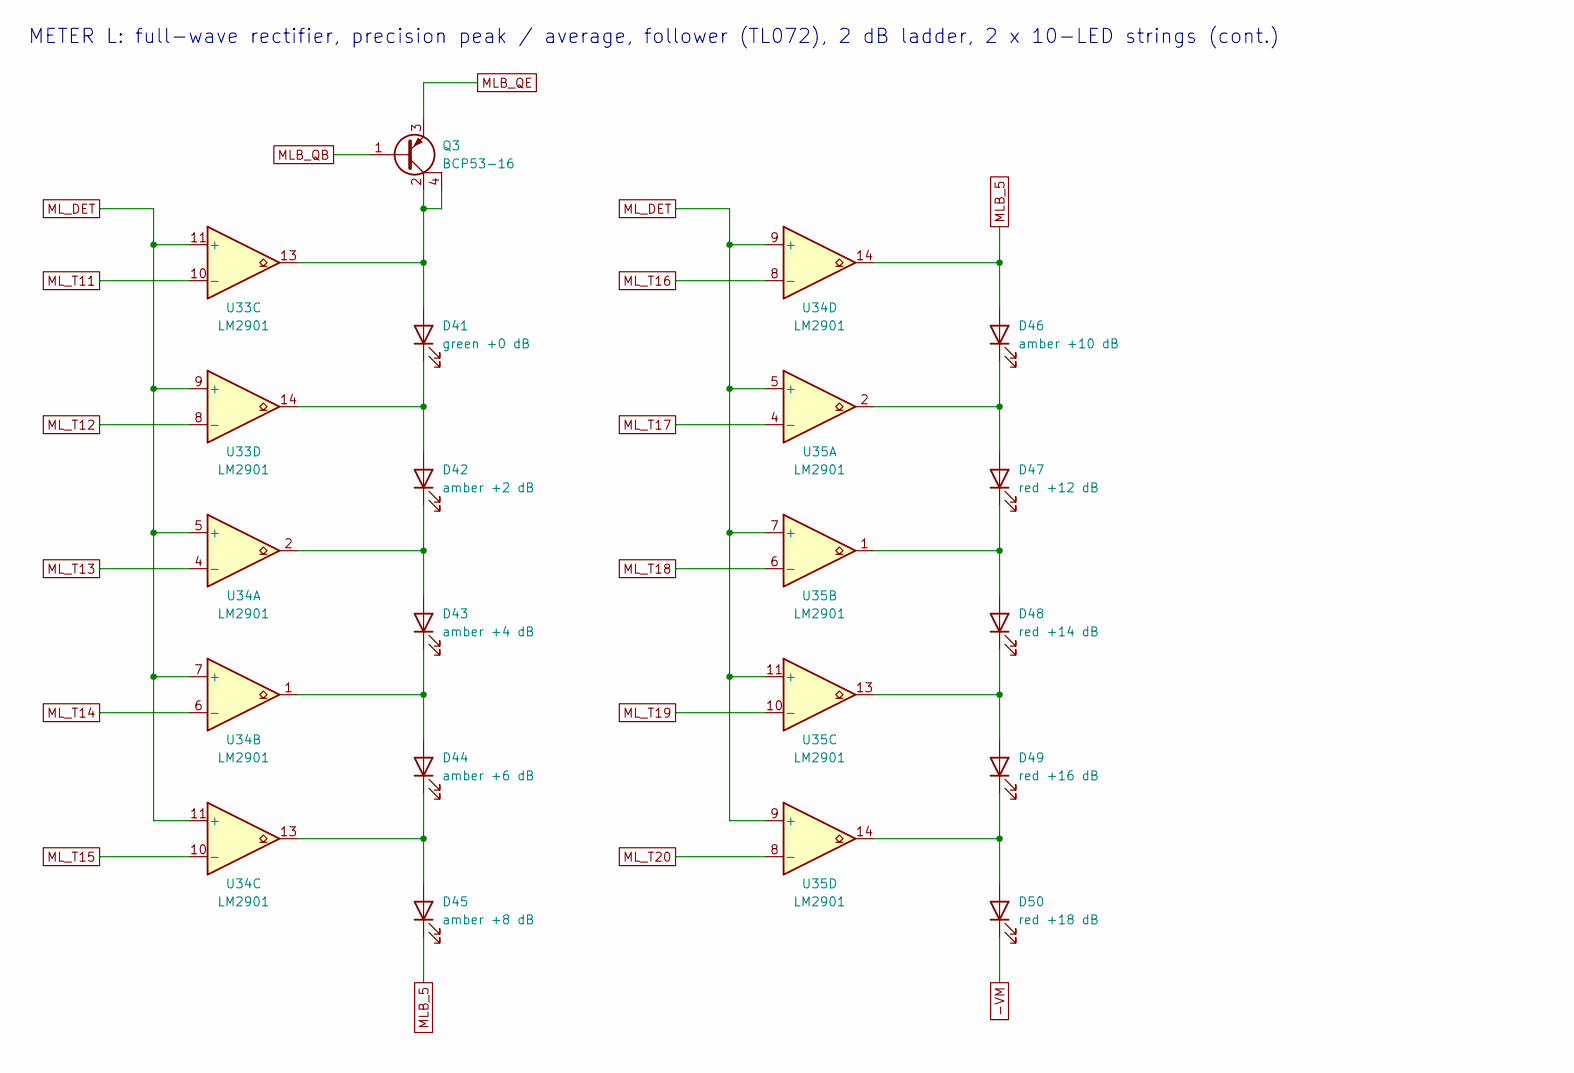
[picture p130: schematic 22_meter_l.kicad_sch, METER L]

Parts:
D41: green +0 dB; LED_D3.0mm; MPN Kingbright WP710A10GD
D42: amber +2 dB; LED_D3.0mm; MPN Kingbright WP710A10ND
D43: amber +4 dB; LED_D3.0mm; MPN Kingbright WP710A10ND
D44: amber +6 dB; LED_D3.0mm; MPN Kingbright WP710A10ND
D45: amber +8 dB; LED_D3.0mm; MPN Kingbright WP710A10ND
D46: amber +10 dB; LED_D3.0mm; MPN Kingbright WP710A10ND
D47: red +12 dB; LED_D3.0mm; MPN Kingbright WP710A10ID
D48: red +14 dB; LED_D3.0mm; MPN Kingbright WP710A10ID
D49: red +16 dB; LED_D3.0mm; MPN Kingbright WP710A10ID
D50: red +18 dB; LED_D3.0mm; MPN Kingbright WP710A10ID
Q3: BCP53-16; SOT-223; MPN onsemi BCP53-16T1G
U33, U34, U35: LM2901; SOIC-14_3.9x8.7mm_P1.27mm; MPN TI LM2901BIDR

Connections:
-VM: D50.1 (K); also elsewhere on the board
MLB_5: D45.1 (K), D46.2 (A), U34.14
MLB_QB: Q3.1 (B); also elsewhere on the board
MLB_QE: Q3.3 (E); also elsewhere on the board
ML_DET: U33.9 (+), U33.11 (+), U34.5 (+), U34.7 (+), U34.9 (+), U34.11 (+), U35.5 (+), U35.7 (+), U35.9 (+), U35.11 (+); also elsewhere on the board
ML_T11: U33.10 (-); also elsewhere on the board
ML_T12: U33.8 (-); also elsewhere on the board
ML_T13: U34.4 (-); also elsewhere on the board
ML_T14: U34.6 (-); also elsewhere on the board
ML_T15: U34.10 (-); also elsewhere on the board
ML_T16: U34.8 (-); also elsewhere on the board
ML_T17: U35.4 (-); also elsewhere on the board
ML_T18: U35.6 (-); also elsewhere on the board
ML_T19: U35.10 (-); also elsewhere on the board
ML_T20: U35.8 (-); also elsewhere on the board
unnamed: D41.2 (A), Q3.2 (C), Q3.4 (C), U33.13
unnamed: D41.1 (K), D42.2 (A), U33.14
unnamed: D42.1 (K), D43.2 (A), U34.2
unnamed: D43.1 (K), D44.2 (A), U34.1
unnamed: D44.1 (K), D45.2 (A), U34.13
unnamed: D46.1 (K), D47.2 (A), U35.2
unnamed: D47.1 (K), D48.2 (A), U35.1
unnamed: D48.1 (K), D49.2 (A), U35.13
unnamed: D49.1 (K), D50.2 (A), U35.14

Notes on the sheet:
METER L: full-wave rectifier, precision peak / average, follower (TL072), 2 dB ladder, 2 x 10-LED strings (cont.)

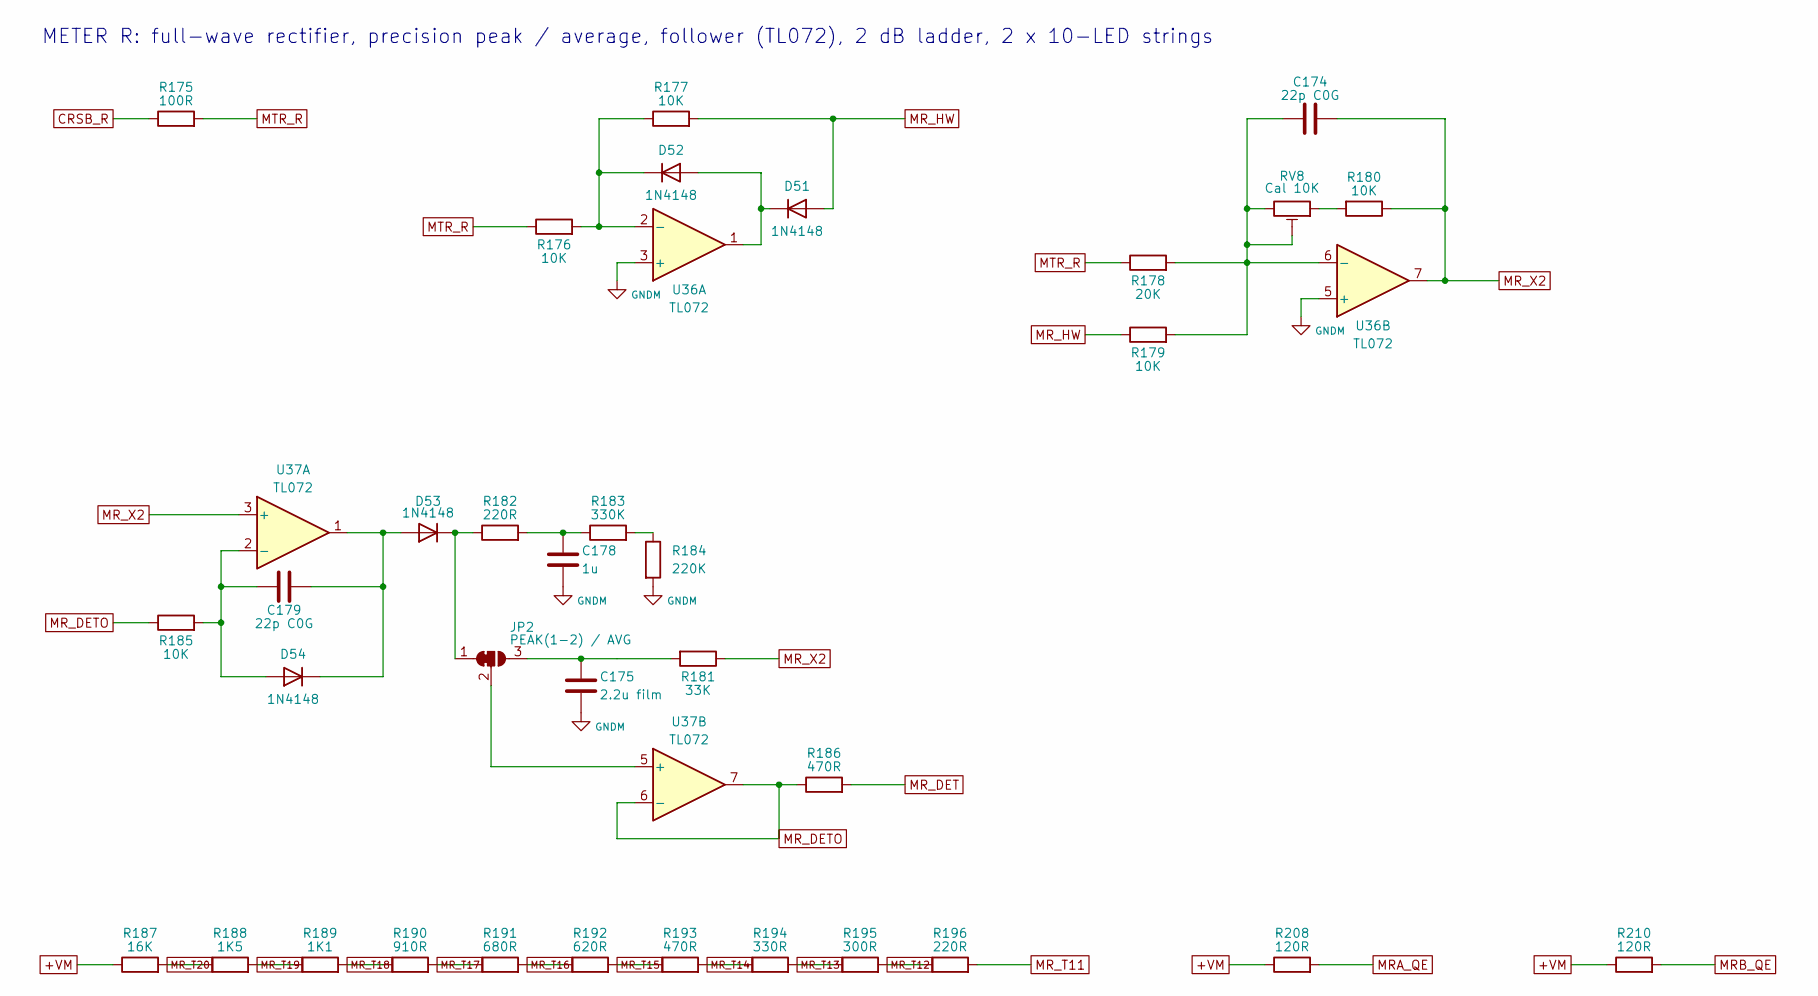
[picture p131: schematic 23_meter_r.kicad_sch, METER R]

Parts:
C174, C179: 22p C0G; C_0805_2012Metric; MPN KEMET C0805C220J5GACTU
C175: 2.2u film; C_Rect_L7.2mm_W7.2mm_P5.00mm_FKS2_FKP2_MKS2_MKP2; MPN KEMET MMK5225K63J06L4BULK (PET 63V; rep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
C178: 1u; C_1206_3216Metric; MPN Samsung CL31B105KBHNNNE (X7R 50V)
D51, D52, D53, D54: 1N4148; D_DO-35_SOD27_P7.62mm_Horizontal; MPN Vishay 1N4148-TAP
JP2: PEAK(1-2) / AVG; SolderJumper-3_P1.3mm_Bridged12_RoundedPad1.0x1.5mm
R175: 100R; R_0805_2012Metric
R176, R177, R179, R180, R185: 10K; R_0805_2012Metric
R178: 20K; R_0805_2012Metric
R181: 33K; R_0805_2012Metric
R182, R196: 220R; R_0805_2012Metric
R183: 330K; R_0805_2012Metric
R184: 220K; R_0805_2012Metric
R186, R193: 470R; R_0805_2012Metric
R187: 16K; R_0805_2012Metric
R188: 1K5; R_0805_2012Metric
R189: 1K1; R_0805_2012Metric
R190: 910R; R_0805_2012Metric
R191: 680R; R_0805_2012Metric
R192: 620R; R_0805_2012Metric
R194: 330R; R_0805_2012Metric
R195: 300R; R_0805_2012Metric
R208, R210: 120R; R_0805_2012Metric
RV8: Cal 10K; Potentiometer_Bourns_3296W_Vertical; MPN Bourns 3296W-1-103LF
U36, U37: TL072; SOIC-8_3.9x4.9mm_P1.27mm; MPN TI TL072HIDR

Connections:
+VM: R187.1, R208.1, R210.1; also elsewhere on the board
CRSB_R: R175.1; also elsewhere on the board
GNDM: C175.2, C178.2, R184.2, U36.3 (+), U36.5 (+); also elsewhere on the board
MRA_QE: R208.2; also elsewhere on the board
MRB_QE: R210.2; also elsewhere on the board
MR_DET: R186.2; also elsewhere on the board
MR_DETO: R185.1, R186.1, U37.6 (-), U37.7
MR_HW: D51.2 (A), R177.2, R179.1
MR_T11: R196.2; also elsewhere on the board
MR_T12: R195.2, R196.1; also elsewhere on the board
MR_T13: R194.2, R195.1; also elsewhere on the board
MR_T14: R193.2, R194.1; also elsewhere on the board
MR_T15: R192.2, R193.1; also elsewhere on the board
MR_T16: R191.2, R192.1; also elsewhere on the board
MR_T17: R190.2, R191.1; also elsewhere on the board
MR_T18: R189.2, R190.1; also elsewhere on the board
MR_T19: R188.2, R189.1; also elsewhere on the board
MR_T20: R187.2, R188.1; also elsewhere on the board
MR_X2: C174.1, R180.1, R181.1, U36.7, U37.3 (+)
MTR_R: R175.2, R176.1, R178.1; also elsewhere on the board
unnamed: C178.1, R182.2, R183.1
unnamed: D51.1 (K), D52.2 (A), U36.1
unnamed: D52.1 (K), R176.2, R177.1, U36.2 (-)
unnamed: C179.1, D53.2 (A), D54.1 (K), U37.1
unnamed: D53.1 (K), JP2.1 (A), R182.1
unnamed: C179.2, D54.2 (A), R185.2, U37.2 (-)
unnamed: C175.1, JP2.3 (B), R181.2
unnamed: JP2.2 (C), U37.5 (+)
unnamed: R180.2, RV8.1
unnamed: R183.2, R184.1
unnamed: C174.2, R178.2, R179.2, RV8.2, RV8.3, U36.6 (-)

Notes on the sheet:
METER R: full-wave rectifier, precision peak / average, follower (TL072), 2 dB ladder, 2 x 10-LED strings
