cozycactus/goa-console/boards/master/master.kicad_pcb

## KiCad design boards/master/master.kicad_pcb (continued)

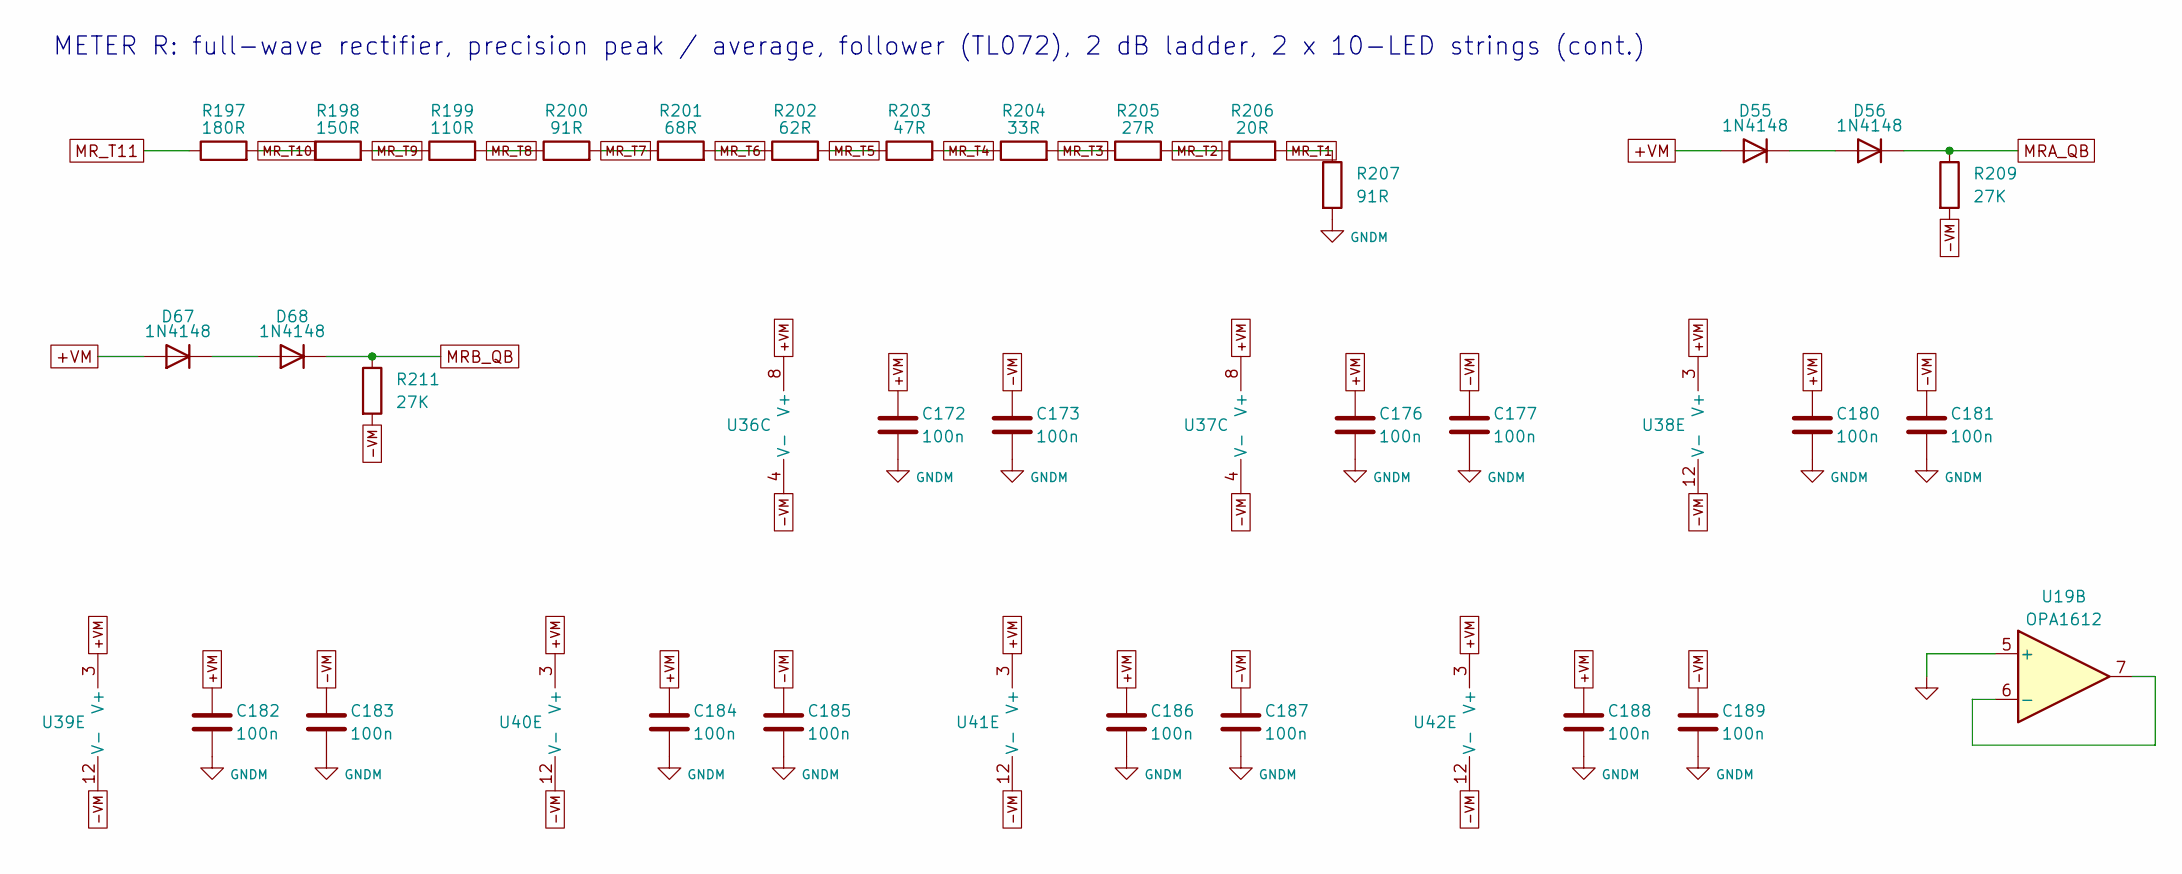
[picture p132: schematic 24_meter_r.kicad_sch, METER R]

Parts:
C172, C173, C176, C177, C180, C181, C182, C183, C184, C185, C186, C187, C188, C189: 100n; C_0805_2012Metric; MPN Samsung CL21B104KBCNNNC (X7R 50V)
D55, D56, D67, D68: 1N4148; D_DO-35_SOD27_P7.62mm_Horizontal; MPN Vishay 1N4148-TAP
R197: 180R; R_0805_2012Metric
R198: 150R; R_0805_2012Metric
R199: 110R; R_0805_2012Metric
R200, R207: 91R; R_0805_2012Metric
R201: 68R; R_0805_2012Metric
R202: 62R; R_0805_2012Metric
R203: 47R; R_0805_2012Metric
R204: 33R; R_0805_2012Metric
R205: 27R; R_0805_2012Metric
R206: 20R; R_0805_2012Metric
R209, R211: 27K; R_0805_2012Metric
U19: OPA1612; SOIC-8_3.9x4.9mm_P1.27mm; MPN TI OPA1612AIDR
U36, U37: TL072; SOIC-8_3.9x4.9mm_P1.27mm; MPN TI TL072HIDR
U38, U39, U40, U41, U42: LM2901; SOIC-14_3.9x8.7mm_P1.27mm; MPN TI LM2901BIDR

Connections:
+VM: C172.1, C176.1, C180.1, C182.1, C184.1, C186.1, C188.1, D55.2 (A), D67.2 (A), U36.8 (V+), U37.8 (V+), U38.3 (V+), U39.3 (V+), U40.3 (V+), U41.3 (V+), U42.3 (V+); also elsewhere on the board
-VM: C173.2, C177.2, C181.2, C183.2, C185.2, C187.2, C189.2, R209.2, R211.2, U36.4 (V-), U37.4 (V-), U38.12 (V-), U39.12 (V-), U40.12 (V-), U41.12 (V-), U42.12 (V-); also elsewhere on the board
GNDA: U19.5 (+); also elsewhere on the board
GNDM: C172.2, C173.1, C176.2, C177.1, C180.2, C181.1, C182.2, C183.1, C184.2, C185.1, C186.2, C187.1, C188.2, C189.1, R207.2; also elsewhere on the board
MRA_QB: D56.1 (K), R209.1; also elsewhere on the board
MRB_QB: D68.1 (K), R211.1; also elsewhere on the board
MR_T1: R206.2, R207.1; also elsewhere on the board
MR_T2: R205.2, R206.1; also elsewhere on the board
MR_T3: R204.2, R205.1; also elsewhere on the board
MR_T4: R203.2, R204.1; also elsewhere on the board
MR_T5: R202.2, R203.1; also elsewhere on the board
MR_T6: R201.2, R202.1; also elsewhere on the board
MR_T7: R200.2, R201.1; also elsewhere on the board
MR_T8: R199.2, R200.1; also elsewhere on the board
MR_T9: R198.2, R199.1; also elsewhere on the board
MR_T10: R197.2, R198.1; also elsewhere on the board
MR_T11: R197.1; also elsewhere on the board
unnamed: D55.1 (K), D56.2 (A)
unnamed: D67.1 (K), D68.2 (A)
unnamed: U19.6 (-), U19.7

Notes on the sheet:
METER R: full-wave rectifier, precision peak / average, follower (TL072), 2 dB ladder, 2 x 10-LED strings (cont.)

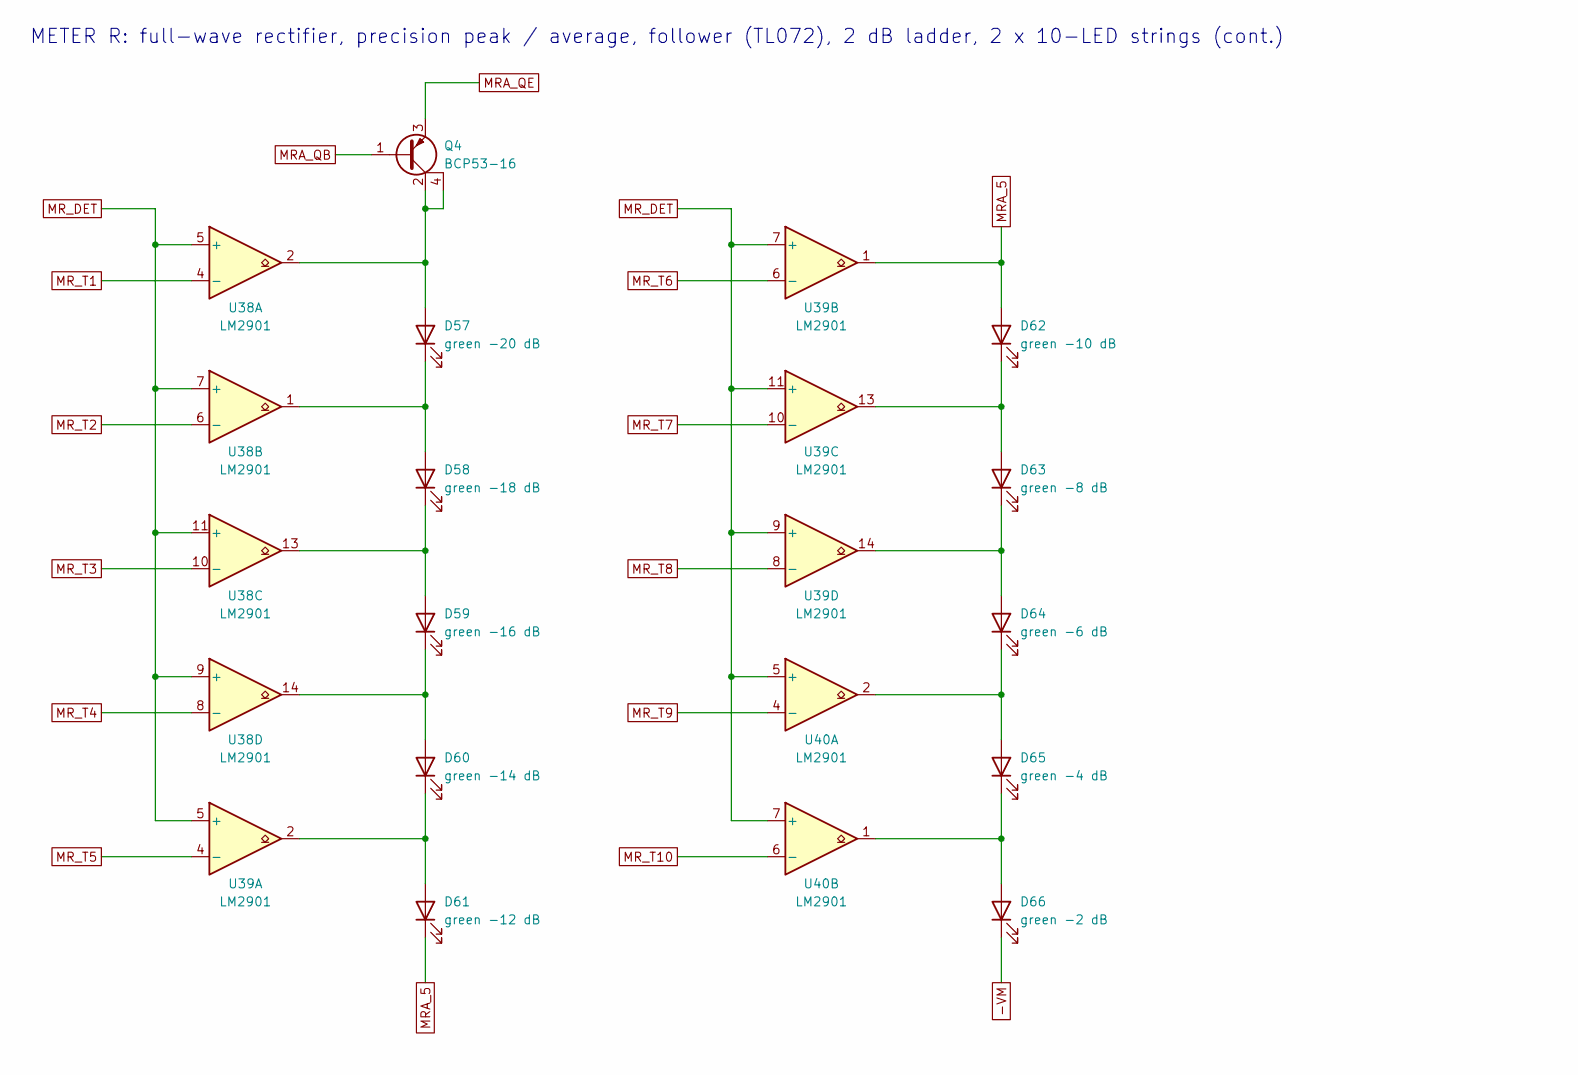
[picture p133: schematic 25_meter_r.kicad_sch, METER R]

Parts:
D57: green -20 dB; LED_D3.0mm; MPN Kingbright WP710A10GD
D58: green -18 dB; LED_D3.0mm; MPN Kingbright WP710A10GD
D59: green -16 dB; LED_D3.0mm; MPN Kingbright WP710A10GD
D60: green -14 dB; LED_D3.0mm; MPN Kingbright WP710A10GD
D61: green -12 dB; LED_D3.0mm; MPN Kingbright WP710A10GD
D62: green -10 dB; LED_D3.0mm; MPN Kingbright WP710A10GD
D63: green -8 dB; LED_D3.0mm; MPN Kingbright WP710A10GD
D64: green -6 dB; LED_D3.0mm; MPN Kingbright WP710A10GD
D65: green -4 dB; LED_D3.0mm; MPN Kingbright WP710A10GD
D66: green -2 dB; LED_D3.0mm; MPN Kingbright WP710A10GD
Q4: BCP53-16; SOT-223; MPN onsemi BCP53-16T1G
U38, U39, U40: LM2901; SOIC-14_3.9x8.7mm_P1.27mm; MPN TI LM2901BIDR

Connections:
-VM: D66.1 (K); also elsewhere on the board
MRA_5: D61.1 (K), D62.2 (A), U39.1
MRA_QB: Q4.1 (B); also elsewhere on the board
MRA_QE: Q4.3 (E); also elsewhere on the board
MR_DET: U38.5 (+), U38.7 (+), U38.9 (+), U38.11 (+), U39.5 (+), U39.7 (+), U39.9 (+), U39.11 (+), U40.5 (+), U40.7 (+); also elsewhere on the board
MR_T1: U38.4 (-); also elsewhere on the board
MR_T2: U38.6 (-); also elsewhere on the board
MR_T3: U38.10 (-); also elsewhere on the board
MR_T4: U38.8 (-); also elsewhere on the board
MR_T5: U39.4 (-); also elsewhere on the board
MR_T6: U39.6 (-); also elsewhere on the board
MR_T7: U39.10 (-); also elsewhere on the board
MR_T8: U39.8 (-); also elsewhere on the board
MR_T9: U40.4 (-); also elsewhere on the board
MR_T10: U40.6 (-); also elsewhere on the board
unnamed: D57.2 (A), Q4.2 (C), Q4.4 (C), U38.2
unnamed: D57.1 (K), D58.2 (A), U38.1
unnamed: D58.1 (K), D59.2 (A), U38.13
unnamed: D59.1 (K), D60.2 (A), U38.14
unnamed: D60.1 (K), D61.2 (A), U39.2
unnamed: D62.1 (K), D63.2 (A), U39.13
unnamed: D63.1 (K), D64.2 (A), U39.14
unnamed: D64.1 (K), D65.2 (A), U40.2
unnamed: D65.1 (K), D66.2 (A), U40.1

Notes on the sheet:
METER R: full-wave rectifier, precision peak / average, follower (TL072), 2 dB ladder, 2 x 10-LED strings (cont.)

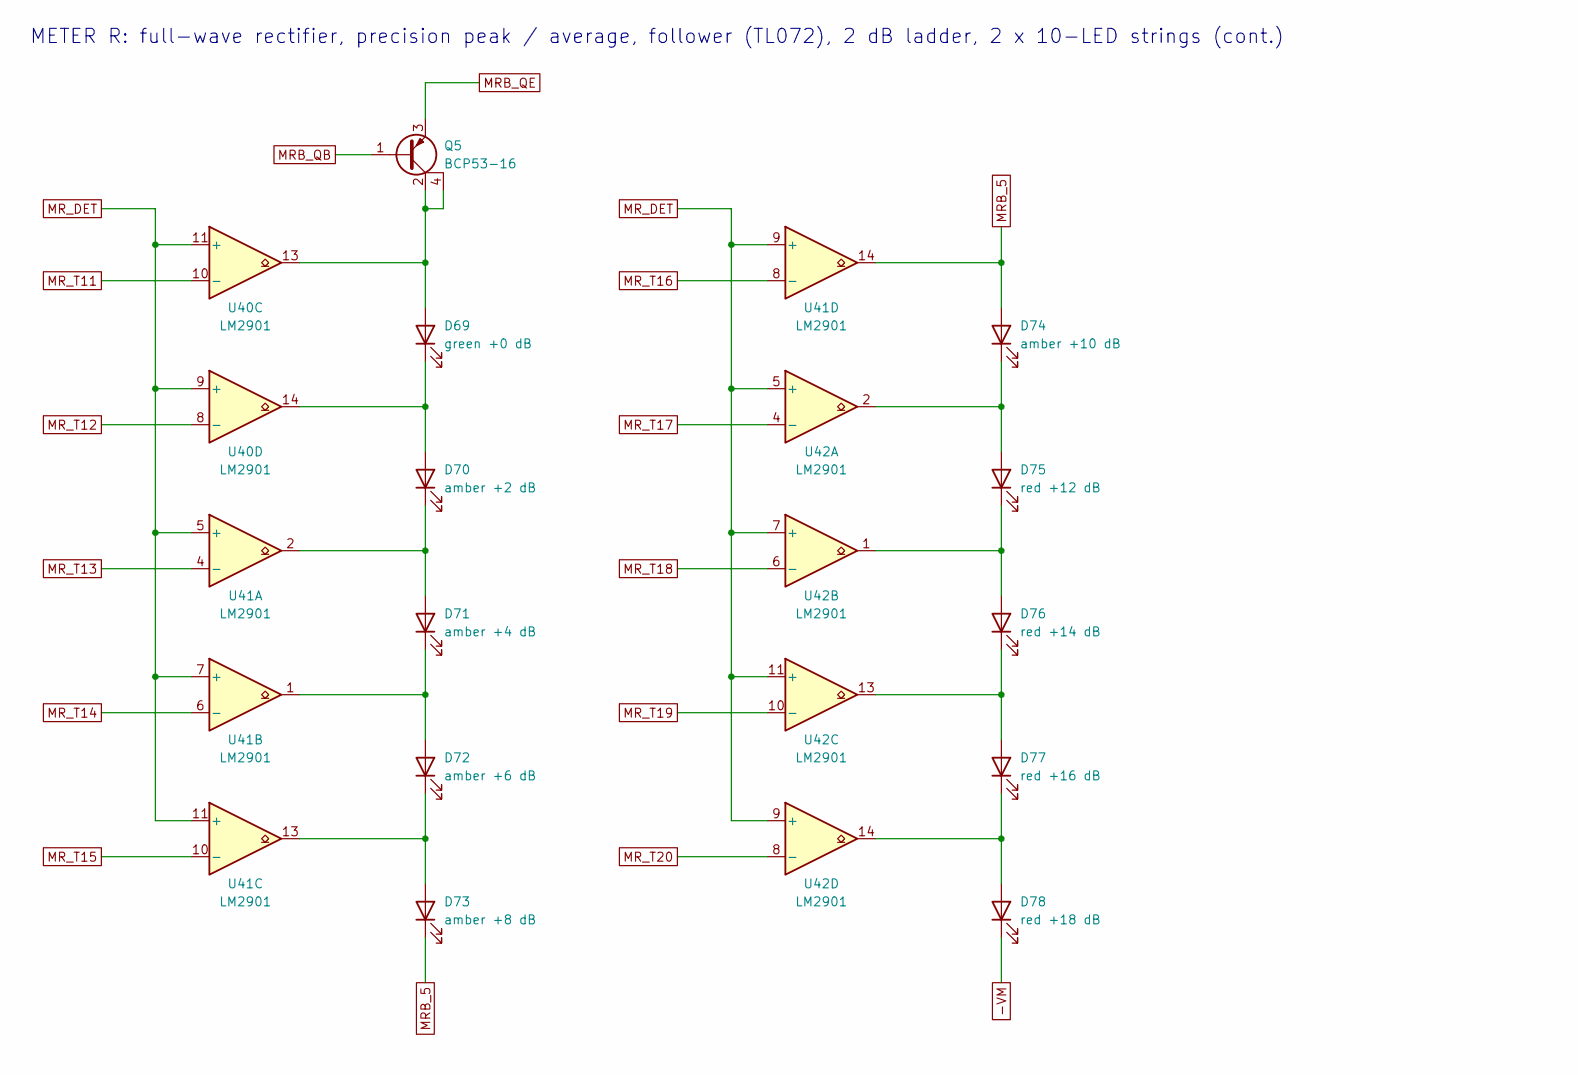
[picture p134: schematic 26_meter_r.kicad_sch, METER R]

Parts:
D69: green +0 dB; LED_D3.0mm; MPN Kingbright WP710A10GD
D70: amber +2 dB; LED_D3.0mm; MPN Kingbright WP710A10ND
D71: amber +4 dB; LED_D3.0mm; MPN Kingbright WP710A10ND
D72: amber +6 dB; LED_D3.0mm; MPN Kingbright WP710A10ND
D73: amber +8 dB; LED_D3.0mm; MPN Kingbright WP710A10ND
D74: amber +10 dB; LED_D3.0mm; MPN Kingbright WP710A10ND
D75: red +12 dB; LED_D3.0mm; MPN Kingbright WP710A10ID
D76: red +14 dB; LED_D3.0mm; MPN Kingbright WP710A10ID
D77: red +16 dB; LED_D3.0mm; MPN Kingbright WP710A10ID
D78: red +18 dB; LED_D3.0mm; MPN Kingbright WP710A10ID
Q5: BCP53-16; SOT-223; MPN onsemi BCP53-16T1G
U40, U41, U42: LM2901; SOIC-14_3.9x8.7mm_P1.27mm; MPN TI LM2901BIDR

Connections:
-VM: D78.1 (K); also elsewhere on the board
MRB_5: D73.1 (K), D74.2 (A), U41.14
MRB_QB: Q5.1 (B); also elsewhere on the board
MRB_QE: Q5.3 (E); also elsewhere on the board
MR_DET: U40.9 (+), U40.11 (+), U41.5 (+), U41.7 (+), U41.9 (+), U41.11 (+), U42.5 (+), U42.7 (+), U42.9 (+), U42.11 (+); also elsewhere on the board
MR_T11: U40.10 (-); also elsewhere on the board
MR_T12: U40.8 (-); also elsewhere on the board
MR_T13: U41.4 (-); also elsewhere on the board
MR_T14: U41.6 (-); also elsewhere on the board
MR_T15: U41.10 (-); also elsewhere on the board
MR_T16: U41.8 (-); also elsewhere on the board
MR_T17: U42.4 (-); also elsewhere on the board
MR_T18: U42.6 (-); also elsewhere on the board
MR_T19: U42.10 (-); also elsewhere on the board
MR_T20: U42.8 (-); also elsewhere on the board
unnamed: D69.2 (A), Q5.2 (C), Q5.4 (C), U40.13
unnamed: D69.1 (K), D70.2 (A), U40.14
unnamed: D70.1 (K), D71.2 (A), U41.2
unnamed: D71.1 (K), D72.2 (A), U41.1
unnamed: D72.1 (K), D73.2 (A), U41.13
unnamed: D74.1 (K), D75.2 (A), U42.2
unnamed: D75.1 (K), D76.2 (A), U42.1
unnamed: D76.1 (K), D77.2 (A), U42.13
unnamed: D77.1 (K), D78.2 (A), U42.14

Notes on the sheet:
METER R: full-wave rectifier, precision peak / average, follower (TL072), 2 dB ladder, 2 x 10-LED strings (cont.)

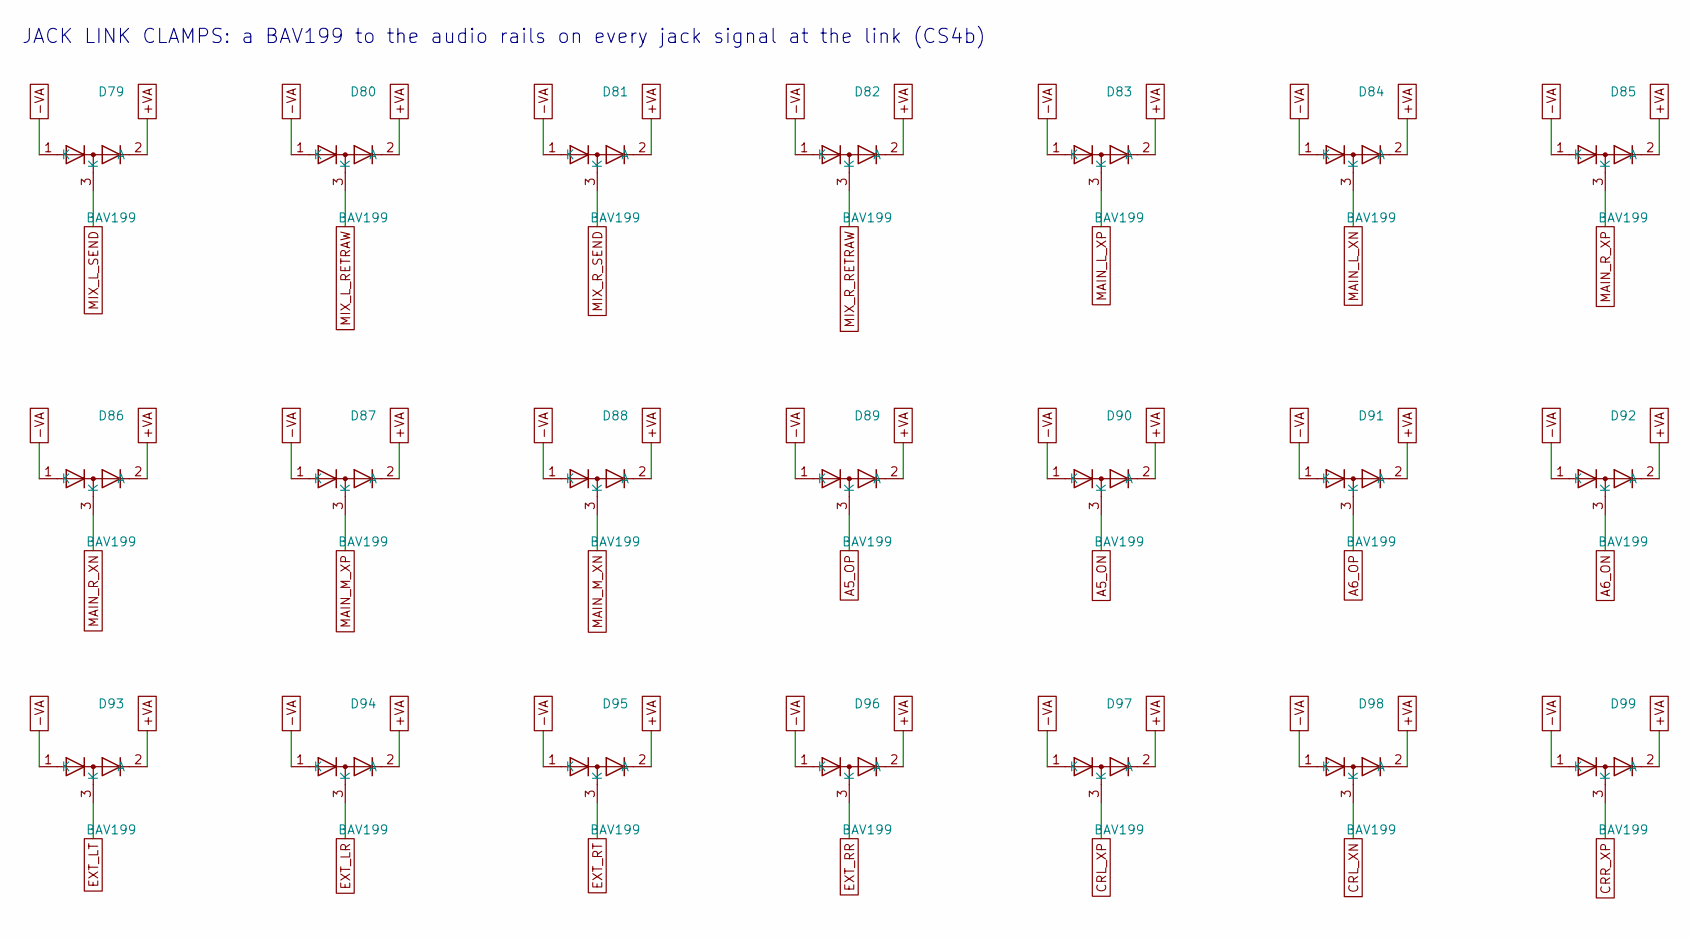
[picture p135: schematic 27_jack_link_clamps.kicad_sch, JACK LINK CLAMPS]

Parts:
D79, D80, D81, D82, D83, D84, D85, D86, D87, D88, D89, D90, D91, D92, D93, D94, D95, D96, D97, D98, D99: BAV199; SOT-23; MPN Nexperia BAV199,215

Connections:
+VA: D79.2 (A), D80.2 (A), D81.2 (A), D82.2 (A), D83.2 (A), D84.2 (A), D85.2 (A), D86.2 (A), D87.2 (A), D88.2 (A), D89.2 (A), D90.2 (A), D91.2 (A), D92.2 (A), D93.2 (A), D94.2 (A), D95.2 (A), D96.2 (A), D97.2 (A), D98.2 (A), D99.2 (A); also elsewhere on the board
-VA: D79.1 (K), D80.1 (K), D81.1 (K), D82.1 (K), D83.1 (K), D84.1 (K), D85.1 (K), D86.1 (K), D87.1 (K), D88.1 (K), D89.1 (K), D90.1 (K), D91.1 (K), D92.1 (K), D93.1 (K), D94.1 (K), D95.1 (K), D96.1 (K), D97.1 (K), D98.1 (K), D99.1 (K); also elsewhere on the board
A5_ON: D90.3 (K); also elsewhere on the board
A5_OP: D89.3 (K); also elsewhere on the board
A6_ON: D92.3 (K); also elsewhere on the board
A6_OP: D91.3 (K); also elsewhere on the board
CRL_XN: D98.3 (K); also elsewhere on the board
CRL_XP: D97.3 (K); also elsewhere on the board
CRR_XP: D99.3 (K); also elsewhere on the board
EXT_LR: D94.3 (K); also elsewhere on the board
EXT_LT: D93.3 (K); also elsewhere on the board
EXT_RR: D96.3 (K); also elsewhere on the board
EXT_RT: D95.3 (K); also elsewhere on the board
MAIN_L_XN: D84.3 (K); also elsewhere on the board
MAIN_L_XP: D83.3 (K); also elsewhere on the board
MAIN_M_XN: D88.3 (K); also elsewhere on the board
MAIN_M_XP: D87.3 (K); also elsewhere on the board
MAIN_R_XN: D86.3 (K); also elsewhere on the board
MAIN_R_XP: D85.3 (K); also elsewhere on the board
MIX_L_RETRAW: D80.3 (K); also elsewhere on the board
MIX_L_SEND: D79.3 (K); also elsewhere on the board
MIX_R_RETRAW: D82.3 (K); also elsewhere on the board
MIX_R_SEND: D81.3 (K); also elsewhere on the board

Notes on the sheet:
JACK LINK CLAMPS: a BAV199 to the audio rails on every jack signal at the link (CS4b)

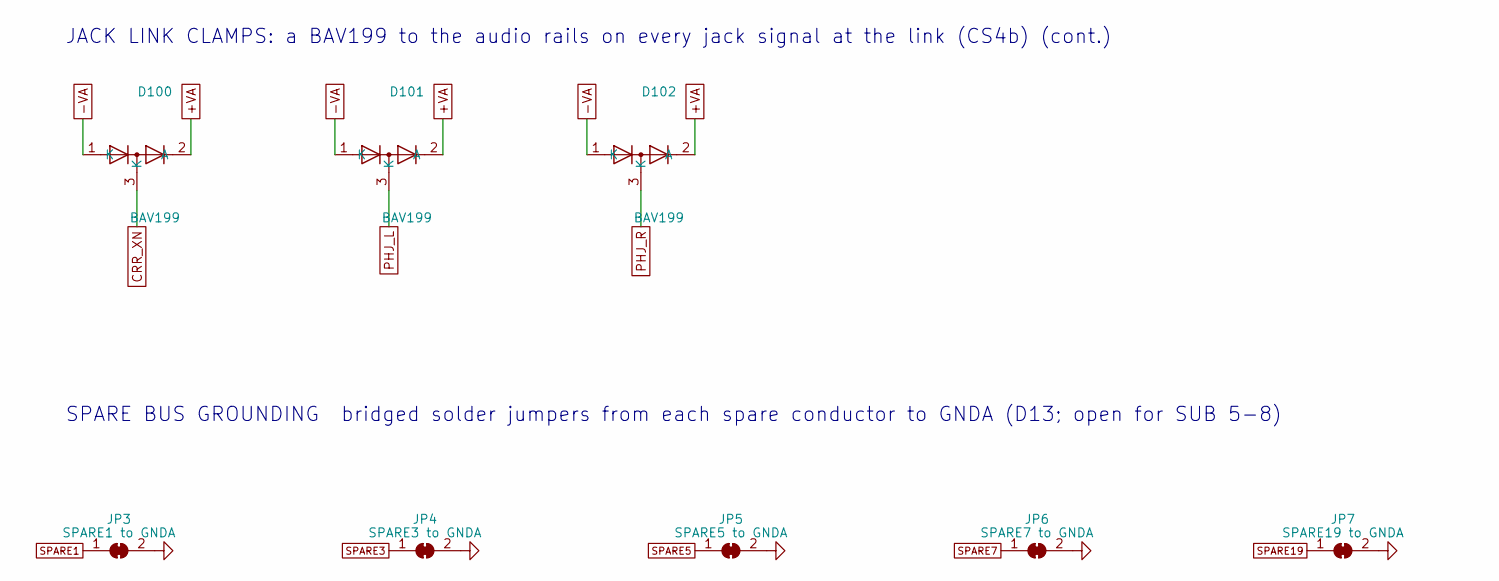
[picture p136: schematic 28_jack_link_clamps.kicad_sch, JACK LINK CLAMPS, SPARE BUS GROUNDING]

Parts:
D100, D101, D102: BAV199; SOT-23; MPN Nexperia BAV199,215
JP3: SPARE1 to GNDA; SolderJumper-2_P1.3mm_Bridged_RoundedPad1.0x1.5mm
JP4: SPARE3 to GNDA; SolderJumper-2_P1.3mm_Bridged_RoundedPad1.0x1.5mm
JP5: SPARE5 to GNDA; SolderJumper-2_P1.3mm_Bridged_RoundedPad1.0x1.5mm
JP6: SPARE7 to GNDA; SolderJumper-2_P1.3mm_Bridged_RoundedPad1.0x1.5mm
JP7: SPARE19 to GNDA; SolderJumper-2_P1.3mm_Bridged_RoundedPad1.0x1.5mm

Connections:
+VA: D100.2 (A), D101.2 (A), D102.2 (A); also elsewhere on the board
-VA: D100.1 (K), D101.1 (K), D102.1 (K); also elsewhere on the board
CRR_XN: D100.3 (K); also elsewhere on the board
GNDA: JP3.2 (B), JP4.2 (B), JP5.2 (B), JP6.2 (B), JP7.2 (B); also elsewhere on the board
PHJ_L: D101.3 (K); also elsewhere on the board
PHJ_R: D102.3 (K); also elsewhere on the board
SPARE1: JP3.1 (A); also elsewhere on the board
SPARE3: JP4.1 (A); also elsewhere on the board
SPARE5: JP5.1 (A); also elsewhere on the board
SPARE7: JP6.1 (A); also elsewhere on the board
SPARE19: JP7.1 (A); also elsewhere on the board

Notes on the sheet:
JACK LINK CLAMPS: a BAV199 to the audio rails on every jack signal at the link (CS4b) (cont.)
SPARE BUS GROUNDING bridged solder jumpers from each spare conductor to GNDA (D13; open for SUB 5-8)

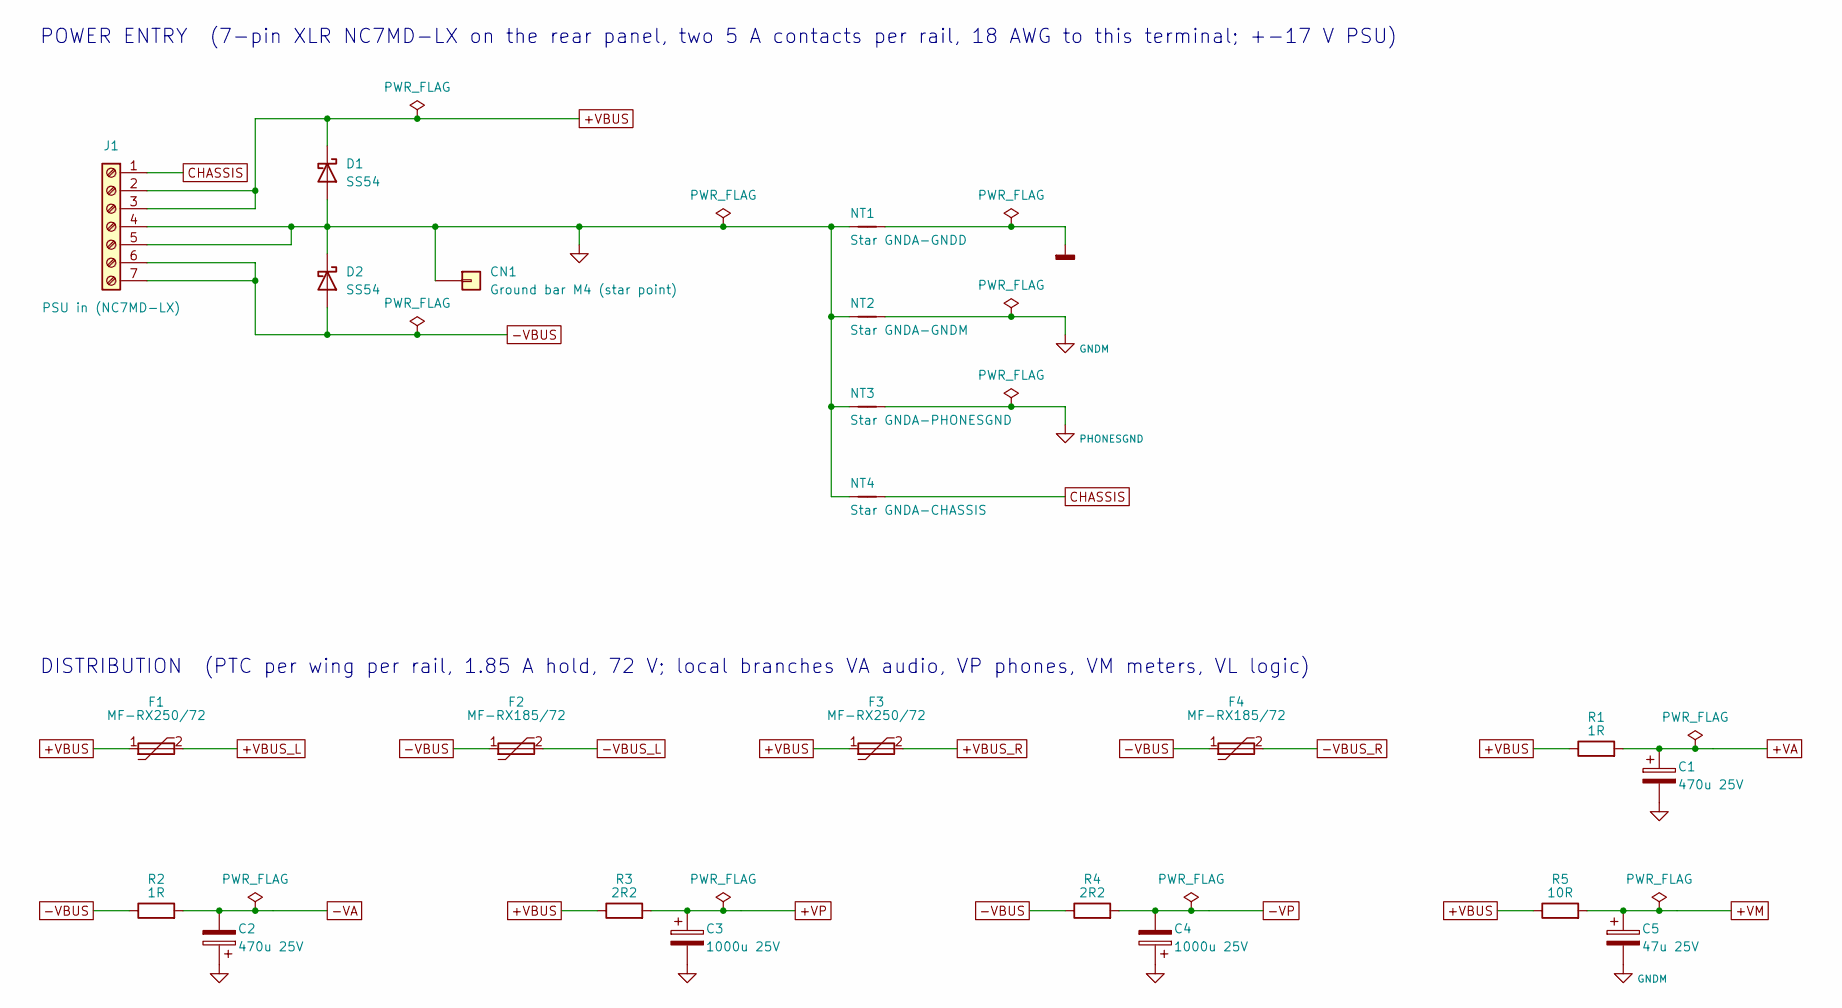
[picture p137: schematic 29_power_entry.kicad_sch, POWER ENTRY, DISTRIBUTION]

Parts:
C1, C2: 470u 25V; CP_Radial_D10.0mm_P5.00mm; MPN Nichicon UPW1E471MPD
C3, C4: 1000u 25V; CP_Radial_D12.5mm_P5.00mm; MPN Nichicon UPW1E102MHD
C5: 47u 25V; CP_Radial_D8.0mm_P3.50mm; MPN Nichicon UPW1J470MPD (63V)
CN1: Ground bar M4 (star point); MountingHole_4.3mm_M4_Pad
D1, D2: SS54; D_SMC; MPN Diodes B540C-13-F (SS54 class, SMC 40 V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
F1, F3: MF-RX250/72; Fuse_Bourns_MF-RX250-72_Radial_P10.16mm; MPN Bourns MF-RX250/72-0
F2, F4: MF-RX185/72; Fuse_Bourns_MF-RX185-72_Radial_P5.08mm; MPN Bourns MF-RX185/72-0
J1: PSU in (NC7MD-LX); TerminalBlock_Phoenix_MKDS-1,5-7-5.08_1x07_P5.08mm_Horizont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; MPN Phoenix 1755897 MKDS 1,5/7-5,08 (wired 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
NT1: Star GNDA-GNDD; NetTie-2_SMD_Pad0.5mm
NT2: Star GNDA-GNDM; NetTie-2_SMD_Pad0.5mm
NT3: Star GNDA-PHONESGND; NetTie-2_SMD_Pad0.5mm
NT4: Star GNDA-CHASSIS; NetTie-2_SMD_Pad0.5mm
R1, R2: 1R; R_0805_2012Metric; MPN Panasonic ERJ-P06J1R0V
R3, R4: 2R2; R_2512_6332Metric; MPN Vishay CRCW25122R20FKEGHP
R5: 10R; R_0805_2012Metric

Connections:
+VA: C1.1, R1.2; also elsewhere on the board
+VBUS: D1.1 (K), F1.1, F3.1, J1.2, J1.3, R1.1, R3.1, R5.1; also elsewhere on the board
+VBUS_L: F1.2; also elsewhere on the board
+VBUS_R: F3.2; also elsewhere on the board
+VM: C5.1, R5.2; also elsewhere on the board
+VP: C3.1, R3.2; also elsewhere on the board
-VA: C2.2, R2.2; also elsewhere on the board
-VBUS: D2.2 (A), F2.1, F4.1, J1.6, J1.7, R2.1, R4.1; also elsewhere on the board
-VBUS_L: F2.2; also elsewhere on the board
-VBUS_R: F4.2; also elsewhere on the board
-VP: C4.2, R4.2; also elsewhere on the board
CHASSIS: J1.1, NT4.2; also elsewhere on the board
GNDA: C1.2, C2.1, C3.2, C4.1, CN1.1, D1.2 (A), D2.1 (K), J1.4, J1.5, NT1.1, NT2.1, NT3.1, NT4.1; also elsewhere on the board
GNDD: NT1.2; also elsewhere on the board
GNDM: C5.2, NT2.2; also elsewhere on the board
PHONESGND: NT3.2; also elsewhere on the board

Notes on the sheet:
POWER ENTRY (7-pin XLR NC7MD-LX on the rear panel, two 5 A contacts per rail, 18 AWG to this terminal; +-17 V PSU)
DISTRIBUTION (PTC per wing per rail, 1.85 A hold, 72 V; local branches VA audio, VP phones, VM meters, VL logic)

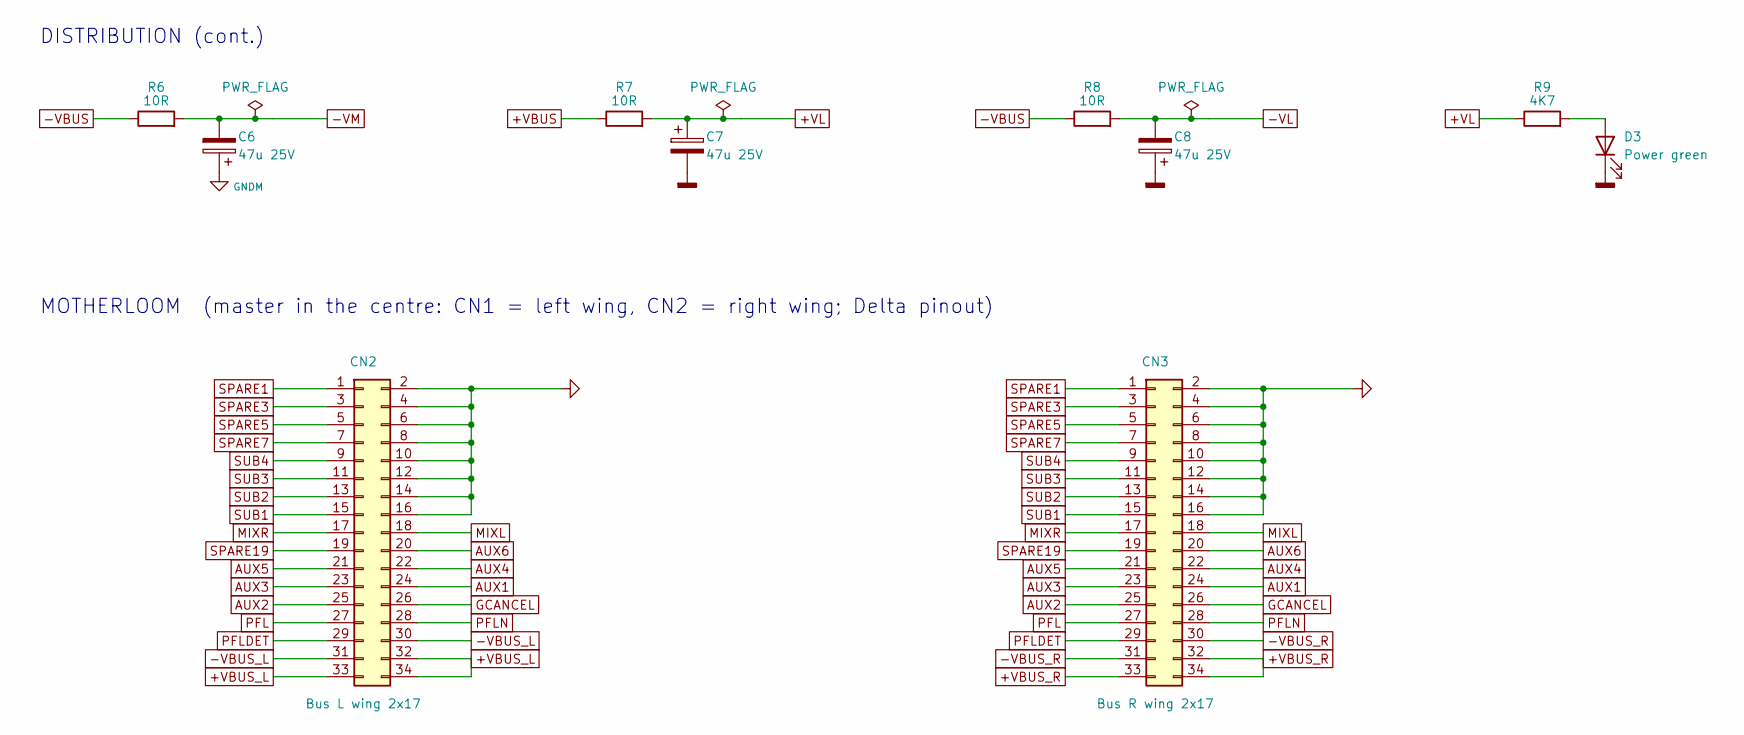
[picture p138: schematic 30_distribution.kicad_sch, DISTRIBUTION, MOTHERLOOM]

Parts:
C6, C7, C8: 47u 25V; CP_Radial_D8.0mm_P3.50mm; MPN Nichicon UPW1J470MPD (63V)
CN2: Bus L wing 2x17; IDC-Header_2x17_P2.54mm_Vertical; MPN Wurth 61203421621 (2x17 box header)
CN3: Bus R wing 2x17; IDC-Header_2x17_P2.54mm_Vertical; MPN Wurth 61203421621 (2x17 box header)
D3: Power green; LED_D3.0mm; MPN Kingbright WP710A10GD
R6, R7, R8: 10R; R_0805_2012Metric
R9: 4K7; R_0805_2012Metric

Connections:
+VBUS: R7.1; also elsewhere on the board
+VBUS_L: CN2.32, CN2.33, CN2.34; also elsewhere on the board
+VBUS_R: CN3.32, CN3.33, CN3.34; also elsewhere on the board
+VL: C7.1, R7.2, R9.1; also elsewhere on the board
-VBUS: R6.1, R8.1; also elsewhere on the board
-VBUS_L: CN2.30, CN2.31; also elsewhere on the board
-VBUS_R: CN3.30, CN3.31; also elsewhere on the board
-VL: C8.2, R8.2; also elsewhere on the board
-VM: C6.2, R6.2; also elsewhere on the board
AUX1: CN2.24, CN3.24
AUX2: CN2.25, CN3.25
AUX3: CN2.23, CN3.23
AUX4: CN2.22, CN3.22
AUX5: CN2.21, CN3.21; also elsewhere on the board
AUX6: CN2.20, CN3.20; also elsewhere on the board
GCANCEL: CN2.26, CN3.26; also elsewhere on the board
GNDA: CN2.2, CN2.4, CN2.6, CN2.8, CN2.10, CN2.12, CN2.14, CN2.16, CN3.2, CN3.4, CN3.6, CN3.8, CN3.10, CN3.12, CN3.14, CN3.16; also elsewhere on the board
GNDD: C7.2, C8.1, D3.1 (K); also elsewhere on the board
GNDM: C6.1; also elsewhere on the board
MIXL: CN2.18, CN3.18; also elsewhere on the board
MIXR: CN2.17, CN3.17; also elsewhere on the board
unnamed: D3.2 (A), R9.2
PFL: CN2.27, CN3.27; also elsewhere on the board
PFLDET: CN2.29, CN3.29; also elsewhere on the board
PFLN: CN2.28, CN3.28
SPARE1: CN2.1, CN3.1; also elsewhere on the board
SPARE3: CN2.3, CN3.3; also elsewhere on the board
SPARE5: CN2.5, CN3.5; also elsewhere on the board
SPARE7: CN2.7, CN3.7; also elsewhere on the board
SPARE19: CN2.19, CN3.19; also elsewhere on the board
SUB1: CN2.15, CN3.15
SUB2: CN2.13, CN3.13
SUB3: CN2.11, CN3.11
SUB4: CN2.9, CN3.9

Notes on the sheet:
DISTRIBUTION (cont.)
MOTHERLOOM (master in the centre: CN1 = left wing, CN2 = right wing; Delta pinout)

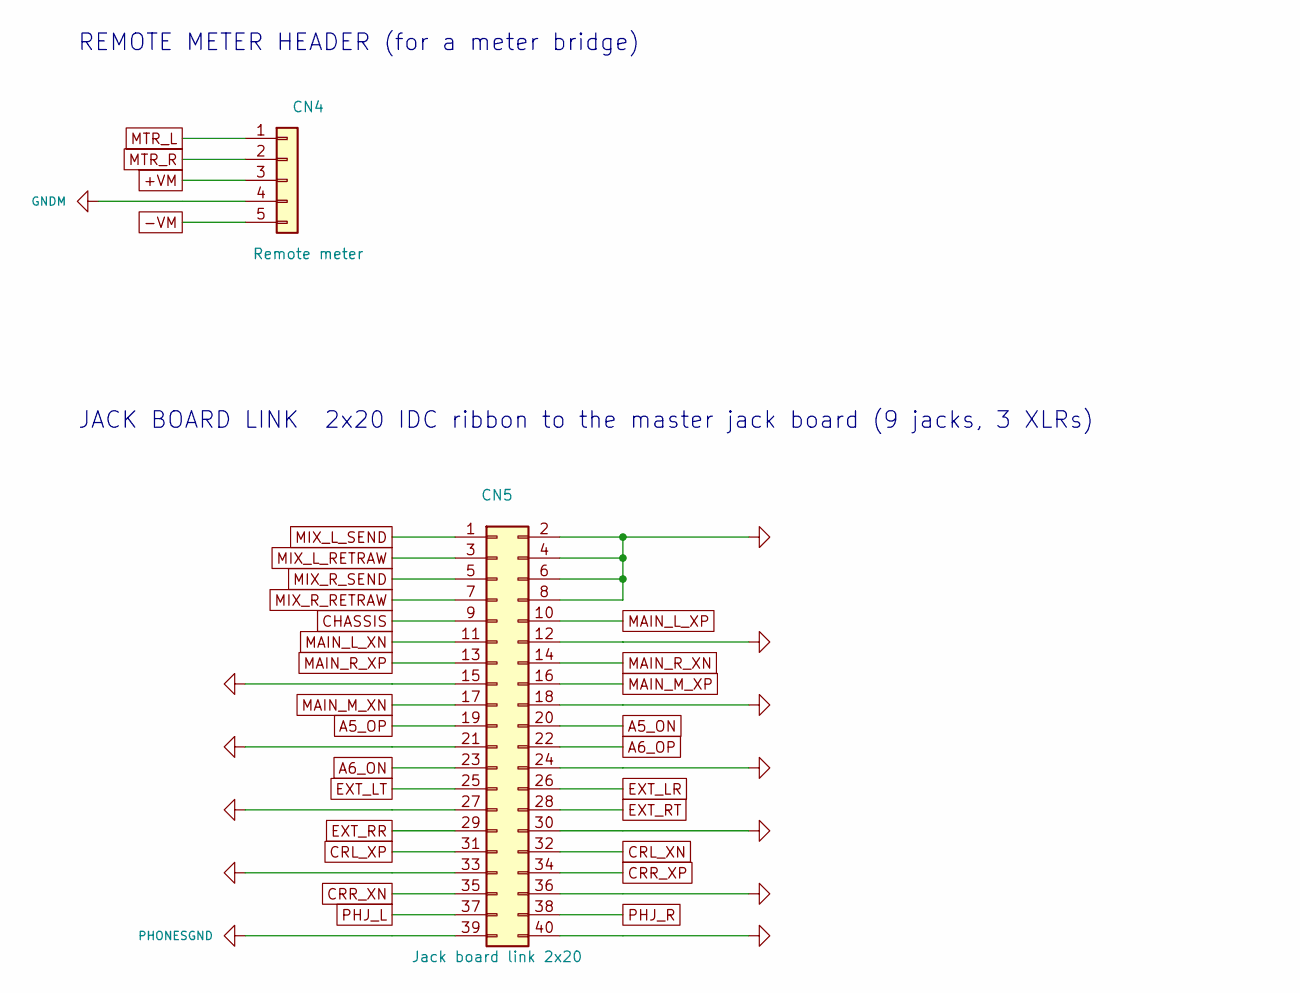
[picture p139: schematic 31_remote_meter_header.kicad_sch, REMOTE METER HEADER, JACK BOARD LINK]

Parts:
CN4: Remote meter; PinHeader_1x05_P2.54mm_Vertical; MPN Sullins PRPC005SAAN-RC
CN5: Jack board link 2x20; IDC-Header_2x20_P2.54mm_Vertical; MPN Wurth 61204021621 (2x20 box header)

Connections:
+VM: CN4.3; also elsewhere on the board
-VM: CN4.5; also elsewhere on the board
A5_ON: CN5.20; also elsewhere on the board
A5_OP: CN5.19; also elsewhere on the board
A6_ON: CN5.23; also elsewhere on the board
A6_OP: CN5.22; also elsewhere on the board
CHASSIS: CN5.9; also elsewhere on the board
CRL_XN: CN5.32; also elsewhere on the board
CRL_XP: CN5.31; also elsewhere on the board
CRR_XN: CN5.35; also elsewhere on the board
CRR_XP: CN5.34; also elsewhere on the board
EXT_LR: CN5.26; also elsewhere on the board
EXT_LT: CN5.25; also elsewhere on the board
EXT_RR: CN5.29; also elsewhere on the board
EXT_RT: CN5.28; also elsewhere on the board
GNDA: CN5.2, CN5.4, CN5.6, CN5.8, CN5.12, CN5.15, CN5.18, CN5.21, CN5.24, CN5.27, CN5.30, CN5.33, CN5.36, CN5.40; also elsewhere on the board
GNDM: CN4.4; also elsewhere on the board
MAIN_L_XN: CN5.11; also elsewhere on the board
MAIN_L_XP: CN5.10; also elsewhere on the board
MAIN_M_XN: CN5.17; also elsewhere on the board
MAIN_M_XP: CN5.16; also elsewhere on the board
MAIN_R_XN: CN5.14; also elsewhere on the board
MAIN_R_XP: CN5.13; also elsewhere on the board
MIX_L_RETRAW: CN5.3; also elsewhere on the board
MIX_L_SEND: CN5.1; also elsewhere on the board
MIX_R_RETRAW: CN5.7; also elsewhere on the board
MIX_R_SEND: CN5.5; also elsewhere on the board
MTR_L: CN4.1; also elsewhere on the board
MTR_R: CN4.2; also elsewhere on the board
PHJ_L: CN5.37; also elsewhere on the board
PHJ_R: CN5.38; also elsewhere on the board
PHONESGND: CN5.39; also elsewhere on the board

Notes on the sheet:
REMOTE METER HEADER (for a meter bridge)
JACK BOARD LINK 2x20 IDC ribbon to the master jack board (9 jacks, 3 XLRs)

Board: 4 copper layers, 639 parts (122 on the bottom side), 387 nets, no tracks yet.

Other parts of the board:
H1, H2, H3, H4, H5, H6, H7: M3 standoff 11.5 mm; MountingHole_3.2mm_M3
