cozycactus/goa-console/boards/psu/psu.kicad_pcb

## KiCad design boards/psu/psu.kicad_pcb (2026-11-03)

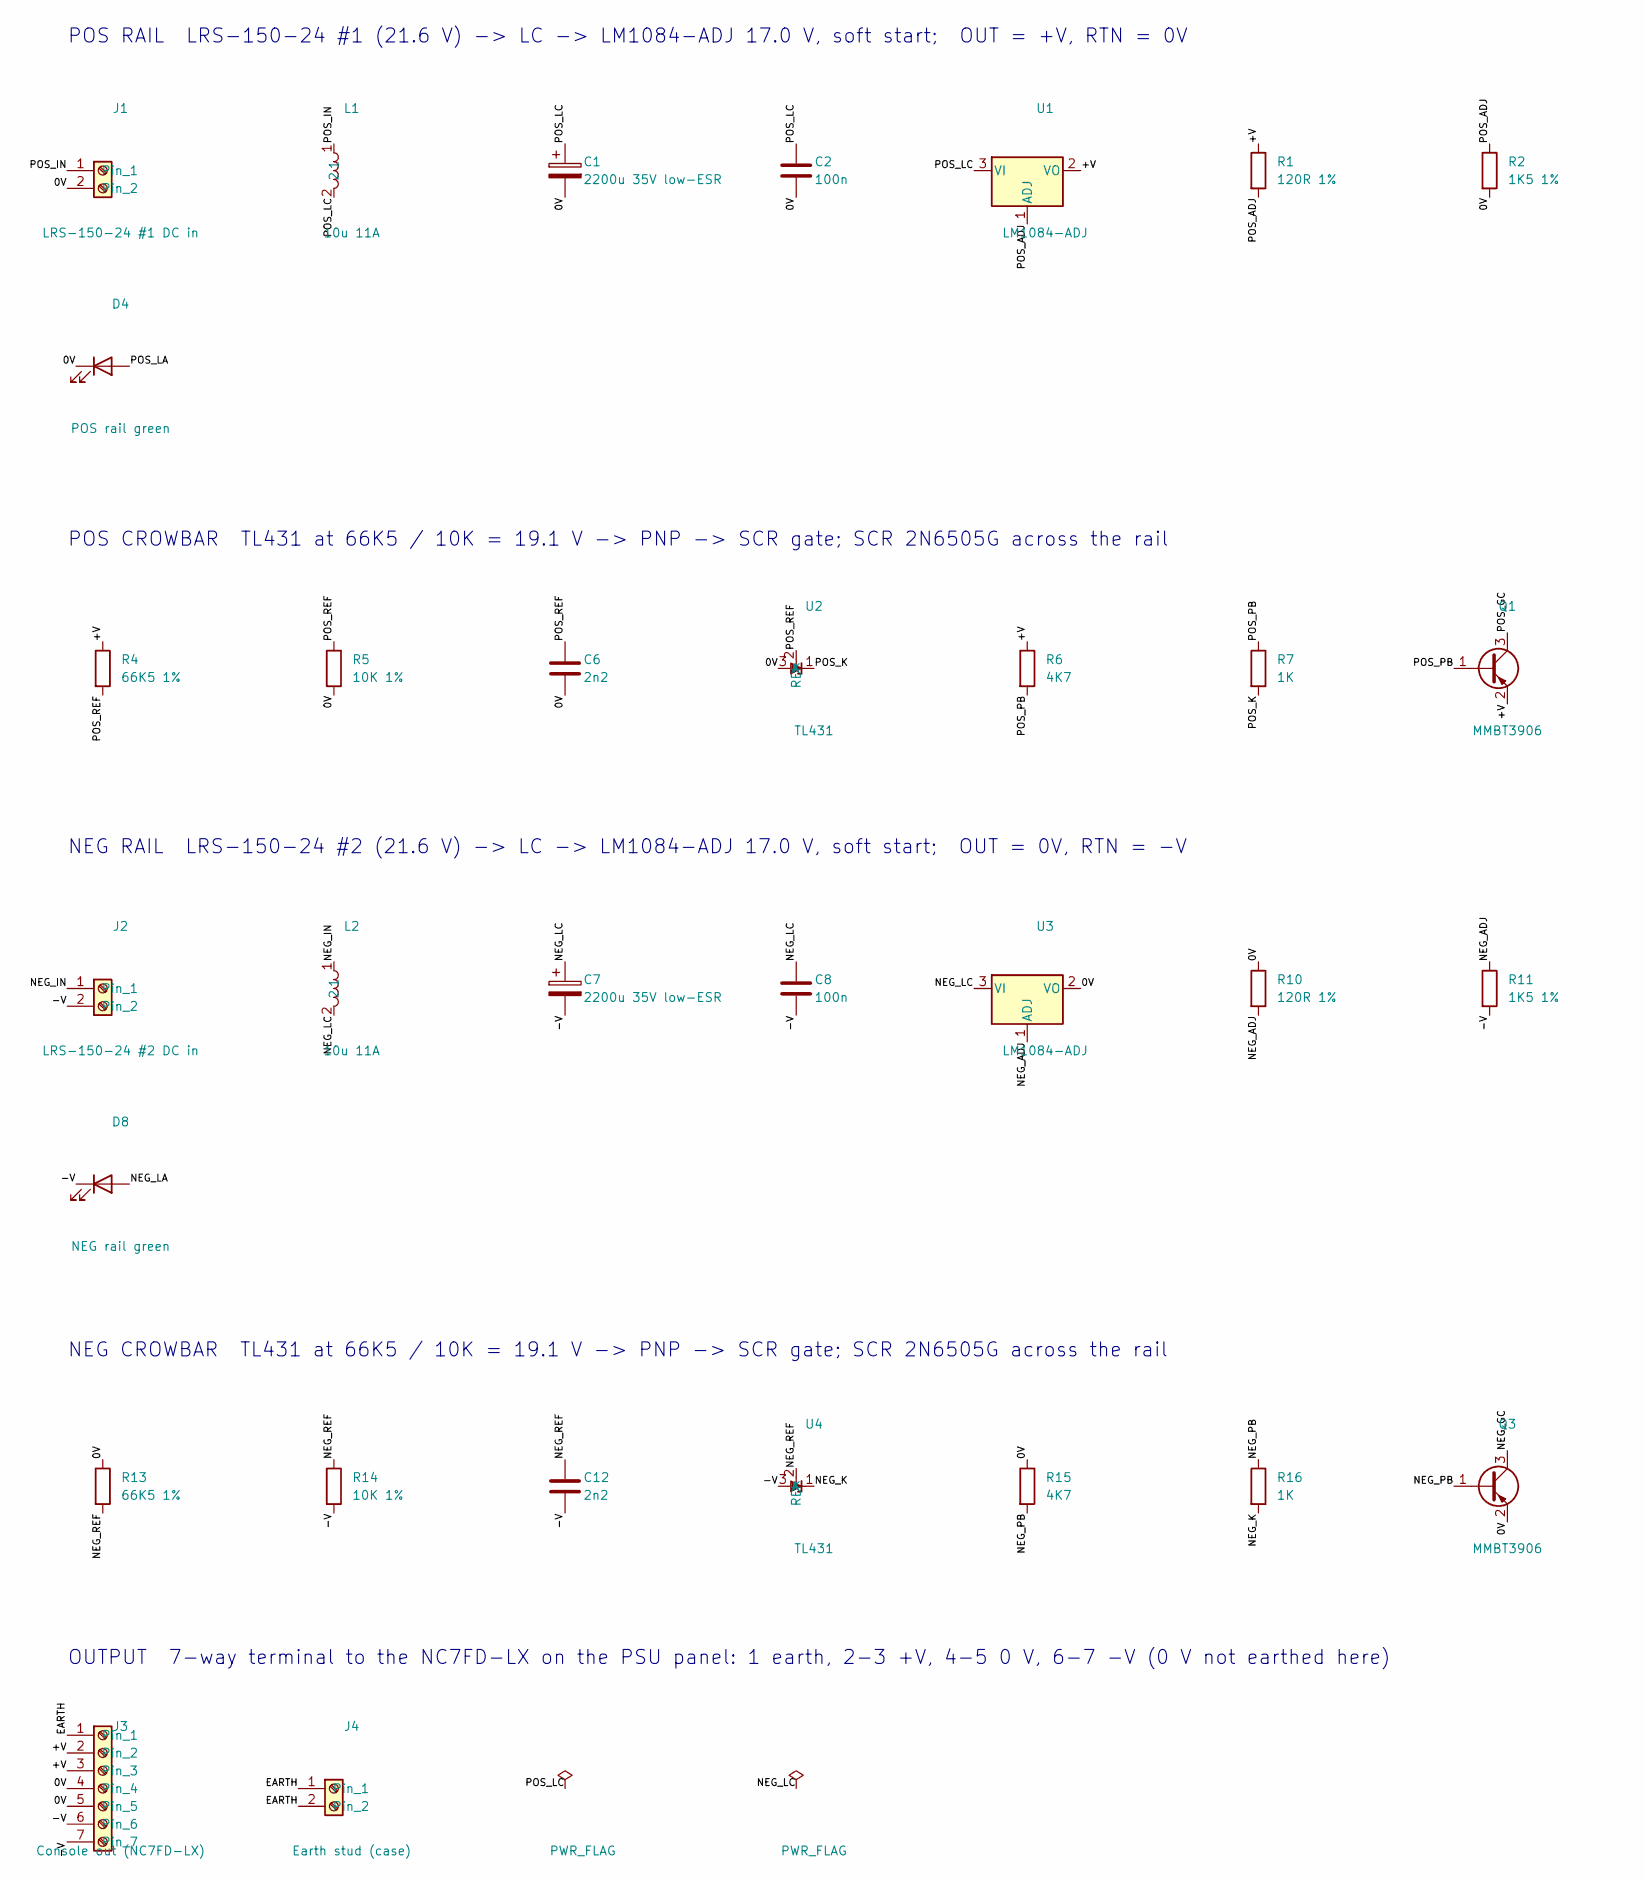
[picture p140: schematic psu.kicad_sch, External PSU regulator board - goa console (+-17 V, 4 A per…, part in row 1, column 1]

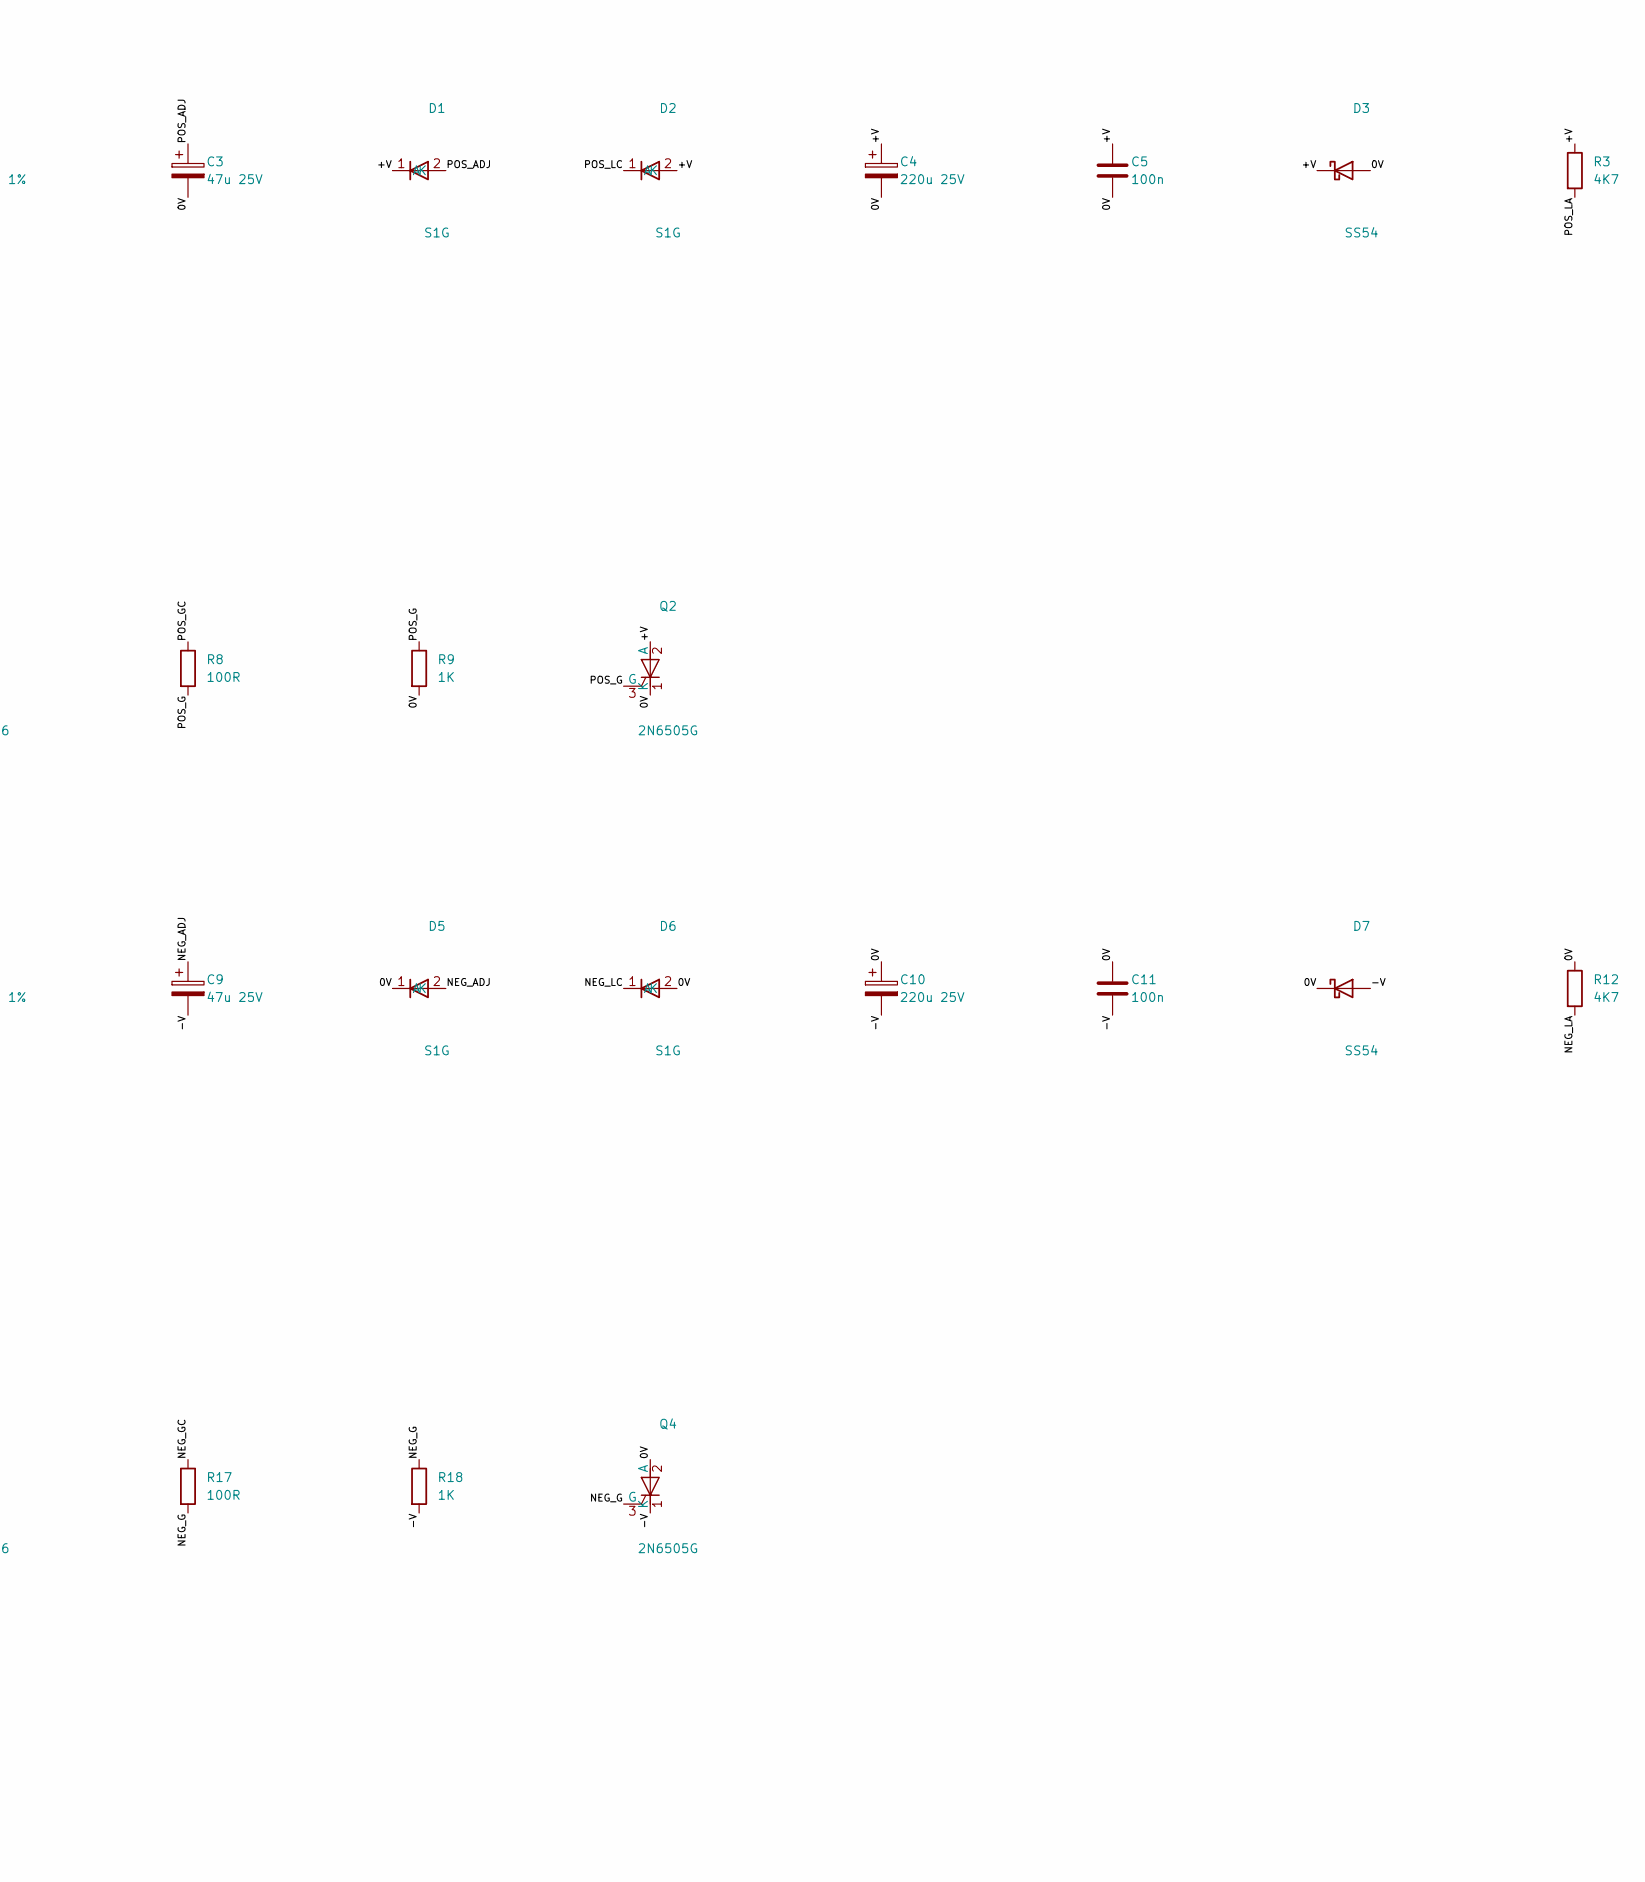
[picture p141: schematic psu.kicad_sch, External PSU regulator board - goa console (+-17 V, 4 A per…, part in row 1, column 2]

Parts:
C1, C7: 2200u 35V low-ESR; CP_Radial_D16.0mm_P7.50mm; MPN Rubycon 35ZLH2200MEFC16X25
C2, C5, C8, C11: 100n; C_0805_2012Metric; MPN Samsung CL21B104KBCNNNC (X7R 50V)
C3, C9: 47u 25V; CP_Radial_D6.3mm_P2.50mm; MPN Rubycon 63ZLH47MEFC6.3X11 (63V)
C4, C10: 220u 25V; CP_Radial_D8.0mm_P3.50mm; MPN Panasonic EEU-FR1E221
C6, C12: 2n2; C_0805_2012Metric; MPN KEMET C0805C222J5GACTU (C0G)
D1, D2, D5, D6: S1G; D_SMA; MPN Diodes S1G-13-F
D3, D7: SS54; D_SMC; MPN Diodes B540C-13-F (SS54 class, SMC 40 V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
D4: POS rail green; LED_D3.0mm; MPN Kingbright WP710A10GD
D8: NEG rail green; LED_D3.0mm; MPN Kingbright WP710A10GD
J1: LRS-150-24 #1 DC in; TerminalBlock_Phoenix_MKDS-1,5-2-5.08_1x02_P5.08mm_Horizont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; MPN Phoenix 1715721 MKDS 1,5/2-5,08
J2: LRS-150-24 #2 DC in; TerminalBlock_Phoenix_MKDS-1,5-2-5.08_1x02_P5.08mm_Horizont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; MPN Phoenix 1715721 MKDS 1,5/2-5,08
J3: Console out (NC7FD-LX); TerminalBlock_Phoenix_MKDS-1,5-7-5.08_1x07_P5.08mm_Horizont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; MPN Phoenix 1755897 MKDS 1,5/7-5,08 (to a N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
J4: Earth stud (case); TerminalBlock_Phoenix_MKDS-1,5-2-5.08_1x02_P5.08mm_Horizont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; MPN Phoenix 1715721 MKDS 1,5/2-5,08
L1, L2: 10u 11A; L_Toroid_Horizontal_D21.8mm_P19.10mm_Bourns_2100; MPN Bourns 2100LL-100-H-RC
Q1, Q3: MMBT3906; SOT-23; MPN onsemi MMBT3906LT1G
Q2, Q4: 2N6505G; TO-220-3_Vertical; MPN onsemi 2N6505G
R1, R10: 120R 1%; R_0805_2012Metric
R2, R11: 1K5 1%; R_1206_3216Metric; MPN Panasonic ERJ-P06F1501V
R3, R6, R12, R15: 4K7; R_0805_2012Metric
R4, R13: 66K5 1%; R_0805_2012Metric
R5, R14: 10K 1%; R_0805_2012Metric
R7, R9, R16, R18: 1K; R_0805_2012Metric
R8, R17: 100R; R_0805_2012Metric
U1, U3: LM1084-ADJ; TO-220-3_Vertical; MPN TI LM1084IT-ADJ/NOPB
U2, U4: TL431; SOT-23; MPN TI TL431AIDBZR

Connections:
/0V: C1.2, C2.2, C3.2, C4.2, C5.2, C6.2, C10.1, C11.1, D3.2 (A), D4.1 (K), D5.1 (K), D6.2 (A), D7.1 (K), J1.2, J3.4, J3.5, Q2.1 (K), Q3.2 (E), Q4.2 (A), R2.2, R5.2, R9.2, R10.1, R12.1, R13.1, R15.1, U2.3 (A), U3.2 (VO)
/+V: C4.1, C5.1, D1.1 (K), D2.2 (A), D3.1 (K), J3.2, J3.3, Q1.2 (E), Q2.2 (A), R1.1, R3.1, R4.1, R6.1, U1.2 (VO)
/-V: C7.2, C8.2, C9.2, C10.2, C11.2, C12.2, D7.2 (A), D8.1 (K), J2.2, J3.6, J3.7, Q4.1 (K), R11.2, R14.2, R18.2, U4.3 (A)
/EARTH: J3.1, J4.1, J4.2
/NEG_ADJ: C9.1, D5.2 (A), R10.2, R11.1, U3.1 (ADJ)
/NEG_G: Q4.3 (G), R17.2, R18.1
/NEG_GC: Q3.3 (C), R17.1
/NEG_IN: J2.1, L2.1
/NEG_K: R16.2, U4.1 (K)
/NEG_LA: D8.2 (A), R12.2
/NEG_LC: C7.1, C8.1, D6.1 (K), L2.2, U3.3 (VI)
/NEG_PB: Q3.1 (B), R15.2, R16.1
/NEG_REF: C12.1, R13.2, R14.1, U4.2 (REF)
/POS_ADJ: C3.1, D1.2 (A), R1.2, R2.1, U1.1 (ADJ)
/POS_G: Q2.3 (G), R8.2, R9.1
/POS_GC: Q1.3 (C), R8.1
/POS_IN: J1.1, L1.1
/POS_K: R7.2, U2.1 (K)
/POS_LA: D4.2 (A), R3.2
/POS_LC: C1.1, C2.1, D2.1 (K), L1.2, U1.3 (VI)
/POS_PB: Q1.1 (B), R6.2, R7.1
/POS_REF: C6.1, R4.2, R5.1, U2.2 (REF)

Notes on the sheet:
POS RAIL LRS-150-24 #1 (21.6 V) -> LC -> LM1084-ADJ 17.0 V, soft start; OUT = +V, RTN = 0V
POS CROWBAR TL431 at 66K5 / 10K = 19.1 V -> PNP -> SCR gate; SCR 2N6505G across the rail
NEG RAIL LRS-150-24 #2 (21.6 V) -> LC -> LM1084-ADJ 17.0 V, soft start; OUT = 0V, RTN = -V
NEG CROWBAR TL431 at 66K5 / 10K = 19.1 V -> PNP -> SCR gate; SCR 2N6505G across the rail
OUTPUT 7-way terminal to the NC7FD-LX on the PSU panel: 1 earth, 2-3 +V, 4-5 0 V, 6-7 -V (0 V not earthed here)

Board: 2 copper layers, 56 parts (0 on the bottom side), 22 nets, no tracks yet.

Other parts of the board:
H1, H2, H3, H4: M3 standoff; MountingHole_3.2mm_M3
