cozycactus/goa-console/boards/channel_strip/channel_strip.kicad_pcb

## KiCad design boards/channel_strip/channel_strip.kicad_pcb (2026-11-09)

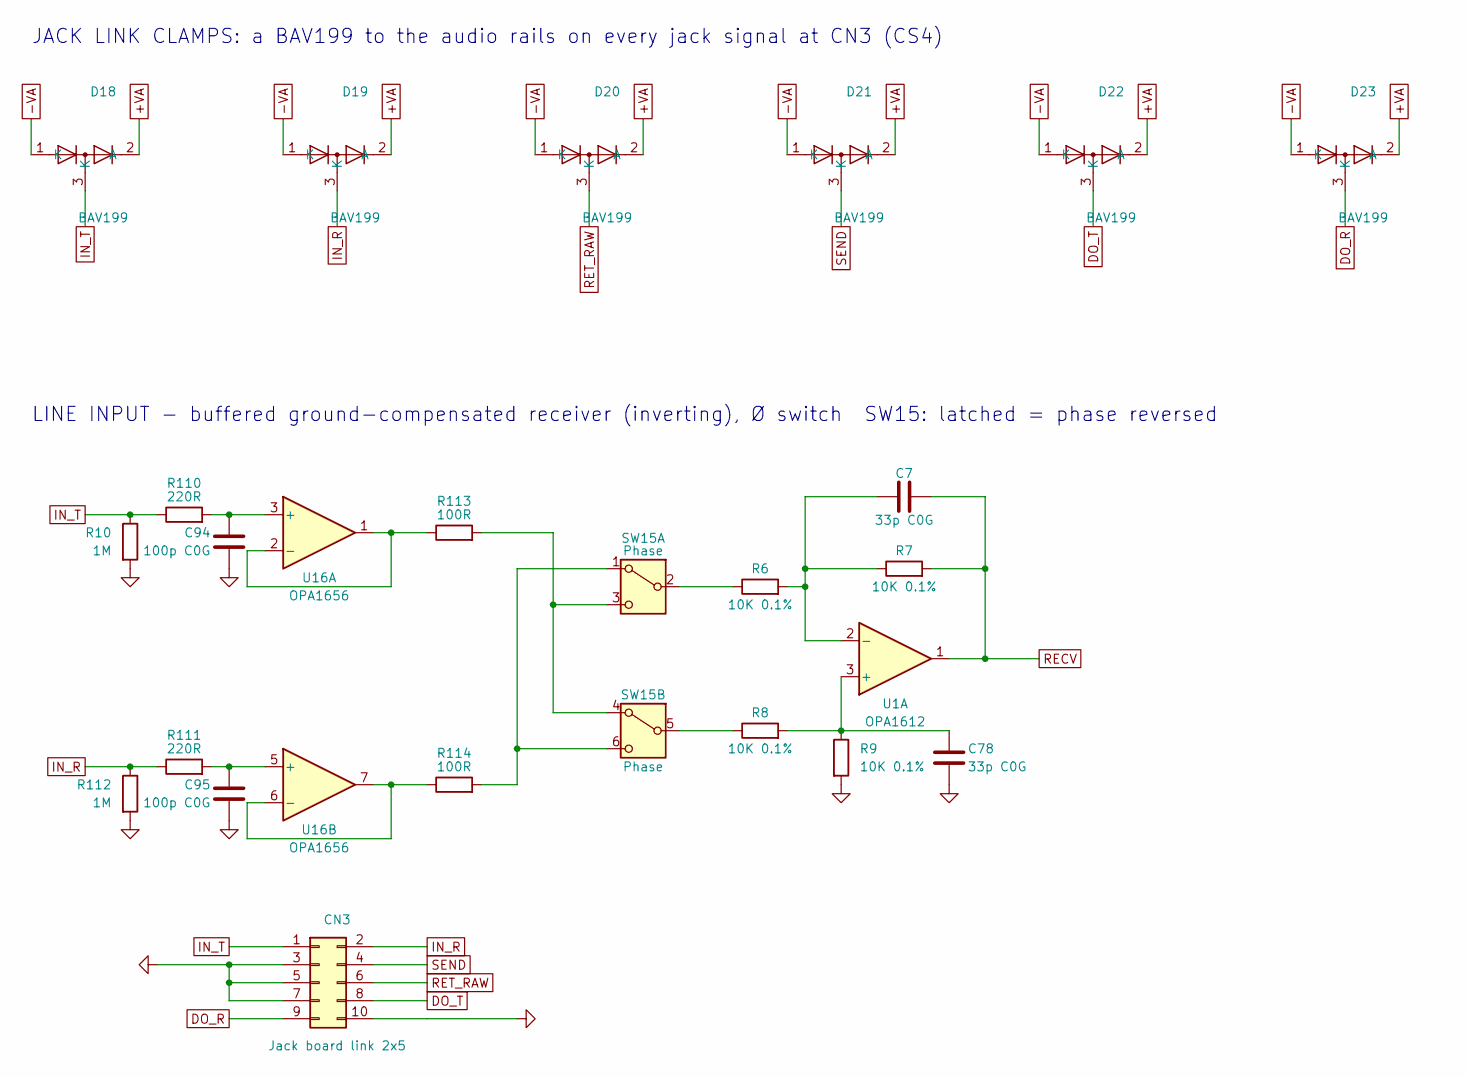
[picture p142: schematic 02_jack_link_clamps.kicad_sch, JACK LINK CLAMPS, LINE INPUT]

Parts:
C7: 33p C0G; C_0805_2012Metric; MPN KEMET C0805C330J5GACTU
C78: 33p C0G; C_1206_3216Metric; MPN KEMET C1206C330J5GACTU
C94, C95: 100p C0G; C_0805_2012Metric; MPN KEMET C0805C101J5GACTU
CN3: Jack board link 2x5; IDC-Header_2x05_P2.54mm_Vertical; MPN Wurth 61201021621 (2x5 box header)
D18, D19, D20, D21, D22, D23: BAV199; SOT-23; MPN Nexperia BAV199,215
R6, R7, R8, R9: 10K 0.1%; R_0805_2012Metric; MPN Panasonic ERA-6AEB103V
R10, R112: 1M; R_0805_2012Metric
R110, R111: 220R; R_0805_2012Metric
R113, R114: 100R; R_0805_2012Metric
SW15: Phase; SW_Push_2P2T_Toggle_CK_PVA2xxH1xxxxxxV2; MPN C&K PVA2 EE H1 1.7N V2
U1: OPA1612; SOIC-8_3.9x4.9mm_P1.27mm; MPN TI OPA1612AIDR
U16: OPA1656; SOIC-8_3.9x4.9mm_P1.27mm; MPN TI OPA1656IDR

Connections:
+VA: D18.2 (A), D19.2 (A), D20.2 (A), D21.2 (A), D22.2 (A), D23.2 (A); also elsewhere on the board
-VA: D18.1 (K), D19.1 (K), D20.1 (K), D21.1 (K), D22.1 (K), D23.1 (K); also elsewhere on the board
DO_R: CN3.9, D23.3 (K); also elsewhere on the board
DO_T: CN3.8, D22.3 (K); also elsewhere on the board
GNDA: C78.2, C94.2, C95.2, CN3.3, CN3.5, CN3.7, CN3.10, R9.2, R10.2, R112.2; also elsewhere on the board
IN_R: CN3.2, D19.3 (K), R111.1, R112.1
IN_T: CN3.1, D18.3 (K), R10.1, R110.1
unnamed: R114.2, SW15.1 (A), SW15.6 (C)
unnamed: R6.1, SW15.2 (B)
unnamed: R113.2, SW15.3 (C), SW15.4 (A)
unnamed: R8.1, SW15.5 (B)
unnamed: C78.1, R8.2, R9.1, U1.3 (+)
unnamed: C7.1, R6.2, R7.1, U1.2 (-)
unnamed: C94.1, R110.2, U16.3 (+)
unnamed: R113.1, U16.1, U16.2 (-)
unnamed: C95.1, R111.2, U16.5 (+)
unnamed: R114.1, U16.6 (-), U16.7
RECV: C7.2, R7.2, U1.1; also elsewhere on the board
RET_RAW: CN3.6, D20.3 (K); also elsewhere on the board
SEND: CN3.4, D21.3 (K); also elsewhere on the board

Notes on the sheet:
JACK LINK CLAMPS: a BAV199 to the audio rails on every jack signal at CN3 (CS4)
LINE INPUT - buffered ground-compensated receiver (inverting), Ø switch SW15: latched = phase reversed

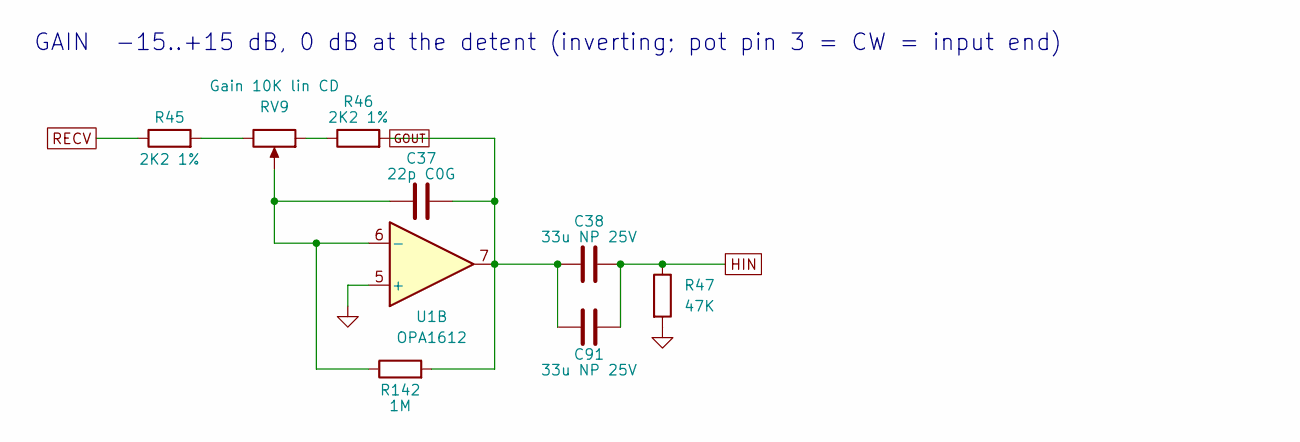
[picture p143: schematic 03_gain.kicad_sch, GAIN]

Parts:
C37: 22p C0G; C_0805_2012Metric; MPN KEMET C0805C220J5GACTU
C38, C91: 33u NP 25V; CP_Radial_D8.0mm_P3.50mm; MPN Nichicon UES1E330MPM (MUSE ES)
R45, R46: 2K2 1%; R_0805_2012Metric
R47: 47K; R_0805_2012Metric
R142: 1M; R_0805_2012Metric
RV9: Gain 10K lin CD; Potentiometer_Alpha_RD901F-40-00D_Single_Vertical; MPN Alpha RD901F-40-15R1-B10K-0CD (centre d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
U1: OPA1612; SOIC-8_3.9x4.9mm_P1.27mm; MPN TI OPA1612AIDR

Connections:
GNDA: R47.2, U1.5 (+); also elsewhere on the board
GOUT: C37.1, C38.1, C91.1, R46.2, R142.2, U1.7; also elsewhere on the board
HIN: C38.2, C91.2, R47.1; also elsewhere on the board
unnamed: R45.2, RV9.3
unnamed: R46.1, RV9.1
unnamed: C37.2, R142.1, RV9.2, U1.6 (-)
RECV: R45.1; also elsewhere on the board

Notes on the sheet:
GAIN -15..+15 dB, 0 dB at the detent (inverting; pot pin 3 = CW = input end)

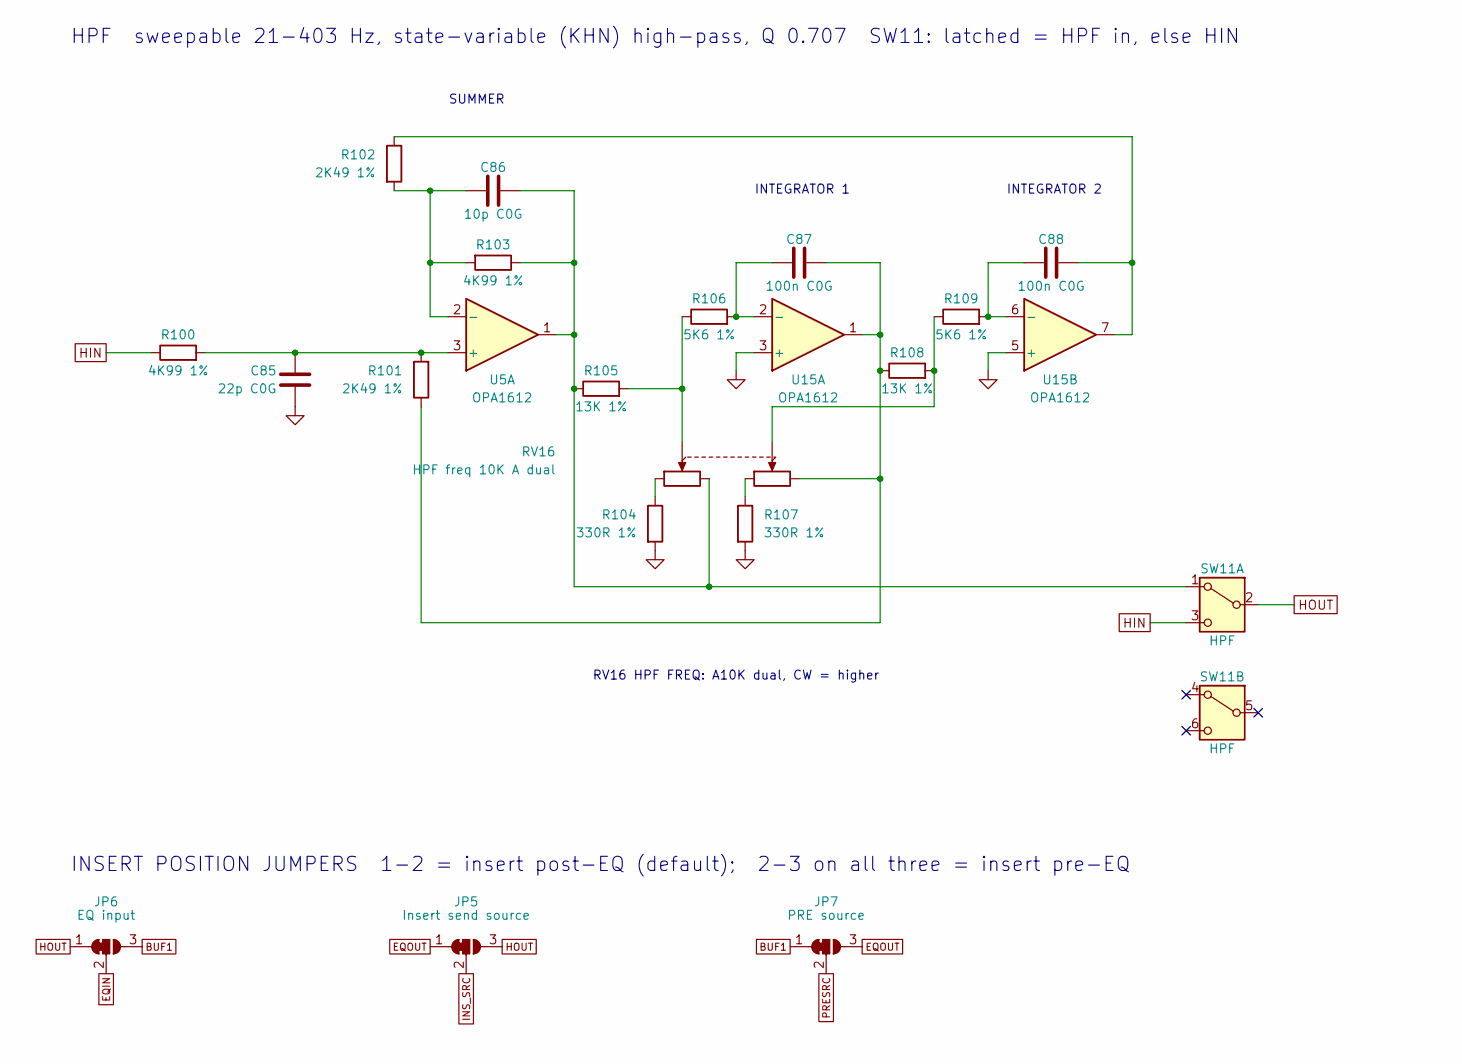
[picture p144: schematic 04_hpf.kicad_sch, HPF, INSERT POSITION JUMPERS]

Parts:
C85: 22p C0G; C_1206_3216Metric; MPN KEMET C1206C220J5GACTU
C86: 10p C0G; C_1206_3216Metric; MPN KEMET C1206C100J5GACTU
C87, C88: 100n C0G; C_1206_3216Metric; MPN Murata GRM31C5C1H104JA01L
JP5: Insert send source; SolderJumper-3_P1.3mm_Bridged12_RoundedPad1.0x1.5mm
JP6: EQ input; SolderJumper-3_P1.3mm_Bridged12_RoundedPad1.0x1.5mm
JP7: PRE source; SolderJumper-3_P1.3mm_Bridged12_RoundedPad1.0x1.5mm
R100, R103: 4K99 1%; R_0805_2012Metric
R101, R102: 2K49 1%; R_0805_2012Metric
R104, R107: 330R 1%; R_0805_2012Metric
R105, R108: 13K 1%; R_0805_2012Metric
R106, R109: 5K6 1%; R_0805_2012Metric
RV16: HPF freq 10K A dual; Potentiometer_Alpha_RD902F-40-00D_Dual_Vertical; MPN Alpha RD902F-40-15R1-A10K (dual, log)
SW11: HPF; SW_Push_2P2T_Toggle_CK_PVA2xxH1xxxxxxV2; MPN C&K PVA2 EE H1 1.7N V2
U5, U15: OPA1612; SOIC-8_3.9x4.9mm_P1.27mm; MPN TI OPA1612AIDR

Connections:
BUF1: JP6.3 (B), JP7.1 (A); also elsewhere on the board
EQIN: JP6.2 (C); also elsewhere on the board
EQOUT: JP5.1 (A), JP7.3 (B); also elsewhere on the board
GNDA: C85.2, R104.2, R107.2, U15.3 (+), U15.5 (+); also elsewhere on the board
HIN: R100.1, SW11.3 (C); also elsewhere on the board
HOUT: JP5.3 (B), JP6.1 (A), SW11.2 (B); also elsewhere on the board
INS_SRC: JP5.2 (C); also elsewhere on the board
unnamed: C87.1, R101.1, R108.1, RV16.6, U15.1
unnamed: C88.1, R102.1, U15.7
unnamed: R104.1, RV16.1
unnamed: R105.2, R106.1, RV16.2
unnamed: R107.1, RV16.4
unnamed: R108.2, R109.1, RV16.5
unnamed: C86.1, R103.1, R105.1, RV16.3, SW11.1 (A), U5.1
unnamed: C85.1, R100.2, R101.2, U5.3 (+)
unnamed: C86.2, R102.2, R103.2, U5.2 (-)
unnamed: C87.2, R106.2, U15.2 (-)
unnamed: C88.2, R109.2, U15.6 (-)
PRESRC: JP7.2 (C); also elsewhere on the board

Notes on the sheet:
HPF sweepable 21-403 Hz, state-variable (KHN) high-pass, Q 0.707 SW11: latched = HPF in, else HIN
SUMMER
INTEGRATOR 1
INTEGRATOR 2
RV16 HPF FREQ: A10K dual, CW = higher
INSERT POSITION JUMPERS 1-2 = insert post-EQ (default); 2-3 on all three = insert pre-EQ

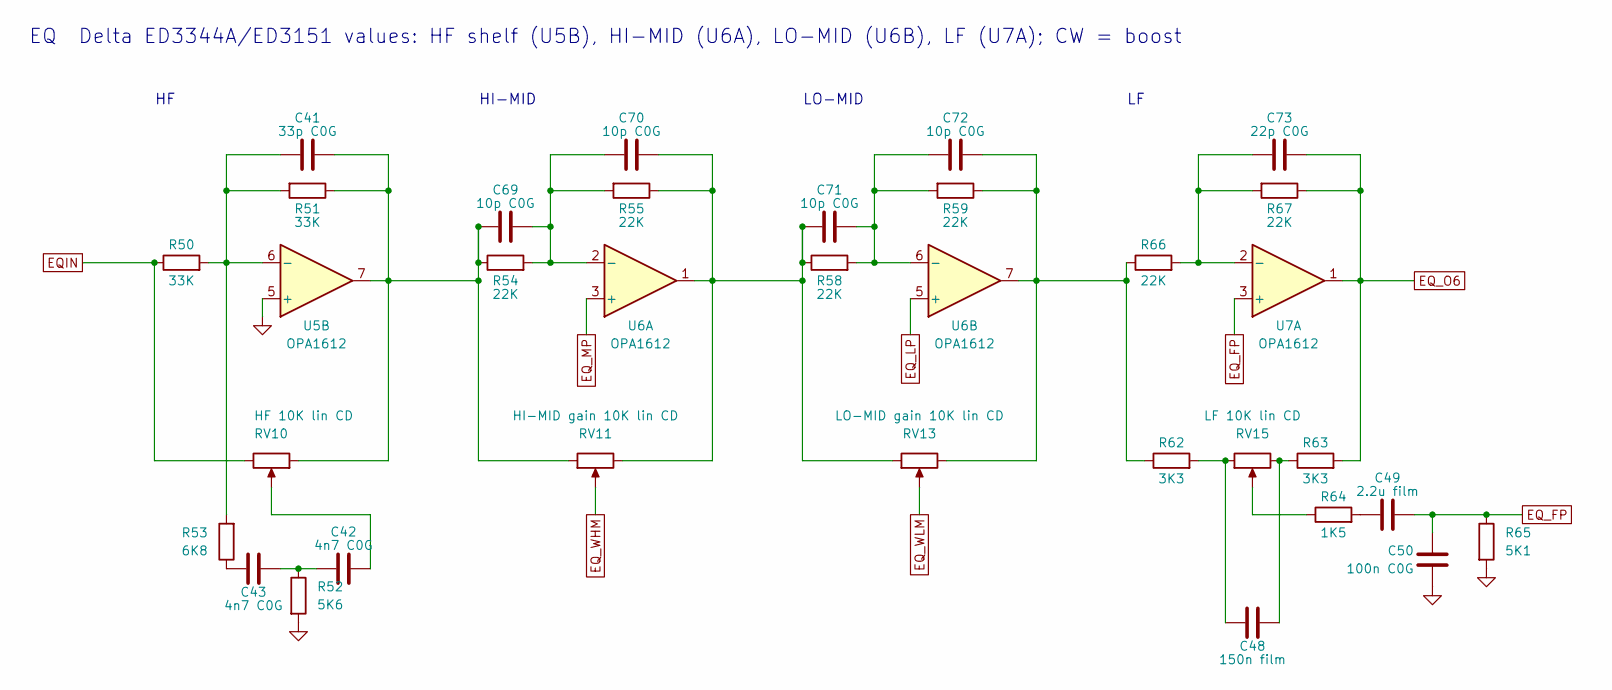
[picture p145: schematic 05_eq.kicad_sch, EQ]

Parts:
C41: 33p C0G; C_0805_2012Metric; MPN KEMET C0805C330J5GACTU
C42, C43: 4n7 C0G; C_1206_3216Metric; MPN KEMET C1206C472J5GACTU
C48: 150n film; C_Rect_L7.2mm_W4.5mm_P5.00mm_FKS2_FKP2_MKS2_MKP2; MPN WIMA MKS2D031501C00KSSD (PET 100V; 3.5 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
C49: 2.2u film; C_Rect_L7.2mm_W7.2mm_P5.00mm_FKS2_FKP2_MKS2_MKP2; MPN KEMET MMK5225K63J06L4BULK (PET 63V; rep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
C50: 100n C0G; C_1206_3216Metric; MPN Murata GRM31C5C1H104JA01L
C69, C70, C71, C72: 10p C0G; C_1206_3216Metric; MPN KEMET C1206C100J5GACTU
C73: 22p C0G; C_1206_3216Metric; MPN KEMET C1206C220J5GACTU
R50, R51: 33K; R_0805_2012Metric
R52: 5K6; R_0805_2012Metric
R53: 6K8; R_0805_2012Metric
R54, R55, R58, R59, R66, R67: 22K; R_0805_2012Metric
R62, R63: 3K3; R_0805_2012Metric
R64: 1K5; R_0805_2012Metric
R65: 5K1; R_0805_2012Metric
RV10: HF 10K lin CD; Potentiometer_Alpha_RD901F-40-00D_Single_Vertical; MPN Alpha RD901F-40-15R1-B10K-0CD (centre d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
RV11: HI-MID gain 10K lin CD; Potentiometer_Alpha_RD901F-40-00D_Single_Vertical; MPN Alpha RD901F-40-15R1-B10K-0CD (centre d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
RV13: LO-MID gain 10K lin CD; Potentiometer_Alpha_RD901F-40-00D_Single_Vertical; MPN Alpha RD901F-40-15R1-B10K-0CD (centre d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
RV15: LF 10K lin CD; Potentiometer_Alpha_RD901F-40-00D_Single_Vertical; MPN Alpha RD901F-40-15R1-B10K-0CD (centre d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
U5, U6, U7: OPA1612; SOIC-8_3.9x4.9mm_P1.27mm; MPN TI OPA1612AIDR

Connections:
EQIN: R50.1, RV10.3; also elsewhere on the board
EQ_FP: C49.2, C50.1, R65.1, U7.3 (+)
EQ_LP: U6.5 (+); also elsewhere on the board
EQ_MP: U6.3 (+); also elsewhere on the board
EQ_O6: C73.1, R63.2, R67.1, U7.1; also elsewhere on the board
EQ_WHM: RV11.2; also elsewhere on the board
EQ_WLM: RV13.2; also elsewhere on the board
GNDA: C50.2, R52.2, R65.2, U5.5 (+); also elsewhere on the board
unnamed: C41.1, C69.1, R51.1, R54.1, RV10.1, RV11.1, U5.7
unnamed: C42.1, RV10.2
unnamed: C42.2, C43.1, R52.1
unnamed: C43.2, R53.1
unnamed: C48.1, R62.2, RV15.1
unnamed: C48.2, R63.1, RV15.3
unnamed: C49.1, R64.2
unnamed: C70.1, C71.1, R55.1, R58.1, RV11.3, RV13.1, U6.1
unnamed: C72.1, R59.1, R62.1, R66.1, RV13.3, U6.7
unnamed: R64.1, RV15.2
unnamed: C41.2, R50.2, R51.2, R53.2, U5.6 (-)
unnamed: C69.2, C70.2, R54.2, R55.2, U6.2 (-)
unnamed: C71.2, C72.2, R58.2, R59.2, U6.6 (-)
unnamed: C73.2, R66.2, R67.2, U7.2 (-)

Notes on the sheet:
EQ Delta ED3344A/ED3151 values: HF shelf (U5B), HI-MID (U6A), LO-MID (U6B), LF (U7A); CW = boost
HI-MID
LO-MID

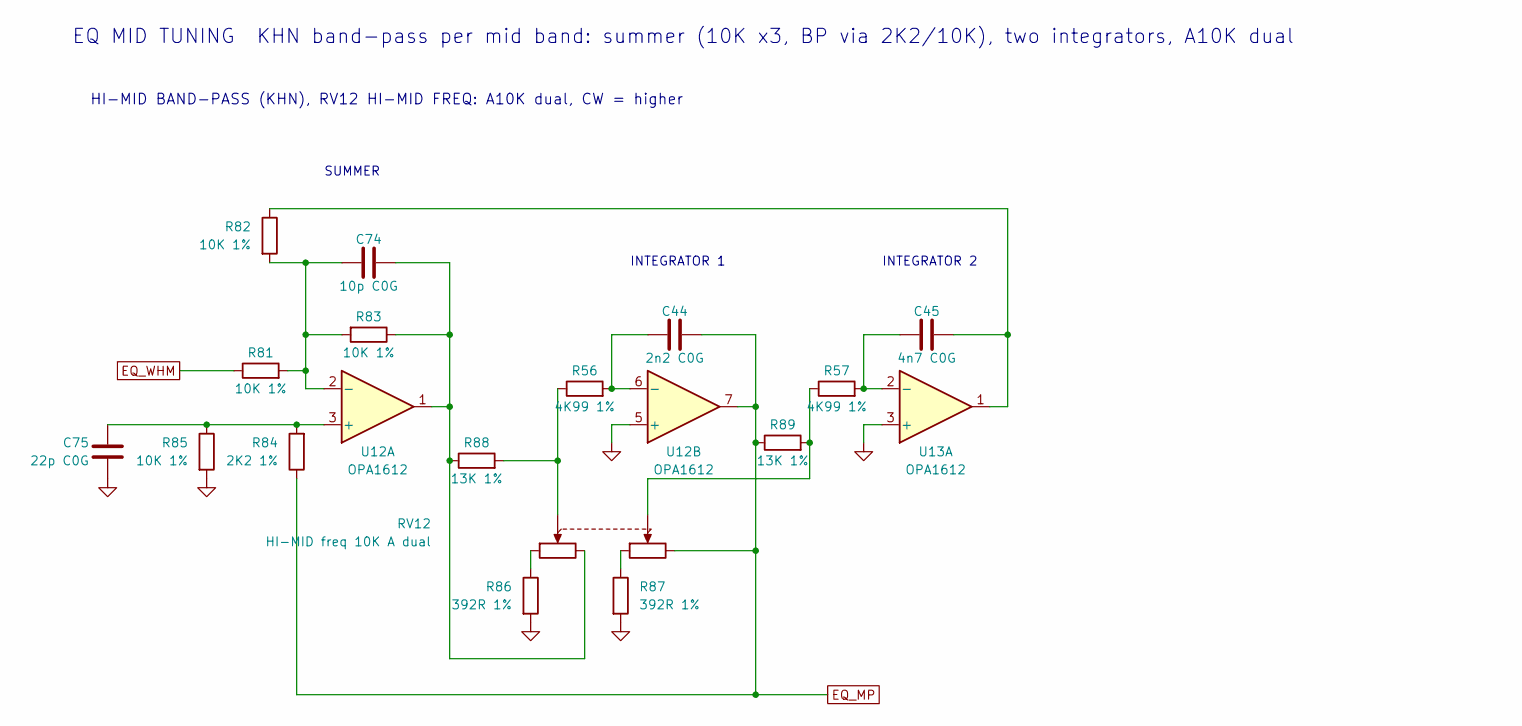
[picture p146: schematic 06_eq_mid_tuning.kicad_sch, EQ MID TUNING]

Parts:
C44: 2n2 C0G; C_1206_3216Metric; MPN KEMET C1206C222J5GACTU
C45: 4n7 C0G; C_1206_3216Metric; MPN KEMET C1206C472J5GACTU
C74: 10p C0G; C_1206_3216Metric; MPN KEMET C1206C100J5GACTU
C75: 22p C0G; C_1206_3216Metric; MPN KEMET C1206C220J5GACTU
R56, R57: 4K99 1%; R_0805_2012Metric
R81, R82, R83, R85: 10K 1%; R_0805_2012Metric
R84: 2K2 1%; R_0805_2012Metric
R86, R87: 392R 1%; R_0805_2012Metric
R88, R89: 13K 1%; R_0805_2012Metric
RV12: HI-MID freq 10K A dual; Potentiometer_Alpha_RD902F-40-00D_Dual_Vertical; MPN Alpha RD902F-40-15R1-A10K (dual, log)
U12, U13: OPA1612; SOIC-8_3.9x4.9mm_P1.27mm; MPN TI OPA1612AIDR

Connections:
EQ_MP: C44.1, R84.1, R89.1, RV12.6, U12.7; also elsewhere on the board
EQ_WHM: R81.1; also elsewhere on the board
GNDA: C75.2, R85.2, R86.2, R87.2, U12.5 (+), U13.3 (+); also elsewhere on the board
unnamed: C45.1, R82.1, U13.1
unnamed: C74.1, R83.1, R88.1, RV12.3, U12.1
unnamed: R56.1, R88.2, RV12.2
unnamed: R57.1, R89.2, RV12.5
unnamed: R86.1, RV12.1
unnamed: R87.1, RV12.4
unnamed: C75.1, R84.2, R85.1, U12.3 (+)
unnamed: C74.2, R81.2, R82.2, R83.2, U12.2 (-)
unnamed: C44.2, R56.2, U12.6 (-)
unnamed: C45.2, R57.2, U13.2 (-)

Notes on the sheet:
EQ MID TUNING KHN band-pass per mid band: summer (10K x3, BP via 2K2/10K), two integrators, A10K dual
SUMMER
INTEGRATOR 1
INTEGRATOR 2
HI-MID BAND-PASS (KHN), RV12 HI-MID FREQ: A10K dual, CW = higher

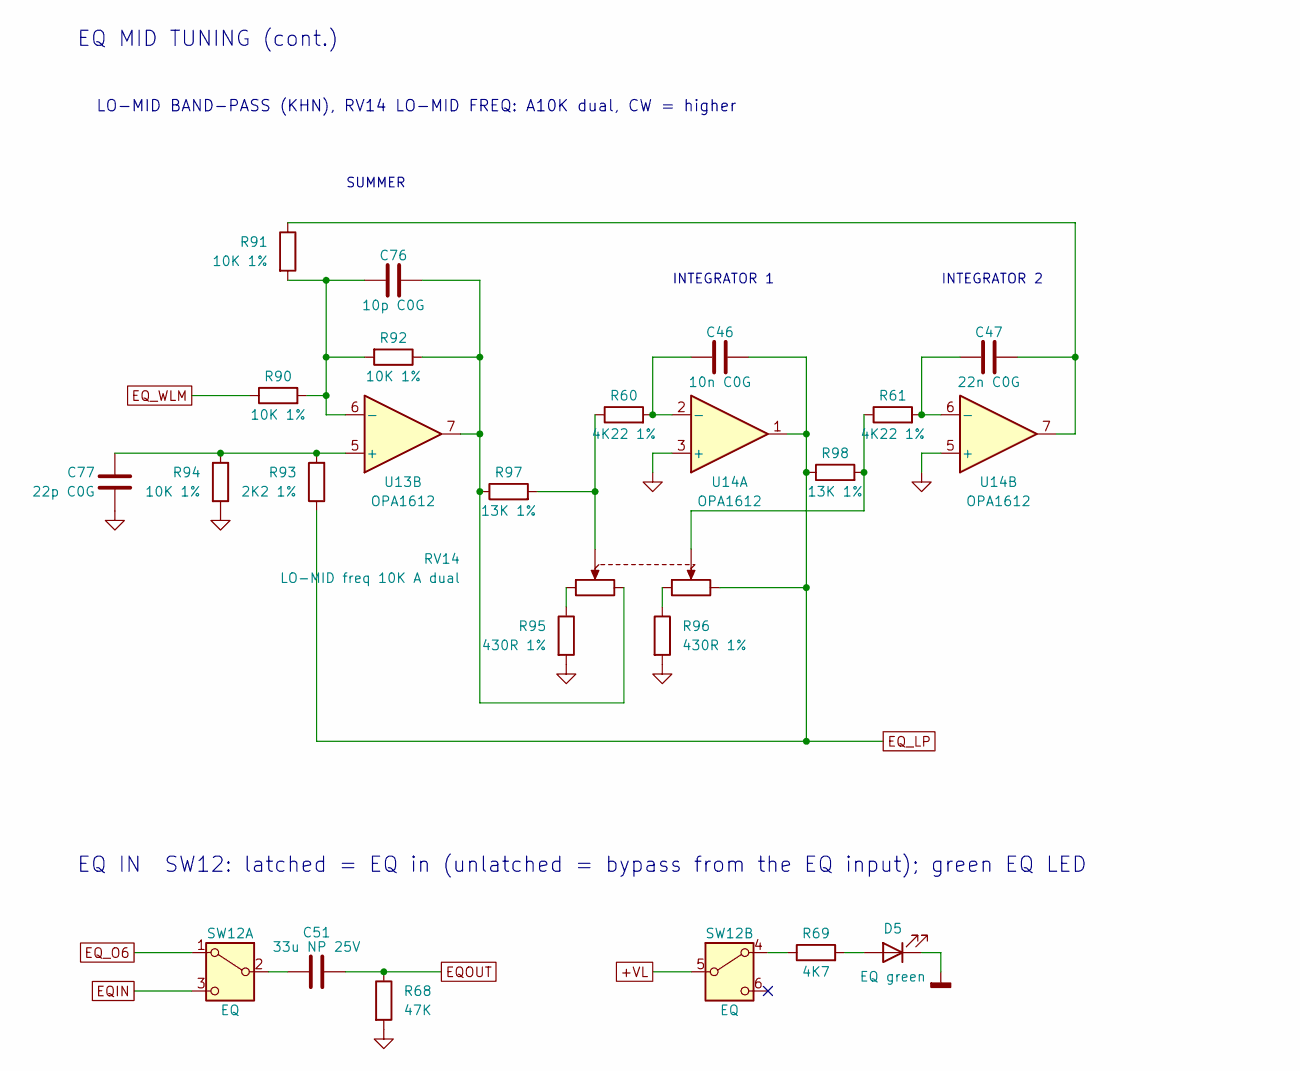
[picture p147: schematic 07_eq_mid_tuning.kicad_sch, EQ MID TUNING, EQ IN]

Parts:
C46: 10n C0G; C_1206_3216Metric; MPN KEMET C1206C103J5GACTU
C47: 22n C0G; C_1206_3216Metric; MPN KEMET C1206C223J5GACTU
C51: 33u NP 25V; CP_Radial_D8.0mm_P3.50mm; MPN Nichicon UES1E330MPM (MUSE ES)
C76: 10p C0G; C_1206_3216Metric; MPN KEMET C1206C100J5GACTU
C77: 22p C0G; C_1206_3216Metric; MPN KEMET C1206C220J5GACTU
D5: EQ green; LED_D3.0mm; MPN Kingbright WP710A10GD
R60, R61: 4K22 1%; R_0805_2012Metric
R68: 47K; R_0805_2012Metric
R69: 4K7; R_0805_2012Metric
R90, R91, R92, R94: 10K 1%; R_0805_2012Metric
R93: 2K2 1%; R_0805_2012Metric
R95, R96: 430R 1%; R_0805_2012Metric
R97, R98: 13K 1%; R_0805_2012Metric
RV14: LO-MID freq 10K A dual; Potentiometer_Alpha_RD902F-40-00D_Dual_Vertical; MPN Alpha RD902F-40-15R1-A10K (dual, log)
SW12: EQ; SW_Push_2P2T_Toggle_CK_PVA2xxH1xxxxxxV2; MPN C&K PVA2 EE H1 1.7N V2
U13, U14: OPA1612; SOIC-8_3.9x4.9mm_P1.27mm; MPN TI OPA1612AIDR

Connections:
+VL: SW12.5 (B); also elsewhere on the board
EQIN: SW12.3 (C); also elsewhere on the board
EQOUT: C51.2, R68.1; also elsewhere on the board
EQ_LP: C46.1, R93.1, R98.1, RV14.6, U14.1; also elsewhere on the board
EQ_O6: SW12.1 (A); also elsewhere on the board
EQ_WLM: R90.1; also elsewhere on the board
GNDA: C77.2, R68.2, R94.2, R95.2, R96.2, U14.3 (+), U14.5 (+); also elsewhere on the board
GNDD: D5.1 (K); also elsewhere on the board
unnamed: C47.1, R91.1, U14.7
unnamed: C76.1, R92.1, R97.1, RV14.3, U13.7
unnamed: D5.2 (A), R69.2
unnamed: R60.1, R97.2, RV14.2
unnamed: R61.1, R98.2, RV14.5
unnamed: R95.1, RV14.1
unnamed: R96.1, RV14.4
unnamed: C51.1, SW12.2 (B)
unnamed: R69.1, SW12.4 (A)
unnamed: C77.1, R93.2, R94.1, U13.5 (+)
unnamed: C76.2, R90.2, R91.2, R92.2, U13.6 (-)
unnamed: C46.2, R60.2, U14.2 (-)
unnamed: C47.2, R61.2, U14.6 (-)

Notes on the sheet:
EQ MID TUNING (cont.)
SUMMER
INTEGRATOR 1
INTEGRATOR 2
LO-MID BAND-PASS (KHN), RV14 LO-MID FREQ: A10K dual, CW = higher
EQ IN SW12: latched = EQ in (unlatched = bypass from the EQ input); green EQ LED
