cozycactus/goa-console/boards/channel_strip/channel_strip.kicad_pcb

## KiCad design boards/channel_strip/channel_strip.kicad_pcb (continued)

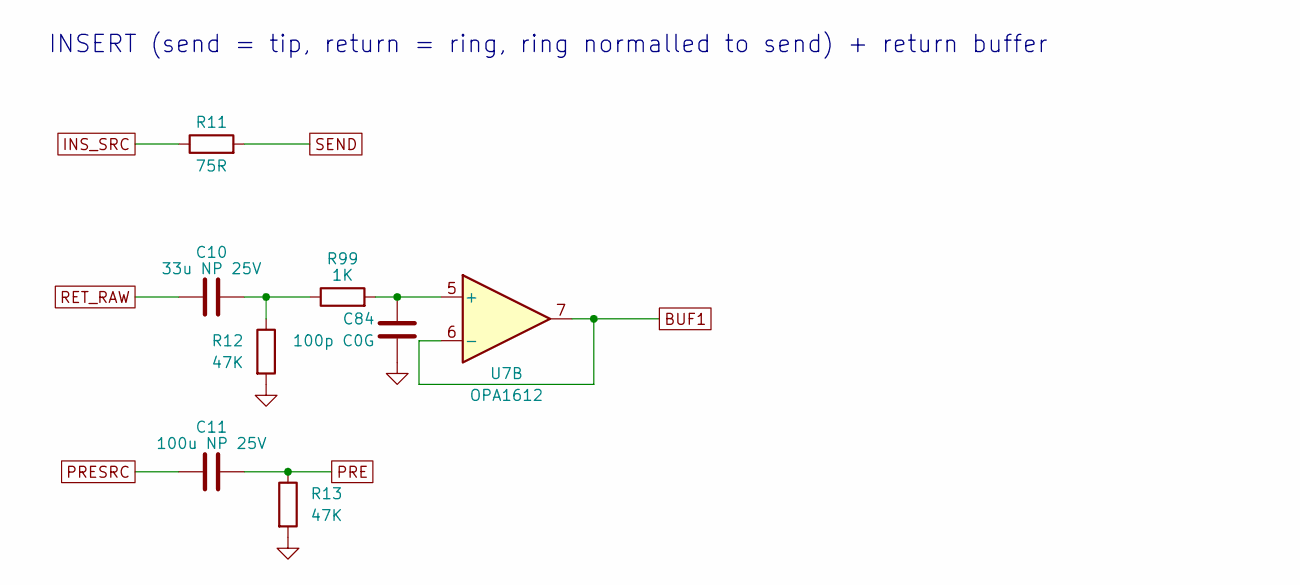
[picture p148: schematic 08_insert.kicad_sch, INSERT]

Parts:
C10: 33u NP 25V; CP_Radial_D8.0mm_P3.50mm; MPN Nichicon UES1E330MPM (MUSE ES)
C11: 100u NP 25V; CP_Radial_D10.0mm_P5.00mm; MPN Nichicon UES1E101MPM (MUSE ES)
C84: 100p C0G; C_1206_3216Metric; MPN KEMET C1206C101J5GACTU
R11: 75R; R_0805_2012Metric; MPN Panasonic ERJ-P06J750V
R12, R13: 47K; R_0805_2012Metric
R99: 1K; R_0805_2012Metric
U7: OPA1612; SOIC-8_3.9x4.9mm_P1.27mm; MPN TI OPA1612AIDR

Connections:
BUF1: U7.6 (-), U7.7; also elsewhere on the board
GNDA: C84.2, R12.2, R13.2; also elsewhere on the board
INS_SRC: R11.1; also elsewhere on the board
unnamed: C10.2, R12.1, R99.1
unnamed: C84.1, R99.2, U7.5 (+)
PRE: C11.2, R13.1; also elsewhere on the board
PRESRC: C11.1; also elsewhere on the board
RET_RAW: C10.1; also elsewhere on the board
SEND: R11.2; also elsewhere on the board

Notes on the sheet:
INSERT (send = tip, return = ring, ring normalled to send) + return buffer

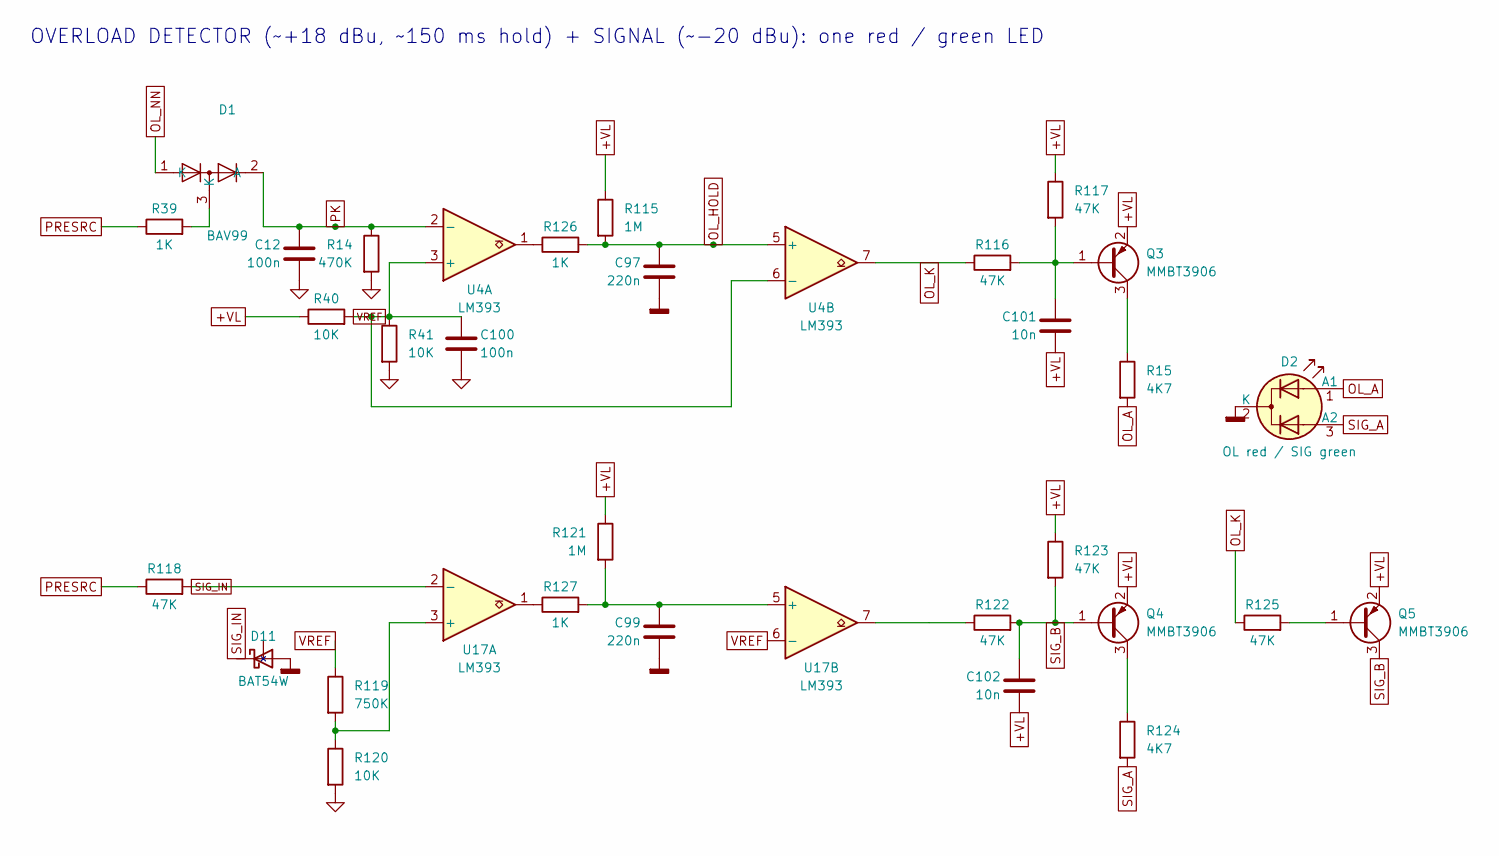
[picture p149: schematic 09_overload_detector.kicad_sch, OVERLOAD DETECTOR]

Parts:
C12, C100: 100n; C_0805_2012Metric; MPN Samsung CL21B104KBCNNNC (X7R 50V)
C97, C99: 220n; C_0805_2012Metric; MPN Samsung CL21B224KBFNNNE (X7R 50V)
C101, C102: 10n; C_0805_2012Metric; MPN Samsung CL21B103KBANNNC (X7R 50V)
D1: BAV99; SOT-23; MPN Diodes BAV99-7-F
D2: OL red / SIG green; LED_D3.0mm-3_P2.00mm; MPN Kingbright WP3VEGW
D11: BAT54W; SOT-323_SC-70; MPN Nexperia BAT54W,115
Q3, Q4, Q5: MMBT3906; SOT-23; MPN onsemi MMBT3906LT1G
R14: 470K; R_0805_2012Metric
R15, R124: 4K7; R_0805_2012Metric
R39, R126, R127: 1K; R_0805_2012Metric
R40, R41, R120: 10K; R_0805_2012Metric
R115, R121: 1M; R_0805_2012Metric
R116, R117, R118, R122, R123, R125: 47K; R_0805_2012Metric
R119: 750K; R_0805_2012Metric
U4, U17: LM393; SOIC-8_3.9x4.9mm_P1.27mm; MPN TI LM393BIDR

Connections:
+VL: C101.2, C102.2, Q3.2 (E), Q4.2 (E), Q5.2 (E), R40.1, R115.1, R117.1, R121.1, R123.1; also elsewhere on the board
GNDA: C12.2, C100.2, R14.2, R41.2, R120.2; also elsewhere on the board
GNDD: C97.2, C99.2, D2.2 (K), D11.1 (A); also elsewhere on the board
unnamed: D1.3 (K), R39.2
unnamed: C101.1, Q3.1 (B), R116.2, R117.2
unnamed: Q3.3 (C), R15.1
unnamed: Q4.3 (C), R124.1
unnamed: Q5.1 (B), R125.2
unnamed: R122.1, U17.7
unnamed: R126.1, U4.1
unnamed: R127.1, U17.1
unnamed: R119.2, R120.1, U17.3 (+)
unnamed: C99.1, R121.2, R127.2, U17.5 (+)
OL_A: D2.1 (A1), R15.2
OL_HOLD: C97.1, R115.2, R126.2, U4.5 (+); also elsewhere on the board
OL_K: R116.1, R125.1, U4.7
OL_NN: D1.1 (K); also elsewhere on the board
PK: C12.1, D1.2 (A), R14.1, U4.2 (-); also elsewhere on the board
PRESRC: R39.1, R118.1; also elsewhere on the board
SIG_A: D2.3 (A2), R124.2
SIG_B: C102.1, Q4.1 (B), Q5.3 (C), R122.2, R123.2
SIG_IN: D11.3 (K), R118.2, U17.2 (-)
VREF: C100.1, R40.2, R41.1, R119.1, U4.3 (+), U4.6 (-), U17.6 (-); also elsewhere on the board

Notes on the sheet:
OVERLOAD DETECTOR (~+18 dBu, ~150 ms hold) + SIGNAL (~-20 dBu): one red / green LED

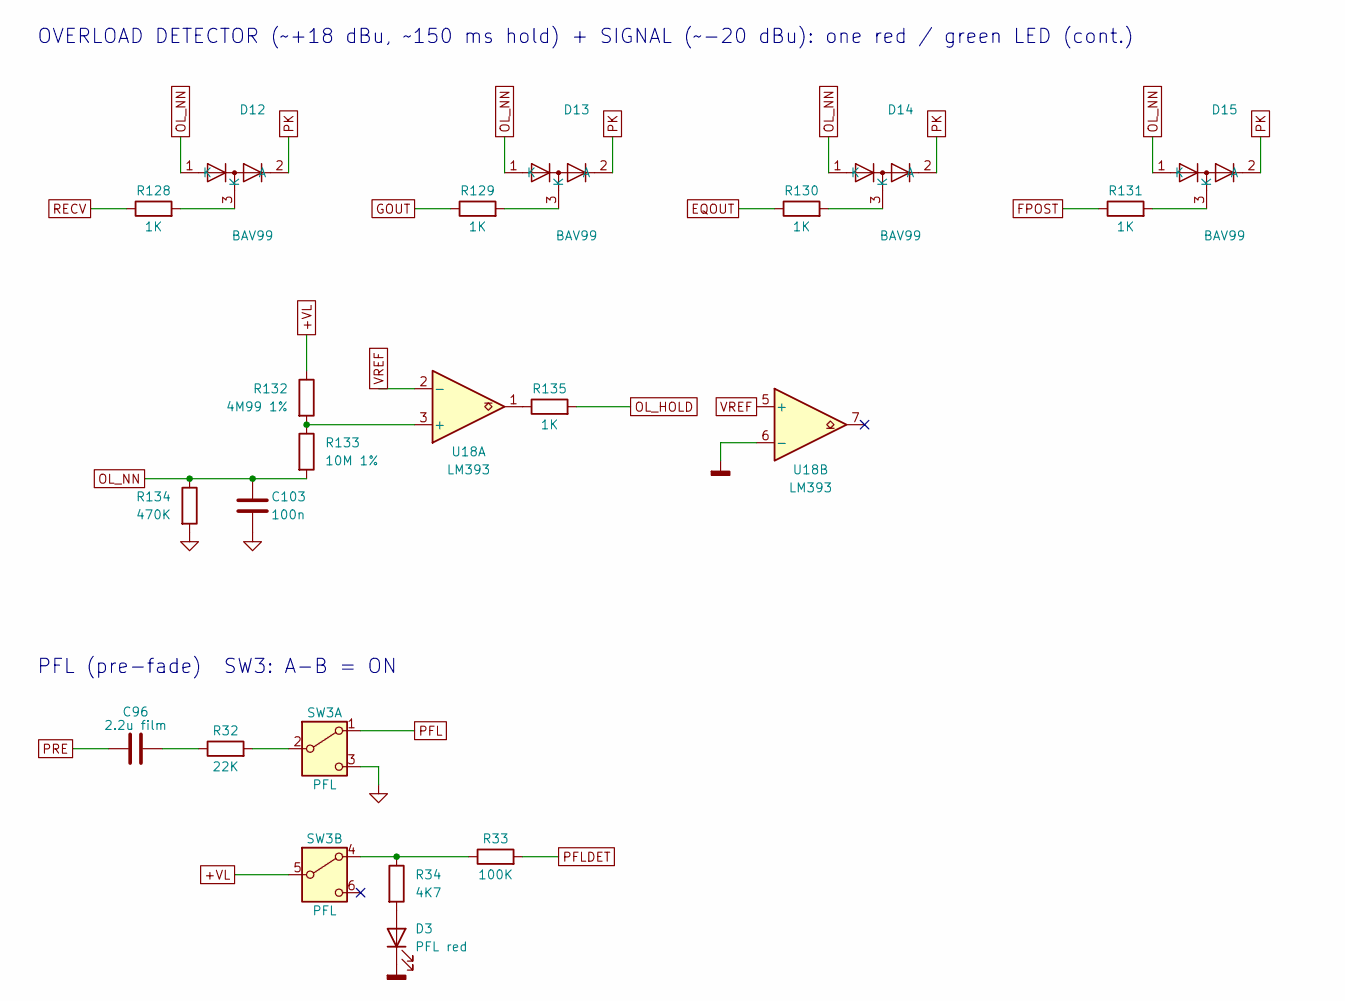
[picture p150: schematic 10_overload_detector.kicad_sch, OVERLOAD DETECTOR, PFL]

Parts:
C96: 2.2u film; C_Rect_L7.2mm_W7.2mm_P5.00mm_FKS2_FKP2_MKS2_MKP2; MPN KEMET MMK5225K63J06L4BULK (PET 63V; rep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
C103: 100n; C_0805_2012Metric; MPN Samsung CL21B104KBCNNNC (X7R 50V)
D3: PFL red; LED_D3.0mm; MPN Kingbright WP710A10ID
D12, D13, D14, D15: BAV99; SOT-23; MPN Diodes BAV99-7-F
R32: 22K; R_0805_2012Metric
R33: 100K; R_0805_2012Metric
R34: 4K7; R_0805_2012Metric
R128, R129, R130, R131, R135: 1K; R_0805_2012Metric
R132: 4M99 1%; R_0805_2012Metric
R133: 10M 1%; R_0805_2012Metric
R134: 470K; R_0805_2012Metric
SW3: PFL; SW_Push_2P2T_Toggle_CK_PVA2xxH1xxxxxxV2; MPN C&K PVA2 EE H1 1.7N V2
U18: LM393; SOIC-8_3.9x4.9mm_P1.27mm; MPN TI LM393BIDR

Connections:
+VL: R132.1, SW3.5 (B); also elsewhere on the board
EQOUT: R130.1; also elsewhere on the board
FPOST: R131.1; also elsewhere on the board
GNDA: C103.2, R134.2, SW3.3 (C); also elsewhere on the board
GNDD: D3.1 (K), U18.6 (-); also elsewhere on the board
GOUT: R129.1; also elsewhere on the board
unnamed: C96.2, R32.1
unnamed: D3.2 (A), R34.2
unnamed: D12.3 (K), R128.2
unnamed: D13.3 (K), R129.2
unnamed: D14.3 (K), R130.2
unnamed: D15.3 (K), R131.2
unnamed: R135.1, U18.1
unnamed: R32.2, SW3.2 (B)
unnamed: R33.1, R34.1, SW3.4 (A)
unnamed: R132.2, R133.1, U18.3 (+)
OL_HOLD: R135.2; also elsewhere on the board
OL_NN: C103.1, D12.1 (K), D13.1 (K), D14.1 (K), D15.1 (K), R133.2, R134.1; also elsewhere on the board
PFL: SW3.1 (A); also elsewhere on the board
PFLDET: R33.2; also elsewhere on the board
PK: D12.2 (A), D13.2 (A), D14.2 (A), D15.2 (A); also elsewhere on the board
PRE: C96.1; also elsewhere on the board
RECV: R128.1; also elsewhere on the board
VREF: U18.2 (-), U18.5 (+); also elsewhere on the board

Notes on the sheet:
OVERLOAD DETECTOR (~+18 dBu, ~150 ms hold) + SIGNAL (~-20 dBu): one red / green LED (cont.)
PFL (pre-fade) SW3: A-B = ON

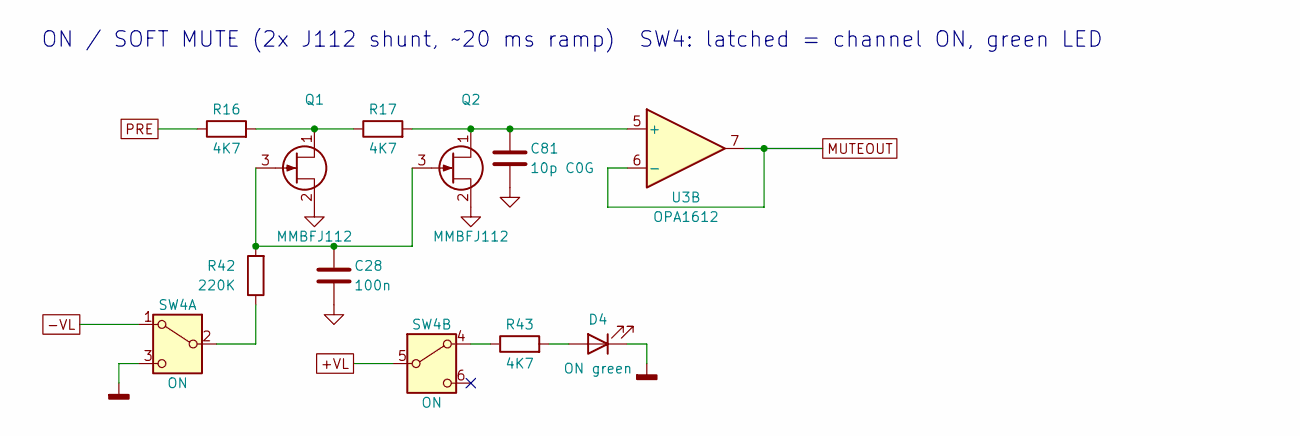
[picture p151: schematic 11_on_soft_mute.kicad_sch, ON-SOFT MUTE]

Parts:
C28: 100n; C_0805_2012Metric; MPN Samsung CL21B104KBCNNNC (X7R 50V)
C81: 10p C0G; C_1206_3216Metric; MPN KEMET C1206C100J5GACTU
D4: ON green; LED_D3.0mm; MPN Kingbright WP710A10GD
Q1, Q2: MMBFJ112; SOT-23; MPN onsemi MMBFJ112
R16, R17, R43: 4K7; R_0805_2012Metric
R42: 220K; R_0805_2012Metric
SW4: ON; SW_Push_2P2T_Toggle_CK_PVA2xxH1xxxxxxV2; MPN C&K PVA2 EE H1 1.7N V2
U3: OPA1612; SOIC-8_3.9x4.9mm_P1.27mm; MPN TI OPA1612AIDR

Connections:
+VL: SW4.5 (B); also elsewhere on the board
-VL: SW4.1 (A); also elsewhere on the board
GNDA: C28.2, C81.2, Q1.2 (S), Q2.2 (S); also elsewhere on the board
GNDD: D4.1 (K), SW4.3 (C); also elsewhere on the board
MUTEOUT: U3.6 (-), U3.7; also elsewhere on the board
unnamed: D4.2 (A), R43.2
unnamed: Q1.1 (D), R16.2, R17.1
unnamed: C28.1, Q1.3 (G), Q2.3 (G), R42.2
unnamed: C81.1, Q2.1 (D), R17.2, U3.5 (+)
unnamed: R42.1, SW4.2 (B)
unnamed: R43.1, SW4.4 (A)
PRE: R16.1; also elsewhere on the board

Notes on the sheet:
ON / SOFT MUTE (2x J112 shunt, ~20 ms ramp) SW4: latched = channel ON, green LED

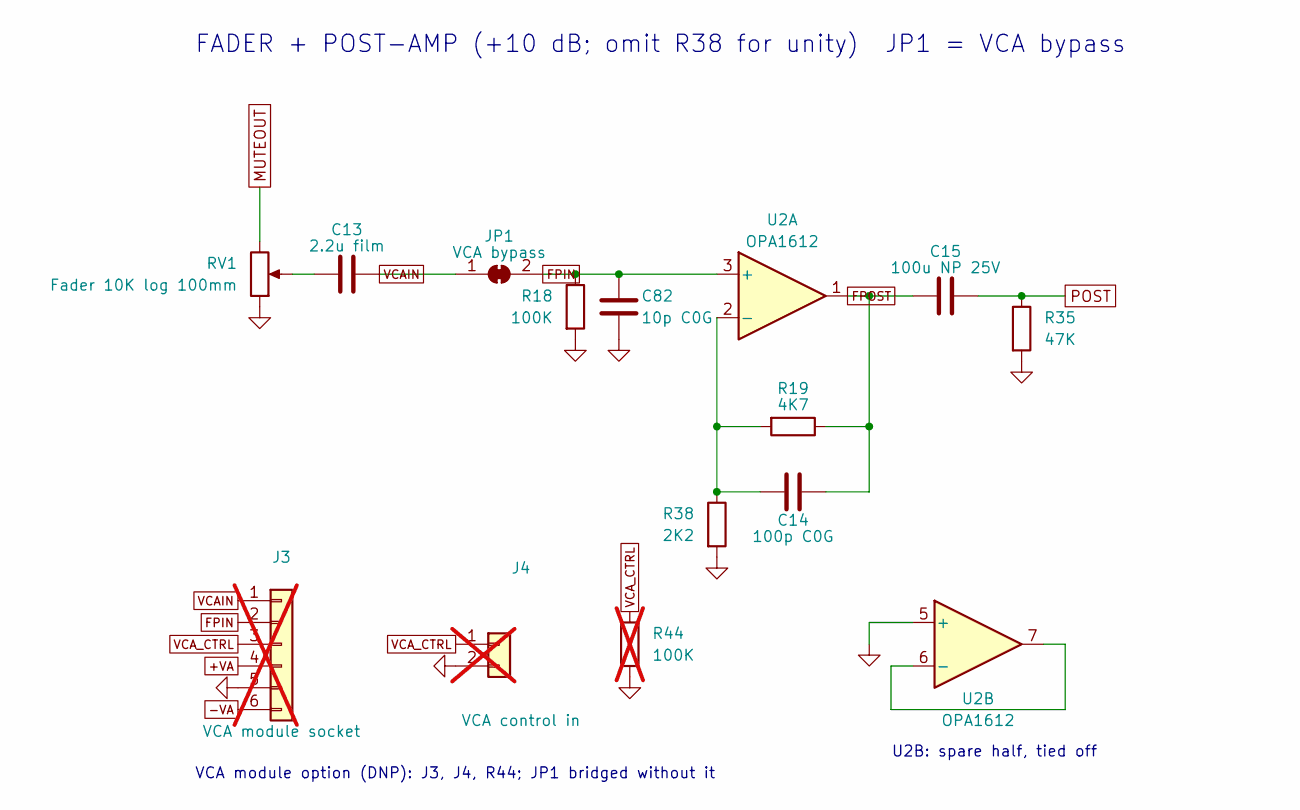
[picture p152: schematic 12_fader_post_amp.kicad_sch, FADER + POST-AMP]

Parts:
C13: 2.2u film; C_Rect_L7.2mm_W7.2mm_P5.00mm_FKS2_FKP2_MKS2_MKP2; MPN KEMET MMK5225K63J06L4BULK (PET 63V; rep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
C14: 100p C0G; C_0805_2012Metric; MPN KEMET C0805C101J5GACTU
C15: 100u NP 25V; CP_Radial_D10.0mm_P5.00mm; MPN Nichicon UES1E101MPM (MUSE ES)
C82: 10p C0G; C_1206_3216Metric; MPN KEMET C1206C100J5GACTU
J3: VCA module socket; PinSocket_1x06_P2.54mm_Vertical; not fitted
J4: VCA control in; PinHeader_1x02_P2.54mm_Vertical; not fitted
JP1: VCA bypass; SolderJumper-2_P1.3mm_Bridged_RoundedPad1.0x1.5mm
R18: 100K; R_0805_2012Metric
R19: 4K7; R_0805_2012Metric
R35: 47K; R_0805_2012Metric
R38: 2K2; R_0805_2012Metric
R44: 100K; R_0805_2012Metric; not fitted
RV1: Fader 10K log 100mm; Potentiometer_Bourns_PTB0143_Slide_100mm; MPN Bourns PTB0143-2010BPA103
U2: OPA1612; SOIC-8_3.9x4.9mm_P1.27mm; MPN TI OPA1612AIDR

Connections:
+VA: J3.4; also elsewhere on the board
-VA: J3.6; also elsewhere on the board
FPIN: C82.1, J3.2, JP1.2 (B), R18.1, U2.3 (+)
FPOST: C14.1, C15.1, R19.1, U2.1; also elsewhere on the board
GNDA: C82.2, J3.5, J4.2, R18.2, R35.2, R38.2, R44.2, RV1.1, U2.5 (+); also elsewhere on the board
MUTEOUT: RV1.3; also elsewhere on the board
unnamed: C13.1, RV1.2
unnamed: C14.2, R19.2, R38.1, U2.2 (-)
unnamed: U2.6 (-), U2.7
POST: C15.2, R35.1; also elsewhere on the board
VCAIN: C13.2, J3.1, JP1.1 (A)
VCA_CTRL: J3.3, J4.1, R44.1

Notes on the sheet:
FADER + POST-AMP (+10 dB; omit R38 for unity) JP1 = VCA bypass
VCA module option (DNP): J3, J4, R44; JP1 bridged without it
U2B: spare half, tied off

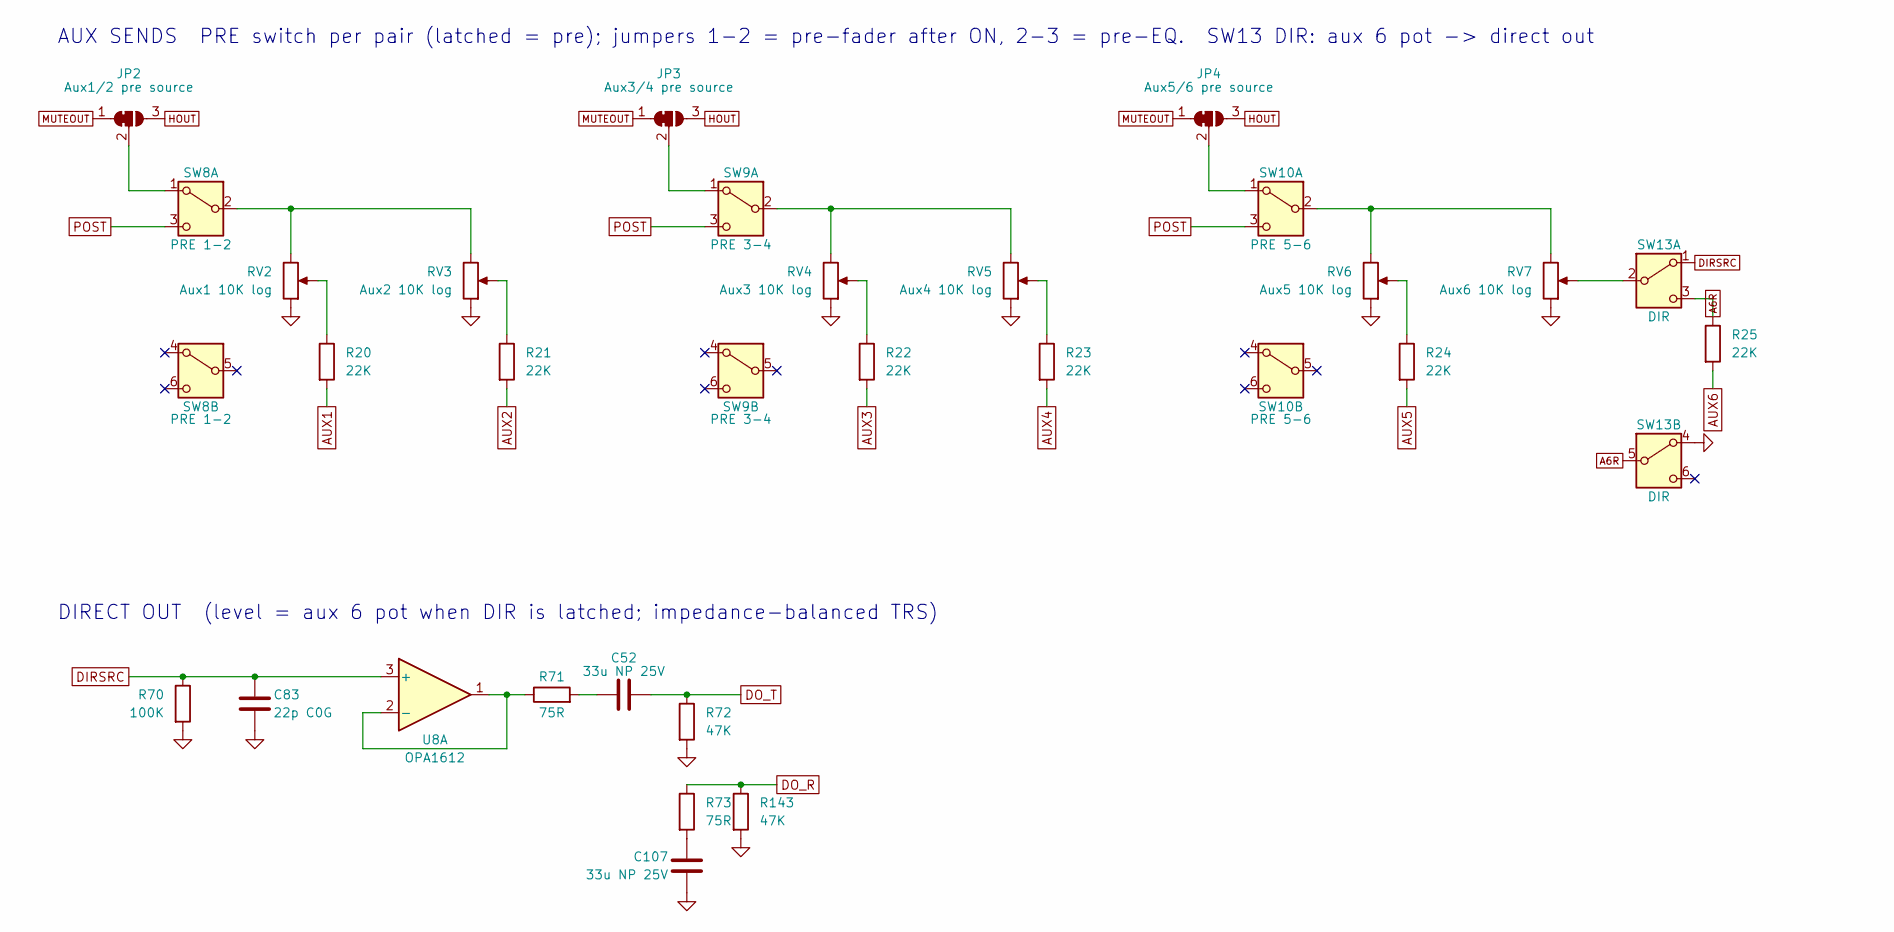
[picture p153: schematic 13_aux_sends.kicad_sch, AUX SENDS, DIRECT OUT]

Parts:
C52, C107: 33u NP 25V; CP_Radial_D8.0mm_P3.50mm; MPN Nichicon UES1E330MPM (MUSE ES)
C83: 22p C0G; C_1206_3216Metric; MPN KEMET C1206C220J5GACTU
JP2: Aux1/2 pre source; SolderJumper-3_P1.3mm_Bridged12_RoundedPad1.0x1.5mm
JP3: Aux3/4 pre source; SolderJumper-3_P1.3mm_Bridged12_RoundedPad1.0x1.5mm
JP4: Aux5/6 pre source; SolderJumper-3_P1.3mm_Bridged12_RoundedPad1.0x1.5mm
R20, R21, R22, R23, R24, R25: 22K; R_0805_2012Metric
R70: 100K; R_0805_2012Metric
R71, R73: 75R; R_0805_2012Metric; MPN Panasonic ERJ-P06J750V
R72, R143: 47K; R_0805_2012Metric
RV2: Aux1 10K log; Potentiometer_Alpha_RD901F-40-00D_Single_Vertical; MPN Alpha RD901F-40-15R1-A10K
RV3: Aux2 10K log; Potentiometer_Alpha_RD901F-40-00D_Single_Vertical; MPN Alpha RD901F-40-15R1-A10K
RV4: Aux3 10K log; Potentiometer_Alpha_RD901F-40-00D_Single_Vertical; MPN Alpha RD901F-40-15R1-A10K
RV5: Aux4 10K log; Potentiometer_Alpha_RD901F-40-00D_Single_Vertical; MPN Alpha RD901F-40-15R1-A10K
RV6: Aux5 10K log; Potentiometer_Alpha_RD901F-40-00D_Single_Vertical; MPN Alpha RD901F-40-15R1-A10K
RV7: Aux6 10K log; Potentiometer_Alpha_RD901F-40-00D_Single_Vertical; MPN Alpha RD901F-40-15R1-A10K
SW8: PRE 1-2; SW_Push_2P2T_Toggle_CK_PVA2xxH1xxxxxxV2; MPN C&K PVA2 EE H1 1.7N V2
SW9: PRE 3-4; SW_Push_2P2T_Toggle_CK_PVA2xxH1xxxxxxV2; MPN C&K PVA2 EE H1 1.7N V2
SW10: PRE 5-6; SW_Push_2P2T_Toggle_CK_PVA2xxH1xxxxxxV2; MPN C&K PVA2 EE H1 1.7N V2
SW13: DIR; SW_Push_2P2T_Toggle_CK_PVA2xxH1xxxxxxV2; MPN C&K PVA2 EE H1 1.7N V2
U8: OPA1612; SOIC-8_3.9x4.9mm_P1.27mm; MPN TI OPA1612AIDR

Connections:
A6R: R25.1, SW13.3 (C), SW13.5 (B)
AUX1: R20.2; also elsewhere on the board
AUX2: R21.2; also elsewhere on the board
AUX3: R22.2; also elsewhere on the board
AUX4: R23.2; also elsewhere on the board
AUX5: R24.2; also elsewhere on the board
AUX6: R25.2; also elsewhere on the board
DIRSRC: C83.1, R70.1, SW13.1 (A), U8.3 (+)
DO_R: R73.1, R143.1; also elsewhere on the board
DO_T: C52.2, R72.1; also elsewhere on the board
GNDA: C83.2, C107.2, R70.2, R72.2, R143.2, RV2.1, RV3.1, RV4.1, RV5.1, RV6.1, RV7.1, SW13.4 (A); also elsewhere on the board
HOUT: JP2.3 (B), JP3.3 (B), JP4.3 (B); also elsewhere on the board
MUTEOUT: JP2.1 (A), JP3.1 (A), JP4.1 (A); also elsewhere on the board
unnamed: C52.1, R71.2
unnamed: C107.1, R73.2
unnamed: JP2.2 (C), SW8.1 (A)
unnamed: JP3.2 (C), SW9.1 (A)
unnamed: JP4.2 (C), SW10.1 (A)
unnamed: R20.1, RV2.2
unnamed: R21.1, RV3.2
unnamed: R22.1, RV4.2
unnamed: R23.1, RV5.2
unnamed: R24.1, RV6.2
unnamed: RV2.3, RV3.3, SW8.2 (B)
unnamed: RV4.3, RV5.3, SW9.2 (B)
unnamed: RV6.3, RV7.3, SW10.2 (B)
unnamed: RV7.2, SW13.2 (B)
unnamed: R71.1, U8.1, U8.2 (-)
POST: SW8.3 (C), SW9.3 (C), SW10.3 (C); also elsewhere on the board

Notes on the sheet:
AUX SENDS PRE switch per pair (latched = pre); jumpers 1-2 = pre-fader after ON, 2-3 = pre-EQ. SW13 DIR: aux 6 pot -> direct out
DIRECT OUT (level = aux 6 pot when DIR is latched; impedance-balanced TRS)

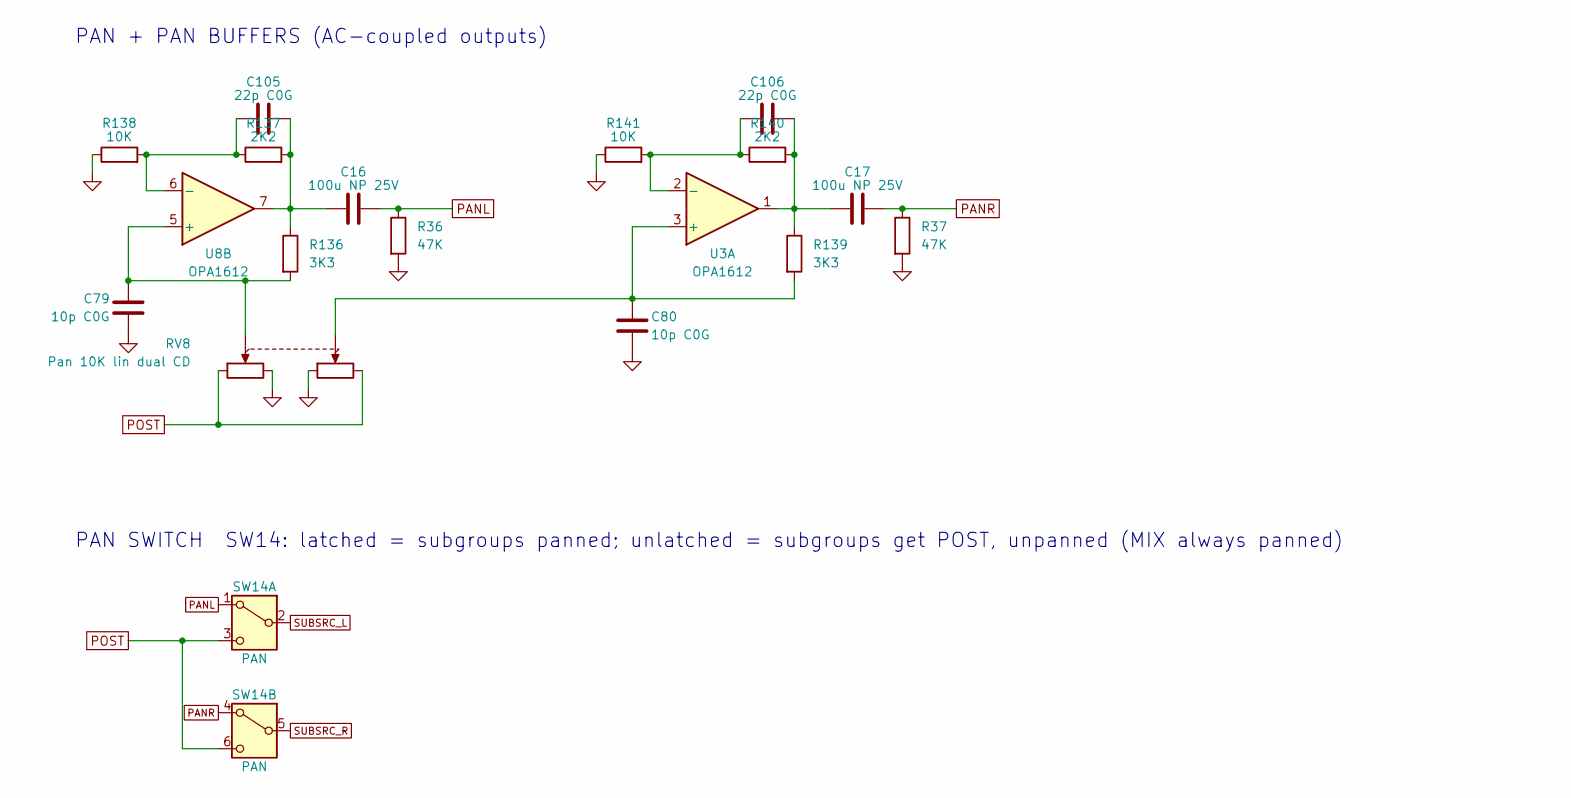
[picture p154: schematic 14_pan_pan_buffers.kicad_sch, PAN + PAN BUFFERS, PAN SWITCH]

Parts:
C16, C17: 100u NP 25V; CP_Radial_D10.0mm_P5.00mm; MPN Nichicon UES1E101MPM (MUSE ES)
C79, C80: 10p C0G; C_1206_3216Metric; MPN KEMET C1206C100J5GACTU
C105, C106: 22p C0G; C_1206_3216Metric; MPN KEMET C1206C220J5GACTU
R36, R37: 47K; R_0805_2012Metric
R136, R139: 3K3; R_0805_2012Metric
R137, R140: 2K2; R_0805_2012Metric
R138, R141: 10K; R_0805_2012Metric
RV8: Pan 10K lin dual CD; Potentiometer_Alps_RK09L_Double_Vertical; MPN ALPS RK09L1240015
SW14: PAN; SW_Push_2P2T_Toggle_CK_PVA2xxH1xxxxxxV2; MPN C&K PVA2 EE H1 1.7N V2
U3, U8: OPA1612; SOIC-8_3.9x4.9mm_P1.27mm; MPN TI OPA1612AIDR

Connections:
GNDA: C79.2, C80.2, R36.2, R37.2, R138.1, R141.1, RV8.3, RV8.4; also elsewhere on the board
unnamed: C16.1, C105.2, R136.1, R137.2, U8.7
unnamed: C17.1, C106.2, R139.1, R140.2, U3.1
unnamed: C80.1, R139.2, RV8.5, U3.3 (+)
unnamed: C106.1, R140.1, R141.2, U3.2 (-)
unnamed: C79.1, R136.2, RV8.2, U8.5 (+)
unnamed: C105.1, R137.1, R138.2, U8.6 (-)
PANL: C16.2, R36.1, SW14.1 (A); also elsewhere on the board
PANR: C17.2, R37.1, SW14.4 (A); also elsewhere on the board
POST: RV8.1, RV8.6, SW14.3 (C), SW14.6 (C); also elsewhere on the board
SUBSRC_L: SW14.2 (B); also elsewhere on the board
SUBSRC_R: SW14.5 (B); also elsewhere on the board

Notes on the sheet:
PAN + PAN BUFFERS (AC-coupled outputs)
PAN SWITCH SW14: latched = subgroups panned; unlatched = subgroups get POST, unpanned (MIX always panned)

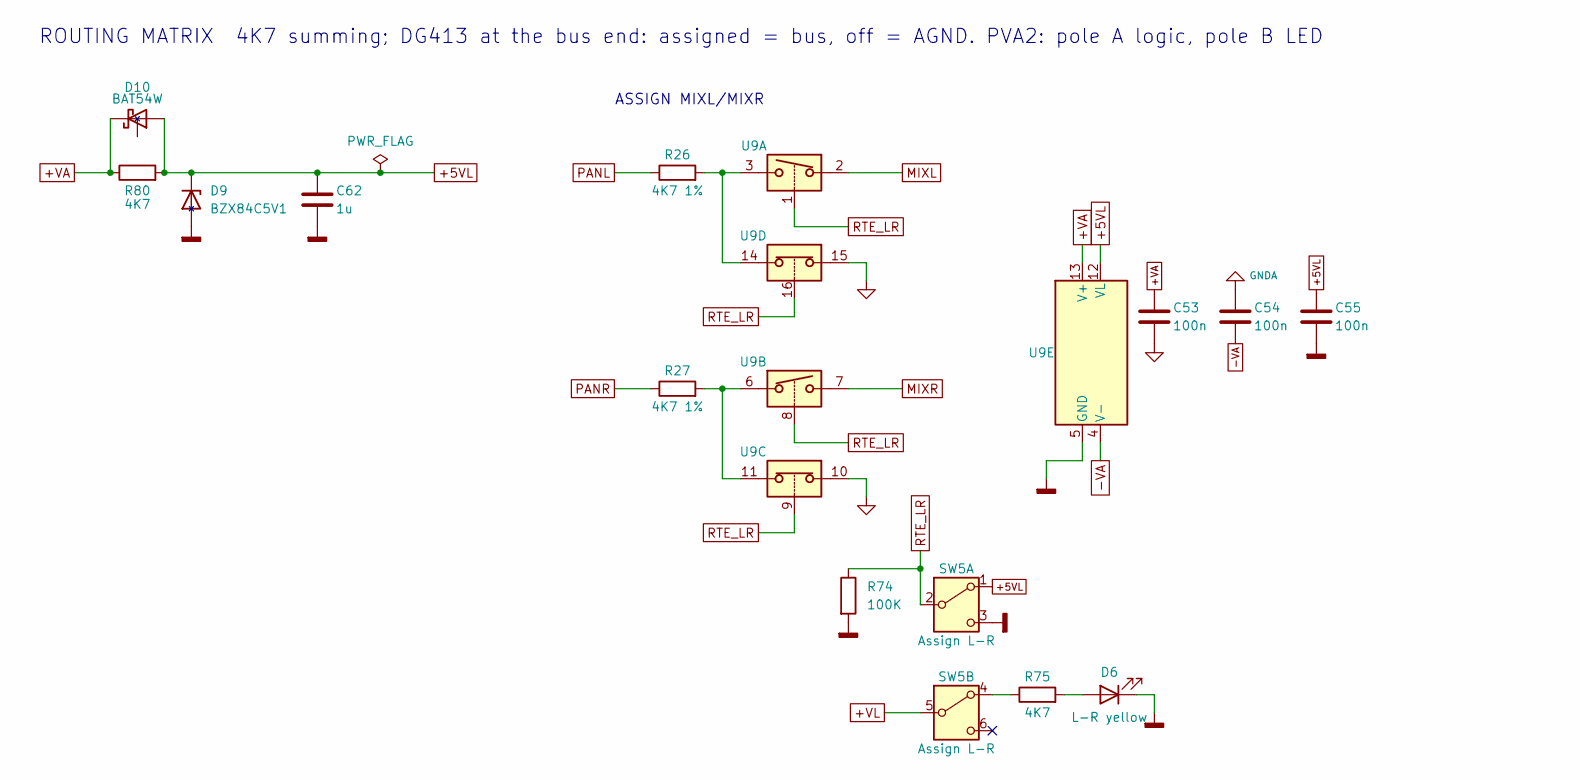
[picture p155: schematic 15_routing_matrix.kicad_sch, ROUTING MATRIX]

Parts:
C53, C54, C55: 100n; C_0805_2012Metric; MPN Samsung CL21B104KBCNNNC (X7R 50V)
C62: 1u; C_0805_2012Metric; MPN Murata GRM21BR71H105KA12L (X7R 50V)
D6: L-R yellow; LED_D3.0mm; MPN Kingbright WP710A10YD
D9: BZX84C5V1; SOT-23; MPN Diodes BZX84C5V1-7-F
D10: BAT54W; SOT-323_SC-70; MPN Nexperia BAT54W,115
R26, R27: 4K7 1%; R_0805_2012Metric
R74: 100K; R_0805_2012Metric
R75, R80: 4K7; R_0805_2012Metric
SW5: Assign L-R; SW_Push_2P2T_Toggle_CK_PVA2xxH1xxxxxxV2; MPN C&K PVA2 EE H1 1.7N V2
U9: DG413; SOIC-16_3.9x9.9mm_P1.27mm; MPN Vishay DG413DY-E3

Connections:
+5VL: C55.1, C62.1, D9.3 (K), D10.1 (A), R80.2, SW5.1 (A), U9.12 (VL); also elsewhere on the board
+VA: C53.1, D10.3 (K), R80.1, U9.13 (V+); also elsewhere on the board
+VL: SW5.5 (B); also elsewhere on the board
-VA: C54.2, U9.4 (V-); also elsewhere on the board
GNDA: C53.2, C54.1, U9.10, U9.15; also elsewhere on the board
GNDD: C55.2, C62.2, D6.1 (K), D9.1 (A), R74.2, SW5.3 (C), U9.5 (GND); also elsewhere on the board
MIXL: U9.2; also elsewhere on the board
MIXR: U9.7; also elsewhere on the board
unnamed: D6.2 (A), R75.2
unnamed: R26.2, U9.3, U9.14
unnamed: R27.2, U9.6, U9.11
unnamed: R75.1, SW5.4 (A)
PANL: R26.1; also elsewhere on the board
PANR: R27.1; also elsewhere on the board
RTE_LR: R74.1, SW5.2 (B), U9.1, U9.8, U9.9, U9.16

Notes on the sheet:
ROUTING MATRIX 4K7 summing; DG413 at the bus end: assigned = bus, off = AGND. PVA2: pole A logic, pole B LED
ASSIGN MIXL/MIXR

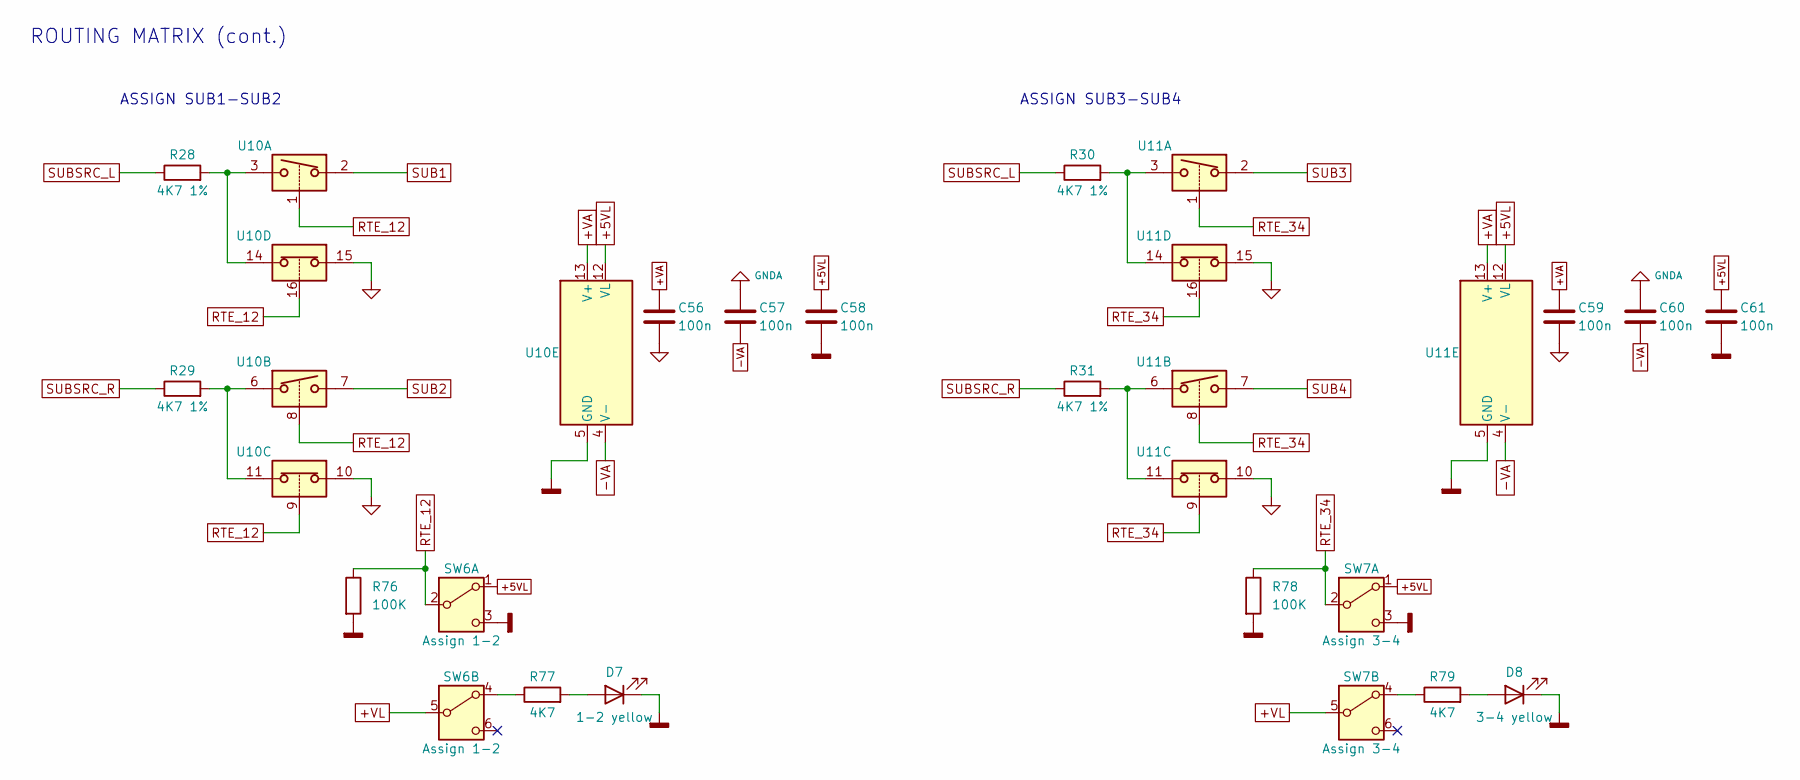
[picture p156: schematic 16_routing_matrix.kicad_sch, ROUTING MATRIX]

Parts:
C56, C57, C58, C59, C60, C61: 100n; C_0805_2012Metric; MPN Samsung CL21B104KBCNNNC (X7R 50V)
D7: 1-2 yellow; LED_D3.0mm; MPN Kingbright WP710A10YD
D8: 3-4 yellow; LED_D3.0mm; MPN Kingbright WP710A10YD
R28, R29, R30, R31: 4K7 1%; R_0805_2012Metric
R76, R78: 100K; R_0805_2012Metric
R77, R79: 4K7; R_0805_2012Metric
SW6: Assign 1-2; SW_Push_2P2T_Toggle_CK_PVA2xxH1xxxxxxV2; MPN C&K PVA2 EE H1 1.7N V2
SW7: Assign 3-4; SW_Push_2P2T_Toggle_CK_PVA2xxH1xxxxxxV2; MPN C&K PVA2 EE H1 1.7N V2
U10, U11: DG413; SOIC-16_3.9x9.9mm_P1.27mm; MPN Vishay DG413DY-E3

Connections:
+5VL: C58.1, C61.1, SW6.1 (A), SW7.1 (A), U10.12 (VL), U11.12 (VL); also elsewhere on the board
+VA: C56.1, C59.1, U10.13 (V+), U11.13 (V+); also elsewhere on the board
+VL: SW6.5 (B), SW7.5 (B); also elsewhere on the board
-VA: C57.2, C60.2, U10.4 (V-), U11.4 (V-); also elsewhere on the board
GNDA: C56.2, C57.1, C59.2, C60.1, U10.10, U10.15, U11.10, U11.15; also elsewhere on the board
GNDD: C58.2, C61.2, D7.1 (K), D8.1 (K), R76.2, R78.2, SW6.3 (C), SW7.3 (C), U10.5 (GND), U11.5 (GND); also elsewhere on the board
unnamed: D7.2 (A), R77.2
unnamed: D8.2 (A), R79.2
unnamed: R28.2, U10.3, U10.14
unnamed: R29.2, U10.6, U10.11
unnamed: R30.2, U11.3, U11.14
unnamed: R31.2, U11.6, U11.11
unnamed: R77.1, SW6.4 (A)
unnamed: R79.1, SW7.4 (A)
RTE_12: R76.1, SW6.2 (B), U10.1, U10.8, U10.9, U10.16
RTE_34: R78.1, SW7.2 (B), U11.1, U11.8, U11.9, U11.16
SUB1: U10.2; also elsewhere on the board
SUB2: U10.7; also elsewhere on the board
SUB3: U11.2; also elsewhere on the board
SUB4: U11.7; also elsewhere on the board
SUBSRC_L: R28.1, R30.1; also elsewhere on the board
SUBSRC_R: R29.1, R31.1; also elsewhere on the board

Notes on the sheet:
ROUTING MATRIX (cont.)
ASSIGN SUB1-SUB2
ASSIGN SUB3-SUB4

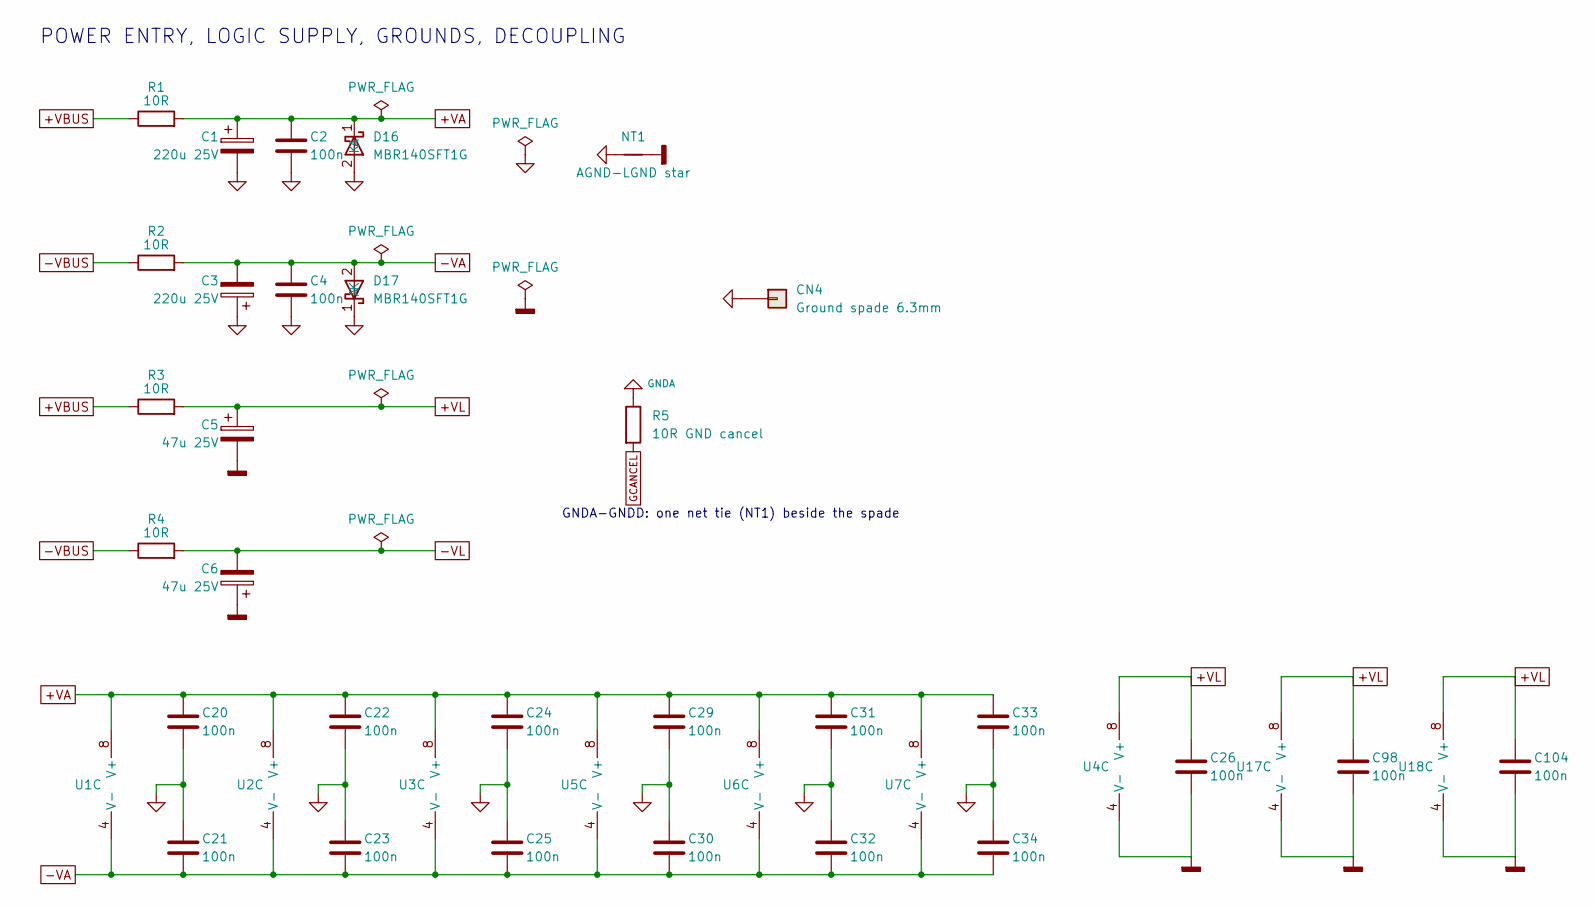
[picture p157: schematic 17_power_entry.kicad_sch, POWER ENTRY]

Parts:
C1, C3: 220u 25V; CP_Radial_D8.0mm_P3.50mm; MPN Panasonic EEU-FR1E221
C2, C4, C20, C21, C22, C23, C24, C25, C26, C29, C30, C31, C32, C33, C34, C98, C104: 100n; C_0805_2012Metric; MPN Samsung CL21B104KBCNNNC (X7R 50V)
C5, C6: 47u 25V; CP_Radial_D6.3mm_P2.50mm; MPN Rubycon 63ZLH47MEFC6.3X11 (63V)
CN4: Ground spade 6.3mm; Keystone_1287-ST_FastOn_Tab_6.35mm; MPN Keystone 1287-ST
D16, D17: MBR140SFT1G; D_SOD-123F; MPN onsemi MBR140SFT1G
NT1: AGND-LGND star; NetTie-2_SMD_Pad0.5mm
R1, R2, R3, R4: 10R; R_1206_3216Metric; MPN Vishay M251206BB1009JP500
R5: 10R GND cancel; R_0805_2012Metric
U1, U2, U3, U5, U6, U7: OPA1612; SOIC-8_3.9x4.9mm_P1.27mm; MPN TI OPA1612AIDR
U4, U17, U18: LM393; SOIC-8_3.9x4.9mm_P1.27mm; MPN TI LM393BIDR

Connections:
+VA: C1.1, C2.1, C20.1, C22.1, C24.1, C29.1, C31.1, C33.1, D16.1 (K), R1.2, U1.8 (V+), U2.8 (V+), U3.8 (V+), U5.8 (V+), U6.8 (V+), U7.8 (V+); also elsewhere on the board
+VBUS: R1.1, R3.1; also elsewhere on the board
+VL: C5.1, C26.1, C98.1, C104.1, R3.2, U4.8 (V+), U17.8 (V+), U18.8 (V+); also elsewhere on the board
-VA: C3.2, C4.2, C21.2, C23.2, C25.2, C30.2, C32.2, C34.2, D17.2 (A), R2.2, U1.4 (V-), U2.4 (V-), U3.4 (V-), U5.4 (V-), U6.4 (V-), U7.4 (V-); also elsewhere on the board
-VBUS: R2.1, R4.1; also elsewhere on the board
-VL: C6.2, R4.2; also elsewhere on the board
GCANCEL: R5.2; also elsewhere on the board
GNDA: C1.2, C2.2, C3.1, C4.1, C20.2, C21.1, C22.2, C23.1, C24.2, C25.1, C29.2, C30.1, C31.2, C32.1, C33.2, C34.1, CN4.1, D16.2 (A), D17.1 (K), NT1.1, R5.1; also elsewhere on the board
GNDD: C5.2, C6.1, C26.2, C98.2, C104.2, NT1.2, U4.4 (V-), U17.4 (V-), U18.4 (V-); also elsewhere on the board

Notes on the sheet:
POWER ENTRY, LOGIC SUPPLY, GROUNDS, DECOUPLING
GNDA-GNDD: one net tie (NT1) beside the spade
