cozycactus/goa-console/boards/channel_strip/channel_strip.kicad_pcb

## KiCad design boards/channel_strip/channel_strip.kicad_pcb (continued)

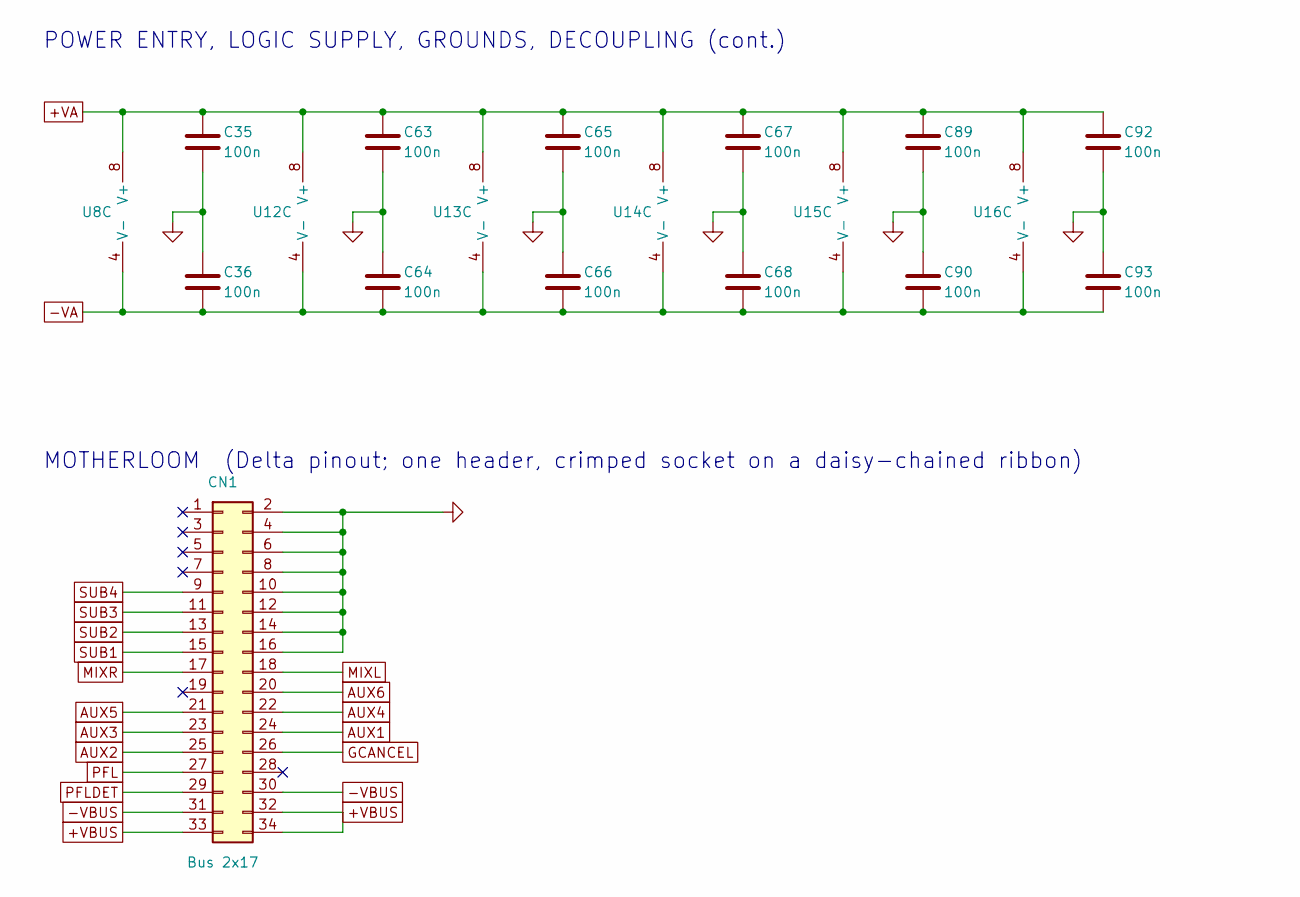
[picture p158: schematic 18_power_entry.kicad_sch, POWER ENTRY, MOTHERLOOM]

Parts:
C35, C36, C63, C64, C65, C66, C67, C68, C89, C90, C92, C93: 100n; C_0805_2012Metric; MPN Samsung CL21B104KBCNNNC (X7R 50V)
CN1: Bus 2x17; IDC-Header_2x17_P2.54mm_Vertical; MPN Wurth 61203421621 (2x17 box header)
U8, U12, U13, U14, U15: OPA1612; SOIC-8_3.9x4.9mm_P1.27mm; MPN TI OPA1612AIDR
U16: OPA1656; SOIC-8_3.9x4.9mm_P1.27mm; MPN TI OPA1656IDR

Connections:
+VA: C35.1, C63.1, C65.1, C67.1, C89.1, C92.1, U8.8 (V+), U12.8 (V+), U13.8 (V+), U14.8 (V+), U15.8 (V+), U16.8 (V+); also elsewhere on the board
+VBUS: CN1.32, CN1.33, CN1.34; also elsewhere on the board
-VA: C36.2, C64.2, C66.2, C68.2, C90.2, C93.2, U8.4 (V-), U12.4 (V-), U13.4 (V-), U14.4 (V-), U15.4 (V-), U16.4 (V-); also elsewhere on the board
-VBUS: CN1.30, CN1.31; also elsewhere on the board
AUX1: CN1.24; also elsewhere on the board
AUX2: CN1.25; also elsewhere on the board
AUX3: CN1.23; also elsewhere on the board
AUX4: CN1.22; also elsewhere on the board
AUX5: CN1.21; also elsewhere on the board
AUX6: CN1.20; also elsewhere on the board
GCANCEL: CN1.26; also elsewhere on the board
GNDA: C35.2, C36.1, C63.2, C64.1, C65.2, C66.1, C67.2, C68.1, C89.2, C90.1, C92.2, C93.1, CN1.2, CN1.4, CN1.6, CN1.8, CN1.10, CN1.12, CN1.14, CN1.16; also elsewhere on the board
MIXL: CN1.18; also elsewhere on the board
MIXR: CN1.17; also elsewhere on the board
PFL: CN1.27; also elsewhere on the board
PFLDET: CN1.29; also elsewhere on the board
SUB1: CN1.15; also elsewhere on the board
SUB2: CN1.13; also elsewhere on the board
SUB3: CN1.11; also elsewhere on the board
SUB4: CN1.9; also elsewhere on the board

Notes on the sheet:
POWER ENTRY, LOGIC SUPPLY, GROUNDS, DECOUPLING (cont.)
MOTHERLOOM (Delta pinout; one header, crimped socket on a daisy-chained ribbon)

Board: 4 copper layers, 335 parts (105 on the bottom side), 195 nets, no tracks yet.

Other parts of the board:
H1, H2, H3, H4, H5, H6: M3 standoff 11.5 mm; MountingHole_3.2mm_M3
