cozycactus/goa-console/boards/master_jack_board/master_jack_board.kicad_pcb

## KiCad design boards/master_jack_board/master_jack_board.kicad_pcb (2026-11-09)

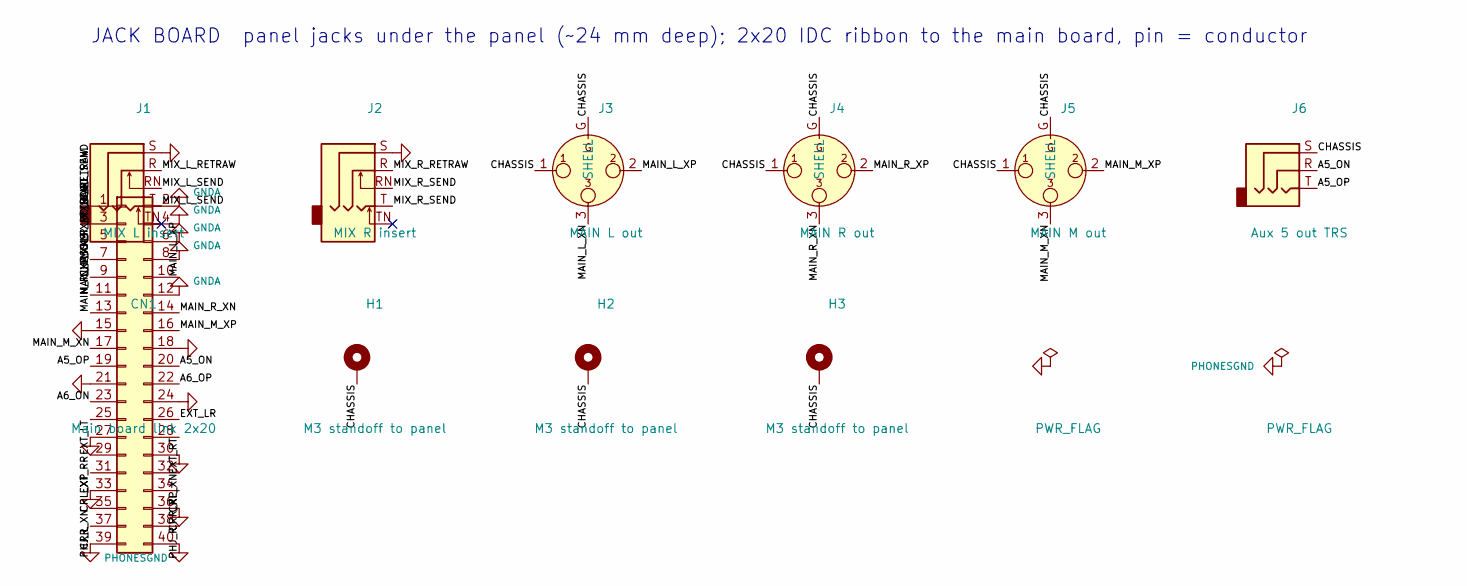
[picture p159: schematic master_jack_board.kicad_sch, Master module jack board - goa console (main XLRs, inserts,…, part in row 1, column 1]

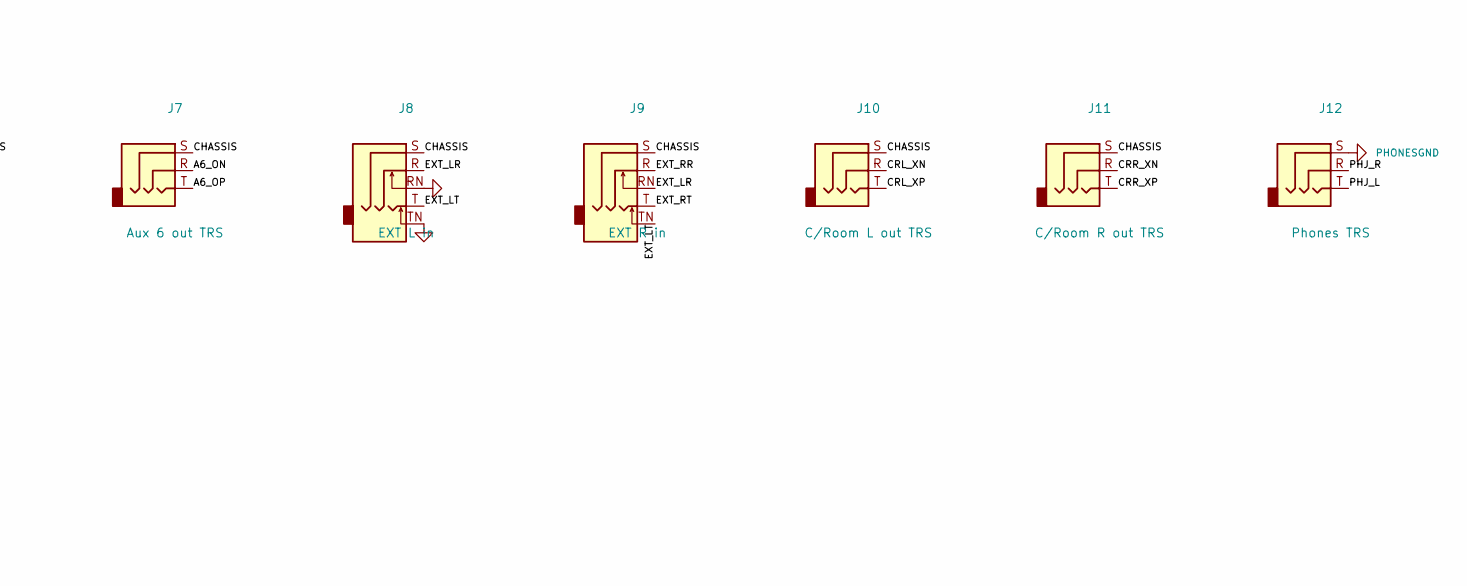
[picture p160: schematic master_jack_board.kicad_sch, Master module jack board - goa console (main XLRs, inserts,…, part in row 1, column 2]

Parts:
CN1: Main board link 2x20; IDC-Header_2x20_P2.54mm_Vertical; MPN Wurth 61204021621 (2x20 box header)
H1, H2, H3: M3 standoff to panel; MountingHole_3.2mm_M3_Pad
J1: MIX L insert; Jack_6.35mm_Neutrik_NJ6FD-V_Vertical; MPN Neutrik NJ6FD-V
J2: MIX R insert; Jack_6.35mm_Neutrik_NJ6FD-V_Vertical; MPN Neutrik NJ6FD-V
J3: MAIN L out; Jack_XLR_Neutrik_NC3MAV_Vertical; MPN Neutrik NC3MAV
J4: MAIN R out; Jack_XLR_Neutrik_NC3MAV_Vertical; MPN Neutrik NC3MAV
J5: MAIN M out; Jack_XLR_Neutrik_NC3MAV_Vertical; MPN Neutrik NC3MAV
J6: Aux 5 out TRS; Jack_6.35mm_Neutrik_NJ6FD-V_Vertical; MPN Neutrik NJ6FD-V
J7: Aux 6 out TRS; Jack_6.35mm_Neutrik_NJ6FD-V_Vertical; MPN Neutrik NJ6FD-V
J8: EXT L in; Jack_6.35mm_Neutrik_NJ6FD-V_Vertical; MPN Neutrik NJ6FD-V
J9: EXT R in; Jack_6.35mm_Neutrik_NJ6FD-V_Vertical; MPN Neutrik NJ6FD-V
J10: C/Room L out TRS; Jack_6.35mm_Neutrik_NJ6FD-V_Vertical; MPN Neutrik NJ6FD-V
J11: C/Room R out TRS; Jack_6.35mm_Neutrik_NJ6FD-V_Vertical; MPN Neutrik NJ6FD-V
J12: Phones TRS; Jack_6.35mm_Neutrik_NJ6FD-V_Vertical; MPN Neutrik NJ6FD-V

Connections:
/A5_ON: CN1.20, J6.R
/A5_OP: CN1.19, J6.T
/A6_ON: CN1.23, J7.R
/A6_OP: CN1.22, J7.T
/CHASSIS: CN1.9, H1.1, H2.1, H3.1, J3.1, J3.G (SHELL), J4.1, J4.G (SHELL), J5.1, J5.G (SHELL), J6.S, J7.S, J8.S, J9.S, J10.S, J11.S
/CRL_XN: CN1.32, J10.R
/CRL_XP: CN1.31, J10.T
/CRR_XN: CN1.35, J11.R
/CRR_XP: CN1.34, J11.T
/EXT_LR: CN1.26, J8.R, J9.RN
/EXT_LT: CN1.25, J8.T, J9.TN
/EXT_RR: CN1.29, J9.R
/EXT_RT: CN1.28, J9.T
/MAIN_L_XN: CN1.11, J3.3
/MAIN_L_XP: CN1.10, J3.2
/MAIN_M_XN: CN1.17, J5.3
/MAIN_M_XP: CN1.16, J5.2
/MAIN_R_XN: CN1.14, J4.3
/MAIN_R_XP: CN1.13, J4.2
/MIX_L_RETRAW: CN1.3, J1.R
/MIX_L_SEND: CN1.1, J1.RN, J1.T
/MIX_R_RETRAW: CN1.7, J2.R
/MIX_R_SEND: CN1.5, J2.RN, J2.T
/PHJ_L: CN1.37, J12.T
/PHJ_R: CN1.38, J12.R
GNDA: CN1.2, CN1.4, CN1.6, CN1.8, CN1.12, CN1.15, CN1.18, CN1.21, CN1.24, CN1.27, CN1.30, CN1.33, CN1.36, CN1.40, J1.S, J2.S, J8.RN, J8.TN
PHONESGND: CN1.39, J12.S

Notes on the sheet:
JACK BOARD panel jacks under the panel (~24 mm deep); 2x20 IDC ribbon to the main board, pin = conductor

Board: 2 copper layers, 16 parts (1 on the bottom side), 27 nets, no tracks yet.
