cozycactus/goa-console/(commit log)

2026-10-19 Initial commit: goa-console channel strip and master section
    Channel strip: generated KiCad schematic (tools/gen.py), panel parts and
    project footprints, netlist/footprint/ERC checks, ngspice signal-path model.
    Master section: spec v0.6 (stereo mix, subs, auxes, returns, monitoring,
    meters, power entry, power-on mute), generated schematic
    (tools/gen_master.py, shared builder tools/schgen.py), DRV134 outputs,
    simulations for mix path, aux stability, meter detector and mute control.
    [channel_strip.kicad_sch, channel_strip_BOM.csv, master.kicad_sch, master_BOM.csv]
2026-10-19 Strip: VCA module socket (SSI2162 plug-in, DNP) across C13-R18
    [channel_strip.kicad_sch, channel_strip_BOM.csv]
2026-10-19 Test jig spec v0.1: master stub, load board, 11 tests
2026-10-19 Strip PCB: first placement (38 x 480 mm) via tools/place_strip.py
    Panel parts on a fixed control column, other parts packed in functional
    zones, bus headers on the bottom side. Footprints linked to symbols;
    schematic UUIDs made deterministic so the link survives regeneration.
    DRC: no courtyard overlaps, 0 schematic parity issues (unrouted).
    [channel_strip.kicad_pcb, channel_strip.kicad_sch, master.kicad_sch]
2026-10-19 Strip PCB: radial electrolytics to the bottom side
    Nine radials (D6.3-D10) moved to bottom-side zones next to their circuits,
    with no top-side parts over their solder joints, so the panel gap is set
    by the fader. DRC: no courtyard overlaps, 0 schematic parity issues.
    [channel_strip.kicad_pcb]
2026-10-19 Strip: panel stack fixed (11.5 mm), M3 standoff holes, spade and VCA socket to bottom
    Heights from the PTB100, Alpha RD901F-40 and C&K PVA drawings: PVA2 H1 with
    PV caps, 1.5 mm spacer washers on the pots, 3.5 mm fader spacer, 7.6 mm
    LED spacers. Six unplated M3 holes. DRC: no courtyard overlaps, parity 0.
    [channel_strip.kicad_pcb]
2026-10-19 Strip PCB: AGND/LGND pours joined at the spade, bus resistors by the headers
    tools/pour_strip.py: GNDA pour on B.Cu, GNDD islands on F.Cu linked along
    the right edge, GNDA on the rest of F.Cu, 369 stitching vias, escape vias
    for GNDA pads inside LGND islands. Aux 22K bus resistors moved next to the
    headers (virtual-earth ends short), NT1 next to the spade.
    DRC: no clearance/courtyard violations, grounds fully connected, parity 0.
    [channel_strip.kicad_pcb]
2026-10-19 Strip: one bus header (CN2 dropped), ribbon nets routed
    Schematic: single 34-pin header per strip on a daisy-chained ribbon with
    crimped sockets, as the Delta; spare pins no-connect. Specs and jig updated.
    PCB: header centred on the bottom, bus resistors on the side of their pins;
    tools/route_strip.py (two-layer grid router) routes MIX/SUB/AUX/PFL/PFLDET/
    GCANCEL and +-VBUS; pours re-run around them. DRC: no clearance or short
    violations, ribbon nets and grounds fully connected, parity 0.
    [channel_strip.kicad_pcb, channel_strip.kicad_sch, channel_strip_BOM.csv]
2026-10-19 Strip PCB: all signal nets routed block by block
    tools/build_strip_pcb.sh rebuilds the board: placement, then ribbon, rails
    (+LGND), audio and logic blocks, each followed by fresh pours and DRC.
    Router: there-and-back via clean-up, via reuse, 0.2 mm fallback. Pours:
    text-level strip (KiCad 10 SWIG zone removal is unsafe), clearance-aware
    escape/stitching vias, own via per top-side GNDA pad. U2 moved to the fader
    post-amp. DRC: no clearance/short/hole violations, parity 0; 5 GNDA
    pad-to-pour links left for hand finishing.
    [channel_strip.kicad_pcb]
2026-10-22 Strip PCB back to placement only; Ruslan routes copper by hand
    Removes the scripted routing, ground pours and stitching/escape vias from
    channel_strip.kicad_pcb, and deletes tools/route_strip.py and
    tools/pour_strip.py. Placement is unchanged: the generator reproduces all
    109 footprints (positions, rotations, sides, symbol links) exactly.
    place_strip.py now refuses to overwrite a board that has tracks, vias or
    zones; build_strip_pcb.sh builds placement only. AGENTS.md and CLAUDE.md
    record the scope: component placement only, no copper.
    DRC: 0 schematic-parity issues, no clearance/courtyard/hole errors,
    219 unconnected items expected.
    Also regenerates master.kicad_sch with the current builde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
    [channel_strip.kicad_pcb, master.kicad_sch, master_BOM.csv]
2026-10-22 Delta clone comparison v0.1 for sign-off
    Reads the Delta Theatre input (ED3344A/B/C, ED3151) stage by stage and
    compares it with the current strip: line gain stage, phase, HPF (sim:
    -3 dB at 92 Hz, 12 dB/oct), 4-band EQ values, post-EQ insert, ON switch,
    PAN switch, routing LEDs, aux PRE switches, direct out. Lists 7 decisions
    to sign off; nothing applied to spec or schematic yet.
2026-10-22 Delta clone: decisions recorded, input/HPF/EQ simulated
    All seven decisions in delta_clone_comparison.md signed off (no-EQ/no-trim
    reversed). Simulations:
    - sim/gain_stage.cir: receiver + inverting gain stage, -15..+14.8 dB, 0 dB
    at the detent, -105.2 dBu; the Delta line topology recalculated for the
    same range is 4.7 dB noisier and was rejected.
    - sim/delta_eq.cir: Delta HPF + 4-band EQ transcribed from ED3344A and
    ED3151 (flexi traced pin by pin; R32/R36 cross, not join, the stage
    input line). HF +-11.5 dB @12k, HI-MID +-14.6 dB 670 Hz-10.5 kHz,
    LO-MID +-14.7 dB 148 Hz-2.3 kHz (Q 1.44), LF bell +-14.3 dB @54 Hz.
    - sim/strip_v4.cir: whole channel, 0 dBu in -> PRE 0 dBu; unity
    Bu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
2026-10-22 Strip v4.0: Delta Theatre input without the mic stage
    Schematic (tools/gen.py) and spec v4.0: Phase switch, receiver + inverting
    gain stage (-15..+15 dB, centre detent), unity Butterworth HPF (87 Hz),
    Delta 4-band EQ with EQ IN switch and LED, post-EQ insert with three
    jumpers for pre-EQ, ON switch with green LED, PRE switch per aux pair
    (jumpers: pre-fader / pre-EQ), DIR + direct out, PAN switch. 7 x OPA1612.
    New tools/sim_netlist.py simulates KiCad's exported netlist directly
    (25 checks, all pass). It caught a net-name collision (EQ M1/M2 merged
    with the mute nets), fixed by prefixing EQ nets with EQ_.
    verify.py 542 pins / 0 mismatches, check_fp 180 parts / 0 problems,
    ERC 0. PCB is still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
    [channel_strip.kicad_sch, channel_strip_BOM.csv]
2026-10-22 Strip v4.0 placement: 8 HP x 12U panel, two pot columns, jacks on the panel
    Panel-height study (strip_panel_study.md): one pot column needs ~545 mm (15U),
    two columns fit 12U with ~48 mm spare. Three right-angle rear jacks need ~47 mm
    of edge on a 38 mm board, so J1/J2/J5 move to the panel as Neutrik NJ6FD-V
    (all-plastic, isolated). Frame: rails only at the panel ends.
    place_strip.py rewritten for the 180-part v4.0 netlist: fixed panel coordinates
    plus a collision-aware zone packer (courtyards per side, THT pads on both).
    Output channel_strip_v4.kicad_pcb, 38 x 444 mm, placement only. Parity DRC:
    0 issues; only the NJ6FD-V footprint's internal hole/mask items, silkscreen and
    unconnected ite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
    [channel_strip.kicad_sch, channel_strip_BOM.csv, channel_strip_v4.kicad_pcb]
2026-10-22 Strip panel study: 1/4" jacks are too deep for the main board
    A 1/4" plug goes ~30 mm into the jack, and the NJ6FD-V body is reported at ~24 mm
    behind the panel, against an 11.5 mm PCB-to-panel gap, so J1/J2/J5 as placed in
    channel_strip_v4.kicad_pcb cannot be built. Options recorded (jack board,
    panel-wired jacks, 3.5 mm jacks); jack board recommended, pending Ruslan.
    Also lists 4PDT candidates for the routing LEDs and fixes stale version and
    status lines in CLAUDE.md.
2026-10-22 Strip v4.0: jacks on a separate jack board with a 2x5 IDC link
    A 1/4" plug goes ~30 mm deep, so J1/J2/J5 (NJ6FD-V) move to a 38 x 43 mm jack
    board ~24 mm under the panel, with the input RF caps C8/C9 at J1. CN5 (jack
    board) and CN3 (main board), both on the bottom side, carry IN_T/IN_R, SEND,
    RET_RAW, DO_T/DO_R and four grounds on a 10-way ribbon (pinout = LINK in gen.py,
    spec 16.4).
    gen.py writes jack_board.kicad_sch with the main schematic. sim_netlist.py joins
    the two netlists through the ribbon: 25/25 pass with the source on J1 and the
    direct out read at J5; removing one conductor makes 23 fail. place_strip.py picks
    the layout from the parts: main board 38 x 400 mm (y 44-444, the Ø swi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
    [channel_strip.kicad_sch, channel_strip_BOM.csv, channel_strip_v4.kicad_pcb, jack_board.kicad_pcb, jack_board.kicad_sch, jack_board_BOM.csv]
2026-10-22 Strip placement: silkscreen references placed, header arrows on board
    place_strip.py now sets references to 0.8 mm and puts each at the nearest
    spot clear of pads, silk, other references, other parts' courtyards and the
    board edge, using KiCad's own shape collision. Main board DRC: 0 violations
    (was 338 silk items). CN1 turned 180 degrees and CN5 fixed in place, same pin
    fields, so their pin-1 arrows no longer hang over the edge. Jack board: only
    the NJ6FD-V footprint-internal items remain.
    Routing-LED switch: the C&K PHB 4-pole is right-angle and Alps SPUN is
    horizontal-mount, so no vertical 4PDT from a known maker; options recorded.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
    [channel_strip_v4.kicad_pcb, jack_board.kicad_pcb]
2026-10-22 Strip routing: DG413 switches at the bus end, PVA2 drives logic and LEDs
    Each routing PVA2 now carries logic only: pole A drives a DG413 (U9-U11) that
    moves each 4K7's bus end between the bus and AGND, pole B a yellow routing
    LED (D6-D8). The S pins are the common, so the bus sees the D side's charge
    injection (~5 pC at 0 V, not ~30). VL = +5VL from +VA (R80, BZX84C5V1), so it
    never exceeds V+. DG413 rather than DG403: same family and function, with a
    KiCad symbol and three makers.
    sim/routing_switch.cir (Vishay DG413 data): -0.05 dB level, THD -124 dB at
    +20 dBu (-67 dB if the switch sat at the source end), no summing-amp peaking
    up to 2.2 nF of bus capacitance, switching click -55 dBu pea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
    [channel_strip.kicad_sch, channel_strip_BOM.csv, channel_strip_v4.kicad_pcb, jack_board.kicad_pcb]
2026-10-22 Panel parts: PVA2 sense from the datasheet, pot availability checked
    C&K PVA datasheet (rev. 02/2025): common 0 is the middle pin, released 0-1,
    latched 0-2, terminals moulded "2 0 1". The footprint is symmetric under 180
    degrees, so the rule is: moulded "2" in the pad 1/4 column, which gives
    latched = 2-1 / 5-4 as drawn.
    Pots: the 10K linear centre-notch singles are stocked (1/4" shaft). The 100K
    C-law dual for the EQ frequency controls is not stocked anywhere mainstream,
    and an A-law dual can't replace it in the rheostat Wien network. Source
    decision recorded as open.
2026-10-22 Strip EQ: mid-band tuning on stocked A10K duals (KHN band-pass)
    The Delta's HI-MID / LO-MID Wien band-pass needs a 100K C-law dual that isn't
    stocked. An A-law dual can't replace it in the rheostat network (f ~ 1/R), so
    each mid band now uses a KHN state-variable band-pass set to the Wien's exact
    transfer function (peak 0.407, Q 0.275, in phase) and fed to U6A/U6B's +
    input as before. It is tuned by an Alpha A10K dual used as dividers
    (430R / 13K wiper-to-top / 4K7) into the two integrators: CW = higher
    frequency, within 0.28 octave of a log sweep (Delta C-law: 0.31).
    sim/mid_tuning.py, both versions in the same stage: same ranges, +-14.6 dB,
    Q 1.42-1.46 vs 1.40-1.45; noise 1.3 dB (HI) / 0.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
    [channel_strip.kicad_sch, channel_strip_BOM.csv, channel_strip_v4.kicad_pcb, jack_board.kicad_pcb]
2026-10-22 Test jig v0.2 for strip v4.0; current budget updated for the v4.0 strip
    Test jig: strips come with their jack boards; DG413 click target from the
    routing sim; ON replaces MUTE; the load board gets 1 nF bus-capacitance
    jumpers; a per-strip function checklist with the netlist-sim targets.
    Power: the v4.0 strip draws about 85 / 72 mA (10 x OPA1612, DG413 logic,
    LEDs), not 33 / 23 mA, so the console is about 2.65 / 2.23 A typical and up
    to 3.8 A on +V. The wing PTCs (0.75 A hold), the 5-pin XLR inlet (3 A per
    contact) and the 3 A regulators are undersized. Changes are proposed in master
    spec section 27, not yet applied.
2026-10-22 Master power entry for the v4.0 strip current: MF-RX160/72, 7-pin XLR, 4 A PSU
    The console now draws about 2.65 / 2.23 A (up to 3.8 A on +V), so:
    - Wing PTCs: Bourns MF-RX160/72 (1.6 A hold, 3.2 A trip, 72 V) instead of
    MF-R075. Not the MF-R160: it is a 30 V part, and a short between ribbon
    pins 31 and 32 puts 34 V across one PTC. New footprint from the Bourns
    MF-RX/72 dimension table; the unused MF-R075 footprint is removed.
    - Inlet: 7-pin XLR NC7MD-LX on the rear panel (5 A per contact; pin 1 earth,
    2-3 +V, 4-5 0 V, 6-7 -V), wired in 18 AWG to a Phoenix MKDS 1,5/7 terminal
    on the master. Neutrik makes no 7-pole horizontal-PCB receptacle.
    - PSU (architecture 3.3): 4 A per rail, re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
    [master.kicad_sch, master_BOM.csv]
2026-10-22 Test jig: master stub and load board schematics; master circuits in master_lib.py
    gen_master.py's part maps, reference/unit allocation and circuit functions
    move to tools/master_lib.py (with reset() and spares()); summer() and reinv()
    take the reference net as an argument. master.kicad_sch regenerates
    byte-identical.
    tools/gen_jig.py builds both jig boards from test_jig_spec.md v0.2 with the
    master's own circuits:
    - master stub: bench power with MF-RX160/72 PTCs, the ribbon header, a GC REF
    jumper (D / A) and a 22R tie jumper, MIX L/R + SUB 1 (OPA1612 4K7) and
    AUX 1/2 + PFL (OPA1656 22K) summing amps with re-inverters, BNC outputs,
    DRV134 + XLR on MIX L, PFL detect, test points (127 p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
    [jig_load_board.kicad_sch, jig_master_stub.kicad_sch]
2026-10-22 Test jig: add BOMs and intended netlists for verify.py
    [jig_load_board_BOM.csv, jig_master_stub_BOM.csv]
2026-10-22 Test jig PCBs placed; placement engine split out of place_strip.py
    tools/placer.py: place(net, out, layout) with the fixed-part, zone-packer,
    near-placement and silkscreen passes from place_strip.py, plus silk labels
    that the packer treats as occupied. place_strip.py keeps only the strip and
    jack-board layouts; both strip boards place identically (every footprint and
    label position compared).
    tools/place_jig.py places the two jig boards from the schematic's functional
    blocks and decoupling pairs (jig_*_parts.json, written by gen_jig.py from
    master_lib's allocator):
    - master stub, 160 x 125 mm: six BNCs and the balanced XLR on the front edge,
    output resistors at their BNCs, DRV134 at the X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
    [jig_load_board.kicad_pcb, jig_master_stub.kicad_pcb]
2026-10-22 PSU study v0.1: four ways to get +-17 V at 4 A per rail
    Requirements from the strip v4.0 budget (2.65 / 2.23 A typical, design 4 A
    per rail), the 7-pin XLR link and the grounding rules. Compares a linear supply
    (23-44 W per regulator, 300 VA toroid), two isolated SMPS with an LC filter and
    LDO post-regulators (12-18 W per rail, about 40 uV of switching residue before
    the LDO), SMPS with LC filtering only, and a used Soundcraft CPS275 (+-17.5 V
    5.25 A). Every option needs a crowbar per rail: a shorted pass element would
    put 21.6-29 V on rails the OPA1612 limits to +-20 V. Recommends SMPS + LC +
    LDO; waiting for Ruslan's choice.
2026-10-22 PSU option B: design, simulation and regulator-board schematic
    psu_spec.md v0.2: two isolated Mean Well LRS-150-24 at 21.6 V, LC filter
    (Bourns 2100LL-100, 2200 uF), LM1084-ADJ set to 17.0 V with a 47 uF ADJ soft
    start, as two identical floating positive regulators (+V: OUT = +V, RTN = 0 V;
    -V: OUT = 0 V, RTN = -V). Crowbar per rail: TL431 at 66K5/10K = 19.1 V drives a
    PNP into a 2N6505G SCR gate; a TL431 rather than a zener because the SCR's gate
    current would shift a zener's trip point by a volt.
    sim/psu.cir (one rail, console at the end of a 2 m cable): 165 ms soft start,
    no overshoot, 5.1 A peak SMPS current; crowbar idle margin 2.21 / 2.495 V;
    with the pass element shorted it fires in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
    [psu.kicad_sch, psu_BOM.csv]
2026-10-22 PSU board placed; heatsink and case specified
    tools/place_psu.py -> psu.kicad_pcb, 120 x 60 mm, placement only: LDOs and
    SCRs in a row on the top edge with tabs flush, for one heatsink; +V rail on
    the left, -V on the right, with each LDO's and crowbar's parts beside it; DC
    inputs, earth and the 7-way output on the bottom edge, wire openings out,
    labels for the wiring (pin order reversed by the 180-degree turn). 0
    schematic-parity issues, 0 DRC violations.
    placer.py: the ground nets ignored by near-placement are a layout option,
    and references keep off whole silk labels in the first pass. The jig boards
    are re-placed (still 0 violations); the strip boards place identically.
    psu_spec.md sect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
    [jig_load_board.kicad_pcb, jig_master_stub.kicad_pcb, psu.kicad_pcb]
2026-10-22 Master panel study v0.1: modules on the ribbon, Delta-style
    The master's panel parts (5 faders, 17 pots, 31 PVA2, 56 LEDs, 29 jacks, 3
    XLRs, from master.net) budgeted with the strip's measured pitches. Proposes
    four identical 8 HP group modules (sub n + stereo return n + aux n master, 308
    of 466 mm), each summing its own buses from the ribbon through solder-jumper
    bus selects, plus a 16 HP master module (324 mm), against one 48 HP master
    board or controls with a rear I/O box. Waiting for Ruslan's choice.
2026-10-22 Master section as modules: four group modules and a master module (M1)
    tools/gen_group.py -> group.kicad_sch: subgroup n, aux master n and stereo
    return n on one 8 HP board on the ribbon, with the master's own circuits from
    master_lib. Two banks of open solder jumpers pick the SUB and AUX bus it sums
    (group n closes SUB n and AUX n), so the four boards are identical. A local
    GCANCEL buffer feeds its re-inverters; power and grounds as a strip (10R +
    220u, spade, 10R to GCANCEL). 155 parts, 452 pins, 0 mismatches, ERC 0.
    tools/gen_master.py now builds the 16 HP master module: power entry and both
    wing headers, MIX L/R, master fader, mono, main outputs, power-on mute, aux
    masters 5-6, monitori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
    [group.kicad_sch, group_BOM.csv, master.kicad_sch, master_BOM.csv]
2026-10-22 Group and master jack boards with IDC links
    As on the strip, 1/4" jacks and XLRs need ~25 mm behind a panel parallel to
    the board, so each module's panel connectors move to a jack board on an IDC
    ribbon. master_lib gets jack() (place the jack, or record it for the jack
    board), link_pins() (pairs adjacent, a ground after each, insert send and
    return split, phones with PHONESGND beside L/R; never 2x17, so a link can't be
    mistaken for the bus ribbon) and jack_board().
    - group: group_jack_board.kicad_sch, 5 x NJ6FD-V, 2x8 link (CN3)
    - master: master_jack_board.kicad_sch, 9 x NJ6FD-V + 3 x NC3MAV vertical
    XLRs, 2x20 link (CN5)
    All four schematics: 0 mismatches, every pin on a pad, ERC 0; the l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
    [group.kicad_sch, group_BOM.csv, group_jack_board.kicad_sch, group_jack_board_BOM.csv, master.kicad_sch, master_BOM.csv, master_jack_board.kicad_sch, master_jack_board_BOM.csv]
2026-10-22 3D model of the console in Blender from the placed strip boards
    tools/export_3d.py exports the placed strip and jack board (footprint boxes, sides,
    panel feature points) to render/strip.json with KiCad's Python. tools/console_3d.py
    builds the console headless in Blender 5.2: the exact strip as a collection
    instanced 24 times, group and master panels from master_panel_study.md, a 9 degree
    tub with walnut cheeks, and a 'strip bench' scene for the stack views. Renders and
    the .blend are gitignored.
2026-10-22 Place the group and master modules (placement only) and show them in the 3D model
    place_group.py and place_master.py lay out both M1 modules and their jack boards in
    the strip's frame: same y origin, fader slot line (y 372), bus header height and
    ground spade, so the wing ribbons run straight and the faders line up. Group: bus
    switches in the strips' pan / routing / PFL rows near the header, SUB/AUX select
    jumpers under it. Master: XLR column and nine jacks on the jack board, dual fader
    between the two 20-LED meters, both wing headers, outputs and relays towards the
    jack-board link, summers between the headers, power entry on the bottom side.
    placer.py gains the shared 8 HP frame helpers, a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
    [group.kicad_pcb, group_jack_board.kicad_pcb, master.kicad_pcb, master_jack_board.kicad_pcb]
2026-10-22 Master: both fader post-amps in one OPA1612 (U5) beside the fader wiper
    master_lib.new_package() lets a pair of amps start a fresh package; the unit it
    held back is used first afterwards. gen_master.py puts the two post-amps in it, so
    U5 holds L and R and U4B (formerly the L post-amp) now runs the mono sum next to
    its network. Same circuit, references move only inside the fader block (C24-C28);
    BOM quantities unchanged. master: 1521 pins / 0 mismatches, check_fp 517 / 0,
    ERC 0; jack board unchanged.
    place_master.py takes the tall parts and the post-amp group from the netlist,
    fixes U5 across the strip under the fader's wiper end (pins 1-3 to the L wiper,
    5-7 to the R) and moves the two lowe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
    [master.kicad_pcb, master.kicad_sch, master_BOM.csv]
2026-10-22 3D model: boards from KiCad's own 3D models, hand-built panel parts
    console_3d.py now imports each board as KiCad exports it (kicad-cli pcb export
    glb: every footprint's STEP model, pads, solder mask, silkscreen), cached in
    render/glb/ and re-exported when a .kicad_pcb is newer. The parts KiCad has no
    model for are built from their footprints and the spec 16.2 panel stack: Alpha
    RD901F/RD902F pots, C&K PVA2, Neutrik NJ6FD-V and NC3MAV, Bourns PTB faders and
    MF-RX PTCs, Keystone 1287-ST tabs, M3 standoffs, the M4 star stud, with pins at
    their pads. KiCad's materials (all exported metallic) are reset to plastic or
    metal; LED models stand on their spacers just under the panel top. The panel
    lay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
2026-10-22 Placer: attach parts to their IC pins, placement report; master power entry and star point
    placer.py attach=True (strip, group, master, jig): from the netlist's pin types,
    decouplers go to their IC's supply pin, input / feedback / summing parts to the input
    pin, output networks to the output pin and chains next to their partner. Each IC keeps
    a ring sized from its own parts' area, parts wait for an IC placed later, and placement
    runs in stages (connectors and free THT parts; ICs with decouplers, inputs and THT
    parts; outputs; rest), searching 12 / 20 / 30 mm around the pin before falling back
    to the part's own zone. Shapes are precomputed and occupancy is gridded, so the master
    places in abo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
    [channel_strip_v4.kicad_pcb, group.kicad_pcb, jig_load_board.kicad_pcb, jig_master_stub.kicad_pcb, master.kicad_pcb]
2026-10-23 Part models from the manufacturers' drawings, in KiCad and Blender
    tools/models3d: one module per part KiCad has no 3D model for (Alpha RD901F/RD902F
    + knob, C&K PVA2 + PV cap, Neutrik NJ6FD-V and NC3MAV, Bourns PTB0143/0144 + knob,
    Keystone 1287-ST, Bourns MF-RX160/72), each built from its drawing and checked again
    by a second reader; shared mesh geometry, VRML and STEP writers (sRGB colours,
    outward winding, OCCT-safe facets), Blender adapter, IDC sockets and cables.
    check.py: leads vs footprint pads, body vs courtyard, writes goa-console.3dshapes
    (.wrl + .step), --kicad has kicad-cli load every STEP. preview.py renders each part.
    KiCad: footprints.py writes the model line (deterministic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
    [channel_strip_v4.kicad_pcb, group.kicad_pcb, group_jack_board.kicad_pcb, jack_board.kicad_pcb, jig_load_board.kicad_pcb, jig_master_stub.kicad_pcb, master.kicad_pcb, master.kicad_sch]
2026-10-23 Faders on the AP lever; 200 Delta Technical Manual in ref/, bus notes
    Every fader now has Bourns' AP lever, a 4.0 mm split fork, so standard 4 mm fader
    knobs fit (the BP lever was an 8 mm flat blade): PTB0143-2010APA103 on strips and
    groups, PTB0144-2010APA103 on the master. Generators, schematics, netlists, PDFs and
    BOMs regenerated (0 mismatches, check_fp 0, ERC 0 on all six; strip sim 30/30); the
    three boards re-placed for the MPN field, 0 parts moved, parity DRC 0. The part
    model has the AP fork as drawn; panel slot 106 x 2.2 in Blender.
    ref/: Soundcraft 200 Delta Technical Manual ZZ2593 (three scanned parts). Its loom
    table confirms pin 28 = PFL Audio -VE and lists 17 = Mix left / 18 =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
    [channel_strip.kicad_sch, channel_strip_BOM.csv, channel_strip_v4.kicad_pcb, group.kicad_pcb, group.kicad_sch, group_BOM.csv, master.kicad_pcb, master.kicad_sch]
2026-10-23 Delta-style panel print in the 3D model; 200 Delta panel drawings in ref/
    ref/: the 200 Delta User Guide and 300 dpi crops of its six module front-panel
    drawings (standard, deluxe, dual line and stereo inputs, group output, master) in
    ref/delta200_panels/, the reference for the panel legends.
    tools/console_3d.py: every pot gets the Delta treatment - name above, an 11-dot
    ring over the 300 degree rotation and scale numbers (EQ 15-9--0+-9-15, AUX 0-10,
    PAN L-0-R, gain -15..+15 from the gain-stage law, HI/LO-MID FREQ from
    sim/mid_tuning.py's KHN f0 at each tick). Numbers that would hit a neighbouring
    knob, switch, LED, jack or a name are left out (18 mm columns). Faders get ticks
    on both sides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
2026-10-23 Panel print as on real Delta panels; panel_print.md with the photo references
    Photos of real 200 Delta / DLX / SR modules (verified pages listed in panel_print.md)
    refine the print: one cream ink, bold condensed names, square ring dots with every
    numeral where it fits (priority: ends, top, 9 and 3 o'clock, the rest; inner sides of
    the two columns keep dots only), "15 dB 15" on EQ and gain, L5 ... 5R on pan, the
    unit on the last FREQ numeral, a bracket carrying HI MID / LO MID over each
    frequency/gain pair, full-width section rules, meter outlines, the Delta input fader
    scale with a heavier 0 bar. PRE keys now read PRE 1-2 / 3-4 / 5-6.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
2026-10-23 Pot columns at an even 20.32 mm pitch, pots turned inward, 13 mm knobs
    The two pot columns move from x 10 / 28 (18 mm apart, 3 mm between Ø15 knobs) to
    x 8.84 / 29.16: 20.32 mm within a module and across the module boundary. Every
    Alpha pot now turns its pins towards the module's centre line (left column 180
    deg, right column 0 deg), so no pad comes within 1.3 mm of a board edge; the
    jacks follow the columns. Key rows end in the right column (XR - 22 / - 11 / XR),
    the PFL/ON and AFL pairs move with it. Strip standoff H1 moves to y 65.5 (clear of
    the turned GAIN and HF pots); strip CN3 now lies across the strip at y 85.5, so the
    jack-board ribbon makes one 90 deg fold (spec 16.4). Strip, gro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
    [channel_strip_v4.kicad_pcb, group.kicad_pcb, group_jack_board.kicad_pcb, jack_board.kicad_pcb, master.kicad_pcb]
2026-10-23 Faders back on the stocked Bourns PTB BP lever
    The AP 4 mm-fork audio codes (PTB0143/0144-2010APA103) are not sold anywhere (factory
    order, MOQ ~800), and no maker stocks a 100 mm A10K fader with a 4 mm lever (ALPS
    RSA0N has a T-bar that sits too low, TT PS100 / Song Huei have blades or T-bars with
    large MOQs, Bourns PTF is obsolete). Back to PTB0143-2010BPA103 / PTB0144-2010BPA103
    (stocked: Mouser 620 / 420), the 8 x 1.3 mm blade, with caps made for an 8 mm flat
    lever. Generators, schematics, netlists, PDFs and BOMs regenerated (0 mismatches,
    check_fp 0, ERC 0, strip sim 30/30); strip, group and master re-placed for the MPN
    field (0 parts moved, parity DRC 0); fader model and its VRML/STEP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
    [channel_strip.kicad_sch, channel_strip_BOM.csv, channel_strip_v4.kicad_pcb, group.kicad_pcb, group.kicad_sch, group_BOM.csv, master.kicad_pcb, master.kicad_sch]
2026-10-23 Fader caps: Sifam LK110 for the PTB's 8 mm blade
    Research (two searches + independent checks): the Sifam LK110 with tang 01 (8.0 x 1.2
    metal flat lever, catalogue p. 12-13) is the only cap whose maker's drawing gives the
    socket depth: 4.0 mm, so on our 5.0 mm of blade it sits 1.0 mm above the panel with no
    spacer change. It is also the Delta's own "SIF low profile" fader knob (KA0062 white,
    KA0063 red). RS UK 281-7197 (black, in stock); grey / red / yellow bodies from
    pot4audio or D&R. Second choice ALPS/albs FK13x25 Lever 1 (depth not published). The
    BP blade thickness is not dimensioned, so fit two caps on a real PTB0143 first.
    Model: the fader cap is the LK110 (26 along the travel x 11.6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
2026-10-23 README: what the console is, status, repository layout, how to regenerate
    Five pictures in docs/img (renders from the 3D model and the D201 panel drawing).
    Claims and commands checked against the specs and scripts: wing topology, the jack-board
    pass in the regenerate loop, generator arguments, open items from CLAUDE.md.
2026-10-23 Master parts review: verdicts on the six v0.6 proposals, awaiting sign-off
    master_parts_review.md: GCANCEL buffer kept (spec figures were the 1 nF bus C); aux sums
    OPA1612, PFL keeps OPA1656 (aux N is always 24); 22 pF on every re-inverter, 100 pF on the
    level buffers; relays plus K6 on phones, NC-to-ground, LM393B, 4K7 resets; the generated J112
    PFL switcher does not switch, replace with a DG413; meter current sources overheat (BCP53-16
    + 120R), LM2901B, GaP LEDs; sub AFL kept, PFLDET back-feed clamp. Each verdict re-derived by a
    second reviewer. Review sims in sim/review/. No design files changed.
2026-10-23 Master parts review applied: DG413 PFL switcher, OPA1612 aux sums, six mute relays
    Signed off by Ruslan (S1-S8 as recommended, D1 100K GCANCEL keeper, D2 NE5534 line replaced);
    master spec v0.7, jig spec v0.3.
    - Re-inverters get 22 pF on both legs, level buffers 100 pF, the mono re-inverter 22 pF.
    - Aux sums on OPA1612 (an aux bus always carries all 24 strips), PFL keeps the OPA1656.
    - Six G6K relays (main, C/Room, phones), NC grounds the line; LM393B; 4K7 mute resets.
    - The series J112s did not switch: one DG413 with OPA1656 CRS followers, 1 uF debounce,
    PFLDET clamp (2 x 1N4148, 330K), 10M hysteresis.
    - Meters: BCP53-16 SOT-223 sources with 120R, LM2901B, Kingbright GaP LEDs; BZT52C6V2.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
    [group.kicad_pcb, group.kicad_sch, group_BOM.csv, jig_master_stub.kicad_pcb, jig_master_stub.kicad_sch, jig_master_stub_BOM.csv, master.kicad_pcb, master.kicad_sch]
2026-10-23 Strip review: op-amp stability with TI's model, part ratings; awaiting sign-off
    strip_parts_review.md: every OPA1612 unit on the strip in its real network (TI OPA161x model,
    Tian loop gain, 21 pot/switch/cable states; re-derived by a second reviewer with two other
    methods). The Delta EQ stages U6A/U6B/U7A (22K/22K) and the KHN summers U12A/U13B have about 0
    deg phase margin (U7A -20 deg with an insert lead); followers on pot wipers 18-51 deg; the
    receiver's one-sided 33p costs 45 deg and the ground-compensation CMRR above 1 kHz. Fixes: 15
    C0G caps, audio cost <= 0.084 dB. Ratings: OL LED at 14 mA through an 0805 1K, +5VL above V+
    at power-down (master too), RET unprotected, BOM gaps. Scripts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
2026-10-23 Strip v4.1: stability caps and ratings fixes; balanced receivers and BAT54W on master/group
    Signed off by Ruslan (strip_parts_review.md T1-T11; R71/R11 stay 75R, R15 4K7, no-phantom note).
    - Strip: 10p across both 22Ks of U6A/U6B, 22p across R67 (U7A); KHN summers 10p across the
    feedback 10K + 22p on the + input; 33p across R9 (receiver balance, CMRR 86 dB flat); 10p on
    PANWL/PANWR/M2/FPIN, 22p on DIRSRC.
    - Ratings: R15 1K -> 4K7; R99 1K into U7B's + input with C84 100p (the 1K alone dropped U7B
    to 27-40 deg); D10 BAT54W on +5VL.
    - BOM: X7R 50 V ceramics, anti-surge R1/R2/R11/R71, MPNs; every BOM exported with a DNP
    column and quoted fields (some MPNs contain commas).
    - Master/group: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
    [channel_strip.kicad_sch, channel_strip_BOM.csv, channel_strip_v4.kicad_pcb, group.kicad_pcb, group.kicad_sch, group_BOM.csv, group_jack_board_BOM.csv, jack_board_BOM.csv]
2026-10-24 Master/group review: op-amp stability with TI models, ratings and BOM; awaiting sign-off
    master_group_review.md: every master and group op-amp stage simulated in the real
    network (TI OPA161x / OPA1656 / TL072 / DRV134 models, fitted LME49600 macro,
    whole-module decks), part ratings and BOM against the strip's signed rules.
    Analysts plus three skeptics with independent decks; MG1-MG20 to sign.
    Blocking: EXT receiver output on the R jack ring net, phones composite,
    solo follower, master post-amps. Nothing in the design changed yet.
    sim/review/master, sim/review/group: the review harnesses (models via
    TI_MODELS, not in the repo). sim/review/strip/stab.py: gain-margin test no
    longer counts a ph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
2026-10-24 Master v0.8 / group rev 0.2: master/group review MG1-MG20 applied
    Signed off by Ruslan 2026-10-24 (MG14: keep MF-RX160/72; MG20: spec note, no
    aux-output relays). Generators:
    - EXT receiver outputs off the R jack's ring net (EXT_BL/BR) + 100R build-out;
    stereo_in() refuses jack-like output names
    - phones: 100p from the OPA1612 output, 22p at the + input, LME49600 beside it
    - build-outs at the pins: solo 100R, post_amp() 47R, CRS 100R, insert 75R,
    meter DET 470R (U3 feedback 10K on its pin side)
    - + input C0G: 10p post-amps, level_buffer(), group pan buffers; 22p solo,
    C/Room, phones; insert() 1K + 100p (as strip R99/C84)
    - meter peak detector reads the diode cathode, 220R, 22p; 22p acr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
    [group.kicad_pcb, group.kicad_sch, group_BOM.csv, group_jack_board.kicad_pcb, group_jack_board.kicad_sch, group_jack_board_BOM.csv, jig_load_board.kicad_pcb, jig_load_board.kicad_sch]
2026-10-24 Whole-console simulation from the generated netlists (tools/sim_console.py)
    24 strips, 4 groups and the master, each with its jack board, on the
    34-way ribbon (R/L per conductor per 41 mm segment, capacitance to the next
    conductor), every module on its own ground through the ribbon's ground
    conductors and its spade, op-amp outputs returning through that ground.
    Single-pole op-amps with datasheet voltage and current noise, behavioural
    DRV134 / LME49600, relays energised, DG413s from their logic.
    32 checks: levels (0 dBu in gives -0.8 dBu at the XLRs with every fader
    at "0": loaded fader marks, +9.93 dB post-amps, build-outs), mutes and
    routing, subs, auxes, PFL, returns, EXT, crosstalk, grou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
2026-10-24 Film couplers and MUSE ES bipolars: proposal for sign-off
    film_np_proposal.md (F1-F4): X7R 2.2 uF signal couplers to WIMA MKS2 film
    (THT, bottom side), bipolar electrolytics to Nichicon MUSE ES 25 V in the
    current footprints (47 -> 33 uF, 220 -> 100 uF; LF -3 dB 1.5 -> 2.3 Hz,
    -0.04 dB at 20 Hz). Trial-applied in a scratch worktree: every board
    0 mismatches / check_fp 0 / ERC 0, sim_netlist 30/30, sim_console 32/32,
    strip / group / master re-placed with 0 DRC and 0 parity issues. Also
    found: the committed strip's C49 (2.2 uF MKS2, 13 mm tall) sits on the top
    side under the 11.5 mm panel gap. The generator and layout edits are in
    film_np_proposal.patch. Nothing in the design changed.
    Co-Auth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
2026-10-24 Strip v4.2 / master v0.8: film couplers and MUSE ES bipolars (F1-F4)
    Signed off by Ruslan 2026-10-24 (film_np_proposal.md, applied from
    film_np_proposal.patch):
    - every 2.2 uF X7R signal coupler (strip C13; group 4; master 9) and the
    meter's averaging caps -> WIMA MKS2C042201K00KSSD PET film, THT on the
    bottom side; strip C49 (existing film) gets the MPN and moves to the bottom:
    at 13 mm it sat under the 11.5 mm panel gap
    - bipolar electrolytics -> Nichicon MUSE ES 25 V in the existing footprints:
    47 -> 33 uF, 220 -> 100 uF, 10 uF; end-to-end LF -3 dB 2.3 Hz (was 1.5)
    - layouts: strip C13/C49 bottom zones, group tall-part rule includes film
    Every board 0 mismatches / check_fp 0 / ER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
    [channel_strip.kicad_sch, channel_strip_BOM.csv, channel_strip_v4.kicad_pcb, group.kicad_pcb, group.kicad_sch, group_BOM.csv, group_jack_board.kicad_pcb, jack_board.kicad_pcb]
2026-10-24 Strip noise proposal (EQ current noise); stability harness fixes
    strip_noise_proposal.md: the strip's PRE noise with EQ in (-92.9 dBu) is
    OPA1612 current noise in the four Delta EQ stages, the KHN integrators and
    the receiver; OPA1656 in U1, U5-U7, U12-U14 gives -96.1 dBu (-81.9 dBu at
    the console with 24 strips, from -79.2). Not ready to sign as a design
    change: TI's OPA1656 model doesn't reach an operating point in the full
    strip deck, and the CMOS-input distortion question needs a bench A/B on
    the jig (N1). Scripts in sim/review/strip_noise/.
    sim/review/strip: OPA1656_UNITS option (OPA1656 model per package);
    run_config() deletes a tag's old raw files and reports a failed operating
    point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
2026-10-24 Master placement: the 6.2 V mute reference beside its comparators
    gen_master.py records the BZT52C6V2, its 4K7 feed and the 22K divider
    beside U10 (rail sense), and U11 (mute Schmitt) beside U10. VREF6 now runs
    <= 21 mm to U11 and 9 mm to U10 (was ~108 mm); the master's worst high-Z
    report row drops from 108 to 38.5 mm (a meter ladder tap, DC). Netlist
    unchanged; re-placed: 0 DRC violations, 0 parity issues.
    [master.kicad_pcb, master_jack_board.kicad_pcb]
2026-10-24 Sweepable HPF: proposal for sign-off (H1-H4)
    A state-variable high-pass, 21-403 Hz, unity gain, non-inverting, Q 0.707, tuned by the
    mid bands' stocked A10K dual (RV16) as dividers into U15's integrators; U5A becomes the
    summer. SW11 selects HIN (HPF out, no added noise) or HP. C91 33 uF MUSE ES doubles C38,
    which now feeds the EQ directly with the HPF out (PRE LF corner 1.0 Hz instead of 1.9 Hz).
    Trial in a throwaway worktree (hpf_proposal.patch): 260 parts / 774 pins, 0 mismatches,
    check_fp 0, ERC 0; sim_netlist 35/35 (HPF at CCW/mid/CW 21.2/85.9/406 Hz, no peaking);
    sim_console 32/32; TI model in the full strip: U5A 84.3 deg, U15 87.4 deg; strip re-placed
    with 0 DRC violations and 0 pari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
2026-10-24 Strip v4.3 / master v0.9: sweepable HPF and MF-RX185/72 wing PTCs (H1-H4)
    Signed off by Ruslan (hpf_proposal.md H1-H4 as proposed, MF-RX185/72 for H4).
    - Strip: state-variable high-pass 21-403 Hz (85 Hz at mid rotation), unity, Q 0.707:
    U5A summer (10p / 22p stability caps), new U15 integrators, RV16 A10K dual as dividers
    (330R / 13K / 5K6). SW11 selects HP or HIN, so HPF out is a wire. C91 33 uF MUSE ES
    doubles C38 (HIN now feeds the EQ directly): PRE LF corner 1.0 Hz. C39/C40/R48/R49 gone.
    - Panel: Ø key y 50, HPF IN key y 61, HPF FREQ knob y 76; OL LED at (20.6, 50); scale
    20 / 50 / 85 / 170 / 400Hz (console_3d, panel_print.md, new panel_strip_top.png view).
    CN3 to y 131.5 (the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
    [channel_strip.kicad_sch, channel_strip_BOM.csv, channel_strip_v4.kicad_pcb, master.kicad_pcb, master.kicad_sch, master_BOM.csv]
2026-10-24 Strip schematic drawn: real circuits instead of labelled parts in rows
    Every block of channel_strip.kicad_sch is now drawn as a schematic, stage by stage as on the
    Delta sheets: wires, junctions, labels only where a net leaves its drawing, one ~1001 x 759 mm
    sheet in signal-order columns.
    - tools/schdraw.py: placement (rotation / mirror on the 2.54 grid), polylines, automatic
    junctions; checks before writing that no wire joins two nets.
    - tools/strip_draw.py: one function per block; helpers for the inverting EQ stage, the
    state-variable core (HPF and both mid bands), followers and switch / LED poles.
    - tools/schgen.py: drawn-block path, per-part field layout, KiCad 10 pin-number / pin-na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
    [channel_strip.kicad_sch, channel_strip_v4.kicad_pcb, group.kicad_sch, group_jack_board.kicad_sch, jack_board.kicad_sch, jig_load_board.kicad_sch, jig_master_stub.kicad_sch, master.kicad_sch]
2026-10-24 Group schematic drawn: master_lib circuits draw themselves
    Each master_lib circuit function now registers a drawing fragment of its own parts
    (tools/frags.py): summer (inverting), re-inverter and balanced receiver (difference amp),
    post-amp and level buffer (non-inverting), insert, follower, DRV134, mute relay, routing
    switch, AFL key, an IC's power unit with its decouplers, plus generic chains (series /
    shunt) and pots. schgen.flow() lays a block's fragments out in rows, power units last, and
    puts any part no fragment drew in labelled rows under them, so nothing can go missing.
    gen_group.py draws the ground-cancel and pan buffers, couplers, pots and AFL feeds the same
    way; the sheet is in c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
    [group.kicad_pcb, group.kicad_sch]
2026-10-24 Master schematic drawn: fragments for the master's own circuits
    The master is drawn like the group: the master_lib circuits draw themselves, and
    gen_master.py registers fragments for its own parts:
    - mono (two inverting stages, the first with two inputs);
    - the solo, CRS and C/Room followers, the phones composite (OPA1612 + LME49600 in the loop);
    - couplers and build-outs as chains;
    - dividers, pull-ups, the mute timer and release paths, PFL detect and the flasher as chains;
    - the meter threshold ladders and both 10-LED strings per side as chains, the current sources.
    The DG413s, the comparators (mute, PFL detect, flasher, the 40 meter LM2901 sections) and
    the power entry stay as labelled pa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
    [group.kicad_sch, master.kicad_pcb, master.kicad_sch]
2026-10-24 Group PDF re-exported after the chain spacing fixes
2026-10-24 Master schematic: comparator logic, PFL switcher and meter detectors drawn
    Mute window, Schmitt and relay NPN, PFL detect, flasher, the DG413 switcher pairs and
    the meter half-wave rectifiers / sums / peak detectors are now drawn fragments.
    Zener and transistor field layouts, wider chain spacing before ground symbols.
    master 1642 pins / group 485, 0 mismatches, check_fp 0, ERC 0; sim_netlist 35/35,
    sim_console 32/32. Master re-placed for the drawn meter nets' names: 0 parts moved,
    0 DRC violations, 0 parity issues; group board unchanged (parity 0).
    [group.kicad_sch, master.kicad_pcb, master.kicad_sch]
2026-10-24 Master schematic fully drawn: meter strings, power entry, spares, headers
    Meter LED strings drawn with each LM2901 on its LED's anode and the BCP53 source on
    top; +5VL supply, DG413 supply unit, power entry (terminal, SS54 clamps, M4 tab, net
    ties), PWR_FLAGs and the op-amp spares are fragments now, so nothing on the group or
    master is left in labelled rows. Headers get a stub per pin to a horizontal label,
    runs of one net joined. Builder: hidden pin numbers / names for power symbols, BJTs,
    PSU terminal and link headers; texts of 90-degree diodes, net ties, tabs and headers.
    Every sheet 0 mismatches, check_fp 0, ERC 0; netlists unchanged but the master's
    drawn LED-string net names; sim_netli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
    [channel_strip.kicad_sch, group.kicad_sch, group_jack_board.kicad_sch, jack_board.kicad_sch, jig_load_board.kicad_sch, jig_master_stub.kicad_sch, master.kicad_pcb, master.kicad_sch]
2026-10-24 Schematics: legibility pass on the strip, group and master
    Proof-read tile by tile (two passes) and fixed what overlapped or misled:
    - builder: up/down labels pointed back over their own wire; op-amp / comparator text
    layout for every op-amp key; cap, ferrite, PTC, DRV134, trimmer, pot, header, jumper,
    LME49600 and DG413 texts clear of bodies and wires; justification follows rotation
    and Y-mirror; unwired pins labelled the way the pin points; text side per unit
    - GNDM / PHONESGND are project power symbols with their names shown
    - fragments are measured (label texts included) so neighbours don't collide
    - fragment and strip layouts: feedback, shunt, follower, relay, peak detector, meter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
    [channel_strip.kicad_sch, channel_strip_v4.kicad_pcb, group.kicad_sch, group_jack_board.kicad_sch, jack_board.kicad_sch, jig_load_board.kicad_sch, jig_master_stub.kicad_sch, master.kicad_pcb]
2026-10-24 Schematics: third legibility pass
    Fixes from the third tile-by-tile proof-read of the strip, group and master:
    relays ground their NC contacts on one lifted symbol (its name clear of the contact
    labels); DRV134 and phones decouplers clear of the output labels / each other; pot
    texts on the far side from the wiper; chains leave room for long values and put an
    LED's texts below; follower shunt cap and loop; power-entry joins and net-tie texts
    off the wires; DG413 references above their pin numbers; KHN frequency-pot values
    left of the summer line; RV10, R46, C43, C16/C17, D10 and the routing control labels;
    no-connect flags only on pins that need one (not the SOT-23 diodes' NC-type pins);
    JFET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
    [channel_strip.kicad_sch, group.kicad_sch, master.kicad_sch]
2026-10-24 Master schematic split into hierarchical A4 sheets
    master.kicad_sch is now a root sheet with one sheet symbol per page; the 27 pages in
    master_sheets/ are generated by build(pages=...): each block's fragments packed in rows
    onto A4 (a block runs on to the next page as "(cont.)", a later smaller fragment can
    fill a page), global labels between pages, the meter LED strings drawn in two columns
    of five. PWR_FLAGs moved beside pins of their own nets (power entry rails, net ties,
    distribution chains) so every page passes ERC. The flat path (strip, group) is
    unchanged byte for byte.
    Netlist identical: 563 components, 361 nets with the same pin sets (four LED-string mid
    nodes now carry their intend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
    [02_ground_cancel_buffer.kicad_sch, 03_mix_l.kicad_sch, 04_mix_r.kicad_sch, 05_master_fader.kicad_sch, 06_main_outputs.kicad_sch, 07_main_outputs.kicad_sch, 08_power_on_mute.kicad_sch, 09_aux_master_5.kicad_sch]
2026-10-24 Strip and group schematics on hierarchical A4 sheets
    Like the master: a root sheet with one sheet symbol per page, the pages generated into
    strip_sheets/ (14) and group_sheets/ (7). The page packer takes drawn blocks too; a
    strip_draw block too big for a page is a list of pieces (KHN per band, routing per
    assign key, power entry in rows) packed apart, measured tight (notes included), drawn
    in turn on a flat sheet. Page titles cut at the first comma / dash; shorter project
    titles and comments so the title block holds them.
    Netlists identical (strip 260 parts / 194 nets, group 170 / 117, same pin sets, no
    renames); verify 0 mismatches, ERC 0 on every board; BOMs unchanged; sim_netlist 35/35,
    s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
    [02_bus_select.kicad_sch, 02_line_input.kicad_sch, 03_hpf.kicad_sch, 03_subgroup.kicad_sch, 04_eq.kicad_sch, 04_subgroup.kicad_sch, 05_aux_master.kicad_sch, 05_eq_mid_tuning.kicad_sch]
2026-10-24 Pan pot note: ALPS RK09L1240015 is the vertical centre-detent dual, not RK097121TD57
    RK097121TD57 is a horizontal (right-angle) RK097 part and can't stand under the panel.
    The ALPS catalogue's vertical dual 10K 1B with centre detent is RK09L1240015 (M9 x 0.75
    bushing, 6 mm D-flat shaft, KiCad footprint Potentiometer_Alps_RK09L_Double_Vertical);
    stocked at Mouser and Verical on 2026-10-25.
2026-10-24 Pan pot RV8: ALPS RK09L1240015 (vertical dual 10K B, centre detent)
    No Alpha B10K dual with a centre detent exists; the ALPS RK09L1240015 is stocked (Mouser,
    Verical). Catalogue RV01 Drawing No.7: M9 x 0.75 bushing 5 long, Ø6 flatted shaft 15 from
    the face, mounting face 10 above the board like the Alpha. KiCad footprint
    Potentiometer_Alps_RK09L_Double_Vertical (pin rows 7.5 / 10 mm from the shaft, gangs
    swapped); placer shaft offset (10, 2.5) via pot(..., sx=10); part model
    tools/models3d/alps_rk09l.py (6 mm D knob, M9 nut, Ø9.5 panel hole; KiCad loads the STEP).
    Netlist unchanged: 774 pins, 0 mismatches, check_fp 0, ERC 0; sim_netlist 35/35,
    sim_console 32/32. Strip re-placed: 35 small p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
    [11_pan_pan_buffers.kicad_sch, channel_strip_BOM.csv, channel_strip_v4.kicad_pcb]
2026-10-24 3D model: ground harness, spade to star, and a wiring view
    Each strip's and group's 6.3 mm ground spade gets a receptacle and one yellow wire down to
    the tub floor and along it, radially (no daisy chain), to a ring lug on the master's M4
    star stud (master spec 26, architecture 3.4): 28 wires in a 'ground harness' collection.
    New render wiring.png: the console from below with the tub, frame and desk hidden, lit from
    below. light() returns its object.
2026-10-24 Ground-and-hum study: harness geometry, gauge, magnetic pickup, LED returns, synth loops
    ground_study.md + sim/review/ground/ground_study.py: spade-wire lengths and loop areas from the 3D build,
    the whole-console deck with per-module spade R/L and induced EMFs (sim_console.console spade=, spade_emf=),
    LED return steps, and a Monte Carlo of the strip receiver against earthed-synth ground loops.
    Proposals G1-G4 (harness under the motherloom in 14 AWG, balanced-input sleeves to chassis, buffered
    receiver, desk practice) for sign-off; nothing applied. sim_console 32/32.
2026-10-24 3D model: fly-through camera and its preview / final render script
    console_3d.py flythrough(): 30 s camera path over the console, panels and frame fade out to show the
    boards and the harness; tools/fly_render.py preview (Workbench mp4) and final (EEVEE PNG frames, resumable).
    Rendered video and frames are gitignored.
2026-10-24 Ground and hum G1-G3 applied: harness under the motherloom, chassis sleeves, buffered strip receiver
    Signed off by Ruslan 2026-10-25 (ground_study.md G1-G3; strip spec v4.4, master spec v0.10).
    - G1: 14 AWG spade wires tied under each motherloom to two copper bars under the star stud, drawn in
    console_3d.py; sim_console.py models every spade wire from that harness by default (SPADE_WIRE).
    - G2: balanced-input sleeves on CHASSIS (strip J1/J5 and C8/C9, group returns, master EXT), plated CHASSIS
    standoff holes on the three jack boards (MHPAD symbol); the group keeps CHASSIS off its link.
    - G3: U16 OPA1656 input followers with 1M bias per leg, 220R in, 100R build-outs (>= 48.5 deg for any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
    [02_line_input.kicad_sch, 03_hpf.kicad_sch, 04_eq.kicad_sch, 05_eq_mid_tuning.kicad_sch, 06_eq_mid_tuning.kicad_sch, 07_insert.kicad_sch, 08_pfl.kicad_sch, 09_fader_post_amp.kicad_sch]
2026-10-24 Accept the PSU worst corner of ~4.24 A with the OPA1656 input followers
    Ruslan, 2026-10-25: U16 stays OPA1656; master spec 27 / 29, ground_study.md and CLAUDE.md note the
    accepted corner (every op-amp at maximum IQ and every LED lit; typical 3.01 A).
2026-10-25 Wing power proposal (W1 pin 34 as a third +V conductor, W2 MF-RX250/72 on +V); correct the PTC note
    The female IDC sockets are rated 1 A per contact and the MF-RX185/72 derates to 1.33 A hold at 50 C, at a
    wing's typical +V load. wing_power_proposal.md for sign-off; master spec 27 now says a PTC trip is possible
    in the accepted worst corner.
2026-10-25 Wing power W1-W2 applied: pin 34 as a third +V conductor, MF-RX250/72 +V wing PTCs
    Signed off by Ruslan 2026-10-25 (wing_power_proposal.md). The female IDC sockets are rated 1 A per contact
    and the MF-RX185/72 derated to a wing's typical load at 50 C.
    - W1: pin 34 (the Delta's +48 V) on +VBUS on every strip, group, master and jig header.
    - W2: F1/F3 MF-RX250/72 (new 10.16 mm footprint and 3D model); -V keeps the MF-RX185/72. F1 in its row,
    F3 vertical by the master's right edge, spots searched clear of every other part.
    Checks: 0 mismatches, check_fp 0, ERC 0 everywhere; sim_netlist 37/37, sim_console 32/32; parity DRC clean
    on all eight boards; master report unchanged, every other board m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
    [08_power_and_grounds.kicad_sch, 15_power_entry.kicad_sch, 26_power_entry.kicad_sch, 27_distribution.kicad_sch, 28_remote_meter_header.kicad_sch, channel_strip_v4.kicad_pcb, group.kicad_pcb, jig_load_board.kicad_pcb]
2026-10-25 N1 (OPA1656 in the strip's high-impedance stages) re-evaluated on strip v4.4: noise, stability, power
    - noise.py n1: PRE EQ in -92.8 -> -96.1 dBu (U15 joins the set; U16 already OPA1656); 24 strips at main L
    -79.2 -> -81.9 dBu.
    - stripdeck.py: OPA1656 parts (U16) and OPA_MODEL=fit (datasheet-fitted OPA1612M / OPA1656M), since TI's
    OPA1656 model still won't solve in the strip deck; n1_stab.py / n1_compare.py run the 21 states three ways.
    The fit reads 3-24 deg below TI as built; with N1 every unit stays >= 50.1 deg (U7B), integrators -10 deg.
    - Power: +4.8 mA typ per strip and rail, +115 mA console-wide; worst corner ~4.28 A.
    Distortion stays open (jig A/B). Not signed off.
    Co-Authored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
2026-10-25 Ground study 10: proposal G2b (DRV134 TRS output sleeves on CHASSIS) and G3b (buffered group return / EXT receivers)
2026-10-25 Ground study 10: correct the return-jack normals note
2026-10-25 G2b / G3b applied: TRS output sleeves on CHASSIS, buffered group return and master EXT receivers; centred global labels
    Signed off by Ruslan 2026-10-25 (ground_study.md 10).
    - G2b: group sub / aux out, master aux 5 / 6 and C/Room L / R sleeves on CHASSIS.
    - G3b: master_lib.receiver() puts the strip's U16 circuit in front of the bridge (OPA1656 followers, 1M per
    leg, 220R, 100R build-outs); created last (master_lib.DEFER) so no existing ref changes; drawn by
    frags.rx_buffers; the L jack's normals short an empty input. +78 mA per rail.
    - Placement trial: group fits with its report no worse; master EXT followers in a last zone, report unchanged;
    parity DRC clean on all four boards.
    - schg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
    [02_bus_select.kicad_sch, 02_ground_cancel_buffer.kicad_sch, 02_line_input.kicad_sch, 03_hpf.kicad_sch, 03_mix_l.kicad_sch, 03_subgroup.kicad_sch, 04_eq.kicad_sch, 04_mix_r.kicad_sch]
2026-10-25 Follower input caps: 100 pF at every OPA1656 follower's + input (strip C94/C95, receivers' 100p moved)
    The group returns' stability sweep (TI OPA161x + fitted OPA1656M; groupdeck OPA1656_FIT, sweep ret now probes the
    followers) read the followers at 40 deg / 3.4 dB peaking: the 220R in front of each + input against the
    OPA1656's 9.1 pF input capacitance. A 100 pF C0G after the 220R fixes it: 53.1 deg (group), 54.1 deg (strip
    deck), peaking <= 1.24 dB; receivers and level buffers unchanged (>= 69.8 deg, TI).
    Checks: 0 mismatches, check_fp 0, ERC 0; sim_netlist 37/37, sim_console 32/32; strip / group / master
    re-placed (strip C38/C91 zone to y 120), parity DRC clean on all six boards.
    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
    [02_line_input.kicad_sch, 03_hpf.kicad_sch, 04_eq.kicad_sch, 05_eq_mid_tuning.kicad_sch, 06_eq_mid_tuning.kicad_sch, 06_stereo_return.kicad_sch, 07_insert.kicad_sch, 08_pfl.kicad_sch]
2026-10-25 Close the strip's simulation gaps; proposals K1 (PFL DC block) and K3 (overload LED attack + hold)
    sim/review/gaps/: overload detector (threshold +18.4 dBu flat, but short peaks missed), soft mute (floor -79 dB
    worst rds, click <= -81 dBu), key clicks with real op-amp offsets (PFL up to 11.5 mV on PFL; others <= 2.6 mV),
    200-strip tolerance Monte Carlo (unity +-0.5 dB, EQ bands +-0.5..1.9 dB), headroom at every op-amp output (no
    internal node clips early; unity +23 dBu). gaps_proposal.md: K1 and K3 simulated, for sign-off.
2026-10-25 Strip v4.5: K1 PFL send DC block (C96) and K3 overload LED attack + hold (C12 100n, U4B hold stage)
    Signed off by Ruslan 2026-10-25 (gaps_proposal.md).
    - K1: C96 2.2u film in series with R32: the PFL key no longer puts PRE's bias-current DC (up to 11.5 mV) on the
    PFL bus; keys.py PFL step 0.
    - K3: C12 1u -> 100n (0.1 ms attack); U4A discharges OL_HOLD (R115 1M / C97 220n), U4B drives the LED: lit
    154-192 ms from 2 cycles at +19 dBu, threshold +18.2..18.5 dBu (ol.py now simulates the built circuit).
    Checks: 806 pins / 0 mismatches, check_fp 0, ERC 0; sim_netlist 37/37, sim_console 32/32; strip re-placed,
    parity DRC clean.
    [07_insert.kicad_sch, 08_pfl.kicad_sch, 09_fader_post_amp.kicad_sch, 10_aux_sends.kicad_sch, 11_pan_pan_buffers.kicad_sch, 12_routing_matrix.kicad_sch, 13_routing_matrix.kicad_sch, 14_power_entry.kicad_sch]
2026-10-25 Design review applied: DRV135UA, group pan RK09L, jig R45, PVA2 silk marks, ON mutes the pre sends, doc / BOM drift
    Signed off by Ruslan 2026-10-25 (design_review.md R1-R5, Q1).
    - R1: every balanced driver TI DRV135UA (the DRV134 is DIP-8 / SOL-16 only; SO-8 = DRV135, same pinout).
    - R2: group sub pan RV2 = ALPS RK09L1240015, as the strip's RV8.
    - R3: jig R45 ERJ-P06J332V (0.31 W), jig R1/R2 anti-surge.
    - R4: placer prints a silk "2" beside pads 1/4 of every PVA2, inside the switch outline.
    - Q1: pre-fade taps JP2-JP4 from MUTEOUT: ON mutes the pre sends and the direct out (-86 dB, two new
    sim_netlist checks); U3B 59.8 deg worst on TI's model, 72-74 elsewhere.
    - R5: strip MPNs (C0G, electr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
    [02_line_input.kicad_sch, 03_hpf.kicad_sch, 03_subgroup.kicad_sch, 04_eq.kicad_sch, 05_aux_master.kicad_sch, 05_eq_mid_tuning.kicad_sch, 06_eq_mid_tuning.kicad_sch, 06_main_outputs.kicad_sch]
2026-10-25 BOM sourcing check: order codes, missing MPNs, strip caps that fit their footprints; S1 (10 uF NP discontinued) for sign-off
    - Order codes: MF-RX ...-0, GRM21BR71H105KA12L, BAT54W,115, LM1084IT-ADJ/NOPB, LME49600TS/NOPB, Phoenix 1755897 /
    1715721 / 1715734; SS54 -> Diodes B540C-13-F, S1G -> Diodes S1G-13-F.
    - Strip: C0G MPNs in 1206 (the footprint), the five missing C0G values, C1/C3 Rubycon 35ZLH220MEFC8X11.5 (D8) and
    C5/C6 Panasonic EEU-FR1H470 (D6.3), D1 1N4148-TAP; jack board C8/C9.
    - Group C1/C2 UHE1V221MPD6 (UPW1V221MPD not for new designs); PSU caps and LEDs; master R57 22M, CN4.
    - sourcing.md: what changed, stock risks (PTB0143, NJ6FD-V, OPA1612, WIMA 2.2 uF), S1 proposal.
    - Ever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
    [02_line_input.kicad_sch, 03_hpf.kicad_sch, 04_eq.kicad_sch, 05_eq_mid_tuning.kicad_sch, 06_eq_mid_tuning.kicad_sch, 07_insert.kicad_sch, 07_main_outputs.kicad_sch, 08_jack_board_link.kicad_sch]
2026-10-25 S1 signed off and applied: 10 uF NP -> Panasonic ECE-A1EN100U (UES1E100MDM discontinued)
    DRV135 sense legs (master 14, group 4, jig 2) and the master's LME49600 +-VP bypasses; same 5 x 11 / P2.0 can.
    0 mismatches, check_fp 0, ERC 0; group / master / jig stub re-placed for the field, 0 parts moved, parity DRC clean.
    [03_subgroup.kicad_sch, 05_aux_master.kicad_sch, 06_main_outputs.kicad_sch, 07_main_outputs.kicad_sch, 09_aux_master_5.kicad_sch, 10_aux_master_6.kicad_sch, 16_control_room.kicad_sch, 17_control_room.kicad_sch]
2026-10-25 Console-wide order list (tools/order_bom.py -> order_bom.csv); C48 -> MKS2D031501C00KSSD; OPA1656IDR everywhere
    - order_bom.py: each board's BOM x boards built, one line per order code, spares by kind, Yageo codes for the plain
    0805 resistors, the jig A/B OPA1656s; 162 lines, 7995 parts.
    - C48 150 nF film: the 63 V KSSD code has no stock; the 100 V MKS2D031501C00KSSD (3.5 x 8.5 x 7.2, P5) fits W4.5.
    - One OPA1656 order code (IDR) on master / group / jig; B540C MPN text unified.
    - 0 mismatches, check_fp 0, ERC 0; sim_netlist 39/39, sim_console 32/32; re-placed for the fields: 0 parts moved,
    parity DRC clean on the strip, group, master, jig stub and PSU.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
    [04_eq.kicad_sch, 06_stereo_return.kicad_sch, 07_stereo_return.kicad_sch, 11_aux_master_6.kicad_sch, 12_ext_input.kicad_sch, 13_pfl_afl.kicad_sch, 14_pfl_switcher.kicad_sch, channel_strip_BOM.csv]
2026-10-25 offboard_bom.md: every part not on a board BOM, with console counts and what is still open
    Panel hardware (knobs, PV / fader caps, M7 / M9 spacer washers, LED spacers, 11.5 / 24.0 mm standoffs, fader screws
    and spacers), panels and frame, IDC sockets (Wurth 612xx23021) and ribbon, the G1 harness cut list (28 wires,
    16.1 m), PSU chassis parts. Open decisions: knobs, cap colours, panel maker and fabrication drawings, frame, PSU case.
2026-10-25 Front-panel fabrication drawings (panels/) from a shared panel layout
    - tools/panel_layout.py: the panel geometry and Delta-style print moved out of console_3d.py (no Blender), so the 3D
    model and the drawings share one source; console_3d.py builds its panel layer from it (build checked, Blender 5.2).
    - tools/panel_fab.py: per panel R12 DXF (OUTLINE / CUT / LEGEND, text as outlines), 1:1 SVG / PDF artwork, PNG
    preview, hole table; numbered strip (1-24) and group (1-4) PDFs; checks: web >= 1.0, edge >= 1.0, no cut-out over
    the frame rails, print clear of cut-outs. All three panels pass.
    - Fader scale: marked from the bottom up so the infinity mark always prints and crowded ticks (< 1.2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
    [group.dxf, group_holes.csv, master.dxf, master_holes.csv, strip.dxf, strip_holes.csv]
2026-10-25 knob_proposal.md: Elma 14.5 mm collet knobs (021-3525 / 021-3425) with 040 caps, KN1-KN3 for sign-off
    Sifam's 13 mm knobs take <= 4 mm shafts and its 1/4" knobs start at 15.5 mm; Elma's classic collet knob has both 6.35
    and 6 mm bores at 14.5 mm with six cap colours. At 14.5 the print keeps all but one ring numeral; closest gaps 2.77 mm
    (GAIN to the OL LED) and 5.82 mm knob to knob. Cap colours mapped to Elma's six; cost estimate.
2026-10-25 KN1-KN3 signed off and applied: Elma 14.5 mm collet knobs, 040 caps, print and model at 14.5
    - models3d/knob.py: Elma classic collet knob (021-3525 / 021-3425), 0.4 above the M7 nut, Elma 040 cap; the big
    C/ROOM knob is gone (alpha_pot / alps_rk09l panel(), console_3d.py, panel_layout.py).
    - Cap colours in panel_layout.py: GAIN / SOLO red, EQ gains / C/ROOM / PHONES grey, FREQs / HPF / RETURN blue,
    AUX 1-2 yellow, AUX 3-4 green, AUX 5-6 / PAN / SUB PAN black.
    - Print: optional numerals now drop within 0.5 mm of the plate edge or 1.2 mm of another knob's text (the larger
    ring pushed edge-column 9s off the plate and neighbours read as '9 50'); strip 158 -> 137 ring numerals, every
    name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
    [group.dxf, master.dxf, strip.dxf]
2026-10-25 KC1 / KC2 signed off and applied: C&K PV key caps by function (ON black, DIR grey), Sifam black LK111 01 fader caps
    - panel_layout.py: ON black, DIR grey, fader caps black in the model; no green PV cap exists.
    - offboard_bom.md: PVGY x193, PVWH x88, PVRD x38, PVBK x24; fader caps LK111 01 (or 02 LK110 01) and the
    coloured-cap trial at the fader sample check.
    - CLAUDE.md decisions; knob_proposal.md signed off. 3D model rebuilt; panel drawings unchanged.
2026-10-25 frame_proposal.md: 10 x 50 aluminium flat-bar rails (FR1-FR3) for sign-off
    The model's 10 x 10 rail would sag 26 mm over the 1.22 m span; 10 x 50 6060-T6 gives 0.21 mm under the console's weight
    and 0.53 mm under a 100 N lean, without a centre post, and clears everything below the panel ends. 30 M3 tapped holes
    per rail from the panel screw pattern; cheek rebates, bonding to the M4 star.
2026-10-25 FR1-FR3 signed off and applied: 10 x 50 flat-bar frame rails, drawing in frame/
    - panel_layout.py: module order, rail section / lines / span and the rail holes from the panel screw pattern, shared by
    panel_fab.py, frame_fab.py and console_3d.py (rails and cheeks built from them).
    - tools/frame_fab.py -> frame/rail.dxf, rail_holes.csv, rail.pdf: 1227.2 mm (corrected from 1223.2: the cheek faces
    are 2 mm outside the console), 30 x M3 top, 2 x M4 per end, M4 bond hole; checks every panel screw lands on a rail.
    - panels re-checked against the new rail band (all pass); 3D model rebuilt.
    - offboard_bom.md (rails, tub), panels/README.md, CLAUDE.md, frame_proposal.md signed off.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
    [rail.dxf, rail_holes.csv]
2026-10-25 psu_case_proposal.md: Hammond 1402KV case, Fischer SK 47 75 SA side heatsink, rear DD11 inlet (PC1-PC3) for sign-off
    Thermal sizing rechecked at the accepted 4.33 A worst corner: 38.3 W, +V LDO junction 108 / 113 C at 30 / 35 C room
    with the 75 mm SK 47 (102.6 / 107.6 C with the 100 mm one, which doesn't fit the 99 mm case).
2026-10-25 PC1-PC3 signed off and applied: PSU in a Hammond 1402KV, SK 47 75 SA on the front panel, rear DD11 / NC7 / stud; drilling in psu_case/
    - The 1402K's side walls are split by an extrusion, so the heatsink went on the flat front end panel (Ruslan's
    choice); the LRS-150s are stacked behind the board (depth 163 + 33 of 234.6, height 77 of 93).
    - place_psu.py: TO-220 tab backs 1.68 mm proud of the board edge so they reach the heatsink through the 1.63 mm panel
    (0.25 mm pad); 0 parity issues, 0 DRC errors, 8 silkscreen-overhang warnings by design.
    - tools/psu_case_fab.py -> psu_case/: front, rear, heatsink and base DXFs, holes.csv, A3 PDF; fit checks.
    - psu_spec.md 7 / 8, offboard_bom.md, CLAUD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
    [base.dxf, front.dxf, heatsink.dxf, holes.csv, psu.kicad_pcb, rear.dxf]
2026-10-25 Link every board to its schematic: full symbol paths on footprints, strip board renamed to channel_strip.kicad_pcb
    - placer.py wrote flat '/uuid' footprint paths, so after the strip / group / master schematics went hierarchical
    (2026-10-25) none of their footprints linked to a symbol in KiCad (cross-probe, Update PCB). It now writes
    '/<sheet uuid>/<symbol uuid>' with Sheetname / Sheetfile, as KiCad does. Parity DRC hadn't shown it: it falls back
    to matching by reference.
    - channel_strip_v4.kicad_pcb -> channel_strip.kicad_pcb, so channel_strip.kicad_pro opens the current board; the old
    v3.1 board -> archive/channel_strip_v3.1.kicad_pcb. Scripts, render/strip.json and docs updated.
    -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
    [channel_strip.kicad_pcb, channel_strip_v3.1.kicad_pcb, channel_strip_v4.kicad_pcb, group.kicad_pcb, group_jack_board.kicad_pcb, jack_board.kicad_pcb, jig_load_board.kicad_pcb, jig_master_stub.kicad_pcb]
2026-10-25 Boards carry what KiCad's Update PCB copies from the symbols: KiCad now finds nothing to change
    Checked in KiCad 10.0.7 (strip project, Update PCB from Schematic, re-link by reference off): before, every footprint
    was matched by path but 273 had field updates queued (sheet name format, footprint filters, unit metadata, a library
    KiLib_Generator field, the jumpers' position-file flag); now 0 changes, 0 errors (2 warnings: RV8's mechanical MP pads).
    - placer.py: sheet path names, the symbol's fields only (Datasheet / Description from the symbol, library-only fields
    removed), ki_fp_filters, exclude-from-position-files from the symbol, and the units with their pins
    (write_units(): appended a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
    [channel_strip.kicad_pcb, group.kicad_pcb, group_jack_board.kicad_pcb, jack_board.kicad_pcb, jig_load_board.kicad_pcb, jig_master_stub.kicad_pcb, master.kicad_pcb, master_jack_board.kicad_pcb]
2026-10-25 CLAUDE.md: Update PCB from Schematic checked in KiCad on the strip, group and master (0 changes, 0 errors)
2026-10-25 thermal_study.md: the closed tub runs ~41 K above the room at 98 W; vented-tub proposal (TH1-TH3) for sign-off
    sim/review/thermal/tub_thermal.py: lumped model (panels, wood, buoyancy chimney, fan) over a range of inside film
    coefficients. Closed: 31-60 K (MUSE ES ~1.8 years at 4 h/day). Floor inlet inside the front rail + 30 slots through the
    back rail's neutral axis + back-trim plenum: 15-18 K (~10 years). Slow 120 mm fan: ~8 K (fallback). 105 C bipolars
    (Nichicon UEP) as the alternative to vents.
2026-10-25 TH1-TH3 signed off and applied: vented tub, slotted back rail, no fan, MUSE ES kept
    - panel_layout.vent_slots(): 30 slots 30 x 25 mm on the back rail's neutral axis; frame_fab.py draws them on the back
    rail only (front rail unchanged) and moves the bond hole to the bottom face in the mid gap; checks slots vs holes.
    - console_3d.py: the back rail built slotted; model rebuilt.
    - Tub requirements recorded (floor inlet slots + mesh, 10 mm feet, back-trim plenum with a top slot) for the woodwork
    drawings; thermal_study.md signed off; frame_proposal.md, offboard_bom.md, CLAUDE.md updated.
    [rail.dxf, rail_holes.csv]
2026-10-25 tub_proposal.md: tub woodwork (TB1-TB4) for sign-off, with a side elevation
    From the 3D model's geometry: its floor front sits 4.9 mm above the desk (no air for the inlet slots), so the console
    rises 25 mm (panel front edge 99 mm); its back trim leaves only a 15 mm plenum channel, so it grows to y -48..-13
    (23 mm, 0.027 m2). Walnut cheeks / arm-rest / plenum, 12 mm ply floor in dados, floor inlet slots + open underside,
    NC7MD-LX in the plenum's rear wall with its cable through back-rail slot 14.
2026-10-25 TB1-TB4 signed off and applied: tub drawings in tub/, 3D model raised 25 mm with the vented tub
    - panel_layout.py: tub geometry shared by the drawings and the model (to_desk, cheek_outline, inlet_slots, constants).
    - tools/tub_fab.py -> tub/: cheek (rebates, dado, counterbored screws), floor (30 inlet slots), arm-rest, plenum rear
    wall (NC7MD-LX) and cap strip, cut list, A3 PDF; checks features against the outline, the NC7, clearances, outlet.
    - Plenum outlet: the cap is a 14 mm strip and the 21 mm channel's whole top is the outlet (0.026 m2): a cut slot would
    have left a 0.5 mm sliver.
    - console_3d.py: raised 25 mm, no base wedge (open underside), cheeks from the shared outline, slotted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
    [armrest.dxf, cap.dxf, cheek.dxf, cutlist.csv, floor.dxf, rear_wall.dxf]
2026-10-25 panel_makers.md: front-panel makers compared (Schaeffer, FPE, LCSC, local), the artwork's finest strokes measured
    Regular numerals print at 0.108-0.122 mm strokes (Arial Narrow 1.5-1.7 mm): below a 0.15 mm print minimum, so a
    bold-numeral variant is the fallback. Recommendation: one prototype strip panel first (PV-cap clearance, fader slot,
    numeral print), the fader law measured before printing, then the batch.
2026-10-25 CLAUDE.md: front-panel quotes and prototype pending; the bold-numeral switch waits on the maker's minimum line
2026-10-25 feature_gaps.md: study of the two gaps against a Mackie 32-8 worth closing (MET1 signal/OL bicolour LED, RET1 more stereo returns)
2026-10-26 MET1 applied (strip v4.7): red / green signal / OL bicolour LED on every strip
    D2 becomes a Kingbright WP3VEGW (common cathode, own 2.0 mm footprint) in the OL hole.
    U17 (LM393B) detects signal from about -20 dBu with a ~150 ms hold, as U4 one level lower.
    PNP high-side switches Q3 / Q4 draw current only while lit; Q5 holds Q4 off during overload,
    so the red shows alone. sim/review/gaps/ol.py now covers both colours. The detector sits left
    of the fader. Parity DRC is clean. The panel artwork no longer depends on the board's
    footprint order (reference order in panel_layout.layout()).
    [07_insert.kicad_sch, 08_overload_detector.kicad_sch, 09_pfl.kicad_sch, 10_fader_post_amp.kicad_sch, 11_aux_sends.kicad_sch, 12_pan_pan_buffers.kicad_sch, 12_routing_matrix.kicad_sch, 13_routing_matrix.kicad_sch]
2026-10-26 RET1 applied (master spec v0.12): a second stereo return on every group module
    stereo_return() in gen_group.py builds both returns. Return 1's deferred followers run first,
    so every existing group part keeps its reference and connections. New per group: U12-U15,
    RV5, SW8-SW11, D4.
    Jack board: 7 jacks, with RET 2 L / R as a fourth row; 38 x 93.5 mm; standoffs below the
    last row. Return 2 has its own 2x5 link beside the unchanged 2x8, since a 2x13 does not fit
    the one free slot.
    Main board: starts at y 94.5. RET 1 / RET 2 rows at y 106 / 128, return 2's routing keys at
    y 150, AUX at y 172; the links are on the bottom at y ~190. Parity DRC is clean.
    Panel: RET 1 / RET 2 legends and a section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
    [08_jack_board_link.kicad_sch, 08_stereo_return_2.kicad_sch, 09_ribbon.kicad_sch, 09_stereo_return_2.kicad_sch, 10_stereo_return_2.kicad_sch, 11_power_and_grounds.kicad_sch, group.dxf, group.kicad_pcb]
2026-10-26 Worst corner of ~4.54 A on +V accepted, with the wing PTC note (MET1 / RET1)
2026-10-26 Untrack the KiCad lock files the RET1 commit picked up; ignore ~*.lck
2026-10-26 MET1 / RET1 review: no faults; three fixes applied, P1-P4 proposed (met1_ret1_review.md)
    Two reviewers worked from the generators, netlists, boards and datasheets: pinouts end to end, return 2 = return 1
    part for part, links, mechanics, panel. Applied: group jack board CN1 1 mm off J5's tip joint; return routing
    keys labelled R1 / R2 on the group panel; D2's footprint shows the 4.0 flange and has no model line; a 3-lead
    spacer for D2 (offboard_bom); sim/pfldet.py at 42 keys. The group stability deck models return 2 (not re-run: the
    TI model setup on this Mac gives no operating point, even on the old netlist). Also test_jig_spec v0.7 (signal /
    OL LED checks) and sample_order.md for the protot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
    [channel_strip.kicad_pcb, group.dxf, group.kicad_pcb, group_jack_board.kicad_pcb]
2026-10-26 Group stability with return 2 (TI OPA161x + fitted OPA1656): all return units >= 52.1 deg
    Root cause of the failed runs: the 'mg' fix set was written for group rev 0.1. Its fixes have been in the schematic
    since rev 0.2, and on today's netlist its re-pin left U2B's + input floating, so no operating point. The review
    docs' example used it. fixes.apply() now refuses a set that refers to nets the netlist lacks. TI's OPA1656 model
    needs the fitted macro in this deck (ngspice 46). Neither ngspice nor the OPA161x file was at fault.
2026-10-26 Master stability re-run (31 configurations + phones) on today's netlist; EQ survey from the service manuals
    Master: 166 min, one configuration at a time (run_each.py). It matches 2026-10-24: worst U21A/B 47.7 deg at the pot
    top, post-amps 51.6, phones 76.0; the new EXT followers are at 52.8. configs.py now finds each build-out's far side
    and the spare units from the netlist. The drawn master's unnamed nets had moved the +47 pF stress onto the pin side
    (U5A 44.1 deg) and loaded the idle spares. master_len.json re-measured from the placed board. Group: all sweeps re-run.
    eq_survey.md: SSL 4000G, Yamaha PM-4000/5000, Soundcraft 6000/200B/Sapphyre/Ghost/Series Five, Sony MXP-3000 read
    from the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
2026-10-26 EMC placement study: rules from Self / Whitlock / Muncy / AES48 / Ott / TI / ADI, measured on the placed boards
    tools/emc_check.py measures any placed board: entry runs, aggressor-victim pad distances, long switching nets, and
    supply entry. Strip findings: MET1's LED lines span ~260 mm and end 4.3 mm from the input followers; the followers'
    220R / 100p sit 11-16 mm from their pins; the soft-mute JFETs ~20 mm from U3B; bus power runs 42-46 mm unfiltered;
    the jack board's RF caps and sleeve sit 24 mm from the chassis standoffs. Proposals E1-E8 for sign-off; nothing moved.
2026-10-26 EMC placement E1-E5 and E8 applied (placement only)
    Strip:
    - the MET1 LED switches sit beside D2 on the bottom: the anode lines go from 257/274 mm to 19/8 mm, and OL_K
    from 237 mm to 8 mm;
    - U16's 220R / 100p are under its pins (2.7-3.5 mm, was 11-16);
    - the J112 mute is under U3B (1.3 mm, was ~20);
    - the supply filters are at the bus header (5.5-8 mm of unfiltered bus power, was 42-46).
    Group: the supply filters are at its header (15-16 mm, was 26-30).
    Jack board: C8 / C9 sit between J1's pins (3-4 mm).
    Master: the flasher diode is beside its comparator, and PFL detect sits by the PFL switcher, away from the
    phones amp.
    The strip's upper op-amps are fixed (the packer had re-shuffled 163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
    [channel_strip.kicad_pcb, group.kicad_pcb, group_jack_board.kicad_pcb, jack_board.kicad_pcb, master.kicad_pcb, master_jack_board.kicad_pcb]
2026-10-26 Revert the group / master jack boards to their previous files: the re-placement only changed UUIDs and ordering
    [group_jack_board.kicad_pcb, master_jack_board.kicad_pcb]
2026-10-26 routing_guide.md: routing notes for the strip, its jack board and the jig boards, from the placed boards
    Covers the ground and supply strategy, the sensitive nets with their lengths, the switching nets to keep away,
    CHASSIS on the jack boards, and the jig's ground-cancel reference. Suggested net classes are included as a
    table only; the project files are unchanged.
2026-10-26 pan_buffer_proposal.md: PAN1, pan buffer L into the spare U8B beside the pan pot (trial measured, not applied)
    The pan L wiper line drops from 165 to 24 mm; 8 parts move, 0 DRC / parity issues, TI-model stability identical.
    Trial as pan_buffer_proposal.patch (tools only); the committed schematic and board are unchanged.
2026-10-26 PAN1 applied (strip v4.8): pan buffer L in U8B beside the pan pot, U2B the spare
    Signed off by Ruslan. The pan L wiper line drops from 165 to 24 mm and its nearest switching pad moves from
    2.9 to 11.6 mm. 8 parts moved, 0 DRC / parity issues, 290/290 links; sims 39/39 and 35/35; TI-model
    stability identical (U8B 80.2-87.5 deg as U2B was). Schematic revision 4.8 with the spec.
    [02_line_input.kicad_sch, 03_hpf.kicad_sch, 04_eq.kicad_sch, 05_eq_mid_tuning.kicad_sch, 06_eq_mid_tuning.kicad_sch, 07_insert.kicad_sch, 08_overload_detector.kicad_sch, 09_pfl.kicad_sch]
2026-10-26 stab_caps_proposal.md: E9, the strip's C0G stability caps at their pins (trial measured, not applied)
    Twelve caps 6-22 mm from the pins they stabilise move to them (nine on the bottom under their op-amp); every C0G
    cap on an op-amp input is then within 6.3 mm. Placement only: 12 parts move, 86 held against the packer cascade,
    0 DRC / parity issues, emc_check unchanged. Trial as stab_caps_proposal.patch.
2026-10-26 E9 applied: the strip's C0G stability caps at their op-amp pins (placement only)
    Signed off by Ruslan. Twelve caps move (nine to the bottom under their op-amp); every C0G cap on an op-amp
    input is now within 6.3 mm of its pin (was up to 22.1). 86 parts held against the packer cascade; 0 DRC /
    parity issues, 290/290 links, emc_check unchanged. Routing guide: one via from each bottom cap to its pin.
    [channel_strip.kicad_pcb]
2026-10-26 placer moves: parts moved to fixed spots after packing; strip E9 uses it (identical board); E9b proposed
    The strip's 86-part HOLD list is gone: its twelve caps now move after packing, so the packer keeps its layout
    (0 parts differ from the committed E9 board). E9b (stab_caps_e9b.patch, not applied) does the same for the
    group's 11 and the master's 13 stability caps (up to 13 mm -> <= 6.4 mm; 0 DRC / parity, only the caps move).
2026-10-26 E9b applied: group and master stability caps at their op-amp pins (placement only)
    Signed off by Ruslan. Group 11 / master 13 C0G caps move after packing (placer moves), nothing else moves;
    every C0G cap on an op-amp input is now within 6.1 / 6.4 mm (was up to 13 mm). 0 DRC / parity issues, every
    footprint linked, emc_check unchanged but for two group couplings leaving the closest twelve.
    [group.kicad_pcb, master.kicad_pcb]
2026-10-27 input_nets_proposal.md: E10, shorter high-impedance op-amp input nets (trial measured, not applied)
    18 resistor moves (strip 9, group 7, master 2) via placer moves: input nets over 20 mm drop from 17 to 9
    (strip) and 10 to 3 (group), no net gets longer, stability caps untouched, 0 DRC / parity issues.
2026-10-27 E10 applied: shorter high-impedance op-amp input nets on the strip, group and master (placement only)
    Signed off by Ruslan. 18 resistors move after packing (strip 9, group 7, master 2), nothing else; input nets
    over 20 mm: strip 17 -> 9, group 10 -> 3, master 23 -> 21, none longer. 0 DRC / parity issues, every
    footprint linked.
    [channel_strip.kicad_pcb, group.kicad_pcb, master.kicad_pcb]
2026-10-27 Routing rules in the projects (net classes + custom DRC rules, tested); E11 decouplers proposed
    tools/netrules.py writes net classes (from the placed boards) into every strip / group / master / jig / jack-board
    project and the routing-guide rules into X.kicad_dru; tools/netrules_test.py proves each of the 8 rules fires.
    DRC unchanged on today's placement. Generators that copy master.kicad_pro now keep each project's net settings.
    placer moves: the guard also checks a through-hole part's own leads. E11 (decouplers_proposal.patch, not applied):
    21 decouplers to their supply pins, strip over-5 mm 14 -> 1.
2026-10-27 E11 applied: 21 decouplers at their supply pins on the strip, group and master (placement only)
    Signed off by Ruslan. Decouplers over 5 mm: strip 14 -> 1, group 2 -> 1, master 27 -> 20 (the LME49600's
    THT bypasses stay). 0 DRC / parity issues, every footprint linked; routing rules re-generated and all fire.
    [channel_strip.kicad_pcb, group.kicad_pcb, master.kicad_pcb]
2026-10-27 layer_study.md: 2 vs 4 layers for the console boards (density, ground, rules, quotes, recommendation)
    Measured from the placed boards: the strip / group / master need about one full signal layer of routing; jig, PSU and
    jack boards are 4-15x sparser. Quotes from JLCPCB / PCBWay / Aisler / Multi-CB calculators on 2026-10-27. Recommends
    4 layers for the three main boards only (+$27 phase 1, +$93 full build at JLCPCB) and 2 layers for the rest.
2026-10-27 4 layers for the strip, group and master main boards (In1 GND plane, In2 PWR + GNDD spine); layer DRC rules
    Ruslan's decision from layer_study.md. placer.py takes layers=4 (In1.Cu GND, In2.Cu PWR, 1.6 mm stackup); the three
    main boards re-placed with 0 parts moved, 0 DRC / parity issues, every footprint linked. netrules.py adds three
    4-layer rules (no tracks / no non-ground zone on GND, no HighZ / Entry / Bus on PWR); all 11 fire in netrules_test.py.
    Routing guide: layer plan, GNDD as a spine on In2 beside +VL / +5VL to the net tie. Jack boards, jig and PSU stay 2-layer.
    [channel_strip.kicad_pcb, group.kicad_pcb, master.kicad_pcb]
2026-10-27 In2 as a second GNDA layer (GND2) with a left-edge rail corridor; corridor DRC rules tested; return-path guide
    B.Cu's return current flows in In2 (0.2 mm prepreg vs a 1.1 mm core to In1), so In2 is GNDA fill and the rails and
    the GNDD spine run only in a rule area RAILS along the left edge (placer rails=). netrules.py: no sensitive tracks
    on In2, rails / GNDD on In2 only inside RAILS, no sensitive B.Cu over RAILS; all 13 rules fire in netrules_test.py.
    Guide: ground via within 1 mm of every signal via, branches on F.Cu / B.Cu, stitching. 0 parts moved, DRC clean.
    [channel_strip.kicad_pcb, group.kicad_pcb, master.kicad_pcb]
2026-10-27 Ratsnest untangling: 147 two-pad parts turned in place (placement only); swaps measured, none recommended
    tools/ratsnest.py measures signal-net ratsnest length and crossings (checked against full and brute-force counts).
    placer.py takes turns (after packing, same guard as moves); TURNS in the three main-board layouts: crossings strip
    1292 -> 1211, group 1674 -> 1600, master 2419 -> 2261, no part moved, DRC / parity / links / 13 rules clean.
    Unit / channel swaps: at most -12 crossings, the bigger ones blocked by stability caps; none recommended.
    placer.py ignores rule areas (RAILS) when refusing to overwrite a routed board.
    [channel_strip.kicad_pcb, group.kicad_pcb, master.kicad_pcb]
2026-10-27 Post-route checker (tools/route_check.py) with a synthetic-routing test
    Checks what DRC can't on a routed board: GNDA return via beside every signal via (1 mm aim, 2 mm limit on
    sensitive nets), filled GNDA reference under sensitive tracks (fills zones in memory), high-Z length / vias,
    decoupler path and ground via, stability-cap via count, no GNDD fill. route_check_test.py plants one fault and one
    known-good case per check on a scratch strip: 8 / 8 found, no false alarms. Routing guide updated (2 mm limit:
    a SOIC pin leaves no pad-free spot within 1 mm).
2026-10-27 Fab limits in every project, 1.0 mm silk, and tools/fab_out.py (checks, then Gerbers / drill / CPL / BOM)
    JLCPCB's capabilities (read 2026-10-27) as Board Setup constraints in all nine projects (netrules.py FAB): silk text
    >= 1.0 mm / 0.15 mm lines, plated hole to track 0.28, pad holes 0.45 apart, silk 0.15 from pads. placer.py writes
    references at 1.0 / 0.15 mm (was 0.8 / 0.12, below the minimum); only 4 master references find no room. Group silk
    labels 1.0 mm. Every board re-placed: no part moved, DRC unchanged but the PSU's TO-220 silk at the edge (by design).
    fab_out.py refuses on DRC / parity / unrouted / route_check errors (footprint-internal KNOWN items aside), then
    writes Gerbers (al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
    [channel_strip.kicad_pcb, group.kicad_pcb, group_jack_board.kicad_pcb, jack_board.kicad_pcb, jig_load_board.kicad_pcb, jig_master_stub.kicad_pcb, master.kicad_pcb, master_jack_board.kicad_pcb]
2026-10-27 Escape / layer plan for the dense spots (tools/escape_plan.py, escape_plan.md, docs/escape)
    Per 4-layer main board: one layer per signal net (HighZ / Entry / Bus on F.Cu, Switching on B.Cu, the rest greedily
    to clear ratsnest crossings, layer changes costed), a CSV of the plan per net, and SVGs of the three densest 30 mm
    windows with the leftover same-layer crossings circled. Strip worst spot: y 121-151 between U12 and U13.
    [channel_strip_layers.csv, group_layers.csv, master_layers.csv]
2026-10-27 Strip v4.9: P1 (1K discharge), P2 (100n on VREF), E6 (10n base caps); placer moves_only
    Signed off by Ruslan. R126 / R127 between U4A / U17A and their hold caps (discharge peak 15.9 mA vs the LM393B's
    25 mA), C100 on VREF, C101 / C102 on Q3 / Q4 (SIG_B's 0.75 V edges 17.6 us / 1.04 ms; E6's LED-current claim
    corrected). 861 pins / 0 mismatches, ERC 0, sim_netlist 39/39, sim_console 35/35, ol.py thresholds / holds
    unchanged (deck now steps at 2 us: 20 us showed a false blink). placer.py moves_only: the five are placed by moves
    alone, so no other part moved; DRC / parity clean, 295 / 295 linked. P3 declined; P4 decided (studs, else none).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
    [02_line_input.kicad_sch, 03_hpf.kicad_sch, 04_eq.kicad_sch, 05_eq_mid_tuning.kicad_sch, 06_eq_mid_tuning.kicad_sch, 07_insert.kicad_sch, 08_overload_detector.kicad_sch, 09_pfl.kicad_sch]
2026-10-27 P4: stud positions in the panel drawings (DXF STUDS layer, hole tables); off-board BOM fastening per P4
    Every board standoff (main and jack boards) gets a blind M3 stud position on the panel's back, checked clear of
    every front cut-out (6 mm boss, 1 mm web): 0 problems on all three panels. Studs must be welded: PEM concealed-head
    clinch studs need a 1.60 mm sheet and the panels are 1.5 mm. Off-board BOM: one M3 screw per standoff at the board;
    panel end a welded stud if offered, else a spacer. The jack-board standoffs' CHASSIS bond without studs is open.
    [group.dxf, group_holes.csv, master.dxf, master_holes.csv, strip.dxf, strip_holes.csv]
2026-10-27 P4 fallback: countersunk M3 screws at the jack-board standoffs when no welded studs
    Ruslan's decision: without studs, the jack-board standoffs (CHASSIS bond, G2) take M3 x 6 countersunk flat-head
    screws through the panel (Ø3.4, 90 deg to Ø6.5) with an internal-tooth star washer under each standoff. Panel DXFs get
    a CSK_NO_STUDS layer, hole tables rows 'ONLY IF NO WELDED STUDS'; the fab checks treat each countersink as a cut-out:
    0 problems, no legend moved (closest: group H1, 0.78 mm from RET 1). Off-board BOM updated.
    [group.dxf, group_holes.csv, master.dxf, master_holes.csv, strip.dxf, strip_holes.csv]
2026-10-27 routing_guide.md: group and master sections (measured on the placed boards)
    Supply / ground, ground cancel, bus lines, entries and outputs, switching nets with their closest couplings, and
    the wing feeds' current (up to ~2 A: wider than the Power class) for the group and master main boards.
2026-10-27 WingFeed net class: nets through a wing PTC get >= 1.5 mm tracks (2.0 preferred); tested
    The master's +-VBUS and +-VBUS_L / _R carry a whole wing (up to ~2 A); the Power class asked only 0.5 mm. netrules.py
    classes any net touching a PTC (F*) as WingFeed (master 6 nets, jig stub 4) with its DRC width rule; netrules_test.py
    adds a master case: all 14 rules fire. DRC unchanged on every board.
2026-10-27 PSU routing rules: HighCurrent class (4 A paths >= 3 mm, 4 preferred), EARTH as Chassis, routing_guide PSU section; 15 rules fire
2026-10-27 tools/check_all.py: every project check in one run (60 / 60 pass, 188 s with --full); fab_out.is_known accepts the board outline in an edge-clearance item
2026-10-27 CS1 proposal: overload LED from five taps, both polarities (BAV99 per tap, U18 negative side as PK's mirror); ol_multi.py simulation, tools-only patch checked on a trial tree (59/59), not applied
2026-10-27 Strip v5.0 (CS1, signed off): overload LED from RECV / GOUT / EQOUT / PRESRC / FPOST, both polarities (BAV99 per tap, U18 negative side); re-placed (only D1 moved), spec / routing guide / jig v0.8; c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
    [02_line_input.kicad_sch, 03_hpf.kicad_sch, 04_eq.kicad_sch, 05_eq_mid_tuning.kicad_sch, 06_eq_mid_tuning.kicad_sch, 07_insert.kicad_sch, 08_overload_detector.kicad_sch, 09_overload_detector.kicad_sch]
2026-10-27 console_survey.md: Mackie 8-Bus channel OL / -20 detector read from the 990-009 schematic (3 taps, positive only, slow attack) against strip v5.0
2026-10-27 console_survey.md §7: second batch from Downloads (A&H GL2/GL2200, GL3300, AMEK big, Yamaha MC, Spirit E8, Mackie VLZ + 8-Bus); proposals CS9-CS11; sample check 9 (fader residual)
2026-10-27 CS10 proposal: reverse PMEG4010CEH across each audio rail of every strip / group board; rail_loss.py simulation, tools-only patch checked on a trial tree (59/59), not applied
2026-10-27 Strip v5.1 / group (CS10, signed off): PMEG4010CEH reverse clamp across each audio rail (strip D16/D17, group D5/D6); re-placed (only the diodes added), specs, check_all --full 61/61
    [02_line_input.kicad_sch, 03_hpf.kicad_sch, 04_eq.kicad_sch, 05_eq_mid_tuning.kicad_sch, 06_eq_mid_tuning.kicad_sch, 07_insert.kicad_sch, 08_overload_detector.kicad_sch, 09_overload_detector.kicad_sch]
2026-10-27 CS3 checked: bus_headroom.py from the whole-console model; the summer has 29.5 dB per source, 1.6 dB more than the XLR stage; no change (survey entry corrected)
2026-10-27 CS4 proposal: a BAV199 rail clamp on each jack-link signal at CN3 (D18-D22); jack_protect.py ESD / phantom / THD simulation, tools-only patch checked on a trial tree (59/59), not applied
2026-10-27 Strip v5.2 (CS4, signed off): BAV199 rail clamps on the jack-link signals at CN3 (D18-D22); re-placed (only the clamps added), spec, check_all --full 61/61
    [02_jack_link_clamps.kicad_sch, 03_gain.kicad_sch, 04_hpf.kicad_sch, 05_eq.kicad_sch, 06_eq_mid_tuning.kicad_sch, 07_eq_mid_tuning.kicad_sch, 08_insert.kicad_sch, 08_overload_detector.kicad_sch]
2026-10-27 CS4b proposal: BAV199 jack-link clamps on the group (14) and master (24) boards, created last; DRV135 output ESD / phantom sim; tools-only patch checked on a trial tree (59/59), not applied
2026-10-27 Group / master jack-link clamps (CS4b, signed off): BAV199 on every jack-link signal, group D7-D20 at CN3 / CN4, master D79-D102 at CN5, created last; re-placed (only the clamps added), specs, check_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
    [11_jack_link_clamps.kicad_sch, 12_power_and_grounds.kicad_sch, 26_jack_link_clamps.kicad_sch, 26_power_entry.kicad_sch, 27_distribution.kicad_sch, 27_jack_link_clamps.kicad_sch, 28_distribution.kicad_sch, 29_motherloom.kicad_sch]
2026-10-27 CS4c proposal: 22R inside each DRV135 loop (group R119-R122, master R222-R235); cs4c_drv.py on TI's DRV134 model (8 kV into the output pin 5.9 -> 0.84 A, no loss of stability, +21 ohm output impedanc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
2026-10-27 DRV135 loop resistors (CS4c, signed off): 22R ERJ-P06J220V between each output pin and its 10 uF (group R119-R122, master R222-R235), created last; placer wire=; re-placed (only the resistors added),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
    [03_subgroup.kicad_sch, 04_subgroup.kicad_sch, 05_aux_master.kicad_sch, 06_main_outputs.kicad_sch, 06_stereo_return.kicad_sch, 07_main_outputs.kicad_sch, 07_stereo_return.kicad_sch, 08_power_on_mute.kicad_sch]
2026-10-27 CS5 checked: pfl_xtalk.py models one wing's conductors 25-31 with the PFL summer and PFL DET; everything into the PFL sum sits at or below its floor (AUX2 -105 dB at 20 kHz, -V -122 dBu, key press -9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
2026-10-27 CS6 proposal: Vishay M25SI 10R 1206 fusibles for R1-R4 on every strip and group; fusible.py (duty, faults vs the wing PTCs, surges in ngspice: a live hot-plug may open them); tools-only patch checked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
2026-10-27 Strip v5.3 / group (CS6, signed off): R1-R4 fusible Vishay M25SI 10R 1206 on every strip and group; power down before plugging a module; strip R1-R4 by moves_only, nothing else moved; specs, check_al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
    [02_jack_link_clamps.kicad_sch, 03_gain.kicad_sch, 04_hpf.kicad_sch, 05_eq.kicad_sch, 06_eq_mid_tuning.kicad_sch, 07_eq_mid_tuning.kicad_sch, 08_insert.kicad_sch, 09_overload_detector.kicad_sch]
2026-10-27 CS11 proposal: jig tests 13-17 (DRV134 output balance, line CMR, fader / pan residuals, faders-down MIX noise, GCANCEL current) with targets from jig_targets.py; finds the DRV135 output balance set b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
2026-10-27 Test jig spec v0.9 (CS11, signed off): tests 13-17 (DRV134 output balance, line-input CMR, fader / pan residuals, faders-down MIX noise, GCANCEL current) with simulated targets
2026-10-27 CS11b proposal: each DRV135's 10 uF couplers sorted into pairs within 2 % (output balance worst 5 % -32/-20 -> -60/-47 dB at 1 kHz/100 Hz, TI model); bigger cans fit nowhere and do less; tools-only p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
2026-10-27 DRV135 coupler pairs (CS11b, signed off): each console DRV135's two 10 uF sorted within 2 % (BOM note, 10 sorting spares, offboard_bom rule); re-placed for the MPN field, nothing moved; check_all --f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
    [03_subgroup.kicad_sch, 05_aux_master.kicad_sch, 06_main_outputs.kicad_sch, 07_main_outputs.kicad_sch, 09_aux_master_5.kicad_sch, 10_aux_master_6.kicad_sch, 16_control_room.kicad_sch, 17_control_room.kicad_sch]
2026-10-27 CS11b finished: build_records.md (coupler sorting, pair record, per-output balance bench check with a fitted prediction), master parts table note, sourcing quantity and DigiKey stock (ECE-A1EN100U ac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
2026-10-27 CS2 proposal: the Delta's -4.4 dB pan law on the strip (1.22x buffers, 3K3 to the wipers, 22p C0G for stability: TI model 81.6-85.3 deg over 21 configurations); levels +3.3 dB at centre, S/N unchange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
2026-10-27 CS2: how the -6 dB pan law got in (v3 followers without the Delta's 1.22x gain and 3K3 law resistors; v4.0 dropped the 'linear B with the Delta's buffer arrangement' condition and fixed -6 dB in the 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
2026-10-27 CS2: the parent's pan stage re-read from ED3344C (300 dpi) and the 200 Delta manual p.56: VR10 10KB, TL072 at 1.22x (2K2/10K), R120/R121 3K3 law resistors from the outputs to the wipers, IC6-B +1.4 d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
2026-10-27 CS2: the 200 Delta checked (ZZ2593): p.34 states a 4.5 dB centre drop; the D202 parts list carries the 3K3 law resistors and 2K2/10K gain pairs; no PAN switch on the 200 (a Theatre addition); ED2774 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
2026-10-27 Strip v5.4 (CS2 Option A, signed off): the Delta's -4.4 dB pan law (U8B / U3A at 1.22x, 3K3 law resistors R136 / R139, 22p C105 / C106); PAN off stays POST; sim targets moved with the law; re-placed 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
    [02_jack_link_clamps.kicad_sch, 03_gain.kicad_sch, 04_hpf.kicad_sch, 05_eq.kicad_sch, 06_eq_mid_tuning.kicad_sch, 07_eq_mid_tuning.kicad_sch, 08_insert.kicad_sch, 09_overload_detector.kicad_sch]
2026-10-27 Eight groups study (from ED2911A/B, ED2915B, ED2778A/B, ED2780): Venue input = 8-group build of the DLX channel; groups 5-8 on motherloom pins 7/5/3/1 (our spares); Delta 8 = eight ED2778 group modul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
2026-10-27 Bus pins 1, 3, 5, 7 reserved for SUB 5-8 (Venue pinout; Ruslan): kept unconnected on every board (checked: NC on strip, group, jig; master only joins its wing headers); CLAUDE.md pointer to eight_gro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
2026-10-27 Group sub pan law (CS2b, signed off): the strip's -4.4 dB law on every group (U3B / U5A at 1.22x, 3K3 law resistors R123 / R126, 2K2 / 10K R124 / R125 / R127 / R128, 22p C96 / C97), made last; sub to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
    [02_bus_select.kicad_sch, 03_subgroup.kicad_sch, 04_subgroup.kicad_sch, 05_aux_master.kicad_sch, 06_aux_master.kicad_sch, 06_stereo_return.kicad_sch, 07_stereo_return.kicad_sch, 08_stereo_return.kicad_sch]
2026-10-27 CS7 proposal (not signed off): DIM on C/Room, SW4 beside POWER, 91K per side shorted by the released key, -20.0..-20.75 dB on C/Room only; main R's DRV135 group moved to the bottom beside the key (lo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
2026-10-27 C/Room DIM (CS7, signed off): SW4 beside POWER, R236 / R237 91K between CRSB and each C/ROOM pot top, shorted by the released key, -20.0..-20.75 dB on C/Room only; main R's DRV135 group on the bottom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
    [16_control_room.kicad_sch, 17_control_room.kicad_sch, 18_headphones.kicad_sch, 19_meter_l.kicad_sch, 20_meter_l.kicad_sch, 21_meter_l.kicad_sch, 22_meter_l.kicad_sch, 23_meter_r.kicad_sch]
2026-10-27 EQM1 proposal (not signed off): the KHN mid ranges retuned to the Delta's measured ones, resistor values only (HI-MID R0 392R / RB 4K99: 598 Hz - 9.93 kHz; LO-MID RB 4K22: 165 Hz - 2.54 kHz); boost /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
2026-10-28 Strip v5.5 (EQM1, signed off): the mid ranges are the Delta's measured ones, HI-MID R86 / R87 392R and R56 / R57 4K99 (598 Hz - 9.93 kHz), LO-MID R60 / R61 4K22 (165 Hz - 2.54 kHz); boost / Q / noise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
    [02_jack_link_clamps.kicad_sch, 03_gain.kicad_sch, 04_hpf.kicad_sch, 05_eq.kicad_sch, 06_eq_mid_tuning.kicad_sch, 07_eq_mid_tuning.kicad_sch, 08_insert.kicad_sch, 09_overload_detector.kicad_sch]
2026-10-28 Group return followers on TI's own OPA1656 model: 59.2-61.0 deg over ret / pots / loads (fitted macro 52.1-52.9); groupdeck OPA1612_SIMPLE (the full deck has no operating point with TI's OPA1656 othe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
2026-10-28 Phase-1 order list (order_bom.py phase1 -> order_phase1.csv): stage A one strip + jack board merged with sample_order.md, N1 swap OPA1656s, bench-power lead, panel blank; stage B jig stub + load boar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
    [02_jack_link_clamps.kicad_sch, 03_gain.kicad_sch, 05_eq.kicad_sch, 12_fader_post_amp.kicad_sch, channel_strip.kicad_pcb, channel_strip_BOM.csv, order_bom.csv, order_phase1.csv]
2026-10-28 Project review (2026-10-28, not signed off): five-reviewer pass over circuits, tooling, docs and the repo; RV1-RV14 (PSU ADJ-divider 1K5 0805 at 164 mW, jig load-board GCANCEL tap vs channel count, s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
    Claude-Session: https://claude.ai/code/session_01US693UqkXHGSrVMSq5qLty
2026-10-28 Project review batch 1 (RV1, RV2 / RV10, RV11.1-7, stale docs), applied 2026-10-28: PSU R2 / R11 1K5 as ERJ-P06F1501V 1206 0.5 W (164 mW, the 0805 was at 131 %), PSU regenerated and re-placed; test_j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
    [02_bus_select.kicad_sch, 02_ground_cancel_buffer.kicad_sch, 03_mix_l.kicad_sch, 03_subgroup.kicad_sch, 04_mix_r.kicad_sch, 04_subgroup.kicad_sch, 05_aux_master.kicad_sch, 05_master_fader.kicad_sch]
2026-10-28 Clicks proposal (RV3 / RV4 / RV7 / RV8 / RV9, not signed off): strip direct-out cold-leg 33u NP and gain-stage 1M keeper, master / group aux-AFL 2.2u films, phones gain-set 100u NP (DC gain 1), -V-lo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
2026-10-28 Delta DLX service manual cross-check (not signed off): all 17 ED sheets at 300 dpi against the strip, group, master and (feature level) the Venue / stereo / dual-line modules, stage by stage; ~200 ro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
2026-10-28 Delta cross-check D13 applied (signed off): the five spare bus conductors (1 / 3 / 5 / 7 = SUB 5-8, 19) grounded at the master through bridged solder jumpers JP3-JP7 beside CN2 on the bottom, as the 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
    Claude-Session: https://claude.ai/code/session_01US693UqkXHGSrVM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
    [27_jack_link_clamps.kicad_sch, 28_distribution.kicad_sch, 28_power_entry.kicad_sch, 29_distribution.kicad_sch, 29_motherloom.kicad_sch, 30_remote_meter_header.kicad_sch, master.kicad_pcb, master.kicad_sch]
2026-10-28 Clicks batch applied (signed off): strip v5.6, master v0.13, group — RV3 / RV4 / RV7 / RV8 / RV9
    Strip: R142 1M GOUT -> U1B- (gain-stage DC keeper), C107 33 uF NP in the direct out's cold leg
    (R73 ERJ-P06J750V, both legs 75R + 33 uF). Master: C194 / C195 2.2 uF films ahead of the aux 5 / 6
    AFL 22Ks, C196 / C197 33 uF NP in the phones gain-set legs (DC gain 1; no D10 spot, 2.2 Hz),
    U10B's + input on +1.0 V (R238 51K / R239 10K from VREF6), R53 51K -> 64K9 (trip -14.4 V as
    before, inputs inside the LM393B's range with -V lost). Group: C98 film ahead of the aux AFL 22K.
    New parts created at the end of each generator (LATE_* lists; the proposal's DEFER would have
    shifted 17 / 18 refs), drawn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
    [02_ground_cancel_buffer.kicad_sch, 02_jack_link_clamps.kicad_sch, 03_gain.kicad_sch, 03_mix_l.kicad_sch, 04_hpf.kicad_sch, 04_mix_r.kicad_sch, 04_subgroup.kicad_sch, 05_aux_master.kicad_sch]
2026-10-28 Delta cross-check D2-D24: the documentation edits (signed off 2026-10-28)
    Every kept difference now states the Delta's circuit, ours and the reason in the document that
    owns it: strip spec §4 D23 (gain ranges), §5 D12 (HPF-EQ DC coupling), §6.1 D8 (idle EQ not
    grounded), §7 D1 / D4 / D21 (tip = send, return impedance, insert sleeve), §8.1 D9 / D10 (the
    Delta's peak tap and threshold), §9 D3 / D11 (the mute topology is not the Delta's), §11 D7,
    §12 D2, §13 D5 / D6, §17 v5.6 status; master spec §4 D1 / D19, §7 D14, §16 D18, §17 D14,
    §19 D20, §22 D15 / D16, §29 v0.13 counts; delta_clone_comparison §2 rows corrected (insert
    sense, peak tap pre-insert, mute "same" was false, gai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
2026-10-28 Cleanup RV12 / RV14, XLR shells on CHASSIS, N1 count, ol.py labelled (project_review.md)
    - RV12: the 20 proposal patches to archive/patches/ (git mv), every reference in CLAUDE.md, the
    proposals, project_review.md and the HPF trial scripts updated.
    - RV14: .gitattributes marks generated files linguist-generated (git diff unchanged); the three
    unreferenced sim/review scripts (group/table.py, master/modeltest.py, hpf/trial_lf.py) deleted;
    tools/fly_render.py listed in CLAUDE.md; sim/strip.cir, strip_v4.cir, delta_eq.cir and
    gain_stage.cir labelled HISTORICAL; render/*.json and docs/escape/ regenerated on the
    v5.6 / v0.13 boards. PDFs stay tracked; the v3.1 archive board stays (refere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
    [channel_strip_layers.csv, group_layers.csv, jig_load_board.kicad_pcb, jig_master_stub.kicad_pcb, jig_master_stub.kicad_sch, master.kicad_pcb, master_jack_board.kicad_pcb, master_jack_board.kicad_sch]
2026-10-28 RV13: CLAUDE.md restructured (106 KB -> 19 KB), the detail moved verbatim into docs/
    CLAUDE.md now holds the owner / scope rules (with "say why you recommend"), what the project
    is, a state table per board (rev, parts, pins, outline, layers), the last check_all, power,
    the regenerate / verify / place / rules / check_all / order_bom loop, the working rules
    (generated files, proposal -> sign-off -> apply -> record, new parts made last + moves_only,
    power down before plugging, no phantom), one line per decision with date and document, the
    open items and the next steps. Headings "Decisions made", "Not done / open", "Next steps" kept
    (README.md and sample_order.md link to them).
    Moved out, text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
2026-10-29 Review of the 2026-10-28 commits, documentation findings fixed
    An independent pass over 7d91d01 / 65a729d / 30b7cc4 / 7dda91e found the CLAUDE.md split lossless,
    every state-table number right and every D-item recorded where §3 says, but eleven loose ends:
    - D13 was pointed at master spec §24 without being there: the JP3-JP7 paragraph added (pinout,
    bridged by default, open for an 8-group build, why).
    - docs/decisions.md lacked the full text of D1 (insert tip = send), the D3 mute-topology note
    and the XLR shells; added as a dated section.
    - Strip spec §0 still said "same J112 soft mute" (D3); strip_noise_proposal.md still built two
    N1 strips of 7 packages (one-strip swap of 8, U15 i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
2026-10-29 Review of the clicks batch: circuit findings recorded, numbers corrected, follow-up proposal (not signed off)
    Independent review of 7d91d01 / 30b7cc4 (netlist intent, reference stability, XLR symbol, placement
    with pcbnew, DRC / parity, order list): all as claimed, plus two real findings written up for
    sign-off in clicks_followup_proposal.md:
    - RV3b: RV3's C107 left the direct out's ring with no DC bleed and no clamp (cs4_proposal.md had
    exempted DO_R because it "only goes to ground through 75R"); phantom would charge the 25 V cap
    to ~48 V. Proposed: R143 47K + D23 BAV199 on DO_R, mirroring the hot leg.
    - RV9b: with -V lost the relay driver's base sees the comparators' low level referenc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
    [02_jack_link_clamps.kicad_sch, 03_gain.kicad_sch, 04_hpf.kicad_sch, 05_eq.kicad_sch, 06_eq_mid_tuning.kicad_sch, 07_eq_mid_tuning.kicad_sch, 08_insert.kicad_sch, 09_overload_detector.kicad_sch]
2026-10-29 Clipping waveforms: the Delta's op-amps against ours (study, docs/clipping)
    sim/review/clipping/clip.py runs TI's models (1989 TL072 macro, TL07xH, OPA161x, OPA1656; from
    $TI_MODELS, gitignored) as a unity follower and a unity inverter on +-17 V at 14 / 16 / 18 V peak
    and plots them; tl072_classic.lib adds the classic JFET die's input-stage phase reversal (threshold
    V- + 3 V, the datasheet's typical VICR) to TI's 1989 macro, since no vendor model carries it.
    Result (docs/clipping/README.md): the same hard clip within 1 dB at every stage output; the classic
    TL072 flips to the positive rail in followers 1.5 V before its output would clip, inverting stages
    never see it; ours clip cleanly, the O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
2026-10-29 Delta resistor types read from the spare-parts list (MF 0.25 W 2 %, routing mini-res 1/2 W 5 %): D5 guess corrected in the strip spec and delta_crosscheck, survey T20b, sourcing.md film note, CLAUDE.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
2026-10-29 TF1 proposal (not signed off): thin-film RT0805FRE07 for the plain 0805 resistors up to 1M, one rule in order_bom.py; patch, INDEX and CLAUDE.md open item
    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
2026-10-29 TF1 applied (signed off): plain 0805 resistors up to 1M ordered as Yageo RT0805FRE07 thin film; order lists regenerated (62 lines / 4411 parts), sourcing.md, decisions, strip spec §15, CLAUDE.md
    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
    [order_bom.csv, order_phase1.csv]
2026-10-29 RV3b / RV9b applied (signed off): strip v5.7 (R143 47K + D23 BAV199 on the direct out's ring), master v0.14 (R240 4K7 base-emitter on the relay driver)
    Strip: the ring gets what the tip has, a 47K DC bleed and a BAV199 clamp at CN3 (RV3's C107 had left
    it with neither; phantom on the direct out would have charged the 25 V cap to ~48 V, now 17.7 V as C52).
    D23 joins the clamp loop and drawing, R143 sits beside R73 / C107 in the direct-out drawing; placed by
    moves_only beside D22 and C107 on the bottom. 946 pins / 329 parts, 0 mismatches, ERC 0, sim_netlist
    45/45, DRC 0 / parity 0, 329 / 329 linked, route_check 0, rules re-run; only the two new parts changed.
    Master: 4K7 from Q1's base to GND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
    [02_ground_cancel_buffer.kicad_sch, 02_jack_link_clamps.kicad_sch, 03_gain.kicad_sch, 03_mix_l.kicad_sch, 04_hpf.kicad_sch, 04_mix_r.kicad_sch, 05_eq.kicad_sch, 05_master_fader.kicad_sch]
2026-10-29 TF1: MELF resistors considered and declined (same film class as the thin-film chips; footprint change on every plain resistor, full re-placement, 3-10x the price)
    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
2026-10-29 tools/freespot.py and tools/placediff.py: the probe and placement-diff helpers behind the "made last, moves_only" rule, now in the repo (macOS library path included); CLAUDE.md how-to and the owed TI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
2026-10-29 Phase-1 order priced (order_phase1_prices.csv, Mouser first, read 2026-10-28): stage A ~$423 + $70.50 PCBs, stage B $311, 2nd strip $294; stock problems noted in sourcing.md
    [order_phase1_prices.csv]
2026-10-29 FE1 / FE2 proposal (not signed off): the 2.2 uF film coupler WIMA MKS2C042201K00KSSD is obsolete. FE1: KEMET MMK5225K63J06L4BULK in the same footprint (also obsolete, Mouser 1,841 in stock; buy the c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
2026-10-29 2.2 uF film coupler (FE1, signed off): KEMET MMK5225K63J06L4BULK in the same footprint replaces the obsolete WIMA MKS2C042201K00KSSD (strip C13 / C49 / C96, group x6, master x12); order lists and pha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
    [04_mix_r.kicad_sch, 04_subgroup.kicad_sch, 05_aux_master.kicad_sch, 05_eq.kicad_sch, 05_master_fader.kicad_sch, 07_main_outputs.kicad_sch, 07_stereo_return.kicad_sch, 09_aux_master_5.kicad_sch]
2026-11-03 Master SW4's silk "2" and each project file's own top-level sheet
    The placer's orientation mark (design review R4) only ran in its FIX loop, so CS7's DIM key, placed by moves_only, had none.
    It now runs for any PVA2 placed later too: one silk "2" at (25.06, 178) on the master, nothing else moved on any board.
    jack_board.kicad_pro named channel_strip.kicad_sch as its top-level sheet, and the generators copying master.kicad_pro left
    master.kicad_sch in group, the jack boards, the jig and the PSU. schgen.own_sheet() sets each project's own; fresh netlists on
    those flat boards now read their own sheet name instead of "Root". check_all gains a check for it: --full 72 / 72.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
    [master.kicad_pcb]
2026-11-03 Doc leftovers from the full check: bus-feed coupler 100 uF in console_architecture.md, master spec title v0.14, where CS7's parts sit in docs/decisions.md
2026-11-03 SS1-SS3 proposal (not signed off): second sources for stage A's backordered parts, read at Mouser 2026-11-03
    SS1, same part in other packing, order lists only: OPA1612AID, BAV199,235, DG413DY-T1-E3. SS2, other makers on the same
    footprints: Diodes BZX84C5V1-7-F and BAV99-7-F, onsemi MBR140SFT1G (CS10's model with its maximum Vf still holds a dead rail at
    +-0.36 V), Rubycon 63ZLH47MEFC6.3X11, Panasonic EEU-FR1E221. SS3, a decision: PVA2 EE H3 for stage A (in stock, takes the PV caps,
    3 mm taller) or H1 in March 2027. Trial tree: check_all --full 72 / 72, no footprint moved. Not applied.
2026-11-03 Master stability, whole deck on v0.14: 34 configurations, 1360 unit results all simulated
    Worst still U21A/B 47.7 deg at every pot fully up, every unit's minimum unchanged, <= 2.89 dB peaking. The 29 configurations
    without trace lengths match the earlier figures to the last digit. The five _placed configurations saw the re-measured trace
    table for the first time since 2026-10-26: U13A -5 deg (A5_OUT 32 -> 98 mm, still >= 69.1), U13B -2.5, U43A/B -1.9 / -1.6,
    U5A/B +1.8 / +1.2, U21A/B 48.9 at worst.
    Corrects the record of the 2026-10-29 re-run: 14 of its 34 configurations timed out and read older raw files (fixed in
    e112981), so the _placed numbers recorded then were 2026-10-26's, and the "U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
2026-11-03 SS1-SS3 applied (signed off): second sources for stage A's backordered parts
    SS1, order lists only (the schematics keep the first code): OPA1612AID tube, BAV199,235, DG413DY-T1-E3.
    SS2, other maker on the same footprint: Diodes BZX84C5V1-7-F, Diodes BAV99-7-F, onsemi MBR140SFT1G (value label on strip D16 / D17,
    group D5 / D6), Rubycon 63ZLH47MEFC6.3X11, Panasonic EEU-FR1E221. rail_loss.py mbr: +-0.36 V, 0 mA, as the PMEG.
    SS3: PVA2 EE H3 on phase 1's bench strips (14 + 14); the console stays H1 (371), and check 3's 4 samples stay H1, due 2027-03-01.
    On applying: ORDER_AS now also reaches order_phase1.csv (the trial had only covered order_bom.csv), and the archived patch is the
    final change.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
    [09_overload_detector.kicad_sch, 10_overload_detector.kicad_sch, 13_pfl_afl.kicad_sch, 13_power_and_grounds.kicad_sch, 15_routing_matrix.kicad_sch, 17_power_entry.kicad_sch, channel_strip.kicad_pcb, channel_strip_BOM.csv]
2026-11-03 Group stability deck: TI's real OPA1656 converges, and the trace table is the placed board's again
    mst_all.json dated from before the group was drawn: 74 of its 152 entries named nets that no longer exist and none of the 80
    unnamed nets was in it, so only 22 of the 78 op-amp input and output nets got the 0.08 pF/mm board estimate. Re-measured from
    group.kicad_pcb (179 nets).
    With .options srcsteps=50 gminsteps=50 TI's OPA1656 + OPA161x had no operating point; with itl1=500 they converge, so the
    followers need neither the fitted macro nor single-pole OPA1612s. stabg.run() tries the option sets as master/mstab.py does,
    clears a unit's raw files before simulating it, and ngspice has a 600 s li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
2026-11-03 Group stability, whole deck on TI's real OPA161x + OPA1656 with the re-measured trace table: 222 states
    Followers 59.1-60.9 deg (the single-pole check read 59.2-61.0). Without the +22 / +47 pF stress the worst are U1B 56.8 and U6A 58.7 with
    the ferrite shorted; with it U6B 46.1, U12B 47.9. Peaking <= 2.76 dB. Each unit's minimum moves at most -2.1 deg (U2A, 52.3 with +47 pF).
    RV7's C98 moves U6A / U6B under 1 deg. 1835 unit results, none without data.
2026-11-03 Strip stability deck: TI's real OPA1656 converges with .options itl1=500; n1_stab.py runs as built and N1 on it
    stab.run_config() tries the option sets as master/mstab.py does and ngspice has a 600 s limit. Checked on c01: as built with U16 as
    OPA161x matches results_none.json to the digit on the units sampled, U16 on TI's model reads 61.7 deg (the 2026-10-28 standalone figure), the
    N1 set converges. n1_stab.py: `ti u16`, `ti n1`, NJ states at a time.
2026-11-04 Stage A order sheets from Mouser's readings: $435 in parts, the BOM upload ready, nothing ordered
    mouser_readings.csv holds what was read from Mouser's site on 2026-11-03 / 04 (58 codes; it denied access after about 47 lookups on the 4th). order_bom.py stagea
    re-prices order_phase1_prices.csv from it and writes order_stage_a.csv (every line by vendor) and order_stage_a_mouser.csv (82 lines for the BOM upload, which shows the 26
    unread ones live). Stage A $463.65 -> $435.18: thin film reads $0.017-0.051 at 10+, not the $0.10 placeholder.
    New from the readings: thin-film 1K5 (R64) has zero stock, due 2027-01-26, so phase 1 uses TF1's RC0805 fallback; WP710A10GD zero, due 2026-12-07, joins the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
    [mouser_readings.csv, order_phase1.csv, order_phase1_prices.csv, order_stage_a.csv, order_stage_a_mouser.csv]
2026-11-09 Prepare for publication: CERN-OHL-S-2.0 over the whole repository, build status and mains warning in the README, ref/ git-ignored
    The licence covers tools/ too, because the generators there hold the design itself (netlists, schematic drawings, placement). The third-party documents are no longer in the repository, so the README row for ref/ says so and the Delta reference image is gone from the panel table.
2026-11-09 Tidy the root: docs into docs/{proposals,reviews,studies,build}, BOMs and order lists into bom/, schematic PDFs into pdf/
    81 files moved with git mv (root 154 -> 73 tracked files) and every reference rewritten in Markdown, Python comments and docstrings, and deck comments. No generated design file changed. order_bom.py now writes to bom/. CLAUDE.md, README, decisions.md and the verification log record the new layout, the publication and the licence. check_all.py --full: 72/72.
    [channel_strip_BOM.csv, group_BOM.csv, group_jack_board_BOM.csv, jack_board_BOM.csv, jig_load_board_BOM.csv, jig_master_stub_BOM.csv, master_BOM.csv, master_jack_board_BOM.csv]
2026-11-09 README: fix strip spec version (v5.7), layer description and check summary; tighten prose
    Every changed claim checked against the specs and boards: strip spec is v5.7, the 4-layer boards have a solid ground plane plus a ground fill, and PSU DRC reports 20 known silk-edge items, so the "checks clean" heading became "What the checks show". Structure, code blocks and links unchanged.
2026-11-09 One folder per board: boards/<name>/ for the nine KiCad projects, root 73 -> 13 tracked files
    Each project (schematic, board, .kicad_pro, .kicad_dru, .net, _intended.json, _parts.json, hierarchical sheets) moves to boards/<name>/ with its own fp-lib-table and sym-lib-table pointing at the shared libraries in the root; 3D model paths use ${KIPRJMOD}/../../. About 45 scripts take the new paths, schgen.sibling_sch places the jack boards beside their main board. Checked: all nine netlists identical to the pre-move ones apart from the library path line, every generator reproduces its files byte for byte, every placer gives placediff 0 changed parts, check_all.py --full 72/72.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
    [02_bus_select.kicad_sch, 02_ground_cancel_buffer.kicad_sch, 02_jack_link_clamps.kicad_sch, 03_gain.kicad_sch, 03_mix_l.kicad_sch, 03_subgroup.kicad_sch, 04_hpf.kicad_sch, 04_mix_r.kicad_sch]
2026-11-11 Straight jack-board links on the strip and the group, jig headers turned; sim_console drives the PFL switcher from PFLDET (108 checks); one record per change
    Placement (unrouted boards, records in docs/decisions.md, 2026-11-11):
    - strip jack board: CN5 across like CN3, the 10-way ribbon runs straight; standoffs H1 / H2 moved
    - group: the link headers across on both boards so both ribbons run straight; main board re-placed around them, panel, escape plan and render regenerated
    - jig: bus headers with pin 1 at the front end as on every module (jig spec v0.11); the master stub schematic drawn as wired lanes; tools/jig_3d.py
    Checks:
    - tools/sim_console.py (project review RV11.2): the PFL detect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
    [group.dxf, group.kicad_pcb, group_holes.csv, group_jack_board.kicad_pcb, group_layers.csv, jack_board.kicad_pcb, jig_load_board.kicad_pcb, jig_load_board.kicad_sch]
2026-11-12 Console survey: add the DDA AMR 24 (balanced buses, aux ground-sense line, source-end routing); no design change
    New per-console report docs/console_survey/dda_amr24.md (T1-T22, PDF page references, read / inferred marks),
    section 8 and the source / spec table rows in docs/studies/console_survey.md, the index entry, and the
    reference-material sentence in CLAUDE.md. Nothing proposed: the pre-send link is already covered by JP2-JP4.
    CLAUDE.md also carries the note that the console renders and goa_console.blend were rebuilt on 2026-11-12 with
    the straight jack-board links.
2026-11-12 Schematic readability review: all nine schematics read by eye, findings SR1-SR7; no design change
    New docs/reviews/schematic_readability_review.md: KiCad 10.0.7's own plot of every project (68 pages) read against
    the readable-schematic rules, with ERC (0 violations on all nine) and the skill's lint (689 errors, 576 advisories)
    as leads. Seven drawing-only findings, none changes a netlist:
    - SR1 five sheets with no wire (psu, jig load board, the three jack boards), with the worst text collisions
    - SR2 the master's power-on mute, PFL detect, flasher and meter current sources drawn as chains of labels
    - SR3 group and master as fragments joined by labels, functions cut by page breaks, decoupling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
2026-11-12 PSU schematic drawn (SR1): wired rail rows and crowbars, rails as sheet-local power symbols; netlist and board unchanged
    boards/psu/psu.kicad_sch was 52 parts in labelled cells without a wire (0 wires, 119 labels, 533 x 376 mm). It is now
    one wired drawing from draw_sheet() in tools/gen_psu.py (176 wires, 19 labels, 420 x 370 mm):
    - POS and NEG rail as two identical rows from one function: SMPS terminal -> L / C -> LM1084-ADJ with its divider,
    soft start and diodes -> output parts -> J3; each crowbar on a bus under its rail, the SCR across the rail
    - +V / 0V / -V as power symbols local to the sheet (three new symbols in goa-console.kicad_sym): a global symbol
    would rename /+V, /0V, /-V a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
    [psu.kicad_sch]
2026-11-12 Jack boards and jig load board schematics drawn (SR1 complete): wired jack lanes, links as pin lists, CHASSIS as a sheet-local symbol; netlists and boards unchanged
    The other four sheets of the readability review's SR1 were parts in labelled cells without a wire. Each is now one
    wired drawing:
    - jack_board (strip, A4): every signal a wire; the link CN5 at the left, J1 / J2 / J5 at the right facing it, IN_T over
    the link to pin 1 and DO_R under it to pin 9
    - group_jack_board, master_jack_board (frags.jack_board): the link(s) as pin lists (names on stubs, each ground net on
    one rail with one symbol pointing down), each jack a wired lane with its sleeve, normals and R-normalled-to-L links;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
    [group_jack_board.kicad_sch, jack_board.kicad_sch, jig_load_board.kicad_sch, master_jack_board.kicad_sch]
